acevedocrisologopablo48-lgtm/sesuveca-tolva-p04/dist/documentos/PLANTA_SELECCION_CARBON_IMPLANTACION_R01.pdf

# Selección lateral y recepción de rechazo

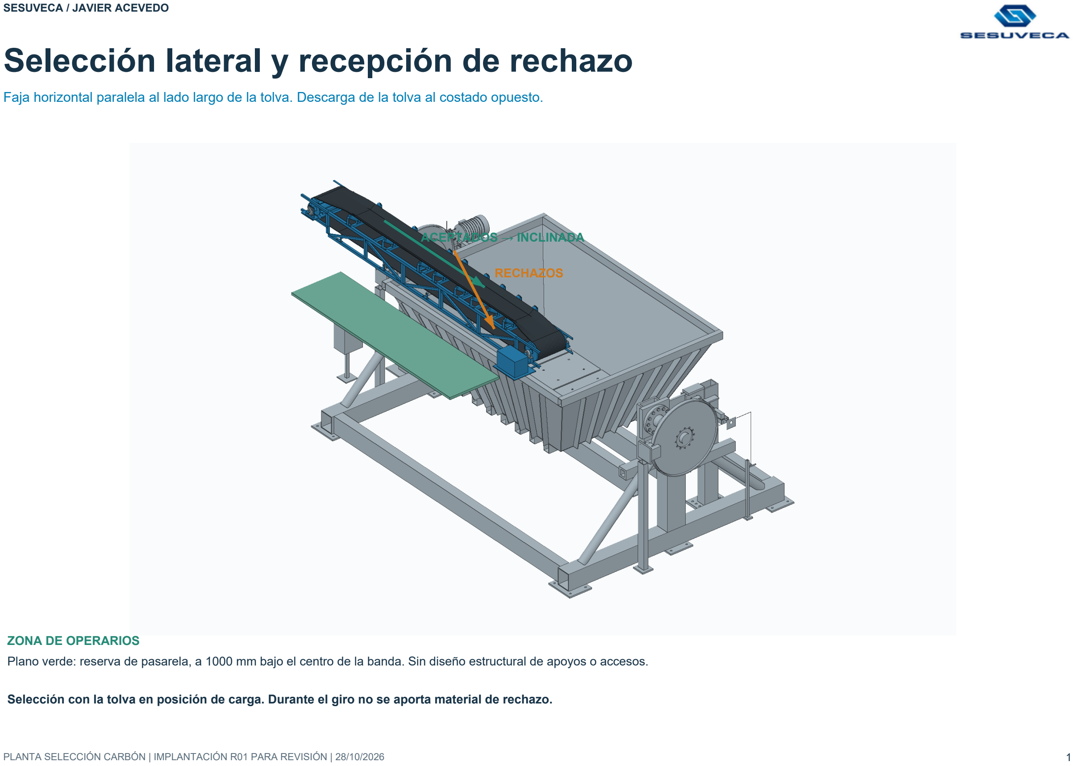
[picture p3: page 1]

SESUVECA / JAVIER ACEVEDO

Faja horizontal paralela al lado largo de la tolva. Descarga de la tolva al costado opuesto.

PLANTA SELECCIÓN CARBÓN | IMPLANTACIÓN R01 PARA REVISIÓN | 28/10/2026 | 1

ACEPTADOS → INCLINADA

RECHAZOS

ZONA DE OPERARIOS

Plano verde: reserva de pasarela, a 1000 mm bajo el centro de la banda. Sin diseño estructural de apoyos o accesos.

Selección con la tolva en posición de carga. Durante el giro no se aporta material de rechazo.

# Conjunto de planta y recorrido del material

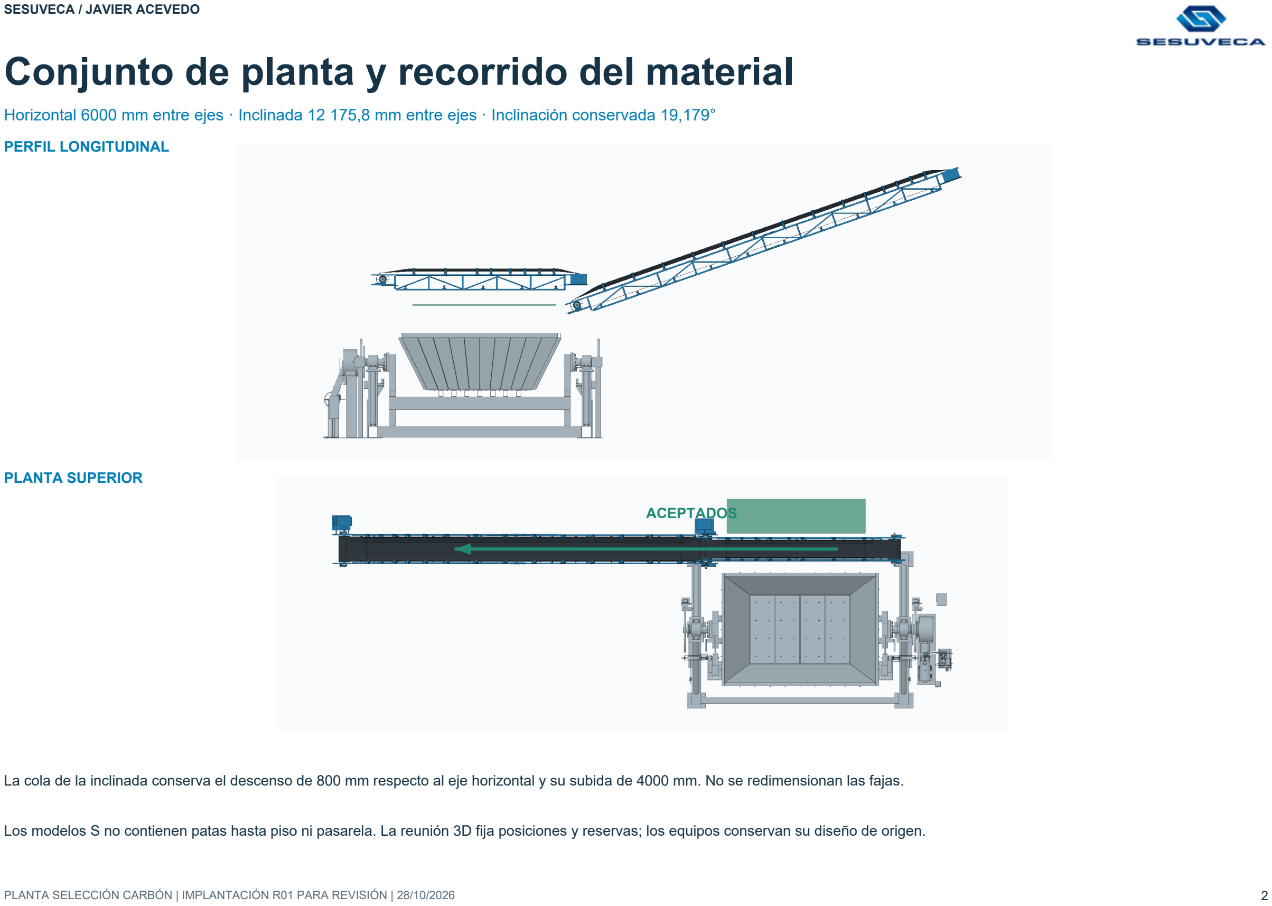
[picture p4: page 2]

Horizontal 6000 mm entre ejes · Inclinada 12 175,8 mm entre ejes · Inclinación conservada 19,179°

PLANTA SELECCIÓN CARBÓN | IMPLANTACIÓN R01 PARA REVISIÓN | 28/10/2026 | 2

PERFIL LONGITUDINAL

PLANTA SUPERIOR

ACEPTADOS

La cola de la inclinada conserva el descenso de 800 mm respecto al eje horizontal y su subida de 4000 mm. No se redimensionan las fajas.

Los modelos S no contienen patas hasta piso ni pasarela. La reunión 3D fija posiciones y reservas; los equipos conservan su diseño de origen.

# Espacio para el giro de la tolva

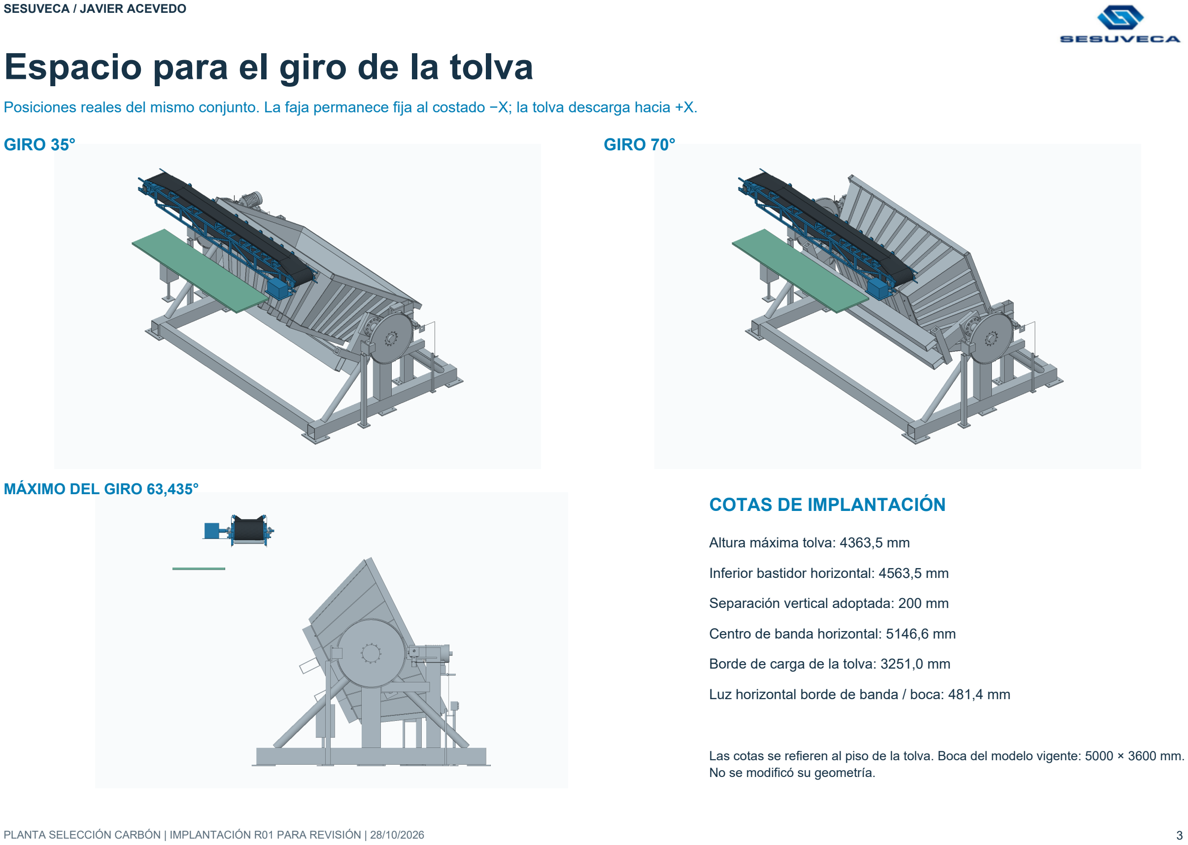
[picture p5: page 3]

Posiciones reales del mismo conjunto. La faja permanece fija al costado −X; la tolva descarga hacia +X.

PLANTA SELECCIÓN CARBÓN | IMPLANTACIÓN R01 PARA REVISIÓN | 28/10/2026 | 3
GIRO 35° | GIRO 70°

MÁXIMO DEL GIRO 63,435°

## COTAS DE IMPLANTACIÓN

Altura máxima tolva: 4363,5 mm

Inferior bastidor horizontal: 4563,5 mm

Separación vertical adoptada: 200 mm

Centro de banda horizontal: 5146,6 mm

Borde de carga de la tolva: 3251,0 mm

Luz horizontal borde de banda / boca: 481,4 mm

Las cotas se refieren al piso de la tolva. Boca del modelo vigente: 5000 × 3600 mm. No se modificó su geometría.
