acevedocrisologopablo48-lgtm/sesuveca-tolva-p04/dist/documentos/TT10_PLANOS_CONJUNTOS.pdf

# Conjunto general y montaje

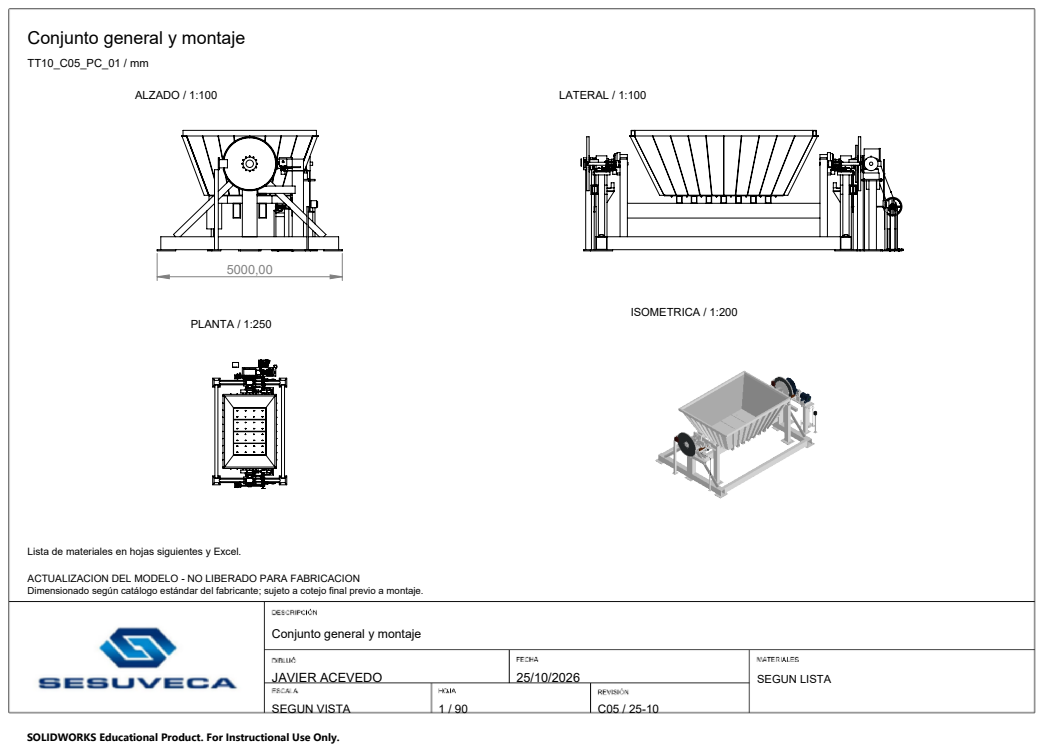
[picture p6: page 1]
JAVIER ACEVEDO; SEGUN VISTA; SEGUN LISTA; ALZADO / 1:100; LATERAL / 1:100; PLANTA / 1:250; ISOMETRICA / 1:200

Lista de materiales en hojas siguientes y Excel.

ACTUALIZACION DEL MODELO - NO LIBERADO PARA FABRICACION
Dimensionado según catálogo estándar del fabricante; sujeto a cotejo final previo a montaje.

Conjunto general y montaje

SOLIDWORKS Educational Product. For Instructional Use Only.

# Conjunto general y montaje - Lista de conjuntos

TT10_C05_PC_01_L02 / mm

### Conjunto general y montaje - Lista de conjuntos

JAVIER ACEVEDO | 25/10/2026
S/E | 2 / 90 | C05 / 25-10

SEGUN LISTA

Referencias a conjuntos. Cantidad: 1 por referencia.

ACTUALIZACION DEL MODELO - NO LIBERADO PARA FABRICACION Dimensionado según catálogo estándar del fabricante; sujeto a cotejo final previo a montaje.

POS | CANT | CODIGO | DESCRIPCION | MATERIAL
02 | 1 | TT10_C05_PC_02 | Bastidor fijo ensamblado | SEGÚN CONJUNTO
03 | 1 | TT10_C05_PC_03 | Topes de giro, orejas y guías del bastidor | SEGÚN CONJUNTO
04 | 1 | TT10_C05_PC_04 | Tolva y bastidor móvil ensamblados | SEGÚN CONJUNTO
05 | 1 | TT10_C05_PC_05 | Bastidor móvil de la tolva | SEGÚN CONJUNTO
06 | 1 | TT10_C05_PC_06 | Tolva: paneles laterales y refuerzos | SEGÚN CONJUNTO
07 | 1 | TT10_C05_PC_07 | Tolva: testeros, refuerzos y fondo | SEGÚN CONJUNTO
08 | 1 | TT10_C05_PC_08 | Revestimientos desmontables y camas de apoyo | SEGÚN CONJUNTO
09 | 1 | TT10_C05_PC_09 | Muñones, bridas, cubos y apoyos de giro | SEGÚN CONJUNTO
10 | 1 | TT10_C05_PC_10 | Bancada y pedestales del accionamiento | SEGÚN CONJUNTO
11 | 1 | TT10_C05_PC_11 | Soportes y montaje de frenos de salida | SEGÚN CONJUNTO
12 | 1 | TT10_C05_PC_12 | Bastidores de extracción de pasadores | SEGÚN CONJUNTO
13 | 1 | TT10_C05_PC_13 | Pasadores de bloqueo y casquillos | SEGÚN CONJUNTO
14 | 1 | TT10_C05_PC_14 | Pestillos positivos y recuperación | SEGÚN CONJUNTO
15 | 1 | TT10_C05_PC_15 | Soportes y regulación de detectores | SEGÚN CONJUNTO
16 | 1 | TT10_C05_PC_16 | Tensor de cadena y puesto manual | SEGÚN CONJUNTO
17 | 1 | TT10_C05_PC_17 | Volante, eje y freno del timón | SEGÚN CONJUNTO
18 | 1 | TT10_C05_PC_18 | Transmisión por cadena y acoples | SEGÚN CONJUNTO
19 | 1 | TT10_C05_PC_19 | Resguardo desmontable de cadena | SEGÚN CONJUNTO
20 | 1 | TT10_C05_PC_20 | Caja y soportes del selector | SEGÚN CONJUNTO

# Conjunto general y montaje - Lista de conjuntos

TT10_C05_PC_01_L03 / mm

### Conjunto general y montaje - Lista de conjuntos

JAVIER ACEVEDO | 25/10/2026
S/E | 3 / 90 | C05 / 25-10

SEGUN LISTA

Referencias a conjuntos. Cantidad: 1 por referencia.

ACTUALIZACION DEL MODELO - NO LIBERADO PARA FABRICACION Dimensionado según catálogo estándar del fabricante; sujeto a cotejo final previo a montaje.

POS | CANT | CODIGO | DESCRIPCION | MATERIAL
21 | 1 | TT10_C05_PC_21 | Selector E-N-M y enclavamiento cautivo | SEGÚN CONJUNTO
22 | 1 | TT10_C05_PC_22 | Transmisión manual BDNB ensamblada | SEGÚN CONJUNTO
23 | 1 | TT10_C05_PC_23 | BDNB: engranajes y pasadores propios | SEGÚN CONJUNTO
24 | 1 | TT10_C05_PC_24 | Puestos de recuperación de actuadores | SEGÚN CONJUNTO
25 | 1 | TT10_C05_PC_25 | Soportes de armario y mandos | SEGÚN CONJUNTO
26 | 1 | TT10_C05_PC_26 | Mando exterior y varilla del selector | SEGÚN CONJUNTO

# Bastidor fijo ensamblado

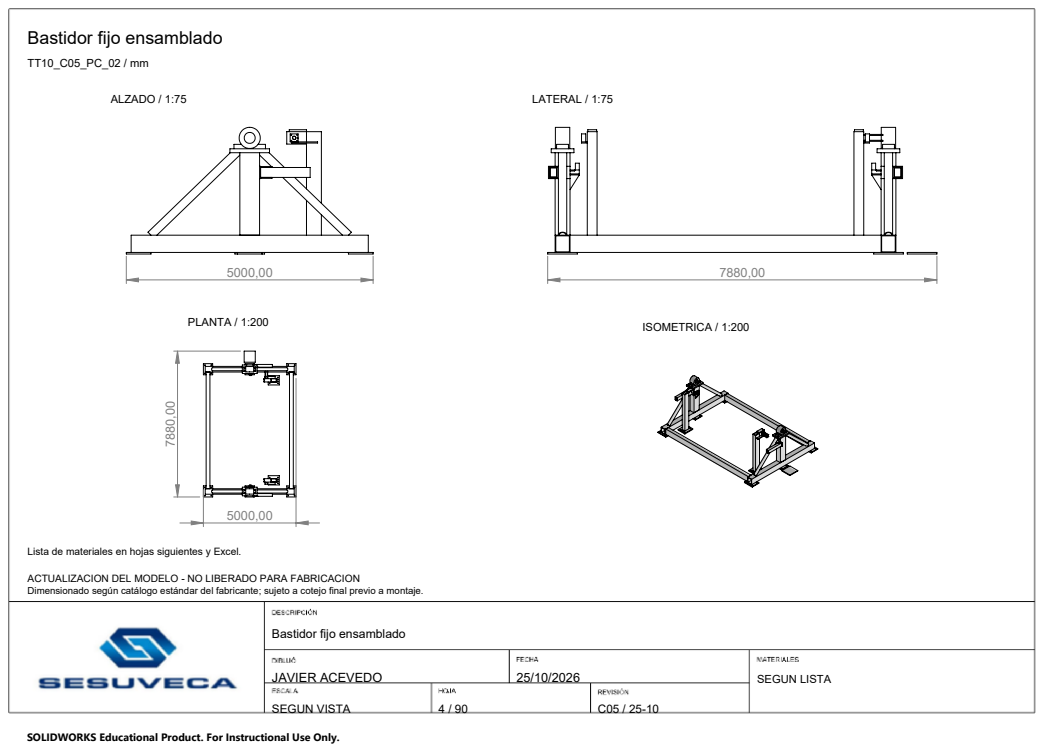
[picture p7: page 4]
JAVIER ACEVEDO; SEGUN VISTA; SEGUN LISTA; ALZADO / 1:75; LATERAL / 1:75; PLANTA / 1:200; ISOMETRICA / 1:200

Lista de materiales en hojas siguientes y Excel.

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

Bastidor fijo ensamblado

# Bastidor fijo ensamblado - Lista de materiales

TT10_C05_PC_02_L02 / mm

### Bastidor fijo ensamblado - Lista de materiales

JAVIER ACEVEDO | 25/10/2026
S/E | 5 / 90 | C05 / 25-10

SEGUN LISTA

Cantidades de esta lista: instancias presentes en este conjunto.

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

POS | CANT | CODIGO | DESCRIPCION | MATERIAL
145 | 1 | TT10_CART_N_INF | Cartela horizontal20 entre puente y placa de nodo | ASTM A36
146 | 1 | TT10_CART_N_SUP | Cartela horizontal20 entre puente y placa de nodo | ASTM A36
147 | 1 | TT10_CART_P_INF | Cartela horizontal20 entre puente y placa de nodo | ASTM A36
148 | 1 | TT10_CART_P_SUP | Cartela horizontal20 entre puente y placa de nodo | ASTM A36
218 | 1 | TT10_F416 | Placa base 600 x 500 x 50; 8 agujeros Ø40, centros X ±220, Y ±150 y ±50 | Strenx700E t50; Rp0.2min700MPa
219 | 1 | TT10_F426 | Tope inclinado: cara inferior mecanizada para asiento horizontal | ASTM A36
220 | 1 | TT10_F431 | Pieza TT10_F431 | ASTM A36
221 | 1 | TT10_F441 | Placa80 con cuatro roscas M30 ciegas60, paso540x140; pernos desde arriba | ASTM A36
222 | 1 | TT10_F446 | Placa80 con cuatro roscas M30 ciegas60, paso540x140; pernos desde arriba | ASTM A36
224 | 1 | TT10_F456 | SKF SNL3048: dimensiones de interfaz según catálogo; fundición simplificada | Conjunto comprado; acero/ fundición según OEM
225 | 1 | TT10_F471 | Perfil tubular 350 x 200 x 12; L 6300 | S275J0H / EN 10219-1
226 | 1 | TT10_F476 | Perfil tubular 350 x 200 x 12; L 6300 | S275J0H / EN 10219-1
227 | 1 | TT10_F481 | Pieza TT10_F481 | ASTM A36
228 | 1 | TT10_F486 | Oreja fija 400 x 250 x 40; agujero Ø65 H8; Strenx 700E | Strenx700E t40; Rp0.2min700MPa
230 | 1 | TT10_F501 | Oreja fija 400 x 250 x 40; agujero Ø65 H8; Strenx 700E | Strenx700E t40; Rp0.2min700MPa
231 | 1 | TT10_F506 | Poste independiente cajón 300 x 200 x 2395, t20; 2 diafragmas 260 x 160 x 20 | Strenx700E t20; Rp0.2min700MPa
232 | 1 | TT10_F511 | Pieza TT10_F511 | ASTM A36
233 | 1 | TT10_F516 | Pieza TT10_F516 | ASTM A36
235 | 1 | TT10_F526 | Perfil tubular 350 x 300 x 12; L 4800 | S275J0H / EN 10219-1

# Bastidor fijo ensamblado - Lista de materiales

TT10_C05_PC_02_L03 / mm

### Bastidor fijo ensamblado - Lista de materiales

JAVIER ACEVEDO | 25/10/2026
S/E | 6 / 90 | C05 / 25-10

SEGUN LISTA

Cantidades de esta lista: instancias presentes en este conjunto.

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

POS | CANT | CODIGO | DESCRIPCION | MATERIAL
236 | 1 | TT10_F531 | Perfil tubular 350 x 300 x 12; L 4800 | S275J0H / EN 10219-1
237 | 1 | TT10_F536 | Soporte tope terminado en cara interior de columna | ASTM A36
238 | 1 | TT10_F541 | Diagonal CHS168.3x10 con cortes de asiento; sin penetrar columnas ni placas | S275J0H / EN 10219-1
239 | 1 | TT10_F546 | Puente RHS200x150x10 L1005; fuera del plano de las diagonales | S275J0H / EN 10219-1
240 | 1 | TT10_F551 | SKF SNL3048: dimensiones de interfaz según catálogo; fundición simplificada | Conjunto comprado; acero/ fundición según OEM
241 | 1 | TT10_F556 | Soporte tope terminado en cara interior de columna | ASTM A36
242 | 1 | TT10_F561 | Pieza TT10_F561 | ASTM A36
243 | 1 | TT10_F566 | Pieza TT10_F566 | ASTM A36
244 | 1 | TT10_F571 | Pieza TT10_F571 | ASTM A36
245 | 1 | TT10_F576 | Oreja fija 400 x 250 x 40; agujero Ø65 H8; Strenx 700E | Strenx700E t40; Rp0.2min700MPa
246 | 1 | TT10_F581 | Diagonal CHS168.3x10 con cortes de asiento; sin penetrar columnas ni placas | S275J0H / EN 10219-1
247 | 1 | TT10_F586 | Oreja fija 400 x 250 x 40; agujero Ø65 H8; Strenx 700E | Strenx700E t40; Rp0.2min700MPa
248 | 1 | TT10_F591 | Placa base 600 x 500 x 50; 8 agujeros Ø40, centros X ±220, Y ±150 y ±50 | Strenx700E t50; Rp0.2min700MPa
249 | 1 | TT10_F596 | Tope inclinado: cara inferior mecanizada para asiento horizontal | ASTM A36
250 | 1 | TT10_F601 | Diagonal CHS168.3x10 con cortes de asiento; sin penetrar columnas ni placas | S275J0H / EN 10219-1
251 | 1 | TT10_F606 | Diagonal CHS168.3x10 con cortes de asiento; sin penetrar columnas ni placas | S275J0H / EN 10219-1
252 | 1 | TT10_F611 | Poste independiente cajón 300 x 200 x 2395, t20; 2 diafragmas 260 x 160 x 20 | Strenx700E t20; Rp0.2min700MPa
254 | 1 | TT10_F621 | Puente RHS200x150x10 L1005; fuera del plano de las diagonales | S275J0H / EN 10219-1
255 | 1 | TT10_F626 | Pieza TT10_F626 | ASTM A36

# Bastidor fijo ensamblado - Lista de materiales

TT10_C05_PC_02_L04 / mm

### Bastidor fijo ensamblado - Lista de materiales

JAVIER ACEVEDO | 25/10/2026
S/E | 7 / 90 | C05 / 25-10

SEGUN LISTA

Cantidades de esta lista: instancias presentes en este conjunto.

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

POS | CANT | CODIGO | DESCRIPCION | MATERIAL
256 | 1 | TT10_F631 | Pieza TT10_F631 | ASTM A36
257 | 1 | TT10_F636 | Columna principal recortada para placa80 y altura de centro SKF220 | S355J2; certificado 3.1 requerido
258 | 1 | TT10_F641 | Columna principal recortada para placa80 y altura de centro SKF220 | S355J2; certificado 3.1 requerido
262 | 1 | TT10_GUIA_N | Guía con alojamiento Ø69 H7; casquillo69/65.5; fuera del camino resistente | ASTM A36
263 | 1 | TT10_GUIA_P | Guía con alojamiento Ø69 H7; casquillo69/65.5; fuera del camino resistente | ASTM A36
388 | 1 | TT10_NODO_N | Placa de nodo20: unión entre puente desplazado y columna principal | ASTM A36
389 | 1 | TT10_NODO_P | Placa de nodo20: unión entre puente desplazado y columna principal | ASTM A36
430 | 1 | TT10_PUENTE_N | Puente guía A36 525 x 125 x 25; recorte 225 x 10 junto al poste | ASTM A36 t25
431 | 1 | TT10_PUENTE_P | Puente guía A36 525 x 125 x 25; recorte 225 x 10 junto al poste | ASTM A36 t25
458 | 1 | TT10_TIR_P1 | Tirante M20 propuesto, L380; rosca simplificada | ASTM A36
459 | 1 | TT10_TIR_P2 | Tirante M20 propuesto, L380; rosca simplificada | ASTM A36
460 | 1 | TT10_TIR_P3 | Tirante M20 propuesto, L380; rosca simplificada | ASTM A36
461 | 1 | TT10_TIR_P4 | Tirante M20 propuesto, L380; rosca simplificada | ASTM A36
487 | 1 | TT10_TOPE70_N_INFD | Cartela horizontal20: transmite componente transversal del tope70 | ASTM A36
488 | 1 | TT10_TOPE70_N_INFI | Cartela horizontal20: transmite componente transversal del tope70 | ASTM A36
489 | 1 | TT10_TOPE70_N_SUPD | Cartela horizontal20: transmite componente transversal del tope70 | ASTM A36
490 | 1 | TT10_TOPE70_N_SUPI | Cartela horizontal20: transmite componente transversal del tope70 | ASTM A36
491 | 1 | TT10_TOPE70_N_V1 | Cartela vertical20 de tope70; apoyo al bloque y cara de columna | ASTM A36
492 | 1 | TT10_TOPE70_N_V2 | Cartela vertical20 de tope70; apoyo al bloque y cara de columna | ASTM A36

# Bastidor fijo ensamblado - Lista de materiales

TT10_C05_PC_02_L05 / mm

### Bastidor fijo ensamblado - Lista de materiales

JAVIER ACEVEDO | 25/10/2026
S/E | 8 / 90 | C05 / 25-10

SEGUN LISTA

Cantidades de esta lista: instancias presentes en este conjunto.

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

POS | CANT | CODIGO | DESCRIPCION | MATERIAL
493 | 1 | TT10_TOPE70_P_INFD | Cartela horizontal20: transmite componente transversal del tope70 | ASTM A36
494 | 1 | TT10_TOPE70_P_INFI | Cartela horizontal20: transmite componente transversal del tope70 | ASTM A36
495 | 1 | TT10_TOPE70_P_SUPD | Cartela horizontal20: transmite componente transversal del tope70 | ASTM A36
496 | 1 | TT10_TOPE70_P_SUPI | Cartela horizontal20: transmite componente transversal del tope70 | ASTM A36
497 | 1 | TT10_TOPE70_P_V1 | Cartela vertical20 de tope70; apoyo al bloque y cara de columna | ASTM A36
498 | 1 | TT10_TOPE70_P_V2 | Cartela vertical20 de tope70; apoyo al bloque y cara de columna | ASTM A36

# Topes de giro, orejas y guías del bastidor

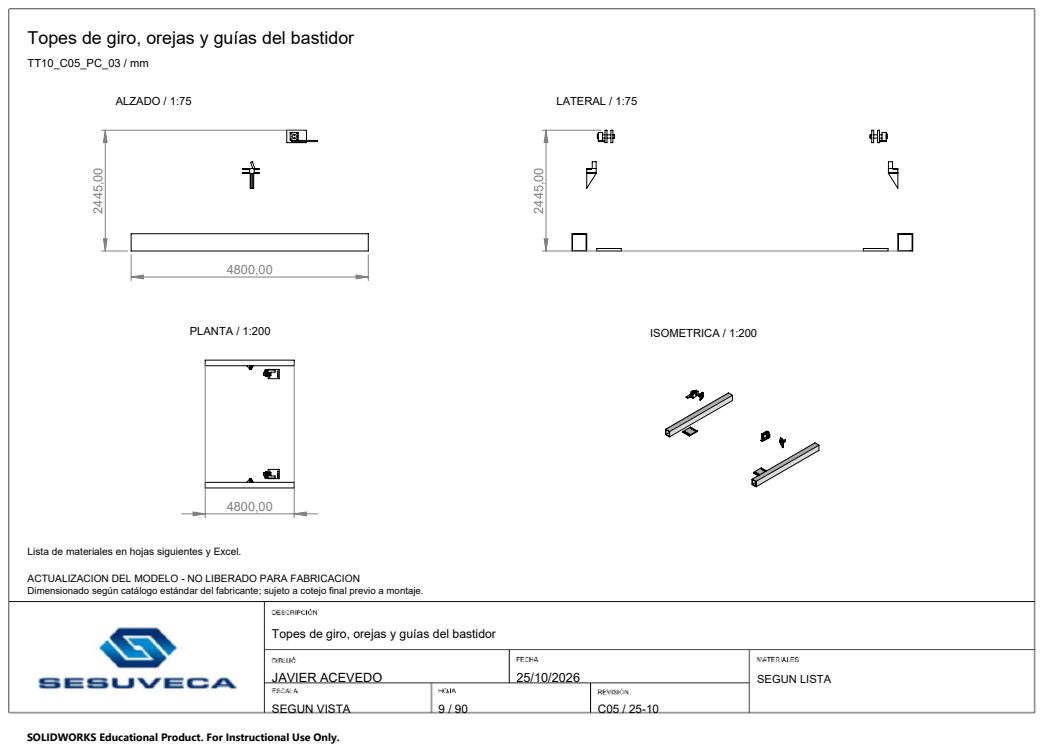
[picture p8: page 9]
JAVIER ACEVEDO; SEGUN VISTA; SEGUN LISTA; ALZADO / 1:75; LATERAL / 1:75; PLANTA / 1:200; ISOMETRICA / 1:200

Lista de materiales en hojas siguientes y Excel.

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

Topes de giro, orejas y guías del bastidor

# Topes de giro, orejas y guías del bastidor - Lista de materiales

TT10_C05_PC_03_L02 / mm

### Topes de giro, orejas y guías del bastidor - Lista de materiales

JAVIER ACEVEDO | 25/10/2026
S/E | 10 / 90 | C05 / 25-10

SEGUN LISTA

Cantidades de esta lista: instancias presentes en este conjunto.

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

POS | CANT | CODIGO | DESCRIPCION | MATERIAL
4 | 1 | TT10_BUJE_PIN_N | Casquillo CuSn12 Ø69 s6 / Ø65.5 H9 final, L85, C0.5 interiores | CuSn12 / EN 1982
5 | 1 | TT10_BUJE_PIN_P | Casquillo CuSn12 Ø69 s6 / Ø65.5 H9 final, L85, C0.5 interiores | CuSn12 / EN 1982
218 | 1 | TT10_F416 | Placa base 600 x 500 x 50; 8 agujeros Ø40, centros X ±220, Y ±150 y ±50 | Strenx700E t50; Rp0.2min700MPa
219 | 1 | TT10_F426 | Tope inclinado: cara inferior mecanizada para asiento horizontal | ASTM A36
228 | 1 | TT10_F486 | Oreja fija 400 x 250 x 40; agujero Ø65 H8; Strenx 700E | Strenx700E t40; Rp0.2min700MPa
230 | 1 | TT10_F501 | Oreja fija 400 x 250 x 40; agujero Ø65 H8; Strenx 700E | Strenx700E t40; Rp0.2min700MPa
235 | 1 | TT10_F526 | Perfil tubular 350 x 300 x 12; L 4800 | S275J0H / EN 10219-1
236 | 1 | TT10_F531 | Perfil tubular 350 x 300 x 12; L 4800 | S275J0H / EN 10219-1
237 | 1 | TT10_F536 | Soporte tope terminado en cara interior de columna | ASTM A36
241 | 1 | TT10_F556 | Soporte tope terminado en cara interior de columna | ASTM A36
245 | 1 | TT10_F576 | Oreja fija 400 x 250 x 40; agujero Ø65 H8; Strenx 700E | Strenx700E t40; Rp0.2min700MPa
247 | 1 | TT10_F586 | Oreja fija 400 x 250 x 40; agujero Ø65 H8; Strenx 700E | Strenx700E t40; Rp0.2min700MPa
248 | 1 | TT10_F591 | Placa base 600 x 500 x 50; 8 agujeros Ø40, centros X ±220, Y ±150 y ±50 | Strenx700E t50; Rp0.2min700MPa
249 | 1 | TT10_F596 | Tope inclinado: cara inferior mecanizada para asiento horizontal | ASTM A36
262 | 1 | TT10_GUIA_N | Guía con alojamiento Ø69 H7; casquillo69/65.5; fuera del camino resistente | ASTM A36
263 | 1 | TT10_GUIA_P | Guía con alojamiento Ø69 H7; casquillo69/65.5; fuera del camino resistente | ASTM A36
412 | 2 | TT10_PE_PIN | Pasador Ø65 f7 x 330; cabeza Ø90 x 15; R3; 34CrNiMo6+QT Rp0,2 mín.800 MPa | 34CrNiMo6+QT; Rp0,2 mín.800 MPa, sección<=100mm
430 | 1 | TT10_PUENTE_N | Puente guía A36 525 x 125 x 25; recorte 225 x 10 junto al poste | ASTM A36 t25
431 | 1 | TT10_PUENTE_P | Puente guía A36 525 x 125 x 25; recorte 225 x 10 junto al poste | ASTM A36 t25

# Topes de giro, orejas y guías del bastidor - Lista de materiales

TT10_C05_PC_03_L03 / mm

### Topes de giro, orejas y guías del bastidor - Lista de materiales

JAVIER ACEVEDO | 25/10/2026
S/E | 11 / 90 | C05 / 25-10

SEGUN LISTA

Cantidades de esta lista: instancias presentes en este conjunto.

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

POS | CANT | CODIGO | DESCRIPCION | MATERIAL
487 | 1 | TT10_TOPE70_N_INFD | Cartela horizontal20: transmite componente transversal del tope70 | ASTM A36
488 | 1 | TT10_TOPE70_N_INFI | Cartela horizontal20: transmite componente transversal del tope70 | ASTM A36
489 | 1 | TT10_TOPE70_N_SUPD | Cartela horizontal20: transmite componente transversal del tope70 | ASTM A36
490 | 1 | TT10_TOPE70_N_SUPI | Cartela horizontal20: transmite componente transversal del tope70 | ASTM A36
491 | 1 | TT10_TOPE70_N_V1 | Cartela vertical20 de tope70; apoyo al bloque y cara de columna | ASTM A36
492 | 1 | TT10_TOPE70_N_V2 | Cartela vertical20 de tope70; apoyo al bloque y cara de columna | ASTM A36
493 | 1 | TT10_TOPE70_P_INFD | Cartela horizontal20: transmite componente transversal del tope70 | ASTM A36
494 | 1 | TT10_TOPE70_P_INFI | Cartela horizontal20: transmite componente transversal del tope70 | ASTM A36
495 | 1 | TT10_TOPE70_P_SUPD | Cartela horizontal20: transmite componente transversal del tope70 | ASTM A36
496 | 1 | TT10_TOPE70_P_SUPI | Cartela horizontal20: transmite componente transversal del tope70 | ASTM A36
497 | 1 | TT10_TOPE70_P_V1 | Cartela vertical20 de tope70; apoyo al bloque y cara de columna | ASTM A36
498 | 1 | TT10_TOPE70_P_V2 | Cartela vertical20 de tope70; apoyo al bloque y cara de columna | ASTM A36

# Tolva y bastidor móvil ensamblados

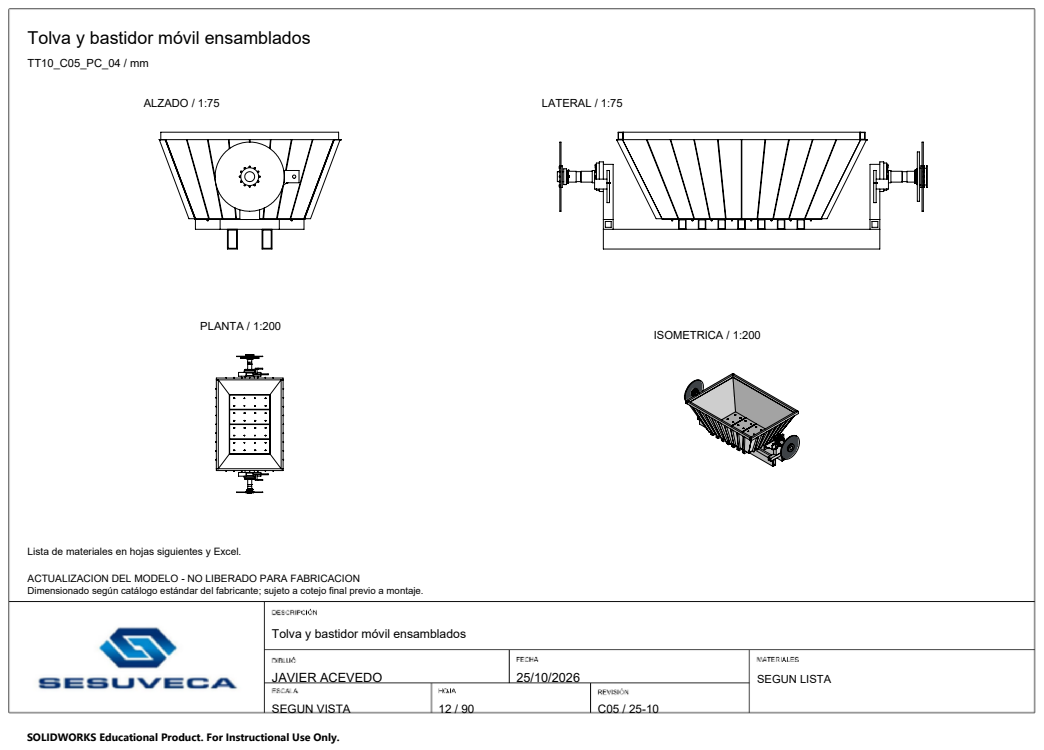
[picture p9: page 12]
JAVIER ACEVEDO; SEGUN VISTA; SEGUN LISTA; ALZADO / 1:75; LATERAL / 1:75; PLANTA / 1:200; ISOMETRICA / 1:200

Lista de materiales en hojas siguientes y Excel.

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

Tolva y bastidor móvil ensamblados

# Tolva y bastidor móvil ensamblados - Lista de conjuntos

TT10_C05_PC_04_L02 / mm

### Tolva y bastidor móvil ensamblados - Lista de conjuntos

JAVIER ACEVEDO | 25/10/2026
S/E | 13 / 90 | C05 / 25-10

SEGUN LISTA

Referencias a conjuntos. Cantidad: 1 por referencia.

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

POS | CANT | CODIGO | DESCRIPCION | MATERIAL
05 | 1 | TT10_C05_PC_05 | Bastidor móvil de la tolva | SEGÚN CONJUNTO
06 | 1 | TT10_C05_PC_06 | Tolva: paneles laterales y refuerzos | SEGÚN CONJUNTO
07 | 1 | TT10_C05_PC_07 | Tolva: testeros, refuerzos y fondo | SEGÚN CONJUNTO
08 | 1 | TT10_C05_PC_08 | Revestimientos desmontables y camas de apoyo | SEGÚN CONJUNTO
09 | 1 | TT10_C05_PC_09 | Muñones, bridas, cubos y apoyos de giro | SEGÚN CONJUNTO

# Bastidor móvil de la tolva

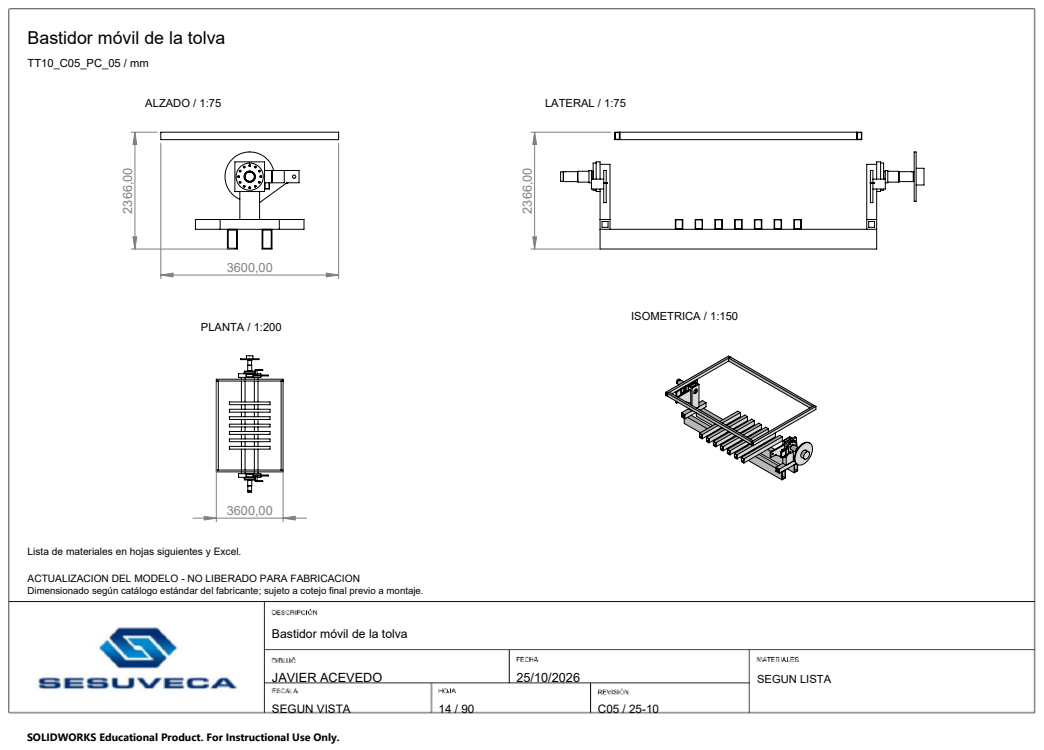
[picture p10: page 14]
JAVIER ACEVEDO; SEGUN VISTA; SEGUN LISTA; ALZADO / 1:75; LATERAL / 1:75; PLANTA / 1:200; ISOMETRICA / 1:150

Lista de materiales en hojas siguientes y Excel.

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

Bastidor móvil de la tolva

# Bastidor móvil de la tolva - Lista de materiales

TT10_C05_PC_05_L02 / mm

### Bastidor móvil de la tolva - Lista de materiales

JAVIER ACEVEDO | 25/10/2026
S/E | 15 / 90 | C05 / 25-10

SEGUN LISTA

Cantidades de esta lista: instancias presentes en este conjunto.

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

POS | CANT | CODIGO | DESCRIPCION | MATERIAL
305 | 1 | TT10_M006 | Perfil tubular 200 x 150 x 10; L 2200 | S275J0H / EN 10219-1
306 | 1 | TT10_M011 | Perfil tubular 200 x 150 x 10; L 2200 | S275J0H / EN 10219-1
307 | 1 | TT10_M016 | Perfil tubular 150 x 100 x 8; L 4800 | S275J0H / EN 10219-1
308 | 1 | TT10_M021 | Perfil tubular 200 x 150 x 10; L 2200 | S275J0H / EN 10219-1
309 | 1 | TT10_M026 | Perfil tubular 150 x 100 x 8; L 3600 | S275J0H / EN 10219-1
312 | 1 | TT10_M041 | Perfil tubular 200 x 150 x 10; L 2200 | S275J0H / EN 10219-1
313 | 1 | TT10_M046 | Perfil tubular 400 x 200 x 16; L 5600 | S275J0H / EN 10219-1
319 | 1 | TT10_M076 | Muñón forjado integral con brida550, hombro220, asiento200, R3 y retención exterior | AISI 4140 bonificado
321 | 1 | TT10_M086 | Muñón forjado integral con brida550, hombro220, asiento200, R3 y retención exterior | AISI 4140 bonificado
324 | 1 | TT10_M101 | Perfil tubular 200 x 100 x 10; L 250 | S275J0H / EN 10219-1
325 | 1 | TT10_M106 | Contraplaca80 con doce M30 ciegas78 PCD450, apriete desde exterior | ASTM A36
328 | 1 | TT10_M121 | Pieza TT10_M121 | ASTM A36
329 | 1 | TT10_M131 | Cabezal cajón 200 x 200 x 1200, t40; 2 diafragmas 120 x 120 x 40 | Strenx700E t40; Rp0.2min700MPa
333 | 1 | TT10_M151 | Pieza TT10_M151 | ASTM A36
335 | 1 | TT10_M161 | Yugo cajón 400 x 200 x 1116, t30; 2 diafragmas 340 x 140 x 30; agujero Ø202 | Strenx700E t30; Rp0.2min700MPa
336 | 1 | TT10_M166 | Perfil tubular 150 x 100 x 8; L 4800 | S275J0H / EN 10219-1
340 | 1 | TT10_M186 | Perfil tubular 200 x 150 x 10; L 2200 | S275J0H / EN 10219-1
341 | 1 | TT10_M191 | Pieza TT10_M191 | ASTM A36
343 | 1 | TT10_M201 | Cabezal cajón 200 x 200 x 1200, t40; 2 diafragmas 120 x 120 x 40 | Strenx700E t40; Rp0.2min700MPa

# Bastidor móvil de la tolva - Lista de materiales

TT10_C05_PC_05_L03 / mm

### Bastidor móvil de la tolva - Lista de materiales

JAVIER ACEVEDO | 25/10/2026
S/E | 16 / 90 | C05 / 25-10

SEGUN LISTA

Cantidades de esta lista: instancias presentes en este conjunto.

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

POS | CANT | CODIGO | DESCRIPCION | MATERIAL
344 | 1 | TT10_M206 | Pieza TT10_M206 | ASTM A36
348 | 1 | TT10_M226 | Perfil tubular 200 x 150 x 10; L 2200 | S275J0H / EN 10219-1
350 | 1 | TT10_M236 | Perfil tubular 150 x 100 x 8; L 3600 | S275J0H / EN 10219-1
355 | 1 | TT10_M261 | Pieza TT10_M261 | ASTM A36
358 | 1 | TT10_M276 | Brazo monolítico Strenx 700E t50; perfil 800 x 650; R50; agujero Ø65,5 | Strenx700E t50; Rp0.2min700MPa
365 | 1 | TT10_M311 | Yugo cajón 400 x 200 x 1116, t30; 2 diafragmas 340 x 140 x 30; agujero Ø202 | Strenx700E t30; Rp0.2min700MPa
369 | 1 | TT10_M336 | Perfil tubular 200 x 100 x 10; L 250 | S275J0H / EN 10219-1
372 | 1 | TT10_M351 | Brazo monolítico Strenx 700E t50; perfil 800 x 650; R50; agujero Ø65,5 | Strenx700E t50; Rp0.2min700MPa
373 | 1 | TT10_M356 | Perfil tubular 400 x 200 x 16; L 5600 | S275J0H / EN 10219-1
376 | 1 | TT10_M371 | Pieza TT10_M371 | ASTM A36
377 | 1 | TT10_M376 | Contraplaca80 con doce M30 ciegas78 PCD450, apriete desde exterior | ASTM A36
378 | 1 | TT10_M381 | Perfil tubular 200 x 150 x 10; L 2200 | S275J0H / EN 10219-1

# Tolva: paneles laterales y refuerzos

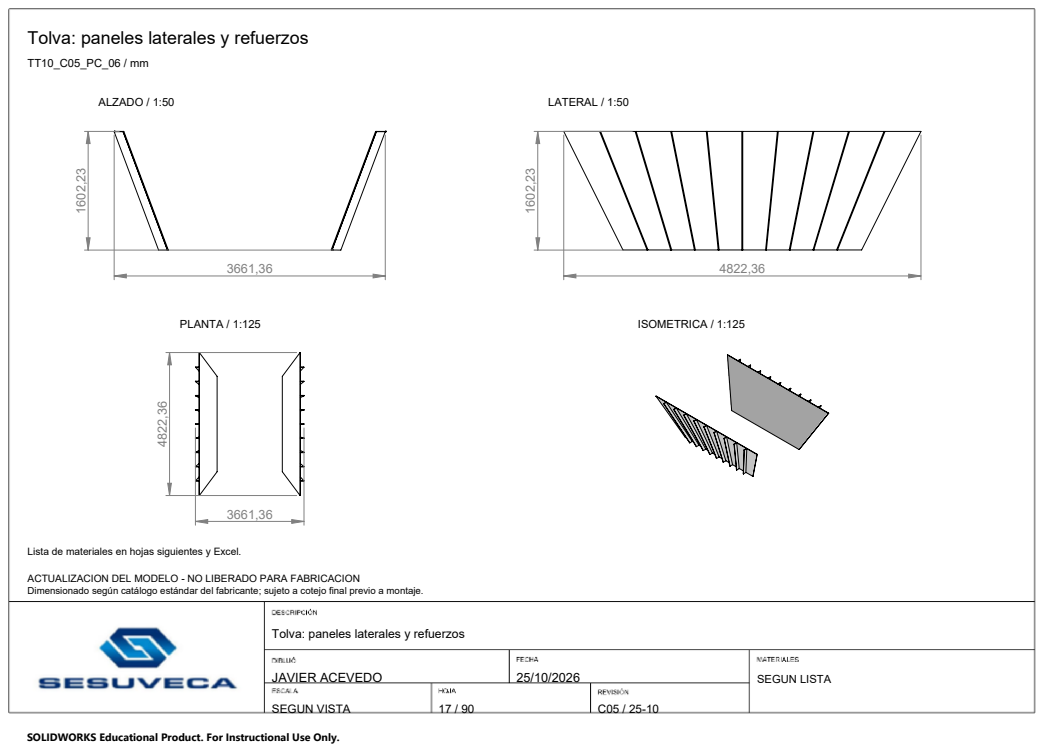
[picture p11: page 17]
JAVIER ACEVEDO; SEGUN VISTA; SEGUN LISTA; ALZADO / 1:50; LATERAL / 1:50; PLANTA / 1:125; ISOMETRICA / 1:125

Lista de materiales en hojas siguientes y Excel.

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

Tolva: paneles laterales y refuerzos

# Tolva: paneles laterales y refuerzos - Lista de materiales

TT10_C05_PC_06_L02 / mm

### Tolva: paneles laterales y refuerzos - Lista de materiales

JAVIER ACEVEDO | 25/10/2026
S/E | 18 / 90 | C05 / 25-10

SEGUN LISTA

Cantidades de esta lista: instancias presentes en este conjunto.

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

POS | CANT | CODIGO | DESCRIPCION | MATERIAL
311 | 1 | TT10_M036 | Pieza TT10_M036 | ASTM A36
316 | 1 | TT10_M061 | Pieza TT10_M061 | ASTM A36
317 | 1 | TT10_M066 | Pieza TT10_M066 | ASTM A36
322 | 1 | TT10_M091 | Pieza TT10_M091 | ASTM A36
326 | 1 | TT10_M111 | Pieza TT10_M111 | ASTM A36
327 | 1 | TT10_M116 | Pieza TT10_M116 | ASTM A36
331 | 1 | TT10_M141 | Pieza TT10_M141 | ASTM A36
332 | 1 | TT10_M146 | Pieza TT10_M146 | ASTM A36
342 | 1 | TT10_M196 | Pieza TT10_M196 | ASTM A36
349 | 1 | TT10_M231 | Pieza TT10_M231 | ASTM A36
359 | 1 | TT10_M281 | Pieza TT10_M281 | ASTM A36
360 | 1 | TT10_M286 | Pieza TT10_M286 | ASTM A36
362 | 1 | TT10_M296 | Pieza TT10_M296 | ASTM A36
363 | 1 | TT10_M301 | Pieza TT10_M301 | ASTM A36
366 | 1 | TT10_M316 | Pieza TT10_M316 | ASTM A36
367 | 1 | TT10_M326 | Pieza TT10_M326 | ASTM A36
368 | 1 | TT10_M331 | Pieza TT10_M331 | ASTM A36
370 | 1 | TT10_M341 | Pieza TT10_M341 | ASTM A36
371 | 1 | TT10_M346 | Pieza TT10_M346 | ASTM A36

# Tolva: paneles laterales y refuerzos - Lista de materiales

TT10_C05_PC_06_L03 / mm

### Tolva: paneles laterales y refuerzos - Lista de materiales

JAVIER ACEVEDO | 25/10/2026
S/E | 19 / 90 | C05 / 25-10

SEGUN LISTA

Cantidades de esta lista: instancias presentes en este conjunto.

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

POS | CANT | CODIGO | DESCRIPCION | MATERIAL
381 | 1 | TT10_M396 | Pieza TT10_M396 | ASTM A36

# Tolva: testeros, refuerzos y fondo

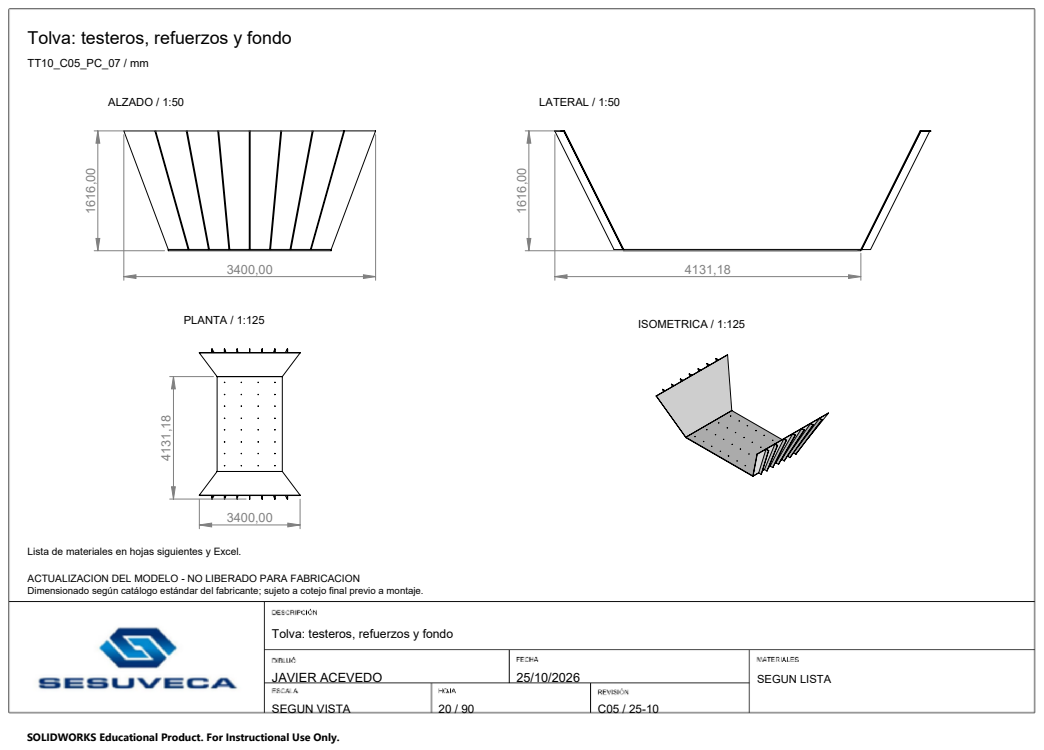
[picture p12: page 20]
JAVIER ACEVEDO; SEGUN VISTA; SEGUN LISTA; ALZADO / 1:50; LATERAL / 1:50; PLANTA / 1:125; ISOMETRICA / 1:125

Lista de materiales en hojas siguientes y Excel.

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

Tolva: testeros, refuerzos y fondo

# Tolva: testeros, refuerzos y fondo - Lista de materiales

TT10_C05_PC_07_L02 / mm

### Tolva: testeros, refuerzos y fondo - Lista de materiales

JAVIER ACEVEDO | 25/10/2026
S/E | 21 / 90 | C05 / 25-10

SEGUN LISTA

Cantidades de esta lista: instancias presentes en este conjunto.

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

POS | CANT | CODIGO | DESCRIPCION | MATERIAL
310 | 1 | TT10_M031 | Pieza TT10_M031 | ASTM A36
314 | 1 | TT10_M051 | Pieza TT10_M051 | ASTM A36
318 | 1 | TT10_M071 | Pieza TT10_M071 | ASTM A36
320 | 1 | TT10_M081 | Pieza TT10_M081 | ASTM A36
323 | 1 | TT10_M096 | Pieza TT10_M096 | ASTM A36
330 | 1 | TT10_M136 | Pieza TT10_M136 | ASTM A36
337 | 1 | TT10_M171 | Pieza TT10_M171 | ASTM A36
338 | 1 | TT10_M176 | Fondo16 con taladros de revestimientos desmontables | ASTM A36
339 | 1 | TT10_M181 | Pieza TT10_M181 | ASTM A36
346 | 1 | TT10_M216 | Pieza TT10_M216 | ASTM A36
352 | 1 | TT10_M246 | Pieza TT10_M246 | ASTM A36
353 | 1 | TT10_M251 | Pieza TT10_M251 | ASTM A36
361 | 1 | TT10_M291 | Pieza TT10_M291 | ASTM A36
374 | 1 | TT10_M361 | Pieza TT10_M361 | ASTM A36
382 | 1 | TT10_M401 | Pieza TT10_M401 | ASTM A36
383 | 1 | TT10_M406 | Pieza TT10_M406 | ASTM A36
384 | 1 | TT10_M411 | Pieza TT10_M411 | ASTM A36

# Revestimientos desmontables y camas de apoyo

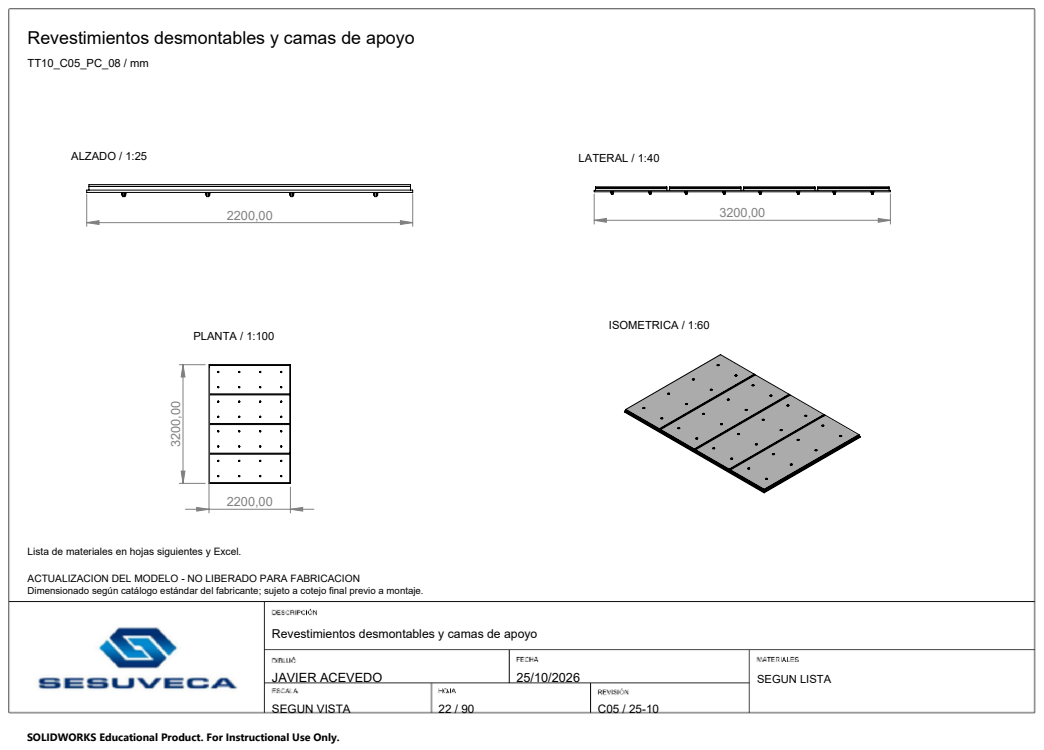
[picture p13: page 22]
JAVIER ACEVEDO; SEGUN VISTA; SEGUN LISTA; ALZADO / 1:25; LATERAL / 1:40; PLANTA / 1:100; ISOMETRICA / 1:60

Lista de materiales en hojas siguientes y Excel.

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

Revestimientos desmontables y camas de apoyo

# Revestimientos desmontables y camas de apoyo - Lista de materiales

TT10_C05_PC_08_L02 / mm

### Revestimientos desmontables y camas de apoyo - Lista de materiales

JAVIER ACEVEDO | 25/10/2026
S/E | 23 / 90 | C05 / 25-10

SEGUN LISTA

Cantidades de esta lista: instancias presentes en este conjunto.

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

POS | CANT | CODIGO | DESCRIPCION | MATERIAL
266 | 32 | TT10_LIN_0_0_B | Tornillo avellanado M16x80, cabeza90 D31, hexágono10; geometría nominal | Clase 10.9 / ISO 898-1
267 | 32 | TT10_LIN_0_0_C | Casquillo30/18 L25 limita compresión de elastómero | Acero C45
268 | 32 | TT10_LIN_0_0_N | Tuerca autoblocante metálica M16; rosca simplificada | Tuerca clase 8 / ISO 898-2
269 | 32 | TT10_LIN_0_0_W | Arandela M16 200HV D30/d17/t3 | Arandela endurecida 200 HV / ISO 7089
315 | 1 | TT10_M056 | Cama elastomérica25 perforada para casquillos limitadores | Elastómero; curva dinámica de compresión por definir
338 | 1 | TT10_M176 | Fondo16 con taladros de revestimientos desmontables | ASTM A36
345 | 1 | TT10_M211 | Cama elastomérica25 perforada para casquillos limitadores | Elastómero; curva dinámica de compresión por definir
347 | 1 | TT10_M221 | Cama elastomérica25 perforada para casquillos limitadores | Elastómero; curva dinámica de compresión por definir
351 | 1 | TT10_M241 | Cama elastomérica25 perforada para casquillos limitadores | Elastómero; curva dinámica de compresión por definir
354 | 1 | TT10_M256 | Revestimiento AR400 t12 con ocho M16 avellanados desmontables | Hardox 400
356 | 1 | TT10_M266 | Revestimiento AR400 t12 con ocho M16 avellanados desmontables | Hardox 400
379 | 1 | TT10_M386 | Revestimiento AR400 t12 con ocho M16 avellanados desmontables | Hardox 400
380 | 1 | TT10_M391 | Revestimiento AR400 t12 con ocho M16 avellanados desmontables | Hardox 400

# Muñones, bridas, cubos y apoyos de giro

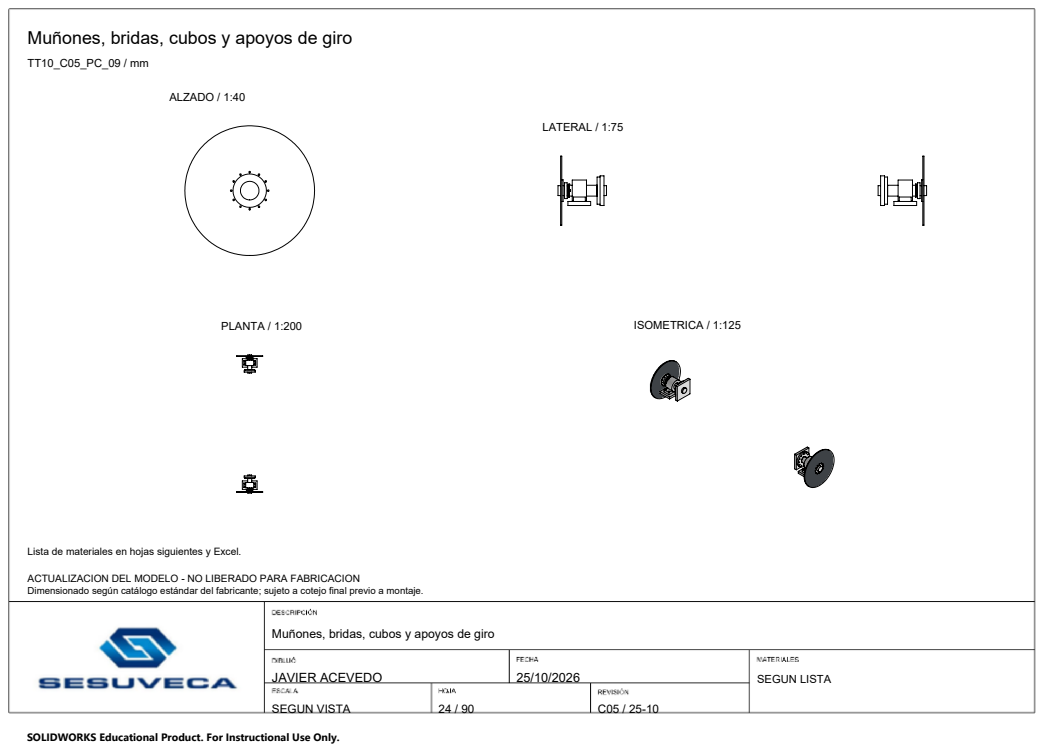
[picture p14: page 24]
JAVIER ACEVEDO; SEGUN VISTA; SEGUN LISTA; ALZADO / 1:40; LATERAL / 1:75; PLANTA / 1:200; ISOMETRICA / 1:125

Lista de materiales en hojas siguientes y Excel.

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

Muñones, bridas, cubos y apoyos de giro

# Muñones, bridas, cubos y apoyos de giro - Lista de materiales

TT10_C05_PC_09_L02 / mm

### Muñones, bridas, cubos y apoyos de giro - Lista de materiales

JAVIER ACEVEDO | 25/10/2026
S/E | 25 / 90 | C05 / 25-10

SEGUN LISTA

Cantidades de esta lista: instancias presentes en este conjunto.

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

POS | CANT | CODIGO | DESCRIPCION | MATERIAL
1 | 1 | TT10_22240_N | SKF22240CC/W33 200x360x98; envolvente sin rodillos | Conjunto comprado; acero/ fundición según OEM
2 | 1 | TT10_22240_P | SKF22240CC/W33 200x360x98; envolvente sin rodillos | Conjunto comprado; acero/ fundición según OEM
149 | 1 | TT10_COLLAR_N | Casquillo D220/d200.2 L161: transmisión de apriete y pista de sello | C45E / EN 10083-2
150 | 1 | TT10_COLLAR_P | Casquillo D220/d200.2 L161: transmisión de apriete y pista de sello | C45E / EN 10083-2
180 | 1 | TT10_D_CUBO_N | Cubo de conexión por apriete y brida de disco N | AISI 4140 bonificado
181 | 1 | TT10_D_CUBO_P | Cubo de conexión por apriete y brida de disco P | AISI 4140 bonificado
182 | 1 | TT10_D_DISCO_N | Disco de freno de salida N; diámetro nominal de dibujo | Equipo comprado
183 | 1 | TT10_D_DISCO_P | Disco de freno de salida P; diámetro nominal de dibujo | Equipo comprado
221 | 1 | TT10_F441 | Placa80 con cuatro roscas M30 ciegas60, paso540x140; pernos desde arriba | ASTM A36
222 | 1 | TT10_F446 | Placa80 con cuatro roscas M30 ciegas60, paso540x140; pernos desde arriba | ASTM A36
224 | 1 | TT10_F456 | SKF SNL3048: dimensiones de interfaz según catálogo; fundición simplificada | Conjunto comprado; acero/ fundición según OEM
240 | 1 | TT10_F551 | SKF SNL3048: dimensiones de interfaz según catálogo; fundición simplificada | Conjunto comprado; acero/ fundición según OEM
264 | 1 | TT10_KM40_N | SKF KM40, M200x3, D250 B29; cuatro ranuras18x8 | Conjunto comprado; acero/ fundición según OEM
265 | 1 | TT10_KM40_P | SKF KM40, M200x3, D250 B29; cuatro ranuras18x8 | Conjunto comprado; acero/ fundición según OEM
319 | 1 | TT10_M076 | Muñón forjado integral con brida550, hombro220, asiento200, R3 y retención exterior | AISI 4140 bonificado
321 | 1 | TT10_M086 | Muñón forjado integral con brida550, hombro220, asiento200, R3 y retención exterior | AISI 4140 bonificado
325 | 1 | TT10_M106 | Contraplaca80 con doce M30 ciegas78 PCD450, apriete desde exterior | ASTM A36
377 | 1 | TT10_M376 | Contraplaca80 con doce M30 ciegas78 PCD450, apriete desde exterior | ASTM A36
385 | 1 | TT10_MB40_N | MB40 comprada: una pestana plegada nominal en KM40; restantes18 planas | Acero arandela comercial Timken MB40; variante a confirmar

# Muñones, bridas, cubos y apoyos de giro - Lista de materiales

TT10_C05_PC_09_L03 / mm

### Muñones, bridas, cubos y apoyos de giro - Lista de materiales

JAVIER ACEVEDO | 25/10/2026
S/E | 26 / 90 | C05 / 25-10

SEGUN LISTA

Cantidades de esta lista: instancias presentes en este conjunto.

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

POS | CANT | CODIGO | DESCRIPCION | MATERIAL
386 | 1 | TT10_MB40_P | MB40 comprada: una pestana plegada nominal en KM40; restantes18 planas | Acero arandela comercial Timken MB40; variante a confirmar

# Bancada y pedestales del accionamiento

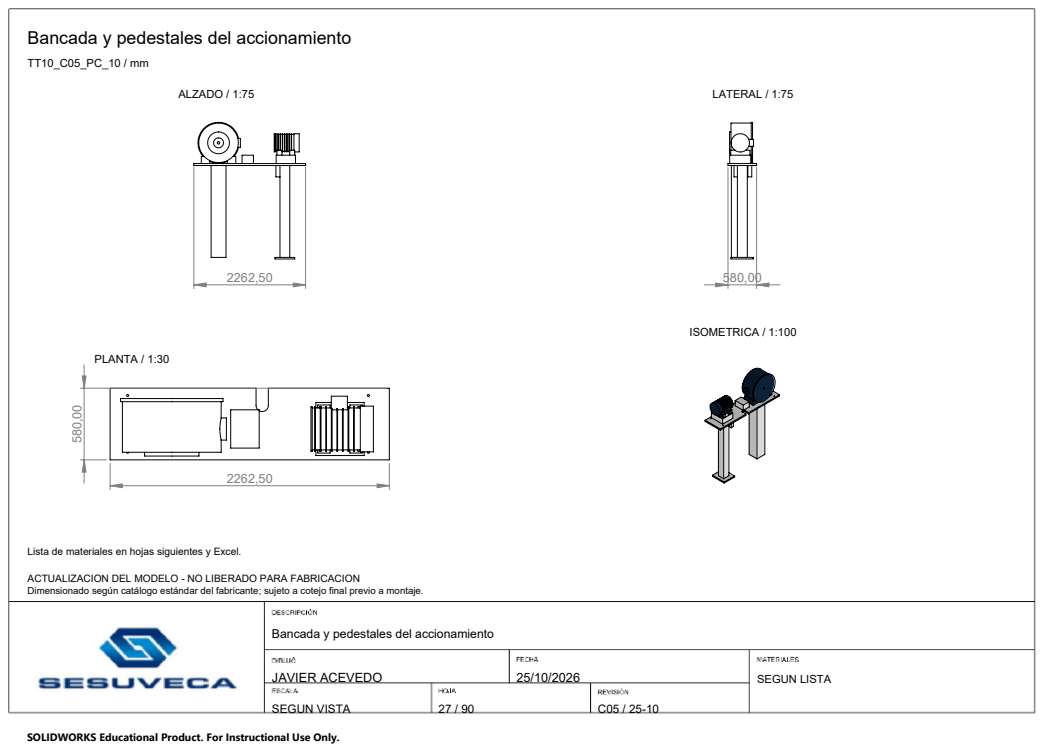
[picture p15: page 27]
JAVIER ACEVEDO; SEGUN VISTA; SEGUN LISTA; ALZADO / 1:75; LATERAL / 1:75; PLANTA / 1:30; ISOMETRICA / 1:100

Lista de materiales en hojas siguientes y Excel.

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

Bancada y pedestales del accionamiento

# Bancada y pedestales del accionamiento - Lista de materiales

TT10_C05_PC_10_L02 / mm

### Bancada y pedestales del accionamiento - Lista de materiales

JAVIER ACEVEDO | 25/10/2026
S/E | 28 / 90 | C05 / 25-10

SEGUN LISTA

Cantidades de esta lista: instancias presentes en este conjunto.

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

POS | CANT | CODIGO | DESCRIPCION | MATERIAL
161 | 1 | TT10_D_BASE_MOTOR | Placa base del segundo apoyo de bancada | ASTM A36
177 | 1 | TT10_D_CARTELA_MOTOR_0 | Apoyo lateral desmontable de bancada | ASTM A36
178 | 1 | TT10_D_CARTELA_MOTOR_1 | Apoyo lateral desmontable de bancada | ASTM A36
179 | 1 | TT10_D_COLUMNA_MOTOR | Columna adicional RHS200x200; asiento sobre placa base | S275J0H / EN 10219-1
189 | 1 | TT10_D_MOTOR | Motor eléctrico con encoder; geometría nominal, potencia no seleccionada | Equipo comprado; materiales y masa según ficha OEM
197 | 1 | TT10_D_PEDESTAL_AUX | Pedestal bajo reducción auxiliar | ASTM A36
198 | 1 | TT10_D_PEDESTAL_MOTOR | Soporte común de pies del motor | ASTM A36
201 | 1 | TT10_D_PLATAFORMA | Plataforma t40 con paso abierto de cadena ancho100, extremo R50; geometría nativa vigente | ASTM A36
209 | 1 | TT10_D_REDUCTOR | Reductor principal angular: carcasa y conexiones nominales | Equipo comprado; materiales y masa según ficha OEM
234 | 1 | TT10_F521 | Columna accionamiento apoyada sobre placa base | ASTM A36

# Soportes y montaje de frenos de salida

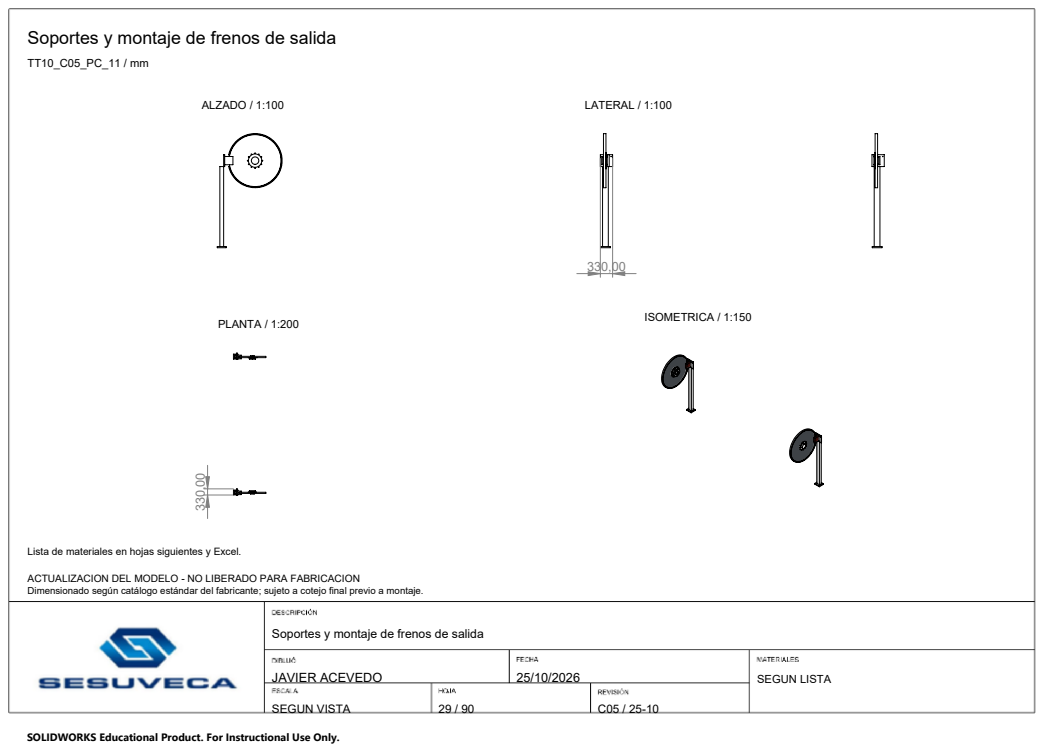
[picture p16: page 29]
JAVIER ACEVEDO; SEGUN VISTA; SEGUN LISTA; ALZADO / 1:100; LATERAL / 1:100; PLANTA / 1:200; ISOMETRICA / 1:150

Lista de materiales en hojas siguientes y Excel.

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

Soportes y montaje de frenos de salida

# Soportes y montaje de frenos de salida - Lista de materiales

TT10_C05_PC_11_L02 / mm

### Soportes y montaje de frenos de salida - Lista de materiales

JAVIER ACEVEDO | 25/10/2026
S/E | 30 / 90 | C05 / 25-10

SEGUN LISTA

Cantidades de esta lista: instancias presentes en este conjunto.

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

POS | CANT | CODIGO | DESCRIPCION | MATERIAL
153 | 1 | TT10_D_ARO_RESGUARDO_N | Resguardo tubular desmontable ARO_RESGUARDO_N | S275J0H / EN 10219-1
154 | 1 | TT10_D_ARO_RESGUARDO_P | Resguardo tubular desmontable ARO_RESGUARDO_P | S275J0H / EN 10219-1
159 | 1 | TT10_D_BASE_FRENO_N | Base de pedestal de freno N | ASTM A36
160 | 1 | TT10_D_BASE_FRENO_P | Base de pedestal de freno P | ASTM A36
180 | 1 | TT10_D_CUBO_N | Cubo de conexión por apriete y brida de disco N | AISI 4140 bonificado
181 | 1 | TT10_D_CUBO_P | Cubo de conexión por apriete y brida de disco P | AISI 4140 bonificado
182 | 1 | TT10_D_DISCO_N | Disco de freno de salida N; diámetro nominal de dibujo | Equipo comprado
183 | 1 | TT10_D_DISCO_P | Disco de freno de salida P; diámetro nominal de dibujo | Equipo comprado
199 | 1 | TT10_D_PINZA_N | Pinza de freno por resorte, liberación eléctrica N; envolvente nominal | Equipo comprado
200 | 1 | TT10_D_PINZA_P | Pinza de freno por resorte, liberación eléctrica P; envolvente nominal | Equipo comprado
204 | 1 | TT10_D_POSTE_FRENO_N | Pedestal del freno N | ASTM A36
205 | 1 | TT10_D_POSTE_FRENO_P | Pedestal del freno P | ASTM A36
216 | 1 | TT10_D_SOPORTE_FRENO_N | Placa de montaje de pinza N | ASTM A36
217 | 1 | TT10_D_SOPORTE_FRENO_P | Placa de montaje de pinza P | ASTM A36

# Bastidores de extracción de pasadores

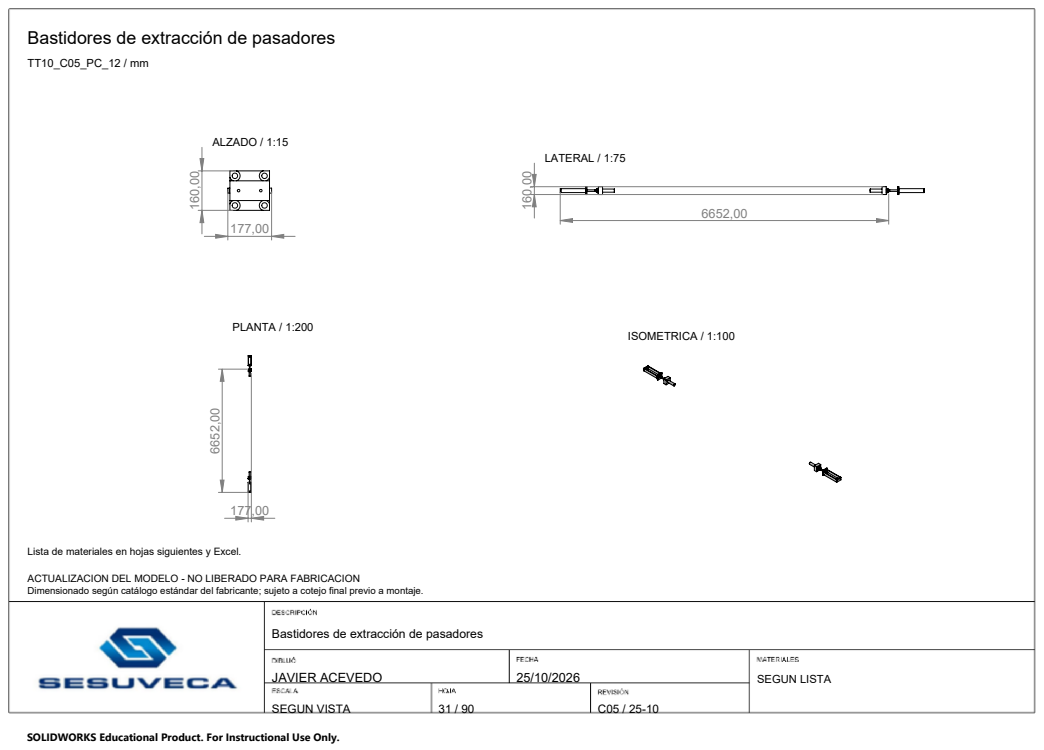
[picture p17: page 31]
JAVIER ACEVEDO; SEGUN VISTA; SEGUN LISTA; ALZADO / 1:15; LATERAL / 1:75; PLANTA / 1:200; ISOMETRICA / 1:100

Lista de materiales en hojas siguientes y Excel.

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

Bastidores de extracción de pasadores

# Bastidores de extracción de pasadores - Lista de materiales

TT10_C05_PC_12_L02 / mm

### Bastidores de extracción de pasadores - Lista de materiales

JAVIER ACEVEDO | 25/10/2026
S/E | 32 / 90 | C05 / 25-10

SEGUN LISTA

Cantidades de esta lista: instancias presentes en este conjunto.

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

POS | CANT | CODIGO | DESCRIPCION | MATERIAL
165 | 2 | TT10_D_BLANCO_PIN | Bandera de detección del pasador retirado | ASTM A36
262 | 1 | TT10_GUIA_N | Guía con alojamiento Ø69 H7; casquillo69/65.5; fuera del camino resistente | ASTM A36
263 | 1 | TT10_GUIA_P | Guía con alojamiento Ø69 H7; casquillo69/65.5; fuera del camino resistente | ASTM A36
391 | 2 | TT10_PE_ACT_VASTAGO | Extremo y vástago comercial nominal D30.2; taladro12.2; parte móvil de candidato Thomson | Subcomponente de actuador comercial
396 | 2 | TT10_PE_BEF | ISO7380-1 M6x10 8.8; cabeza baja D10.5 H3.3 envolvente; hexágono4; fijador de rosca requerido | Clase 8.8 / ISO 898-1
398 | 2 | TT10_PE_BF0 | Tornillo M10x25 clase8.8, rosca nominal; fijador de rosca según montaje | Clase 8.8 / ISO 898-1
399 | 2 | TT10_PE_BF1 | Tornillo M10x25 clase8.8, rosca nominal; fijador de rosca según montaje | Clase 8.8 / ISO 898-1
402 | 2 | TT10_PE_EJE_F | Bulón articulación D12 h8, cabeza20x4, M6-6H axial profundidad12; arandela y tornillo de retención | Arandela endurecida 300 HV / ISO 7089
404 | 2 | TT10_PE_HORQ_F | Horquilla frontal integral S355: base60x10, separación31.2, dos orejas10, D12.2H8; 2M10 de fijación | ASTM A36
405 | 2 | TT10_PE_HORQ_R | Horquilla trasera mecanizada: base130x60x10; separación26.4; eje12; 2M10 | ASTM A36
406 | 2 | TT10_PE_LARG_L | Larguero S355 plano12x80; corte a longitud503.0 | ASTM A36
407 | 2 | TT10_PE_LARG_R | Larguero S355 plano12x80; corte a longitud503.0 | ASTM A36
412 | 2 | TT10_PE_PIN | Pasador Ø65 f7 x 330; cabeza Ø90 x 15; R3; 34CrNiMo6+QT Rp0,2 mín.800 MPa | 34CrNiMo6+QT; Rp0,2 mín.800 MPa, sección<=100mm
413 | 2 | TT10_PE_PLACA_F | Placa de bastidor160x160x12; D70;4D9 y4aliviosD42 abiertos en esquinas para tuercas existentes | ASTM A36
414 | 2 | TT10_PE_PLACA_R | Travesaño160x80x12; 2M10-6H pasantes en X±45; frentes soldados a largueros | ASTM A36
415 | 2 | TT10_PE_RETEN | Placa cautiva160x160x15: amplía paso aD68,4D22 original; añade4D9 en X±45 Z±30 | ASTM A36
420 | 2 | TT10_PE_WEF | Arandela D12/d6.4/t1.6 | Arandela endurecida 300 HV / ISO 7089

# Bastidores de extracción de pasadores - Lista de materiales

TT10_C05_PC_12_L03 / mm

### Bastidores de extracción de pasadores - Lista de materiales

JAVIER ACEVEDO | 25/10/2026
S/E | 33 / 90 | C05 / 25-10

SEGUN LISTA

Cantidades de esta lista: instancias presentes en este conjunto.

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

POS | CANT | CODIGO | DESCRIPCION | MATERIAL
422 | 2 | TT10_PE_WF0 | Arandela D20/d10.5/t2 | Arandela endurecida 300 HV / ISO 7089
423 | 2 | TT10_PE_WF1 | Arandela D20/d10.5/t2 | Arandela endurecida 300 HV / ISO 7089

# Pasadores de bloqueo y casquillos

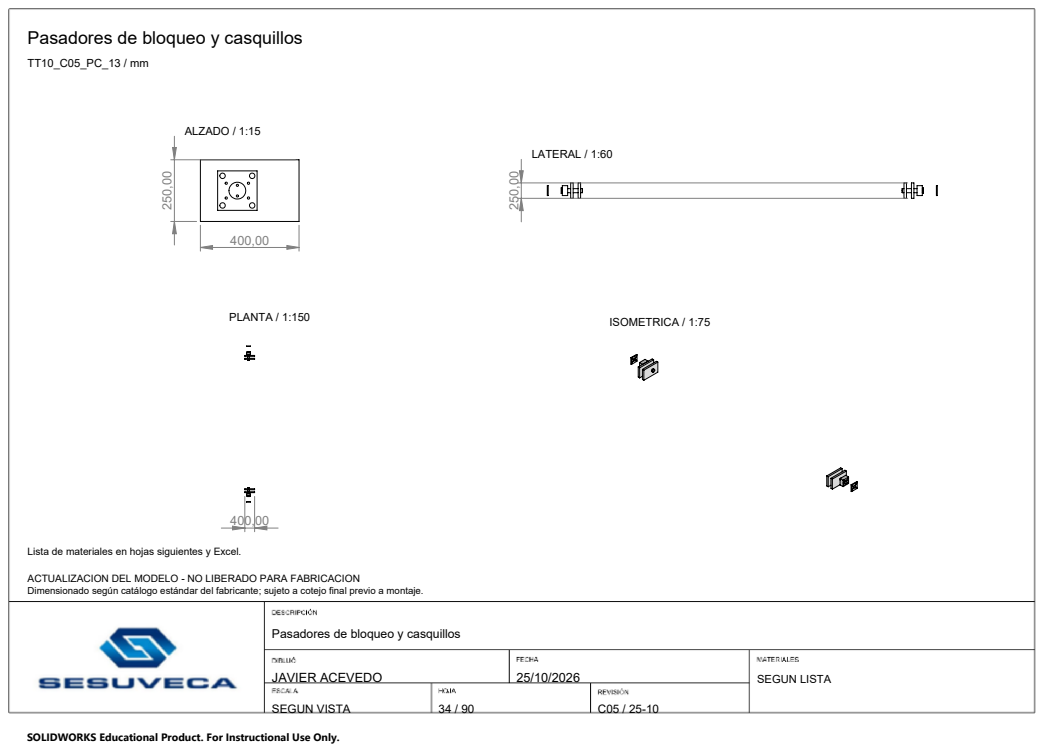
[picture p18: page 34]
JAVIER ACEVEDO; SEGUN VISTA; SEGUN LISTA; ALZADO / 1:15; LATERAL / 1:60; PLANTA / 1:150; ISOMETRICA / 1:75

Lista de materiales en hojas siguientes y Excel.

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

Pasadores de bloqueo y casquillos

# Pasadores de bloqueo y casquillos - Lista de materiales

TT10_C05_PC_13_L02 / mm

### Pasadores de bloqueo y casquillos - Lista de materiales

JAVIER ACEVEDO | 25/10/2026
S/E | 35 / 90 | C05 / 25-10

SEGUN LISTA

Cantidades de esta lista: instancias presentes en este conjunto.

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

POS | CANT | CODIGO | DESCRIPCION | MATERIAL
4 | 1 | TT10_BUJE_PIN_N | Casquillo CuSn12 Ø69 s6 / Ø65.5 H9 final, L85, C0.5 interiores | CuSn12 / EN 1982
5 | 1 | TT10_BUJE_PIN_P | Casquillo CuSn12 Ø69 s6 / Ø65.5 H9 final, L85, C0.5 interiores | CuSn12 / EN 1982
228 | 1 | TT10_F486 | Oreja fija 400 x 250 x 40; agujero Ø65 H8; Strenx 700E | Strenx700E t40; Rp0.2min700MPa
230 | 1 | TT10_F501 | Oreja fija 400 x 250 x 40; agujero Ø65 H8; Strenx 700E | Strenx700E t40; Rp0.2min700MPa
245 | 1 | TT10_F576 | Oreja fija 400 x 250 x 40; agujero Ø65 H8; Strenx 700E | Strenx700E t40; Rp0.2min700MPa
247 | 1 | TT10_F586 | Oreja fija 400 x 250 x 40; agujero Ø65 H8; Strenx 700E | Strenx700E t40; Rp0.2min700MPa
262 | 1 | TT10_GUIA_N | Guía con alojamiento Ø69 H7; casquillo69/65.5; fuera del camino resistente | ASTM A36
263 | 1 | TT10_GUIA_P | Guía con alojamiento Ø69 H7; casquillo69/65.5; fuera del camino resistente | ASTM A36
412 | 2 | TT10_PE_PIN | Pasador Ø65 f7 x 330; cabeza Ø90 x 15; R3; 34CrNiMo6+QT Rp0,2 mín.800 MPa | 34CrNiMo6+QT; Rp0,2 mín.800 MPa, sección<=100mm
415 | 2 | TT10_PE_RETEN | Placa cautiva160x160x15: amplía paso aD68,4D22 original; añade4D9 en X±45 Z±30 | ASTM A36

# Pestillos positivos y recuperación

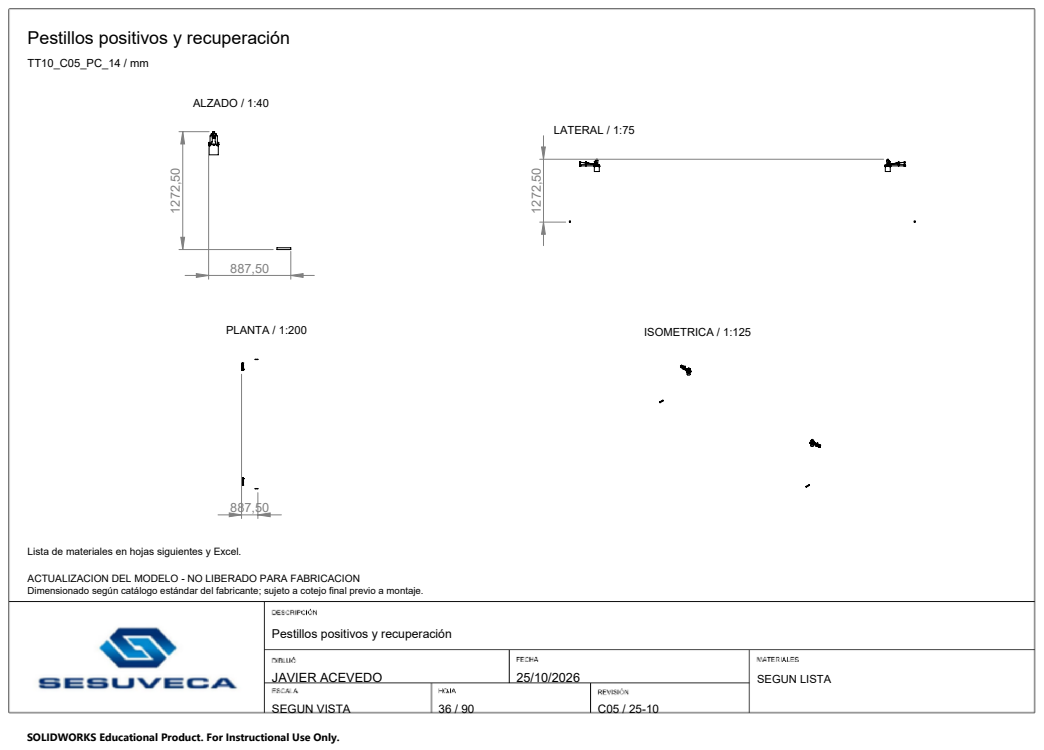
[picture p19: page 36]
JAVIER ACEVEDO; SEGUN VISTA; SEGUN LISTA; ALZADO / 1:40; LATERAL / 1:75; PLANTA / 1:200; ISOMETRICA / 1:125

Lista de materiales en hojas siguientes y Excel.

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

Pestillos positivos y recuperación

# Pestillos positivos y recuperación - Lista de materiales

TT10_C05_PC_14_L02 / mm

### Pestillos positivos y recuperación - Lista de materiales

JAVIER ACEVEDO | 25/10/2026
S/E | 37 / 90 | C05 / 25-10

SEGUN LISTA

Cantidades de esta lista: instancias presentes en este conjunto.

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

POS | CANT | CODIGO | DESCRIPCION | MATERIAL
190 | 1 | TT10_D_PALANCA_PESTILLO_N | Palanca accesible de recuperación del pestillo por cable | AISI 4140 bonificado
191 | 1 | TT10_D_PALANCA_PESTILLO_P | Palanca accesible de recuperación del pestillo por cable | AISI 4140 bonificado
270 | 2 | TT10_LK_BC0 | TornilloM6x258.8; cabeza nominal, fijador de rosca y apriete por montaje | Clase 8.8 / ISO 898-1
271 | 2 | TT10_LK_BC1 | TornilloM6x258.8; cabeza nominal, fijador de rosca y apriete por montaje | Clase 8.8 / ISO 898-1
272 | 2 | TT10_LK_BC2 | TornilloM6x258.8; cabeza nominal, fijador de rosca y apriete por montaje | Clase 8.8 / ISO 898-1
273 | 2 | TT10_LK_BC3 | TornilloM6x258.8; cabeza nominal, fijador de rosca y apriete por montaje | Clase 8.8 / ISO 898-1
274 | 2 | TT10_LK_BL0 | TornilloM6x908.8; cabeza nominal, fijador de rosca y apriete por montaje | Clase 8.8 / ISO 898-1
275 | 2 | TT10_LK_BS0 | TornilloM10x258.8; cabeza nominal, fijador de rosca y apriete por montaje | Clase 8.8 / ISO 898-1
276 | 2 | TT10_LK_BS1 | TornilloM10x258.8; cabeza nominal, fijador de rosca y apriete por montaje | Clase 8.8 / ISO 898-1
277 | 2 | TT10_LK_BS2 | TornilloM10x258.8; cabeza nominal, fijador de rosca y apriete por montaje | Clase 8.8 / ISO 898-1
278 | 2 | TT10_LK_BS3 | TornilloM10x258.8; cabeza nominal, fijador de rosca y apriete por montaje | Clase 8.8 / ISO 898-1
279 | 2 | TT10_LK_BSE0 | TornilloISO4762 M6x20 8.8;5.4mm de rosca en guia, fijador y apriete4Nm | Clase 8.8 / ISO 898-1
280 | 2 | TT10_LK_BSE1 | TornilloISO4762 M6x20 8.8;5.4mm de rosca en guia, fijador y apriete4Nm | Clase 8.8 / ISO 898-1
281 | 2 | TT10_LK_GTCA100 | Magnet-Schultz GTCA100X43A02,24V,S1: envolvente e interfaces publicadas; no CAD oficial | Equipo comercial condicional; polvo desconocido
282 | 2 | TT10_LK_GUIA | Pestillo: guia abierta20.4x20.4, brazo25x42, pie80x12; asiento solenoide110/88 | ASTM A36
283 | 2 | TT10_LK_LAMINA | Resorte de lamina20x1.8, longitud activa330, precarga equivalente50mm; forma instalada; horquillaU R6.5, sin esquina interna recta | 51CrV4 templado/revenido; Rp0.2≥1000MPa,Rm≥1250MPa; superficie y fatiga por verificar
284 | 2 | TT10_LK_MORDAZA_LAMINA | Mordaza30x20x9.1 para resorte; no soldar ni taladrar zona activa de la lamina | ASTM A36
285 | 2 | TT10_LK_NL0 | TuercaM6clase8, retencion positiva segun montaje | Tuerca clase 8 / ISO 898-2

# Pestillos positivos y recuperación - Lista de materiales

TT10_C05_PC_14_L03 / mm

### Pestillos positivos y recuperación - Lista de materiales

JAVIER ACEVEDO | 25/10/2026
S/E | 38 / 90 | C05 / 25-10

SEGUN LISTA

Cantidades de esta lista: instancias presentes en este conjunto.

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

POS | CANT | CODIGO | DESCRIPCION | MATERIAL
286 | 2 | TT10_LK_NT | TuercaM6clase8, retencion positiva segun montaje | Tuerca clase 8 / ISO 898-2
287 | 2 | TT10_LK_PESTILLO | Pestillo42CrMo4+QT, punta20x20, enganche radial nominal9mm, retirada25mm; M12 liberacion | AISI 4140 bonificado
288 | 2 | TT10_LK_SENSOR | ifmIE5338: sensor ordinarioPNP de enganche; M8x1, cara Y22, entrehierro nominal1mm | Sensor comercial; materiales según referencia OEM
289 | 2 | TT10_LK_SOP_SENSOR | Soporte desmontable: sensor a cara real del pestillo; dosM6x20, sin soldar a la guia | ASTM A36
290 | 2 | TT10_LK_TAPA | Tapa de guia desmontable; tornillo de recorrido y fijaciones de tapa pendientes de comprobacion | Clase 8.8 / ISO 898-1
291 | 2 | TT10_LK_TIRANTE | TiranteM12 nominal entre pestillo y solenoide; longitud ajustable, conexion OEM por verificar | ASTM A36
292 | 2 | TT10_LK_TOPE | Tornillo de hombroD8, paso de recorrido; conexion roscada nominal pendiente de detalle | Clase 10.9 / ISO 898-1
293 | 2 | TT10_LK_WC0 | ArandelaD12/d6.4/t1.6 | Arandela endurecida 300 HV / ISO 7089
294 | 2 | TT10_LK_WC1 | ArandelaD12/d6.4/t1.6 | Arandela endurecida 300 HV / ISO 7089
295 | 2 | TT10_LK_WC2 | ArandelaD12/d6.4/t1.6 | Arandela endurecida 300 HV / ISO 7089
296 | 2 | TT10_LK_WC3 | ArandelaD12/d6.4/t1.6 | Arandela endurecida 300 HV / ISO 7089
297 | 2 | TT10_LK_WL0 | ArandelaD12/d6.4/t1.6 | Arandela endurecida 300 HV / ISO 7089
298 | 2 | TT10_LK_WS0 | ArandelaD20/d10.5/t2 | Arandela endurecida 300 HV / ISO 7089
299 | 2 | TT10_LK_WS1 | ArandelaD20/d10.5/t2 | Arandela endurecida 300 HV / ISO 7089
300 | 2 | TT10_LK_WS2 | ArandelaD20/d10.5/t2 | Arandela endurecida 300 HV / ISO 7089
301 | 2 | TT10_LK_WS3 | ArandelaD20/d10.5/t2 | Arandela endurecida 300 HV / ISO 7089
302 | 2 | TT10_LK_WSE0 | ArandelaISO7089 M6 200HV | Arandela endurecida 200 HV / ISO 7089
303 | 2 | TT10_LK_WSE1 | ArandelaISO7089 M6 200HV | Arandela endurecida 200 HV / ISO 7089

# Pestillos positivos y recuperación - Lista de materiales

TT10_C05_PC_14_L04 / mm

### Pestillos positivos y recuperación - Lista de materiales

JAVIER ACEVEDO | 25/10/2026
S/E | 39 / 90 | C05 / 25-10

SEGUN LISTA

Cantidades de esta lista: instancias presentes en este conjunto.

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

POS | CANT | CODIGO | DESCRIPCION | MATERIAL
304 | 2 | TT10_LK_WT | ArandelaD12/d6.4/t1.6 | Arandela endurecida 300 HV / ISO 7089

# Soportes y regulación de detectores

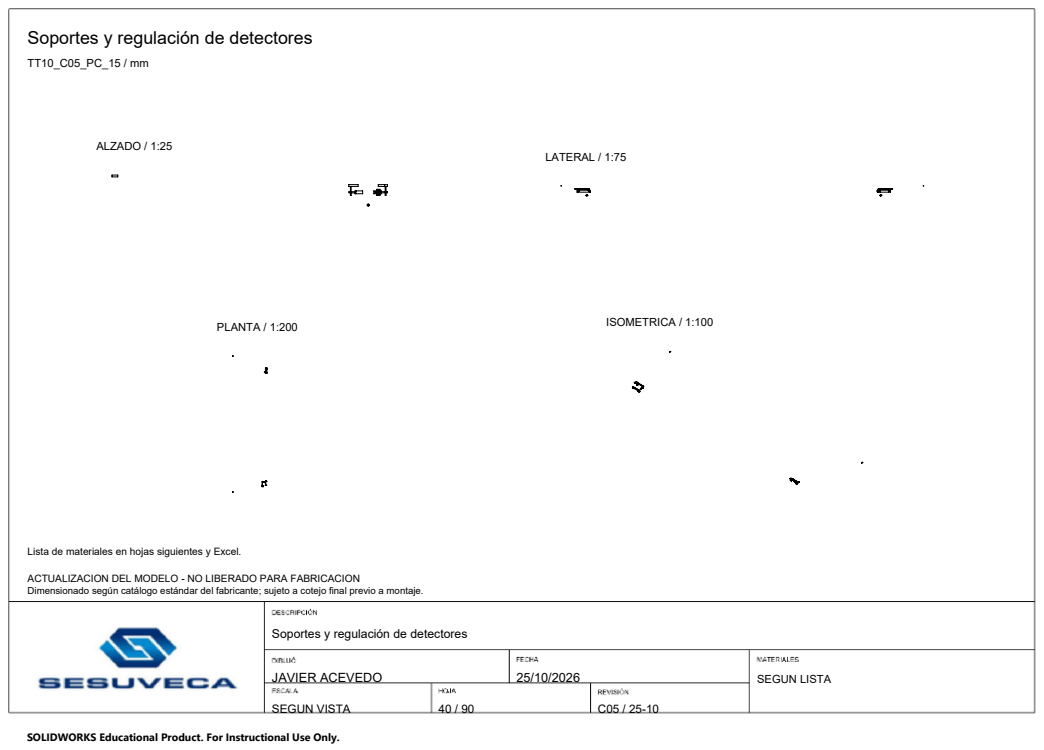
[picture p20: page 40]
JAVIER ACEVEDO; SEGUN VISTA; SEGUN LISTA; ALZADO / 1:25; LATERAL / 1:75; PLANTA / 1:200; ISOMETRICA / 1:100

Lista de materiales en hojas siguientes y Excel.

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

Soportes y regulación de detectores

# Soportes y regulación de detectores - Lista de materiales

TT10_C05_PC_15_L02 / mm

### Soportes y regulación de detectores - Lista de materiales

JAVIER ACEVEDO | 25/10/2026
S/E | 41 / 90 | C05 / 25-10

SEGUN LISTA

Cantidades de esta lista: instancias presentes en este conjunto.

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

POS | CANT | CODIGO | DESCRIPCION | MATERIAL
165 | 2 | TT10_D_BLANCO_PIN | Bandera de detección del pasador retirado | ASTM A36
214 | 1 | TT10_D_SENSOR_FRENO_N | Eje de conexión geométrica SENSOR_FRENO_N | Sensor comercial; materiales según referencia OEM
215 | 1 | TT10_D_SENSOR_FRENO_P | Eje de conexión geométrica SENSOR_FRENO_P | Sensor comercial; materiales según referencia OEM
288 | 2 | TT10_LK_SENSOR | ifmIE5338: sensor ordinarioPNP de enganche; M8x1, cara Y22, entrehierro nominal1mm | Sensor comercial; materiales según referencia OEM
432 | 1 | TT10_R6M_BRAZO_SENSOR_N_INSERTADO | Brazo fijo de detector; unión soldada a pie sobre larguero | ASTM A36
433 | 1 | TT10_R6M_BRAZO_SENSOR_N_RETIRADO | Brazo fijo de detector; unión soldada a pie sobre larguero | ASTM A36
434 | 1 | TT10_R6M_BRAZO_SENSOR_P_INSERTADO | Brazo fijo de detector; unión soldada a pie sobre larguero | ASTM A36
435 | 1 | TT10_R6M_BRAZO_SENSOR_P_RETIRADO | Brazo fijo de detector; unión soldada a pie sobre larguero | ASTM A36
438 | 1 | TT10_R6M_IE5338_N_INSERTADO | ifmIE5338,M8x1L40,SN3mm;N INSERTADO | Conjunto comercial ifm
439 | 1 | TT10_R6M_IE5338_N_RETIRADO | ifmIE5338,M8x1L40,SN3mm;N RETIRADO | Conjunto comercial ifm
440 | 1 | TT10_R6M_IE5338_P_INSERTADO | ifmIE5338,M8x1L40,SN3mm;P INSERTADO | Conjunto comercial ifm
441 | 1 | TT10_R6M_IE5338_P_RETIRADO | ifmIE5338,M8x1L40,SN3mm;P RETIRADO | Conjunto comercial ifm
444 | 1 | TT10_R6M_PIE_SENSORES_N | Pie12 sobre cara superior del larguero; soldadura a3,20mm por ambas caras | ASTM A36
445 | 1 | TT10_R6M_PIE_SENSORES_P | Pie12 sobre cara superior del larguero; soldadura a3,20mm por ambas caras | ASTM A36
447 | 1 | TT10_R6M_SOP_SENSOR_N_INSERTADO | Escuadra6;taladroØ8.5 para sensorM8;frente de detección a1mm del blanco | ASTM A36
448 | 1 | TT10_R6M_SOP_SENSOR_N_RETIRADO | Escuadra6;taladroØ8.5 para sensorM8;frente de detección a1mm del blanco | ASTM A36
449 | 1 | TT10_R6M_SOP_SENSOR_P_INSERTADO | Escuadra6;taladroØ8.5 para sensorM8;frente de detección a1mm del blanco | ASTM A36
450 | 1 | TT10_R6M_SOP_SENSOR_P_RETIRADO | Escuadra6;taladroØ8.5 para sensorM8;frente de detección a1mm del blanco | ASTM A36
451 | 4 | TT10_SEN_B6_P0 | Tornillo ISO4762 M6x16 8.8, cabeza D10 H6, hexágono5; rosca nominal | Clase 8.8 / ISO 898-1

# Soportes y regulación de detectores - Lista de materiales

TT10_C05_PC_15_L03 / mm

### Soportes y regulación de detectores - Lista de materiales

JAVIER ACEVEDO | 25/10/2026
S/E | 42 / 90 | C05 / 25-10

SEGUN LISTA

Cantidades de esta lista: instancias presentes en este conjunto.

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

POS | CANT | CODIGO | DESCRIPCION | MATERIAL
452 | 4 | TT10_SEN_P_IN | IFM IE5338 M8x1 L40, Sn3, NO PNP/NPN, 10-30VDC; incluye dos contratuercas | Conjunto comercial IFM; latón y polímeros
453 | 2 | TT10_SEN_SOP_P | Soporte soldado desmontable: carril6x40x229 y pie4x40x16.5; dos M6x16; dos D8.5 | ASTM A36

# Tensor de cadena y puesto manual

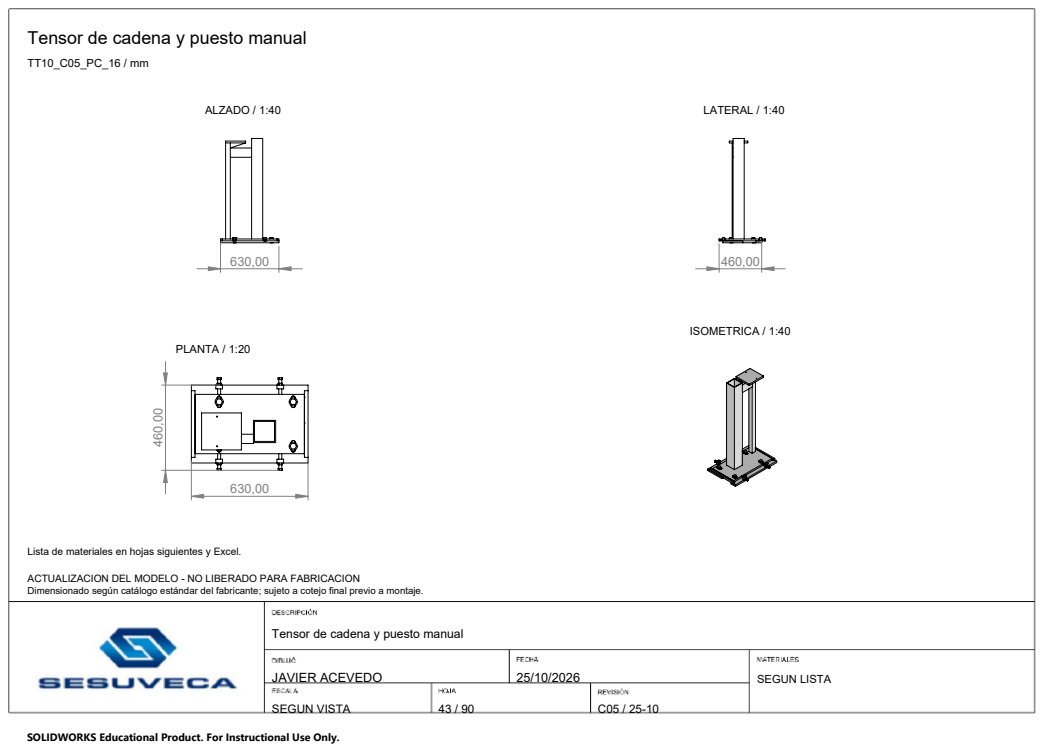
[picture p21: page 43]
JAVIER ACEVEDO; SEGUN VISTA; SEGUN LISTA; ALZADO / 1:40; LATERAL / 1:40; PLANTA / 1:20; ISOMETRICA / 1:40

Lista de materiales en hojas siguientes y Excel.

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

Tensor de cadena y puesto manual

# Tensor de cadena y puesto manual - Lista de materiales

TT10_C05_PC_16_L02 / mm

### Tensor de cadena y puesto manual - Lista de materiales

JAVIER ACEVEDO | 25/10/2026
S/E | 44 / 90 | C05 / 25-10

SEGUN LISTA

Cantidades de esta lista: instancias presentes en este conjunto.

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

POS | CANT | CODIGO | DESCRIPCION | MATERIAL
40 | 1 | TT10_C04_BANCADA | Bancada215x200x20, sobre poste corto; soldaduraa3 | ASTM A36
41 | 1 | TT10_C04_CARTELA_0 | Cartela12,165x55, a3 continuo a placa y poste | ASTM A36
42 | 1 | TT10_C04_CARTELA_1 | Cartela12,165x55, a3 continuo a placa y poste | ASTM A36
79 | 1 | TT10_C04_TRAVESANO | RHS100x50x5,L230; une los dos postes del puesto manual, a3 | S275J0H / EN 10219-1
80 | 1 | TT10_C05_ARANDELA_TENSOR_0 | Arandela puente44x21x4, endurecida, cubre ranura22 | Arandela endurecida 300 HV / ISO 7089
81 | 1 | TT10_C05_ARANDELA_TENSOR_1 | Arandela puente44x21x4, endurecida, cubre ranura22 | Arandela endurecida 300 HV / ISO 7089
82 | 1 | TT10_C05_ARANDELA_TENSOR_2 | Arandela puente44x21x4, endurecida, cubre ranura22 | Arandela endurecida 300 HV / ISO 7089
83 | 1 | TT10_C05_ARANDELA_TENSOR_3 | Arandela puente44x21x4, endurecida, cubre ranura22 | Arandela endurecida 300 HV / ISO 7089
84 | 1 | TT10_C05_B20_TENSOR_0 | Tornillo M20x45,ISO4017 8.8; geometria nominal | Clase 8.8 / ISO 898-1
85 | 1 | TT10_C05_B20_TENSOR_1 | Tornillo M20x45,ISO4017 8.8; geometria nominal | Clase 8.8 / ISO 898-1
86 | 1 | TT10_C05_B20_TENSOR_2 | Tornillo M20x45,ISO4017 8.8; geometria nominal | Clase 8.8 / ISO 898-1
87 | 1 | TT10_C05_B20_TENSOR_3 | Tornillo M20x45,ISO4017 8.8; geometria nominal | Clase 8.8 / ISO 898-1
92 | 1 | TT10_C05_BASE_FIJA_TENSOR | Base fija630x420x20; cuatro M20 roscados20;apriete100Nm;no son anclajes a losa | ASTM A36
127 | 1 | TT10_C05_CORREDERA_TENSOR | Corredera comun590x320x20;4ranuras22x62; carrera Y+/-20mm; ambos postes solidarios | ASTM A36
128 | 1 | TT10_C05_GUIA_TENSOR_0 | Guia lateral mecanizada;holgura transversal total0.3..0.5mm; soldar a base fija y mecanizar despues | ASTM A36
129 | 1 | TT10_C05_GUIA_TENSOR_1 | Guia lateral mecanizada;holgura transversal total0.3..0.5mm; soldar a base fija y mecanizar despues | ASTM A36
130 | 1 | TT10_C05_JACK_M16_0_0 | M16x80,8.8 de regulacion; rosca total; punta plana; bloquear con contratuerca | 8.8
131 | 1 | TT10_C05_JACK_M16_0_1 | M16x80,8.8 de regulacion; rosca total; punta plana; bloquear con contratuerca | 8.8

# Tensor de cadena y puesto manual - Lista de materiales

TT10_C05_PC_16_L03 / mm

### Tensor de cadena y puesto manual - Lista de materiales

JAVIER ACEVEDO | 25/10/2026
S/E | 45 / 90 | C05 / 25-10

SEGUN LISTA

Cantidades de esta lista: instancias presentes en este conjunto.

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

POS | CANT | CODIGO | DESCRIPCION | MATERIAL
132 | 1 | TT10_C05_JACK_M16_1_0 | M16x80,8.8 de regulacion; rosca total; punta plana; bloquear con contratuerca | 8.8
133 | 1 | TT10_C05_JACK_M16_1_1 | M16x80,8.8 de regulacion; rosca total; punta plana; bloquear con contratuerca | 8.8
134 | 1 | TT10_C05_JAM_M16_0_0 | ContratuercaM16 clase8; mantener ajuste con cuatro M20 apretados | Tuerca clase 8 / ISO 898-2
135 | 1 | TT10_C05_JAM_M16_0_1 | ContratuercaM16 clase8; mantener ajuste con cuatro M20 apretados | Tuerca clase 8 / ISO 898-2
136 | 1 | TT10_C05_JAM_M16_1_0 | ContratuercaM16 clase8; mantener ajuste con cuatro M20 apretados | Tuerca clase 8 / ISO 898-2
137 | 1 | TT10_C05_JAM_M16_1_1 | ContratuercaM16 clase8; mantener ajuste con cuatro M20 apretados | Tuerca clase 8 / ISO 898-2
138 | 1 | TT10_C05_OREJA_TENSOR_0_0 | Oreja36x20x36;M16x2; soldaduraa6 a base fija | ASTM A36
139 | 1 | TT10_C05_OREJA_TENSOR_0_1 | Oreja36x20x36;M16x2; soldaduraa6 a base fija | ASTM A36
140 | 1 | TT10_C05_OREJA_TENSOR_1_0 | Oreja36x20x36;M16x2; soldaduraa6 a base fija | ASTM A36
141 | 1 | TT10_C05_OREJA_TENSOR_1_1 | Oreja36x20x36;M16x2; soldaduraa6 a base fija | ASTM A36
142 | 1 | TT10_C05_POSTE_CORTO_TENSOR | RHS50x50x5;L1037.5;recortado20para conservar altura del eje | S275J0H / EN 10219-1
143 | 1 | TT10_C05_POSTE_VOLANTE_TENSOR | Poste del volante recortado20mm; conservar mecanizado superior y centros | ASTM A36

# Volante, eje y freno del timón

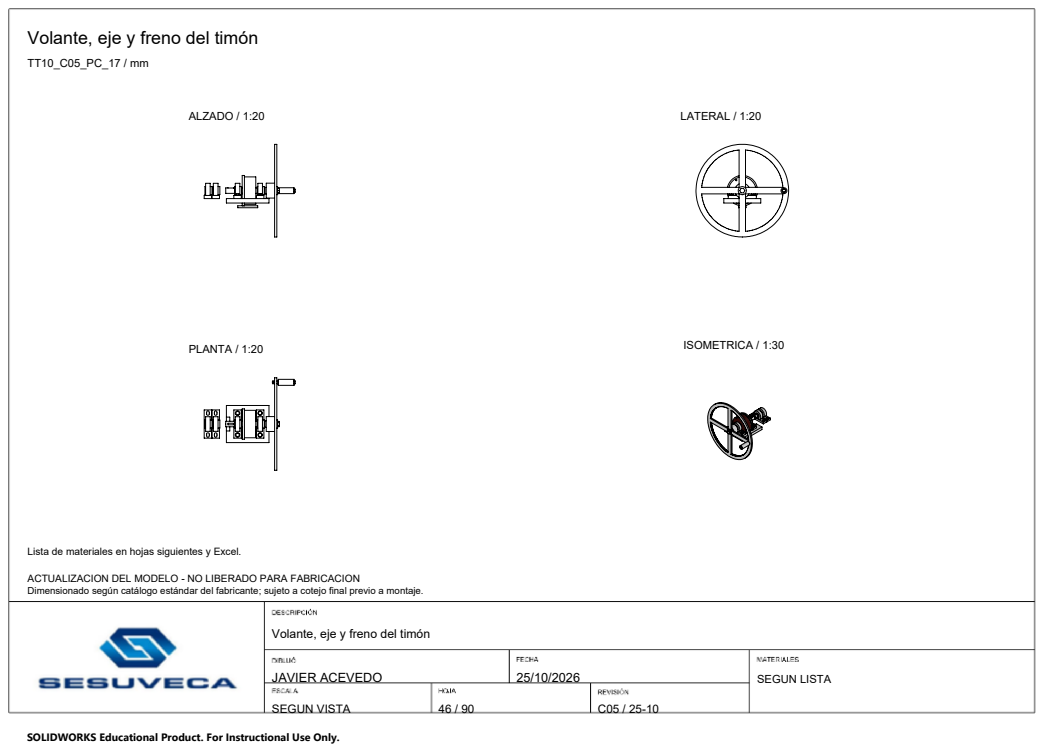
[picture p22: page 46]
JAVIER ACEVEDO; SEGUN VISTA; SEGUN LISTA; ALZADO / 1:20; LATERAL / 1:20; PLANTA / 1:20; ISOMETRICA / 1:30

Lista de materiales en hojas siguientes y Excel.

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

Volante, eje y freno del timón

# Volante, eje y freno del timón - Lista de materiales

TT10_C05_PC_17_L02 / mm

### Volante, eje y freno del timón - Lista de materiales

JAVIER ACEVEDO | 25/10/2026
S/E | 47 / 90 | C05 / 25-10

SEGUN LISTA

Cantidades de esta lista: instancias presentes en este conjunto.

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

POS | CANT | CODIGO | DESCRIPCION | MATERIAL
50 | 1 | TT10_C04_EJE_TIMON | Eje heredado con extremoX1026 y chavetero adicional8x7x30; Mayr conservado | AISI 4140 bonificado
66 | 1 | TT10_C04_PLACA_TIMON | Placa de estacion existente con ventanaR57x25 para bridas110; apoyos yMayr conservados | ASTM A36
436 | 1 | TT10_R6M_CHAVETA_FRENO_TIMON | ChavetaDIN6885/1 8x7x25 C45E | AISI 4140 bonificado
437 | 1 | TT10_R6M_CUBO_FRENO_TIMON | Cubo comercial simplificado: Ø30H7,8JS9;L25; verificar suministro con referencia mayr | AISI 4140 bonificado
442 | 1 | TT10_R6M_MAYR_32 | mayr32/891.101.0/24/30/6885/1 JS9;64Nm; rotor metálico; liberación manual | Conjunto comercial mayr
443 | 1 | TT10_R6M_PEDESTAL_FRENO | Travesaño108x40x10 entre caras interiores del poste existente; soldadura a3,40mm por extremo | ASTM A36
446 | 1 | TT10_R6M_PLACA_FRENO_TIMON | Placa12, caraX1127; centrado y3M6PCD132; sujeción a pedestal por cartelas | ASTM A36
462 | 1 | TT10_TM_ARANDELA16 | Arandela de retención D44/d17/t4 | Arandela endurecida 300 HV / ISO 7089
463 | 1 | TT10_TM_B12_0 | Tornillo M12x40 8.8, s18, rosca nominal; enganche20.5mm en placa | Clase 8.8 / ISO 898-1
464 | 1 | TT10_TM_B12_1 | Tornillo M12x40 8.8, s18, rosca nominal; enganche20.5mm en placa | Clase 8.8 / ISO 898-1
465 | 1 | TT10_TM_B12_2 | Tornillo M12x40 8.8, s18, rosca nominal; enganche20.5mm en placa | Clase 8.8 / ISO 898-1
466 | 1 | TT10_TM_B12_3 | Tornillo M12x40 8.8, s18, rosca nominal; enganche20.5mm en placa | Clase 8.8 / ISO 898-1
467 | 1 | TT10_TM_CHAVETA | Chaveta paralela8x7x40, extremos R4, formaA; acero C45E | AISI 4140 bonificado
468 | 1 | TT10_TM_CUBO | Cubo D80/D30 H7 L45; chavetero8 JS9, profundidad3.3 sobre radio nominal | AISI 4140 bonificado
469 | 1 | TT10_TM_EJE_PUNO | Perno escalonado: M8, hombro14, pistaD10 h9 L87.3 y cabeza16; pistaRa≤0.8 | Clase 10.9 / ISO 898-1
470 | 1 | TT10_TM_PUNO | Empuñadura giratoria POM D32/d10.4 L85 | POM-C; ficha de proveedor requerida
471 | 1 | TT10_TM_PUNO_N8 | Tuerca autoblocante metálica M8 h8 s13; geometría nominal | Tuerca clase 8 / ISO 898-2
472 | 1 | TT10_TM_PUNO_W0 | Arandela lisa D20/d10.5/t1 para empuñadura | Arandela endurecida 300 HV / ISO 7089
473 | 1 | TT10_TM_PUNO_W1 | Arandela lisa D20/d10.5/t1 para empuñadura | Arandela endurecida 300 HV / ISO 7089

# Volante, eje y freno del timón - Lista de materiales

TT10_C05_PC_17_L03 / mm

### Volante, eje y freno del timón - Lista de materiales

JAVIER ACEVEDO | 25/10/2026
S/E | 48 / 90 | C05 / 25-10

SEGUN LISTA

Cantidades de esta lista: instancias presentes en este conjunto.

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

POS | CANT | CODIGO | DESCRIPCION | MATERIAL
474 | 1 | TT10_TM_PUNO_W8 | Arandela M8 D16/d8.4/t1.6 | Arandela endurecida 300 HV / ISO 7089
475 | 3 | TT10_TM_SY30_0 | SKF SY30TF, d30, H42.9, base152x40, pasos117.5; interfaces nominales | Conjunto comprado; acero/ fundición según OEM
476 | 1 | TT10_TM_SY30_1 | SKF SY30TF, d30, H42.9, base152x40, pasos117.5; interfaces nominales | Conjunto comprado; acero/ fundición según OEM
477 | 1 | TT10_TM_TORNILLO16 | Tornillo M16x35 clase8.8, s24; retiene axialmente rueda y cubo | Clase 8.8 / ISO 898-1
478 | 1 | TT10_TM_VOLANTE | Volante D500 t12, cuatro radios; D8.5 para empuñadura; soldado al cubo | ASTM A36
479 | 1 | TT10_TM_W12_0 | Arandela M12 D24/d13/t2.5 | Arandela endurecida 300 HV / ISO 7089
480 | 1 | TT10_TM_W12_1 | Arandela M12 D24/d13/t2.5 | Arandela endurecida 300 HV / ISO 7089
481 | 1 | TT10_TM_W12_2 | Arandela M12 D24/d13/t2.5 | Arandela endurecida 300 HV / ISO 7089
482 | 1 | TT10_TM_W12_3 | Arandela M12 D24/d13/t2.5 | Arandela endurecida 300 HV / ISO 7089

# Transmisión por cadena y acoples

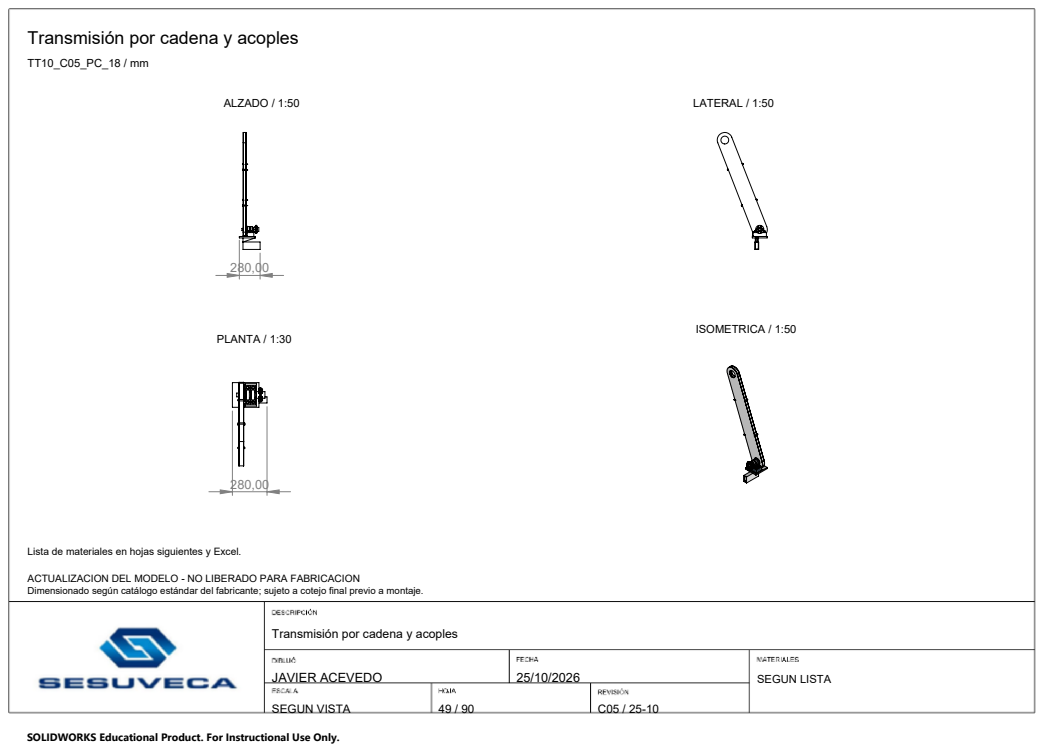
[picture p23: page 49]
JAVIER ACEVEDO; SEGUN VISTA; SEGUN LISTA; ALZADO / 1:50; LATERAL / 1:50; PLANTA / 1:30; ISOMETRICA / 1:50

Lista de materiales en hojas siguientes y Excel.

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

Transmisión por cadena y acoples

# Transmisión por cadena y acoples - Lista de materiales

TT10_C05_PC_18_L02 / mm

### Transmisión por cadena y acoples - Lista de materiales

JAVIER ACEVEDO | 25/10/2026
S/E | 50 / 90 | C05 / 25-10

SEGUN LISTA

Cantidades de esta lista: instancias presentes en este conjunto.

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

POS | CANT | CODIGO | DESCRIPCION | MATERIAL
8 | 122 | TT10_C03_CADENA_ESLABON | Renold16B1: referencia visual de eslabon; no fabricar. Rodillos compartidos representados dos veces | Equipo comprado Renold
28 | 1 | TT10_C04_ACOPLE_0 | Brida110x8,PCD82/6M8; bore30H7; asiento25, desmontaje axial | C45E / EN 10083-2
29 | 1 | TT10_C04_ACOPLE_1 | Brida110x8,PCD82/6M8; bore30H7; asiento30, desmontaje axial | C45E / EN 10083-2
30 | 4 | TT10_C04_ACOPLE_B8_0 | M8x25,8.8; cabeza exterior; apriete por plano | Clase 10.9 / ISO 898-1
31 | 2 | TT10_C04_ACOPLE_B8_4 | M8x25,8.8; cabeza exterior; apriete por plano | Clase 10.9 / ISO 898-1
32 | 4 | TT10_C04_ACOPLE_N8_0 | TuercaM8 clase8, autoblocante nominal | Tuerca clase 10 / ISO 898-2
33 | 2 | TT10_C04_ACOPLE_N8_2 | TuercaM8 clase8, autoblocante nominal | Tuerca clase 10 / ISO 898-2
34 | 1 | TT10_C04_ASIENTO_CHUMACERAS | Bloque90x180x52.1; cara superior mecanizada y4M12 ciegas28 | Conjunto comprado; acero/ fundición según OEM
40 | 1 | TT10_C04_BANCADA | Bancada215x200x20, sobre poste corto; soldaduraa3 | ASTM A36
41 | 1 | TT10_C04_CARTELA_0 | Cartela12,165x55, a3 continuo a placa y poste | ASTM A36
42 | 1 | TT10_C04_CARTELA_1 | Cartela12,165x55, a3 continuo a placa y poste | ASTM A36
43 | 1 | TT10_C04_CHAVETA_ACOPLE_0 | Chaveta8x7x25 | AISI 4140 bonificado
44 | 1 | TT10_C04_CHAVETA_ACOPLE_1 | Chaveta8x7x30 | AISI 4140 bonificado
45 | 1 | TT10_C04_CHAVETA_CORONA | Chaveta8x7x40 de corona | AISI 4140 bonificado
47 | 1 | TT10_C04_CORONA_20D | Corona10888120; bore30H7 y chavetero8JS9 abierto al bore en todo su ancho; dentado comprado simplificado | C45E
49 | 1 | TT10_C04_EJE_MANUAL | EjeD30h7,L184; chaveteros8x7, t1=4, extremos planos | AISI 4140 bonificado
53 | 1 | TT10_C04_GUARDA_ANCLA6_4470 | M6x16,8.8 a bancada; no anclaje a losa | Tornilleria8.8
54 | 1 | TT10_C04_GUARDA_ANCLA6_4630 | M6x16,8.8 a bancada; no anclaje a losa | Tornilleria8.8

# Transmisión por cadena y acoples - Lista de materiales

TT10_C05_PC_18_L03 / mm

### Transmisión por cadena y acoples - Lista de materiales

JAVIER ACEVEDO | 25/10/2026
S/E | 51 / 90 | C05 / 25-10

SEGUN LISTA

Cantidades de esta lista: instancias presentes en este conjunto.

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

POS | CANT | CODIGO | DESCRIPCION | MATERIAL
55 | 4 | TT10_C04_GUARDA_B6_0 | M6x50,8.8 para tapa frontal | Clase 8.8 / ISO 898-1
56 | 1 | TT10_C04_GUARDA_BANDA | Banda2, ancho36; tapa inferior; soldar a posterior, frontal desmontable | ASTM A36
57 | 1 | TT10_C04_GUARDA_BASEW6_4470 | Arandela6,12x6.6x2 | Arandela endurecida 300 HV / ISO 7089
58 | 1 | TT10_C04_GUARDA_BASEW6_4630 | Arandela6,12x6.6x2 | Arandela endurecida 300 HV / ISO 7089
59 | 1 | TT10_C04_GUARDA_FRONTAL | Chapa2; contorno de cadena; inferiorZ1107; paso superior/FRONTAL | ASTM A36
60 | 3 | TT10_C04_GUARDA_N6_0 | TuercaM6 autoblocante metalica; contorno nominal | Tornilleria8
61 | 1 | TT10_C04_GUARDA_N6_2 | TuercaM6 autoblocante metalica; contorno nominal | Tornilleria8
62 | 1 | TT10_C04_GUARDA_POSTERIOR | Chapa2; contorno de cadena; inferiorZ1107; paso superior/POSTERIOR | ASTM A36
63 | 3 | TT10_C04_GUARDA_W6_0 | ArandelaM6,12x6.6x1.6 | Arandela endurecida 300 HV / ISO 7089
64 | 1 | TT10_C04_GUARDA_W6_2 | ArandelaM6,12x6.6x1.6 | Arandela endurecida 300 HV / ISO 7089
73 | 2 | TT10_C04_SY30_B12_930_4491.25 | M12x45,8.8;25.5mm nominales de rosca util | Clase 8.8 / ISO 898-1
74 | 2 | TT10_C04_SY30_B12_972_4491.25 | M12x45,8.8;25.5mm nominales de rosca util | Clase 8.8 / ISO 898-1
75 | 2 | TT10_C04_SY30_W12_930_4491.25 | ArandelaM12,24x13x2.5 | Arandela endurecida 300 HV / ISO 7089
76 | 2 | TT10_C04_SY30_W12_930_4608.75 | ArandelaM12,24x13x2.5 | Arandela endurecida 300 HV / ISO 7089
79 | 1 | TT10_C04_TRAVESANO | RHS100x50x5,L230; une los dos postes del puesto manual, a3 | S275J0H / EN 10219-1
475 | 2 | TT10_TM_SY30_0 | SKF SY30TF, d30, H42.9, base152x40, pasos117.5; interfaces nominales | Conjunto comprado; acero/ fundición según OEM

# Resguardo desmontable de cadena

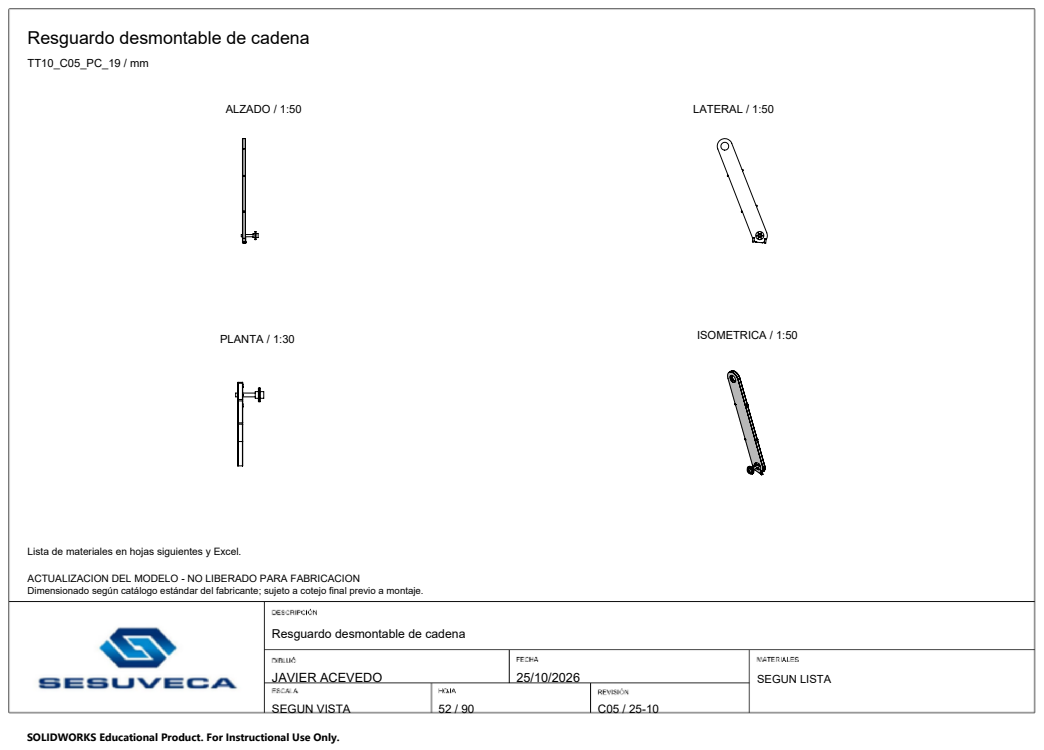
[picture p24: page 52]
JAVIER ACEVEDO; SEGUN VISTA; SEGUN LISTA; ALZADO / 1:50; LATERAL / 1:50; PLANTA / 1:30; ISOMETRICA / 1:50

Lista de materiales en hojas siguientes y Excel.

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

Resguardo desmontable de cadena

# Resguardo desmontable de cadena - Lista de materiales

TT10_C05_PC_19_L02 / mm

### Resguardo desmontable de cadena - Lista de materiales

JAVIER ACEVEDO | 25/10/2026
S/E | 53 / 90 | C05 / 25-10

SEGUN LISTA

Cantidades de esta lista: instancias presentes en este conjunto.

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

POS | CANT | CODIGO | DESCRIPCION | MATERIAL
8 | 122 | TT10_C03_CADENA_ESLABON | Renold16B1: referencia visual de eslabon; no fabricar. Rodillos compartidos representados dos veces | Equipo comprado Renold
28 | 1 | TT10_C04_ACOPLE_0 | Brida110x8,PCD82/6M8; bore30H7; asiento25, desmontaje axial | C45E / EN 10083-2
29 | 1 | TT10_C04_ACOPLE_1 | Brida110x8,PCD82/6M8; bore30H7; asiento30, desmontaje axial | C45E / EN 10083-2
49 | 1 | TT10_C04_EJE_MANUAL | EjeD30h7,L184; chaveteros8x7, t1=4, extremos planos | AISI 4140 bonificado
56 | 1 | TT10_C04_GUARDA_BANDA | Banda2, ancho36; tapa inferior; soldar a posterior, frontal desmontable | ASTM A36
59 | 1 | TT10_C04_GUARDA_FRONTAL | Chapa2; contorno de cadena; inferiorZ1107; paso superior/FRONTAL | ASTM A36
62 | 1 | TT10_C04_GUARDA_POSTERIOR | Chapa2; contorno de cadena; inferiorZ1107; paso superior/POSTERIOR | ASTM A36

# Caja y soportes del selector

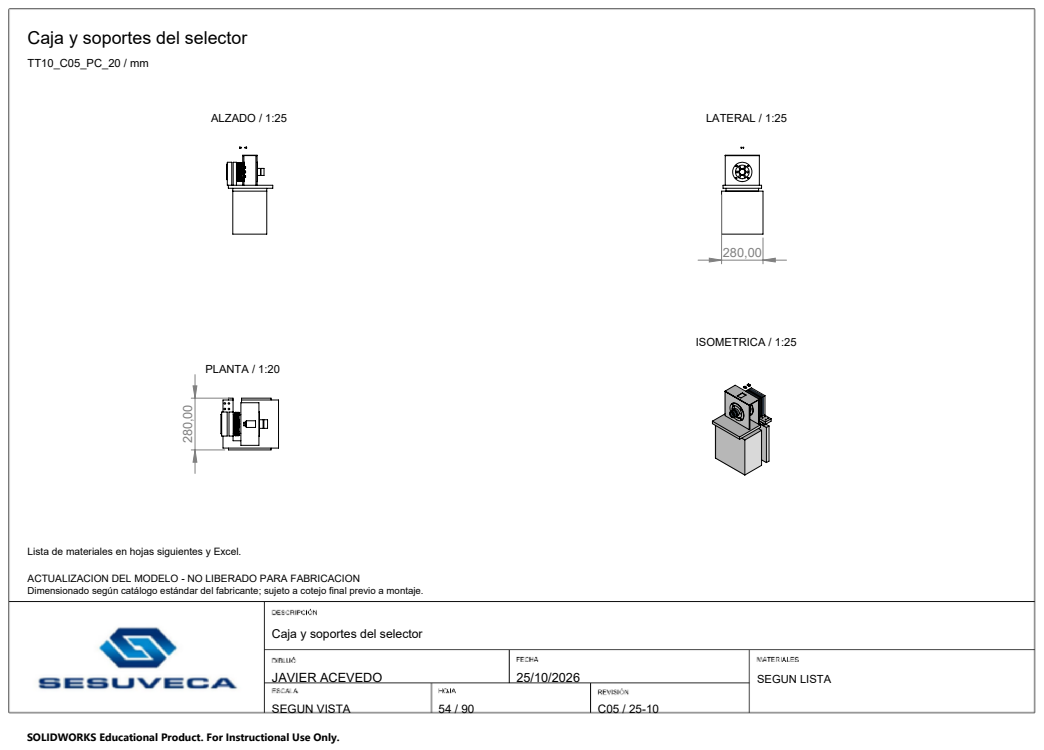
[picture p25: page 54]
JAVIER ACEVEDO; SEGUN VISTA; SEGUN LISTA; ALZADO / 1:25; LATERAL / 1:25; PLANTA / 1:20; ISOMETRICA / 1:25

Lista de materiales en hojas siguientes y Excel.

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

Caja y soportes del selector

# Caja y soportes del selector - Lista de materiales

TT10_C05_PC_20_L02 / mm

### Caja y soportes del selector - Lista de materiales

JAVIER ACEVEDO | 25/10/2026
S/E | 55 / 90 | C05 / 25-10

SEGUN LISTA

Cantidades de esta lista: instancias presentes en este conjunto.

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

POS | CANT | CODIGO | DESCRIPCION | MATERIAL
9 | 1 | TT10_C03_HK4020_E1 | SKF HK4020; 40x47x20; rodillos y jaula omitidos | Conjunto comprado; acero/ fundición según OEM
10 | 1 | TT10_C03_HK4020_E2 | SKF HK4020; 40x47x20; rodillos y jaula omitidos | Conjunto comprado; acero/ fundición según OEM
11 | 1 | TT10_C03_HK4020_M1 | SKF HK4020; 40x47x20; rodillos y jaula omitidos | Conjunto comprado; acero/ fundición según OEM
12 | 1 | TT10_C03_HK4020_M2 | SKF HK4020; 40x47x20; rodillos y jaula omitidos | Conjunto comprado; acero/ fundición según OEM
15 | 1 | TT10_C03_SELECTOR_6008_1 | SKF6008 40x68x15; contorno de interfaz | Conjunto comprado; acero/ fundición según OEM
16 | 1 | TT10_C03_SELECTOR_6008_2 | SKF6008 40x68x15; contorno de interfaz | Conjunto comprado; acero/ fundición según OEM
19 | 1 | TT10_C03_SELECTOR_CUBIERTA | Cubierta desmontable3; ranura50x36 para recorrido completo; cierreM6 por detallar | ASTM A36
23 | 1 | TT10_C03_SELECTOR_PARED_E | Pared mecanizada8; roscasM6; tapa de retencion y asiento axial por cadena de cotas | ASTM A36
24 | 1 | TT10_C03_SELECTOR_PARED_M | Pared mecanizada8; roscasM6; tapa de retencion y asiento axial por cadena de cotas | ASTM A36
26 | 1 | TT10_C03_TAPA_RETENCION_E | Tapa estacionaria: labio axial para cuboD100, pasoD92 libre al manguitoD90; junta axial0.2 por ajustar | ASTM A36
27 | 1 | TT10_C03_TAPA_RETENCION_M | Tapa estacionaria: labio axial para cuboD100, pasoD92 libre al manguitoD90; junta axial0.2 por ajustar | ASTM A36
35 | 2 | TT10_C04_B6008_M6_1_0 | M6x20 ISO7380-1,10.9; contorno nominal | Clase 10.9 / ISO 898-1
36 | 1 | TT10_C04_B6008_M6_1_2 | M6x20 ISO7380-1,10.9; contorno nominal | Clase 10.9 / ISO 898-1
37 | 1 | TT10_C04_B6008_M6_1_3 | M6x20 ISO7380-1,10.9; contorno nominal | Clase 10.9 / ISO 898-1
38 | 2 | TT10_C04_B6008_M6_2_0 | M6x20 ISO7380-1,10.9; contorno nominal | Clase 10.9 / ISO 898-1
39 | 2 | TT10_C04_B6008_M6_2_1 | M6x20 ISO7380-1,10.9; contorno nominal | Clase 10.9 / ISO 898-1
48 | 1 | TT10_C04_DIN471_40 | ComprarDIN471-40,1.75; contorno instalado simplificado, no fabricar | Acero resorte DIN471
52 | 1 | TT10_C04_ESPACIADOR6008 | Separador7 entre tapa izquierda y anillo exterior6008 | Conjunto comprado; acero/ fundición según OEM

# Caja y soportes del selector - Lista de materiales

TT10_C05_PC_20_L03 / mm

### Caja y soportes del selector - Lista de materiales

JAVIER ACEVEDO | 25/10/2026
S/E | 56 / 90 | C05 / 25-10

SEGUN LISTA

Cantidades de esta lista: instancias presentes en este conjunto.

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

POS | CANT | CODIGO | DESCRIPCION | MATERIAL
65 | 1 | TT10_C04_PEDESTAL_SELECTOR | Pedestal con ventana46 para paso real de cadena/resguardo; soporte local por verificar | ASTM A36
67 | 1 | TT10_C04_SELECTOR_APOYO_1 | Asiento6008 abierto; montaje axial y4M6PCD84; no cavidad inaccesible | Conjunto comprado; acero/ fundición según OEM
68 | 1 | TT10_C04_SELECTOR_APOYO_2 | Asiento6008 abierto; montaje axial y4M6PCD84; no cavidad inaccesible | Conjunto comprado; acero/ fundición según OEM
69 | 1 | TT10_C04_SELECTOR_BASE | Soporte con ventana46mm para cadena y guarda; caras restantes transmiten apoyo | ASTM A36
72 | 1 | TT10_C04_SELECTOR_ESPACIADOR | Soporte con ventana46mm para cadena y guarda; caras restantes transmiten apoyo | ASTM A36
77 | 1 | TT10_C04_TAPA6008_1 | Tapa104x4, cabezas en cajera; desmontaje exterior | ASTM A36
78 | 1 | TT10_C04_TAPA6008_2 | Tapa104x4, cabezas en cajera; desmontaje exterior | ASTM A36
88 | 1 | TT10_C05_B4_RETEN_0_0 | M4x9,8.8; tornillo del puente cautivo; fijador desmontable | Clase 10.9 / ISO 898-1
89 | 1 | TT10_C05_B4_RETEN_0_1 | M4x9,8.8; tornillo del puente cautivo; fijador desmontable | Clase 10.9 / ISO 898-1
90 | 1 | TT10_C05_B4_RETEN_1_0 | M4x9,8.8; tornillo del puente cautivo; fijador desmontable | Clase 10.9 / ISO 898-1
91 | 1 | TT10_C05_B4_RETEN_1_1 | M4x9,8.8; tornillo del puente cautivo; fijador desmontable | Clase 10.9 / ISO 898-1
106 | 1 | TT10_C05_BDNB_CUBO_SELECTOR | Cubo manual con corona integral z48,m2.5,20 grados; asiento47 y garras conservadas | AISI 4140 bonificado

# Selector E-N-M y enclavamiento cautivo

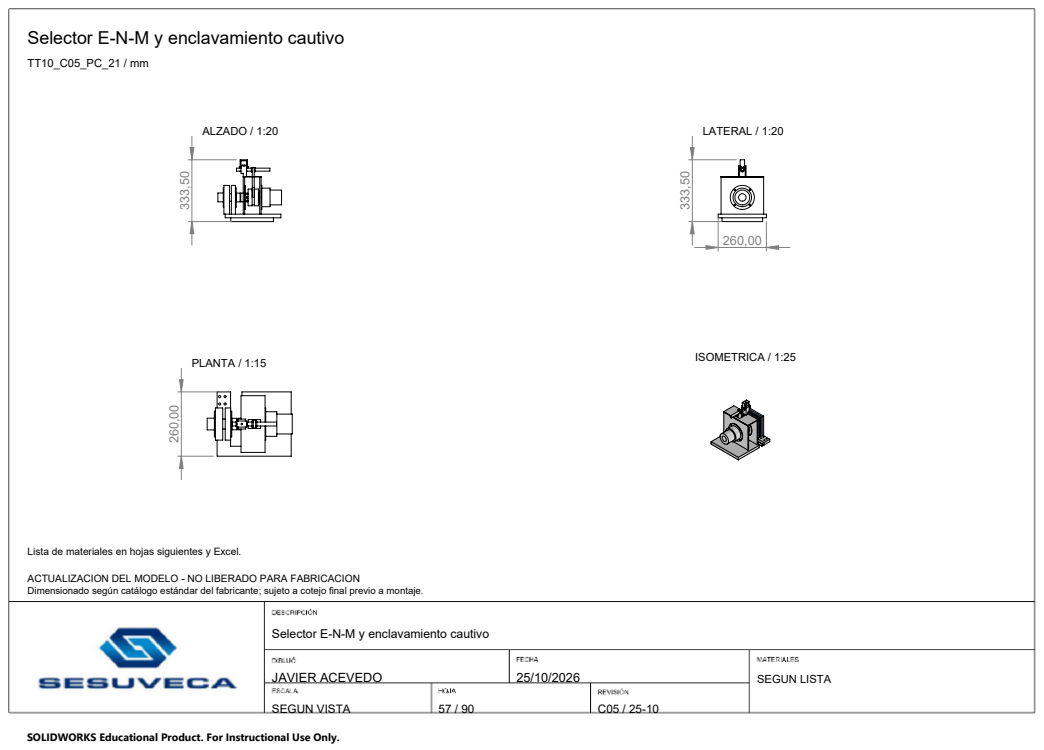
[picture p26: page 57]
JAVIER ACEVEDO; SEGUN VISTA; SEGUN LISTA; ALZADO / 1:20; LATERAL / 1:20; PLANTA / 1:15; ISOMETRICA / 1:25

Lista de materiales en hojas siguientes y Excel.

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

Selector E-N-M y enclavamiento cautivo

# Selector E-N-M y enclavamiento cautivo - Lista de materiales

TT10_C05_PC_21_L02 / mm

### Selector E-N-M y enclavamiento cautivo - Lista de materiales

JAVIER ACEVEDO | 25/10/2026
S/E | 58 / 90 | C05 / 25-10

SEGUN LISTA

Cantidades de esta lista: instancias presentes en este conjunto.

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

POS | CANT | CODIGO | DESCRIPCION | MATERIAL
9 | 1 | TT10_C03_HK4020_E1 | SKF HK4020; 40x47x20; rodillos y jaula omitidos | Conjunto comprado; acero/ fundición según OEM
10 | 1 | TT10_C03_HK4020_E2 | SKF HK4020; 40x47x20; rodillos y jaula omitidos | Conjunto comprado; acero/ fundición según OEM
11 | 1 | TT10_C03_HK4020_M1 | SKF HK4020; 40x47x20; rodillos y jaula omitidos | Conjunto comprado; acero/ fundición según OEM
12 | 1 | TT10_C03_HK4020_M2 | SKF HK4020; 40x47x20; rodillos y jaula omitidos | Conjunto comprado; acero/ fundición según OEM
15 | 1 | TT10_C03_SELECTOR_6008_1 | SKF6008 40x68x15; contorno de interfaz | Conjunto comprado; acero/ fundición según OEM
16 | 1 | TT10_C03_SELECTOR_6008_2 | SKF6008 40x68x15; contorno de interfaz | Conjunto comprado; acero/ fundición según OEM
17 | 1 | TT10_C03_SELECTOR_COLLAR_1 | Collar de varilla para sujetar horquilla; fijacion radial y retencion por completar | C45E / EN 10083-2
18 | 1 | TT10_C03_SELECTOR_COLLAR_2 | Collar de varilla para sujetar horquilla; fijacion radial y retencion por completar | C45E / EN 10083-2
19 | 1 | TT10_C03_SELECTOR_CUBIERTA | Cubierta desmontable3; ranura50x36 para recorrido completo; cierreM6 por detallar | ASTM A36
20 | 1 | TT10_C03_SELECTOR_ENCLAVAMIENTO | Pasador positivoD6; levantar16mm antes de seleccionar y reinsertar; retencion cautiva y mando remoto pendientes | C45E / EN 10083-2
21 | 1 | TT10_C03_SELECTOR_HORQUILLA | Horquilla10 en ranura12; 1 mm nominal por flanco; garras de seleccion con la maquina parada | ASTM A36
22 | 1 | TT10_C03_SELECTOR_MANGUITO | Manguito estriado: neutro X923..979; E+18/M-18; 6 alojamientos D12.2 PCD72 por cara | AISI 4140 bonificado
23 | 1 | TT10_C03_SELECTOR_PARED_E | Pared mecanizada8; roscasM6; tapa de retencion y asiento axial por cadena de cotas | ASTM A36
24 | 1 | TT10_C03_SELECTOR_PARED_M | Pared mecanizada8; roscasM6; tapa de retencion y asiento axial por cadena de cotas | ASTM A36
25 | 1 | TT10_C03_SELECTOR_VARILLA | Varilla selector D16; tres taladrosD6.5 con paso18; E-N-M por pasador positivo | C45E / EN 10083-2
26 | 1 | TT10_C03_TAPA_RETENCION_E | Tapa estacionaria: labio axial para cuboD100, pasoD92 libre al manguitoD90; junta axial0.2 por ajustar | ASTM A36
27 | 1 | TT10_C03_TAPA_RETENCION_M | Tapa estacionaria: labio axial para cuboD100, pasoD92 libre al manguitoD90; junta axial0.2 por ajustar | ASTM A36

# Selector E-N-M y enclavamiento cautivo - Lista de materiales

TT10_C05_PC_21_L03 / mm

### Selector E-N-M y enclavamiento cautivo - Lista de materiales

JAVIER ACEVEDO | 25/10/2026
S/E | 59 / 90 | C05 / 25-10

SEGUN LISTA

Cantidades de esta lista: instancias presentes en este conjunto.

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

POS | CANT | CODIGO | DESCRIPCION | MATERIAL
35 | 2 | TT10_C04_B6008_M6_1_0 | M6x20 ISO7380-1,10.9; contorno nominal | Clase 10.9 / ISO 898-1
36 | 1 | TT10_C04_B6008_M6_1_2 | M6x20 ISO7380-1,10.9; contorno nominal | Clase 10.9 / ISO 898-1
37 | 1 | TT10_C04_B6008_M6_1_3 | M6x20 ISO7380-1,10.9; contorno nominal | Clase 10.9 / ISO 898-1
38 | 2 | TT10_C04_B6008_M6_2_0 | M6x20 ISO7380-1,10.9; contorno nominal | Clase 10.9 / ISO 898-1
39 | 2 | TT10_C04_B6008_M6_2_1 | M6x20 ISO7380-1,10.9; contorno nominal | Clase 10.9 / ISO 898-1
48 | 1 | TT10_C04_DIN471_40 | ComprarDIN471-40,1.75; contorno instalado simplificado, no fabricar | Acero resorte DIN471
52 | 1 | TT10_C04_ESPACIADOR6008 | Separador7 entre tapa izquierda y anillo exterior6008 | Conjunto comprado; acero/ fundición según OEM
67 | 1 | TT10_C04_SELECTOR_APOYO_1 | Asiento6008 abierto; montaje axial y4M6PCD84; no cavidad inaccesible | Conjunto comprado; acero/ fundición según OEM
68 | 1 | TT10_C04_SELECTOR_APOYO_2 | Asiento6008 abierto; montaje axial y4M6PCD84; no cavidad inaccesible | Conjunto comprado; acero/ fundición según OEM
69 | 1 | TT10_C04_SELECTOR_BASE | Soporte con ventana46mm para cadena y guarda; caras restantes transmiten apoyo | ASTM A36
70 | 1 | TT10_C04_SELECTOR_CUBO_E | CuboE con extension; pasoD41 hastaX1062, socketD40H7 y chavetero12x35 | AISI 4140 bonificado
71 | 1 | TT10_C04_SELECTOR_EJE | Eje D40h6; extremoX1060; ranuraDIN471D37.5x1.85 enX855.1 | 42CrMo4+QT; pistas58-64HRC
72 | 1 | TT10_C04_SELECTOR_ESPACIADOR | Soporte con ventana46mm para cadena y guarda; caras restantes transmiten apoyo | ASTM A36
77 | 1 | TT10_C04_TAPA6008_1 | Tapa104x4, cabezas en cajera; desmontaje exterior | ASTM A36
78 | 1 | TT10_C04_TAPA6008_2 | Tapa104x4, cabezas en cajera; desmontaje exterior | ASTM A36
88 | 1 | TT10_C05_B4_RETEN_0_0 | M4x9,8.8; tornillo del puente cautivo; fijador desmontable | Clase 10.9 / ISO 898-1
89 | 1 | TT10_C05_B4_RETEN_0_1 | M4x9,8.8; tornillo del puente cautivo; fijador desmontable | Clase 10.9 / ISO 898-1
90 | 1 | TT10_C05_B4_RETEN_1_0 | M4x9,8.8; tornillo del puente cautivo; fijador desmontable | Clase 10.9 / ISO 898-1
91 | 1 | TT10_C05_B4_RETEN_1_1 | M4x9,8.8; tornillo del puente cautivo; fijador desmontable | Clase 10.9 / ISO 898-1

# Selector E-N-M y enclavamiento cautivo - Lista de materiales

TT10_C05_PC_21_L04 / mm

### Selector E-N-M y enclavamiento cautivo - Lista de materiales

JAVIER ACEVEDO | 25/10/2026
S/E | 60 / 90 | C05 / 25-10

SEGUN LISTA

Cantidades de esta lista: instancias presentes en este conjunto.

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

POS | CANT | CODIGO | DESCRIPCION | MATERIAL
126 | 1 | TT10_C05_BLOQUE_SELECTOR | BloqueC03 conservado con4M4laterales para retencion cautiva | ASTM A36
144 | 1 | TT10_C05_RETEN_CAUTIVO_SELECTOR | Puente cautivo para pasadorD6;23mm hasta cabeza, permite levantar16mm;4M4 laterales al bloque | ASTM A36

# Transmisión manual BDNB ensamblada

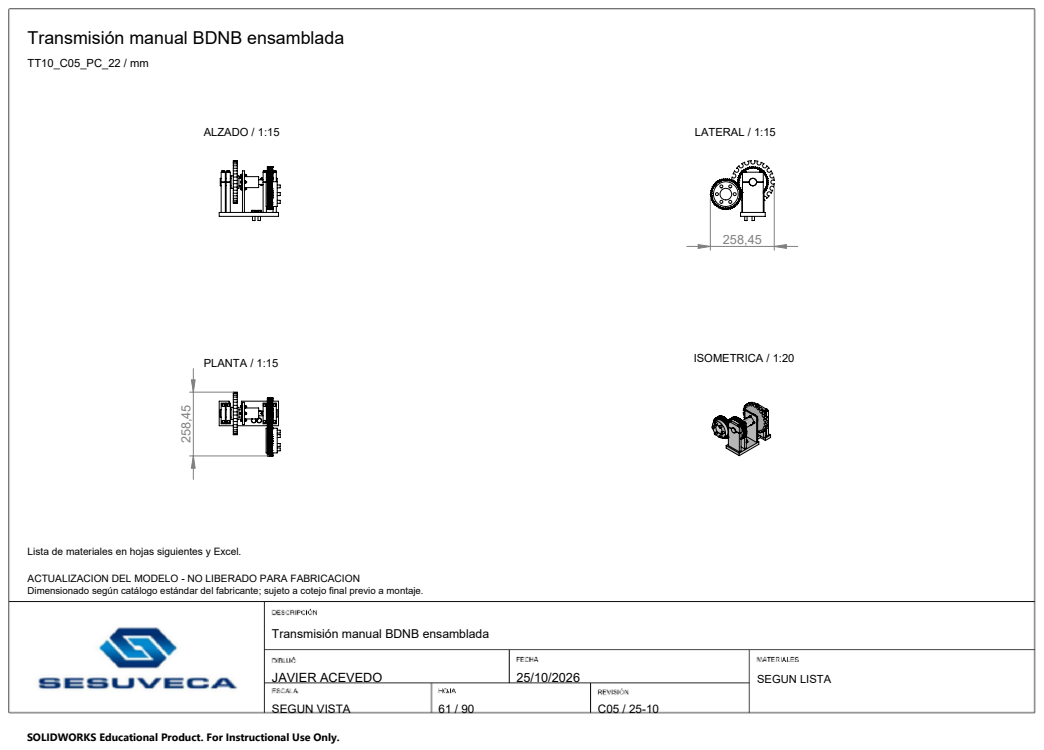
[picture p27: page 61]
JAVIER ACEVEDO; SEGUN VISTA; SEGUN LISTA; ALZADO / 1:15; LATERAL / 1:15; PLANTA / 1:15; ISOMETRICA / 1:20

Lista de materiales en hojas siguientes y Excel.

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

Transmisión manual BDNB ensamblada

# Transmisión manual BDNB ensamblada - Lista de materiales

TT10_C05_PC_22_L02 / mm

### Transmisión manual BDNB ensamblada - Lista de materiales

JAVIER ACEVEDO | 25/10/2026
S/E | 62 / 90 | C05 / 25-10

SEGUN LISTA

Cantidades de esta lista: instancias presentes en este conjunto.

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

POS | CANT | CODIGO | DESCRIPCION | MATERIAL
93 | 1 | TT10_C05_BDNB_28_23 | Warner BDNB 28.23Nm, brida lado entrada, exterior reconstruido según MCC-P-1310 03/25 p69; cotas nominales medias | Equipo comprado
94 | 1 | TT10_C05_BDNB_APOYO_0_INFERIOR | Apoyo partido6006, asientoH7, tapa2M6x60, roscasM6 cuerpo; soldaduraa4 base | ASTM A36
95 | 1 | TT10_C05_BDNB_APOYO_0_TAPA | Apoyo partido6006, asientoH7, tapa2M6x60, roscasM6 cuerpo; soldaduraa4 base | ASTM A36
96 | 1 | TT10_C05_BDNB_APOYO_1_INFERIOR | Apoyo partido6006, asientoH7, tapa2M6x60, roscasM6 cuerpo; soldaduraa4 base | ASTM A36
97 | 1 | TT10_C05_BDNB_APOYO_1_TAPA | Apoyo partido6006, asientoH7, tapa2M6x60, roscasM6 cuerpo; soldaduraa4 base | ASTM A36
98 | 1 | TT10_C05_BDNB_APOYO_2_INFERIOR | Apoyo partido6906, asientoH7, tapa2M6x60, roscasM6 cuerpo; soldaduraa4 base | ASTM A36
99 | 1 | TT10_C05_BDNB_APOYO_2_TAPA | Apoyo partido6906, asientoH7, tapa2M6x60, roscasM6 cuerpo; soldaduraa4 base | ASTM A36
100 | 1 | TT10_C05_BDNB_APOYO_3_INFERIOR | Apoyo partido6906, asientoH7, tapa2M6x60, roscasM6 cuerpo; soldaduraa4 base | ASTM A36
101 | 1 | TT10_C05_BDNB_APOYO_3_TAPA | Apoyo partido6906, asientoH7, tapa2M6x60, roscasM6 cuerpo; soldaduraa4 base | ASTM A36
102 | 1 | TT10_C05_BDNB_BASE | Base16 con ventana cadena,4pasos11;4M10x35 en placa existente roscadaM10 | ASTM A36
103 | 1 | TT10_C05_BDNB_CHAVETA_ENTRADA | ChavetaDIN6885A8x7, longitud según código | C45E
104 | 1 | TT10_C05_BDNB_CHAVETA_SALIDA | ChavetaDIN6885A8x7, longitud según código | C45E
105 | 1 | TT10_C05_BDNB_CORONA_20D | Mädler10888120: interfaz modificada30H7/8JS9; dentado visual simplificado | Equipo comprado
106 | 1 | TT10_C05_BDNB_CUBO_SELECTOR | Cubo manual con corona integral z48,m2.5,20 grados; asiento47 y garras conservadas | AISI 4140 bonificado
107 | 1 | TT10_C05_BDNB_EJE_ENTRADA | Eje30h6; socket12.73; chaveta8x7; taladro transversal4.825 | AISI 4140 bonificado
108 | 1 | TT10_C05_BDNB_EJE_SALIDA | Eje30h6, espiga12.70; dos6906; chaveta8x7; unión positiva3/16 | AISI 4140 bonificado
109 | 1 | TT10_C05_BDNB_ENGRANAJE | Engranaje48d,m2.5,20grados,b20;30H7,8JS9 | AISI 4140 bonificado
110 | 4 | TT10_C05_BDNB_M10 | TornilloISO4017 M10x35-8.8; rosca nominal | Clase 8.8 / ISO 898-1
111 | 4 | TT10_C05_BDNB_M5 | ISO4017 M5x20-8.8, rosca nominal | Clase 8.8 / ISO 898-1

# Transmisión manual BDNB ensamblada - Lista de materiales

TT10_C05_PC_22_L03 / mm

### Transmisión manual BDNB ensamblada - Lista de materiales

JAVIER ACEVEDO | 25/10/2026
S/E | 63 / 90 | C05 / 25-10

SEGUN LISTA

Cantidades de esta lista: instancias presentes en este conjunto.

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

POS | CANT | CODIGO | DESCRIPCION | MATERIAL
112 | 8 | TT10_C05_BDNB_M6 | TornilloISO4017 M6x60-8.8; rosca nominal | Clase 8.8 / ISO 898-1
113 | 1 | TT10_C05_BDNB_N3_ENTRADA | TuercaISO7042 M3 autoblocante metálica, rosca nominal | Tuerca clase 8 / ISO 898-2
114 | 1 | TT10_C05_BDNB_N3_SALIDA | TuercaISO7042 M3 autoblocante metálica, rosca nominal | Tuerca clase 8 / ISO 898-2
115 | 4 | TT10_C05_BDNB_N5 | TuercaISO4032 M5-8; rosca nominal | Tuerca clase 8 / ISO 898-2
116 | 1 | TT10_C05_BDNB_PASADOR_ENTRADA | Pasador transversal3/16, cabeza7, puntaM3x5; C45E bonificado, Rp0.2 minimo650MPa | C45E / EN 10083-2
117 | 1 | TT10_C05_BDNB_PASADOR_SALIDA | Pasador transversal3/16, cabeza7, puntaM3x5; C45E bonificado, Rp0.2 minimo650MPa | C45E / EN 10083-2
118 | 1 | TT10_C05_BDNB_PLACA_REACCION | Reacción BDNB8mm,4Ø5.5PCD53.85; soldaduraa4 ambos lados a base | ASTM A36
119 | 1 | TT10_C05_BDNB_RODAMIENTO_0 | RodamientoSKF6006; envolvente de montaje; selección de vida separada | Equipo comprado
120 | 1 | TT10_C05_BDNB_RODAMIENTO_1 | RodamientoSKF6006; envolvente de montaje; selección de vida separada | Equipo comprado
121 | 1 | TT10_C05_BDNB_RODAMIENTO_2 | RodamientoSKF6906; envolvente de montaje; selección de vida separada | Equipo comprado
122 | 1 | TT10_C05_BDNB_RODAMIENTO_3 | RodamientoSKF6906; envolvente de montaje; selección de vida separada | Equipo comprado
123 | 4 | TT10_C05_BDNB_W10 | ArandelaISO7089 M10 | Arandela endurecida 300 HV / ISO 7089
124 | 4 | TT10_C05_BDNB_W5 | ArandelaDIN433 M5,9x5.3x1 | Arandela endurecida 300 HV / ISO 7089
125 | 8 | TT10_C05_BDNB_W6 | ArandelaISO7089 M6 | Arandela endurecida 300 HV / ISO 7089

# BDNB: engranajes y pasadores propios

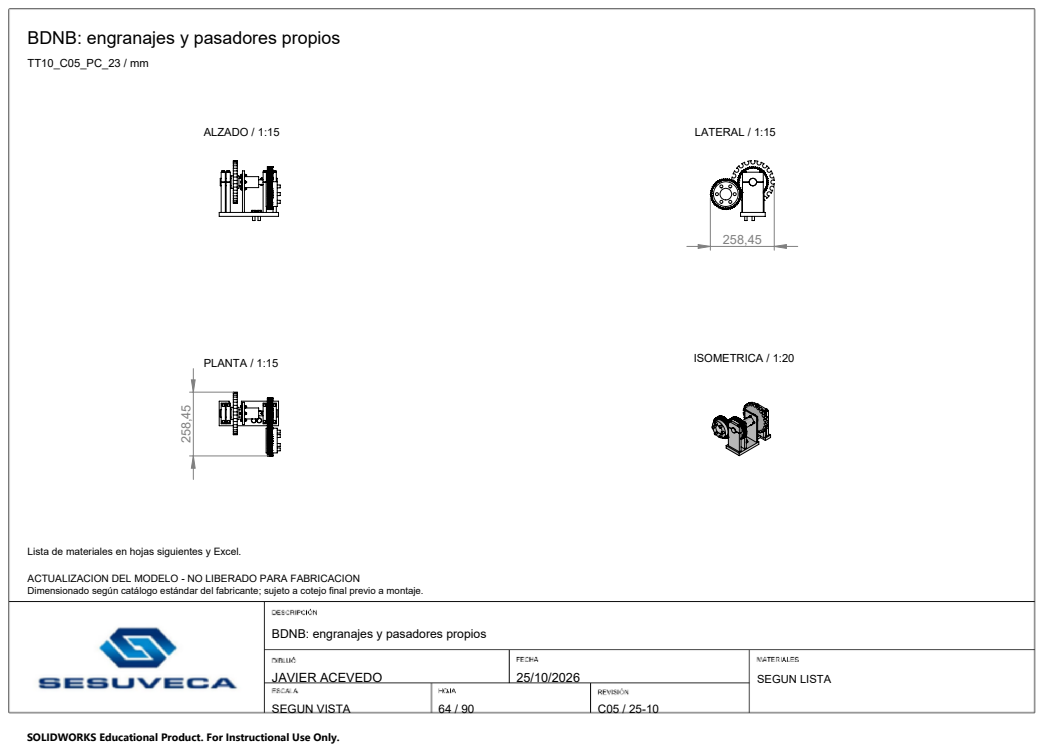
[picture p28: page 64]
JAVIER ACEVEDO; SEGUN VISTA; SEGUN LISTA; ALZADO / 1:15; LATERAL / 1:15; PLANTA / 1:15; ISOMETRICA / 1:20

Lista de materiales en hojas siguientes y Excel.

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

BDNB: engranajes y pasadores propios

# BDNB: engranajes y pasadores propios - Lista de materiales

TT10_C05_PC_23_L02 / mm

### BDNB: engranajes y pasadores propios - Lista de materiales

JAVIER ACEVEDO | 25/10/2026
S/E | 65 / 90 | C05 / 25-10

SEGUN LISTA

Cantidades de esta lista: instancias presentes en este conjunto.

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

POS | CANT | CODIGO | DESCRIPCION | MATERIAL
93 | 1 | TT10_C05_BDNB_28_23 | Warner BDNB 28.23Nm, brida lado entrada, exterior reconstruido según MCC-P-1310 03/25 p69; cotas nominales medias | Equipo comprado
94 | 1 | TT10_C05_BDNB_APOYO_0_INFERIOR | Apoyo partido6006, asientoH7, tapa2M6x60, roscasM6 cuerpo; soldaduraa4 base | ASTM A36
95 | 1 | TT10_C05_BDNB_APOYO_0_TAPA | Apoyo partido6006, asientoH7, tapa2M6x60, roscasM6 cuerpo; soldaduraa4 base | ASTM A36
96 | 1 | TT10_C05_BDNB_APOYO_1_INFERIOR | Apoyo partido6006, asientoH7, tapa2M6x60, roscasM6 cuerpo; soldaduraa4 base | ASTM A36
97 | 1 | TT10_C05_BDNB_APOYO_1_TAPA | Apoyo partido6006, asientoH7, tapa2M6x60, roscasM6 cuerpo; soldaduraa4 base | ASTM A36
98 | 1 | TT10_C05_BDNB_APOYO_2_INFERIOR | Apoyo partido6906, asientoH7, tapa2M6x60, roscasM6 cuerpo; soldaduraa4 base | ASTM A36
99 | 1 | TT10_C05_BDNB_APOYO_2_TAPA | Apoyo partido6906, asientoH7, tapa2M6x60, roscasM6 cuerpo; soldaduraa4 base | ASTM A36
100 | 1 | TT10_C05_BDNB_APOYO_3_INFERIOR | Apoyo partido6906, asientoH7, tapa2M6x60, roscasM6 cuerpo; soldaduraa4 base | ASTM A36
101 | 1 | TT10_C05_BDNB_APOYO_3_TAPA | Apoyo partido6906, asientoH7, tapa2M6x60, roscasM6 cuerpo; soldaduraa4 base | ASTM A36
102 | 1 | TT10_C05_BDNB_BASE | Base16 con ventana cadena,4pasos11;4M10x35 en placa existente roscadaM10 | ASTM A36
103 | 1 | TT10_C05_BDNB_CHAVETA_ENTRADA | ChavetaDIN6885A8x7, longitud según código | C45E
104 | 1 | TT10_C05_BDNB_CHAVETA_SALIDA | ChavetaDIN6885A8x7, longitud según código | C45E
105 | 1 | TT10_C05_BDNB_CORONA_20D | Mädler10888120: interfaz modificada30H7/8JS9; dentado visual simplificado | Equipo comprado
106 | 1 | TT10_C05_BDNB_CUBO_SELECTOR | Cubo manual con corona integral z48,m2.5,20 grados; asiento47 y garras conservadas | AISI 4140 bonificado
107 | 1 | TT10_C05_BDNB_EJE_ENTRADA | Eje30h6; socket12.73; chaveta8x7; taladro transversal4.825 | AISI 4140 bonificado
108 | 1 | TT10_C05_BDNB_EJE_SALIDA | Eje30h6, espiga12.70; dos6906; chaveta8x7; unión positiva3/16 | AISI 4140 bonificado
109 | 1 | TT10_C05_BDNB_ENGRANAJE | Engranaje48d,m2.5,20grados,b20;30H7,8JS9 | AISI 4140 bonificado
110 | 4 | TT10_C05_BDNB_M10 | TornilloISO4017 M10x35-8.8; rosca nominal | Clase 8.8 / ISO 898-1
111 | 4 | TT10_C05_BDNB_M5 | ISO4017 M5x20-8.8, rosca nominal | Clase 8.8 / ISO 898-1

# BDNB: engranajes y pasadores propios - Lista de materiales

TT10_C05_PC_23_L03 / mm

### BDNB: engranajes y pasadores propios - Lista de materiales

JAVIER ACEVEDO | 25/10/2026
S/E | 66 / 90 | C05 / 25-10

SEGUN LISTA

Cantidades de esta lista: instancias presentes en este conjunto.

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

POS | CANT | CODIGO | DESCRIPCION | MATERIAL
112 | 8 | TT10_C05_BDNB_M6 | TornilloISO4017 M6x60-8.8; rosca nominal | Clase 8.8 / ISO 898-1
113 | 1 | TT10_C05_BDNB_N3_ENTRADA | TuercaISO7042 M3 autoblocante metálica, rosca nominal | Tuerca clase 8 / ISO 898-2
114 | 1 | TT10_C05_BDNB_N3_SALIDA | TuercaISO7042 M3 autoblocante metálica, rosca nominal | Tuerca clase 8 / ISO 898-2
115 | 4 | TT10_C05_BDNB_N5 | TuercaISO4032 M5-8; rosca nominal | Tuerca clase 8 / ISO 898-2
116 | 1 | TT10_C05_BDNB_PASADOR_ENTRADA | Pasador transversal3/16, cabeza7, puntaM3x5; C45E bonificado, Rp0.2 minimo650MPa | C45E / EN 10083-2
117 | 1 | TT10_C05_BDNB_PASADOR_SALIDA | Pasador transversal3/16, cabeza7, puntaM3x5; C45E bonificado, Rp0.2 minimo650MPa | C45E / EN 10083-2
118 | 1 | TT10_C05_BDNB_PLACA_REACCION | Reacción BDNB8mm,4Ø5.5PCD53.85; soldaduraa4 ambos lados a base | ASTM A36
119 | 1 | TT10_C05_BDNB_RODAMIENTO_0 | RodamientoSKF6006; envolvente de montaje; selección de vida separada | Equipo comprado
120 | 1 | TT10_C05_BDNB_RODAMIENTO_1 | RodamientoSKF6006; envolvente de montaje; selección de vida separada | Equipo comprado
121 | 1 | TT10_C05_BDNB_RODAMIENTO_2 | RodamientoSKF6906; envolvente de montaje; selección de vida separada | Equipo comprado
122 | 1 | TT10_C05_BDNB_RODAMIENTO_3 | RodamientoSKF6906; envolvente de montaje; selección de vida separada | Equipo comprado
123 | 4 | TT10_C05_BDNB_W10 | ArandelaISO7089 M10 | Arandela endurecida 300 HV / ISO 7089
124 | 4 | TT10_C05_BDNB_W5 | ArandelaDIN433 M5,9x5.3x1 | Arandela endurecida 300 HV / ISO 7089
125 | 8 | TT10_C05_BDNB_W6 | ArandelaISO7089 M6 | Arandela endurecida 300 HV / ISO 7089

# Puestos de recuperación de actuadores

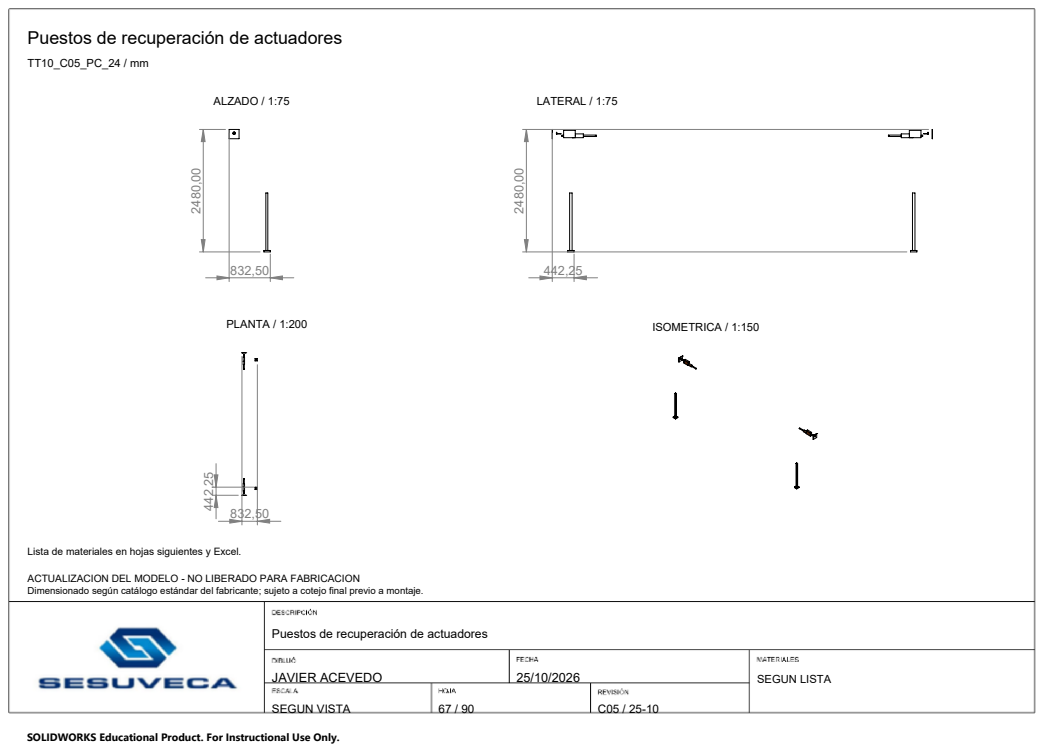
[picture p29: page 67]
JAVIER ACEVEDO; SEGUN VISTA; SEGUN LISTA; ALZADO / 1:75; LATERAL / 1:75; PLANTA / 1:200; ISOMETRICA / 1:150

Lista de materiales en hojas siguientes y Excel.

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

Puestos de recuperación de actuadores

# Puestos de recuperación de actuadores - Lista de materiales

TT10_C05_PC_24_L02 / mm

### Puestos de recuperación de actuadores - Lista de materiales

JAVIER ACEVEDO | 25/10/2026
S/E | 68 / 90 | C05 / 25-10

SEGUN LISTA

Cantidades de esta lista: instancias presentes en este conjunto.

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

POS | CANT | CODIGO | DESCRIPCION | MATERIAL
6 | 1 | TT10_C03_ACCESO_PUERTO_N | Guia de herramienta desde exterior N; puerto nominal rear+15.5/Z+53.7; NO conexion remota al actuador | ASTM A36
7 | 1 | TT10_C03_ACCESO_PUERTO_P | Guia de herramienta desde exterior P; puerto nominal rear+15.5/Z+53.7; NO conexion remota al actuador | ASTM A36
13 | 1 | TT10_C03_REGISTRO_PUERTO_N | Registro exterior desmontable3 con accesoD50; fijaciones/proteccion de puesto por completar | ASTM A36
14 | 1 | TT10_C03_REGISTRO_PUERTO_P | Registro exterior desmontable3 con accesoD50; fijaciones/proteccion de puesto por completar | ASTM A36
163 | 1 | TT10_D_BASE_RECUP_N | Base de mando de recuperación | ASTM A36
164 | 1 | TT10_D_BASE_RECUP_P | Base de mando de recuperación | ASTM A36
207 | 1 | TT10_D_POSTE_RECUP_N | Soporte de manivela y desbloqueo manual N | ASTM A36
208 | 1 | TT10_D_POSTE_RECUP_P | Soporte de manivela y desbloqueo manual P | ASTM A36
390 | 2 | TT10_PE_ACT_CUERPO | Thomson HD24B026-0250LPS2MMSD: interfaces nominales y envolvente conservadora, NO CAD oficial | Conjunto comercial; selección condicionada
391 | 2 | TT10_PE_ACT_VASTAGO | Extremo y vástago comercial nominal D30.2; taladro12.2; parte móvil de candidato Thomson | Subcomponente de actuador comercial

# Soportes de armario y mandos

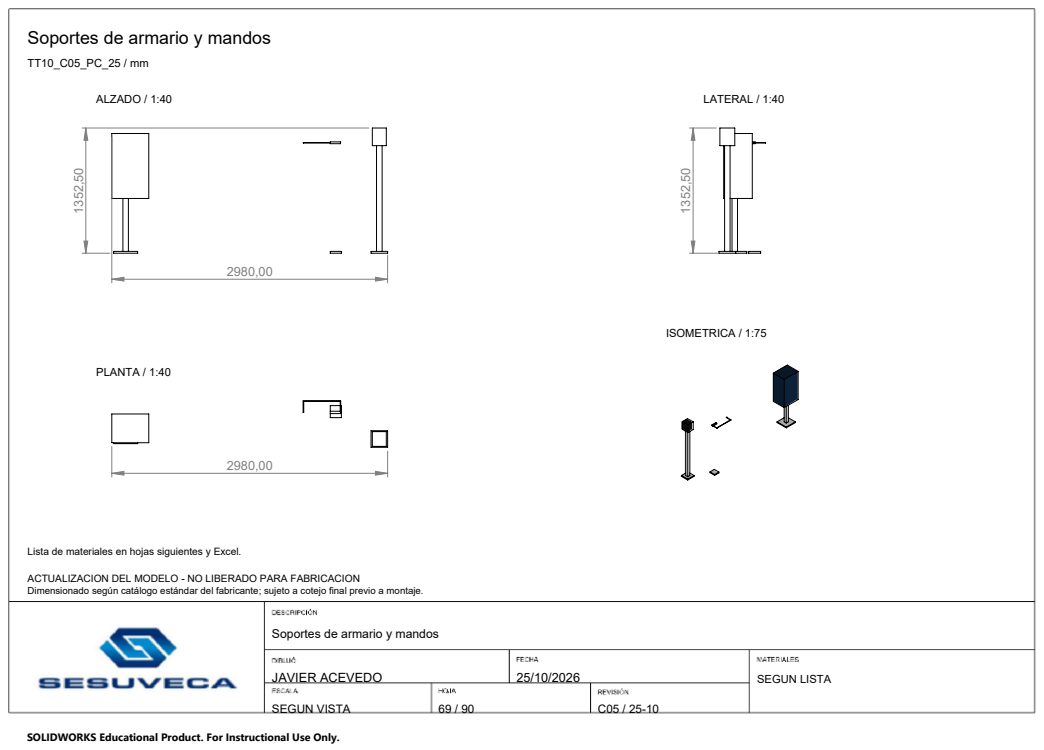
[picture p30: page 69]
JAVIER ACEVEDO; SEGUN VISTA; SEGUN LISTA; ALZADO / 1:40; LATERAL / 1:40; PLANTA / 1:40; ISOMETRICA / 1:75

Lista de materiales en hojas siguientes y Excel.

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

Soportes de armario y mandos

# Soportes de armario y mandos - Lista de materiales

TT10_C05_PC_25_L02 / mm

### Soportes de armario y mandos - Lista de materiales

JAVIER ACEVEDO | 25/10/2026
S/E | 70 / 90 | C05 / 25-10

SEGUN LISTA

Cantidades de esta lista: instancias presentes en este conjunto.

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

POS | CANT | CODIGO | DESCRIPCION | MATERIAL
152 | 1 | TT10_D_ARMARIO | Armario de variador y control; representación de presentación | Armario comercial; chapa y acabado según referencia de compra
157 | 1 | TT10_D_BASE_ARMARIO | Base del armario | ASTM A36
158 | 1 | TT10_D_BASE_BOTONERA | Base de botonera | ASTM A36
162 | 1 | TT10_D_BASE_PRESENTE | Base del mando de hombre presente | ASTM A36
166 | 1 | TT10_D_BOTONERA | Botonera: subir, bajar, retorno y paro de emergencia | Dispositivo de mando comercial; materiales según referencia OEM
176 | 1 | TT10_D_CABLE_PRESENTE | Eje de conexión geométrica CABLE_PRESENTE | Cable/conducción comercial; composición según ficha
188 | 1 | TT10_D_MANDO_PRESENTE | Palanca de hombre presente para liberación manual nominal | ASTM A36
202 | 1 | TT10_D_POSTE_ARMARIO | Soporte de armario | ASTM A36
203 | 1 | TT10_D_POSTE_BOTONERA | Poste de botonera fuera del plano de giro | ASTM A36

# Mando exterior y varilla del selector

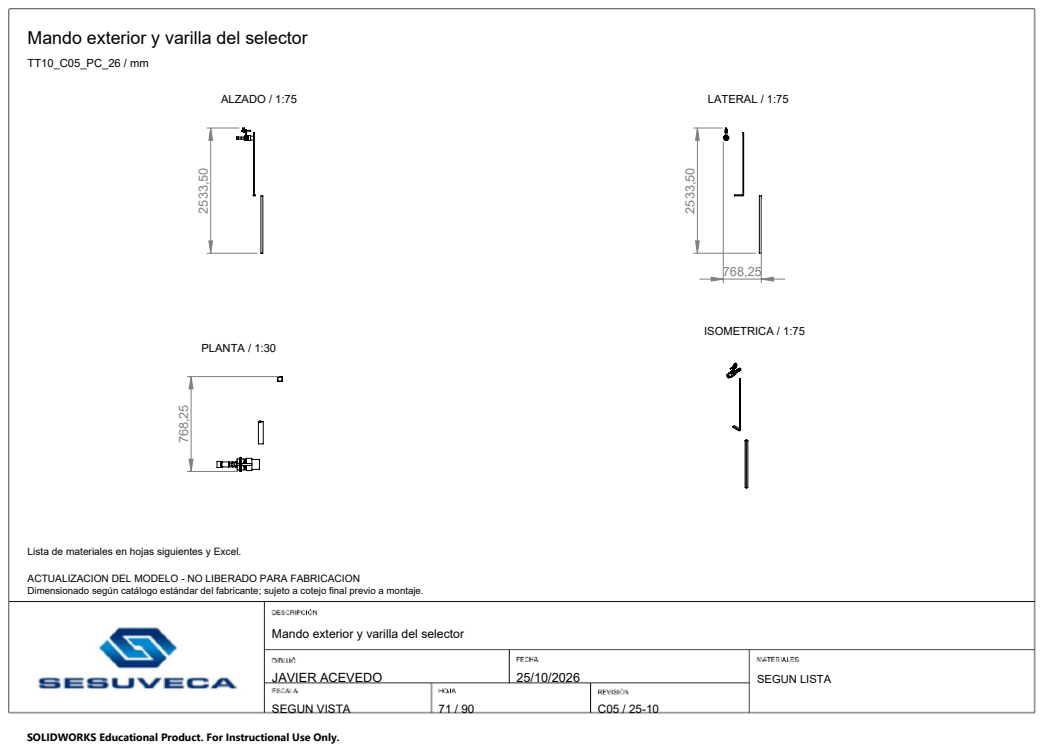
[picture p31: page 71]
JAVIER ACEVEDO; SEGUN VISTA; SEGUN LISTA; ALZADO / 1:75; LATERAL / 1:75; PLANTA / 1:30; ISOMETRICA / 1:75

Lista de materiales en hojas siguientes y Excel.

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

Mando exterior y varilla del selector

# Mando exterior y varilla del selector - Lista de materiales

TT10_C05_PC_26_L02 / mm

### Mando exterior y varilla del selector - Lista de materiales

JAVIER ACEVEDO | 25/10/2026
S/E | 72 / 90 | C05 / 25-10

SEGUN LISTA

Cantidades de esta lista: instancias presentes en este conjunto.

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

POS | CANT | CODIGO | DESCRIPCION | MATERIAL
17 | 1 | TT10_C03_SELECTOR_COLLAR_1 | Collar de varilla para sujetar horquilla; fijacion radial y retencion por completar | C45E / EN 10083-2
18 | 1 | TT10_C03_SELECTOR_COLLAR_2 | Collar de varilla para sujetar horquilla; fijacion radial y retencion por completar | C45E / EN 10083-2
20 | 1 | TT10_C03_SELECTOR_ENCLAVAMIENTO | Pasador positivoD6; levantar16mm antes de seleccionar y reinsertar; retencion cautiva y mando remoto pendientes | C45E / EN 10083-2
21 | 1 | TT10_C03_SELECTOR_HORQUILLA | Horquilla10 en ranura12; 1 mm nominal por flanco; garras de seleccion con la maquina parada | ASTM A36
22 | 1 | TT10_C03_SELECTOR_MANGUITO | Manguito estriado: neutro X923..979; E+18/M-18; 6 alojamientos D12.2 PCD72 por cara | AISI 4140 bonificado
25 | 1 | TT10_C03_SELECTOR_VARILLA | Varilla selector D16; tres taladrosD6.5 con paso18; E-N-M por pasador positivo | C45E / EN 10083-2
70 | 1 | TT10_C04_SELECTOR_CUBO_E | CuboE con extension; pasoD41 hastaX1062, socketD40H7 y chavetero12x35 | AISI 4140 bonificado
71 | 1 | TT10_C04_SELECTOR_EJE | Eje D40h6; extremoX1060; ranuraDIN471D37.5x1.85 enX855.1 | 42CrMo4+QT; pistas58-64HRC
126 | 1 | TT10_C05_BLOQUE_SELECTOR | BloqueC03 conservado con4M4laterales para retencion cautiva | ASTM A36
144 | 1 | TT10_C05_RETEN_CAUTIVO_SELECTOR | Puente cautivo para pasadorD6;23mm hasta cabeza, permite levantar16mm;4M4 laterales al bloque | ASTM A36
192 | 1 | TT10_D_PALANCA_SELECTOR | Selector E-0-M a altura accesible; transmisión por varilla | ASTM A36
206 | 1 | TT10_D_POSTE_MANDO | Soporte del mando manual fuera del plano del volante | ASTM A36
212 | 1 | TT10_D_ROD_SELECTOR | Eje de conexión geométrica ROD_SELECTOR | ASTM A36

800,00

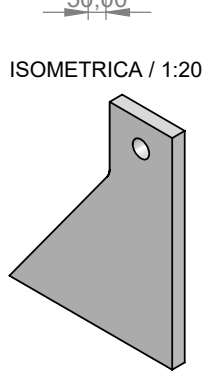
[picture p32: figure]
ISOMETRICA / 1:20

650,00

800,00

50,00

250,00

50,00

# TT10_M276 - Detalle

TT10_C05_DET_TT10_M276 / mm

### TT10_M276 - Detalle

JAVIER ACEVEDO | 25/10/2026
SEGUN VISTA | 73 / 90 | C05 / 25-10

Strenx700E t50; Rp0.2min700MPa

ALZADO / 1:20 | LATERAL / 1:20

PLANTA / 1:8

Brazo monolítico Strenx 700E t50; perfil 800 x 650; R50; agujero Ø65,5 | Raíz al yugo: CJP, garganta efectiva20mm en perímetro50x650. Metal de aporte Fu mínimo760MPa. Perfil de corte en DXF;
no sustituir por perfil comercial.
ACTUALIZACION DEL MODELO - NO LIBERADO PARA FABRICACION
Dimensionado según catálogo estándar del fabricante; sujeto a cotejo final previo a montaje.

800,00

650,00

800,00

50,00

250,00

50,00

# TT10_M351 - Detalle

TT10_C05_DET_TT10_M351 / mm

### TT10_M351 - Detalle

JAVIER ACEVEDO | 25/10/2026
SEGUN VISTA | 74 / 90 | C05 / 25-10

Strenx700E t50; Rp0.2min700MPa

ALZADO / 1:20 | LATERAL / 1:20

PLANTA / 1:8

Brazo monolítico Strenx 700E t50; perfil 800 x 650; R50; agujero Ø65,5 | Raíz al yugo: CJP, garganta efectiva20mm en perímetro50x650. Metal de aporte Fu mínimo760MPa. Perfil de corte en DXF;
no sustituir por perfil comercial.
ACTUALIZACION DEL MODELO - NO LIBERADO PARA FABRICACION
Dimensionado según catálogo estándar del fabricante; sujeto a cotejo final previo a montaje.

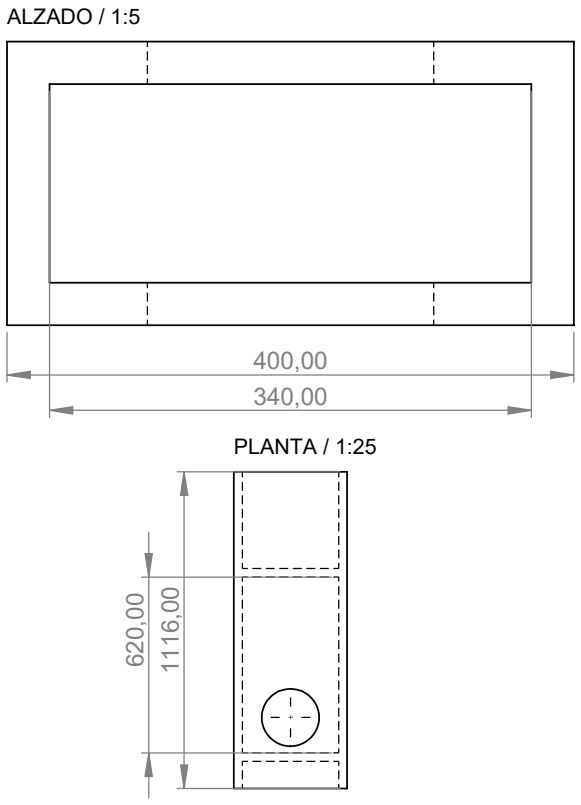
[picture p33: figure]
ALZADO / 1:5; PLANTA / 1:25

1116,00
620,00

# TT10_M161 - Detalle

TT10_C05_DET_TT10_M161 / mm

### TT10_M161 - Detalle

JAVIER ACEVEDO | 25/10/2026

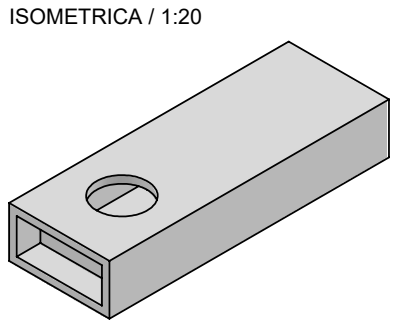
[picture p34: figure]
ISOMETRICA / 1:20

SEGUN VISTA | 75 / 90 | C05 / 25-10

Strenx700E t30; Rp0.2min700MPa

LATERAL / 1:10

Yugo cajón 400 x 200 x 1116, t30; 2 diafragmas 340 x 140 x 30; agujero Ø202 | Cajón soldado t30, extremos abiertos. Dos diafragmas340x140x30 aZlocal341y991mm. Unión al cabezal CJP,
garganta30. Despiece CH01..03 en DXF y Excel.
ACTUALIZACION DEL MODELO - NO LIBERADO PARA FABRICACION
Dimensionado según catálogo estándar del fabricante; sujeto a cotejo final previo a montaje.

1116,00
620,00

# TT10_M311 - Detalle

TT10_C05_DET_TT10_M311 / mm

### TT10_M311 - Detalle

JAVIER ACEVEDO | 25/10/2026
SEGUN VISTA | 76 / 90 | C05 / 25-10

Strenx700E t30; Rp0.2min700MPa

LATERAL / 1:10

Yugo cajón 400 x 200 x 1116, t30; 2 diafragmas 340 x 140 x 30; agujero Ø202 | Cajón soldado t30, extremos abiertos. Dos diafragmas340x140x30 aZlocal341y991mm. Unión al cabezal CJP,
garganta30. Despiece CH01..03 en DXF y Excel.
ACTUALIZACION DEL MODELO - NO LIBERADO PARA FABRICACION
Dimensionado según catálogo estándar del fabricante; sujeto a cotejo final previo a montaje.

120,00

200,00

1200,00
400,00

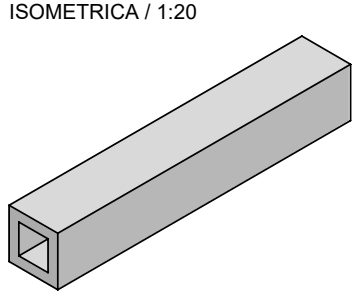
[picture p35: figure]

1200,00
400,00

# TT10_M201 - Detalle

TT10_C05_DET_TT10_M201 / mm

### TT10_M201 - Detalle

JAVIER ACEVEDO | 25/10/2026
SEGUN VISTA | 77 / 90 | C05 / 25-10

Strenx700E t40; Rp0.2min700MPa

ALZADO / 1:5

LATERAL / 1:10

PLANTA / 1:30 | ISOMETRICA / 1:20
Cabezal cajón 200 x 200 x 1200, t40; 2 diafragmas 120 x 120 x 40 | Cajón soldado200x200x1200,t40, extremos abiertos. Dos diafragmas120x120x40 enXlocal400y760mm. Despiece CH01..03 en DXF y
Excel.
ACTUALIZACION DEL MODELO - NO LIBERADO PARA FABRICACION
Dimensionado según catálogo estándar del fabricante; sujeto a cotejo final previo a montaje.

120,00

200,00

1200,00
400,00

1200,00
400,00

# TT10_M131 - Detalle

TT10_C05_DET_TT10_M131 / mm

### TT10_M131 - Detalle

JAVIER ACEVEDO | 25/10/2026
SEGUN VISTA | 78 / 90 | C05 / 25-10

Strenx700E t40; Rp0.2min700MPa

ALZADO / 1:5

LATERAL / 1:10

PLANTA / 1:30 | ISOMETRICA / 1:20
Cabezal cajón 200 x 200 x 1200, t40; 2 diafragmas 120 x 120 x 40 | Cajón soldado200x200x1200,t40, extremos abiertos. Dos diafragmas120x120x40 enXlocal400y760mm. Despiece CH01..03 en DXF y
Excel.
ACTUALIZACION DEL MODELO - NO LIBERADO PARA FABRICACION
Dimensionado según catálogo estándar del fabricante; sujeto a cotejo final previo a montaje.

300,00
260,00

2395,00
1825,00

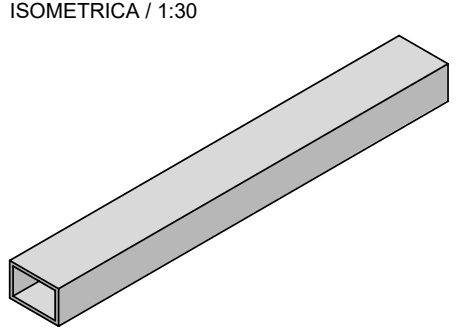
[picture p36: figure]

1825,00

2395,00

# TT10_F506 - Detalle

TT10_C05_DET_TT10_F506 / mm

### TT10_F506 - Detalle

JAVIER ACEVEDO | 25/10/2026
SEGUN VISTA | 79 / 90 | C05 / 25-10

Strenx700E t20; Rp0.2min700MPa

ALZADO / 1:5

LATERAL / 1:20

PLANTA / 1:60 | ISOMETRICA / 1:30
Poste independiente cajón 300 x 200 x 2395, t20; 2 diafragmas 260 x 160 x 20 | Poste300x200x2395,t20, extremos abiertos. Dos diafragmas260x160x20 enZlocal300y2145mm. Unión base CJP
garganta20. Despiece CH01..03 en DXF y Excel.
ACTUALIZACION DEL MODELO - NO LIBERADO PARA FABRICACION
Dimensionado según catálogo estándar del fabricante; sujeto a cotejo final previo a montaje.

300,00
260,00

2395,00
1825,00

1825,00

2395,00

# TT10_F611 - Detalle

TT10_C05_DET_TT10_F611 / mm

### TT10_F611 - Detalle

JAVIER ACEVEDO | 25/10/2026
SEGUN VISTA | 80 / 90 | C05 / 25-10

Strenx700E t20; Rp0.2min700MPa

ALZADO / 1:5

LATERAL / 1:20

PLANTA / 1:60 | ISOMETRICA / 1:30
Poste independiente cajón 300 x 200 x 2395, t20; 2 diafragmas 260 x 160 x 20 | Poste300x200x2395,t20, extremos abiertos. Dos diafragmas260x160x20 enZlocal300y2145mm. Unión base CJP
garganta20. Despiece CH01..03 en DXF y Excel.
ACTUALIZACION DEL MODELO - NO LIBERADO PARA FABRICACION
Dimensionado según catálogo estándar del fabricante; sujeto a cotejo final previo a montaje.

# TT10_F416 - Detalle

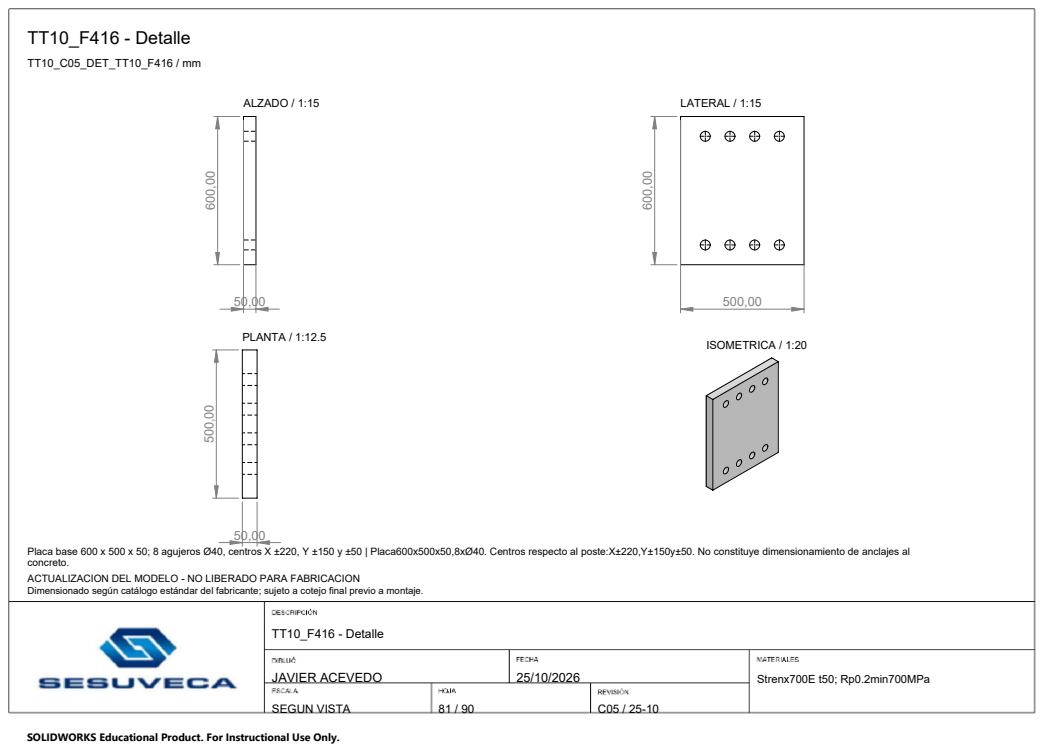
[picture p37: page 81]
TT10_C05_DET_TT10_F416 / mm; TT10_F416 - Detalle; JAVIER ACEVEDO; SEGUN VISTA; Strenx700E t50; Rp0.2min700MPa; ALZADO / 1:15; LATERAL / 1:15; PLANTA / 1:12.5; ISOMETRICA / 1:20

Placa base 600 x 500 x 50; 8 agujeros Ø40, centros X ±220, Y ±150 y ±50 | Placa600x500x50,8xØ40. Centros respecto al poste:X±220,Y±150y±50. No constituye dimensionamiento de anclajes al
concreto.
ACTUALIZACION DEL MODELO - NO LIBERADO PARA FABRICACION
Dimensionado según catálogo estándar del fabricante; sujeto a cotejo final previo a montaje.

# TT10_F591 - Detalle

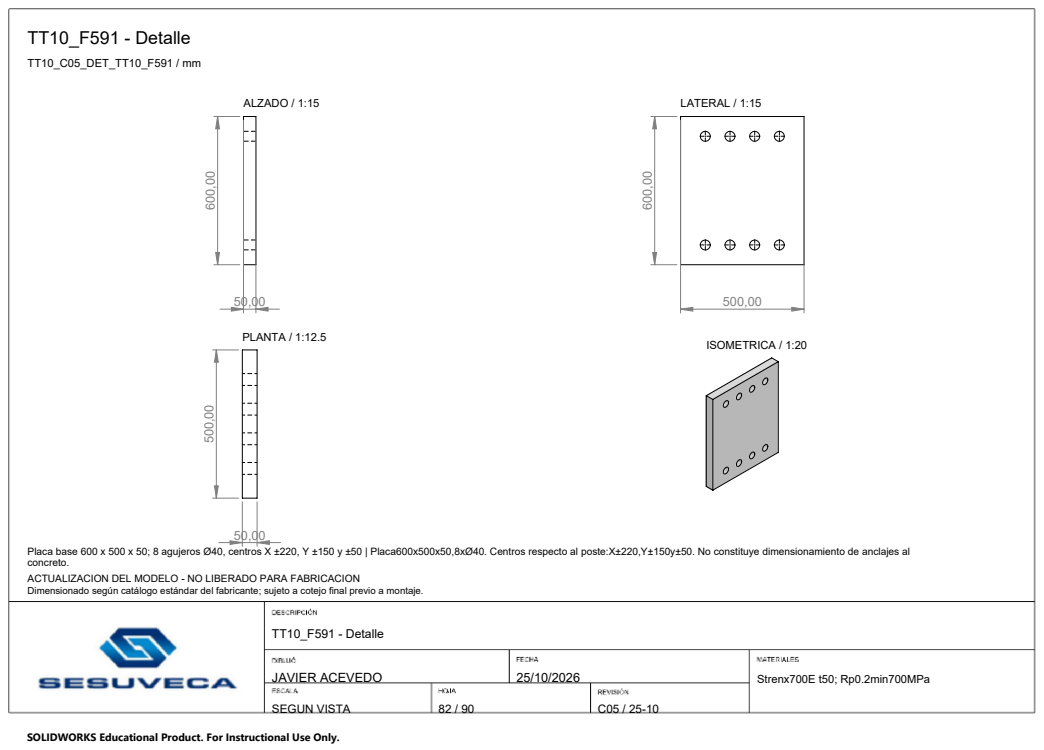
[picture p38: page 82]
TT10_C05_DET_TT10_F591 / mm; TT10_F591 - Detalle; JAVIER ACEVEDO; SEGUN VISTA; Strenx700E t50; Rp0.2min700MPa; ALZADO / 1:15; LATERAL / 1:15; PLANTA / 1:12.5; ISOMETRICA / 1:20

Placa base 600 x 500 x 50; 8 agujeros Ø40, centros X ±220, Y ±150 y ±50 | Placa600x500x50,8xØ40. Centros respecto al poste:X±220,Y±150y±50. No constituye dimensionamiento de anclajes al
concreto.
ACTUALIZACION DEL MODELO - NO LIBERADO PARA FABRICACION
Dimensionado según catálogo estándar del fabricante; sujeto a cotejo final previo a montaje.

400,00

250,00

400,00

40,00

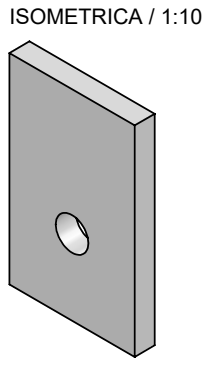
[picture p39: figure]
ISOMETRICA / 1:10

250,00

40,00

# TT10_F576 - Detalle

TT10_C05_DET_TT10_F576 / mm

### TT10_F576 - Detalle

JAVIER ACEVEDO | 25/10/2026
SEGUN VISTA | 83 / 90 | C05 / 25-10

Strenx700E t40; Rp0.2min700MPa

ALZADO / 1:10 | LATERAL / 1:10

PLANTA / 1:2.5

Oreja fija 400 x 250 x 40; agujero Ø65 H8; Strenx 700E | Placa400x250x40;Ø65H8 con posiciÃ³n de taladro segÃºn perfil DXF1:1. Mandrinar coaxial después de soldar. Fuente: geometría nativa C06.

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

400,00

250,00

400,00

40,00

250,00

40,00

# TT10_F586 - Detalle

TT10_C05_DET_TT10_F586 / mm

### TT10_F586 - Detalle

JAVIER ACEVEDO | 25/10/2026
SEGUN VISTA | 84 / 90 | C05 / 25-10

Strenx700E t40; Rp0.2min700MPa

ALZADO / 1:10 | LATERAL / 1:10

PLANTA / 1:2.5

Oreja fija 400 x 250 x 40; agujero Ø65 H8; Strenx 700E | Placa400x250x40;Ø65H8 con posiciÃ³n de taladro segÃºn perfil DXF1:1. Mandrinar coaxial después de soldar. Fuente: geometría nativa C06.

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

400,00

250,00

400,00

40,00

250,00

40,00

# TT10_F486 - Detalle

TT10_C05_DET_TT10_F486 / mm

### TT10_F486 - Detalle

JAVIER ACEVEDO | 25/10/2026
SEGUN VISTA | 85 / 90 | C05 / 25-10

Strenx700E t40; Rp0.2min700MPa

ALZADO / 1:10 | LATERAL / 1:10

PLANTA / 1:2.5

Oreja fija 400 x 250 x 40; agujero Ø65 H8; Strenx 700E | Placa400x250x40;Ø65H8 con posiciÃ³n de taladro segÃºn perfil DXF1:1. Mandrinar coaxial después de soldar. Fuente: geometría nativa C06.

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

400,00

250,00

400,00

40,00

250,00

40,00

# TT10_F501 - Detalle

TT10_C05_DET_TT10_F501 / mm

### TT10_F501 - Detalle

JAVIER ACEVEDO | 25/10/2026
SEGUN VISTA | 86 / 90 | C05 / 25-10

Strenx700E t40; Rp0.2min700MPa

ALZADO / 1:10 | LATERAL / 1:10

PLANTA / 1:2.5

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

525,00
300,00

115,00

25,00

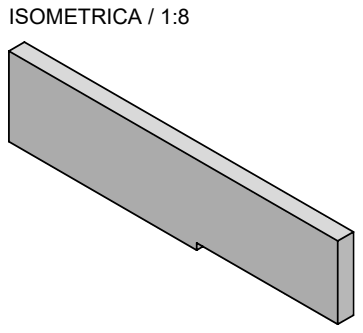
[picture p40: figure]
ISOMETRICA / 1:8

525,00

25,00

# TT10_PUENTE_P - Detalle

TT10_C05_DET_TT10_PUENTE_P / mm

### TT10_PUENTE_P - Detalle

JAVIER ACEVEDO | 25/10/2026
SEGUN VISTA | 87 / 90 | C05 / 25-10

ASTM A36 t25

ALZADO / 1:5

LATERAL / 1:4

PLANTA / 1:5

Puente guía A36 525 x 125 x 25; recorte 225 x 10 junto al poste | Material: ASTM A36 t25

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

525,00
300,00

115,00

25,00

525,00

25,00

# TT10_PUENTE_N - Detalle

TT10_C05_DET_TT10_PUENTE_N / mm

### TT10_PUENTE_N - Detalle

JAVIER ACEVEDO | 25/10/2026
SEGUN VISTA | 88 / 90 | C05 / 25-10

ASTM A36 t25

ALZADO / 1:5

LATERAL / 1:4

PLANTA / 1:5

Puente guía A36 525 x 125 x 25; recorte 225 x 10 junto al poste | Material: ASTM A36 t25

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

# TT10_PE_PIN - Detalle

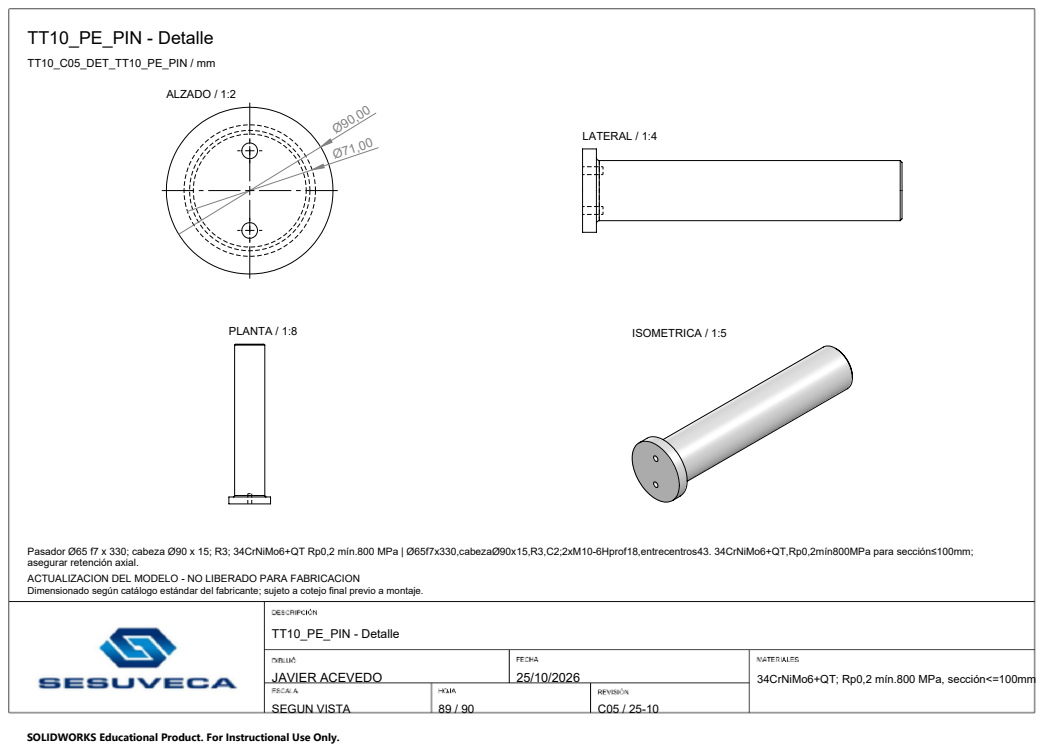
[picture p41: page 89]
TT10_C05_DET_TT10_PE_PIN / mm; TT10_PE_PIN - Detalle; JAVIER ACEVEDO; SEGUN VISTA; ALZADO / 1:2; LATERAL / 1:4; PLANTA / 1:8; ISOMETRICA / 1:5

Pasador Ø65 f7 x 330; cabeza Ø90 x 15; R3; 34CrNiMo6+QT Rp0,2 mín.800 MPa | Ø65f7x330,cabezaØ90x15,R3,C2;2xM10-6Hprof18,entrecentros43. 34CrNiMo6+QT,Rp0,2mín800MPa para sección≤100mm;
asegurar retención axial.
ACTUALIZACION DEL MODELO - NO LIBERADO PARA FABRICACION
Dimensionado según catálogo estándar del fabricante; sujeto a cotejo final previo a montaje.

34CrNiMo6+QT; Rp0,2 mín.800 MPa, sección<=100mm

# TT10_D_PLATAFORMA - Detalle

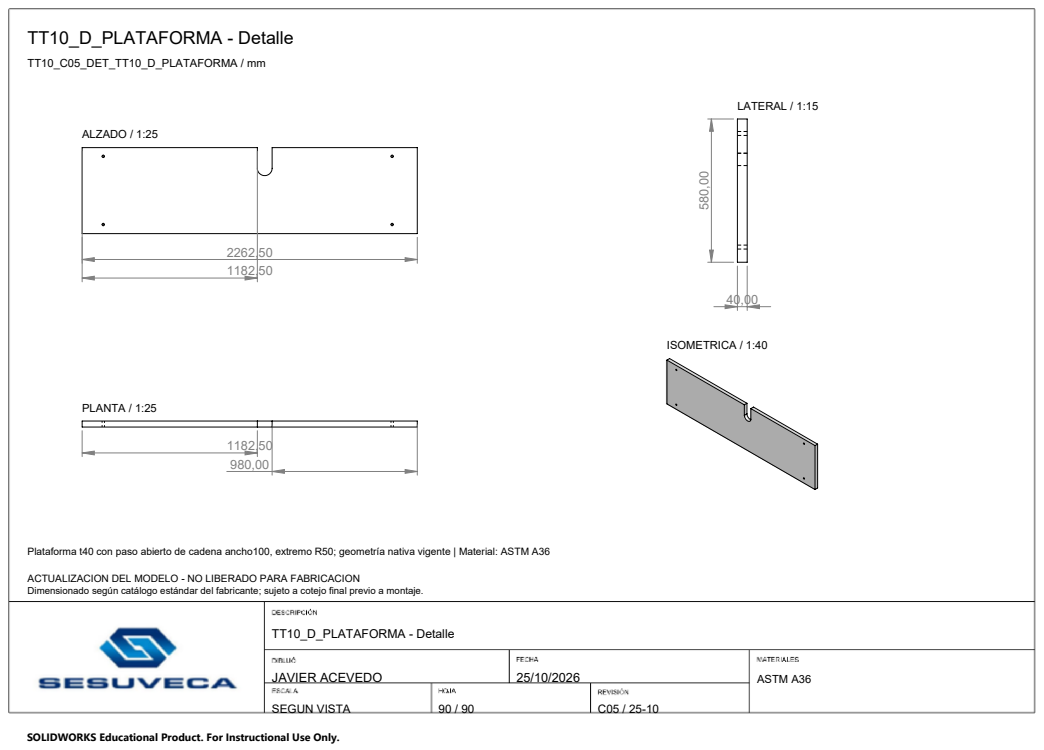
[picture p42: page 90]
TT10_C05_DET_TT10_D_PLATAFORMA / mm; TT10_D_PLATAFORMA - Detalle; JAVIER ACEVEDO; SEGUN VISTA; ASTM A36; ALZADO / 1:25; LATERAL / 1:15; PLANTA / 1:25; ISOMETRICA / 1:40

Plataforma t40 con paso abierto de cadena ancho100, extremo R50; geometría nativa vigente | Material: ASTM A36

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

# TT10_M076 - ANEXO DE MECANIZADOS - C05

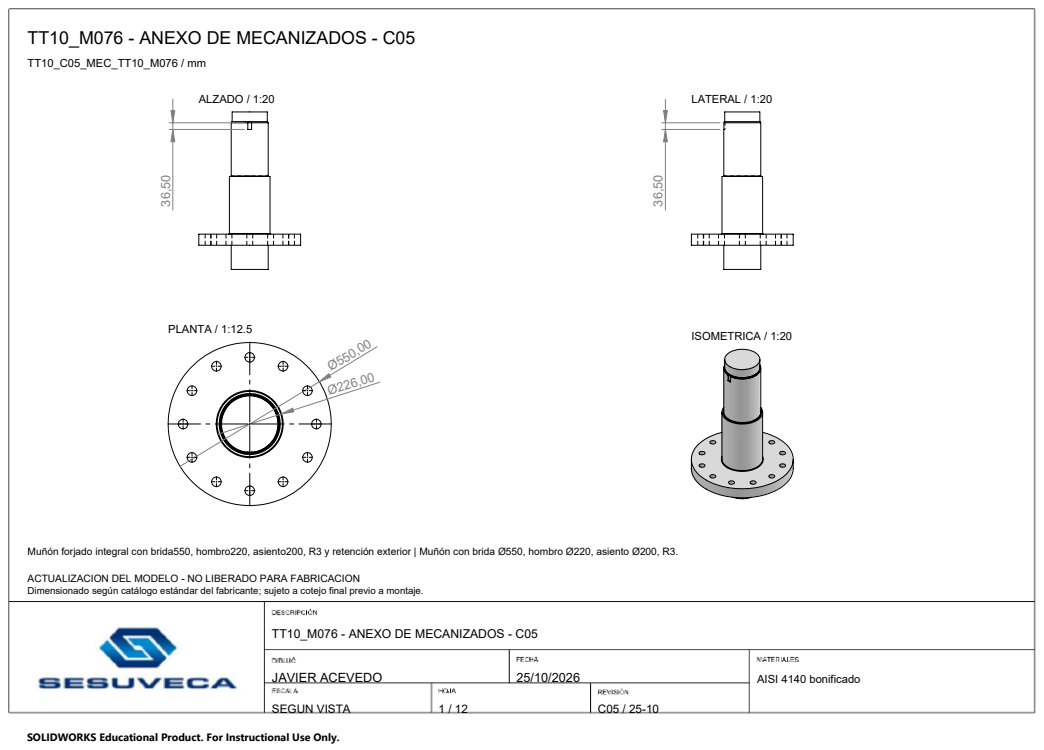
[picture p43: page 91]
TT10_C05_MEC_TT10_M076 / mm; JAVIER ACEVEDO; SEGUN VISTA; AISI 4140 bonificado; ALZADO / 1:20; LATERAL / 1:20; PLANTA / 1:12.5; ISOMETRICA / 1:20

Muñón forjado integral con brida550, hombro220, asiento200, R3 y retención exterior | Muñón con brida Ø550, hombro Ø220, asiento Ø200, R3.

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

TT10_M076 - ANEXO DE MECANIZADOS - C05

# TT10_M106 - ANEXO DE MECANIZADOS - C05

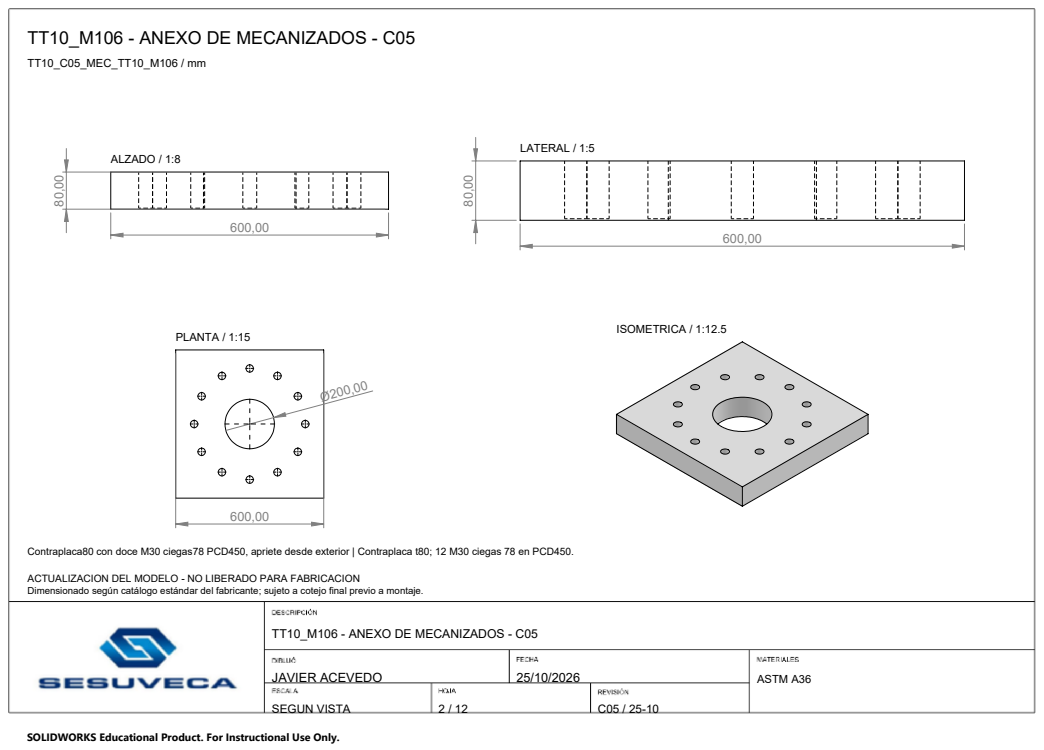
[picture p44: page 92]
TT10_C05_MEC_TT10_M106 / mm; JAVIER ACEVEDO; SEGUN VISTA; ASTM A36; ALZADO / 1:8; LATERAL / 1:5; PLANTA / 1:15; ISOMETRICA / 1:12.5

Contraplaca80 con doce M30 ciegas78 PCD450, apriete desde exterior | Contraplaca t80; 12 M30 ciegas 78 en PCD450.

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

TT10_M106 - ANEXO DE MECANIZADOS - C05

# TT10_COLLAR_N - ANEXO DE MECANIZADOS - C05

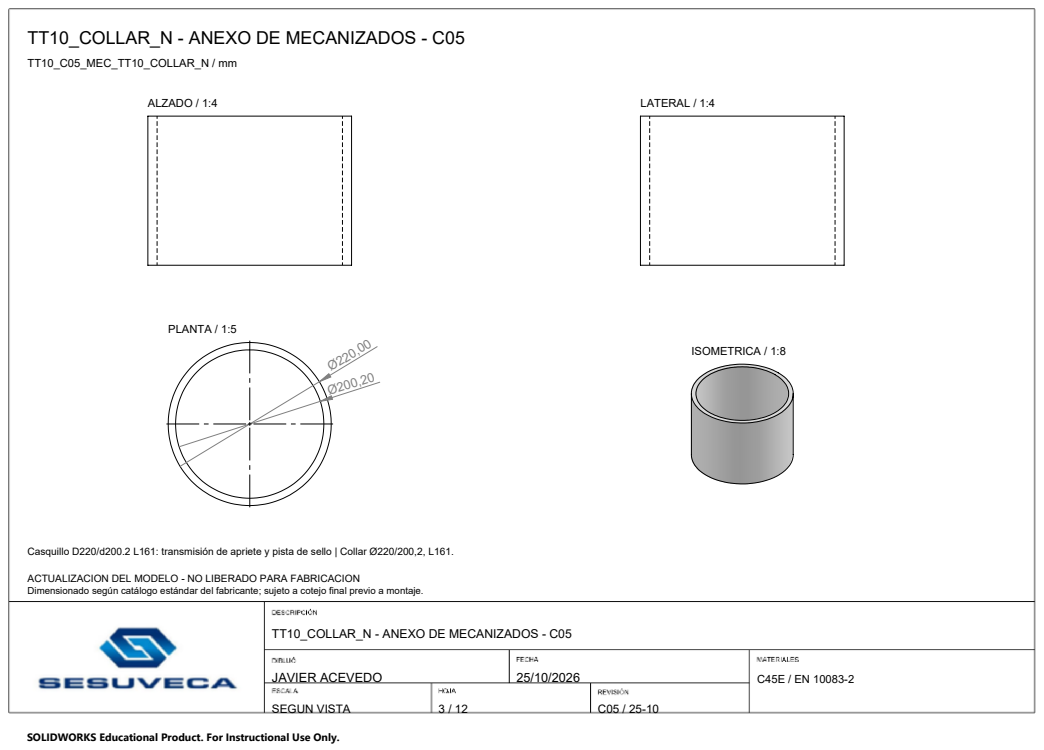
[picture p45: page 93]
TT10_C05_MEC_TT10_COLLAR_N / mm; JAVIER ACEVEDO; SEGUN VISTA; ALZADO / 1:4; LATERAL / 1:4; PLANTA / 1:5; ISOMETRICA / 1:8

Casquillo D220/d200.2 L161: transmisión de apriete y pista de sello | Collar Ø220/200,2, L161.

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

TT10_COLLAR_N - ANEXO DE MECANIZADOS - C05

# TT10_BUJE_PIN_N - ANEXO DE MECANIZADOS - C05

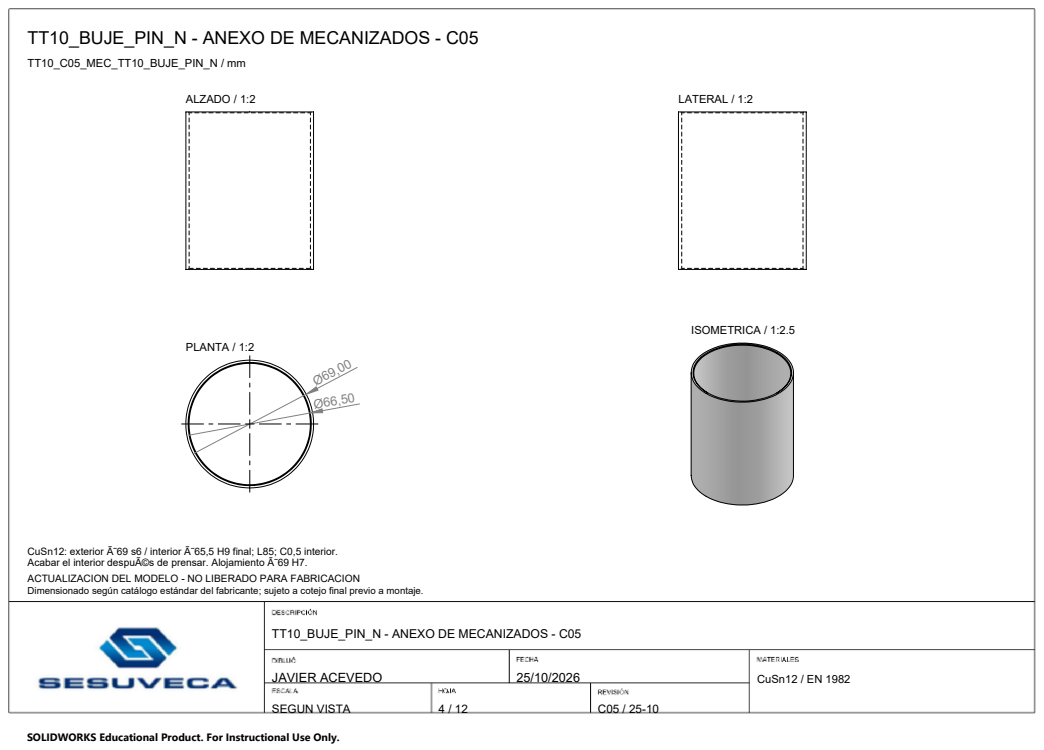
[picture p46: page 94]
TT10_C05_MEC_TT10_BUJE_PIN_N / mm; JAVIER ACEVEDO; SEGUN VISTA; CuSn12 / EN 1982; ALZADO / 1:2; LATERAL / 1:2; PLANTA / 1:2; ISOMETRICA / 1:2.5

CuSn12: exterior Ã˜69 s6 / interior Ã˜65,5 H9 final; L85; C0,5 interior.
Acabar el interior despuÃ©s de prensar. Alojamiento Ã˜69 H7.
ACTUALIZACION DEL MODELO - NO LIBERADO PARA FABRICACION
Dimensionado según catálogo estándar del fabricante; sujeto a cotejo final previo a montaje.

TT10_BUJE_PIN_N - ANEXO DE MECANIZADOS - C05

# TT10_C04_EJE_TIMON - ANEXO DE MECANIZADOS - C05

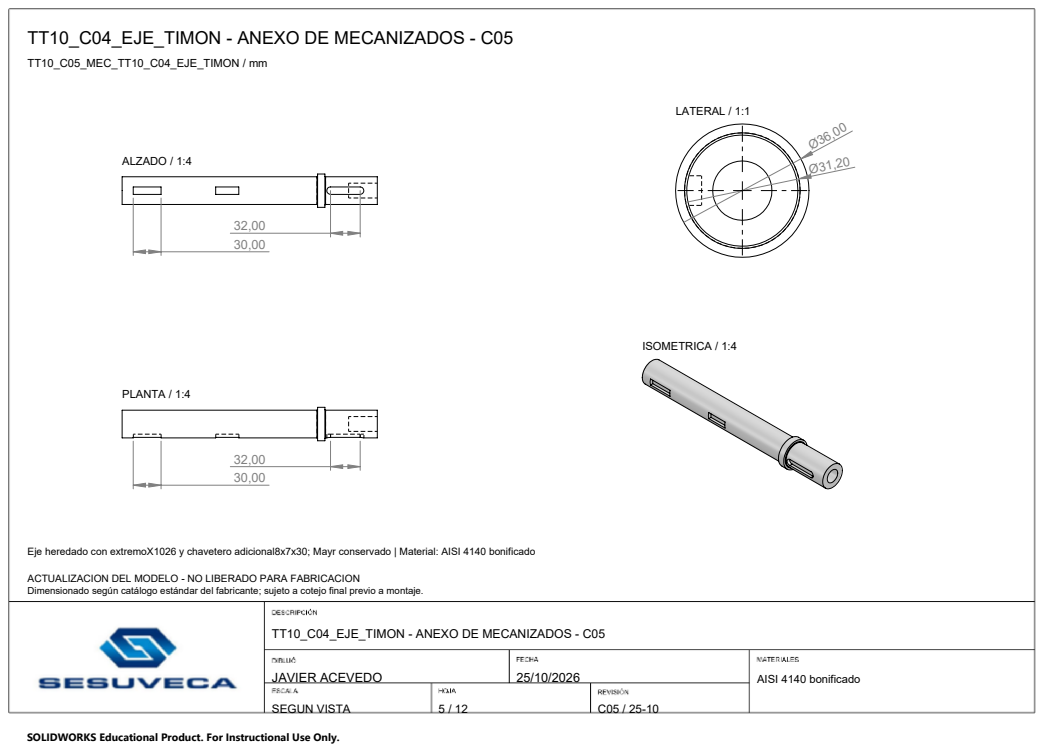
[picture p47: page 95]
TT10_C05_MEC_TT10_C04_EJE_TIMON / mm; JAVIER ACEVEDO; SEGUN VISTA; AISI 4140 bonificado; ALZADO / 1:4; LATERAL / 1:1; PLANTA / 1:4; ISOMETRICA / 1:4

Eje heredado con extremoX1026 y chavetero adicional8x7x30; Mayr conservado | Material: AISI 4140 bonificado

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

TT10_C04_EJE_TIMON - ANEXO DE MECANIZADOS - C05

# TT10_C04_ACOPLE_0 - ANEXO DE MECANIZADOS - C05

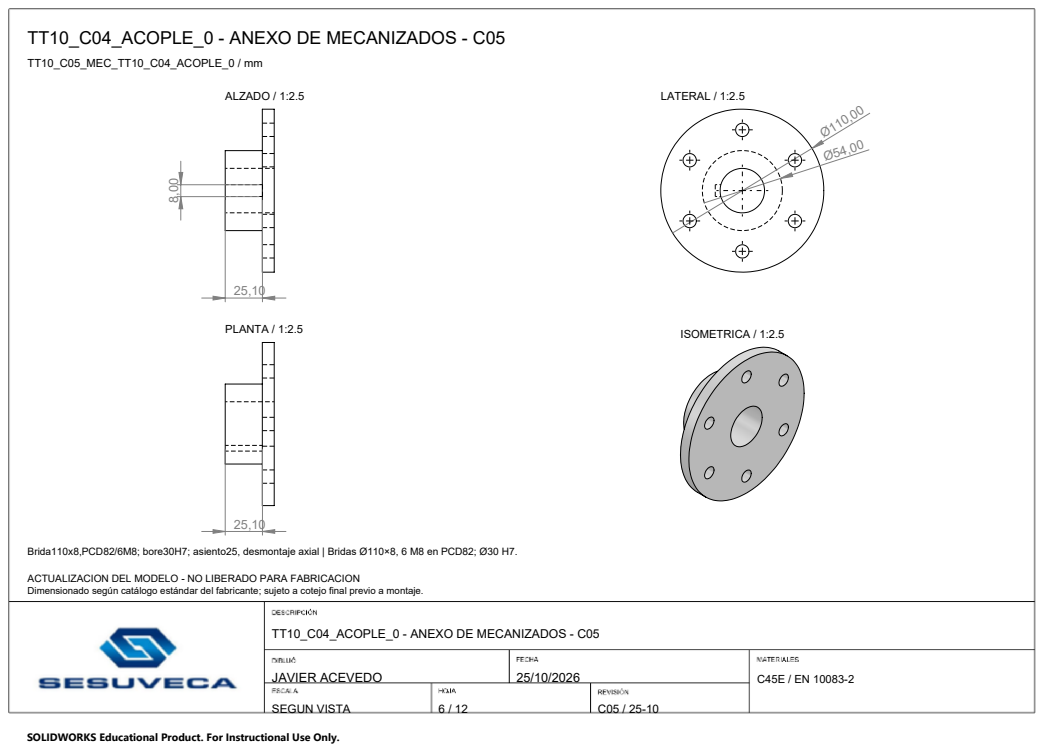
[picture p48: page 96]
TT10_C05_MEC_TT10_C04_ACOPLE_0 / mm; JAVIER ACEVEDO; SEGUN VISTA; ALZADO / 1:2.5; LATERAL / 1:2.5; PLANTA / 1:2.5; ISOMETRICA / 1:2.5

Brida110x8,PCD82/6M8; bore30H7; asiento25, desmontaje axial | Bridas Ø110×8, 6 M8 en PCD82; Ø30 H7.

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

TT10_C04_ACOPLE_0 - ANEXO DE MECANIZADOS - C05

# TT10_C04_ACOPLE_1 - ANEXO DE MECANIZADOS - C05

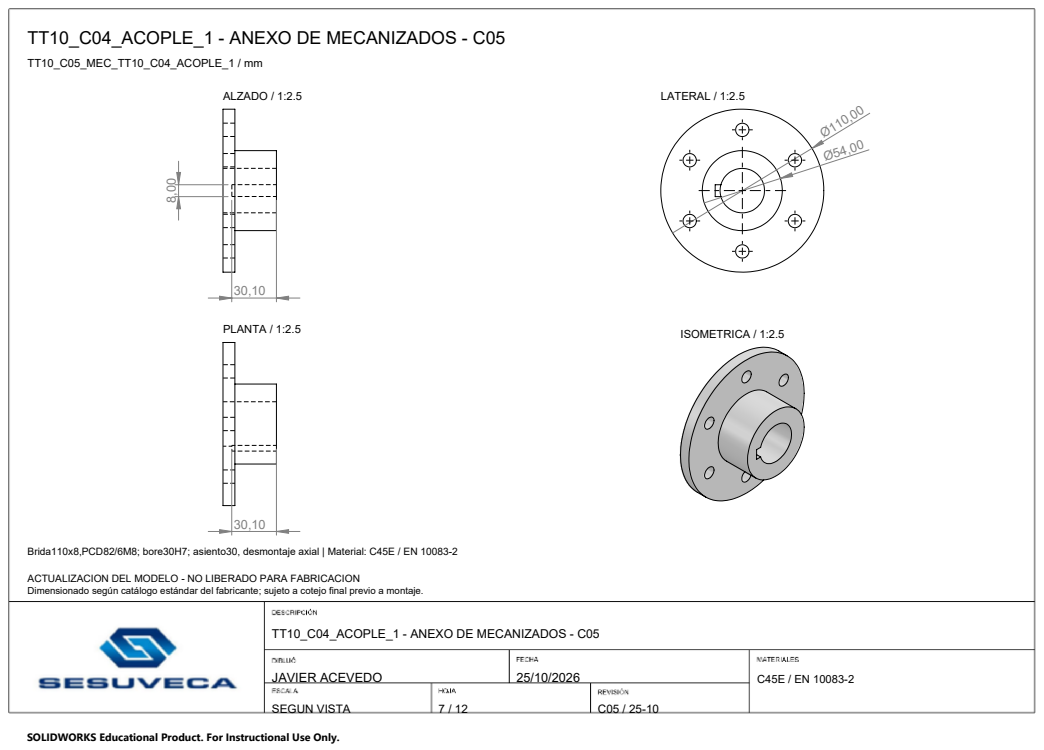
[picture p49: page 97]
TT10_C05_MEC_TT10_C04_ACOPLE_1 / mm; JAVIER ACEVEDO; SEGUN VISTA; ALZADO / 1:2.5; LATERAL / 1:2.5; PLANTA / 1:2.5; ISOMETRICA / 1:2.5

Brida110x8,PCD82/6M8; bore30H7; asiento30, desmontaje axial | Material: C45E / EN 10083-2

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

TT10_C04_ACOPLE_1 - ANEXO DE MECANIZADOS - C05

# TT10_C04_SELECTOR_EJE - ANEXO DE MECANIZADOS - C05

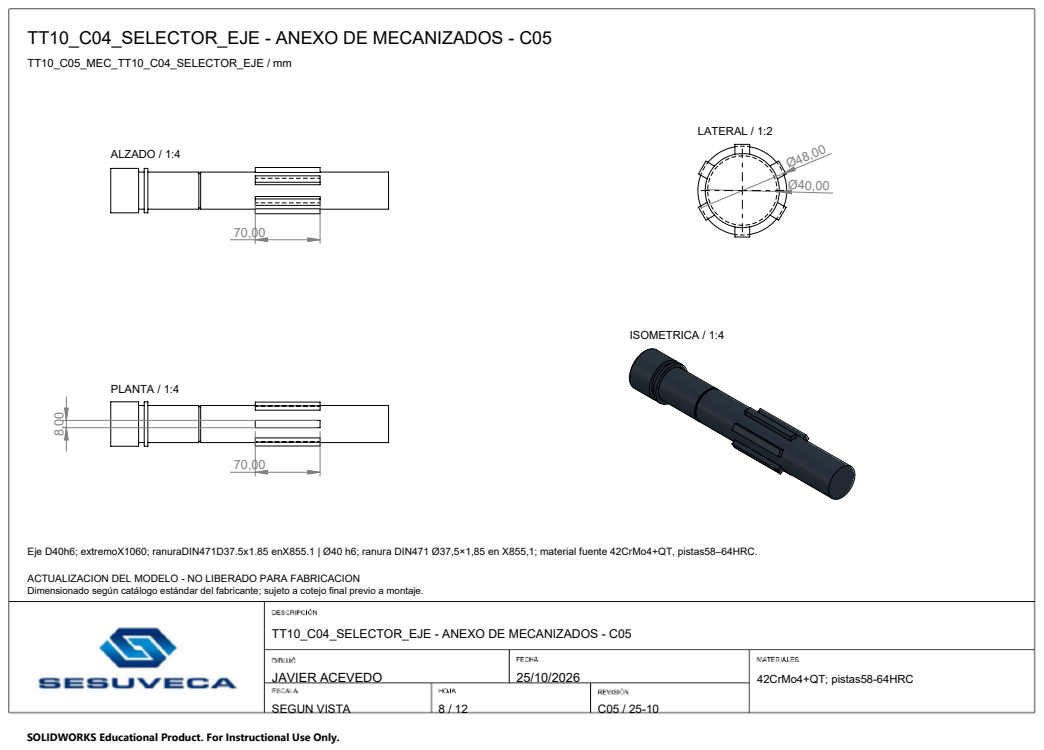
[picture p50: page 98]
TT10_C05_MEC_TT10_C04_SELECTOR_EJE / mm; JAVIER ACEVEDO; SEGUN VISTA; 42CrMo4+QT; pistas58-64HRC; ALZADO / 1:4; LATERAL / 1:2; PLANTA / 1:4; ISOMETRICA / 1:4

Eje D40h6; extremoX1060; ranuraDIN471D37.5x1.85 enX855.1 | Ø40 h6; ranura DIN471 Ø37,5×1,85 en X855,1; material fuente 42CrMo4+QT, pistas58–64HRC.

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

TT10_C04_SELECTOR_EJE - ANEXO DE MECANIZADOS - C05

# TT10_C05_BDNB_EJE_ENTRADA - ANEXO DE MECANIZADOS - C05

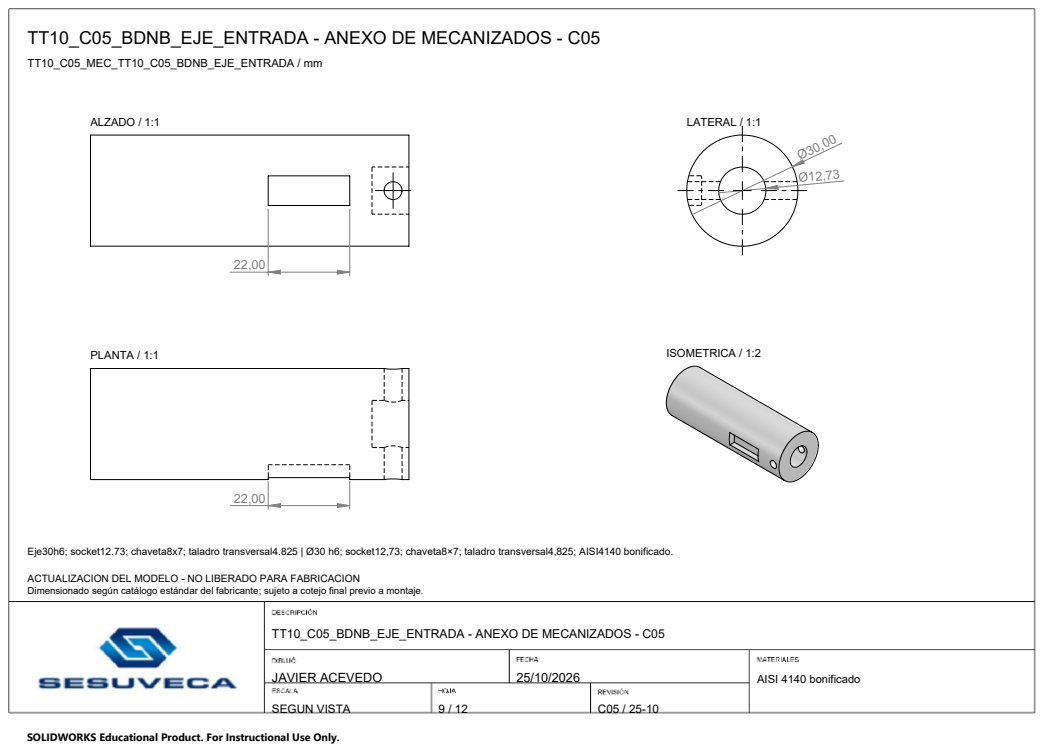
[picture p51: page 99]
TT10_C05_MEC_TT10_C05_BDNB_EJE_ENTRADA / mm; JAVIER ACEVEDO; SEGUN VISTA; AISI 4140 bonificado; ALZADO / 1:1; LATERAL / 1:1; PLANTA / 1:1; ISOMETRICA / 1:2

Eje30h6; socket12.73; chaveta8x7; taladro transversal4.825 | Ø30 h6; socket12,73; chaveta8×7; taladro transversal4,825; AISI4140 bonificado.

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

TT10_C05_BDNB_EJE_ENTRADA - ANEXO DE MECANIZADOS - C05

# TT10_C05_BDNB_EJE_SALIDA - ANEXO DE MECANIZADOS - C05

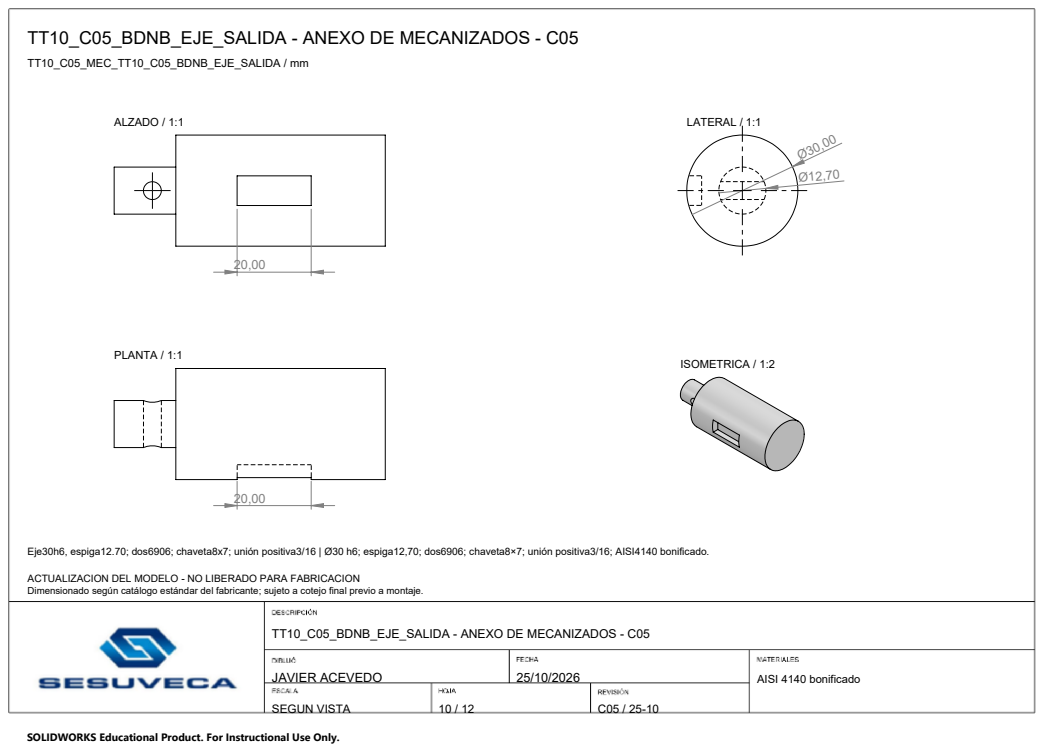
[picture p52: page 100]
TT10_C05_MEC_TT10_C05_BDNB_EJE_SALIDA / mm; JAVIER ACEVEDO; SEGUN VISTA; AISI 4140 bonificado; ALZADO / 1:1; LATERAL / 1:1; PLANTA / 1:1; ISOMETRICA / 1:2

Eje30h6, espiga12.70; dos6906; chaveta8x7; unión positiva3/16 | Ø30 h6; espiga12,70; dos6906; chaveta8×7; unión positiva3/16; AISI4140 bonificado.

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

TT10_C05_BDNB_EJE_SALIDA - ANEXO DE MECANIZADOS - C05

# TT10_C05_BDNB_ENGRANAJE - ANEXO DE MECANIZADOS - C05

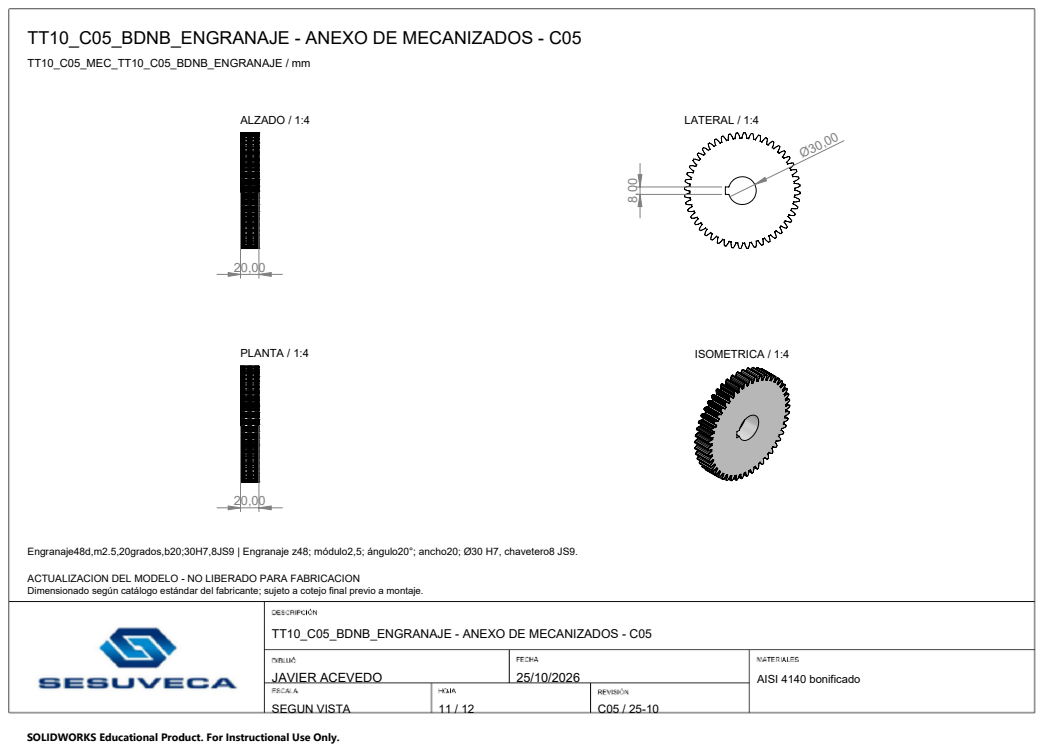
[picture p53: page 101]
TT10_C05_MEC_TT10_C05_BDNB_ENGRANAJE / mm; JAVIER ACEVEDO; SEGUN VISTA; AISI 4140 bonificado; ALZADO / 1:4; LATERAL / 1:4; PLANTA / 1:4; ISOMETRICA / 1:4; Engranaje48d,m2.5,20grados,b20;30H7,8JS9 | Engranaje z48; módulo2,5; ángulo20°; ancho20; Ø30 H7, chavetero8 JS9.

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

TT10_C05_BDNB_ENGRANAJE - ANEXO DE MECANIZADOS - C05

# TT10_C05_BDNB_CUBO_SELECTOR - ANEXO DE MECANIZADOS - C05

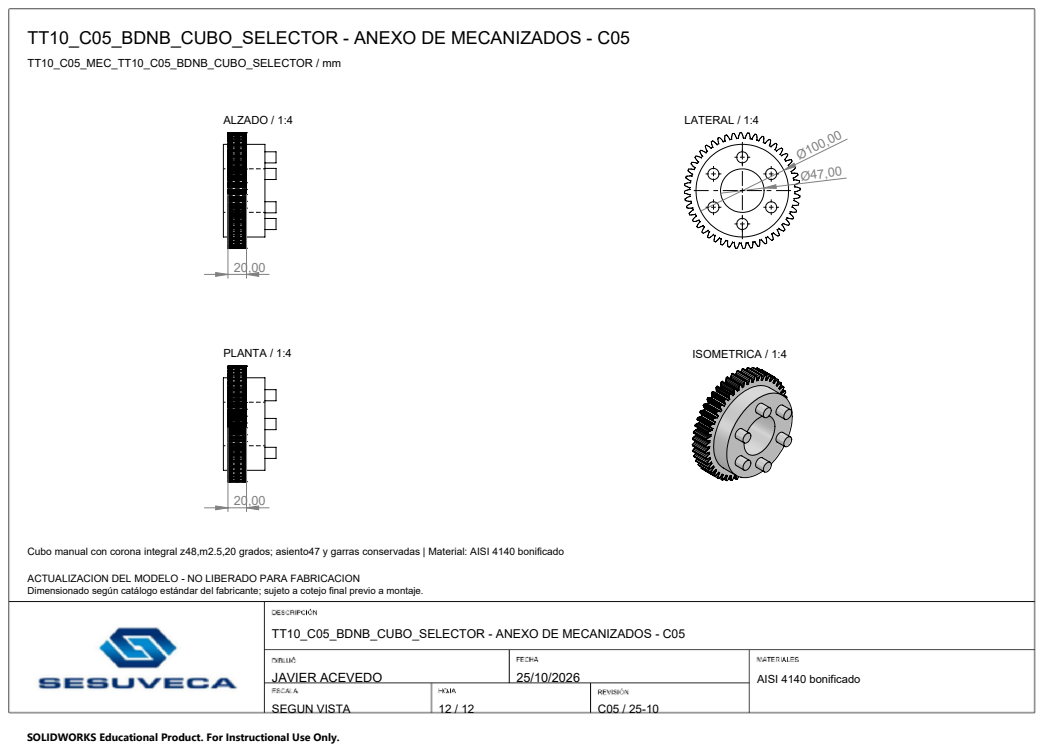
[picture p54: page 102]
TT10_C05_MEC_TT10_C05_BDNB_CUBO_SELECTOR / mm; JAVIER ACEVEDO; SEGUN VISTA; AISI 4140 bonificado; ALZADO / 1:4; LATERAL / 1:4; PLANTA / 1:4; ISOMETRICA / 1:4

Cubo manual con corona integral z48,m2.5,20 grados; asiento47 y garras conservadas | Material: AISI 4140 bonificado

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

TT10_C05_BDNB_CUBO_SELECTOR - ANEXO DE MECANIZADOS - C05
