acevedocrisologopablo48-lgtm/sesuveca-tolva-p04/dist/assets/plant-r01-preview.png

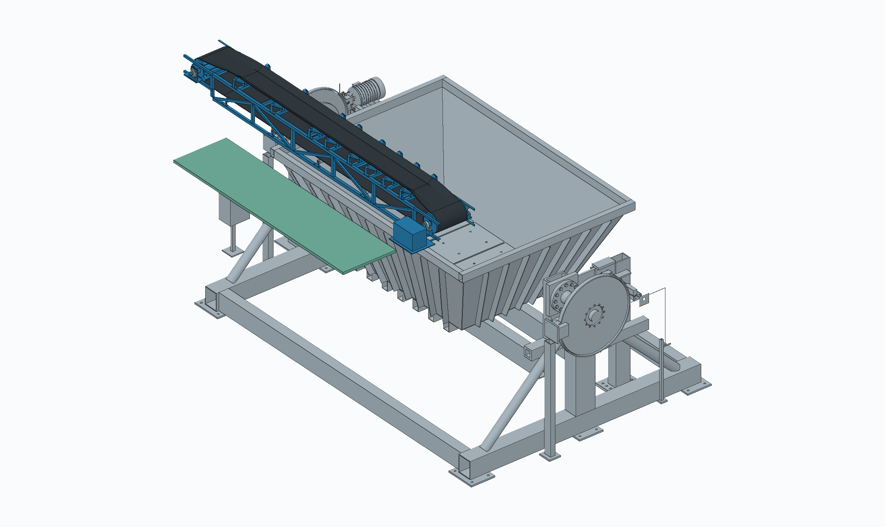
dist/assets/plant-r01-preview.png
