acevedocrisologopablo48-lgtm/sesuveca-tolva-p04/dist/documentos/TT10_LISTA_MATERIALES.xlsx

Sheet: BOM
Tolva trompo 10 t - Lista de materiales
16/10/2026. 500 códigos / 1004 instancias. 26 planos por conjuntos; 276 fabricados y 224 comprados.
Códigos | 500 | Instancias | 1004 |  |  |  |  | Masa conocida kg | 16849.06 | Masas sin acreditar | 80
Pos. | Código | Descripción | Cant. | Material / especificación | Tipo | Volumen m³ | Densidad kg/m³ | Masa unitaria kg | Masa conocida kg | Referencia / método | Estado de plano | Archivo CAD
1 | TT10_22240_N | SKF22240CC/W33 200x360x98; envolvente sin rodillos | 1 | Conjunto comprado; acero/ fundición según OEM | Comercial | 0.006892 |  | 43.500 | 43.500 | 22240 CC/W33 | BOM y montaje TT10-01; sin plano individual | C05E_TT10_22240_N.SLDPRT
2 | TT10_22240_P | SKF22240CC/W33 200x360x98; envolvente sin rodillos | 1 | Conjunto comprado; acero/ fundición según OEM | Comercial | 0.006892 |  | 43.500 | 43.500 | 22240 CC/W33 | BOM y montaje TT10-01; sin plano individual | C05E_TT10_22240_P.SLDPRT
3 | TT10_BAP_P0 | Perno ISO4014 M30x140 clase8.8; rosca nominal | 32 | Clase 8.8 / ISO 898-1 | Comercial | 0.000133 | 7850 | 1.046 | 33.467 | CAD_volume_x_specified_density | BOM y montaje TT10-01; sin plano individual | C05E_TT10_BAP_P0.SLDPRT
4 | TT10_BUJE_PIN_N | Casquillo CuSn12 Ø69 s6 / Ø65.5 H9 final, L85, C0.5 interiores | 1 | CuSn12 / EN 1982 | Fabricación | 0.000031 | 8800 | 0.276 | 0.276 | CAD_volume_x_specified_density | Plano de conjunto / detalle funcional: TT10-13 | C05E_TT10_BUJE_PIN_N.SLDPRT
5 | TT10_BUJE_PIN_P | Casquillo CuSn12 Ø69 s6 / Ø65.5 H9 final, L85, C0.5 interiores | 1 | CuSn12 / EN 1982 | Fabricación | 0.000031 | 8800 | 0.276 | 0.276 | CAD_volume_x_specified_density | Plano de conjunto / detalle funcional: TT10-13 | C05E_TT10_BUJE_PIN_P.SLDPRT
6 | TT10_C03_ACCESO_PUERTO_N | Guia de herramienta desde exterior N; puerto nominal rear+15.5/Z+53.7; NO conexion remota al actuador | 1 | ASTM A36 | Fabricación | 0.000020 | 7850 | 0.154 | 0.154 | CAD_volume_x_specified_density | Plano de conjunto / detalle funcional: TT10-24 | C05E_TT10_C03_ACCESO_PUERTO_N.SLDPRT
7 | TT10_C03_ACCESO_PUERTO_P | Guia de herramienta desde exterior P; puerto nominal rear+15.5/Z+53.7; NO conexion remota al actuador | 1 | ASTM A36 | Fabricación | 0.000020 | 7850 | 0.154 | 0.154 | CAD_volume_x_specified_density | Plano de conjunto / detalle funcional: TT10-24 | C05E_TT10_C03_ACCESO_PUERTO_P.SLDPRT
8 | TT10_C03_CADENA_ESLABON | Renold16B1: referencia visual de eslabon; no fabricar. Rodillos compartidos representados dos veces | 122 | Equipo comprado Renold | Comercial | 0.000010 |  | 0.071 | 8.677 | 16B-1 / 122 pasos | BOM y montaje TT10-01; sin plano individual | C05E_TT10_C03_CADENA_ESLABON.SLDPRT
9 | TT10_C03_HK4020_E1 | SKF HK4020; 40x47x20; rodillos y jaula omitidos | 1 | Conjunto comprado; acero/ fundición según OEM | Comercial | 0.000010 |  | n/d | n/d | HK 4020 | BOM y montaje TT10-01; sin plano individual | C05E_TT10_C03_HK4020_E1.SLDPRT
10 | TT10_C03_HK4020_E2 | SKF HK4020; 40x47x20; rodillos y jaula omitidos | 1 | Conjunto comprado; acero/ fundición según OEM | Comercial | 0.000010 |  | n/d | n/d | HK 4020 | BOM y montaje TT10-01; sin plano individual | C05E_TT10_C03_HK4020_E2.SLDPRT
11 | TT10_C03_HK4020_M1 | SKF HK4020; 40x47x20; rodillos y jaula omitidos | 1 | Conjunto comprado; acero/ fundición según OEM | Comercial | 0.000010 |  | n/d | n/d | HK 4020 | BOM y montaje TT10-01; sin plano individual | C05E_TT10_C03_HK4020_M1.SLDPRT
12 | TT10_C03_HK4020_M2 | SKF HK4020; 40x47x20; rodillos y jaula omitidos | 1 | Conjunto comprado; acero/ fundición según OEM | Comercial | 0.000010 |  | n/d | n/d | HK 4020 | BOM y montaje TT10-01; sin plano individual | C05E_TT10_C03_HK4020_M2.SLDPRT
13 | TT10_C03_REGISTRO_PUERTO_N | Registro exterior desmontable3 con accesoD50; fijaciones/proteccion de puesto por completar | 1 | ASTM A36 | Fabricación | 0.000108 | 7850 | 0.849 | 0.849 | CAD_volume_x_specified_density | Plano de conjunto / detalle funcional: TT10-24 | C05E_TT10_C03_REGISTRO_PUERTO_N.SLDPRT
14 | TT10_C03_REGISTRO_PUERTO_P | Registro exterior desmontable3 con accesoD50; fijaciones/proteccion de puesto por completar | 1 | ASTM A36 | Fabricación | 0.000108 | 7850 | 0.849 | 0.849 | CAD_volume_x_specified_density | Plano de conjunto / detalle funcional: TT10-24 | C05E_TT10_C03_REGISTRO_PUERTO_P.SLDPRT
15 | TT10_C03_SELECTOR_6008_1 | SKF6008 40x68x15; contorno de interfaz | 1 | Conjunto comprado; acero/ fundición según OEM | Comercial | 0.000036 |  | n/d | n/d | 6008 | BOM y montaje TT10-01; sin plano individual | C05E_TT10_C03_SELECTOR_6008_1.SLDPRT
16 | TT10_C03_SELECTOR_6008_2 | SKF6008 40x68x15; contorno de interfaz | 1 | Conjunto comprado; acero/ fundición según OEM | Comercial | 0.000036 |  | n/d | n/d | 6008 | BOM y montaje TT10-01; sin plano individual | C05E_TT10_C03_SELECTOR_6008_2.SLDPRT
17 | TT10_C03_SELECTOR_COLLAR_1 | Collar de varilla para sujetar horquilla; fijacion radial y retencion por completar | 1 | C45E / EN 10083-2 | Fabricación | 0.000001 | 7850 | 0.010 | 0.010 | CAD_volume_x_specified_density | Plano de conjunto / detalle funcional: TT10-21 | C05E_TT10_C03_SELECTOR_COLLAR_1.SLDPRT
18 | TT10_C03_SELECTOR_COLLAR_2 | Collar de varilla para sujetar horquilla; fijacion radial y retencion por completar | 1 | C45E / EN 10083-2 | Fabricación | 0.000001 | 7850 | 0.010 | 0.010 | CAD_volume_x_specified_density | Plano de conjunto / detalle funcional: TT10-21 | C05E_TT10_C03_SELECTOR_COLLAR_2.SLDPRT
19 | TT10_C03_SELECTOR_CUBIERTA | Cubierta desmontable3; ranura50x36 para recorrido completo; cierreM6 por detallar | 1 | ASTM A36 | Fabricación | 0.000062 | 7850 | 0.483 | 0.483 | CAD_volume_x_specified_density | Plano de conjunto / detalle funcional: TT10-20 | C05E_TT10_C03_SELECTOR_CUBIERTA.SLDPRT
20 | TT10_C03_SELECTOR_ENCLAVAMIENTO | Pasador positivoD6; levantar16mm antes de seleccionar y reinsertar; retencion cautiva y mando remoto pendientes | 1 | C45E / EN 10083-2 | Fabricación | 0.000001 | 7850 | 0.009 | 0.009 | CAD_volume_x_specified_density | Plano de conjunto / detalle funcional: TT10-21 | C05E_TT10_C03_SELECTOR_ENCLAVAMIENTO.SLDPRT
21 | TT10_C03_SELECTOR_HORQUILLA | Horquilla10 en ranura12; 1 mm nominal por flanco; garras de seleccion con la maquina parada | 1 | ASTM A36 | Fabricación | 0.000056 | 7850 | 0.443 | 0.443 | CAD_volume_x_specified_density | Plano de conjunto / detalle funcional: TT10-21 | C05E_TT10_C03_SELECTOR_HORQUILLA.SLDPRT
22 | TT10_C03_SELECTOR_MANGUITO | Manguito estriado: neutro X923..979; E+18/M-18; 6 alojamientos D12.2 PCD72 por cara | 1 | AISI 4140 bonificado | Fabricación | 0.000238 | 7850 | 1.865 | 1.865 | CAD_volume_x_specified_density | Plano de conjunto / detalle funcional: TT10-21 | C05E_TT10_C03_SELECTOR_MANGUITO.SLDPRT
23 | TT10_C03_SELECTOR_PARED_E | Pared mecanizada8; roscasM6; tapa de retencion y asiento axial por cadena de cotas | 1 | ASTM A36 | Fabricación | 0.000304 | 7850 | 2.386 | 2.386 | CAD_volume_x_specified_density | Plano de conjunto / detalle funcional: TT10-20 | C05E_TT10_C03_SELECTOR_PARED_E.SLDPRT
24 | TT10_C03_SELECTOR_PARED_M | Pared mecanizada8; roscasM6; tapa de retencion y asiento axial por cadena de cotas | 1 | ASTM A36 | Fabricación | 0.000304 | 7850 | 2.386 | 2.386 | CAD_volume_x_specified_density | Plano de conjunto / detalle funcional: TT10-20 | C05E_TT10_C03_SELECTOR_PARED_M.SLDPRT
25 | TT10_C03_SELECTOR_VARILLA | Varilla selector D16; tres taladrosD6.5 con paso18; E-N-M por pasador positivo | 1 | C45E / EN 10083-2 | Fabricación | 0.000035 | 7850 | 0.272 | 0.272 | CAD_volume_x_specified_density | Plano de conjunto / detalle funcional: TT10-21 | C05E_TT10_C03_SELECTOR_VARILLA.SLDPRT
26 | TT10_C03_TAPA_RETENCION_E | Tapa estacionaria: labio axial para cuboD100, pasoD92 libre al manguitoD90; junta axial0.2 por ajustar | 1 | ASTM A36 | Fabricación | 0.000019 | 7850 | 0.153 | 0.153 | CAD_volume_x_specified_density | Plano de conjunto / detalle funcional: TT10-20 | C05E_TT10_C03_TAPA_RETENCION_E.SLDPRT
27 | TT10_C03_TAPA_RETENCION_M | Tapa estacionaria: labio axial para cuboD100, pasoD92 libre al manguitoD90; junta axial0.2 por ajustar | 1 | ASTM A36 | Fabricación | 0.000019 | 7850 | 0.153 | 0.153 | CAD_volume_x_specified_density | Plano de conjunto / detalle funcional: TT10-20 | C05E_TT10_C03_TAPA_RETENCION_M.SLDPRT
28 | TT10_C04_ACOPLE_0 | Brida110x8,PCD82/6M8; bore30H7; asiento25, desmontaje axial | 1 | C45E / EN 10083-2 | Fabricación | 0.000106 | 7850 | 0.834 | 0.834 | CAD_volume_x_specified_density | Plano de conjunto / detalle funcional: TT10-18 | C05E_TT10_C04_ACOPLE_0.SLDPRT
29 | TT10_C04_ACOPLE_1 | Brida110x8,PCD82/6M8; bore30H7; asiento30, desmontaje axial | 1 | C45E / EN 10083-2 | Fabricación | 0.000111 | 7850 | 0.870 | 0.870 | CAD_volume_x_specified_density | Plano de conjunto / detalle funcional: TT10-18 | C05E_TT10_C04_ACOPLE_1.SLDPRT
30 | TT10_C04_ACOPLE_B8_0 | M8x25,8.8; cabeza exterior; apriete por plano | 4 | Clase 10.9 / ISO 898-1 | Comercial | 0.000002 | 7850 | 0.016 | 0.064 | CAD_volume_x_specified_density | BOM y montaje TT10-01; sin plano individual | C05E_TT10_C04_ACOPLE_B8_0.SLDPRT
31 | TT10_C04_ACOPLE_B8_4 | M8x25,8.8; cabeza exterior; apriete por plano | 2 | Clase 10.9 / ISO 898-1 | Comercial | 0.000002 | 7850 | 0.016 | 0.032 | CAD_volume_x_specified_density | BOM y montaje TT10-01; sin plano individual | C05E_TT10_C04_ACOPLE_B8_4.SLDPRT
32 | TT10_C04_ACOPLE_N8_0 | TuercaM8 clase8, autoblocante nominal | 4 | Tuerca clase 10 / ISO 898-2 | Comercial | 0.000001 | 7850 | 0.005 | 0.020 | CAD_volume_x_specified_density | BOM y montaje TT10-01; sin plano individual | C05E_TT10_C04_ACOPLE_N8_0.SLDPRT
33 | TT10_C04_ACOPLE_N8_2 | TuercaM8 clase8, autoblocante nominal | 2 | Tuerca clase 10 / ISO 898-2 | Comercial | 0.000001 | 7850 | 0.005 | 0.010 | CAD_volume_x_specified_density | BOM y montaje TT10-01; sin plano individual | C05E_TT10_C04_ACOPLE_N8_2.SLDPRT
34 | TT10_C04_ASIENTO_CHUMACERAS | Bloque90x180x52.1; cara superior mecanizada y4M12 ciegas28 | 1 | Conjunto comprado; acero/ fundición según OEM | Comercial | 0.000831 |  | n/d | n/d | OEM_mass_required | BOM y montaje TT10-01; sin plano individual | C05E_TT10_C04_ASIENTO_CHUMACERAS.SLDPRT
35 | TT10_C04_B6008_M6_1_0 | M6x20 ISO7380-1,10.9; contorno nominal | 2 | Clase 10.9 / ISO 898-1 | Comercial | 0.000001 | 7850 | 0.007 | 0.013 | CAD_volume_x_specified_density | BOM y montaje TT10-01; sin plano individual | C05E_TT10_C04_B6008_M6_1_0.SLDPRT
36 | TT10_C04_B6008_M6_1_2 | M6x20 ISO7380-1,10.9; contorno nominal | 1 | Clase 10.9 / ISO 898-1 | Comercial | 0.000001 | 7850 | 0.007 | 0.007 | CAD_volume_x_specified_density | BOM y montaje TT10-01; sin plano individual | C05E_TT10_C04_B6008_M6_1_2.SLDPRT
37 | TT10_C04_B6008_M6_1_3 | M6x20 ISO7380-1,10.9; contorno nominal | 1 | Clase 10.9 / ISO 898-1 | Comercial | 0.000001 | 7850 | 0.007 | 0.007 | CAD_volume_x_specified_density | BOM y montaje TT10-01; sin plano individual | C05E_TT10_C04_B6008_M6_1_3.SLDPRT
38 | TT10_C04_B6008_M6_2_0 | M6x20 ISO7380-1,10.9; contorno nominal | 2 | Clase 10.9 / ISO 898-1 | Comercial | 0.000001 | 7850 | 0.007 | 0.013 | CAD_volume_x_specified_density | BOM y montaje TT10-01; sin plano individual | C05E_TT10_C04_B6008_M6_2_0.SLDPRT
39 | TT10_C04_B6008_M6_2_1 | M6x20 ISO7380-1,10.9; contorno nominal | 2 | Clase 10.9 / ISO 898-1 | Comercial | 0.000001 | 7850 | 0.007 | 0.013 | CAD_volume_x_specified_density | BOM y montaje TT10-01; sin plano individual | C05E_TT10_C04_B6008_M6_2_1.SLDPRT
40 | TT10_C04_BANCADA | Bancada215x200x20, sobre poste corto; soldaduraa3 | 1 | ASTM A36 | Fabricación | 0.000859 | 7850 | 6.746 | 6.746 | CAD_volume_x_specified_density | Plano de conjunto / detalle funcional: TT10-16 | C05E_TT10_C04_BANCADA.SLDPRT
41 | TT10_C04_CARTELA_0 | Cartela12,165x55, a3 continuo a placa y poste | 1 | ASTM A36 | Fabricación | 0.000054 | 7850 | 0.427 | 0.427 | CAD_volume_x_specified_density | Plano de conjunto / detalle funcional: TT10-16 | C05E_TT10_C04_CARTELA_0.SLDPRT
42 | TT10_C04_CARTELA_1 | Cartela12,165x55, a3 continuo a placa y poste | 1 | ASTM A36 | Fabricación | 0.000054 | 7850 | 0.427 | 0.427 | CAD_volume_x_specified_density | Plano de conjunto / detalle funcional: TT10-16 | C05E_TT10_C04_CARTELA_1.SLDPRT
43 | TT10_C04_CHAVETA_ACOPLE_0 | Chaveta8x7x25 | 1 | AISI 4140 bonificado | Comercial | 0.000001 | 7850 | 0.011 | 0.011 | CAD_volume_x_specified_density | BOM y montaje TT10-01; sin plano individual | C05E_TT10_C04_CHAVETA_ACOPLE_0.SLDPRT
44 | TT10_C04_CHAVETA_ACOPLE_1 | Chaveta8x7x30 | 1 | AISI 4140 bonificado | Comercial | 0.000002 | 7850 | 0.013 | 0.013 | CAD_volume_x_specified_density | BOM y montaje TT10-01; sin plano individual | C05E_TT10_C04_CHAVETA_ACOPLE_1.SLDPRT
45 | TT10_C04_CHAVETA_CORONA | Chaveta8x7x40 de corona | 1 | AISI 4140 bonificado | Comercial | 0.000002 | 7850 | 0.018 | 0.018 | CAD_volume_x_specified_density | BOM y montaje TT10-01; sin plano individual | C05E_TT10_C04_CHAVETA_CORONA.SLDPRT
46 | TT10_C04_CHAVETA_MOTOR | Chaveta12x8x35, extremos planos; interfaz propia, no ejeOEM aprobado | 1 | Equipo comprado; materiales y masa según ficha OEM | Comercial | 0.000003 |  | n/d | n/d | OEM_mass_required | BOM y montaje TT10-01; sin plano individual | C05E_TT10_C04_CHAVETA_MOTOR.SLDPRT
47 | TT10_C04_CORONA_20D | Corona10888120; bore30H7 y chavetero8JS9 abierto al bore en todo su ancho; dentado comprado simplificado | 1 | C45E | Comercial | 0.000508 |  | n/d | n/d | OEM_mass_required | BOM y montaje TT10-01; sin plano individual | C05E_TT10_C04_CORONA_20D.SLDPRT
48 | TT10_C04_DIN471_40 | ComprarDIN471-40,1.75; contorno instalado simplificado, no fabricar | 1 | Acero resorte DIN471 | Comercial | 0.000001 | 7850 | 0.009 | 0.009 | CAD_volume_x_specified_density | BOM y montaje TT10-01; sin plano individual | C05E_TT10_C04_DIN471_40.SLDPRT
49 | TT10_C04_EJE_MANUAL | EjeD30h7,L184; chaveteros8x7, t1=4, extremos planos | 1 | AISI 4140 bonificado | Fabricación | 0.000128 | 7850 | 1.005 | 1.005 | CAD_volume_x_specified_density | Plano de conjunto / detalle funcional: TT10-18 | C05E_TT10_C04_EJE_MANUAL.SLDPRT
50 | TT10_C04_EJE_TIMON | Eje heredado con extremoX1026 y chavetero adicional8x7x30; Mayr conservado | 1 | AISI 4140 bonificado | Fabricación | 0.000188 | 7850 | 1.477 | 1.477 | CAD_volume_x_specified_density | Plano de conjunto / detalle funcional: TT10-17 | C05E_TT10_C04_EJE_TIMON.SLDPRT
51 | TT10_C04_ENTRADA_MOTOR | Interfaz nominal de entradaD40, separacion2mm del ejecomun; motor comercial aun nominal | 1 | Equipo comprado; materiales y masa según ficha OEM | Comercial | 0.000109 |  | n/d | n/d | OEM_mass_required | BOM y montaje TT10-01; sin plano individual | C05E_TT10_C04_ENTRADA_MOTOR.SLDPRT
52 | TT10_C04_ESPACIADOR6008 | Separador7 entre tapa izquierda y anillo exterior6008 | 1 | Conjunto comprado; acero/ fundición según OEM | Comercial | 0.000012 |  | n/d | n/d | OEM_mass_required | BOM y montaje TT10-01; sin plano individual | C05E_TT10_C04_ESPACIADOR6008.SLDPRT
53 | TT10_C04_GUARDA_ANCLA6_4470 | M6x16,8.8 a bancada; no anclaje a losa | 1 | Tornilleria8.8 | Comercial | 0.000001 |  | n/d | n/d | OEM_mass_required | BOM y montaje TT10-01; sin plano individual | C05E_TT10_C04_GUARDA_ANCLA6_4470.SLDPRT
54 | TT10_C04_GUARDA_ANCLA6_4630 | M6x16,8.8 a bancada; no anclaje a losa | 1 | Tornilleria8.8 | Comercial | 0.000001 |  | n/d | n/d | OEM_mass_required | BOM y montaje TT10-01; sin plano individual | C05E_TT10_C04_GUARDA_ANCLA6_4630.SLDPRT
55 | TT10_C04_GUARDA_B6_0 | M6x50,8.8 para tapa frontal | 4 | Clase 8.8 / ISO 898-1 | Comercial | 0.000002 | 7850 | 0.014 | 0.055 | CAD_volume_x_specified_density | BOM y montaje TT10-01; sin plano individual | C05E_TT10_C04_GUARDA_B6_0.SLDPRT
56 | TT10_C04_GUARDA_BANDA | Banda2, ancho36; tapa inferior; soldar a posterior, frontal desmontable | 1 | ASTM A36 | Fabricación | 0.000242 | 7850 | 1.897 | 1.897 | CAD_volume_x_specified_density | Plano de conjunto / detalle funcional: TT10-19 | C05E_TT10_C04_GUARDA_BANDA.SLDPRT
57 | TT10_C04_GUARDA_BASEW6_4470 | Arandela6,12x6.6x2 | 1 | Arandela endurecida 300 HV / ISO 7089 | Comercial | 1.577707831e-07 |  | n/d | n/d | OEM_mass_required | BOM y montaje TT10-01; sin plano individual | C05E_TT10_C04_GUARDA_BASEW6_4470.SLDPRT
58 | TT10_C04_GUARDA_BASEW6_4630 | Arandela6,12x6.6x2 | 1 | Arandela endurecida 300 HV / ISO 7089 | Comercial | 1.577707831e-07 |  | n/d | n/d | OEM_mass_required | BOM y montaje TT10-01; sin plano individual | C05E_TT10_C04_GUARDA_BASEW6_4630.SLDPRT
59 | TT10_C04_GUARDA_FRONTAL | Chapa2; contorno de cadena; inferiorZ1107; paso superior/FRONTAL | 1 | ASTM A36 | Fabricación | 0.000573 | 7850 | 4.501 | 4.501 | CAD_volume_x_specified_density | Plano de conjunto / detalle funcional: TT10-19 | C05E_TT10_C04_GUARDA_FRONTAL.SLDPRT
60 | TT10_C04_GUARDA_N6_0 | TuercaM6 autoblocante metalica; contorno nominal | 3 | Tornilleria8 | Comercial | 3.49969239e-07 |  | n/d | n/d | OEM_mass_required | BOM y montaje TT10-01; sin plano individual | C05E_TT10_C04_GUARDA_N6_0.SLDPRT
61 | TT10_C04_GUARDA_N6_2 | TuercaM6 autoblocante metalica; contorno nominal | 1 | Tornilleria8 | Comercial | 3.49969239e-07 |  | n/d | n/d | OEM_mass_required | BOM y montaje TT10-01; sin plano individual | C05E_TT10_C04_GUARDA_N6_2.SLDPRT
62 | TT10_C04_GUARDA_POSTERIOR | Chapa2; contorno de cadena; inferiorZ1107; paso superior/POSTERIOR | 1 | ASTM A36 | Fabricación | 0.000569 | 7850 | 4.465 | 4.465 | CAD_volume_x_specified_density | Plano de conjunto / detalle funcional: TT10-19 | C05E_TT10_C04_GUARDA_POSTERIOR.SLDPRT
63 | TT10_C04_GUARDA_W6_0 | ArandelaM6,12x6.6x1.6 | 3 | Arandela endurecida 300 HV / ISO 7089 | Comercial | 1.262166265e-07 |  | n/d | n/d | OEM_mass_required | BOM y montaje TT10-01; sin plano individual | C05E_TT10_C04_GUARDA_W6_0.SLDPRT
64 | TT10_C04_GUARDA_W6_2 | ArandelaM6,12x6.6x1.6 | 1 | Arandela endurecida 300 HV / ISO 7089 | Comercial | 1.262166265e-07 |  | n/d | n/d | OEM_mass_required | BOM y montaje TT10-01; sin plano individual | C05E_TT10_C04_GUARDA_W6_2.SLDPRT
65 | TT10_C04_PEDESTAL_SELECTOR | Pedestal con ventana46 para paso real de cadena/resguardo; soporte local por verificar | 1 | ASTM A36 | Fabricación | 0.015470 | 7850 | 121.438 | 121.438 | CAD_volume_x_specified_density | Plano de conjunto / detalle funcional: TT10-20 | C05E_TT10_C04_PEDESTAL_SELECTOR.SLDPRT
66 | TT10_C04_PLACA_TIMON | Placa de estacion existente con ventanaR57x25 para bridas110; apoyos yMayr conservados | 1 | ASTM A36 | Fabricación | 0.000859 | 7850 | 6.747 | 6.747 | CAD_volume_x_specified_density | Plano de conjunto / detalle funcional: TT10-17 | C05E_TT10_C04_PLACA_TIMON.SLDPRT
67 | TT10_C04_SELECTOR_APOYO_1 | Asiento6008 abierto; montaje axial y4M6PCD84; no cavidad inaccesible | 1 | Conjunto comprado; acero/ fundición según OEM | Comercial | 0.000512 |  | n/d | n/d | OEM_mass_required | BOM y montaje TT10-01; sin plano individual | C05E_TT10_C04_SELECTOR_APOYO_1.SLDPRT
68 | TT10_C04_SELECTOR_APOYO_2 | Asiento6008 abierto; montaje axial y4M6PCD84; no cavidad inaccesible | 1 | Conjunto comprado; acero/ fundición según OEM | Comercial | 0.000378 |  | n/d | n/d | OEM_mass_required | BOM y montaje TT10-01; sin plano individual | C05E_TT10_C04_SELECTOR_APOYO_2.SLDPRT
69 | TT10_C04_SELECTOR_BASE | Soporte con ventana46mm para cadena y guarda; caras restantes transmiten apoyo | 1 | ASTM A36 | Fabricación | 0.001354 | 7850 | 10.625 | 10.625 | CAD_volume_x_specified_density | Plano de conjunto / detalle funcional: TT10-20 | C05E_TT10_C04_SELECTOR_BASE.SLDPRT
70 | TT10_C04_SELECTOR_CUBO_E | CuboE con extension; pasoD41 hastaX1062, socketD40H7 y chavetero12x35 | 1 | AISI 4140 bonificado | Fabricación | 0.000514 | 7850 | 4.038 | 4.038 | CAD_volume_x_specified_density | Plano de conjunto / detalle funcional: TT10-21 | C05E_TT10_C04_SELECTOR_CUBO_E.SLDPRT
71 | TT10_C04_SELECTOR_EJE | Eje D40h6; extremoX1060; ranuraDIN471D37.5x1.85 enX855.1 | 1 | 42CrMo4+QT; pistas58-64HRC | Fabricación | 0.000413 | 7850 | 3.240 | 3.240 | Volumen CAD y densidad de fuente de diseño (7850 kg/m³) | Plano de conjunto / detalle funcional: TT10-21 | C05E_TT10_C04_SELECTOR_EJE.SLDPRT
72 | TT10_C04_SELECTOR_ESPACIADOR | Soporte con ventana46mm para cadena y guarda; caras restantes transmiten apoyo | 1 | ASTM A36 | Fabricación | 0.000828 | 7850 | 6.500 | 6.500 | CAD_volume_x_specified_density | Plano de conjunto / detalle funcional: TT10-20 | C05E_TT10_C04_SELECTOR_ESPACIADOR.SLDPRT
73 | TT10_C04_SY30_B12_930_4491.25 | M12x45,8.8;25.5mm nominales de rosca util | 2 | Clase 8.8 / ISO 898-1 | Comercial | 0.000007 | 7850 | 0.056 | 0.113 | CAD_volume_x_specified_density | BOM y montaje TT10-01; sin plano individual | C05E_TT10_C04_SY30_B12_930_4491.25.SLDPRT
74 | TT10_C04_SY30_B12_972_4491.25 | M12x45,8.8;25.5mm nominales de rosca util | 2 | Clase 8.8 / ISO 898-1 | Comercial | 0.000007 | 7850 | 0.056 | 0.113 | CAD_volume_x_specified_density | BOM y montaje TT10-01; sin plano individual | C05E_TT10_C04_SY30_B12_972_4491.25.SLDPRT
75 | TT10_C04_SY30_W12_930_4491.25 | ArandelaM12,24x13x2.5 | 2 | Arandela endurecida 300 HV / ISO 7089 | Comercial | 0.000001 |  | n/d | n/d | OEM_mass_required | BOM y montaje TT10-01; sin plano individual | C05E_TT10_C04_SY30_W12_930_4491.25.SLDPRT
76 | TT10_C04_SY30_W12_930_4608.75 | ArandelaM12,24x13x2.5 | 2 | Arandela endurecida 300 HV / ISO 7089 | Comercial | 0.000001 |  | n/d | n/d | OEM_mass_required | BOM y montaje TT10-01; sin plano individual | C05E_TT10_C04_SY30_W12_930_4608.75.SLDPRT
77 | TT10_C04_TAPA6008_1 | Tapa104x4, cabezas en cajera; desmontaje exterior | 1 | ASTM A36 | Fabricación | 0.000025 | 7850 | 0.194 | 0.194 | CAD_volume_x_specified_density | Plano de conjunto / detalle funcional: TT10-20 | C05E_TT10_C04_TAPA6008_1.SLDPRT
78 | TT10_C04_TAPA6008_2 | Tapa104x4, cabezas en cajera; desmontaje exterior | 1 | ASTM A36 | Fabricación | 0.000023 | 7850 | 0.179 | 0.179 | CAD_volume_x_specified_density | Plano de conjunto / detalle funcional: TT10-20 | C05E_TT10_C04_TAPA6008_2.SLDPRT
79 | TT10_C04_TRAVESANO | RHS100x50x5,L230; une los dos postes del puesto manual, a3 | 1 | S275J0H / EN 10219-1 | Fabricación | 0.000322 | 7850 | 2.528 | 2.528 | CAD_volume_x_specified_density | Plano de conjunto / detalle funcional: TT10-16 | C05E_TT10_C04_TRAVESANO.SLDPRT
80 | TT10_C05_ARANDELA_TENSOR_0 | Arandela puente44x21x4, endurecida, cubre ranura22 | 1 | Arandela endurecida 300 HV / ISO 7089 | Comercial | 0.000005 | 7850 | 0.037 | 0.037 | CAD_volume_x_specified_density | BOM y montaje TT10-01; sin plano individual | C05E_TT10_C05_ARANDELA_TENSOR_0.SLDPRT
81 | TT10_C05_ARANDELA_TENSOR_1 | Arandela puente44x21x4, endurecida, cubre ranura22 | 1 | Arandela endurecida 300 HV / ISO 7089 | Comercial | 0.000005 | 7850 | 0.037 | 0.037 | CAD_volume_x_specified_density | BOM y montaje TT10-01; sin plano individual | C05E_TT10_C05_ARANDELA_TENSOR_1.SLDPRT
82 | TT10_C05_ARANDELA_TENSOR_2 | Arandela puente44x21x4, endurecida, cubre ranura22 | 1 | Arandela endurecida 300 HV / ISO 7089 | Comercial | 0.000005 | 7850 | 0.037 | 0.037 | CAD_volume_x_specified_density | BOM y montaje TT10-01; sin plano individual | C05E_TT10_C05_ARANDELA_TENSOR_2.SLDPRT
83 | TT10_C05_ARANDELA_TENSOR_3 | Arandela puente44x21x4, endurecida, cubre ranura22 | 1 | Arandela endurecida 300 HV / ISO 7089 | Comercial | 0.000005 | 7850 | 0.037 | 0.037 | CAD_volume_x_specified_density | BOM y montaje TT10-01; sin plano individual | C05E_TT10_C05_ARANDELA_TENSOR_3.SLDPRT
84 | TT10_C05_B20_TENSOR_0 | Tornillo M20x45,ISO4017 8.8; geometria nominal | 1 | Clase 8.8 / ISO 898-1 | Comercial | 0.000024 | 7850 | 0.187 | 0.187 | CAD_volume_x_specified_density | BOM y montaje TT10-01; sin plano individual | C05E_TT10_C05_B20_TENSOR_0.SLDPRT
85 | TT10_C05_B20_TENSOR_1 | Tornillo M20x45,ISO4017 8.8; geometria nominal | 1 | Clase 8.8 / ISO 898-1 | Comercial | 0.000024 | 7850 | 0.187 | 0.187 | CAD_volume_x_specified_density | BOM y montaje TT10-01; sin plano individual | C05E_TT10_C05_B20_TENSOR_1.SLDPRT
86 | TT10_C05_B20_TENSOR_2 | Tornillo M20x45,ISO4017 8.8; geometria nominal | 1 | Clase 8.8 / ISO 898-1 | Comercial | 0.000024 | 7850 | 0.187 | 0.187 | CAD_volume_x_specified_density | BOM y montaje TT10-01; sin plano individual | C05E_TT10_C05_B20_TENSOR_2.SLDPRT
87 | TT10_C05_B20_TENSOR_3 | Tornillo M20x45,ISO4017 8.8; geometria nominal | 1 | Clase 8.8 / ISO 898-1 | Comercial | 0.000024 | 7850 | 0.187 | 0.187 | CAD_volume_x_specified_density | BOM y montaje TT10-01; sin plano individual | C05E_TT10_C05_B20_TENSOR_3.SLDPRT
88 | TT10_C05_B4_RETEN_0_0 | M4x9,8.8; tornillo del puente cautivo; fijador desmontable | 1 | Clase 10.9 / ISO 898-1 | Comercial | 2.670353756e-07 | 7850 | 0.002 | 0.002 | CAD_volume_x_specified_density | BOM y montaje TT10-01; sin plano individual | C05E_TT10_C05_B4_RETEN_0_0.SLDPRT
89 | TT10_C05_B4_RETEN_0_1 | M4x9,8.8; tornillo del puente cautivo; fijador desmontable | 1 | Clase 10.9 / ISO 898-1 | Comercial | 2.670353756e-07 | 7850 | 0.002 | 0.002 | CAD_volume_x_specified_density | BOM y montaje TT10-01; sin plano individual | C05E_TT10_C05_B4_RETEN_0_1.SLDPRT
90 | TT10_C05_B4_RETEN_1_0 | M4x9,8.8; tornillo del puente cautivo; fijador desmontable | 1 | Clase 10.9 / ISO 898-1 | Comercial | 2.670353756e-07 | 7850 | 0.002 | 0.002 | CAD_volume_x_specified_density | BOM y montaje TT10-01; sin plano individual | C05E_TT10_C05_B4_RETEN_1_0.SLDPRT
91 | TT10_C05_B4_RETEN_1_1 | M4x9,8.8; tornillo del puente cautivo; fijador desmontable | 1 | Clase 10.9 / ISO 898-1 | Comercial | 2.670353756e-07 | 7850 | 0.002 | 0.002 | CAD_volume_x_specified_density | BOM y montaje TT10-01; sin plano individual | C05E_TT10_C05_B4_RETEN_1_1.SLDPRT
92 | TT10_C05_BASE_FIJA_TENSOR | Base fija630x420x20; cuatro M20 roscados20;apriete100Nm;no son anclajes a losa | 1 | ASTM A36 | Fabricación | 0.005169 | 7850 | 40.576 | 40.576 | CAD_volume_x_specified_density | Plano de conjunto / detalle funcional: TT10-16 | C05E_TT10_C05_BASE_FIJA_TENSOR.SLDPRT
93 | TT10_C05_BDNB_28_23 | Warner BDNB 28.23Nm, brida lado entrada, exterior reconstruido según MCC-P-1310 03/25 p69; cotas nominales medias | 1 | Equipo comprado | Comercial | 0.000115 |  | 0.907 | 0.907 | BDNB 28.23 Nm / MCC-P-1310, p.69 | BOM y montaje TT10-01; sin plano individual | TT10_C05_BDNB_28_23.SLDPRT
94 | TT10_C05_BDNB_APOYO_0_INFERIOR | Apoyo partido6006, asientoH7, tapa2M6x60, roscasM6 cuerpo; soldaduraa4 base | 1 | ASTM A36 | Fabricación | 0.000158 | 7850 | 1.238 | 1.238 | Volumen CAD y densidad | Plano de conjunto / detalle funcional: TT10-22 | TT10_C05_BDNB_APOYO_0_INFERIOR_B02.SLDPRT
95 | TT10_C05_BDNB_APOYO_0_TAPA | Apoyo partido6006, asientoH7, tapa2M6x60, roscasM6 cuerpo; soldaduraa4 base | 1 | ASTM A36 | Fabricación | 0.000037 | 7850 | 0.294 | 0.294 | Volumen CAD y densidad | Plano de conjunto / detalle funcional: TT10-22 | TT10_C05_BDNB_APOYO_0_TAPA_B02.SLDPRT
96 | TT10_C05_BDNB_APOYO_1_INFERIOR | Apoyo partido6006, asientoH7, tapa2M6x60, roscasM6 cuerpo; soldaduraa4 base | 1 | ASTM A36 | Fabricación | 0.000158 | 7850 | 1.238 | 1.238 | Volumen CAD y densidad | Plano de conjunto / detalle funcional: TT10-22 | TT10_C05_BDNB_APOYO_1_INFERIOR_B02.SLDPRT
97 | TT10_C05_BDNB_APOYO_1_TAPA | Apoyo partido6006, asientoH7, tapa2M6x60, roscasM6 cuerpo; soldaduraa4 base | 1 | ASTM A36 | Fabricación | 0.000037 | 7850 | 0.294 | 0.294 | Volumen CAD y densidad | Plano de conjunto / detalle funcional: TT10-22 | TT10_C05_BDNB_APOYO_1_TAPA_B02.SLDPRT
98 | TT10_C05_BDNB_APOYO_2_INFERIOR | Apoyo partido6906, asientoH7, tapa2M6x60, roscasM6 cuerpo; soldaduraa4 base | 1 | ASTM A36 | Fabricación | 0.000124 | 7850 | 0.974 | 0.974 | Volumen CAD y densidad | Plano de conjunto / detalle funcional: TT10-22 | TT10_C05_BDNB_APOYO_2_INFERIOR.SLDPRT
99 | TT10_C05_BDNB_APOYO_2_TAPA | Apoyo partido6906, asientoH7, tapa2M6x60, roscasM6 cuerpo; soldaduraa4 base | 1 | ASTM A36 | Fabricación | 0.000032 | 7850 | 0.249 | 0.249 | Volumen CAD y densidad | Plano de conjunto / detalle funcional: TT10-22 | TT10_C05_BDNB_APOYO_2_TAPA.SLDPRT
100 | TT10_C05_BDNB_APOYO_3_INFERIOR | Apoyo partido6906, asientoH7, tapa2M6x60, roscasM6 cuerpo; soldaduraa4 base | 1 | ASTM A36 | Fabricación | 0.000124 | 7850 | 0.974 | 0.974 | Volumen CAD y densidad | Plano de conjunto / detalle funcional: TT10-22 | TT10_C05_BDNB_APOYO_3_INFERIOR.SLDPRT
101 | TT10_C05_BDNB_APOYO_3_TAPA | Apoyo partido6906, asientoH7, tapa2M6x60, roscasM6 cuerpo; soldaduraa4 base | 1 | ASTM A36 | Fabricación | 0.000032 | 7850 | 0.249 | 0.249 | Volumen CAD y densidad | Plano de conjunto / detalle funcional: TT10-22 | TT10_C05_BDNB_APOYO_3_TAPA.SLDPRT
102 | TT10_C05_BDNB_BASE | Base16 con ventana cadena,4pasos11;4M10x35 en placa existente roscadaM10 | 1 | ASTM A36 | Fabricación | 0.000348 | 7850 | 2.728 | 2.728 | Volumen CAD y densidad | Plano de conjunto / detalle funcional: TT10-22 | TT10_C05_BDNB_BASE.SLDPRT
103 | TT10_C05_BDNB_CHAVETA_ENTRADA | ChavetaDIN6885A8x7, longitud según código | 1 | C45E | Comercial | 0.000001 | 7850 | 0.010 | 0.010 | Volumen CAD y densidad | BOM y montaje TT10-01; sin plano individual | TT10_C05_BDNB_CHAVETA_ENTRADA.SLDPRT
104 | TT10_C05_BDNB_CHAVETA_SALIDA | ChavetaDIN6885A8x7, longitud según código | 1 | C45E | Comercial | 0.000001 | 7850 | 0.009 | 0.009 | Volumen CAD y densidad | BOM y montaje TT10-01; sin plano individual | TT10_C05_BDNB_CHAVETA_SALIDA.SLDPRT
105 | TT10_C05_BDNB_CORONA_20D | Mädler10888120: interfaz modificada30H7/8JS9; dentado visual simplificado | 1 | Equipo comprado | Comercial | 0.000320 |  | n/d | n/d | Masa comercial sin acreditar | BOM y montaje TT10-01; sin plano individual | TT10_C05_BDNB_CORONA_20D.SLDPRT
106 | TT10_C05_BDNB_CUBO_SELECTOR | Cubo manual con corona integral z48,m2.5,20 grados; asiento47 y garras conservadas | 1 | AISI 4140 bonificado | Fabricación | 0.000351 | 7850 | 2.752 | 2.752 | Volumen CAD y densidad | Plano de conjunto / detalle funcional: TT10-23 | TT10_C05_BDNB_CUBO_SELECTOR.SLDPRT
107 | TT10_C05_BDNB_EJE_ENTRADA | Eje30h6; socket12.73; chaveta8x7; taladro transversal4.825 | 1 | AISI 4140 bonificado | Fabricación | 0.000059 | 7850 | 0.459 | 0.459 | Volumen CAD y densidad de fuente de diseño (7850 kg/m³) | Plano de conjunto / detalle funcional: TT10-23 | TT10_C05_BDNB_EJE_ENTRADA_B02.SLDPRT
108 | TT10_C05_BDNB_EJE_SALIDA | Eje30h6, espiga12.70; dos6906; chaveta8x7; unión positiva3/16 | 1 | AISI 4140 bonificado | Fabricación | 0.000041 | 7850 | 0.324 | 0.324 | Volumen CAD y densidad de fuente de diseño (7850 kg/m³) | Plano de conjunto / detalle funcional: TT10-23 | TT10_C05_BDNB_EJE_SALIDA.SLDPRT
109 | TT10_C05_BDNB_ENGRANAJE | Engranaje48d,m2.5,20grados,b20;30H7,8JS9 | 1 | AISI 4140 bonificado | Fabricación | 0.000209 | 7850 | 1.645 | 1.645 | Volumen CAD y densidad | Plano de conjunto / detalle funcional: TT10-23 | TT10_C05_BDNB_ENGRANAJE.SLDPRT
110 | TT10_C05_BDNB_M10 | TornilloISO4017 M10x35-8.8; rosca nominal | 4 | Clase 8.8 / ISO 898-1 | Comercial | 0.000004 | 7850 | 0.033 | 0.131 | Volumen CAD y densidad | BOM y montaje TT10-01; sin plano individual | TT10_C05_BDNB_M10.SLDPRT
111 | TT10_C05_BDNB_M5 | ISO4017 M5x20-8.8, rosca nominal | 4 | Clase 8.8 / ISO 898-1 | Comercial | 0.000001 | 7850 | 0.005 | 0.018 | Volumen CAD y densidad | BOM y montaje TT10-01; sin plano individual | TT10_C05_BDNB_M5.SLDPRT
112 | TT10_C05_BDNB_M6 | TornilloISO4017 M6x60-8.8; rosca nominal | 8 | Clase 8.8 / ISO 898-1 | Comercial | 0.000002 | 7850 | 0.016 | 0.128 | Volumen CAD y densidad | BOM y montaje TT10-01; sin plano individual | TT10_C05_BDNB_M6.SLDPRT
113 | TT10_C05_BDNB_N3_ENTRADA | TuercaISO7042 M3 autoblocante metálica, rosca nominal | 1 | Tuerca clase 8 / ISO 898-2 | Comercial | 8.515411977e-08 | 7850 | 0.001 | 0.001 | Volumen CAD y densidad | BOM y montaje TT10-01; sin plano individual | TT10_C05_BDNB_N3_ENTRADA.SLDPRT
114 | TT10_C05_BDNB_N3_SALIDA | TuercaISO7042 M3 autoblocante metálica, rosca nominal | 1 | Tuerca clase 8 / ISO 898-2 | Comercial | 8.515411977e-08 | 7850 | 0.001 | 0.001 | Volumen CAD y densidad | BOM y montaje TT10-01; sin plano individual | TT10_C05_BDNB_N3_SALIDA.SLDPRT
115 | TT10_C05_BDNB_N5 | TuercaISO4032 M5-8; rosca nominal | 4 | Tuerca clase 8 / ISO 898-2 | Comercial | 1.66284809e-07 | 7850 | 0.001 | 0.005 | Volumen CAD y densidad | BOM y montaje TT10-01; sin plano individual | TT10_C05_BDNB_N5.SLDPRT
116 | TT10_C05_BDNB_PASADOR_ENTRADA | Pasador transversal3/16, cabeza7, puntaM3x5; C45E bonificado, Rp0.2 minimo650MPa | 1 | C45E / EN 10083-2 | Fabricación | 0.000001 | 7850 | 0.006 | 0.006 | Volumen CAD y densidad | Plano de conjunto / detalle funcional: TT10-23 | TT10_C05_BDNB_PASADOR_ENTRADA.SLDPRT
117 | TT10_C05_BDNB_PASADOR_SALIDA | Pasador transversal3/16, cabeza7, puntaM3x5; C45E bonificado, Rp0.2 minimo650MPa | 1 | C45E / EN 10083-2 | Fabricación | 0.000001 | 7850 | 0.004 | 0.004 | Volumen CAD y densidad | Plano de conjunto / detalle funcional: TT10-23 | TT10_C05_BDNB_PASADOR_SALIDA.SLDPRT
118 | TT10_C05_BDNB_PLACA_REACCION | Reacción BDNB8mm,4Ø5.5PCD53.85; soldaduraa4 ambos lados a base | 1 | ASTM A36 | Fabricación | 0.000107 | 7850 | 0.843 | 0.843 | Volumen CAD y densidad | Plano de conjunto / detalle funcional: TT10-22 | TT10_C05_BDNB_PLACA_REACCION.SLDPRT
119 | TT10_C05_BDNB_RODAMIENTO_0 | RodamientoSKF6006; envolvente de montaje; selección de vida separada | 1 | Equipo comprado | Comercial | 0.000022 |  | n/d | n/d | Masa comercial sin acreditar | BOM y montaje TT10-01; sin plano individual | TT10_C05_BDNB_RODAMIENTO_0_B02.SLDPRT
120 | TT10_C05_BDNB_RODAMIENTO_1 | RodamientoSKF6006; envolvente de montaje; selección de vida separada | 1 | Equipo comprado | Comercial | 0.000022 |  | n/d | n/d | Masa comercial sin acreditar | BOM y montaje TT10-01; sin plano individual | TT10_C05_BDNB_RODAMIENTO_1_B02.SLDPRT
121 | TT10_C05_BDNB_RODAMIENTO_2 | RodamientoSKF6906; envolvente de montaje; selección de vida separada | 1 | Equipo comprado | Comercial | 0.000009 |  | n/d | n/d | Masa comercial sin acreditar | BOM y montaje TT10-01; sin plano individual | TT10_C05_BDNB_RODAMIENTO_2.SLDPRT
122 | TT10_C05_BDNB_RODAMIENTO_3 | RodamientoSKF6906; envolvente de montaje; selección de vida separada | 1 | Equipo comprado | Comercial | 0.000009 |  | n/d | n/d | Masa comercial sin acreditar | BOM y montaje TT10-01; sin plano individual | TT10_C05_BDNB_RODAMIENTO_3.SLDPRT
123 | TT10_C05_BDNB_W10 | ArandelaISO7089 M10 | 4 | Arandela endurecida 300 HV / ISO 7089 | Comercial | 4.551382357e-07 | 7850 | 0.004 | 0.014 | Volumen CAD y densidad | BOM y montaje TT10-01; sin plano individual | TT10_C05_BDNB_W10.SLDPRT
124 | TT10_C05_BDNB_W5 | ArandelaDIN433 M5,9x5.3x1 | 4 | Arandela endurecida 300 HV / ISO 7089 | Comercial | 4.155541683e-08 | 7850 | 0.0003262100221 | 0.001 | Volumen CAD y densidad | BOM y montaje TT10-01; sin plano individual | TT10_C05_BDNB_W5.SLDPRT
125 | TT10_C05_BDNB_W6 | ArandelaISO7089 M6 | 8 | Arandela endurecida 300 HV / ISO 7089 | Comercial | 1.294838828e-07 | 7850 | 0.001 | 0.008 | Volumen CAD y densidad | BOM y montaje TT10-01; sin plano individual | TT10_C05_BDNB_W6.SLDPRT
126 | TT10_C05_BLOQUE_SELECTOR | BloqueC03 conservado con4M4laterales para retencion cautiva | 1 | ASTM A36 | Fabricación | 0.000053 | 7850 | 0.417 | 0.417 | CAD_volume_x_specified_density | Plano de conjunto / detalle funcional: TT10-21 | C05E_TT10_C05_BLOQUE_SELECTOR.SLDPRT
127 | TT10_C05_CORREDERA_TENSOR | Corredera comun590x320x20;4ranuras22x62; carrera Y+/-20mm; ambos postes solidarios | 1 | ASTM A36 | Fabricación | 0.003675 | 7850 | 28.852 | 28.852 | CAD_volume_x_specified_density | Plano de conjunto / detalle funcional: TT10-16 | C05E_TT10_C05_CORREDERA_TENSOR.SLDPRT
128 | TT10_C05_GUIA_TENSOR_0 | Guia lateral mecanizada;holgura transversal total0.3..0.5mm; soldar a base fija y mecanizar despues | 1 | ASTM A36 | Fabricación | 0.000142 | 7850 | 1.116 | 1.116 | CAD_volume_x_specified_density | Plano de conjunto / detalle funcional: TT10-16 | C05E_TT10_C05_GUIA_TENSOR_0.SLDPRT
129 | TT10_C05_GUIA_TENSOR_1 | Guia lateral mecanizada;holgura transversal total0.3..0.5mm; soldar a base fija y mecanizar despues | 1 | ASTM A36 | Fabricación | 0.000142 | 7850 | 1.116 | 1.116 | CAD_volume_x_specified_density | Plano de conjunto / detalle funcional: TT10-16 | C05E_TT10_C05_GUIA_TENSOR_1.SLDPRT
130 | TT10_C05_JACK_M16_0_0 | M16x80,8.8 de regulacion; rosca total; punta plana; bloquear con contratuerca | 1 | 8.8 | Comercial | 0.000020 |  | n/d | n/d | OEM_mass_required | BOM y montaje TT10-01; sin plano individual | C05E_TT10_C05_JACK_M16_0_0.SLDPRT
131 | TT10_C05_JACK_M16_0_1 | M16x80,8.8 de regulacion; rosca total; punta plana; bloquear con contratuerca | 1 | 8.8 | Comercial | 0.000020 |  | n/d | n/d | OEM_mass_required | BOM y montaje TT10-01; sin plano individual | C05E_TT10_C05_JACK_M16_0_1.SLDPRT
132 | TT10_C05_JACK_M16_1_0 | M16x80,8.8 de regulacion; rosca total; punta plana; bloquear con contratuerca | 1 | 8.8 | Comercial | 0.000020 |  | n/d | n/d | OEM_mass_required | BOM y montaje TT10-01; sin plano individual | C05E_TT10_C05_JACK_M16_1_0.SLDPRT
133 | TT10_C05_JACK_M16_1_1 | M16x80,8.8 de regulacion; rosca total; punta plana; bloquear con contratuerca | 1 | 8.8 | Comercial | 0.000020 |  | n/d | n/d | OEM_mass_required | BOM y montaje TT10-01; sin plano individual | C05E_TT10_C05_JACK_M16_1_1.SLDPRT
134 | TT10_C05_JAM_M16_0_0 | ContratuercaM16 clase8; mantener ajuste con cuatro M20 apretados | 1 | Tuerca clase 8 / ISO 898-2 | Comercial | 0.000002 | 7850 | 0.014 | 0.014 | CAD_volume_x_specified_density | BOM y montaje TT10-01; sin plano individual | C05E_TT10_C05_JAM_M16_0_0.SLDPRT
135 | TT10_C05_JAM_M16_0_1 | ContratuercaM16 clase8; mantener ajuste con cuatro M20 apretados | 1 | Tuerca clase 8 / ISO 898-2 | Comercial | 0.000002 | 7850 | 0.014 | 0.014 | CAD_volume_x_specified_density | BOM y montaje TT10-01; sin plano individual | C05E_TT10_C05_JAM_M16_0_1.SLDPRT
136 | TT10_C05_JAM_M16_1_0 | ContratuercaM16 clase8; mantener ajuste con cuatro M20 apretados | 1 | Tuerca clase 8 / ISO 898-2 | Comercial | 0.000002 | 7850 | 0.014 | 0.014 | CAD_volume_x_specified_density | BOM y montaje TT10-01; sin plano individual | C05E_TT10_C05_JAM_M16_1_0.SLDPRT
137 | TT10_C05_JAM_M16_1_1 | ContratuercaM16 clase8; mantener ajuste con cuatro M20 apretados | 1 | Tuerca clase 8 / ISO 898-2 | Comercial | 0.000002 | 7850 | 0.014 | 0.014 | CAD_volume_x_specified_density | BOM y montaje TT10-01; sin plano individual | C05E_TT10_C05_JAM_M16_1_1.SLDPRT
138 | TT10_C05_OREJA_TENSOR_0_0 | Oreja36x20x36;M16x2; soldaduraa6 a base fija | 1 | ASTM A36 | Fabricación | 0.000022 | 7850 | 0.172 | 0.172 | CAD_volume_x_specified_density | Plano de conjunto / detalle funcional: TT10-16 | C05E_TT10_C05_OREJA_TENSOR_0_0.SLDPRT
139 | TT10_C05_OREJA_TENSOR_0_1 | Oreja36x20x36;M16x2; soldaduraa6 a base fija | 1 | ASTM A36 | Fabricación | 0.000022 | 7850 | 0.172 | 0.172 | CAD_volume_x_specified_density | Plano de conjunto / detalle funcional: TT10-16 | C05E_TT10_C05_OREJA_TENSOR_0_1.SLDPRT
140 | TT10_C05_OREJA_TENSOR_1_0 | Oreja36x20x36;M16x2; soldaduraa6 a base fija | 1 | ASTM A36 | Fabricación | 0.000022 | 7850 | 0.172 | 0.172 | CAD_volume_x_specified_density | Plano de conjunto / detalle funcional: TT10-16 | C05E_TT10_C05_OREJA_TENSOR_1_0.SLDPRT
141 | TT10_C05_OREJA_TENSOR_1_1 | Oreja36x20x36;M16x2; soldaduraa6 a base fija | 1 | ASTM A36 | Fabricación | 0.000022 | 7850 | 0.172 | 0.172 | CAD_volume_x_specified_density | Plano de conjunto / detalle funcional: TT10-16 | C05E_TT10_C05_OREJA_TENSOR_1_1.SLDPRT
142 | TT10_C05_POSTE_CORTO_TENSOR | RHS50x50x5;L1037.5;recortado20para conservar altura del eje | 1 | S275J0H / EN 10219-1 | Fabricación | 0.000934 | 7850 | 7.330 | 7.330 | CAD_volume_x_specified_density | Plano de conjunto / detalle funcional: TT10-16 | C05E_TT10_C05_POSTE_CORTO_TENSOR.SLDPRT
143 | TT10_C05_POSTE_VOLANTE_TENSOR | Poste del volante recortado20mm; conservar mecanizado superior y centros | 1 | ASTM A36 | Fabricación | 0.002970 | 7850 | 23.316 | 23.316 | CAD_volume_x_specified_density | Plano de conjunto / detalle funcional: TT10-16 | C05E_TT10_C05_POSTE_VOLANTE_TENSOR.SLDPRT
144 | TT10_C05_RETEN_CAUTIVO_SELECTOR | Puente cautivo para pasadorD6;23mm hasta cabeza, permite levantar16mm;4M4 laterales al bloque | 1 | ASTM A36 | Fabricación | 0.000014 | 7850 | 0.112 | 0.112 | CAD_volume_x_specified_density | Plano de conjunto / detalle funcional: TT10-21 | C05E_TT10_C05_RETEN_CAUTIVO_SELECTOR.SLDPRT
145 | TT10_CART_N_INF | Cartela horizontal20 entre puente y placa de nodo | 1 | ASTM A36 | Fabricación | 0.000345 | 7850 | 2.708 | 2.708 | CAD_volume_x_specified_density | Plano de conjunto / detalle funcional: TT10-02 | C05E_TT10_CART_N_INF.SLDPRT
146 | TT10_CART_N_SUP | Cartela horizontal20 entre puente y placa de nodo | 1 | ASTM A36 | Fabricación | 0.000345 | 7850 | 2.708 | 2.708 | CAD_volume_x_specified_density | Plano de conjunto / detalle funcional: TT10-02 | C05E_TT10_CART_N_SUP.SLDPRT
147 | TT10_CART_P_INF | Cartela horizontal20 entre puente y placa de nodo | 1 | ASTM A36 | Fabricación | 0.000345 | 7850 | 2.708 | 2.708 | CAD_volume_x_specified_density | Plano de conjunto / detalle funcional: TT10-02 | C05E_TT10_CART_P_INF.SLDPRT
148 | TT10_CART_P_SUP | Cartela horizontal20 entre puente y placa de nodo | 1 | ASTM A36 | Fabricación | 0.000345 | 7850 | 2.708 | 2.708 | CAD_volume_x_specified_density | Plano de conjunto / detalle funcional: TT10-02 | C05E_TT10_CART_P_SUP.SLDPRT
149 | TT10_COLLAR_N | Casquillo D220/d200.2 L161: transmisión de apriete y pista de sello | 1 | C45E / EN 10083-2 | Fabricación | 0.001052 | 7850 | 8.259 | 8.259 | CAD_volume_x_specified_density | Plano de conjunto / detalle funcional: TT10-09 | C05E_TT10_COLLAR_N.SLDPRT
150 | TT10_COLLAR_P | Casquillo D220/d200.2 L161: transmisión de apriete y pista de sello | 1 | C45E / EN 10083-2 | Fabricación | 0.001052 | 7850 | 8.259 | 8.259 | CAD_volume_x_specified_density | Plano de conjunto / detalle funcional: TT10-09 | C05E_TT10_COLLAR_P.SLDPRT
151 | TT10_D_ACOPLE_SALIDA | Acoplamiento de salida entre cubo y reductor; dibujo nominal | 1 | Equipo comprado | Equipo nominal | 0.005781 |  | n/d | n/d | OEM_mass_required | BOM y montaje TT10-01; sin plano individual | C05E_TT10_D_ACOPLE_SALIDA.SLDPRT
152 | TT10_D_ARMARIO | Armario de variador y control; representación de presentación | 1 | Armario comercial; chapa y acabado según referencia de compra | Comercial | 0.086800 |  | n/d | n/d | OEM_mass_required | BOM y montaje TT10-01; sin plano individual | C05E_TT10_D_ARMARIO.SLDPRT
153 | TT10_D_ARO_RESGUARDO_N | Resguardo tubular desmontable ARO_RESGUARDO_N | 1 | S275J0H / EN 10219-1 | Fabricación | 0.004935 | 7850 | 38.738 | 38.738 | CAD_volume_x_specified_density | Plano de conjunto / detalle funcional: TT10-11 | C05E_TT10_D_ARO_RESGUARDO_N.SLDPRT
154 | TT10_D_ARO_RESGUARDO_P | Resguardo tubular desmontable ARO_RESGUARDO_P | 1 | S275J0H / EN 10219-1 | Fabricación | 0.004935 | 7850 | 38.738 | 38.738 | CAD_volume_x_specified_density | Plano de conjunto / detalle funcional: TT10-11 | C05E_TT10_D_ARO_RESGUARDO_P.SLDPRT
155 | TT10_D_AUX_4_1 | Reducción auxiliar 4:1; representación de arquitectura | 1 | Equipo sustituido por PSN 142 i5; no comprar variante 4:1 | Comercial | 0.028675 |  | n/d | n/d | OEM_mass_required | BOM y montaje TT10-01; sin plano individual | C05E_TT10_D_AUX_4_1.SLDPRT
156 | TT10_D_B16_0 | Perno nominal M16x50 | 32 | Clase 10.9 / ISO 898-1 | Comercial | 0.000015 | 7850 | 0.118 | 3.778 | CAD_volume_x_specified_density | BOM y montaje TT10-01; sin plano individual | C05E_TT10_D_B16_0.SLDPRT
157 | TT10_D_BASE_ARMARIO | Base del armario | 1 | ASTM A36 | Fabricación | 0.001352 | 7850 | 10.613 | 10.613 | CAD_volume_x_specified_density | Plano de conjunto / detalle funcional: TT10-25 | C05E_TT10_D_BASE_ARMARIO.SLDPRT
158 | TT10_D_BASE_BOTONERA | Base de botonera | 1 | ASTM A36 | Fabricación | 0.000648 | 7850 | 5.087 | 5.087 | CAD_volume_x_specified_density | Plano de conjunto / detalle funcional: TT10-25 | C05E_TT10_D_BASE_BOTONERA.SLDPRT
159 | TT10_D_BASE_FRENO_N | Base de pedestal de freno N | 1 | ASTM A36 | Fabricación | 0.001908 | 7850 | 14.978 | 14.978 | CAD_volume_x_specified_density | Plano de conjunto / detalle funcional: TT10-11 | C05E_TT10_D_BASE_FRENO_N.SLDPRT
160 | TT10_D_BASE_FRENO_P | Base de pedestal de freno P | 1 | ASTM A36 | Fabricación | 0.001908 | 7850 | 14.978 | 14.978 | CAD_volume_x_specified_density | Plano de conjunto / detalle funcional: TT10-11 | C05E_TT10_D_BASE_FRENO_P.SLDPRT
161 | TT10_D_BASE_MOTOR | Placa base del segundo apoyo de bancada | 1 | ASTM A36 | Fabricación | 0.005400 | 7850 | 42.390 | 42.390 | CAD_volume_x_specified_density | Plano de conjunto / detalle funcional: TT10-10 | C05E_TT10_D_BASE_MOTOR.SLDPRT
162 | TT10_D_BASE_PRESENTE | Base del mando de hombre presente | 1 | ASTM A36 | Fabricación | 0.000312 | 7850 | 2.449 | 2.449 | CAD_volume_x_specified_density | Plano de conjunto / detalle funcional: TT10-25 | C05E_TT10_D_BASE_PRESENTE.SLDPRT
163 | TT10_D_BASE_RECUP_N | Base de mando de recuperación | 1 | ASTM A36 | Fabricación | 0.000507 | 7850 | 3.980 | 3.980 | CAD_volume_x_specified_density | Plano de conjunto / detalle funcional: TT10-24 | C05E_TT10_D_BASE_RECUP_N.SLDPRT
164 | TT10_D_BASE_RECUP_P | Base de mando de recuperación | 1 | ASTM A36 | Fabricación | 0.000507 | 7850 | 3.980 | 3.980 | CAD_volume_x_specified_density | Plano de conjunto / detalle funcional: TT10-24 | C05E_TT10_D_BASE_RECUP_P.SLDPRT
165 | TT10_D_BLANCO_PIN | Bandera de detección del pasador retirado | 2 | ASTM A36 | Fabricación | 0.000010 | 7850 | 0.078 | 0.155 | CAD_volume_x_specified_density | Plano de conjunto / detalle funcional: TT10-15 | C05E_TT10_D_BLANCO_PIN.SLDPRT
166 | TT10_D_BOTONERA | Botonera: subir, bajar, retorno y paro de emergencia | 1 | Dispositivo de mando comercial; materiales según referencia OEM | Comercial | 0.004560 |  | n/d | n/d | OEM_mass_required | BOM y montaje TT10-01; sin plano individual | C05E_TT10_D_BOTONERA.SLDPRT
167 | TT10_D_BOTON_0 | Pulsador 0 | 1 | Dispositivo de mando comercial; materiales según referencia OEM | Comercial | 0.000038 |  | n/d | n/d | OEM_mass_required | BOM y montaje TT10-01; sin plano individual | C05E_TT10_D_BOTON_0.SLDPRT
168 | TT10_D_BOTON_1 | Pulsador 1 | 1 | Dispositivo de mando comercial; materiales según referencia OEM | Comercial | 0.000038 |  | n/d | n/d | OEM_mass_required | BOM y montaje TT10-01; sin plano individual | C05E_TT10_D_BOTON_1.SLDPRT
169 | TT10_D_BOTON_2 | Pulsador 2 | 1 | Dispositivo de mando comercial; materiales según referencia OEM | Comercial | 0.000038 |  | n/d | n/d | OEM_mass_required | BOM y montaje TT10-01; sin plano individual | C05E_TT10_D_BOTON_2.SLDPRT
170 | TT10_D_CABLE_PESTILLO_FIN_N | Eje de conexión geométrica CABLE_PESTILLO_FIN_N | 1 | Cable/conducción comercial; composición según ficha | Comercial | 0.000027 |  | n/d | n/d | OEM_mass_required | BOM y montaje TT10-01; sin plano individual | C05E_TT10_D_CABLE_PESTILLO_FIN_N.SLDPRT
171 | TT10_D_CABLE_PESTILLO_FIN_P | Eje de conexión geométrica CABLE_PESTILLO_FIN_P | 1 | Cable/conducción comercial; composición según ficha | Comercial | 0.000027 |  | n/d | n/d | OEM_mass_required | BOM y montaje TT10-01; sin plano individual | C05E_TT10_D_CABLE_PESTILLO_FIN_P.SLDPRT
172 | TT10_D_CABLE_PESTILLO_N | Eje de conexión geométrica CABLE_PESTILLO_N | 1 | Cable/conducción comercial; composición según ficha | Comercial | 0.000055 |  | n/d | n/d | OEM_mass_required | BOM y montaje TT10-01; sin plano individual | C05E_TT10_D_CABLE_PESTILLO_N.SLDPRT
173 | TT10_D_CABLE_PESTILLO_P | Eje de conexión geométrica CABLE_PESTILLO_P | 1 | Cable/conducción comercial; composición según ficha | Comercial | 0.000055 |  | n/d | n/d | OEM_mass_required | BOM y montaje TT10-01; sin plano individual | C05E_TT10_D_CABLE_PESTILLO_P.SLDPRT
174 | TT10_D_CABLE_PESTILLO_SUP_N | Eje de conexión geométrica CABLE_PESTILLO_SUP_N | 1 | Cable/conducción comercial; composición según ficha | Comercial | 0.000036 |  | n/d | n/d | OEM_mass_required | BOM y montaje TT10-01; sin plano individual | C05E_TT10_D_CABLE_PESTILLO_SUP_N.SLDPRT
175 | TT10_D_CABLE_PESTILLO_SUP_P | Eje de conexión geométrica CABLE_PESTILLO_SUP_P | 1 | Cable/conducción comercial; composición según ficha | Comercial | 0.000036 |  | n/d | n/d | OEM_mass_required | BOM y montaje TT10-01; sin plano individual | C05E_TT10_D_CABLE_PESTILLO_SUP_P.SLDPRT
176 | TT10_D_CABLE_PRESENTE | Eje de conexión geométrica CABLE_PRESENTE | 1 | Cable/conducción comercial; composición según ficha | Comercial | 0.000018 |  | n/d | n/d | OEM_mass_required | BOM y montaje TT10-01; sin plano individual | C05E_TT10_D_CABLE_PRESENTE.SLDPRT
177 | TT10_D_CARTELA_MOTOR_0 | Apoyo lateral desmontable de bancada | 1 | ASTM A36 | Fabricación | 0.000530 | 7850 | 4.160 | 4.160 | CAD_volume_x_specified_density | Plano de conjunto / detalle funcional: TT10-10 | C05E_TT10_D_CARTELA_MOTOR_0.SLDPRT
178 | TT10_D_CARTELA_MOTOR_1 | Apoyo lateral desmontable de bancada | 1 | ASTM A36 | Fabricación | 0.000530 | 7850 | 4.160 | 4.160 | CAD_volume_x_specified_density | Plano de conjunto / detalle funcional: TT10-10 | C05E_TT10_D_CARTELA_MOTOR_1.SLDPRT
179 | TT10_D_COLUMNA_MOTOR | Columna adicional RHS200x200; asiento sobre placa base | 1 | S275J0H / EN 10219-1 | Fabricación | 0.014136 | 7850 | 110.968 | 110.968 | CAD_volume_x_specified_density | Plano de conjunto / detalle funcional: TT10-10 | C05E_TT10_D_COLUMNA_MOTOR.SLDPRT
180 | TT10_D_CUBO_N | Cubo de conexión por apriete y brida de disco N | 1 | AISI 4140 bonificado | Fabricación | 0.009805 | 7850 | 76.969 | 76.969 | CAD_volume_x_specified_density | Plano de conjunto / detalle funcional: TT10-09 | C05E_TT10_D_CUBO_N.SLDPRT
181 | TT10_D_CUBO_P | Cubo de conexión por apriete y brida de disco P | 1 | AISI 4140 bonificado | Fabricación | 0.009805 | 7850 | 76.969 | 76.969 | CAD_volume_x_specified_density | Plano de conjunto / detalle funcional: TT10-09 | C05E_TT10_D_CUBO_P.SLDPRT
182 | TT10_D_DISCO_N | Disco de freno de salida N; diámetro nominal de dibujo | 1 | Equipo comprado | Equipo nominal | 0.035872 |  | n/d | n/d | OEM_mass_required | BOM y montaje TT10-01; sin plano individual | C05E_TT10_D_DISCO_N.SLDPRT
183 | TT10_D_DISCO_P | Disco de freno de salida P; diámetro nominal de dibujo | 1 | Equipo comprado | Equipo nominal | 0.035872 |  | n/d | n/d | OEM_mass_required | BOM y montaje TT10-01; sin plano individual | C05E_TT10_D_DISCO_P.SLDPRT
184 | TT10_D_ENCODER | Encoder de velocidad en eje motor | 1 | Equipo comprado | Equipo nominal | 0.000414 |  | n/d | n/d | OEM_mass_required | BOM y montaje TT10-01; sin plano individual | C05E_TT10_D_ENCODER.SLDPRT
185 | TT10_D_ENTRADA_REDUCTOR | Eje de conexión geométrica ENTRADA_REDUCTOR | 1 | Equipo comprado; materiales y masa según ficha OEM | Equipo nominal | 0.000128 |  | n/d | n/d | OEM_mass_required | BOM y montaje TT10-01; sin plano individual | C05E_TT10_D_ENTRADA_REDUCTOR.SLDPRT
186 | TT10_D_LIBERACION_FRENO_N | Eje de conexión geométrica LIBERACION_FRENO_N | 1 | Mecanismo OEM Svendborg; incluido en pinza | Comercial | 0.000013 |  | n/d | n/d | OEM_mass_required | BOM y montaje TT10-01; sin plano individual | C05E_TT10_D_LIBERACION_FRENO_N.SLDPRT
187 | TT10_D_LIBERACION_FRENO_P | Eje de conexión geométrica LIBERACION_FRENO_P | 1 | Mecanismo OEM Svendborg; incluido en pinza | Comercial | 0.000013 |  | n/d | n/d | OEM_mass_required | BOM y montaje TT10-01; sin plano individual | C05E_TT10_D_LIBERACION_FRENO_P.SLDPRT
188 | TT10_D_MANDO_PRESENTE | Palanca de hombre presente para liberación manual nominal | 1 | ASTM A36 | Fabricación | 0.000055 | 7850 | 0.432 | 0.432 | CAD_volume_x_specified_density | Plano de conjunto / detalle funcional: TT10-25 | C05E_TT10_D_MANDO_PRESENTE.SLDPRT
189 | TT10_D_MOTOR | Motor eléctrico con encoder; geometría nominal, potencia no seleccionada | 1 | Equipo comprado; materiales y masa según ficha OEM | Equipo nominal | 0.057162 |  | n/d | n/d | OEM_mass_required | BOM y montaje TT10-01; sin plano individual | C05E_TT10_D_MOTOR.SLDPRT
190 | TT10_D_PALANCA_PESTILLO_N | Palanca accesible de recuperación del pestillo por cable | 1 | AISI 4140 bonificado | Fabricación | 0.000060 | 7850 | 0.471 | 0.471 | CAD_volume_x_specified_density | Plano de conjunto / detalle funcional: TT10-14 | C05E_TT10_D_PALANCA_PESTILLO_N.SLDPRT
191 | TT10_D_PALANCA_PESTILLO_P | Palanca accesible de recuperación del pestillo por cable | 1 | AISI 4140 bonificado | Fabricación | 0.000060 | 7850 | 0.471 | 0.471 | CAD_volume_x_specified_density | Plano de conjunto / detalle funcional: TT10-14 | C05E_TT10_D_PALANCA_PESTILLO_P.SLDPRT
192 | TT10_D_PALANCA_SELECTOR | Selector E-0-M a altura accesible; transmisión por varilla | 1 | ASTM A36 | Fabricación | 0.000144 | 7850 | 1.130 | 1.130 | CAD_volume_x_specified_density | Plano de conjunto / detalle funcional: TT10-26 | C05E_TT10_D_PALANCA_SELECTOR.SLDPRT
193 | TT10_D_PASTILLA_N0 | Pastilla de freno; contacto nominal intencional | 1 | Material de fricción OEM Svendborg; según suministro | Comercial | 0.000029 |  | n/d | n/d | OEM_mass_required | BOM y montaje TT10-01; sin plano individual | C05E_TT10_D_PASTILLA_N0.SLDPRT
194 | TT10_D_PASTILLA_N1 | Pastilla de freno; contacto nominal intencional | 1 | Material de fricción OEM Svendborg; según suministro | Comercial | 0.000029 |  | n/d | n/d | OEM_mass_required | BOM y montaje TT10-01; sin plano individual | C05E_TT10_D_PASTILLA_N1.SLDPRT
195 | TT10_D_PASTILLA_P0 | Pastilla de freno; contacto nominal intencional | 1 | Material de fricción OEM Svendborg; según suministro | Comercial | 0.000029 |  | n/d | n/d | OEM_mass_required | BOM y montaje TT10-01; sin plano individual | C05E_TT10_D_PASTILLA_P0.SLDPRT
196 | TT10_D_PASTILLA_P1 | Pastilla de freno; contacto nominal intencional | 1 | Material de fricción OEM Svendborg; según suministro | Comercial | 0.000029 |  | n/d | n/d | OEM_mass_required | BOM y montaje TT10-01; sin plano individual | C05E_TT10_D_PASTILLA_P1.SLDPRT
197 | TT10_D_PEDESTAL_AUX | Pedestal bajo reducción auxiliar | 1 | ASTM A36 | Fabricación | 0.012121 | 7850 | 95.150 | 95.150 | CAD_volume_x_specified_density | Plano de conjunto / detalle funcional: TT10-10 | C05E_TT10_D_PEDESTAL_AUX.SLDPRT
198 | TT10_D_PEDESTAL_MOTOR | Soporte común de pies del motor | 1 | ASTM A36 | Fabricación | 0.028509 | 7850 | 223.796 | 223.796 | CAD_volume_x_specified_density | Plano de conjunto / detalle funcional: TT10-10 | C05E_TT10_D_PEDESTAL_MOTOR.SLDPRT
199 | TT10_D_PINZA_N | Pinza de freno por resorte, liberación eléctrica N; envolvente nominal | 1 | Equipo comprado | Equipo nominal | 0.008551 |  | n/d | n/d | OEM_mass_required | BOM y montaje TT10-01; sin plano individual | C05E_TT10_D_PINZA_N.SLDPRT
200 | TT10_D_PINZA_P | Pinza de freno por resorte, liberación eléctrica P; envolvente nominal | 1 | Equipo comprado | Equipo nominal | 0.008551 |  | n/d | n/d | OEM_mass_required | BOM y montaje TT10-01; sin plano individual | C05E_TT10_D_PINZA_P.SLDPRT
201 | TT10_D_PLATAFORMA | Plataforma ampliada del accionamiento; reemplaza F466 | 1 | ASTM A36 | Fabricación | 0.052458 | 7850 | 411.794 | 411.794 | CAD_volume_x_specified_density | Plano de conjunto / detalle funcional: TT10-10 | C05E_TT10_D_PLATAFORMA.SLDPRT
202 | TT10_D_POSTE_ARMARIO | Soporte de armario | 1 | ASTM A36 | Fabricación | 0.000630 | 7850 | 4.944 | 4.944 | CAD_volume_x_specified_density | Plano de conjunto / detalle funcional: TT10-25 | C05E_TT10_D_POSTE_ARMARIO.SLDPRT
203 | TT10_D_POSTE_BOTONERA | Poste de botonera fuera del plano de giro | 1 | ASTM A36 | Fabricación | 0.001024 | 7850 | 8.036 | 8.036 | CAD_volume_x_specified_density | Plano de conjunto / detalle funcional: TT10-25 | C05E_TT10_D_POSTE_BOTONERA.SLDPRT
204 | TT10_D_POSTE_FRENO_N | Pedestal del freno N | 1 | ASTM A36 | Fabricación | 0.008260 | 7850 | 64.840 | 64.840 | CAD_volume_x_specified_density | Plano de conjunto / detalle funcional: TT10-11 | C05E_TT10_D_POSTE_FRENO_N.SLDPRT
205 | TT10_D_POSTE_FRENO_P | Pedestal del freno P | 1 | ASTM A36 | Fabricación | 0.008260 | 7850 | 64.840 | 64.840 | CAD_volume_x_specified_density | Plano de conjunto / detalle funcional: TT10-11 | C05E_TT10_D_POSTE_FRENO_P.SLDPRT
206 | TT10_D_POSTE_MANDO | Soporte del mando manual fuera del plano del volante | 1 | ASTM A36 | Fabricación | 0.000670 | 7850 | 5.256 | 5.256 | CAD_volume_x_specified_density | Plano de conjunto / detalle funcional: TT10-26 | C05E_TT10_D_POSTE_MANDO.SLDPRT
207 | TT10_D_POSTE_RECUP_N | Soporte de manivela y desbloqueo manual N | 1 | ASTM A36 | Fabricación | 0.000763 | 7850 | 5.986 | 5.986 | CAD_volume_x_specified_density | Plano de conjunto / detalle funcional: TT10-24 | C05E_TT10_D_POSTE_RECUP_N.SLDPRT
208 | TT10_D_POSTE_RECUP_P | Soporte de manivela y desbloqueo manual P | 1 | ASTM A36 | Fabricación | 0.000763 | 7850 | 5.986 | 5.986 | CAD_volume_x_specified_density | Plano de conjunto / detalle funcional: TT10-24 | C05E_TT10_D_POSTE_RECUP_P.SLDPRT
209 | TT10_D_REDUCTOR | Reductor principal angular: carcasa y conexiones nominales | 1 | Equipo comprado; materiales y masa según ficha OEM | Equipo nominal | 0.224109 |  | n/d | n/d | OEM_mass_required | BOM y montaje TT10-01; sin plano individual | C05E_TT10_D_REDUCTOR.SLDPRT
210 | TT10_D_RESORTE_FRENO_N | Paquete de resortes de aplicación del freno N | 1 | Acero de resorte OEM Svendborg; según suministro | Comercial | 0.001460 |  | n/d | n/d | OEM_mass_required | BOM y montaje TT10-01; sin plano individual | C05E_TT10_D_RESORTE_FRENO_N.SLDPRT
211 | TT10_D_RESORTE_FRENO_P | Paquete de resortes de aplicación del freno P | 1 | Acero de resorte OEM Svendborg; según suministro | Comercial | 0.001460 |  | n/d | n/d | OEM_mass_required | BOM y montaje TT10-01; sin plano individual | C05E_TT10_D_RESORTE_FRENO_P.SLDPRT
212 | TT10_D_ROD_SELECTOR | Eje de conexión geométrica ROD_SELECTOR | 1 | ASTM A36 | Fabricación | 0.000255 | 7850 | 2.004 | 2.004 | CAD_volume_x_specified_density | Plano de conjunto / detalle funcional: TT10-26 | C05E_TT10_D_ROD_SELECTOR.SLDPRT
213 | TT10_D_SALIDA_REDUCTOR | Eje de conexión geométrica SALIDA_REDUCTOR | 1 | Equipo comprado; materiales y masa según ficha OEM | Equipo nominal | 0.003142 |  | n/d | n/d | OEM_mass_required | BOM y montaje TT10-01; sin plano individual | C05E_TT10_D_SALIDA_REDUCTOR.SLDPRT
214 | TT10_D_SENSOR_FRENO_N | Eje de conexión geométrica SENSOR_FRENO_N | 1 | Sensor comercial; materiales según referencia OEM | Comercial | 0.000005 |  | n/d | n/d | OEM_mass_required | BOM y montaje TT10-01; sin plano individual | C05E_TT10_D_SENSOR_FRENO_N.SLDPRT
215 | TT10_D_SENSOR_FRENO_P | Eje de conexión geométrica SENSOR_FRENO_P | 1 | Sensor comercial; materiales según referencia OEM | Comercial | 0.000005 |  | n/d | n/d | OEM_mass_required | BOM y montaje TT10-01; sin plano individual | C05E_TT10_D_SENSOR_FRENO_P.SLDPRT
216 | TT10_D_SOPORTE_FRENO_N | Placa de montaje de pinza N | 1 | ASTM A36 | Fabricación | 0.003164 | 7850 | 24.838 | 24.838 | CAD_volume_x_specified_density | Plano de conjunto / detalle funcional: TT10-11 | C05E_TT10_D_SOPORTE_FRENO_N.SLDPRT
217 | TT10_D_SOPORTE_FRENO_P | Placa de montaje de pinza P | 1 | ASTM A36 | Fabricación | 0.003164 | 7850 | 24.838 | 24.838 | CAD_volume_x_specified_density | Plano de conjunto / detalle funcional: TT10-11 | C05E_TT10_D_SOPORTE_FRENO_P.SLDPRT
218 | TT10_F416 | Perfil tubular 350 x 250 x 12; L 600 | 1 | S275J0H / EN 10219-1 | Fabricación | 0.008294 | 7850 | 65.111 | 65.111 | CAD_volume_x_specified_density | Plano de conjunto / detalle funcional: TT10-03 | C05E_TT10_F416.SLDPRT
219 | TT10_F426 | Tope inclinado: cara inferior mecanizada para asiento horizontal | 1 | ASTM A36 | Fabricación | 0.000445 | 7850 | 3.490 | 3.490 | CAD_volume_x_specified_density | Plano de conjunto / detalle funcional: TT10-03 | C05E_TT10_F426.SLDPRT
220 | TT10_F431 | Pieza TT10_F431 | 1 | ASTM A36 | Fabricación | 0.010800 | 7850 | 84.780 | 84.780 | CAD_volume_x_specified_density | Plano de conjunto / detalle funcional: TT10-02 | C05E_TT10_F431.SLDPRT
221 | TT10_F441 | Placa80 con cuatro roscas M30 ciegas60, paso540x140; pernos desde arriba | 1 | ASTM A36 | Fabricación | 0.029270 | 7850 | 229.772 | 229.772 | CAD_volume_x_specified_density | Plano de conjunto / detalle funcional: TT10-02 | C05E_TT10_F441.SLDPRT
222 | TT10_F446 | Placa80 con cuatro roscas M30 ciegas60, paso540x140; pernos desde arriba | 1 | ASTM A36 | Fabricación | 0.029270 | 7850 | 229.772 | 229.772 | CAD_volume_x_specified_density | Plano de conjunto / detalle funcional: TT10-02 | C05E_TT10_F446.SLDPRT
223 | TT10_F451 | Tirante RHS200x150x10; extremos a cara de columna y puente | 1 | S275J0H / EN 10219-1 | Fabricación | 0.005181 | 7850 | 40.671 | 40.671 | CAD_volume_x_specified_density | Plano de conjunto / detalle funcional: TT10-02 | C05E_TT10_F451.SLDPRT
224 | TT10_F456 | SKF SNL3048: dimensiones de interfaz según catálogo; fundición simplificada | 1 | Conjunto comprado; acero/ fundición según OEM | Comercial | 0.030359 |  | 139.000 | 139.000 | SNL 3048 | BOM y montaje TT10-01; sin plano individual | C05E_TT10_F456.SLDPRT
225 | TT10_F471 | Perfil tubular 350 x 200 x 12; L 6300 | 1 | S275J0H / EN 10219-1 | Fabricación | 0.079531 | 7850 | 624.320 | 624.320 | CAD_volume_x_specified_density | Plano de conjunto / detalle funcional: TT10-02 | C05E_TT10_F471.SLDPRT
226 | TT10_F476 | Perfil tubular 350 x 200 x 12; L 6300 | 1 | S275J0H / EN 10219-1 | Fabricación | 0.079531 | 7850 | 624.320 | 624.320 | CAD_volume_x_specified_density | Plano de conjunto / detalle funcional: TT10-02 | C05E_TT10_F476.SLDPRT
227 | TT10_F481 | Pieza TT10_F481 | 1 | ASTM A36 | Fabricación | 0.002520 | 7850 | 19.782 | 19.782 | CAD_volume_x_specified_density | Plano de conjunto / detalle funcional: TT10-02 | C05E_TT10_F481.SLDPRT
228 | TT10_F486 | Oreja fija espesor40, Ø65 H8, mandrinar coaxialmente después de soldar | 1 | ASTM A36 | Fabricación | 0.003867 | 7850 | 30.358 | 30.358 | CAD_volume_x_specified_density | Plano de conjunto / detalle funcional: TT10-03 | C05E_TT10_F486.SLDPRT
229 | TT10_F496 | Pieza TT10_F496 | 1 | ASTM A36 | Fabricación | 0.010125 | 7850 | 79.481 | 79.481 | CAD_volume_x_specified_density | Plano de conjunto / detalle funcional: TT10-02 | C05E_TT10_F496.SLDPRT
230 | TT10_F501 | Oreja fija espesor40, Ø65 H8, mandrinar coaxialmente después de soldar | 1 | ASTM A36 | Fabricación | 0.003867 | 7850 | 30.358 | 30.358 | CAD_volume_x_specified_density | Plano de conjunto / detalle funcional: TT10-03 | C05E_TT10_F501.SLDPRT
231 | TT10_F506 | Perfil tubular 150 x 150 x 10; L 1845 | 1 | S275J0H / EN 10219-1 | Fabricación | 0.010332 | 7850 | 81.106 | 81.106 | CAD_volume_x_specified_density | Plano de conjunto / detalle funcional: TT10-02 | C05E_TT10_F506.SLDPRT
232 | TT10_F511 | Pieza TT10_F511 | 1 | ASTM A36 | Fabricación | 0.008878 | 7850 | 69.691 | 69.691 | CAD_volume_x_specified_density | Plano de conjunto / detalle funcional: TT10-02 | C05E_TT10_F511.SLDPRT
233 | TT10_F516 | Pieza TT10_F516 | 1 | ASTM A36 | Fabricación | 0.008878 | 7850 | 69.691 | 69.691 | CAD_volume_x_specified_density | Plano de conjunto / detalle funcional: TT10-02 | C05E_TT10_F516.SLDPRT
234 | TT10_F521 | Columna accionamiento apoyada sobre placa base | 1 | ASTM A36 | Fabricación | 0.025713 | 7850 | 201.844 | 201.844 | CAD_volume_x_specified_density | Plano de conjunto / detalle funcional: TT10-10 | C05E_TT10_F521.SLDPRT
235 | TT10_F526 | Perfil tubular 350 x 300 x 12; L 4800 | 1 | S275J0H / EN 10219-1 | Fabricación | 0.072115 | 7850 | 566.104 | 566.104 | CAD_volume_x_specified_density | Plano de conjunto / detalle funcional: TT10-02 | C05E_TT10_F526.SLDPRT
236 | TT10_F531 | Perfil tubular 350 x 300 x 12; L 4800 | 1 | S275J0H / EN 10219-1 | Fabricación | 0.072115 | 7850 | 566.104 | 566.104 | CAD_volume_x_specified_density | Plano de conjunto / detalle funcional: TT10-02 | C05E_TT10_F531.SLDPRT
237 | TT10_F536 | Soporte tope terminado en cara interior de columna | 1 | ASTM A36 | Fabricación | 0.001710 | 7850 | 13.424 | 13.424 | CAD_volume_x_specified_density | Plano de conjunto / detalle funcional: TT10-03 | C05E_TT10_F536.SLDPRT
238 | TT10_F541 | Diagonal CHS168.3x10 con cortes de asiento; sin penetrar columnas ni placas | 1 | S275J0H / EN 10219-1 | Fabricación | 0.011768 | 7850 | 92.378 | 92.378 | CAD_volume_x_specified_density | Plano de conjunto / detalle funcional: TT10-02 | C05E_TT10_F541.SLDPRT
239 | TT10_F546 | Puente RHS200x150x10 L1005; fuera del plano de las diagonales | 1 | S275J0H / EN 10219-1 | Fabricación | 0.006633 | 7850 | 52.069 | 52.069 | CAD_volume_x_specified_density | Plano de conjunto / detalle funcional: TT10-02 | C05E_TT10_F546.SLDPRT
240 | TT10_F551 | SKF SNL3048: dimensiones de interfaz según catálogo; fundición simplificada | 1 | Conjunto comprado; acero/ fundición según OEM | Comercial | 0.030359 |  | 139.000 | 139.000 | SNL 3048 | BOM y montaje TT10-01; sin plano individual | C05E_TT10_F551.SLDPRT
241 | TT10_F556 | Soporte tope terminado en cara interior de columna | 1 | ASTM A36 | Fabricación | 0.001710 | 7850 | 13.424 | 13.424 | CAD_volume_x_specified_density | Plano de conjunto / detalle funcional: TT10-03 | C05E_TT10_F556.SLDPRT
242 | TT10_F561 | Pieza TT10_F561 | 1 | ASTM A36 | Fabricación | 0.002520 | 7850 | 19.782 | 19.782 | CAD_volume_x_specified_density | Plano de conjunto / detalle funcional: TT10-02 | C05E_TT10_F561.SLDPRT
243 | TT10_F566 | Pieza TT10_F566 | 1 | ASTM A36 | Fabricación | 0.008878 | 7850 | 69.691 | 69.691 | CAD_volume_x_specified_density | Plano de conjunto / detalle funcional: TT10-02 | C05E_TT10_F566.SLDPRT
244 | TT10_F571 | Pieza TT10_F571 | 1 | ASTM A36 | Fabricación | 0.008878 | 7850 | 69.691 | 69.691 | CAD_volume_x_specified_density | Plano de conjunto / detalle funcional: TT10-02 | C05E_TT10_F571.SLDPRT
245 | TT10_F576 | Oreja fija espesor40, Ø65 H8, mandrinar coaxialmente después de soldar | 1 | ASTM A36 | Fabricación | 0.003867 | 7850 | 30.358 | 30.358 | CAD_volume_x_specified_density | Plano de conjunto / detalle funcional: TT10-03 | C05E_TT10_F576.SLDPRT
246 | TT10_F581 | Diagonal CHS168.3x10 con cortes de asiento; sin penetrar columnas ni placas | 1 | S275J0H / EN 10219-1 | Fabricación | 0.011768 | 7850 | 92.378 | 92.378 | CAD_volume_x_specified_density | Plano de conjunto / detalle funcional: TT10-02 | C05E_TT10_F581.SLDPRT
247 | TT10_F586 | Oreja fija espesor40, Ø65 H8, mandrinar coaxialmente después de soldar | 1 | ASTM A36 | Fabricación | 0.003867 | 7850 | 30.358 | 30.358 | CAD_volume_x_specified_density | Plano de conjunto / detalle funcional: TT10-03 | C05E_TT10_F586.SLDPRT
248 | TT10_F591 | Perfil tubular 350 x 250 x 12; L 600 | 1 | S275J0H / EN 10219-1 | Fabricación | 0.008294 | 7850 | 65.111 | 65.111 | CAD_volume_x_specified_density | Plano de conjunto / detalle funcional: TT10-03 | C05E_TT10_F591.SLDPRT
249 | TT10_F596 | Tope inclinado: cara inferior mecanizada para asiento horizontal | 1 | ASTM A36 | Fabricación | 0.000445 | 7850 | 3.490 | 3.490 | CAD_volume_x_specified_density | Plano de conjunto / detalle funcional: TT10-03 | C05E_TT10_F596.SLDPRT
250 | TT10_F601 | Diagonal CHS168.3x10 con cortes de asiento; sin penetrar columnas ni placas | 1 | S275J0H / EN 10219-1 | Fabricación | 0.011768 | 7850 | 92.378 | 92.378 | CAD_volume_x_specified_density | Plano de conjunto / detalle funcional: TT10-02 | C05E_TT10_F601.SLDPRT
251 | TT10_F606 | Diagonal CHS168.3x10 con cortes de asiento; sin penetrar columnas ni placas | 1 | S275J0H / EN 10219-1 | Fabricación | 0.011768 | 7850 | 92.378 | 92.378 | CAD_volume_x_specified_density | Plano de conjunto / detalle funcional: TT10-02 | C05E_TT10_F606.SLDPRT
252 | TT10_F611 | Perfil tubular 150 x 150 x 10; L 1845 | 1 | S275J0H / EN 10219-1 | Fabricación | 0.010332 | 7850 | 81.106 | 81.106 | CAD_volume_x_specified_density | Plano de conjunto / detalle funcional: TT10-02 | C05E_TT10_F611.SLDPRT
253 | TT10_F616 | Tirante RHS200x150x10; extremos a cara de columna y puente | 1 | S275J0H / EN 10219-1 | Fabricación | 0.005181 | 7850 | 40.671 | 40.671 | CAD_volume_x_specified_density | Plano de conjunto / detalle funcional: TT10-02 | C05E_TT10_F616.SLDPRT
254 | TT10_F621 | Puente RHS200x150x10 L1005; fuera del plano de las diagonales | 1 | S275J0H / EN 10219-1 | Fabricación | 0.006633 | 7850 | 52.069 | 52.069 | CAD_volume_x_specified_density | Plano de conjunto / detalle funcional: TT10-02 | C05E_TT10_F621.SLDPRT
255 | TT10_F626 | Pieza TT10_F626 | 1 | ASTM A36 | Fabricación | 0.008878 | 7850 | 69.691 | 69.691 | CAD_volume_x_specified_density | Plano de conjunto / detalle funcional: TT10-02 | C05E_TT10_F626.SLDPRT
256 | TT10_F631 | Pieza TT10_F631 | 1 | ASTM A36 | Fabricación | 0.008878 | 7850 | 69.691 | 69.691 | CAD_volume_x_specified_density | Plano de conjunto / detalle funcional: TT10-02 | C05E_TT10_F631.SLDPRT
257 | TT10_F636 | Columna principal recortada para placa80 y altura de centro SKF220 | 1 | S355J2; certificado 3.1 requerido | Fabricación | 0.035698 | 7850 | 280.229 | 280.229 | Volumen CAD y densidad de fuente de diseño (7850 kg/m³) | Plano de conjunto / detalle funcional: TT10-02 | C05E_TT10_F636.SLDPRT
258 | TT10_F641 | Columna principal recortada para placa80 y altura de centro SKF220 | 1 | S355J2; certificado 3.1 requerido | Fabricación | 0.035698 | 7850 | 280.229 | 280.229 | Volumen CAD y densidad de fuente de diseño (7850 kg/m³) | Plano de conjunto / detalle funcional: TT10-02 | C05E_TT10_F641.SLDPRT
259 | TT10_F646 | Pieza TT10_F646 | 1 | ASTM A36 | Fabricación | 0.010125 | 7850 | 79.481 | 79.481 | CAD_volume_x_specified_density | Plano de conjunto / detalle funcional: TT10-02 | C05E_TT10_F646.SLDPRT
260 | TT10_FRB_1 | SKF FRB21/360; lado P localizador | 1 | Conjunto comprado; acero/ fundición según OEM | Comercial | 0.000653 |  | n/d | n/d | FRB 21/360 | BOM y montaje TT10-01; sin plano individual | C05E_TT10_FRB_1.SLDPRT
261 | TT10_FRB_2 | SKF FRB21/360; lado P localizador | 1 | Conjunto comprado; acero/ fundición según OEM | Comercial | 0.000653 |  | n/d | n/d | FRB 21/360 | BOM y montaje TT10-01; sin plano individual | C05E_TT10_FRB_2.SLDPRT
262 | TT10_GUIA_N | Guía con alojamiento Ø69 H7; casquillo69/65.5; fuera del camino resistente | 1 | ASTM A36 | Fabricación | 0.001728 | 7850 | 13.567 | 13.567 | CAD_volume_x_specified_density | Plano de conjunto / detalle funcional: TT10-03 | C05E_TT10_GUIA_N.SLDPRT
263 | TT10_GUIA_P | Guía con alojamiento Ø69 H7; casquillo69/65.5; fuera del camino resistente | 1 | ASTM A36 | Fabricación | 0.001728 | 7850 | 13.567 | 13.567 | CAD_volume_x_specified_density | Plano de conjunto / detalle funcional: TT10-03 | C05E_TT10_GUIA_P.SLDPRT
264 | TT10_KM40_N | SKF KM40, M200x3, D250 B29; cuatro ranuras18x8 | 1 | Conjunto comprado; acero/ fundición según OEM | Comercial | 0.000496 |  | 3.350 | 3.350 | KM 40 | BOM y montaje TT10-01; sin plano individual | C05E_TT10_KM40_N.SLDPRT
265 | TT10_KM40_P | SKF KM40, M200x3, D250 B29; cuatro ranuras18x8 | 1 | Conjunto comprado; acero/ fundición según OEM | Comercial | 0.000496 |  | 3.350 | 3.350 | KM 40 | BOM y montaje TT10-01; sin plano individual | C05E_TT10_KM40_P.SLDPRT
266 | TT10_LIN_0_0_B | Tornillo avellanado M16x80, cabeza90 D31, hexágono10; geometría nominal | 32 | Clase 10.9 / ISO 898-1 | Comercial | 0.000017 | 7850 | 0.137 | 4.391 | CAD_volume_x_specified_density | BOM y montaje TT10-01; sin plano individual | C05E_TT10_LIN_0_0_B.SLDPRT
267 | TT10_LIN_0_0_C | Casquillo30/18 L25 limita compresión de elastómero | 32 | Acero C45 | Fabricación | 0.000011 | 7850 | 0.089 | 2.841 | CAD_volume_x_specified_density | Plano de conjunto / detalle funcional: TT10-08 | C05E_TT10_LIN_0_0_C.SLDPRT
268 | TT10_LIN_0_0_N | Tuerca autoblocante metálica M16; rosca simplificada | 32 | Tuerca clase 8 / ISO 898-2 | Comercial | 0.000004 | 7850 | 0.033 | 1.047 | CAD_volume_x_specified_density | BOM y montaje TT10-01; sin plano individual | C05E_TT10_LIN_0_0_N.SLDPRT
269 | TT10_LIN_0_0_W | Arandela M16 200HV D30/d17/t3 | 32 | Arandela endurecida 200 HV / ISO 7089 | Comercial | 0.000001 | 7850 | 0.011 | 0.362 | CAD_volume_x_specified_density | BOM y montaje TT10-01; sin plano individual | C05E_TT10_LIN_0_0_W.SLDPRT
270 | TT10_LK_BC0 | TornilloM6x258.8; cabeza nominal, fijador de rosca y apriete por montaje | 2 | Clase 8.8 / ISO 898-1 | Comercial | 0.000001 | 7850 | 0.009 | 0.018 | CAD_volume_x_specified_density | BOM y montaje TT10-01; sin plano individual | C05E_TT10_LK_BC0.SLDPRT
271 | TT10_LK_BC1 | TornilloM6x258.8; cabeza nominal, fijador de rosca y apriete por montaje | 2 | Clase 8.8 / ISO 898-1 | Comercial | 0.000001 | 7850 | 0.009 | 0.018 | CAD_volume_x_specified_density | BOM y montaje TT10-01; sin plano individual | C05E_TT10_LK_BC1.SLDPRT
272 | TT10_LK_BC2 | TornilloM6x258.8; cabeza nominal, fijador de rosca y apriete por montaje | 2 | Clase 8.8 / ISO 898-1 | Comercial | 0.000001 | 7850 | 0.009 | 0.018 | CAD_volume_x_specified_density | BOM y montaje TT10-01; sin plano individual | C05E_TT10_LK_BC2.SLDPRT
273 | TT10_LK_BC3 | TornilloM6x258.8; cabeza nominal, fijador de rosca y apriete por montaje | 2 | Clase 8.8 / ISO 898-1 | Comercial | 0.000001 | 7850 | 0.009 | 0.018 | CAD_volume_x_specified_density | BOM y montaje TT10-01; sin plano individual | C05E_TT10_LK_BC3.SLDPRT
274 | TT10_LK_BL0 | TornilloM6x908.8; cabeza nominal, fijador de rosca y apriete por montaje | 2 | Clase 8.8 / ISO 898-1 | Comercial | 0.000003 | 7850 | 0.024 | 0.047 | CAD_volume_x_specified_density | BOM y montaje TT10-01; sin plano individual | C05E_TT10_LK_BL0.SLDPRT
275 | TT10_LK_BS0 | TornilloM10x258.8; cabeza nominal, fijador de rosca y apriete por montaje | 2 | Clase 8.8 / ISO 898-1 | Comercial | 0.000004 | 7850 | 0.031 | 0.062 | CAD_volume_x_specified_density | BOM y montaje TT10-01; sin plano individual | C05E_TT10_LK_BS0.SLDPRT
276 | TT10_LK_BS1 | TornilloM10x258.8; cabeza nominal, fijador de rosca y apriete por montaje | 2 | Clase 8.8 / ISO 898-1 | Comercial | 0.000004 | 7850 | 0.031 | 0.062 | CAD_volume_x_specified_density | BOM y montaje TT10-01; sin plano individual | C05E_TT10_LK_BS1.SLDPRT
277 | TT10_LK_BS2 | TornilloM10x258.8; cabeza nominal, fijador de rosca y apriete por montaje | 2 | Clase 8.8 / ISO 898-1 | Comercial | 0.000004 | 7850 | 0.031 | 0.062 | CAD_volume_x_specified_density | BOM y montaje TT10-01; sin plano individual | C05E_TT10_LK_BS2.SLDPRT
278 | TT10_LK_BS3 | TornilloM10x258.8; cabeza nominal, fijador de rosca y apriete por montaje | 2 | Clase 8.8 / ISO 898-1 | Comercial | 0.000004 | 7850 | 0.031 | 0.062 | CAD_volume_x_specified_density | BOM y montaje TT10-01; sin plano individual | C05E_TT10_LK_BS3.SLDPRT
279 | TT10_LK_BSE0 | TornilloISO4762 M6x20 8.8;5.4mm de rosca en guia, fijador y apriete4Nm | 2 | Clase 8.8 / ISO 898-1 | Comercial | 0.000001 | 7850 | 0.008 | 0.016 | CAD_volume_x_specified_density | BOM y montaje TT10-01; sin plano individual | C05E_TT10_LK_BSE0.SLDPRT
280 | TT10_LK_BSE1 | TornilloISO4762 M6x20 8.8;5.4mm de rosca en guia, fijador y apriete4Nm | 2 | Clase 8.8 / ISO 898-1 | Comercial | 0.000001 | 7850 | 0.008 | 0.016 | CAD_volume_x_specified_density | BOM y montaje TT10-01; sin plano individual | C05E_TT10_LK_BSE1.SLDPRT
281 | TT10_LK_GTCA100 | Magnet-Schultz GTCA100X43A02,24V,S1: envolvente e interfaces publicadas; no CAD oficial | 2 | Equipo comercial condicional; polvo desconocido | Comercial | 0.000714 |  | n/d | n/d | OEM_mass_required | BOM y montaje TT10-01; sin plano individual | C05E_TT10_LK_GTCA100.SLDPRT
282 | TT10_LK_GUIA | Pestillo: guia abierta20.4x20.4, brazo25x42, pie80x12; asiento solenoide110/88 | 2 | ASTM A36 | Fabricación | 0.000606 | 7850 | 4.759 | 9.519 | CAD_volume_x_specified_density | Plano de conjunto / detalle funcional: TT10-14 | C05E_TT10_LK_GUIA.SLDPRT
283 | TT10_LK_LAMINA | Resorte de lamina20x1.8, longitud activa330, precarga equivalente50mm; forma instalada; horquillaU R6.5, sin esquina interna recta | 2 | 51CrV4 templado/revenido; Rp0.2≥1000MPa,Rm≥1250MPa; superficie y fatiga por verificar | Fabricación | 0.000012 | 7850 | 0.093 | 0.186 | CAD_volume_x_specified_density | Plano de conjunto / detalle funcional: TT10-14 | C05E_TT10_LK_LAMINA.SLDPRT
284 | TT10_LK_MORDAZA_LAMINA | Mordaza30x20x9.1 para resorte; no soldar ni taladrar zona activa de la lamina | 2 | ASTM A36 | Fabricación | 0.000005 | 7850 | 0.040 | 0.081 | CAD_volume_x_specified_density | Plano de conjunto / detalle funcional: TT10-14 | C05E_TT10_LK_MORDAZA_LAMINA.SLDPRT
285 | TT10_LK_NL0 | TuercaM6clase8, retencion positiva segun montaje | 2 | Tuerca clase 8 / ISO 898-2 | Comercial | 2.916410325e-07 | 7850 | 0.002 | 0.005 | CAD_volume_x_specified_density | BOM y montaje TT10-01; sin plano individual | C05E_TT10_LK_NL0.SLDPRT
286 | TT10_LK_NT | TuercaM6clase8, retencion positiva segun montaje | 2 | Tuerca clase 8 / ISO 898-2 | Comercial | 2.916410325e-07 | 7850 | 0.002 | 0.005 | CAD_volume_x_specified_density | BOM y montaje TT10-01; sin plano individual | C05E_TT10_LK_NT.SLDPRT
287 | TT10_LK_PESTILLO | Pestillo42CrMo4+QT, punta20x20, enganche radial nominal9mm, retirada25mm; M12 liberacion | 2 | AISI 4140 bonificado | Fabricación | 0.000030 | 7850 | 0.232 | 0.463 | CAD_volume_x_specified_density | Plano de conjunto / detalle funcional: TT10-14 | C05E_TT10_LK_PESTILLO.SLDPRT
288 | TT10_LK_SENSOR | ifmIE5338: sensor ordinarioPNP de enganche; M8x1, cara Y22, entrehierro nominal1mm | 2 | Sensor comercial; materiales según referencia OEM | Comercial | 0.000003 |  | n/d | n/d | OEM_mass_required | BOM y montaje TT10-01; sin plano individual | C05E_TT10_LK_SENSOR.SLDPRT
289 | TT10_LK_SOP_SENSOR | Soporte desmontable: sensor a cara real del pestillo; dosM6x20, sin soldar a la guia | 2 | ASTM A36 | Fabricación | 0.000012 | 7850 | 0.097 | 0.194 | CAD_volume_x_specified_density | Plano de conjunto / detalle funcional: TT10-14 | C05E_TT10_LK_SOP_SENSOR.SLDPRT
290 | TT10_LK_TAPA | Tapa de guia desmontable; tornillo de recorrido y fijaciones de tapa pendientes de comprobacion | 2 | Clase 8.8 / ISO 898-1 | Comercial | 0.000039 | 7850 | 0.306 | 0.612 | CAD_volume_x_specified_density | BOM y montaje TT10-01; sin plano individual | C05E_TT10_LK_TAPA.SLDPRT
291 | TT10_LK_TIRANTE | TiranteM12 nominal entre pestillo y solenoide; longitud ajustable, conexion OEM por verificar | 2 | ASTM A36 | Fabricación | 0.000009 | 7850 | 0.067 | 0.135 | CAD_volume_x_specified_density | Plano de conjunto / detalle funcional: TT10-14 | C05E_TT10_LK_TIRANTE.SLDPRT
292 | TT10_LK_TOPE | Tornillo de hombroD8, paso de recorrido; conexion roscada nominal pendiente de detalle | 2 | Clase 10.9 / ISO 898-1 | Comercial | 0.000003 | 7850 | 0.027 | 0.053 | CAD_volume_x_specified_density | BOM y montaje TT10-01; sin plano individual | C05E_TT10_LK_TOPE.SLDPRT
293 | TT10_LK_WC0 | ArandelaD12/d6.4/t1.6 | 2 | Arandela endurecida 300 HV / ISO 7089 | Comercial | 1.294838828e-07 | 7850 | 0.001 | 0.002 | CAD_volume_x_specified_density | BOM y montaje TT10-01; sin plano individual | C05E_TT10_LK_WC0.SLDPRT
294 | TT10_LK_WC1 | ArandelaD12/d6.4/t1.6 | 2 | Arandela endurecida 300 HV / ISO 7089 | Comercial | 1.294838828e-07 | 7850 | 0.001 | 0.002 | CAD_volume_x_specified_density | BOM y montaje TT10-01; sin plano individual | C05E_TT10_LK_WC1.SLDPRT
295 | TT10_LK_WC2 | ArandelaD12/d6.4/t1.6 | 2 | Arandela endurecida 300 HV / ISO 7089 | Comercial | 1.294838828e-07 | 7850 | 0.001 | 0.002 | CAD_volume_x_specified_density | BOM y montaje TT10-01; sin plano individual | C05E_TT10_LK_WC2.SLDPRT
296 | TT10_LK_WC3 | ArandelaD12/d6.4/t1.6 | 2 | Arandela endurecida 300 HV / ISO 7089 | Comercial | 1.294838828e-07 | 7850 | 0.001 | 0.002 | CAD_volume_x_specified_density | BOM y montaje TT10-01; sin plano individual | C05E_TT10_LK_WC3.SLDPRT
297 | TT10_LK_WL0 | ArandelaD12/d6.4/t1.6 | 2 | Arandela endurecida 300 HV / ISO 7089 | Comercial | 1.294838828e-07 | 7850 | 0.001 | 0.002 | CAD_volume_x_specified_density | BOM y montaje TT10-01; sin plano individual | C05E_TT10_LK_WL0.SLDPRT
298 | TT10_LK_WS0 | ArandelaD20/d10.5/t2 | 2 | Arandela endurecida 300 HV / ISO 7089 | Comercial | 4.551382357e-07 | 7850 | 0.004 | 0.007 | CAD_volume_x_specified_density | BOM y montaje TT10-01; sin plano individual | C05E_TT10_LK_WS0.SLDPRT
299 | TT10_LK_WS1 | ArandelaD20/d10.5/t2 | 2 | Arandela endurecida 300 HV / ISO 7089 | Comercial | 4.551382357e-07 | 7850 | 0.004 | 0.007 | CAD_volume_x_specified_density | BOM y montaje TT10-01; sin plano individual | C05E_TT10_LK_WS1.SLDPRT
300 | TT10_LK_WS2 | ArandelaD20/d10.5/t2 | 2 | Arandela endurecida 300 HV / ISO 7089 | Comercial | 4.551382357e-07 | 7850 | 0.004 | 0.007 | CAD_volume_x_specified_density | BOM y montaje TT10-01; sin plano individual | C05E_TT10_LK_WS2.SLDPRT
301 | TT10_LK_WS3 | ArandelaD20/d10.5/t2 | 2 | Arandela endurecida 300 HV / ISO 7089 | Comercial | 4.551382357e-07 | 7850 | 0.004 | 0.007 | CAD_volume_x_specified_density | BOM y montaje TT10-01; sin plano individual | C05E_TT10_LK_WS3.SLDPRT
302 | TT10_LK_WSE0 | ArandelaISO7089 M6 200HV | 2 | Arandela endurecida 200 HV / ISO 7089 | Comercial | 1.294838828e-07 | 7850 | 0.001 | 0.002 | CAD_volume_x_specified_density | BOM y montaje TT10-01; sin plano individual | C05E_TT10_LK_WSE0.SLDPRT
303 | TT10_LK_WSE1 | ArandelaISO7089 M6 200HV | 2 | Arandela endurecida 200 HV / ISO 7089 | Comercial | 1.294838828e-07 | 7850 | 0.001 | 0.002 | CAD_volume_x_specified_density | BOM y montaje TT10-01; sin plano individual | C05E_TT10_LK_WSE1.SLDPRT
304 | TT10_LK_WT | ArandelaD12/d6.4/t1.6 | 2 | Arandela endurecida 300 HV / ISO 7089 | Comercial | 1.294838828e-07 | 7850 | 0.001 | 0.002 | CAD_volume_x_specified_density | BOM y montaje TT10-01; sin plano individual | C05E_TT10_LK_WT.SLDPRT
305 | TT10_M006 | Perfil tubular 200 x 150 x 10; L 2200 | 1 | S275J0H / EN 10219-1 | Fabricación | 0.014520 | 7850 | 113.982 | 113.982 | CAD_volume_x_specified_density | Plano de conjunto / detalle funcional: TT10-05 | C05E_TT10_M006.SLDPRT
306 | TT10_M011 | Perfil tubular 200 x 150 x 10; L 2200 | 1 | S275J0H / EN 10219-1 | Fabricación | 0.014520 | 7850 | 113.982 | 113.982 | CAD_volume_x_specified_density | Plano de conjunto / detalle funcional: TT10-05 | C05E_TT10_M011.SLDPRT
307 | TT10_M016 | Perfil tubular 150 x 100 x 8; L 4800 | 1 | S275J0H / EN 10219-1 | Fabricación | 0.017971 | 7850 | 141.074 | 141.074 | CAD_volume_x_specified_density | Plano de conjunto / detalle funcional: TT10-05 | C05E_TT10_M016.SLDPRT
308 | TT10_M021 | Perfil tubular 200 x 150 x 10; L 2200 | 1 | S275J0H / EN 10219-1 | Fabricación | 0.014520 | 7850 | 113.982 | 113.982 | CAD_volume_x_specified_density | Plano de conjunto / detalle funcional: TT10-05 | C05E_TT10_M021.SLDPRT
309 | TT10_M026 | Perfil tubular 150 x 100 x 8; L 3600 | 1 | S275J0H / EN 10219-1 | Fabricación | 0.013478 | 7850 | 105.805 | 105.805 | CAD_volume_x_specified_density | Plano de conjunto / detalle funcional: TT10-05 | C05E_TT10_M026.SLDPRT
310 | TT10_M031 | Pieza TT10_M031 | 1 | ASTM A36 | Fabricación | 0.002332 | 7850 | 18.304 | 18.304 | CAD_volume_x_specified_density | Plano de conjunto / detalle funcional: TT10-07 | C05E_TT10_M031.SLDPRT
311 | TT10_M036 | Pieza TT10_M036 | 1 | ASTM A36 | Fabricación | 0.002304 | 7850 | 18.086 | 18.086 | CAD_volume_x_specified_density | Plano de conjunto / detalle funcional: TT10-06 | C05E_TT10_M036.SLDPRT
312 | TT10_M041 | Perfil tubular 200 x 150 x 10; L 2200 | 1 | S275J0H / EN 10219-1 | Fabricación | 0.014520 | 7850 | 113.982 | 113.982 | CAD_volume_x_specified_density | Plano de conjunto / detalle funcional: TT10-05 | C05E_TT10_M041.SLDPRT
313 | TT10_M046 | Perfil tubular 400 x 200 x 16; L 5600 | 1 | S275J0H / EN 10219-1 | Fabricación | 0.101786 | 7850 | 799.017 | 799.017 | CAD_volume_x_specified_density | Plano de conjunto / detalle funcional: TT10-05 | C05E_TT10_M046.SLDPRT
314 | TT10_M051 | Pieza TT10_M051 | 1 | ASTM A36 | Fabricación | 0.002308 | 7850 | 18.117 | 18.117 | CAD_volume_x_specified_density | Plano de conjunto / detalle funcional: TT10-07 | C05E_TT10_M051.SLDPRT
315 | TT10_M056 | Cama elastomérica25 perforada para casquillos limitadores | 1 | Elastómero; curva dinámica de compresión por definir | Fabricación | 0.041631 | 1150 | 47.876 | 47.876 | CAD_volume_x_specified_density | Plano de conjunto / detalle funcional: TT10-08 | C05E_TT10_M056.SLDPRT
316 | TT10_M061 | Pieza TT10_M061 | 1 | ASTM A36 | Fabricación | 0.002461 | 7850 | 19.317 | 19.317 | CAD_volume_x_specified_density | Plano de conjunto / detalle funcional: TT10-06 | C05E_TT10_M061.SLDPRT
317 | TT10_M066 | Pieza TT10_M066 | 1 | ASTM A36 | Fabricación | 0.002339 | 7850 | 18.363 | 18.363 | CAD_volume_x_specified_density | Plano de conjunto / detalle funcional: TT10-06 | C05E_TT10_M066.SLDPRT
318 | TT10_M071 | Pieza TT10_M071 | 1 | ASTM A36 | Fabricación | 0.002304 | 7850 | 18.086 | 18.086 | CAD_volume_x_specified_density | Plano de conjunto / detalle funcional: TT10-07 | C05E_TT10_M071.SLDPRT
319 | TT10_M076 | Muñón forjado integral con brida550, hombro220, asiento200, R3 y retención exterior | 1 | AISI 4140 bonificado | Fabricación | 0.040373 | 7850 | 316.925 | 316.925 | CAD_volume_x_specified_density | Plano de conjunto / detalle funcional: TT10-09 | C05E_TT10_M076.SLDPRT
320 | TT10_M081 | Pieza TT10_M081 | 1 | ASTM A36 | Fabricación | 0.002375 | 7850 | 18.642 | 18.642 | CAD_volume_x_specified_density | Plano de conjunto / detalle funcional: TT10-07 | C05E_TT10_M081.SLDPRT
321 | TT10_M086 | Muñón forjado integral con brida550, hombro220, asiento200, R3 y retención exterior | 1 | AISI 4140 bonificado | Fabricación | 0.040373 | 7850 | 316.925 | 316.925 | CAD_volume_x_specified_density | Plano de conjunto / detalle funcional: TT10-09 | C05E_TT10_M086.SLDPRT
322 | TT10_M091 | Pieza TT10_M091 | 1 | ASTM A36 | Fabricación | 0.002339 | 7850 | 18.363 | 18.363 | CAD_volume_x_specified_density | Plano de conjunto / detalle funcional: TT10-06 | C05E_TT10_M091.SLDPRT
323 | TT10_M096 | Pieza TT10_M096 | 1 | ASTM A36 | Fabricación | 0.002308 | 7850 | 18.117 | 18.117 | CAD_volume_x_specified_density | Plano de conjunto / detalle funcional: TT10-07 | C05E_TT10_M096.SLDPRT
324 | TT10_M101 | Perfil tubular 200 x 100 x 10; L 250 | 1 | S275J0H / EN 10219-1 | Fabricación | 0.001400 | 7850 | 10.990 | 10.990 | CAD_volume_x_specified_density | Plano de conjunto / detalle funcional: TT10-05 | C05E_TT10_M101.SLDPRT
325 | TT10_M106 | Contraplaca80 con doce M30 ciegas78 PCD450, apriete desde exterior | 1 | ASTM A36 | Fabricación | 0.025625 | 7850 | 201.157 | 201.157 | CAD_volume_x_specified_density | Plano de conjunto / detalle funcional: TT10-09 | C05E_TT10_M106.SLDPRT
326 | TT10_M111 | Pieza TT10_M111 | 1 | ASTM A36 | Fabricación | 0.002310 | 7850 | 18.136 | 18.136 | CAD_volume_x_specified_density | Plano de conjunto / detalle funcional: TT10-06 | C05E_TT10_M111.SLDPRT
327 | TT10_M116 | Pieza TT10_M116 | 1 | ASTM A36 | Fabricación | 0.002310 | 7850 | 18.136 | 18.136 | CAD_volume_x_specified_density | Plano de conjunto / detalle funcional: TT10-06 | C05E_TT10_M116.SLDPRT
328 | TT10_M121 | Pieza TT10_M121 | 1 | ASTM A36 | Fabricación | 0.003125 | 7850 | 24.531 | 24.531 | CAD_volume_x_specified_density | Plano de conjunto / detalle funcional: TT10-05 | C05E_TT10_M121.SLDPRT
329 | TT10_M131 | Perfil tubular 200 x 200 x 12; L 1200 | 1 | S275J0H / EN 10219-1 | Fabricación | 0.010829 | 7850 | 85.006 | 85.006 | CAD_volume_x_specified_density | Plano de conjunto / detalle funcional: TT10-05 | C05E_TT10_M131.SLDPRT
330 | TT10_M136 | Pieza TT10_M136 | 1 | ASTM A36 | Fabricación | 0.002375 | 7850 | 18.642 | 18.642 | CAD_volume_x_specified_density | Plano de conjunto / detalle funcional: TT10-07 | C05E_TT10_M136.SLDPRT
331 | TT10_M141 | Pieza TT10_M141 | 1 | ASTM A36 | Fabricación | 0.002390 | 7850 | 18.761 | 18.761 | CAD_volume_x_specified_density | Plano de conjunto / detalle funcional: TT10-06 | C05E_TT10_M141.SLDPRT
332 | TT10_M146 | Pieza TT10_M146 | 1 | ASTM A36 | Fabricación | 0.002339 | 7850 | 18.363 | 18.363 | CAD_volume_x_specified_density | Plano de conjunto / detalle funcional: TT10-06 | C05E_TT10_M146.SLDPRT
333 | TT10_M151 | Pieza TT10_M151 | 1 | ASTM A36 | Fabricación | 0.003125 | 7850 | 24.531 | 24.531 | CAD_volume_x_specified_density | Plano de conjunto / detalle funcional: TT10-05 | C05E_TT10_M151.SLDPRT
334 | TT10_M156 | Oreja móvil espesor50, taladro Ø65.5 H9; radio de bloqueo900 | 1 | ASTM A36 | Fabricación | 0.002957 | 7850 | 23.209 | 23.209 | CAD_volume_x_specified_density | Plano de conjunto / detalle funcional: TT10-05 | C05E_TT10_M156.SLDPRT
335 | TT10_M161 | Pieza TT10_M161 | 1 | ASTM A36 | Fabricación | 0.019259 | 7850 | 151.182 | 151.182 | CAD_volume_x_specified_density | Plano de conjunto / detalle funcional: TT10-05 | C05E_TT10_M161.SLDPRT
336 | TT10_M166 | Perfil tubular 150 x 100 x 8; L 4800 | 1 | S275J0H / EN 10219-1 | Fabricación | 0.017971 | 7850 | 141.074 | 141.074 | CAD_volume_x_specified_density | Plano de conjunto / detalle funcional: TT10-05 | C05E_TT10_M166.SLDPRT
337 | TT10_M171 | Pieza TT10_M171 | 1 | ASTM A36 | Fabricación | 0.002308 | 7850 | 18.117 | 18.117 | CAD_volume_x_specified_density | Plano de conjunto / detalle funcional: TT10-07 | C05E_TT10_M171.SLDPRT
338 | TT10_M176 | Fondo16 con taladros de revestimientos desmontables | 1 | ASTM A36 | Fabricación | 0.112510 | 7850 | 883.201 | 883.201 | CAD_volume_x_specified_density | Plano de conjunto / detalle funcional: TT10-07 | C05E_TT10_M176.SLDPRT
339 | TT10_M181 | Pieza TT10_M181 | 1 | ASTM A36 | Fabricación | 0.002375 | 7850 | 18.642 | 18.642 | CAD_volume_x_specified_density | Plano de conjunto / detalle funcional: TT10-07 | C05E_TT10_M181.SLDPRT
340 | TT10_M186 | Perfil tubular 200 x 150 x 10; L 2200 | 1 | S275J0H / EN 10219-1 | Fabricación | 0.014520 | 7850 | 113.982 | 113.982 | CAD_volume_x_specified_density | Plano de conjunto / detalle funcional: TT10-05 | C05E_TT10_M186.SLDPRT
341 | TT10_M191 | Pieza TT10_M191 | 1 | ASTM A36 | Fabricación | 0.014527 | 7850 | 114.035 | 114.035 | CAD_volume_x_specified_density | Plano de conjunto / detalle funcional: TT10-05 | C05E_TT10_M191.SLDPRT
342 | TT10_M196 | Pieza TT10_M196 | 1 | ASTM A36 | Fabricación | 0.068734 | 7850 | 539.563 | 539.563 | CAD_volume_x_specified_density | Plano de conjunto / detalle funcional: TT10-06 | C05E_TT10_M196.SLDPRT
343 | TT10_M201 | Perfil tubular 200 x 200 x 12; L 1200 | 1 | S275J0H / EN 10219-1 | Fabricación | 0.010829 | 7850 | 85.006 | 85.006 | CAD_volume_x_specified_density | Plano de conjunto / detalle funcional: TT10-05 | C05E_TT10_M201.SLDPRT
344 | TT10_M206 | Pieza TT10_M206 | 1 | ASTM A36 | Fabricación | 0.030159 | 7850 | 236.750 | 236.750 | CAD_volume_x_specified_density | Plano de conjunto / detalle funcional: TT10-05 | C05E_TT10_M206.SLDPRT
345 | TT10_M211 | Cama elastomérica25 perforada para casquillos limitadores | 1 | Elastómero; curva dinámica de compresión por definir | Fabricación | 0.041631 | 1150 | 47.876 | 47.876 | CAD_volume_x_specified_density | Plano de conjunto / detalle funcional: TT10-08 | C05E_TT10_M211.SLDPRT
346 | TT10_M216 | Pieza TT10_M216 | 1 | ASTM A36 | Fabricación | 0.002304 | 7850 | 18.086 | 18.086 | CAD_volume_x_specified_density | Plano de conjunto / detalle funcional: TT10-07 | C05E_TT10_M216.SLDPRT
347 | TT10_M221 | Cama elastomérica25 perforada para casquillos limitadores | 1 | Elastómero; curva dinámica de compresión por definir | Fabricación | 0.041631 | 1150 | 47.876 | 47.876 | CAD_volume_x_specified_density | Plano de conjunto / detalle funcional: TT10-08 | C05E_TT10_M221.SLDPRT
348 | TT10_M226 | Perfil tubular 200 x 150 x 10; L 2200 | 1 | S275J0H / EN 10219-1 | Fabricación | 0.014520 | 7850 | 113.982 | 113.982 | CAD_volume_x_specified_density | Plano de conjunto / detalle funcional: TT10-05 | C05E_TT10_M226.SLDPRT
349 | TT10_M231 | Pieza TT10_M231 | 1 | ASTM A36 | Fabricación | 0.002390 | 7850 | 18.761 | 18.761 | CAD_volume_x_specified_density | Plano de conjunto / detalle funcional: TT10-06 | C05E_TT10_M231.SLDPRT
350 | TT10_M236 | Perfil tubular 150 x 100 x 8; L 3600 | 1 | S275J0H / EN 10219-1 | Fabricación | 0.013478 | 7850 | 105.805 | 105.805 | CAD_volume_x_specified_density | Plano de conjunto / detalle funcional: TT10-05 | C05E_TT10_M236.SLDPRT
351 | TT10_M241 | Cama elastomérica25 perforada para casquillos limitadores | 1 | Elastómero; curva dinámica de compresión por definir | Fabricación | 0.041631 | 1150 | 47.876 | 47.876 | CAD_volume_x_specified_density | Plano de conjunto / detalle funcional: TT10-08 | C05E_TT10_M241.SLDPRT
352 | TT10_M246 | Pieza TT10_M246 | 1 | ASTM A36 | Fabricación | 0.002332 | 7850 | 18.304 | 18.304 | CAD_volume_x_specified_density | Plano de conjunto / detalle funcional: TT10-07 | C05E_TT10_M246.SLDPRT
353 | TT10_M251 | Pieza TT10_M251 | 1 | ASTM A36 | Fabricación | 0.002375 | 7850 | 18.642 | 18.642 | CAD_volume_x_specified_density | Plano de conjunto / detalle funcional: TT10-07 | C05E_TT10_M251.SLDPRT
354 | TT10_M256 | Revestimiento AR400 t12 con ocho M16 avellanados desmontables | 1 | Hardox 400 | Fabricación | 0.020010 | 7850 | 157.079 | 157.079 | CAD_volume_x_specified_density | Plano de conjunto / detalle funcional: TT10-08 | C05E_TT10_M256.SLDPRT
355 | TT10_M261 | Pieza TT10_M261 | 1 | ASTM A36 | Fabricación | 0.001875 | 7850 | 14.719 | 14.719 | CAD_volume_x_specified_density | Plano de conjunto / detalle funcional: TT10-05 | C05E_TT10_M261.SLDPRT
356 | TT10_M266 | Revestimiento AR400 t12 con ocho M16 avellanados desmontables | 1 | Hardox 400 | Fabricación | 0.020010 | 7850 | 157.079 | 157.079 | CAD_volume_x_specified_density | Plano de conjunto / detalle funcional: TT10-08 | C05E_TT10_M266.SLDPRT
357 | TT10_M271 | Pieza TT10_M271 | 1 | ASTM A36 | Fabricación | 0.000625 | 7850 | 4.906 | 4.906 | CAD_volume_x_specified_density | Plano de conjunto / detalle funcional: TT10-05 | C05E_TT10_M271.SLDPRT
358 | TT10_M276 | Puente extendido 300 mm para bloqueo radio900 | 1 | ASTM A36 | Fabricación | 0.006875 | 7850 | 53.969 | 53.969 | CAD_volume_x_specified_density | Plano de conjunto / detalle funcional: TT10-05 | C05E_TT10_M276.SLDPRT
359 | TT10_M281 | Pieza TT10_M281 | 1 | ASTM A36 | Fabricación | 0.002390 | 7850 | 18.761 | 18.761 | CAD_volume_x_specified_density | Plano de conjunto / detalle funcional: TT10-06 | C05E_TT10_M281.SLDPRT
360 | TT10_M286 | Pieza TT10_M286 | 1 | ASTM A36 | Fabricación | 0.002461 | 7850 | 19.317 | 19.317 | CAD_volume_x_specified_density | Plano de conjunto / detalle funcional: TT10-06 | C05E_TT10_M286.SLDPRT
361 | TT10_M291 | Pieza TT10_M291 | 1 | ASTM A36 | Fabricación | 0.002308 | 7850 | 18.117 | 18.117 | CAD_volume_x_specified_density | Plano de conjunto / detalle funcional: TT10-07 | C05E_TT10_M291.SLDPRT
362 | TT10_M296 | Pieza TT10_M296 | 1 | ASTM A36 | Fabricación | 0.002310 | 7850 | 18.136 | 18.136 | CAD_volume_x_specified_density | Plano de conjunto / detalle funcional: TT10-06 | C05E_TT10_M296.SLDPRT
363 | TT10_M301 | Pieza TT10_M301 | 1 | ASTM A36 | Fabricación | 0.002461 | 7850 | 19.317 | 19.317 | CAD_volume_x_specified_density | Plano de conjunto / detalle funcional: TT10-06 | C05E_TT10_M301.SLDPRT
364 | TT10_M306 | Oreja móvil espesor50, taladro Ø65.5 H9; radio de bloqueo900 | 1 | ASTM A36 | Fabricación | 0.002957 | 7850 | 23.209 | 23.209 | CAD_volume_x_specified_density | Plano de conjunto / detalle funcional: TT10-05 | C05E_TT10_M306.SLDPRT
365 | TT10_M311 | Pieza TT10_M311 | 1 | ASTM A36 | Fabricación | 0.019259 | 7850 | 151.182 | 151.182 | CAD_volume_x_specified_density | Plano de conjunto / detalle funcional: TT10-05 | C05E_TT10_M311.SLDPRT
366 | TT10_M316 | Pieza TT10_M316 | 1 | ASTM A36 | Fabricación | 0.002390 | 7850 | 18.761 | 18.761 | CAD_volume_x_specified_density | Plano de conjunto / detalle funcional: TT10-06 | C05E_TT10_M316.SLDPRT
367 | TT10_M326 | Pieza TT10_M326 | 1 | ASTM A36 | Fabricación | 0.068734 | 7850 | 539.563 | 539.563 | CAD_volume_x_specified_density | Plano de conjunto / detalle funcional: TT10-06 | C05E_TT10_M326.SLDPRT
368 | TT10_M331 | Pieza TT10_M331 | 1 | ASTM A36 | Fabricación | 0.002304 | 7850 | 18.086 | 18.086 | CAD_volume_x_specified_density | Plano de conjunto / detalle funcional: TT10-06 | C05E_TT10_M331.SLDPRT
369 | TT10_M336 | Perfil tubular 200 x 100 x 10; L 250 | 1 | S275J0H / EN 10219-1 | Fabricación | 0.001400 | 7850 | 10.990 | 10.990 | CAD_volume_x_specified_density | Plano de conjunto / detalle funcional: TT10-05 | C05E_TT10_M336.SLDPRT
370 | TT10_M341 | Pieza TT10_M341 | 1 | ASTM A36 | Fabricación | 0.002310 | 7850 | 18.136 | 18.136 | CAD_volume_x_specified_density | Plano de conjunto / detalle funcional: TT10-06 | C05E_TT10_M341.SLDPRT
371 | TT10_M346 | Pieza TT10_M346 | 1 | ASTM A36 | Fabricación | 0.002339 | 7850 | 18.363 | 18.363 | CAD_volume_x_specified_density | Plano de conjunto / detalle funcional: TT10-06 | C05E_TT10_M346.SLDPRT
372 | TT10_M351 | Puente extendido 300 mm para bloqueo radio900 | 1 | ASTM A36 | Fabricación | 0.006875 | 7850 | 53.969 | 53.969 | CAD_volume_x_specified_density | Plano de conjunto / detalle funcional: TT10-05 | C05E_TT10_M351.SLDPRT
373 | TT10_M356 | Perfil tubular 400 x 200 x 16; L 5600 | 1 | S275J0H / EN 10219-1 | Fabricación | 0.101786 | 7850 | 799.017 | 799.017 | CAD_volume_x_specified_density | Plano de conjunto / detalle funcional: TT10-05 | C05E_TT10_M356.SLDPRT
374 | TT10_M361 | Pieza TT10_M361 | 1 | ASTM A36 | Fabricación | 0.002332 | 7850 | 18.304 | 18.304 | CAD_volume_x_specified_density | Plano de conjunto / detalle funcional: TT10-07 | C05E_TT10_M361.SLDPRT
375 | TT10_M366 | Pieza TT10_M366 | 1 | ASTM A36 | Fabricación | 0.000625 | 7850 | 4.906 | 4.906 | CAD_volume_x_specified_density | Plano de conjunto / detalle funcional: TT10-05 | C05E_TT10_M366.SLDPRT
376 | TT10_M371 | Pieza TT10_M371 | 1 | ASTM A36 | Fabricación | 0.001875 | 7850 | 14.719 | 14.719 | CAD_volume_x_specified_density | Plano de conjunto / detalle funcional: TT10-05 | C05E_TT10_M371.SLDPRT
377 | TT10_M376 | Contraplaca80 con doce M30 ciegas78 PCD450, apriete desde exterior | 1 | ASTM A36 | Fabricación | 0.025625 | 7850 | 201.157 | 201.157 | CAD_volume_x_specified_density | Plano de conjunto / detalle funcional: TT10-09 | C05E_TT10_M376.SLDPRT
378 | TT10_M381 | Perfil tubular 200 x 150 x 10; L 2200 | 1 | S275J0H / EN 10219-1 | Fabricación | 0.014520 | 7850 | 113.982 | 113.982 | CAD_volume_x_specified_density | Plano de conjunto / detalle funcional: TT10-05 | C05E_TT10_M381.SLDPRT
379 | TT10_M386 | Revestimiento AR400 t12 con ocho M16 avellanados desmontables | 1 | Hardox 400 | Fabricación | 0.020010 | 7850 | 157.079 | 157.079 | CAD_volume_x_specified_density | Plano de conjunto / detalle funcional: TT10-08 | C05E_TT10_M386.SLDPRT
380 | TT10_M391 | Revestimiento AR400 t12 con ocho M16 avellanados desmontables | 1 | Hardox 400 | Fabricación | 0.020010 | 7850 | 157.079 | 157.079 | CAD_volume_x_specified_density | Plano de conjunto / detalle funcional: TT10-08 | C05E_TT10_M391.SLDPRT
381 | TT10_M396 | Pieza TT10_M396 | 1 | ASTM A36 | Fabricación | 0.002461 | 7850 | 19.317 | 19.317 | CAD_volume_x_specified_density | Plano de conjunto / detalle funcional: TT10-06 | C05E_TT10_M396.SLDPRT
382 | TT10_M401 | Pieza TT10_M401 | 1 | ASTM A36 | Fabricación | 0.050088 | 7850 | 393.190 | 393.190 | CAD_volume_x_specified_density | Plano de conjunto / detalle funcional: TT10-07 | C05E_TT10_M401.SLDPRT
383 | TT10_M406 | Pieza TT10_M406 | 1 | ASTM A36 | Fabricación | 0.002332 | 7850 | 18.304 | 18.304 | CAD_volume_x_specified_density | Plano de conjunto / detalle funcional: TT10-07 | C05E_TT10_M406.SLDPRT
384 | TT10_M411 | Pieza TT10_M411 | 1 | ASTM A36 | Fabricación | 0.050088 | 7850 | 393.190 | 393.190 | CAD_volume_x_specified_density | Plano de conjunto / detalle funcional: TT10-07 | C05E_TT10_M411.SLDPRT
385 | TT10_MB40_N | MB40 comprada: una pestana plegada nominal en KM40; restantes18 planas | 1 | Acero arandela comercial Timken MB40; variante a confirmar | Comercial | 0.000037 |  | 0.280 | 0.280 | MB40 | BOM y montaje TT10-01; sin plano individual | C05E_TT10_MB40_N.SLDPRT
386 | TT10_MB40_P | MB40 comprada: una pestana plegada nominal en KM40; restantes18 planas | 1 | Acero arandela comercial Timken MB40; variante a confirmar | Comercial | 0.000037 |  | 0.280 | 0.280 | MB40 | BOM y montaje TT10-01; sin plano individual | C05E_TT10_MB40_P.SLDPRT
387 | TT10_N20_P1I | Tuerca M20 clase8; rosca simplificada | 16 | Tuerca clase 8 / ISO 898-2 | Comercial | 0.000007 | 7850 | 0.058 | 0.935 | CAD_volume_x_specified_density | BOM y montaje TT10-01; sin plano individual | C05E_TT10_N20_P1I.SLDPRT
388 | TT10_NODO_N | Placa de nodo20: unión entre puente desplazado y columna principal | 1 | ASTM A36 | Fabricación | 0.002175 | 7850 | 17.074 | 17.074 | CAD_volume_x_specified_density | Plano de conjunto / detalle funcional: TT10-02 | C05E_TT10_NODO_N.SLDPRT
389 | TT10_NODO_P | Placa de nodo20: unión entre puente desplazado y columna principal | 1 | ASTM A36 | Fabricación | 0.002175 | 7850 | 17.074 | 17.074 | CAD_volume_x_specified_density | Plano de conjunto / detalle funcional: TT10-02 | C05E_TT10_NODO_P.SLDPRT
390 | TT10_PE_ACT_CUERPO | Thomson HD24B026-0250LPS2MMSD: interfaces nominales y envolvente conservadora, NO CAD oficial | 2 | Conjunto comercial; selección condicionada | Comercial | 0.003286 |  | n/d | n/d | OEM_mass_required | BOM y montaje TT10-01; sin plano individual | C05E_TT10_PE_ACT_CUERPO.SLDPRT
391 | TT10_PE_ACT_VASTAGO | Extremo y vástago comercial nominal D30.2; taladro12.2; parte móvil de candidato Thomson | 2 | Subcomponente de actuador comercial | Comercial | 0.000185 |  | n/d | n/d | OEM_mass_required | BOM y montaje TT10-01; sin plano individual | C05E_TT10_PE_ACT_VASTAGO.SLDPRT
392 | TT10_PE_BA0 | Tornillo M8x40 clase8.8, rosca nominal; fijador de rosca según montaje | 2 | Clase 8.8 / ISO 898-1 | Comercial | 0.000003 | 7850 | 0.023 | 0.046 | CAD_volume_x_specified_density | BOM y montaje TT10-01; sin plano individual | C05E_TT10_PE_BA0.SLDPRT
393 | TT10_PE_BA1 | Tornillo M8x40 clase8.8, rosca nominal; fijador de rosca según montaje | 2 | Clase 8.8 / ISO 898-1 | Comercial | 0.000003 | 7850 | 0.023 | 0.046 | CAD_volume_x_specified_density | BOM y montaje TT10-01; sin plano individual | C05E_TT10_PE_BA1.SLDPRT
394 | TT10_PE_BA2 | Tornillo M8x40 clase8.8, rosca nominal; fijador de rosca según montaje | 2 | Clase 8.8 / ISO 898-1 | Comercial | 0.000003 | 7850 | 0.023 | 0.046 | CAD_volume_x_specified_density | BOM y montaje TT10-01; sin plano individual | C05E_TT10_PE_BA2.SLDPRT
395 | TT10_PE_BA3 | Tornillo M8x40 clase8.8, rosca nominal; fijador de rosca según montaje | 2 | Clase 8.8 / ISO 898-1 | Comercial | 0.000003 | 7850 | 0.023 | 0.046 | CAD_volume_x_specified_density | BOM y montaje TT10-01; sin plano individual | C05E_TT10_PE_BA3.SLDPRT
396 | TT10_PE_BEF | ISO7380-1 M6x10 8.8; cabeza baja D10.5 H3.3 envolvente; hexágono4; fijador de rosca requerido | 2 | Clase 8.8 / ISO 898-1 | Comercial | 0.000001 | 7850 | 0.004 | 0.009 | CAD_volume_x_specified_density | BOM y montaje TT10-01; sin plano individual | C05E_TT10_PE_BEF.SLDPRT
397 | TT10_PE_BER | Tornillo M8x12 clase8.8, rosca nominal; fijador de rosca según montaje | 2 | Clase 8.8 / ISO 898-1 | Comercial | 0.000002 | 7850 | 0.012 | 0.024 | CAD_volume_x_specified_density | BOM y montaje TT10-01; sin plano individual | C05E_TT10_PE_BER.SLDPRT
398 | TT10_PE_BF0 | Tornillo M10x25 clase8.8, rosca nominal; fijador de rosca según montaje | 2 | Clase 8.8 / ISO 898-1 | Comercial | 0.000004 | 7850 | 0.029 | 0.058 | CAD_volume_x_specified_density | BOM y montaje TT10-01; sin plano individual | C05E_TT10_PE_BF0.SLDPRT
399 | TT10_PE_BF1 | Tornillo M10x25 clase8.8, rosca nominal; fijador de rosca según montaje | 2 | Clase 8.8 / ISO 898-1 | Comercial | 0.000004 | 7850 | 0.029 | 0.058 | CAD_volume_x_specified_density | BOM y montaje TT10-01; sin plano individual | C05E_TT10_PE_BF1.SLDPRT
400 | TT10_PE_BR0 | Tornillo M10x25 clase8.8, rosca nominal; fijador de rosca según montaje | 2 | Clase 8.8 / ISO 898-1 | Comercial | 0.000004 | 7850 | 0.029 | 0.058 | CAD_volume_x_specified_density | BOM y montaje TT10-01; sin plano individual | C05E_TT10_PE_BR0.SLDPRT
401 | TT10_PE_BR1 | Tornillo M10x25 clase8.8, rosca nominal; fijador de rosca según montaje | 2 | Clase 8.8 / ISO 898-1 | Comercial | 0.000004 | 7850 | 0.029 | 0.058 | CAD_volume_x_specified_density | BOM y montaje TT10-01; sin plano individual | C05E_TT10_PE_BR1.SLDPRT
402 | TT10_PE_EJE_F | Bulón articulación D12 h8, cabeza20x4, M6-6H axial profundidad12; arandela y tornillo de retención | 2 | Arandela endurecida 300 HV / ISO 7089 | Comercial | 0.000007 | 7850 | 0.053 | 0.106 | CAD_volume_x_specified_density | BOM y montaje TT10-01; sin plano individual | C05E_TT10_PE_EJE_F.SLDPRT
403 | TT10_PE_EJE_R | Bulón articulación D12 h8, cabeza20x4, M8-6H axial profundidad12; arandela y tornillo de retención | 2 | Arandela endurecida 300 HV / ISO 7089 | Comercial | 0.000006 | 7850 | 0.047 | 0.094 | CAD_volume_x_specified_density | BOM y montaje TT10-01; sin plano individual | C05E_TT10_PE_EJE_R.SLDPRT
404 | TT10_PE_HORQ_F | Horquilla frontal integral ASTM A36: base60x10, separación31.2, dos orejas10, D12.2H8; 2M10 de fijación | 2 | ASTM A36 | Fabricación | 0.000051 | 7850 | 0.402 | 0.804 | CAD_volume_x_specified_density | Plano de conjunto / detalle funcional: TT10-12 | C05E_TT10_PE_HORQ_F.SLDPRT
405 | TT10_PE_HORQ_R | Horquilla trasera mecanizada: base130x60x10; separación26.4; eje12; 2M10 | 2 | ASTM A36 | Fabricación | 0.000106 | 7850 | 0.830 | 1.660 | CAD_volume_x_specified_density | Plano de conjunto / detalle funcional: TT10-12 | C05E_TT10_PE_HORQ_R.SLDPRT
406 | TT10_PE_LARG_L | Larguero ASTM A36 plano12x80; corte a longitud503.0 | 2 | ASTM A36 | Fabricación | 0.000483 | 7850 | 3.791 | 7.581 | CAD_volume_x_specified_density | Plano de conjunto / detalle funcional: TT10-12 | C05E_TT10_PE_LARG_L.SLDPRT
407 | TT10_PE_LARG_R | Larguero ASTM A36 plano12x80; corte a longitud503.0 | 2 | ASTM A36 | Fabricación | 0.000483 | 7850 | 3.791 | 7.581 | CAD_volume_x_specified_density | Plano de conjunto / detalle funcional: TT10-12 | C05E_TT10_PE_LARG_R.SLDPRT
408 | TT10_PE_NA0 | Tuerca M8 clase8; rosca nominal, retención por fijador especificado | 2 | Tuerca clase 8 / ISO 898-2 | Comercial | 0.000001 | 7850 | 0.005 | 0.010 | CAD_volume_x_specified_density | BOM y montaje TT10-01; sin plano individual | C05E_TT10_PE_NA0.SLDPRT
409 | TT10_PE_NA1 | Tuerca M8 clase8; rosca nominal, retención por fijador especificado | 2 | Tuerca clase 8 / ISO 898-2 | Comercial | 0.000001 | 7850 | 0.005 | 0.010 | CAD_volume_x_specified_density | BOM y montaje TT10-01; sin plano individual | C05E_TT10_PE_NA1.SLDPRT
410 | TT10_PE_NA2 | Tuerca M8 clase8; rosca nominal, retención por fijador especificado | 2 | Tuerca clase 8 / ISO 898-2 | Comercial | 0.000001 | 7850 | 0.005 | 0.010 | CAD_volume_x_specified_density | BOM y montaje TT10-01; sin plano individual | C05E_TT10_PE_NA2.SLDPRT
411 | TT10_PE_NA3 | Tuerca M8 clase8; rosca nominal, retención por fijador especificado | 2 | Tuerca clase 8 / ISO 898-2 | Comercial | 0.000001 | 7850 | 0.005 | 0.010 | CAD_volume_x_specified_density | BOM y montaje TT10-01; sin plano individual | C05E_TT10_PE_NA3.SLDPRT
412 | TT10_PE_PIN | Pasador Ø65 f7 L330, cabeza90x15, R3, C2, dosM10x18 | 2 | AISI 4140 bonificado | Fabricación | 0.001188 | 7850 | 9.326 | 18.651 | CAD_volume_x_specified_density | Plano de conjunto / detalle funcional: TT10-13 | C05E_TT10_PE_PIN.SLDPRT
413 | TT10_PE_PLACA_F | Placa de bastidor160x160x12; D70;4D9 y4aliviosD42 abiertos en esquinas para tuercas existentes | 2 | ASTM A36 | Fabricación | 0.000189 | 7850 | 1.486 | 2.972 | CAD_volume_x_specified_density | Plano de conjunto / detalle funcional: TT10-12 | C05E_TT10_PE_PLACA_F.SLDPRT
414 | TT10_PE_PLACA_R | Travesaño160x80x12; 2M10-6H pasantes en X±45; frentes soldados a largueros | 2 | ASTM A36 | Fabricación | 0.000152 | 7850 | 1.191 | 2.382 | CAD_volume_x_specified_density | Plano de conjunto / detalle funcional: TT10-12 | C05E_TT10_PE_PLACA_R.SLDPRT
415 | TT10_PE_RETEN | Placa cautiva160x160x15: amplía paso aD68,4D22 original; añade4D9 en X±45 Z±30 | 2 | ASTM A36 | Fabricación | 0.000303 | 7850 | 2.378 | 4.756 | CAD_volume_x_specified_density | Plano de conjunto / detalle funcional: TT10-12 | C05E_TT10_PE_RETEN.SLDPRT
416 | TT10_PE_WA0 | Arandela D16/d8.4/t1.6 | 2 | Arandela endurecida 300 HV / ISO 7089 | Comercial | 2.330307767e-07 | 7850 | 0.002 | 0.004 | CAD_volume_x_specified_density | BOM y montaje TT10-01; sin plano individual | C05E_TT10_PE_WA0.SLDPRT
417 | TT10_PE_WA1 | Arandela D16/d8.4/t1.6 | 2 | Arandela endurecida 300 HV / ISO 7089 | Comercial | 2.330307767e-07 | 7850 | 0.002 | 0.004 | CAD_volume_x_specified_density | BOM y montaje TT10-01; sin plano individual | C05E_TT10_PE_WA1.SLDPRT
418 | TT10_PE_WA2 | Arandela D16/d8.4/t1.6 | 2 | Arandela endurecida 300 HV / ISO 7089 | Comercial | 2.330307767e-07 | 7850 | 0.002 | 0.004 | CAD_volume_x_specified_density | BOM y montaje TT10-01; sin plano individual | C05E_TT10_PE_WA2.SLDPRT
419 | TT10_PE_WA3 | Arandela D16/d8.4/t1.6 | 2 | Arandela endurecida 300 HV / ISO 7089 | Comercial | 2.330307767e-07 | 7850 | 0.002 | 0.004 | CAD_volume_x_specified_density | BOM y montaje TT10-01; sin plano individual | C05E_TT10_PE_WA3.SLDPRT
420 | TT10_PE_WEF | Arandela D12/d6.4/t1.6 | 2 | Arandela endurecida 300 HV / ISO 7089 | Comercial | 1.294838828e-07 | 7850 | 0.001 | 0.002 | CAD_volume_x_specified_density | BOM y montaje TT10-01; sin plano individual | C05E_TT10_PE_WEF.SLDPRT
421 | TT10_PE_WER | Arandela D20/d8.4/t2 | 2 | Arandela endurecida 300 HV / ISO 7089 | Comercial | 0.000001 | 7850 | 0.004 | 0.008 | CAD_volume_x_specified_density | BOM y montaje TT10-01; sin plano individual | C05E_TT10_PE_WER.SLDPRT
422 | TT10_PE_WF0 | Arandela D20/d10.5/t2 | 2 | Arandela endurecida 300 HV / ISO 7089 | Comercial | 4.551382357e-07 | 7850 | 0.004 | 0.007 | CAD_volume_x_specified_density | BOM y montaje TT10-01; sin plano individual | C05E_TT10_PE_WF0.SLDPRT
423 | TT10_PE_WF1 | Arandela D20/d10.5/t2 | 2 | Arandela endurecida 300 HV / ISO 7089 | Comercial | 4.551382357e-07 | 7850 | 0.004 | 0.007 | CAD_volume_x_specified_density | BOM y montaje TT10-01; sin plano individual | C05E_TT10_PE_WF1.SLDPRT
424 | TT10_PE_WN0 | Arandela D16/d8.4/t1.6 | 2 | Arandela endurecida 300 HV / ISO 7089 | Comercial | 2.330307767e-07 | 7850 | 0.002 | 0.004 | CAD_volume_x_specified_density | BOM y montaje TT10-01; sin plano individual | C05E_TT10_PE_WN0.SLDPRT
425 | TT10_PE_WN1 | Arandela D16/d8.4/t1.6 | 2 | Arandela endurecida 300 HV / ISO 7089 | Comercial | 2.330307767e-07 | 7850 | 0.002 | 0.004 | CAD_volume_x_specified_density | BOM y montaje TT10-01; sin plano individual | C05E_TT10_PE_WN1.SLDPRT
426 | TT10_PE_WN2 | Arandela D16/d8.4/t1.6 | 2 | Arandela endurecida 300 HV / ISO 7089 | Comercial | 2.330307767e-07 | 7850 | 0.002 | 0.004 | CAD_volume_x_specified_density | BOM y montaje TT10-01; sin plano individual | C05E_TT10_PE_WN2.SLDPRT
427 | TT10_PE_WN3 | Arandela D16/d8.4/t1.6 | 2 | Arandela endurecida 300 HV / ISO 7089 | Comercial | 2.330307767e-07 | 7850 | 0.002 | 0.004 | CAD_volume_x_specified_density | BOM y montaje TT10-01; sin plano individual | C05E_TT10_PE_WN3.SLDPRT
428 | TT10_PE_WR0 | Arandela D20/d10.5/t2 | 2 | Arandela endurecida 300 HV / ISO 7089 | Comercial | 4.551382357e-07 | 7850 | 0.004 | 0.007 | CAD_volume_x_specified_density | BOM y montaje TT10-01; sin plano individual | C05E_TT10_PE_WR0.SLDPRT
429 | TT10_PE_WR1 | Arandela D20/d10.5/t2 | 2 | Arandela endurecida 300 HV / ISO 7089 | Comercial | 4.551382357e-07 | 7850 | 0.004 | 0.007 | CAD_volume_x_specified_density | BOM y montaje TT10-01; sin plano individual | C05E_TT10_PE_WR1.SLDPRT
430 | TT10_PUENTE_N | Placa de puente de guÃa 525x125x25 | 1 | ASTM A36 | Fabricación | 0.001641 | 7850 | 12.879 | 12.879 | CAD_volume_x_specified_density | Plano de conjunto / detalle funcional: TT10-03 | C05E_TT10_PUENTE_N.SLDPRT
431 | TT10_PUENTE_P | Placa de puente de guÃa 525x125x25 | 1 | ASTM A36 | Fabricación | 0.001641 | 7850 | 12.879 | 12.879 | CAD_volume_x_specified_density | Plano de conjunto / detalle funcional: TT10-03 | C05E_TT10_PUENTE_P.SLDPRT
432 | TT10_R6M_BRAZO_SENSOR_N_INSERTADO | Brazo fijo de detector; unión soldada a pie sobre larguero | 1 | ASTM A36 | Fabricación | 0.000061 | 7850 | 0.475 | 0.475 | CAD_volume_x_specified_density | Plano de conjunto / detalle funcional: TT10-15 | C05E_TT10_R6M_BRAZO_SENSOR_N_INSERTADO.SLDPRT
433 | TT10_R6M_BRAZO_SENSOR_N_RETIRADO | Brazo fijo de detector; unión soldada a pie sobre larguero | 1 | ASTM A36 | Fabricación | 0.000010 | 7850 | 0.080 | 0.080 | CAD_volume_x_specified_density | Plano de conjunto / detalle funcional: TT10-15 | C05E_TT10_R6M_BRAZO_SENSOR_N_RETIRADO.SLDPRT
434 | TT10_R6M_BRAZO_SENSOR_P_INSERTADO | Brazo fijo de detector; unión soldada a pie sobre larguero | 1 | ASTM A36 | Fabricación | 0.000061 | 7850 | 0.475 | 0.475 | CAD_volume_x_specified_density | Plano de conjunto / detalle funcional: TT10-15 | C05E_TT10_R6M_BRAZO_SENSOR_P_INSERTADO.SLDPRT
435 | TT10_R6M_BRAZO_SENSOR_P_RETIRADO | Brazo fijo de detector; unión soldada a pie sobre larguero | 1 | ASTM A36 | Fabricación | 0.000010 | 7850 | 0.080 | 0.080 | CAD_volume_x_specified_density | Plano de conjunto / detalle funcional: TT10-15 | C05E_TT10_R6M_BRAZO_SENSOR_P_RETIRADO.SLDPRT
436 | TT10_R6M_CHAVETA_FRENO_TIMON | ChavetaDIN6885/1 8x7x25 C45E | 1 | AISI 4140 bonificado | Comercial | 0.000001 | 7850 | 0.011 | 0.011 | CAD_volume_x_specified_density | BOM y montaje TT10-01; sin plano individual | C05E_TT10_R6M_CHAVETA_FRENO_TIMON.SLDPRT
437 | TT10_R6M_CUBO_FRENO_TIMON | Cubo comercial simplificado: Ø30H7,8JS9;L25; verificar suministro con referencia mayr | 1 | AISI 4140 bonificado | Comercial | 0.000035 | 7850 | 0.273 | 0.273 | CAD_volume_x_specified_density | BOM y montaje TT10-01; sin plano individual | C05E_TT10_R6M_CUBO_FRENO_TIMON.SLDPRT
438 | TT10_R6M_IE5338_N_INSERTADO | ifmIE5338,M8x1L40,SN3mm;N INSERTADO | 1 | Conjunto comercial ifm | Comercial | 0.000002 |  | n/d | n/d | IE5338 | BOM y montaje TT10-01; sin plano individual | C05E_TT10_R6M_IE5338_N_INSERTADO.SLDPRT
439 | TT10_R6M_IE5338_N_RETIRADO | ifmIE5338,M8x1L40,SN3mm;N RETIRADO | 1 | Conjunto comercial ifm | Comercial | 0.000002 |  | n/d | n/d | IE5338 | BOM y montaje TT10-01; sin plano individual | C05E_TT10_R6M_IE5338_N_RETIRADO.SLDPRT
440 | TT10_R6M_IE5338_P_INSERTADO | ifmIE5338,M8x1L40,SN3mm;P INSERTADO | 1 | Conjunto comercial ifm | Comercial | 0.000002 |  | n/d | n/d | IE5338 | BOM y montaje TT10-01; sin plano individual | C05E_TT10_R6M_IE5338_P_INSERTADO.SLDPRT
441 | TT10_R6M_IE5338_P_RETIRADO | ifmIE5338,M8x1L40,SN3mm;P RETIRADO | 1 | Conjunto comercial ifm | Comercial | 0.000002 |  | n/d | n/d | IE5338 | BOM y montaje TT10-01; sin plano individual | C05E_TT10_R6M_IE5338_P_RETIRADO.SLDPRT
442 | TT10_R6M_MAYR_32 | mayr32/891.101.0/24/30/6885/1 JS9;64Nm; rotor metálico; liberación manual | 1 | Conjunto comercial mayr | Comercial | 0.000924 |  | 4.500 | 4.500 | 32/891.101.0/24/30/6885/1 JS9 | BOM y montaje TT10-01; sin plano individual | C05E_TT10_R6M_MAYR_32.SLDPRT
443 | TT10_R6M_PEDESTAL_FRENO | Travesaño108x40x10 entre caras interiores del poste existente; soldadura a3,40mm por extremo | 1 | ASTM A36 | Fabricación | 0.000043 | 7850 | 0.339 | 0.339 | CAD_volume_x_specified_density | Plano de conjunto / detalle funcional: TT10-17 | C05E_TT10_R6M_PEDESTAL_FRENO.SLDPRT
444 | TT10_R6M_PIE_SENSORES_N | Pie12 sobre cara superior del larguero; soldadura a3,20mm por ambas caras | 1 | ASTM A36 | Fabricación | 0.000030 | 7850 | 0.236 | 0.236 | CAD_volume_x_specified_density | Plano de conjunto / detalle funcional: TT10-15 | C05E_TT10_R6M_PIE_SENSORES_N.SLDPRT
445 | TT10_R6M_PIE_SENSORES_P | Pie12 sobre cara superior del larguero; soldadura a3,20mm por ambas caras | 1 | ASTM A36 | Fabricación | 0.000030 | 7850 | 0.236 | 0.236 | CAD_volume_x_specified_density | Plano de conjunto / detalle funcional: TT10-15 | C05E_TT10_R6M_PIE_SENSORES_P.SLDPRT
446 | TT10_R6M_PLACA_FRENO_TIMON | Placa12, caraX1127; centrado y3M6PCD132; sujeción a pedestal por cartelas | 1 | ASTM A36 | Fabricación | 0.000241 | 7850 | 1.894 | 1.894 | CAD_volume_x_specified_density | Plano de conjunto / detalle funcional: TT10-17 | C05E_TT10_R6M_PLACA_FRENO_TIMON.SLDPRT
447 | TT10_R6M_SOP_SENSOR_N_INSERTADO | Escuadra6;taladroØ8.5 para sensorM8;frente de detección a1mm del blanco | 1 | ASTM A36 | Fabricación | 0.000014 | 7850 | 0.110 | 0.110 | CAD_volume_x_specified_density | Plano de conjunto / detalle funcional: TT10-15 | C05E_TT10_R6M_SOP_SENSOR_N_INSERTADO.SLDPRT
448 | TT10_R6M_SOP_SENSOR_N_RETIRADO | Escuadra6;taladroØ8.5 para sensorM8;frente de detección a1mm del blanco | 1 | ASTM A36 | Fabricación | 0.000014 | 7850 | 0.110 | 0.110 | CAD_volume_x_specified_density | Plano de conjunto / detalle funcional: TT10-15 | C05E_TT10_R6M_SOP_SENSOR_N_RETIRADO.SLDPRT
449 | TT10_R6M_SOP_SENSOR_P_INSERTADO | Escuadra6;taladroØ8.5 para sensorM8;frente de detección a1mm del blanco | 1 | ASTM A36 | Fabricación | 0.000014 | 7850 | 0.110 | 0.110 | CAD_volume_x_specified_density | Plano de conjunto / detalle funcional: TT10-15 | C05E_TT10_R6M_SOP_SENSOR_P_INSERTADO.SLDPRT
450 | TT10_R6M_SOP_SENSOR_P_RETIRADO | Escuadra6;taladroØ8.5 para sensorM8;frente de detección a1mm del blanco | 1 | ASTM A36 | Fabricación | 0.000014 | 7850 | 0.110 | 0.110 | CAD_volume_x_specified_density | Plano de conjunto / detalle funcional: TT10-15 | C05E_TT10_R6M_SOP_SENSOR_P_RETIRADO.SLDPRT
451 | TT10_SEN_B6_P0 | Tornillo ISO4762 M6x16 8.8, cabeza D10 H6, hexágono5; rosca nominal | 4 | Clase 8.8 / ISO 898-1 | Comercial | 0.000001 | 7850 | 0.007 | 0.027 | CAD_volume_x_specified_density | BOM y montaje TT10-01; sin plano individual | C05E_TT10_SEN_B6_P0.SLDPRT
452 | TT10_SEN_P_IN | IFM IE5338 M8x1 L40, Sn3, NO PNP/NPN, 10-30VDC; incluye dos contratuercas | 4 | Conjunto comercial IFM; latón y polímeros | Comercial | 0.000003 |  | 0.017 | 0.066 | IE5338 | BOM y montaje TT10-01; sin plano individual | C05E_TT10_SEN_P_IN.SLDPRT
453 | TT10_SEN_SOP_P | Soporte soldado desmontable: carril6x40x229 y pie4x40x16.5; dos M6x16; dos D8.5 | 2 | ASTM A36 | Fabricación | 0.000057 | 7850 | 0.445 | 0.889 | CAD_volume_x_specified_density | Plano de conjunto / detalle funcional: TT10-15 | C05E_TT10_SEN_SOP_P.SLDPRT
454 | TT10_TIR_N1 | Tirante M20 propuesto, L380; rosca simplificada | 1 | ASTM A36 | Comercial | 0.000119 | 7850 | 0.937 | 0.937 | CAD_volume_x_specified_density | BOM y montaje TT10-01; sin plano individual | C05E_TT10_TIR_N1.SLDPRT
455 | TT10_TIR_N2 | Tirante M20 propuesto, L380; rosca simplificada | 1 | ASTM A36 | Comercial | 0.000119 | 7850 | 0.937 | 0.937 | CAD_volume_x_specified_density | BOM y montaje TT10-01; sin plano individual | C05E_TT10_TIR_N2.SLDPRT
456 | TT10_TIR_N3 | Tirante M20 propuesto, L380; rosca simplificada | 1 | ASTM A36 | Comercial | 0.000119 | 7850 | 0.937 | 0.937 | CAD_volume_x_specified_density | BOM y montaje TT10-01; sin plano individual | C05E_TT10_TIR_N3.SLDPRT
457 | TT10_TIR_N4 | Tirante M20 propuesto, L380; rosca simplificada | 1 | ASTM A36 | Comercial | 0.000119 | 7850 | 0.937 | 0.937 | CAD_volume_x_specified_density | BOM y montaje TT10-01; sin plano individual | C05E_TT10_TIR_N4.SLDPRT
458 | TT10_TIR_P1 | Tirante M20 propuesto, L380; rosca simplificada | 1 | ASTM A36 | Fabricación | 0.000119 | 7850 | 0.937 | 0.937 | CAD_volume_x_specified_density | Plano de conjunto / detalle funcional: TT10-02 | C05E_TT10_TIR_P1.SLDPRT
459 | TT10_TIR_P2 | Tirante M20 propuesto, L380; rosca simplificada | 1 | ASTM A36 | Fabricación | 0.000119 | 7850 | 0.937 | 0.937 | CAD_volume_x_specified_density | Plano de conjunto / detalle funcional: TT10-02 | C05E_TT10_TIR_P2.SLDPRT
460 | TT10_TIR_P3 | Tirante M20 propuesto, L380; rosca simplificada | 1 | ASTM A36 | Fabricación | 0.000119 | 7850 | 0.937 | 0.937 | CAD_volume_x_specified_density | Plano de conjunto / detalle funcional: TT10-02 | C05E_TT10_TIR_P3.SLDPRT
461 | TT10_TIR_P4 | Tirante M20 propuesto, L380; rosca simplificada | 1 | ASTM A36 | Fabricación | 0.000119 | 7850 | 0.937 | 0.937 | CAD_volume_x_specified_density | Plano de conjunto / detalle funcional: TT10-02 | C05E_TT10_TIR_P4.SLDPRT
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
