acevedocrisologopablo48-lgtm/sesuveca-tolva-p04/dist/documentos/TT10_BOM_COMPRAS.pdf

SESUVECA / JAVIER ACEVEDO /25-10-2026 /No liberada para fabricación | 1

# SESUVECA - Lista de materiales del modelo TT10

JAVIER ACEVEDO |25/10/2026 |492 códigos /996 instancias |Modelo C05, revisión interna C06.
Masa disponible: 17 378.657 kg;83 códigos con masa n/d excluidos. NO LIBERADA PARA FABRICACIÓN.
Pos. | Código | Cant. | Descripción de la geometría vigente | Material / especificación | Masa unitaria kg | Masa disponible kg
1 | TT10_22240_N | 1 | SKF22240CC/W33 200x360x98; envolvente sin rodillos | Conjunto comprado; acero/ fundición según OEM | 43.500 | 43.500
2 | TT10_22240_P | 1 | SKF22240CC/W33 200x360x98; envolvente sin rodillos | Conjunto comprado; acero/ fundición según OEM
43.500 | 43.500
3 | TT10_BAP_P0 | 32 | Perno ISO4014 M30x140 clase8.8; rosca nominal | Clase 8.8 / ISO 898-1 | 1.046 | 33.467
4 | TT10_BUJE_PIN_N | 1 | Casquillo CuSn12 Ø69 s6 / Ø65.5 H9 final, L85, C0.5 interiores | CuSn12 / EN 1982 | 0.276 | 0.276
5 | TT10_BUJE_PIN_P | 1 | Casquillo CuSn12 Ø69 s6 / Ø65.5 H9 final, L85, C0.5 interiores | CuSn12 / EN 1982 | 0.276 | 0.276
6 | TT10_C03_ACCESO_PUERTO _N | 1 | Guia de herramienta desde exterior N; puerto nominal rear+15.5/Z+53.7; NO conexion remota al actuador | ASTM A36 | 0.154 | 0.154
7 | TT10_C03_ACCESO_PUERTO
_P
1 | Guia de herramienta desde exterior P; puerto nominal rear+15.5/Z+53.7; NO
conexion remota al actuador
ASTM A36 | 0.154 | 0.154
8 | TT10_C03_CADENA_ESLABO
N

122 Renold16B1: referencia visual de eslabon; no fabricar. Rodillos compartidos representados dos veces

Equipo comprado Renold | 0.071 | 8.677
9 | TT10_C03_HK4020_E1 | 1 | SKF HK4020; 40x47x20; rodillos y jaula omitidos | Conjunto comprado; acero/ fundición según OEM
n/d | n/d
10 | TT10_C03_HK4020_E2 | 1 | SKF HK4020; 40x47x20; rodillos y jaula omitidos | Conjunto comprado; acero/ fundición según OEM
n/d | n/d
11 | TT10_C03_HK4020_M1 | 1 | SKF HK4020; 40x47x20; rodillos y jaula omitidos | Conjunto comprado; acero/ fundición según OEM
n/d | n/d
12 | TT10_C03_HK4020_M2 | 1 | SKF HK4020; 40x47x20; rodillos y jaula omitidos | Conjunto comprado; acero/ fundición según OEM
n/d | n/d
13 | TT10_C03_REGISTRO_PUERT
O_N
1 | Registro exterior desmontable3 con accesoD50; fijaciones/proteccion de
puesto por completar
ASTM A36 | 0.849 | 0.849
14 | TT10_C03_REGISTRO_PUERT
O_P
1 | Registro exterior desmontable3 con accesoD50; fijaciones/proteccion de
puesto por completar
ASTM A36 | 0.849 | 0.849
15 | TT10_C03_SELECTOR_6008_1 1 | SKF6008 40x68x15; contorno de interfaz | Conjunto comprado; acero/ fundición según OEM
n/d | n/d

SESUVECA / JAVIER ACEVEDO /25-10-2026 /No liberada para fabricación | 2
Pos. | Código | Cant. | Descripción de la geometría vigente | Material / especificación | Masa unitaria kg | Masa disponible kg
16 | TT10_C03_SELECTOR_6008_2 1 | SKF6008 40x68x15; contorno de interfaz | Conjunto comprado; acero/ fundición según
| | | | OEM | n/d | n/d
17 | TT10_C03_SELECTOR_COLLA
R_1
1 | Collar de varilla para sujetar horquilla; fijacion radial y retencion por
completar
C45E / EN 10083-2 | 0.010 | 0.010
18 | TT10_C03_SELECTOR_COLLA
R_2
1 | Collar de varilla para sujetar horquilla; fijacion radial y retencion por
completar
C45E / EN 10083-2 | 0.010 | 0.010
19 | TT10_C03_SELECTOR_CUBIE
RTA
1 | Cubierta desmontable3; ranura50x36 para recorrido completo; cierreM6 por
detallar
ASTM A36 | 0.483 | 0.483
20 | TT10_C03_SELECTOR_ENCLA
VAMIENTO
1 | Pasador positivoD6; levantar16mm antes de seleccionar y reinsertar;
retencion cautiva y mando remoto pendientes
C45E / EN 10083-2 | 0.009 | 0.009
21 | TT10_C03_SELECTOR_HORQ
UILLA
1 | Horquilla10 en ranura12; 1 mm nominal por flanco; garras de seleccion con
la maquina parada
ASTM A36 | 0.443 | 0.443
22 | TT10_C03_SELECTOR_MANG
UITO
1 | Manguito estriado: neutro X923..979; E+18/M-18; 6 alojamientos D12.2
PCD72 por cara
AISI 4140 bonificado | 1.865 | 1.865
23 | TT10_C03_SELECTOR_PARE
D_E
1 | Pared mecanizada8; roscasM6; tapa de retencion y asiento axial por cadena
de cotas
ASTM A36 | 2.386 | 2.386
24 | TT10_C03_SELECTOR_PARE
D_M
1 | Pared mecanizada8; roscasM6; tapa de retencion y asiento axial por cadena
de cotas
ASTM A36 | 2.386 | 2.386
25 | TT10_C03_SELECTOR_VARIL
LA
1 | Varilla selector D16; tres taladrosD6.5 con paso18; E-N-M por pasador
positivo
C45E / EN 10083-2 | 0.272 | 0.272
26 | TT10_C03_TAPA_RETENCION
_E
1 | Tapa estacionaria: labio axial para cuboD100, pasoD92 libre al
manguitoD90; junta axial0.2 por ajustar
ASTM A36 | 0.153 | 0.153
27 | TT10_C03_TAPA_RETENCION
_M
1 | Tapa estacionaria: labio axial para cuboD100, pasoD92 libre al
manguitoD90; junta axial0.2 por ajustar
ASTM A36 | 0.153 | 0.153
28 | TT10_C04_ACOPLE_0 | 1 | Brida110x8,PCD82/6M8; bore30H7; asiento25, desmontaje axial | C45E / EN 10083-2 | 0.834 | 0.834
29 | TT10_C04_ACOPLE_1 | 1 | Brida110x8,PCD82/6M8; bore30H7; asiento30, desmontaje axial | C45E / EN 10083-2 | 0.870 | 0.870
30 | TT10_C04_ACOPLE_B8_0 | 4 | M8x25,8.8; cabeza exterior; apriete por plano | Clase 10.9 / ISO 898-1 | 0.016 | 0.064
31 | TT10_C04_ACOPLE_B8_4 | 2 | M8x25,8.8; cabeza exterior; apriete por plano | Clase 10.9 / ISO 898-1 | 0.016 | 0.032
32 | TT10_C04_ACOPLE_N8_0 | 4 | TuercaM8 clase8, autoblocante nominal | Tuerca clase 10 / ISO 898-2 | 0.005 | 0.020
33 | TT10_C04_ACOPLE_N8_2 | 2 | TuercaM8 clase8, autoblocante nominal | Tuerca clase 10 / ISO 898-2 | 0.005 | 0.010
34 | TT10_C04_ASIENTO_CHUMAC ERAS | 1 | Bloque90x180x52.1; cara superior mecanizada y4M12 ciegas28 | Conjunto comprado; acero/ fundición según OEM | n/d | n/d
35 | TT10_C04_B6008_M6_1_0 | 2 | M6x20 ISO7380-1,10.9; contorno nominal | Clase 10.9 / ISO 898-1 | 0.007 | 0.013

SESUVECA / JAVIER ACEVEDO /25-10-2026 /No liberada para fabricación | 3

kg

36 | TT10_C04_B6008_M6_1_2 | 1 | M6x20 ISO7380-1,10.9; contorno nominal | Clase 10.9 / ISO 898-1 | 0.007 | 0.007
37 | TT10_C04_B6008_M6_1_3 | 1 | M6x20 ISO7380-1,10.9; contorno nominal | Clase 10.9 / ISO 898-1 | 0.007 | 0.007
38 | TT10_C04_B6008_M6_2_0 | 2 | M6x20 ISO7380-1,10.9; contorno nominal | Clase 10.9 / ISO 898-1 | 0.007 | 0.013
39 | TT10_C04_B6008_M6_2_1 | 2 | M6x20 ISO7380-1,10.9; contorno nominal | Clase 10.9 / ISO 898-1 | 0.007 | 0.013
40 | TT10_C04_BANCADA | 1 | Bancada215x200x20, sobre poste corto; soldaduraa3 | ASTM A36 | 6.746 | 6.746
41 | TT10_C04_CARTELA_0 | 1 | Cartela12,165x55, a3 continuo a placa y poste | ASTM A36 | 0.427 | 0.427
42 | TT10_C04_CARTELA_1 | 1 | Cartela12,165x55, a3 continuo a placa y poste | ASTM A36 | 0.427 | 0.427
43 | TT10_C04_CHAVETA_ACOPLE _0 | 1 | Chaveta8x7x25 | AISI 4140 bonificado | 0.011 | 0.011
44 | TT10_C04_CHAVETA_ACOPLE
_1
1 | Chaveta8x7x30 | AISI 4140 bonificado | 0.013 | 0.013
45 | TT10_C04_CHAVETA_CORON
A
1 | Chaveta8x7x40 de corona | AISI 4140 bonificado | 0.018 | 0.018
46 | TT10_C04_CHAVETA_MOTOR | 1 | Chaveta12x8x35, extremos planos; interfaz propia, no ejeOEM aprobado | Equipo comprado; materiales y masa según ficha OEM
n/d | n/d
47 | TT10_C04_CORONA_20D | 1 | Corona10888120; bore30H7 y chavetero8JS9 abierto al bore en todo su ancho; dentado comprado simplificado
C45E | n/d | n/d
48 | TT10_C04_DIN471_40 | 1 | ComprarDIN471-40,1.75; contorno instalado simplificado, no fabricar | Acero resorte DIN471 | 0.009 | 0.009
49 | TT10_C04_EJE_MANUAL | 1 | EjeD30h7,L184; chaveteros8x7, t1=4, extremos planos | AISI 4140 bonificado | 1.005 | 1.005
50 | TT10_C04_EJE_TIMON | 1 | Eje heredado con extremoX1026 y chavetero adicional8x7x30; Mayr conservado | AISI 4140 bonificado | 1.477 | 1.477
51 | TT10_C04_ENTRADA_MOTOR | 1 | Interfaz nominal de entradaD40, separacion2mm del ejecomun; motor comercial aun nominal
Equipo comprado; materiales y masa según ficha OEM
n/d | n/d
52 | TT10_C04_ESPACIADOR6008 | 1 | Separador7 entre tapa izquierda y anillo exterior6008 | Conjunto comprado; acero/ fundición según OEM
n/d | n/d
53 | TT10_C04_GUARDA_ANCLA6_
4470
1 | M6x16,8.8 a bancada; no anclaje a losa | Tornilleria8.8 | n/d | n/d
54 | TT10_C04_GUARDA_ANCLA6_
4630
1 | M6x16,8.8 a bancada; no anclaje a losa | Tornilleria8.8 | n/d | n/d
55 | TT10_C04_GUARDA_B6_0 | 4 | M6x50,8.8 para tapa frontal | Clase 8.8 / ISO 898-1 | 0.014 | 0.055
56 | TT10_C04_GUARDA_BANDA | 1 | Banda2, ancho36; tapa inferior; soldar a posterior, frontal desmontable | ASTM A36 | 1.897 | 1.897

SESUVECA / JAVIER ACEVEDO /25-10-2026 /No liberada para fabricación | 4

kg

57 TT10_C04_GUARDA_BASEW6
_4470
1 | Arandela6,12x6.6x2 | Arandela endurecida 300 HV / ISO 7089 | n/d | n/d
58 | TT10_C04_GUARDA_BASEW6
_4630
1 | Arandela6,12x6.6x2 | Arandela endurecida 300 HV / ISO 7089 | n/d | n/d
59 | TT10_C04_GUARDA_FRONTA
L
1 | Chapa2; contorno de cadena; inferiorZ1107; paso superior/FRONTAL | ASTM A36 | 4.501 | 4.501
60 | TT10_C04_GUARDA_N6_0 | 3 | TuercaM6 autoblocante metalica; contorno nominal | Tornilleria8 | n/d | n/d
61 | TT10_C04_GUARDA_N6_2 | 1 | TuercaM6 autoblocante metalica; contorno nominal | Tornilleria8 | n/d | n/d
62 | TT10_C04_GUARDA_POSTERI OR | 1 | Chapa2; contorno de cadena; inferiorZ1107; paso superior/POSTERIOR | ASTM A36 | 4.465 | 4.465
63 | TT10_C04_GUARDA_W6_0 | 3 | ArandelaM6,12x6.6x1.6 | Arandela endurecida 300 HV / ISO 7089 | n/d | n/d
64 | TT10_C04_GUARDA_W6_2 | 1 | ArandelaM6,12x6.6x1.6 | Arandela endurecida 300 HV / ISO 7089 | n/d | n/d
65 | TT10_C04_PEDESTAL_SELEC TOR | 1 | Pedestal con ventana46 para paso real de cadena/resguardo; soporte local por verificar | ASTM A36 | 121.438 | 121.438
66 | TT10_C04_PLACA_TIMON | 1 | Placa de estacion existente con ventanaR57x25 para bridas110; apoyos yMayr conservados
ASTM A36 | 6.747 | 6.747
67 | TT10_C04_SELECTOR_APOY
O_1
1 | Asiento6008 abierto; montaje axial y4M6PCD84; no cavidad inaccesible | Conjunto comprado; acero/ fundición según OEM
n/d | n/d
68 | TT10_C04_SELECTOR_APOY
O_2
1 | Asiento6008 abierto; montaje axial y4M6PCD84; no cavidad inaccesible | Conjunto comprado; acero/ fundición según OEM
n/d | n/d
69 | TT10_C04_SELECTOR_BASE | 1 | Soporte con ventana46mm para cadena y guarda; caras restantes transmiten apoyo
ASTM A36 | 10.625 | 10.625
70 | TT10_C04_SELECTOR_CUBO
_E
1 | CuboE con extension; pasoD41 hastaX1062, socketD40H7 y
chavetero12x35
AISI 4140 bonificado | 4.038 | 4.038
71 | TT10_C04_SELECTOR_EJE | 1 | Eje D40h6; extremoX1060; ranuraDIN471D37.5x1.85 enX855.1 | 42CrMo4+QT; pistas58-64HRC | n/d | n/d
72 | TT10_C04_SELECTOR_ESPAC IADOR | 1 | Soporte con ventana46mm para cadena y guarda; caras restantes transmiten apoyo | ASTM A36 | 6.500 | 6.500
73 | TT10_C04_SY30_B12_930_449
1.25
2 | M12x45,8.8;25.5mm nominales de rosca util | Clase 8.8 / ISO 898-1 | 0.056 | 0.113
74 | TT10_C04_SY30_B12_972_449
1.25
2 | M12x45,8.8;25.5mm nominales de rosca util | Clase 8.8 / ISO 898-1 | 0.056 | 0.113
75 | TT10_C04_SY30_W12_930_44
91.25
2 | ArandelaM12,24x13x2.5 | Arandela endurecida 300 HV / ISO 7089 | n/d | n/d

SESUVECA / JAVIER ACEVEDO /25-10-2026 /No liberada para fabricación | 5

kg

76 TT10_C04_SY30_W12_930_46
08.75
2 | ArandelaM12,24x13x2.5 | Arandela endurecida 300 HV / ISO 7089 | n/d | n/d
77 | TT10_C04_TAPA6008_1 | 1 | Tapa104x4, cabezas en cajera; desmontaje exterior | ASTM A36 | 0.194 | 0.194
78 | TT10_C04_TAPA6008_2 | 1 | Tapa104x4, cabezas en cajera; desmontaje exterior | ASTM A36 | 0.179 | 0.179
79 | TT10_C04_TRAVESANO | 1 | RHS100x50x5,L230; une los dos postes del puesto manual, a3 | S275J0H / EN 10219-1 | 2.528 | 2.528
80 | TT10_C05_ARANDELA_TENS OR_0 | 1 | Arandela puente44x21x4, endurecida, cubre ranura22 | Arandela endurecida 300 HV / ISO 7089 | 0.037 | 0.037
81 | TT10_C05_ARANDELA_TENS
OR_1
1 | Arandela puente44x21x4, endurecida, cubre ranura22 | Arandela endurecida 300 HV / ISO 7089 | 0.037 | 0.037
82 | TT10_C05_ARANDELA_TENS
OR_2
1 | Arandela puente44x21x4, endurecida, cubre ranura22 | Arandela endurecida 300 HV / ISO 7089 | 0.037 | 0.037
83 | TT10_C05_ARANDELA_TENS
OR_3
1 | Arandela puente44x21x4, endurecida, cubre ranura22 | Arandela endurecida 300 HV / ISO 7089 | 0.037 | 0.037
84 | TT10_C05_B20_TENSOR_0 | 1 | Tornillo M20x45,ISO4017 8.8; geometria nominal | Clase 8.8 / ISO 898-1 | 0.187 | 0.187
85 | TT10_C05_B20_TENSOR_1 | 1 | Tornillo M20x45,ISO4017 8.8; geometria nominal | Clase 8.8 / ISO 898-1 | 0.187 | 0.187
86 | TT10_C05_B20_TENSOR_2 | 1 | Tornillo M20x45,ISO4017 8.8; geometria nominal | Clase 8.8 / ISO 898-1 | 0.187 | 0.187
87 | TT10_C05_B20_TENSOR_3 | 1 | Tornillo M20x45,ISO4017 8.8; geometria nominal | Clase 8.8 / ISO 898-1 | 0.187 | 0.187
88 | TT10_C05_B4_RETEN_0_0 | 1 | M4x9,8.8; tornillo del puente cautivo; fijador desmontable | Clase 10.9 / ISO 898-1 | 0.002 | 0.002
89 | TT10_C05_B4_RETEN_0_1 | 1 | M4x9,8.8; tornillo del puente cautivo; fijador desmontable | Clase 10.9 / ISO 898-1 | 0.002 | 0.002
90 | TT10_C05_B4_RETEN_1_0 | 1 | M4x9,8.8; tornillo del puente cautivo; fijador desmontable | Clase 10.9 / ISO 898-1 | 0.002 | 0.002
91 | TT10_C05_B4_RETEN_1_1 | 1 | M4x9,8.8; tornillo del puente cautivo; fijador desmontable | Clase 10.9 / ISO 898-1 | 0.002 | 0.002
92 | TT10_C05_BASE_FIJA_TENSO R | 1 | Base fija630x420x20; cuatro M20 roscados20;apriete100Nm;no son anclajes a losa | ASTM A36 | 40.576 | 40.576
93 | TT10_C05_BDNB_28_23 | 1 | Warner BDNB 28.23Nm, brida lado entrada, exterior reconstruido según MCC-P-1310 03/25 p69; cotas nominales medias
Equipo comprado | 0.907 | 0.907
94 | TT10_C05_BDNB_APOYO_0_I
NFERIOR
1 | Apoyo partido6006, asientoH7, tapa2M6x60, roscasM6 cuerpo; soldaduraa4
base
ASTM A36 | 1.238 | 1.238
95 | TT10_C05_BDNB_APOYO_0_T
APA
1 | Apoyo partido6006, asientoH7, tapa2M6x60, roscasM6 cuerpo; soldaduraa4
base
ASTM A36 | 0.294 | 0.294
96 | TT10_C05_BDNB_APOYO_1_I
NFERIOR
1 | Apoyo partido6006, asientoH7, tapa2M6x60, roscasM6 cuerpo; soldaduraa4
base
ASTM A36 | 1.238 | 1.238

SESUVECA / JAVIER ACEVEDO /25-10-2026 /No liberada para fabricación | 6

kg

97 TT10_C05_BDNB_APOYO_1_T APA

1 | Apoyo partido6006, asientoH7, tapa2M6x60, roscasM6 cuerpo; soldaduraa4
base
ASTM A36 | 0.294 | 0.294
98 | TT10_C05_BDNB_APOYO_2_I
NFERIOR
1 | Apoyo partido6906, asientoH7, tapa2M6x60, roscasM6 cuerpo; soldaduraa4
base
ASTM A36 | 0.974 | 0.974
99 | TT10_C05_BDNB_APOYO_2_T
APA
1 | Apoyo partido6906, asientoH7, tapa2M6x60, roscasM6 cuerpo; soldaduraa4
base
ASTM A36 | 0.249 | 0.249
100 | TT10_C05_BDNB_APOYO_3_I
NFERIOR
1 | Apoyo partido6906, asientoH7, tapa2M6x60, roscasM6 cuerpo; soldaduraa4
base
ASTM A36 | 0.974 | 0.974
101 | TT10_C05_BDNB_APOYO_3_T
APA
1 | Apoyo partido6906, asientoH7, tapa2M6x60, roscasM6 cuerpo; soldaduraa4
base
ASTM A36 | 0.249 | 0.249
102 | TT10_C05_BDNB_BASE | 1 | Base16 con ventana cadena,4pasos11;4M10x35 en placa existente roscadaM10
ASTM A36 | 2.728 | 2.728
103 | TT10_C05_BDNB_CHAVETA_E
NTRADA
1 | ChavetaDIN6885A8x7, longitud según código | C45E | 0.010 | 0.010
104 | TT10_C05_BDNB_CHAVETA_S
ALIDA
1 | ChavetaDIN6885A8x7, longitud según código | C45E | 0.009 | 0.009
105 | TT10_C05_BDNB_CORONA_2
0D
1 | Mädler10888120: interfaz modificada30H7/8JS9; dentado visual simplificado Equipo comprado | n/d | n/d
106 | TT10_C05_BDNB_CUBO_SELE
CTOR
1 | Cubo manual con corona integral z48,m2.5,20 grados; asiento47 y garras
conservadas
AISI 4140 bonificado | 2.752 | 2.752
107 | TT10_C05_BDNB_EJE_ENTRA
DA
1 | Eje30h6; socket12.73; chaveta8x7; taladro transversal4.825 | AISI 4140 bonificado | 0.459 | 0.459
108 | TT10_C05_BDNB_EJE_SALIDA 1 | Eje30h6, espiga12.70; dos6906; chaveta8x7; unión positiva3/16 | AISI 4140 bonificado | 0.324 | 0.324
109 | TT10_C05_BDNB_ENGRANAJ E
| 1 | Engranaje48d,m2.5,20grados,b20;30H7,8JS9 | AISI 4140 bonificado | 1.645 | 1.645
110 | TT10_C05_BDNB_M10 | 4 | TornilloISO4017 M10x35-8.8; rosca nominal | Clase 8.8 / ISO 898-1 | 0.033 | 0.131
111 | TT10_C05_BDNB_M5 | 4 | ISO4017 M5x20-8.8, rosca nominal | Clase 8.8 / ISO 898-1 | 0.005 | 0.018
112 | TT10_C05_BDNB_M6 | 8 | TornilloISO4017 M6x60-8.8; rosca nominal | Clase 8.8 / ISO 898-1 | 0.016 | 0.128
113 | TT10_C05_BDNB_N3_ENTRAD A | 1 | TuercaISO7042 M3 autoblocante metálica, rosca nominal | Tuerca clase 8 / ISO 898-2 | 0.001 | 0.001
114 | TT10_C05_BDNB_N3_SALIDA | 1 | TuercaISO7042 M3 autoblocante metálica, rosca nominal | Tuerca clase 8 / ISO 898-2 | 0.001 | 0.001
115 | TT10_C05_BDNB_N5 | 4 | TuercaISO4032 M5-8; rosca nominal | Tuerca clase 8 / ISO 898-2 | 0.001 | 0.005

SESUVECA / JAVIER ACEVEDO /25-10-2026 /No liberada para fabricación | 7

kg

116 TT10_C05_BDNB_PASADOR_ ENTRADA

1 | Pasador transversal3/16, cabeza7, puntaM3x5; C45E bonificado, Rp0.2
minimo650MPa
C45E / EN 10083-2 | 0.006 | 0.006
117 | TT10_C05_BDNB_PASADOR_
SALIDA
1 | Pasador transversal3/16, cabeza7, puntaM3x5; C45E bonificado, Rp0.2
minimo650MPa
C45E / EN 10083-2 | 0.004 | 0.004
118 | TT10_C05_BDNB_PLACA_REA
CCION
1 | Reacción BDNB8mm,4Ø5.5PCD53.85; soldaduraa4 ambos lados a base | ASTM A36 | 0.843 | 0.843
119 | TT10_C05_BDNB_RODAMIENT
O_0
1 | RodamientoSKF6006; envolvente de montaje; selección de vida separada | Equipo comprado | n/d | n/d
120 | TT10_C05_BDNB_RODAMIENT
O_1
1 | RodamientoSKF6006; envolvente de montaje; selección de vida separada | Equipo comprado | n/d | n/d
121 | TT10_C05_BDNB_RODAMIENT
O_2
1 | RodamientoSKF6906; envolvente de montaje; selección de vida separada | Equipo comprado | n/d | n/d
122 | TT10_C05_BDNB_RODAMIENT
O_3
1 | RodamientoSKF6906; envolvente de montaje; selección de vida separada | Equipo comprado | n/d | n/d
123 | TT10_C05_BDNB_W10 | 4 | ArandelaISO7089 M10 | Arandela endurecida 300 HV / ISO 7089 | 0.004 | 0.014
124 | TT10_C05_BDNB_W5 | 4 | ArandelaDIN433 M5,9x5.3x1 | Arandela endurecida 300 HV / ISO 7089 | 0.000 | 0.001
125 | TT10_C05_BDNB_W6 | 8 | ArandelaISO7089 M6 | Arandela endurecida 300 HV / ISO 7089 | 0.001 | 0.008
126 | TT10_C05_BLOQUE_SELECT OR | 1 | BloqueC03 conservado con4M4laterales para retencion cautiva | ASTM A36 | 0.417 | 0.417
127 | TT10_C05_CORREDERA_TEN
SOR
1 | Corredera comun590x320x20;4ranuras22x62; carrera Y+/-20mm; ambos
postes solidarios
ASTM A36 | 28.852 | 28.852
128 | TT10_C05_GUIA_TENSOR_0 | 1 | Guia lateral mecanizada;holgura transversal total0.3..0.5mm; soldar a base fija y mecanizar despues
ASTM A36 | 1.116 | 1.116
129 | TT10_C05_GUIA_TENSOR_1 | 1 | Guia lateral mecanizada;holgura transversal total0.3..0.5mm; soldar a base fija y mecanizar despues
ASTM A36 | 1.116 | 1.116
130 | TT10_C05_JACK_M16_0_0 | 1 | M16x80,8.8 de regulacion; rosca total; punta plana; bloquear con contratuerca
8.8 | n/d | n/d
131 | TT10_C05_JACK_M16_0_1 | 1 | M16x80,8.8 de regulacion; rosca total; punta plana; bloquear con contratuerca
8.8 | n/d | n/d
132 | TT10_C05_JACK_M16_1_0 | 1 | M16x80,8.8 de regulacion; rosca total; punta plana; bloquear con contratuerca
8.8 | n/d | n/d
133 | TT10_C05_JACK_M16_1_1 | 1 | M16x80,8.8 de regulacion; rosca total; punta plana; bloquear con contratuerca
8.8 | n/d | n/d
134 | TT10_C05_JAM_M16_0_0 | 1 | ContratuercaM16 clase8; mantener ajuste con cuatro M20 apretados | Tuerca clase 8 / ISO 898-2 | 0.014 | 0.014

SESUVECA / JAVIER ACEVEDO /25-10-2026 /No liberada para fabricación | 8

kg

135 | TT10_C05_JAM_M16_0_1 | 1 | ContratuercaM16 clase8; mantener ajuste con cuatro M20 apretados | Tuerca clase 8 / ISO 898-2 | 0.014 | 0.014
136 | TT10_C05_JAM_M16_1_0 | 1 | ContratuercaM16 clase8; mantener ajuste con cuatro M20 apretados | Tuerca clase 8 / ISO 898-2 | 0.014 | 0.014
137 | TT10_C05_JAM_M16_1_1 | 1 | ContratuercaM16 clase8; mantener ajuste con cuatro M20 apretados | Tuerca clase 8 / ISO 898-2 | 0.014 | 0.014
138 | TT10_C05_OREJA_TENSOR_0 _0 | 1 | Oreja36x20x36;M16x2; soldaduraa6 a base fija | ASTM A36 | 0.172 | 0.172
139 | TT10_C05_OREJA_TENSOR_0
_1
1 | Oreja36x20x36;M16x2; soldaduraa6 a base fija | ASTM A36 | 0.172 | 0.172
140 | TT10_C05_OREJA_TENSOR_1
_0
1 | Oreja36x20x36;M16x2; soldaduraa6 a base fija | ASTM A36 | 0.172 | 0.172
141 | TT10_C05_OREJA_TENSOR_1
_1
1 | Oreja36x20x36;M16x2; soldaduraa6 a base fija | ASTM A36 | 0.172 | 0.172
142 | TT10_C05_POSTE_CORTO_T
ENSOR
1 | RHS50x50x5;L1037.5;recortado20para conservar altura del eje | S275J0H / EN 10219-1 | 7.330 | 7.330
143 | TT10_C05_POSTE_VOLANTE_
TENSOR
1 | Poste del volante recortado20mm; conservar mecanizado superior y centros | ASTM A36 | 23.316 | 23.316
144 | TT10_C05_RETEN_CAUTIVO_
SELECTOR
1 | Puente cautivo para pasadorD6;23mm hasta cabeza, permite
levantar16mm;4M4 laterales al bloque
ASTM A36 | 0.112 | 0.112
145 | TT10_CART_N_INF | 1 | Cartela horizontal20 entre puente y placa de nodo | ASTM A36 | 2.708 | 2.708
146 | TT10_CART_N_SUP | 1 | Cartela horizontal20 entre puente y placa de nodo | ASTM A36 | 2.708 | 2.708
147 | TT10_CART_P_INF | 1 | Cartela horizontal20 entre puente y placa de nodo | ASTM A36 | 2.708 | 2.708
148 | TT10_CART_P_SUP | 1 | Cartela horizontal20 entre puente y placa de nodo | ASTM A36 | 2.708 | 2.708
149 | TT10_COLLAR_N | 1 | Casquillo D220/d200.2 L161: transmisión de apriete y pista de sello | C45E / EN 10083-2 | 8.259 | 8.259
150 | TT10_COLLAR_P | 1 | Casquillo D220/d200.2 L161: transmisión de apriete y pista de sello | C45E / EN 10083-2 | 8.259 | 8.259
151 | TT10_D_ACOPLE_SALIDA | 1 | Acoplamiento de salida entre cubo y reductor; dibujo nominal | Equipo comprado | n/d | n/d
152 | TT10_D_ARMARIO | 1 | Armario de variador y control; representación de presentación | Armario comercial; chapa y acabado según referencia de compra | n/d | n/d
153 | TT10_D_ARO_RESGUARDO_N 1 | Resguardo tubular desmontable ARO_RESGUARDO_N | S275J0H / EN 10219-1 | 38.738 | 38.738
154 | TT10_D_ARO_RESGUARDO_P 1 | Resguardo tubular desmontable ARO_RESGUARDO_P | S275J0H / EN 10219-1 | 38.738 | 38.738
155 | TT10_D_AUX_4_1 | 1 | Reducción auxiliar 4:1; representación de arquitectura | Equipo sustituido por PSN 142 i5; no
| | | comprar variante 4:1 | n/d | n/d
156 | TT10_D_B16_0 | 32 | Perno nominal M16x50 | Clase 10.9 / ISO 898-1 | 0.118 | 3.778

SESUVECA / JAVIER ACEVEDO /25-10-2026 /No liberada para fabricación | 9

kg

157 | TT10_D_BASE_ARMARIO | 1 | Base del armario | ASTM A36 | 10.613 | 10.613
158 | TT10_D_BASE_BOTONERA | 1 | Base de botonera | ASTM A36 | 5.087 | 5.087
159 | TT10_D_BASE_FRENO_N | 1 | Base de pedestal de freno N | ASTM A36 | 14.978 | 14.978
160 | TT10_D_BASE_FRENO_P | 1 | Base de pedestal de freno P | ASTM A36 | 14.978 | 14.978
161 | TT10_D_BASE_MOTOR | 1 | Placa base del segundo apoyo de bancada | ASTM A36 | 42.390 | 42.390
162 | TT10_D_BASE_PRESENTE | 1 | Base del mando de hombre presente | ASTM A36 | 2.449 | 2.449
163 | TT10_D_BASE_RECUP_N | 1 | Base de mando de recuperación | ASTM A36 | 3.980 | 3.980
164 | TT10_D_BASE_RECUP_P | 1 | Base de mando de recuperación | ASTM A36 | 3.980 | 3.980
165 | TT10_D_BLANCO_PIN | 2 | Bandera de detección del pasador retirado | ASTM A36 | 0.078 | 0.155
166 | TT10_D_BOTONERA | 1 | Botonera: subir, bajar, retorno y paro de emergencia | Dispositivo de mando comercial; materiales según referencia OEM | n/d | n/d
167 | TT10_D_BOTON_0 | 1 | Pulsador 0 | Dispositivo de mando comercial; materiales según referencia OEM
n/d | n/d
168 | TT10_D_BOTON_1 | 1 | Pulsador 1 | Dispositivo de mando comercial; materiales según referencia OEM
n/d | n/d
169 | TT10_D_BOTON_2 | 1 | Pulsador 2 | Dispositivo de mando comercial; materiales según referencia OEM
n/d | n/d
170 | TT10_D_CABLE_PESTILLO_FI
N_N
1 | Eje de conexión geométrica CABLE_PESTILLO_FIN_N | Cable/conducción comercial; composición según ficha
n/d | n/d
171 | TT10_D_CABLE_PESTILLO_FI
N_P
1 | Eje de conexión geométrica CABLE_PESTILLO_FIN_P | Cable/conducción comercial; composición según ficha
n/d | n/d
172 | TT10_D_CABLE_PESTILLO_N | 1 | Eje de conexión geométrica CABLE_PESTILLO_N | Cable/conducción comercial; composición según ficha
n/d | n/d
173 | TT10_D_CABLE_PESTILLO_P | 1 | Eje de conexión geométrica CABLE_PESTILLO_P | Cable/conducción comercial; composición según ficha
n/d | n/d
174 | TT10_D_CABLE_PESTILLO_S
UP_N
1 | Eje de conexión geométrica CABLE_PESTILLO_SUP_N | Cable/conducción comercial; composición según ficha
n/d | n/d
175 | TT10_D_CABLE_PESTILLO_S
UP_P
1 | Eje de conexión geométrica CABLE_PESTILLO_SUP_P | Cable/conducción comercial; composición según ficha
n/d | n/d
176 | TT10_D_CABLE_PRESENTE | 1 | Eje de conexión geométrica CABLE_PRESENTE | Cable/conducción comercial; composición según ficha
n/d | n/d
177 | TT10_D_CARTELA_MOTOR_0 | 1 | Apoyo lateral desmontable de bancada | ASTM A36 | 4.160 | 4.160

SESUVECA / JAVIER ACEVEDO /25-10-2026 /No liberada para fabricación | 10

kg

178 | TT10_D_CARTELA_MOTOR_1 | 1 | Apoyo lateral desmontable de bancada | ASTM A36 | 4.160 | 4.160
179 | TT10_D_COLUMNA_MOTOR | 1 | Columna adicional RHS200x200; asiento sobre placa base | S275J0H / EN 10219-1 | 110.968 | 110.968
180 | TT10_D_CUBO_N | 1 | Cubo de conexión por apriete y brida de disco N | AISI 4140 bonificado | 76.969 | 76.969
181 | TT10_D_CUBO_P | 1 | Cubo de conexión por apriete y brida de disco P | AISI 4140 bonificado | 76.969 | 76.969
182 | TT10_D_DISCO_N | 1 | Disco de freno de salida N; diámetro nominal de dibujo | Equipo comprado | n/d | n/d
183 | TT10_D_DISCO_P | 1 | Disco de freno de salida P; diámetro nominal de dibujo | Equipo comprado | n/d | n/d
184 | TT10_D_ENCODER | 1 | Encoder de velocidad en eje motor | Equipo comprado | n/d | n/d
185 | TT10_D_ENTRADA_REDUCTO R | 1 | Eje de conexión geométrica ENTRADA_REDUCTOR | Equipo comprado; materiales y masa según ficha OEM | n/d | n/d
186 | TT10_D_LIBERACION_FRENO
_N
1 | Eje de conexión geométrica LIBERACION_FRENO_N | Mecanismo OEM Svendborg; incluido en pinza
n/d | n/d
187 | TT10_D_LIBERACION_FRENO
_P
1 | Eje de conexión geométrica LIBERACION_FRENO_P | Mecanismo OEM Svendborg; incluido en pinza
n/d | n/d
188 | TT10_D_MANDO_PRESENTE | 1 | Palanca de hombre presente para liberación manual nominal | ASTM A36 | 0.432 | 0.432
189 | TT10_D_MOTOR | 1 | Motor eléctrico con encoder; geometría nominal, potencia no seleccionada | Equipo comprado; materiales y masa según ficha OEM | n/d | n/d
190 | TT10_D_PALANCA_PESTILLO
_N
1 | Palanca accesible de recuperación del pestillo por cable | AISI 4140 bonificado | 0.471 | 0.471
191 | TT10_D_PALANCA_PESTILLO
_P
1 | Palanca accesible de recuperación del pestillo por cable | AISI 4140 bonificado | 0.471 | 0.471
192 | TT10_D_PALANCA_SELECTO
R
1 | Selector E-0-M a altura accesible; transmisión por varilla | ASTM A36 | 1.130 | 1.130
193 | TT10_D_PASTILLA_N0 | 1 | Pastilla de freno; contacto nominal intencional | Material de fricción OEM Svendborg; según suministro
n/d | n/d
194 | TT10_D_PASTILLA_N1 | 1 | Pastilla de freno; contacto nominal intencional | Material de fricción OEM Svendborg; según suministro
n/d | n/d
195 | TT10_D_PASTILLA_P0 | 1 | Pastilla de freno; contacto nominal intencional | Material de fricción OEM Svendborg; según suministro
n/d | n/d
196 | TT10_D_PASTILLA_P1 | 1 | Pastilla de freno; contacto nominal intencional | Material de fricción OEM Svendborg; según suministro
n/d | n/d
197 | TT10_D_PEDESTAL_AUX | 1 | Pedestal bajo reducción auxiliar | ASTM A36 | 95.150 | 95.150
198 | TT10_D_PEDESTAL_MOTOR | 1 | Soporte común de pies del motor | ASTM A36 | 223.796 | 223.796

SESUVECA / JAVIER ACEVEDO /25-10-2026 /No liberada para fabricación | 11

kg

199 | TT10_D_PINZA_N | 1 | Pinza de freno por resorte, liberación eléctrica N; envolvente nominal | Equipo comprado | n/d | n/d
200 | TT10_D_PINZA_P | 1 | Pinza de freno por resorte, liberación eléctrica P; envolvente nominal | Equipo comprado | n/d | n/d
201 | TT10_D_PLATAFORMA | 1 | Plataforma t40 con paso abierto de cadena ancho100, extremo R50; geometría nativa vigente | ASTM A36 | 406.204 | 406.204
202 | TT10_D_POSTE_ARMARIO | 1 | Soporte de armario | ASTM A36 | 4.944 | 4.944
203 | TT10_D_POSTE_BOTONERA | 1 | Poste de botonera fuera del plano de giro | ASTM A36 | 8.036 | 8.036
204 | TT10_D_POSTE_FRENO_N | 1 | Pedestal del freno N | ASTM A36 | 64.840 | 64.840
205 | TT10_D_POSTE_FRENO_P | 1 | Pedestal del freno P | ASTM A36 | 64.840 | 64.840
206 | TT10_D_POSTE_MANDO | 1 | Soporte del mando manual fuera del plano del volante | ASTM A36 | 5.256 | 5.256
207 | TT10_D_POSTE_RECUP_N | 1 | Soporte de manivela y desbloqueo manual N | ASTM A36 | 5.986 | 5.986
208 | TT10_D_POSTE_RECUP_P | 1 | Soporte de manivela y desbloqueo manual P | ASTM A36 | 5.986 | 5.986
209 | TT10_D_REDUCTOR | 1 | Reductor principal angular: carcasa y conexiones nominales | Equipo comprado; materiales y masa según ficha OEM | n/d | n/d
210 | TT10_D_RESORTE_FRENO_N | 1 | Paquete de resortes de aplicación del freno N | Acero de resorte OEM Svendborg; según suministro
n/d | n/d
211 | TT10_D_RESORTE_FRENO_P | 1 | Paquete de resortes de aplicación del freno P | Acero de resorte OEM Svendborg; según suministro
n/d | n/d
212 | TT10_D_ROD_SELECTOR | 1 | Eje de conexión geométrica ROD_SELECTOR | ASTM A36 | 2.004 | 2.004
213 | TT10_D_SALIDA_REDUCTOR | 1 | Eje de conexión geométrica SALIDA_REDUCTOR | Equipo comprado; materiales y masa según ficha OEM | n/d | n/d
214 | TT10_D_SENSOR_FRENO_N | 1 | Eje de conexión geométrica SENSOR_FRENO_N | Sensor comercial; materiales según referencia OEM
n/d | n/d
215 | TT10_D_SENSOR_FRENO_P | 1 | Eje de conexión geométrica SENSOR_FRENO_P | Sensor comercial; materiales según referencia OEM
n/d | n/d
216 | TT10_D_SOPORTE_FRENO_N | 1 | Placa de montaje de pinza N | ASTM A36 | 24.838 | 24.838
217 | TT10_D_SOPORTE_FRENO_P | 1 | Placa de montaje de pinza P | ASTM A36 | 24.838 | 24.838
218 | TT10_F416 | 1 | Placa base 600 x 500 x 50; 8 agujeros Ø40, centros X ±220, Y ±150 y ±50 | Strenx700E t50; Rp0.2min700MPa | 113.804 | 113.804
219 | TT10_F426 | 1 | Tope inclinado: cara inferior mecanizada para asiento horizontal | ASTM A36 | 3.490 | 3.490
220 | TT10_F431 | 1 | Pieza TT10_F431 | ASTM A36 | 84.780 | 84.780
221 | TT10_F441 | 1 | Placa80 con cuatro roscas M30 ciegas60, paso540x140; pernos desde arriba | ASTM A36 | 229.772 | 229.772

SESUVECA / JAVIER ACEVEDO /25-10-2026 /No liberada para fabricación | 12

kg

222 | TT10_F446 | 1 | Placa80 con cuatro roscas M30 ciegas60, paso540x140; pernos desde arriba
ASTM A36 | 229.772 | 229.772
223 | TT10_F456 | 1 | SKF SNL3048: dimensiones de interfaz según catálogo; fundición simplificada

Conjunto comprado; acero/ fundición según
OEM
139.000 | 139.000
224 | TT10_F471 | 1 | Perfil tubular 350 x 200 x 12; L 6300 | S275J0H / EN 10219-1 | 624.320 | 624.320
225 | TT10_F476 | 1 | Perfil tubular 350 x 200 x 12; L 6300 | S275J0H / EN 10219-1 | 624.320 | 624.320
226 | TT10_F481 | 1 | Pieza TT10_F481 | ASTM A36 | 19.782 | 19.782
227 | TT10_F486 | 1 | Oreja fija 400 x 250 x 40; agujero Ø65 H8; Strenx 700E | Strenx700E t40; Rp0.2min700MPa | 30.358 | 30.358
228 | TT10_F501 | 1 | Oreja fija 400 x 250 x 40; agujero Ø65 H8; Strenx 700E | Strenx700E t40; Rp0.2min700MPa | 30.358 | 30.358
229 | TT10_F506 | 1 | Poste independiente cajón 300 x 200 x 2395, t20; 2 diafragmas 260 x 160 x
| | | 20 | Strenx700E t20; Rp0.2min700MPa | 358.996 | 358.996
230 | TT10_F511 | 1 | Pieza TT10_F511 | ASTM A36 | 69.691 | 69.691
231 | TT10_F516 | 1 | Pieza TT10_F516 | ASTM A36 | 69.691 | 69.691
232 | TT10_F521 | 1 | Columna accionamiento apoyada sobre placa base | ASTM A36 | 201.844 | 201.844
233 | TT10_F526 | 1 | Perfil tubular 350 x 300 x 12; L 4800 | S275J0H / EN 10219-1 | 566.104 | 566.104
234 | TT10_F531 | 1 | Perfil tubular 350 x 300 x 12; L 4800 | S275J0H / EN 10219-1 | 566.104 | 566.104
235 | TT10_F536 | 1 | Soporte tope terminado en cara interior de columna | ASTM A36 | 13.424 | 13.424
236 | TT10_F541 | 1 | Diagonal CHS168.3x10 con cortes de asiento; sin penetrar columnas ni placas | S275J0H / EN 10219-1 | 92.378 | 92.378
237 | TT10_F546 | 1 | Puente RHS200x150x10 L1005; fuera del plano de las diagonales | S275J0H / EN 10219-1 | 52.069 | 52.069
238 | TT10_F551 | 1 | SKF SNL3048: dimensiones de interfaz según catálogo; fundición simplificada | Conjunto comprado; acero/ fundición según OEM | 139.000 | 139.000
239 | TT10_F556 | 1 | Soporte tope terminado en cara interior de columna | ASTM A36 | 13.424 | 13.424
240 | TT10_F561 | 1 | Pieza TT10_F561 | ASTM A36 | 19.782 | 19.782
241 | TT10_F566 | 1 | Pieza TT10_F566 | ASTM A36 | 69.691 | 69.691
242 | TT10_F571 | 1 | Pieza TT10_F571 | ASTM A36 | 69.691 | 69.691
243 | TT10_F576 | 1 | Oreja fija 400 x 250 x 40; agujero Ø65 H8; Strenx 700E | Strenx700E t40; Rp0.2min700MPa | 30.358 | 30.358
244 | TT10_F581 | 1 | Diagonal CHS168.3x10 con cortes de asiento; sin penetrar columnas ni placas | S275J0H / EN 10219-1 | 92.378 | 92.378
245 | TT10_F586 | 1 | Oreja fija 400 x 250 x 40; agujero Ø65 H8; Strenx 700E | Strenx700E t40; Rp0.2min700MPa | 30.358 | 30.358

SESUVECA / JAVIER ACEVEDO /25-10-2026 /No liberada para fabricación | 13

kg

246 | TT10_F591 | 1 | Placa base 600 x 500 x 50; 8 agujeros Ø40, centros X ±220, Y ±150 y ±50 | Strenx700E t50; Rp0.2min700MPa | 113.804 | 113.804
247 | TT10_F596 | 1 | Tope inclinado: cara inferior mecanizada para asiento horizontal | ASTM A36 | 3.490 | 3.490
248 | TT10_F601 | 1 | Diagonal CHS168.3x10 con cortes de asiento; sin penetrar columnas ni placas | S275J0H / EN 10219-1 | 92.378 | 92.378
249 | TT10_F606 | 1 | Diagonal CHS168.3x10 con cortes de asiento; sin penetrar columnas ni placas
S275J0H / EN 10219-1 | 92.378 | 92.378
250 | TT10_F611 | 1 | Poste independiente cajón 300 x 200 x 2395, t20; 2 diafragmas 260 x 160 x
| | | 20
Strenx700E t20; Rp0.2min700MPa | 358.996 | 358.996
251 | TT10_F621 | 1 | Puente RHS200x150x10 L1005; fuera del plano de las diagonales | S275J0H / EN 10219-1 | 52.069 | 52.069
252 | TT10_F626 | 1 | Pieza TT10_F626 | ASTM A36 | 69.691 | 69.691
253 | TT10_F631 | 1 | Pieza TT10_F631 | ASTM A36 | 69.691 | 69.691
254 | TT10_F636 | 1 | Columna principal recortada para placa80 y altura de centro SKF220 | S355J2; certificado 3.1 requerido | n/d | n/d
255 | TT10_F641 | 1 | Columna principal recortada para placa80 y altura de centro SKF220 | S355J2; certificado 3.1 requerido | n/d | n/d
256 | TT10_FRB_1 | 1 | SKF FRB21/360; lado P localizador | Conjunto comprado; acero/ fundición según OEM | n/d | n/d
257 | TT10_FRB_2 | 1 | SKF FRB21/360; lado P localizador | Conjunto comprado; acero/ fundición según OEM
n/d | n/d
258 | TT10_GUIA_N | 1 | Guía con alojamiento Ø69 H7; casquillo69/65.5; fuera del camino resistente | ASTM A36 | 13.567 | 13.567
259 | TT10_GUIA_P | 1 | Guía con alojamiento Ø69 H7; casquillo69/65.5; fuera del camino resistente | ASTM A36 | 13.567 | 13.567
260 | TT10_KM40_N | 1 | SKF KM40, M200x3, D250 B29; cuatro ranuras18x8 | Conjunto comprado; acero/ fundición según OEM | 3.350 | 3.350
261 | TT10_KM40_P | 1 | SKF KM40, M200x3, D250 B29; cuatro ranuras18x8 | Conjunto comprado; acero/ fundición según OEM
3.350 | 3.350
262 | TT10_LIN_0_0_B | 32 | Tornillo avellanado M16x80, cabeza90 D31, hexágono10; geometría nominal
Clase 10.9 / ISO 898-1 | 0.137 | 4.391
263 | TT10_LIN_0_0_C | 32 | Casquillo30/18 L25 limita compresión de elastómero | Acero C45 | 0.089 | 2.841
264 | TT10_LIN_0_0_N | 32 | Tuerca autoblocante metálica M16; rosca simplificada | Tuerca clase 8 / ISO 898-2 | 0.033 | 1.047
265 | TT10_LIN_0_0_W | 32 | Arandela M16 200HV D30/d17/t3 | Arandela endurecida 200 HV / ISO 7089 | 0.011 | 0.362
266 | TT10_LK_BC0 | 2 | TornilloM6x258.8; cabeza nominal, fijador de rosca y apriete por montaje | Clase 8.8 / ISO 898-1 | 0.009 | 0.018
267 | TT10_LK_BC1 | 2 | TornilloM6x258.8; cabeza nominal, fijador de rosca y apriete por montaje | Clase 8.8 / ISO 898-1 | 0.009 | 0.018
268 | TT10_LK_BC2 | 2 | TornilloM6x258.8; cabeza nominal, fijador de rosca y apriete por montaje | Clase 8.8 / ISO 898-1 | 0.009 | 0.018

SESUVECA / JAVIER ACEVEDO /25-10-2026 /No liberada para fabricación | 14

kg

269 | TT10_LK_BC3 | 2 | TornilloM6x258.8; cabeza nominal, fijador de rosca y apriete por montaje | Clase 8.8 / ISO 898-1 | 0.009 | 0.018
270 | TT10_LK_BL0 | 2 | TornilloM6x908.8; cabeza nominal, fijador de rosca y apriete por montaje | Clase 8.8 / ISO 898-1 | 0.024 | 0.047
271 | TT10_LK_BS0 | 2 | TornilloM10x258.8; cabeza nominal, fijador de rosca y apriete por montaje | Clase 8.8 / ISO 898-1 | 0.031 | 0.062
272 | TT10_LK_BS1 | 2 | TornilloM10x258.8; cabeza nominal, fijador de rosca y apriete por montaje | Clase 8.8 / ISO 898-1 | 0.031 | 0.062
273 | TT10_LK_BS2 | 2 | TornilloM10x258.8; cabeza nominal, fijador de rosca y apriete por montaje | Clase 8.8 / ISO 898-1 | 0.031 | 0.062
274 | TT10_LK_BS3 | 2 | TornilloM10x258.8; cabeza nominal, fijador de rosca y apriete por montaje | Clase 8.8 / ISO 898-1 | 0.031 | 0.062
275 | TT10_LK_BSE0 | 2 | TornilloISO4762 M6x20 8.8;5.4mm de rosca en guia, fijador y apriete4Nm | Clase 8.8 / ISO 898-1 | 0.008 | 0.016
276 | TT10_LK_BSE1 | 2 | TornilloISO4762 M6x20 8.8;5.4mm de rosca en guia, fijador y apriete4Nm | Clase 8.8 / ISO 898-1 | 0.008 | 0.016
277 | TT10_LK_GTCA100 | 2 | Magnet-Schultz GTCA100X43A02,24V,S1: envolvente e interfaces publicadas; no CAD oficial | Equipo comercial condicional; polvo desconocido | n/d | n/d
278 | TT10_LK_GUIA | 2 | Pestillo: guia abierta20.4x20.4, brazo25x42, pie80x12; asiento solenoide110/88
ASTM A36 | 4.759 | 9.519
279 | TT10_LK_LAMINA | 2 | Resorte de lamina20x1.8, longitud activa330, precarga equivalente50mm; forma instalada; horquillaU R6.5, sin esquina interna recta

51CrV4 templado/revenido;
Rp0.2≥1000MPa,Rm≥1250MPa; superficie y fatiga por verificar
0.093 | 0.186
280 | TT10_LK_MORDAZA_LAMINA | 2 | Mordaza30x20x9.1 para resorte; no soldar ni taladrar zona activa de la lamina
ASTM A36 | 0.040 | 0.081
281 | TT10_LK_NL0 | 2 | TuercaM6clase8, retencion positiva segun montaje | Tuerca clase 8 / ISO 898-2 | 0.002 | 0.005
282 | TT10_LK_NT | 2 | TuercaM6clase8, retencion positiva segun montaje | Tuerca clase 8 / ISO 898-2 | 0.002 | 0.005
283 | TT10_LK_PESTILLO | 2 | Pestillo42CrMo4+QT, punta20x20, enganche radial nominal9mm, retirada25mm; M12 liberacion | AISI 4140 bonificado | 0.232 | 0.463
284 | TT10_LK_SENSOR | 2 | ifmIE5338: sensor ordinarioPNP de enganche; M8x1, cara Y22, entrehierro nominal1mm
Sensor comercial; materiales según referencia OEM
n/d | n/d
285 | TT10_LK_SOP_SENSOR | 2 | Soporte desmontable: sensor a cara real del pestillo; dosM6x20, sin soldar a la guia
ASTM A36 | 0.097 | 0.194
286 | TT10_LK_TAPA | 2 | Tapa de guia desmontable; tornillo de recorrido y fijaciones de tapa pendientes de comprobacion
Clase 8.8 / ISO 898-1 | 0.306 | 0.612
287 | TT10_LK_TIRANTE | 2 | TiranteM12 nominal entre pestillo y solenoide; longitud ajustable, conexion OEM por verificar
ASTM A36 | 0.067 | 0.135
288 | TT10_LK_TOPE | 2 | Tornillo de hombroD8, paso de recorrido; conexion roscada nominal pendiente de detalle
Clase 10.9 / ISO 898-1 | 0.027 | 0.053
289 | TT10_LK_WC0 | 2 | ArandelaD12/d6.4/t1.6 | Arandela endurecida 300 HV / ISO 7089 | 0.001 | 0.002

SESUVECA / JAVIER ACEVEDO /25-10-2026 /No liberada para fabricación | 15

kg

290 | TT10_LK_WC1 | 2 | ArandelaD12/d6.4/t1.6 | Arandela endurecida 300 HV / ISO 7089 | 0.001 | 0.002
291 | TT10_LK_WC2 | 2 | ArandelaD12/d6.4/t1.6 | Arandela endurecida 300 HV / ISO 7089 | 0.001 | 0.002
292 | TT10_LK_WC3 | 2 | ArandelaD12/d6.4/t1.6 | Arandela endurecida 300 HV / ISO 7089 | 0.001 | 0.002
293 | TT10_LK_WL0 | 2 | ArandelaD12/d6.4/t1.6 | Arandela endurecida 300 HV / ISO 7089 | 0.001 | 0.002
294 | TT10_LK_WS0 | 2 | ArandelaD20/d10.5/t2 | Arandela endurecida 300 HV / ISO 7089 | 0.004 | 0.007
295 | TT10_LK_WS1 | 2 | ArandelaD20/d10.5/t2 | Arandela endurecida 300 HV / ISO 7089 | 0.004 | 0.007
296 | TT10_LK_WS2 | 2 | ArandelaD20/d10.5/t2 | Arandela endurecida 300 HV / ISO 7089 | 0.004 | 0.007
297 | TT10_LK_WS3 | 2 | ArandelaD20/d10.5/t2 | Arandela endurecida 300 HV / ISO 7089 | 0.004 | 0.007
298 | TT10_LK_WSE0 | 2 | ArandelaISO7089 M6 200HV | Arandela endurecida 200 HV / ISO 7089 | 0.001 | 0.002
299 | TT10_LK_WSE1 | 2 | ArandelaISO7089 M6 200HV | Arandela endurecida 200 HV / ISO 7089 | 0.001 | 0.002
300 | TT10_LK_WT | 2 | ArandelaD12/d6.4/t1.6 | Arandela endurecida 300 HV / ISO 7089 | 0.001 | 0.002
301 | TT10_M006 | 1 | Perfil tubular 200 x 150 x 10; L 2200 | S275J0H / EN 10219-1 | 113.982 | 113.982
302 | TT10_M011 | 1 | Perfil tubular 200 x 150 x 10; L 2200 | S275J0H / EN 10219-1 | 113.982 | 113.982
303 | TT10_M016 | 1 | Perfil tubular 150 x 100 x 8; L 4800 | S275J0H / EN 10219-1 | 141.074 | 141.074
304 | TT10_M021 | 1 | Perfil tubular 200 x 150 x 10; L 2200 | S275J0H / EN 10219-1 | 113.982 | 113.982
305 | TT10_M026 | 1 | Perfil tubular 150 x 100 x 8; L 3600 | S275J0H / EN 10219-1 | 105.805 | 105.805
306 | TT10_M031 | 1 | Pieza TT10_M031 | ASTM A36 | 18.304 | 18.304
307 | TT10_M036 | 1 | Pieza TT10_M036 | ASTM A36 | 18.086 | 18.086
308 | TT10_M041 | 1 | Perfil tubular 200 x 150 x 10; L 2200 | S275J0H / EN 10219-1 | 113.982 | 113.982
309 | TT10_M046 | 1 | Perfil tubular 400 x 200 x 16; L 5600 | S275J0H / EN 10219-1 | 799.017 | 799.017
310 | TT10_M051 | 1 | Pieza TT10_M051 | ASTM A36 | 18.117 | 18.117
311 | TT10_M056 | 1 | Cama elastomérica25 perforada para casquillos limitadores | Elastómero; curva dinámica de compresión por definir | 47.876 | 47.876
312 | TT10_M061 | 1 | Pieza TT10_M061 | ASTM A36 | 19.317 | 19.317
313 | TT10_M066 | 1 | Pieza TT10_M066 | ASTM A36 | 18.363 | 18.363
314 | TT10_M071 | 1 | Pieza TT10_M071 | ASTM A36 | 18.086 | 18.086
315 | TT10_M076 | 1 | Muñón forjado integral con brida550, hombro220, asiento200, R3 y retención exterior | AISI 4140 bonificado | 316.925 | 316.925

SESUVECA / JAVIER ACEVEDO /25-10-2026 /No liberada para fabricación | 16

kg

316 | TT10_M081 | 1 | Pieza TT10_M081 | ASTM A36 | 18.642 | 18.642
317 | TT10_M086 | 1 | Muñón forjado integral con brida550, hombro220, asiento200, R3 y retención exterior | AISI 4140 bonificado | 316.925 | 316.925
318 | TT10_M091 | 1 | Pieza TT10_M091 | ASTM A36 | 18.363 | 18.363
319 | TT10_M096 | 1 | Pieza TT10_M096 | ASTM A36 | 18.117 | 18.117
320 | TT10_M101 | 1 | Perfil tubular 200 x 100 x 10; L 250 | S275J0H / EN 10219-1 | 10.990 | 10.990
321 | TT10_M106 | 1 | Contraplaca80 con doce M30 ciegas78 PCD450, apriete desde exterior | ASTM A36 | 201.157 | 201.157
322 | TT10_M111 | 1 | Pieza TT10_M111 | ASTM A36 | 18.136 | 18.136
323 | TT10_M116 | 1 | Pieza TT10_M116 | ASTM A36 | 18.136 | 18.136
324 | TT10_M121 | 1 | Pieza TT10_M121 | ASTM A36 | 24.531 | 24.531
325 | TT10_M131 | 1 | Cabezal cajón 200 x 200 x 1200, t40; 2 diafragmas 120 x 120 x 40 | Strenx700E t40; Rp0.2min700MPa | 250.195 | 250.195
326 | TT10_M136 | 1 | Pieza TT10_M136 | ASTM A36 | 18.642 | 18.642
327 | TT10_M141 | 1 | Pieza TT10_M141 | ASTM A36 | 18.761 | 18.761
328 | TT10_M146 | 1 | Pieza TT10_M146 | ASTM A36 | 18.363 | 18.363
329 | TT10_M151 | 1 | Pieza TT10_M151 | ASTM A36 | 24.531 | 24.531
330 | TT10_M161 | 1 | Yugo cajón 400 x 200 x 1116, t30; 2 diafragmas 340 x 140 x 30; agujero Ø202 | Strenx700E t30; Rp0.2min700MPa | 291.169 | 291.169
331 | TT10_M166 | 1 | Perfil tubular 150 x 100 x 8; L 4800 | S275J0H / EN 10219-1 | 141.074 | 141.074
332 | TT10_M171 | 1 | Pieza TT10_M171 | ASTM A36 | 18.117 | 18.117
333 | TT10_M176 | 1 | Fondo16 con taladros de revestimientos desmontables | ASTM A36 | 883.201 | 883.201
334 | TT10_M181 | 1 | Pieza TT10_M181 | ASTM A36 | 18.642 | 18.642
335 | TT10_M186 | 1 | Perfil tubular 200 x 150 x 10; L 2200 | S275J0H / EN 10219-1 | 113.982 | 113.982
336 | TT10_M191 | 1 | Pieza TT10_M191 | ASTM A36 | 114.035 | 114.035
337 | TT10_M196 | 1 | Pieza TT10_M196 | ASTM A36 | 539.563 | 539.563
338 | TT10_M201 | 1 | Cabezal cajón 200 x 200 x 1200, t40; 2 diafragmas 120 x 120 x 40 | Strenx700E t40; Rp0.2min700MPa | 250.195 | 250.195
339 | TT10_M206 | 1 | Pieza TT10_M206 | ASTM A36 | 236.750 | 236.750
340 | TT10_M211 | 1 | Cama elastomérica25 perforada para casquillos limitadores | Elastómero; curva dinámica de compresión por definir | 47.876 | 47.876
341 | TT10_M216 | 1 | Pieza TT10_M216 | ASTM A36 | 18.086 | 18.086

SESUVECA / JAVIER ACEVEDO /25-10-2026 /No liberada para fabricación | 17

kg

342 | TT10_M221 | 1 | Cama elastomérica25 perforada para casquillos limitadores | Elastómero; curva dinámica de compresión por definir
47.876 | 47.876
343 | TT10_M226 | 1 | Perfil tubular 200 x 150 x 10; L 2200 | S275J0H / EN 10219-1 | 113.982 | 113.982
344 | TT10_M231 | 1 | Pieza TT10_M231 | ASTM A36 | 18.761 | 18.761
345 | TT10_M236 | 1 | Perfil tubular 150 x 100 x 8; L 3600 | S275J0H / EN 10219-1 | 105.805 | 105.805
346 | TT10_M241 | 1 | Cama elastomérica25 perforada para casquillos limitadores | Elastómero; curva dinámica de compresión por definir | 47.876 | 47.876
347 | TT10_M246 | 1 | Pieza TT10_M246 | ASTM A36 | 18.304 | 18.304
348 | TT10_M251 | 1 | Pieza TT10_M251 | ASTM A36 | 18.642 | 18.642
349 | TT10_M256 | 1 | Revestimiento AR400 t12 con ocho M16 avellanados desmontables | Hardox 400 | 157.079 | 157.079
350 | TT10_M261 | 1 | Pieza TT10_M261 | ASTM A36 | 14.719 | 14.719
351 | TT10_M266 | 1 | Revestimiento AR400 t12 con ocho M16 avellanados desmontables | Hardox 400 | 157.079 | 157.079
352 | TT10_M276 | 1 | Brazo monolítico Strenx 700E t50; perfil 800 x 650; R50; agujero Ø65,5 | Strenx700E t50; Rp0.2min700MPa | 120.363 | 120.363
353 | TT10_M281 | 1 | Pieza TT10_M281 | ASTM A36 | 18.761 | 18.761
354 | TT10_M286 | 1 | Pieza TT10_M286 | ASTM A36 | 19.317 | 19.317
355 | TT10_M291 | 1 | Pieza TT10_M291 | ASTM A36 | 18.117 | 18.117
356 | TT10_M296 | 1 | Pieza TT10_M296 | ASTM A36 | 18.136 | 18.136
357 | TT10_M301 | 1 | Pieza TT10_M301 | ASTM A36 | 19.317 | 19.317
358 | TT10_M311 | 1 | Yugo cajón 400 x 200 x 1116, t30; 2 diafragmas 340 x 140 x 30; agujero Ø202 | Strenx700E t30; Rp0.2min700MPa | 291.169 | 291.169
359 | TT10_M316 | 1 | Pieza TT10_M316 | ASTM A36 | 18.761 | 18.761
360 | TT10_M326 | 1 | Pieza TT10_M326 | ASTM A36 | 539.563 | 539.563
361 | TT10_M331 | 1 | Pieza TT10_M331 | ASTM A36 | 18.086 | 18.086
362 | TT10_M336 | 1 | Perfil tubular 200 x 100 x 10; L 250 | S275J0H / EN 10219-1 | 10.990 | 10.990
363 | TT10_M341 | 1 | Pieza TT10_M341 | ASTM A36 | 18.136 | 18.136
364 | TT10_M346 | 1 | Pieza TT10_M346 | ASTM A36 | 18.363 | 18.363
365 | TT10_M351 | 1 | Brazo monolítico Strenx 700E t50; perfil 800 x 650; R50; agujero Ø65,5 | Strenx700E t50; Rp0.2min700MPa | 120.363 | 120.363
366 | TT10_M356 | 1 | Perfil tubular 400 x 200 x 16; L 5600 | S275J0H / EN 10219-1 | 799.017 | 799.017
367 | TT10_M361 | 1 | Pieza TT10_M361 | ASTM A36 | 18.304 | 18.304

SESUVECA / JAVIER ACEVEDO /25-10-2026 /No liberada para fabricación | 18

kg

368 | TT10_M371 | 1 | Pieza TT10_M371 | ASTM A36 | 14.719 | 14.719
369 | TT10_M376 | 1 | Contraplaca80 con doce M30 ciegas78 PCD450, apriete desde exterior | ASTM A36 | 201.157 | 201.157
370 | TT10_M381 | 1 | Perfil tubular 200 x 150 x 10; L 2200 | S275J0H / EN 10219-1 | 113.982 | 113.982
371 | TT10_M386 | 1 | Revestimiento AR400 t12 con ocho M16 avellanados desmontables | Hardox 400 | 157.079 | 157.079
372 | TT10_M391 | 1 | Revestimiento AR400 t12 con ocho M16 avellanados desmontables | Hardox 400 | 157.079 | 157.079
373 | TT10_M396 | 1 | Pieza TT10_M396 | ASTM A36 | 19.317 | 19.317
374 | TT10_M401 | 1 | Pieza TT10_M401 | ASTM A36 | 393.190 | 393.190
375 | TT10_M406 | 1 | Pieza TT10_M406 | ASTM A36 | 18.304 | 18.304
376 | TT10_M411 | 1 | Pieza TT10_M411 | ASTM A36 | 393.190 | 393.190
377 | TT10_MB40_N | 1 | MB40 comprada: una pestana plegada nominal en KM40; restantes18 planas | Acero arandela comercial Timken MB40; variante a confirmar | 0.280 | 0.280
378 | TT10_MB40_P | 1 | MB40 comprada: una pestana plegada nominal en KM40; restantes18 planas

Acero arandela comercial Timken MB40; variante a confirmar

0.280 | 0.280
379 | TT10_N20_P1I | 16 | Tuerca M20 clase8; rosca simplificada | Tuerca clase 8 / ISO 898-2 | 0.058 | 0.935
380 | TT10_NODO_N | 1 | Placa de nodo20: unión entre puente desplazado y columna principal | ASTM A36 | 17.074 | 17.074
381 | TT10_NODO_P | 1 | Placa de nodo20: unión entre puente desplazado y columna principal | ASTM A36 | 17.074 | 17.074
382 | TT10_PE_ACT_CUERPO | 2 | Thomson HD24B026-0250LPS2MMSD: interfaces nominales y envolvente conservadora, NO CAD oficial | Conjunto comercial; selección condicionada | n/d | n/d
383 | TT10_PE_ACT_VASTAGO | 2 | Extremo y vástago comercial nominal D30.2; taladro12.2; parte móvil de candidato Thomson
Subcomponente de actuador comercial | n/d | n/d
384 | TT10_PE_BA0 | 2 | Tornillo M8x40 clase8.8, rosca nominal; fijador de rosca según montaje | Clase 8.8 / ISO 898-1 | 0.023 | 0.046
385 | TT10_PE_BA1 | 2 | Tornillo M8x40 clase8.8, rosca nominal; fijador de rosca según montaje | Clase 8.8 / ISO 898-1 | 0.023 | 0.046
386 | TT10_PE_BA2 | 2 | Tornillo M8x40 clase8.8, rosca nominal; fijador de rosca según montaje | Clase 8.8 / ISO 898-1 | 0.023 | 0.046
387 | TT10_PE_BA3 | 2 | Tornillo M8x40 clase8.8, rosca nominal; fijador de rosca según montaje | Clase 8.8 / ISO 898-1 | 0.023 | 0.046
388 | TT10_PE_BEF | 2 | ISO7380-1 M6x10 8.8; cabeza baja D10.5 H3.3 envolvente; hexágono4; fijador de rosca requerido | Clase 8.8 / ISO 898-1 | 0.004 | 0.009
389 | TT10_PE_BER | 2 | Tornillo M8x12 clase8.8, rosca nominal; fijador de rosca según montaje | Clase 8.8 / ISO 898-1 | 0.012 | 0.024
390 | TT10_PE_BF0 | 2 | Tornillo M10x25 clase8.8, rosca nominal; fijador de rosca según montaje | Clase 8.8 / ISO 898-1 | 0.029 | 0.058
391 | TT10_PE_BF1 | 2 | Tornillo M10x25 clase8.8, rosca nominal; fijador de rosca según montaje | Clase 8.8 / ISO 898-1 | 0.029 | 0.058

SESUVECA / JAVIER ACEVEDO /25-10-2026 /No liberada para fabricación | 19

kg

392 | TT10_PE_BR0 | 2 | Tornillo M10x25 clase8.8, rosca nominal; fijador de rosca según montaje | Clase 8.8 / ISO 898-1 | 0.029 | 0.058
393 | TT10_PE_BR1 | 2 | Tornillo M10x25 clase8.8, rosca nominal; fijador de rosca según montaje | Clase 8.8 / ISO 898-1 | 0.029 | 0.058
394 | TT10_PE_EJE_F | 2 | Bulón articulación D12 h8, cabeza20x4, M6-6H axial profundidad12; arandela y tornillo de retención | Arandela endurecida 300 HV / ISO 7089 | 0.053 | 0.106
395 | TT10_PE_EJE_R | 2 | Bulón articulación D12 h8, cabeza20x4, M8-6H axial profundidad12; arandela y tornillo de retención
Arandela endurecida 300 HV / ISO 7089 | 0.047 | 0.094
396 | TT10_PE_HORQ_F | 2 | Horquilla frontal integral S355: base60x10, separación31.2, dos orejas10, D12.2H8; 2M10 de fijación
ASTM A36 | 0.402 | 0.804
397 | TT10_PE_HORQ_R | 2 | Horquilla trasera mecanizada: base130x60x10; separación26.4; eje12; 2M10 ASTM A36 | 0.830 | 1.660
398 | TT10_PE_LARG_L | 2 | Larguero S355 plano12x80; corte a longitud503.0 | ASTM A36 | 3.791 | 7.581
399 | TT10_PE_LARG_R | 2 | Larguero S355 plano12x80; corte a longitud503.0 | ASTM A36 | 3.791 | 7.581
400 | TT10_PE_NA0 | 2 | Tuerca M8 clase8; rosca nominal, retención por fijador especificado | Tuerca clase 8 / ISO 898-2 | 0.005 | 0.010
401 | TT10_PE_NA1 | 2 | Tuerca M8 clase8; rosca nominal, retención por fijador especificado | Tuerca clase 8 / ISO 898-2 | 0.005 | 0.010
402 | TT10_PE_NA2 | 2 | Tuerca M8 clase8; rosca nominal, retención por fijador especificado | Tuerca clase 8 / ISO 898-2 | 0.005 | 0.010
403 | TT10_PE_NA3 | 2 | Tuerca M8 clase8; rosca nominal, retención por fijador especificado | Tuerca clase 8 / ISO 898-2 | 0.005 | 0.010
404 | TT10_PE_PIN | 2 | Pasador Ø65 f7 x 330; cabeza Ø90 x 15; R3; 34CrNiMo6+QT Rp0,2 mín.800 MPa | 34CrNiMo6+QT; Rp0,2 mín.800 MPa, sección<=100mm | 9.326 | 18.651
405 | TT10_PE_PLACA_F | 2 | Placa de bastidor160x160x12; D70;4D9 y4aliviosD42 abiertos en esquinas para tuercas existentes
ASTM A36 | 1.486 | 2.972
406 | TT10_PE_PLACA_R | 2 | Travesaño160x80x12; 2M10-6H pasantes en X±45; frentes soldados a largueros
ASTM A36 | 1.191 | 2.382
407 | TT10_PE_RETEN | 2 | Placa cautiva160x160x15: amplía paso aD68,4D22 original; añade4D9 en X±45 Z±30
ASTM A36 | 2.378 | 4.756
408 | TT10_PE_WA0 | 2 | Arandela D16/d8.4/t1.6 | Arandela endurecida 300 HV / ISO 7089 | 0.002 | 0.004
409 | TT10_PE_WA1 | 2 | Arandela D16/d8.4/t1.6 | Arandela endurecida 300 HV / ISO 7089 | 0.002 | 0.004
410 | TT10_PE_WA2 | 2 | Arandela D16/d8.4/t1.6 | Arandela endurecida 300 HV / ISO 7089 | 0.002 | 0.004
411 | TT10_PE_WA3 | 2 | Arandela D16/d8.4/t1.6 | Arandela endurecida 300 HV / ISO 7089 | 0.002 | 0.004
412 | TT10_PE_WEF | 2 | Arandela D12/d6.4/t1.6 | Arandela endurecida 300 HV / ISO 7089 | 0.001 | 0.002
413 | TT10_PE_WER | 2 | Arandela D20/d8.4/t2 | Arandela endurecida 300 HV / ISO 7089 | 0.004 | 0.008
414 | TT10_PE_WF0 | 2 | Arandela D20/d10.5/t2 | Arandela endurecida 300 HV / ISO 7089 | 0.004 | 0.007

SESUVECA / JAVIER ACEVEDO /25-10-2026 /No liberada para fabricación | 20

kg

415 | TT10_PE_WF1 | 2 | Arandela D20/d10.5/t2 | Arandela endurecida 300 HV / ISO 7089 | 0.004 | 0.007
416 | TT10_PE_WN0 | 2 | Arandela D16/d8.4/t1.6 | Arandela endurecida 300 HV / ISO 7089 | 0.002 | 0.004
417 | TT10_PE_WN1 | 2 | Arandela D16/d8.4/t1.6 | Arandela endurecida 300 HV / ISO 7089 | 0.002 | 0.004
418 | TT10_PE_WN2 | 2 | Arandela D16/d8.4/t1.6 | Arandela endurecida 300 HV / ISO 7089 | 0.002 | 0.004
419 | TT10_PE_WN3 | 2 | Arandela D16/d8.4/t1.6 | Arandela endurecida 300 HV / ISO 7089 | 0.002 | 0.004
420 | TT10_PE_WR0 | 2 | Arandela D20/d10.5/t2 | Arandela endurecida 300 HV / ISO 7089 | 0.004 | 0.007
421 | TT10_PE_WR1 | 2 | Arandela D20/d10.5/t2 | Arandela endurecida 300 HV / ISO 7089 | 0.004 | 0.007
422 | TT10_PUENTE_N | 1 | Puente guía A36 525 x 125 x 25; recorte 225 x 10 junto al poste | ASTM A36 t25 | 12.437 | 12.437
423 | TT10_PUENTE_P | 1 | Puente guía A36 525 x 125 x 25; recorte 225 x 10 junto al poste | ASTM A36 t25 | 12.437 | 12.437
424 | TT10_R6M_BRAZO_SENSOR_ N_INSERTADO | 1 | Brazo fijo de detector; unión soldada a pie sobre larguero | ASTM A36 | 0.475 | 0.475
425 | TT10_R6M_BRAZO_SENSOR_
N_RETIRADO
1 | Brazo fijo de detector; unión soldada a pie sobre larguero | ASTM A36 | 0.080 | 0.080
426 | TT10_R6M_BRAZO_SENSOR_
P_INSERTADO
1 | Brazo fijo de detector; unión soldada a pie sobre larguero | ASTM A36 | 0.475 | 0.475
427 | TT10_R6M_BRAZO_SENSOR_
P_RETIRADO
1 | Brazo fijo de detector; unión soldada a pie sobre larguero | ASTM A36 | 0.080 | 0.080
428 | TT10_R6M_CHAVETA_FRENO
_TIMON
1 | ChavetaDIN6885/1 8x7x25 C45E | AISI 4140 bonificado | 0.011 | 0.011
429 | TT10_R6M_CUBO_FRENO_TI
MON
1 | Cubo comercial simplificado: Ø30H7,8JS9;L25; verificar suministro con
referencia mayr
AISI 4140 bonificado | 0.273 | 0.273
430 | TT10_R6M_IE5338_N_INSERT
ADO
1 | ifmIE5338,M8x1L40,SN3mm;N INSERTADO | Conjunto comercial ifm | n/d | n/d
431 | TT10_R6M_IE5338_N_RETIRA
DO
1 | ifmIE5338,M8x1L40,SN3mm;N RETIRADO | Conjunto comercial ifm | n/d | n/d
432 | TT10_R6M_IE5338_P_INSERT
ADO
1 | ifmIE5338,M8x1L40,SN3mm;P INSERTADO | Conjunto comercial ifm | n/d | n/d
433 | TT10_R6M_IE5338_P_RETIRA
DO
1 | ifmIE5338,M8x1L40,SN3mm;P RETIRADO | Conjunto comercial ifm | n/d | n/d
434 | TT10_R6M_MAYR_32 | 1 | mayr32/891.101.0/24/30/6885/1 JS9;64Nm; rotor metálico; liberación manual
Conjunto comercial mayr | 4.500 | 4.500
435 | TT10_R6M_PEDESTAL_FREN
O
1 | Travesaño108x40x10 entre caras interiores del poste existente; soldadura
a3,40mm por extremo
ASTM A36 | 0.339 | 0.339

SESUVECA / JAVIER ACEVEDO /25-10-2026 /No liberada para fabricación | 21

kg

436 | TT10_R6M_PIE_SENSORES_N 1 | Pie12 sobre cara superior del larguero; soldadura a3,20mm por ambas caras ASTM A36 | 0.236 | 0.236
437 | TT10_R6M_PIE_SENSORES_P | 1 | Pie12 sobre cara superior del larguero; soldadura a3,20mm por ambas caras ASTM A36 | 0.236 | 0.236
438 | TT10_R6M_PLACA_FRENO_TI MON | 1 | Placa12, caraX1127; centrado y3M6PCD132; sujeción a pedestal por cartelas
| | | ASTM A36 | 1.894 | 1.894
439 | TT10_R6M_SOP_SENSOR_N_I
NSERTADO
1 | Escuadra6;taladroØ8.5 para sensorM8;frente de detección a1mm del blanco ASTM A36 | 0.110 | 0.110
440 | TT10_R6M_SOP_SENSOR_N_
RETIRADO
1 | Escuadra6;taladroØ8.5 para sensorM8;frente de detección a1mm del blanco ASTM A36 | 0.110 | 0.110
441 | TT10_R6M_SOP_SENSOR_P_I
NSERTADO
1 | Escuadra6;taladroØ8.5 para sensorM8;frente de detección a1mm del blanco ASTM A36 | 0.110 | 0.110
442 | TT10_R6M_SOP_SENSOR_P_
RETIRADO
1 | Escuadra6;taladroØ8.5 para sensorM8;frente de detección a1mm del blanco ASTM A36 | 0.110 | 0.110
443 | TT10_SEN_B6_P0 | 4 | Tornillo ISO4762 M6x16 8.8, cabeza D10 H6, hexágono5; rosca nominal | Clase 8.8 / ISO 898-1 | 0.007 | 0.027
444 | TT10_SEN_P_IN | 4 | IFM IE5338 M8x1 L40, Sn3, NO PNP/NPN, 10-30VDC; incluye dos contratuercas | Conjunto comercial IFM; latón y polímeros | 0.017 | 0.066
445 | TT10_SEN_SOP_P | 2 | Soporte soldado desmontable: carril6x40x229 y pie4x40x16.5; dos M6x16; dos D8.5
ASTM A36 | 0.445 | 0.889
446 | TT10_TIR_N1 | 1 | Tirante M20 propuesto, L380; rosca simplificada | ASTM A36 | 0.937 | 0.937
447 | TT10_TIR_N2 | 1 | Tirante M20 propuesto, L380; rosca simplificada | ASTM A36 | 0.937 | 0.937
448 | TT10_TIR_N3 | 1 | Tirante M20 propuesto, L380; rosca simplificada | ASTM A36 | 0.937 | 0.937
449 | TT10_TIR_N4 | 1 | Tirante M20 propuesto, L380; rosca simplificada | ASTM A36 | 0.937 | 0.937
450 | TT10_TIR_P1 | 1 | Tirante M20 propuesto, L380; rosca simplificada | ASTM A36 | 0.937 | 0.937
451 | TT10_TIR_P2 | 1 | Tirante M20 propuesto, L380; rosca simplificada | ASTM A36 | 0.937 | 0.937
452 | TT10_TIR_P3 | 1 | Tirante M20 propuesto, L380; rosca simplificada | ASTM A36 | 0.937 | 0.937
453 | TT10_TIR_P4 | 1 | Tirante M20 propuesto, L380; rosca simplificada | ASTM A36 | 0.937 | 0.937
454 | TT10_TM_ARANDELA16 | 1 | Arandela de retención D44/d17/t4 | Arandela endurecida 300 HV / ISO 7089 | 0.041 | 0.041
455 | TT10_TM_B12_0 | 1 | Tornillo M12x40 8.8, s18, rosca nominal; enganche20.5mm en placa | Clase 8.8 / ISO 898-1 | 0.052 | 0.052
456 | TT10_TM_B12_1 | 1 | Tornillo M12x40 8.8, s18, rosca nominal; enganche20.5mm en placa | Clase 8.8 / ISO 898-1 | 0.052 | 0.052
457 | TT10_TM_B12_2 | 1 | Tornillo M12x40 8.8, s18, rosca nominal; enganche20.5mm en placa | Clase 8.8 / ISO 898-1 | 0.052 | 0.052
458 | TT10_TM_B12_3 | 1 | Tornillo M12x40 8.8, s18, rosca nominal; enganche20.5mm en placa | Clase 8.8 / ISO 898-1 | 0.052 | 0.052

SESUVECA / JAVIER ACEVEDO /25-10-2026 /No liberada para fabricación | 22

kg

459 | TT10_TM_CHAVETA | 1 | Chaveta paralela8x7x40, extremos R4, formaA; acero C45E | AISI 4140 bonificado | 0.017 | 0.017
460 | TT10_TM_CUBO | 1 | Cubo D80/D30 H7 L45; chavetero8 JS9, profundidad3.3 sobre radio nominal AISI 4140 bonificado | 1.516 | 1.516
461 | TT10_TM_EJE_PUNO | 1 | Perno escalonado: M8, hombro14, pistaD10 h9 L87.3 y cabeza16; pistaRa≤0.8 | Clase 10.9 / ISO 898-1 | 0.079 | 0.079
462 | TT10_TM_PUNO | 1 | Empuñadura giratoria POM D32/d10.4 L85 | POM-C; ficha de proveedor requerida | 0.086 | 0.086
463 | TT10_TM_PUNO_N8 | 1 | Tuerca autoblocante metálica M8 h8 s13; geometría nominal | Tuerca clase 8 / ISO 898-2 | 0.006 | 0.006
464 | TT10_TM_PUNO_W0 | 1 | Arandela lisa D20/d10.5/t1 para empuñadura | Arandela endurecida 300 HV / ISO 7089 | 0.002 | 0.002
465 | TT10_TM_PUNO_W1 | 1 | Arandela lisa D20/d10.5/t1 para empuñadura | Arandela endurecida 300 HV / ISO 7089 | 0.002 | 0.002
466 | TT10_TM_PUNO_W8 | 1 | Arandela M8 D16/d8.4/t1.6 | Arandela endurecida 300 HV / ISO 7089 | 0.002 | 0.002
467 | TT10_TM_SY30_0 | 3 | SKF SY30TF, d30, H42.9, base152x40, pasos117.5; interfaces nominales | Conjunto comprado; acero/ fundición según OEM | 1.100 | 3.300
468 | TT10_TM_SY30_1 | 1 | SKF SY30TF, d30, H42.9, base152x40, pasos117.5; interfaces nominales | Conjunto comprado; acero/ fundición según OEM
1.100 | 1.100
469 | TT10_TM_TORNILLO16 | 1 | Tornillo M16x35 clase8.8, s24; retiene axialmente rueda y cubo | Clase 8.8 / ISO 898-1 | 0.094 | 0.094
470 | TT10_TM_VOLANTE | 1 | Volante D500 t12, cuatro radios; D8.5 para empuñadura; soldado al cubo | ASTM A36 | 6.888 | 6.888
471 | TT10_TM_W12_0 | 1 | Arandela M12 D24/d13/t2.5 | Arandela endurecida 300 HV / ISO 7089 | 0.006 | 0.006
472 | TT10_TM_W12_1 | 1 | Arandela M12 D24/d13/t2.5 | Arandela endurecida 300 HV / ISO 7089 | 0.006 | 0.006
473 | TT10_TM_W12_2 | 1 | Arandela M12 D24/d13/t2.5 | Arandela endurecida 300 HV / ISO 7089 | 0.006 | 0.006
474 | TT10_TM_W12_3 | 1 | Arandela M12 D24/d13/t2.5 | Arandela endurecida 300 HV / ISO 7089 | 0.006 | 0.006
475 | TT10_TNF_N1 | 1 | SKF TNF48; reserva dimensional axial A2=380 | Conjunto comprado; acero/ fundición según OEM | n/d | n/d
476 | TT10_TNF_N2 | 1 | SKF TNF48; reserva dimensional axial A2=380 | Conjunto comprado; acero/ fundición según OEM
n/d | n/d
477 | TT10_TNF_P1 | 1 | SKF TNF48; reserva dimensional axial A2=380 | Conjunto comprado; acero/ fundición según OEM
n/d | n/d
478 | TT10_TNF_P2 | 1 | SKF TNF48; reserva dimensional axial A2=380 | Conjunto comprado; acero/ fundición según OEM
n/d | n/d
479 | TT10_TOPE70_N_INFD | 1 | Cartela horizontal20: transmite componente transversal del tope70 | ASTM A36 | 1.492 | 1.492
480 | TT10_TOPE70_N_INFI | 1 | Cartela horizontal20: transmite componente transversal del tope70 | ASTM A36 | 2.237 | 2.237
481 | TT10_TOPE70_N_SUPD | 1 | Cartela horizontal20: transmite componente transversal del tope70 | ASTM A36 | 1.119 | 1.119

SESUVECA / JAVIER ACEVEDO /25-10-2026 /No liberada para fabricación | 23

kg

482 | TT10_TOPE70_N_SUPI | 1 | Cartela horizontal20: transmite componente transversal del tope70 | ASTM A36 | 2.237 | 2.237
483 | TT10_TOPE70_N_V1 | 1 | Cartela vertical20 de tope70; apoyo al bloque y cara de columna | ASTM A36 | 4.474 | 4.474
484 | TT10_TOPE70_N_V2 | 1 | Cartela vertical20 de tope70; apoyo al bloque y cara de columna | ASTM A36 | 4.474 | 4.474
485 | TT10_TOPE70_P_INFD | 1 | Cartela horizontal20: transmite componente transversal del tope70 | ASTM A36 | 1.492 | 1.492
486 | TT10_TOPE70_P_INFI | 1 | Cartela horizontal20: transmite componente transversal del tope70 | ASTM A36 | 2.237 | 2.237
487 | TT10_TOPE70_P_SUPD | 1 | Cartela horizontal20: transmite componente transversal del tope70 | ASTM A36 | 1.119 | 1.119
488 | TT10_TOPE70_P_SUPI | 1 | Cartela horizontal20: transmite componente transversal del tope70 | ASTM A36 | 2.237 | 2.237
489 | TT10_TOPE70_P_V1 | 1 | Cartela vertical20 de tope70; apoyo al bloque y cara de columna | ASTM A36 | 4.474 | 4.474
490 | TT10_TOPE70_P_V2 | 1 | Cartela vertical20 de tope70; apoyo al bloque y cara de columna | ASTM A36 | 4.474 | 4.474
491 | TT10_W20_P1I | 16 | Arandela D37 D21 t3 | Arandela endurecida 300 HV / ISO 7089 | n/d | n/d
492 | TT10_W30_AP_P02227.5 | 32 | Arandela ISO7089 M30 300HV, D56 d31 t4 | Arandela endurecida 300 HV / ISO 7089 | 0.054 | 1.716

SESUVECA / JAVIER ACEVEDO /25-10-2026 /No liberada para fabricación | 24

# Despiece interno de seis cajones soldados

18 definiciones /36 chapas. Masa de este despiece: 1 800.720 kg, YA INCLUIDA en los seis padres de la BOM CAD. No se suma otra vez al subtotal general.

Padre CAD | Código de corte | Cant. | Chapa | Ancho × alto × esp. mm | Material | Masa incl. kg
TT10_M161 | TT10_M161_CH01 | 2 | Placa perforada; 1 taladro Ø202 mm por chapa | 400 × 1116 × 30 | Strenx700E t30; Rp0.2min700MPa | 195.160
TT10_M161 | TT10_M161_CH02 | 2 | Placa lateral | 140 × 1116 × 30 | Strenx700E t30; Rp0.2min700MPa | 73.589
TT10_M161 | TT10_M161_CH03 | 2 | Diafragma | 340 × 140 × 30 | Strenx700E t30; Rp0.2min700MPa | 22.420
TT10_M311 | TT10_M311_CH01 | 2 | Placa perforada; 1 taladro Ø202 mm por chapa | 400 × 1116 × 30 | Strenx700E t30; Rp0.2min700MPa | 195.160
TT10_M311 | TT10_M311_CH02 | 2 | Placa lateral | 140 × 1116 × 30 | Strenx700E t30; Rp0.2min700MPa | 73.589
TT10_M311 | TT10_M311_CH03 | 2 | Diafragma | 340 × 140 × 30 | Strenx700E t30; Rp0.2min700MPa | 22.420
TT10_M201 | TT10_M201_CH01 | 2 | Placa exterior | 1200 × 200 × 40 | Strenx700E t40; Rp0.2min700MPa | 150.720
TT10_M201 | TT10_M201_CH02 | 2 | Placa lateral | 1200 × 120 × 40 | Strenx700E t40; Rp0.2min700MPa | 90.432
TT10_M201 | TT10_M201_CH03 | 2 | Diafragma | 120 × 120 × 40 | Strenx700E t40; Rp0.2min700MPa | 9.043
TT10_M131 | TT10_M131_CH01 | 2 | Placa exterior | 1200 × 200 × 40 | Strenx700E t40; Rp0.2min700MPa | 150.720
TT10_M131 | TT10_M131_CH02 | 2 | Placa lateral | 1200 × 120 × 40 | Strenx700E t40; Rp0.2min700MPa | 90.432
TT10_M131 | TT10_M131_CH03 | 2 | Diafragma | 120 × 120 × 40 | Strenx700E t40; Rp0.2min700MPa | 9.043
TT10_F506 | TT10_F506_CH01 | 2 | Placa exterior | 300 × 2395 × 20 | Strenx700E t20; Rp0.2min700MPa | 225.609
TT10_F506 | TT10_F506_CH02 | 2 | Placa lateral | 160 × 2395 × 20 | Strenx700E t20; Rp0.2min700MPa | 120.325
TT10_F506 | TT10_F506_CH03 | 2 | Diafragma | 260 × 160 × 20 | Strenx700E t20; Rp0.2min700MPa | 13.062
TT10_F611 | TT10_F611_CH01 | 2 | Placa exterior | 300 × 2395 × 20 | Strenx700E t20; Rp0.2min700MPa | 225.609
TT10_F611 | TT10_F611_CH02 | 2 | Placa lateral | 160 × 2395 × 20 | Strenx700E t20; Rp0.2min700MPa | 120.325
TT10_F611 | TT10_F611_CH03 | 2 | Diafragma | 260 × 160 × 20 | Strenx700E t20; Rp0.2min700MPa | 13.062
