acevedocrisologopablo48-lgtm/sesuveca-tolva-p04/dist/documentos/TT10_BOM_COMPRAS.xlsx

Sheet: Compras
TOLVA TROMPO - COMPRAS
Cantidades del ensamblaje activo; sin cotización ni autorización de compra.

Sheet: Fabricación
TOLVA TROMPO - MATERIALES DE FABRICACIÓN / 25-10-2026
Pos. | Código | Piezas | Forma | Material | Descripción / corte | Espesor | Ancho | Alto | Largo | Cantidad material | Unidad | Plano | Dato para pedido
4 | TT10_BUJE_PIN_N | 1 | Según plano | CuSn12 / EN 1982 | Casquillo CuSn12 Ø69 s6 / Ø65.5 H9 final, L85, C0.5 interiores |  |  |  |  | 1.000 | ud | TT10_C05_PC_13 | Dimensiones y mecanizados según plano nativo actualizado.
5 | TT10_BUJE_PIN_P | 1 | Según plano | CuSn12 / EN 1982 | Casquillo CuSn12 Ø69 s6 / Ø65.5 H9 final, L85, C0.5 interiores |  |  |  |  | 1.000 | ud | TT10_C05_PC_13 | Dimensiones y mecanizados según plano nativo actualizado.
6 | TT10_C03_ACCESO_PUERTO_N | 1 | Según plano | ASTM A36 | Guia de herramienta desde exterior N; puerto nominal rear+15.5/Z+53.7; NO conexion remota al actuador |  |  |  |  | 1.000 | ud | TT10_C05_PC_24 | Dimensiones y mecanizados según plano nativo actualizado.
7 | TT10_C03_ACCESO_PUERTO_P | 1 | Según plano | ASTM A36 | Guia de herramienta desde exterior P; puerto nominal rear+15.5/Z+53.7; NO conexion remota al actuador |  |  |  |  | 1.000 | ud | TT10_C05_PC_24 | Dimensiones y mecanizados según plano nativo actualizado.
13 | TT10_C03_REGISTRO_PUERTO_N | 1 | Según plano | ASTM A36 | Registro exterior desmontable3 con accesoD50; fijaciones/proteccion de puesto por completar |  |  |  |  | 1.000 | ud | TT10_C05_PC_24 | Dimensiones y mecanizados según plano nativo actualizado.
14 | TT10_C03_REGISTRO_PUERTO_P | 1 | Según plano | ASTM A36 | Registro exterior desmontable3 con accesoD50; fijaciones/proteccion de puesto por completar |  |  |  |  | 1.000 | ud | TT10_C05_PC_24 | Dimensiones y mecanizados según plano nativo actualizado.
17 | TT10_C03_SELECTOR_COLLAR_1 | 1 | Según plano | C45E / EN 10083-2 | Collar de varilla para sujetar horquilla; fijacion radial y retencion por completar |  |  |  |  | 1.000 | ud | TT10_C05_PC_21 | Dimensiones y mecanizados según plano nativo actualizado.
18 | TT10_C03_SELECTOR_COLLAR_2 | 1 | Según plano | C45E / EN 10083-2 | Collar de varilla para sujetar horquilla; fijacion radial y retencion por completar |  |  |  |  | 1.000 | ud | TT10_C05_PC_21 | Dimensiones y mecanizados según plano nativo actualizado.
19 | TT10_C03_SELECTOR_CUBIERTA | 1 | Según plano | ASTM A36 | Cubierta desmontable3; ranura50x36 para recorrido completo; cierreM6 por detallar |  |  |  |  | 1.000 | ud | TT10_C05_PC_20 | Dimensiones y mecanizados según plano nativo actualizado.
20 | TT10_C03_SELECTOR_ENCLAVAMIENTO | 1 | Según plano | C45E / EN 10083-2 | Pasador positivoD6; levantar16mm antes de seleccionar y reinsertar; retencion cautiva y mando remoto pendientes |  |  |  |  | 1.000 | ud | TT10_C05_PC_21 | Dimensiones y mecanizados según plano nativo actualizado.
21 | TT10_C03_SELECTOR_HORQUILLA | 1 | Según plano | ASTM A36 | Horquilla10 en ranura12; 1 mm nominal por flanco; garras de seleccion con la maquina parada |  |  |  |  | 1.000 | ud | TT10_C05_PC_21 | Dimensiones y mecanizados según plano nativo actualizado.
22 | TT10_C03_SELECTOR_MANGUITO | 1 | Según plano | AISI 4140 bonificado | Manguito estriado: neutro X923..979; E+18/M-18; 6 alojamientos D12.2 PCD72 por cara |  |  |  |  | 1.000 | ud | TT10_C05_PC_21 | Dimensiones y mecanizados según plano nativo actualizado.
23 | TT10_C03_SELECTOR_PARED_E | 1 | Según plano | ASTM A36 | Pared mecanizada8; roscasM6; tapa de retencion y asiento axial por cadena de cotas |  |  |  |  | 1.000 | ud | TT10_C05_PC_20 | Dimensiones y mecanizados según plano nativo actualizado.
24 | TT10_C03_SELECTOR_PARED_M | 1 | Según plano | ASTM A36 | Pared mecanizada8; roscasM6; tapa de retencion y asiento axial por cadena de cotas |  |  |  |  | 1.000 | ud | TT10_C05_PC_20 | Dimensiones y mecanizados según plano nativo actualizado.
25 | TT10_C03_SELECTOR_VARILLA | 1 | Según plano | C45E / EN 10083-2 | Varilla selector D16; tres taladrosD6.5 con paso18; E-N-M por pasador positivo |  |  |  |  | 1.000 | ud | TT10_C05_PC_21 | Dimensiones y mecanizados según plano nativo actualizado.
26 | TT10_C03_TAPA_RETENCION_E | 1 | Según plano | ASTM A36 | Tapa estacionaria: labio axial para cuboD100, pasoD92 libre al manguitoD90; junta axial0.2 por ajustar |  |  |  |  | 1.000 | ud | TT10_C05_PC_20 | Dimensiones y mecanizados según plano nativo actualizado.
27 | TT10_C03_TAPA_RETENCION_M | 1 | Según plano | ASTM A36 | Tapa estacionaria: labio axial para cuboD100, pasoD92 libre al manguitoD90; junta axial0.2 por ajustar |  |  |  |  | 1.000 | ud | TT10_C05_PC_20 | Dimensiones y mecanizados según plano nativo actualizado.
28 | TT10_C04_ACOPLE_0 | 1 | Según plano | C45E / EN 10083-2 | Brida110x8,PCD82/6M8; bore30H7; asiento25, desmontaje axial |  |  |  |  | 1.000 | ud | TT10_C05_PC_18 | Dimensiones y mecanizados según plano nativo actualizado.
29 | TT10_C04_ACOPLE_1 | 1 | Según plano | C45E / EN 10083-2 | Brida110x8,PCD82/6M8; bore30H7; asiento30, desmontaje axial |  |  |  |  | 1.000 | ud | TT10_C05_PC_18 | Dimensiones y mecanizados según plano nativo actualizado.
40 | TT10_C04_BANCADA | 1 | Según plano | ASTM A36 | Bancada215x200x20, sobre poste corto; soldaduraa3 |  |  |  |  | 1.000 | ud | TT10_C05_PC_16 | Dimensiones y mecanizados según plano nativo actualizado.
41 | TT10_C04_CARTELA_0 | 1 | Según plano | ASTM A36 | Cartela12,165x55, a3 continuo a placa y poste |  |  |  |  | 1.000 | ud | TT10_C05_PC_16 | Dimensiones y mecanizados según plano nativo actualizado.
42 | TT10_C04_CARTELA_1 | 1 | Según plano | ASTM A36 | Cartela12,165x55, a3 continuo a placa y poste |  |  |  |  | 1.000 | ud | TT10_C05_PC_16 | Dimensiones y mecanizados según plano nativo actualizado.
49 | TT10_C04_EJE_MANUAL | 1 | Según plano | AISI 4140 bonificado | EjeD30h7,L184; chaveteros8x7, t1=4, extremos planos |  |  |  |  | 1.000 | ud | TT10_C05_PC_18 | Dimensiones y mecanizados según plano nativo actualizado.
50 | TT10_C04_EJE_TIMON | 1 | Según plano | AISI 4140 bonificado | Eje heredado con extremoX1026 y chavetero adicional8x7x30; Mayr conservado |  |  |  |  | 1.000 | ud | TT10_C05_PC_17 | Dimensiones y mecanizados según plano nativo actualizado.
56 | TT10_C04_GUARDA_BANDA | 1 | Según plano | ASTM A36 | Banda2, ancho36; tapa inferior; soldar a posterior, frontal desmontable |  |  |  |  | 1.000 | ud | TT10_C05_PC_19 | Dimensiones y mecanizados según plano nativo actualizado.
59 | TT10_C04_GUARDA_FRONTAL | 1 | Según plano | ASTM A36 | Chapa2; contorno de cadena; inferiorZ1107; paso superior/FRONTAL |  |  |  |  | 1.000 | ud | TT10_C05_PC_19 | Dimensiones y mecanizados según plano nativo actualizado.
62 | TT10_C04_GUARDA_POSTERIOR | 1 | Según plano | ASTM A36 | Chapa2; contorno de cadena; inferiorZ1107; paso superior/POSTERIOR |  |  |  |  | 1.000 | ud | TT10_C05_PC_19 | Dimensiones y mecanizados según plano nativo actualizado.
65 | TT10_C04_PEDESTAL_SELECTOR | 1 | Según plano | ASTM A36 | Pedestal con ventana46 para paso real de cadena/resguardo; soporte local por verificar |  |  |  |  | 1.000 | ud | TT10_C05_PC_20 | Dimensiones y mecanizados según plano nativo actualizado.
66 | TT10_C04_PLACA_TIMON | 1 | Según plano | ASTM A36 | Placa de estacion existente con ventanaR57x25 para bridas110; apoyos yMayr conservados |  |  |  |  | 1.000 | ud | TT10_C05_PC_17 | Dimensiones y mecanizados según plano nativo actualizado.
69 | TT10_C04_SELECTOR_BASE | 1 | Según plano | ASTM A36 | Soporte con ventana46mm para cadena y guarda; caras restantes transmiten apoyo |  |  |  |  | 1.000 | ud | TT10_C05_PC_20 | Dimensiones y mecanizados según plano nativo actualizado.
70 | TT10_C04_SELECTOR_CUBO_E | 1 | Según plano | AISI 4140 bonificado | CuboE con extension; pasoD41 hastaX1062, socketD40H7 y chavetero12x35 |  |  |  |  | 1.000 | ud | TT10_C05_PC_21 | Dimensiones y mecanizados según plano nativo actualizado.
71 | TT10_C04_SELECTOR_EJE | 1 | Según plano | 42CrMo4+QT; pistas58-64HRC | Eje D40h6; extremoX1060; ranuraDIN471D37.5x1.85 enX855.1 |  |  |  |  | 1.000 | ud | TT10_C05_PC_21 | Dimensiones y mecanizados según plano nativo actualizado.
72 | TT10_C04_SELECTOR_ESPACIADOR | 1 | Según plano | ASTM A36 | Soporte con ventana46mm para cadena y guarda; caras restantes transmiten apoyo |  |  |  |  | 1.000 | ud | TT10_C05_PC_20 | Dimensiones y mecanizados según plano nativo actualizado.
77 | TT10_C04_TAPA6008_1 | 1 | Según plano | ASTM A36 | Tapa104x4, cabezas en cajera; desmontaje exterior |  |  |  |  | 1.000 | ud | TT10_C05_PC_20 | Dimensiones y mecanizados según plano nativo actualizado.
78 | TT10_C04_TAPA6008_2 | 1 | Según plano | ASTM A36 | Tapa104x4, cabezas en cajera; desmontaje exterior |  |  |  |  | 1.000 | ud | TT10_C05_PC_20 | Dimensiones y mecanizados según plano nativo actualizado.
79 | TT10_C04_TRAVESANO | 1 | Según plano | S275J0H / EN 10219-1 | RHS100x50x5,L230; une los dos postes del puesto manual, a3 |  |  |  |  | 1.000 | ud | TT10_C05_PC_16 | Dimensiones y mecanizados según plano nativo actualizado.
92 | TT10_C05_BASE_FIJA_TENSOR | 1 | Según plano | ASTM A36 | Base fija630x420x20; cuatro M20 roscados20;apriete100Nm;no son anclajes a losa |  |  |  |  | 1.000 | ud | TT10_C05_PC_16 | Dimensiones y mecanizados según plano nativo actualizado.
94 | TT10_C05_BDNB_APOYO_0_INFERIOR | 1 | Según plano | ASTM A36 | Apoyo partido6006, asientoH7, tapa2M6x60, roscasM6 cuerpo; soldaduraa4 base |  |  |  |  | 1.000 | ud | TT10_C05_PC_22 | Dimensiones y mecanizados según plano nativo actualizado.
95 | TT10_C05_BDNB_APOYO_0_TAPA | 1 | Según plano | ASTM A36 | Apoyo partido6006, asientoH7, tapa2M6x60, roscasM6 cuerpo; soldaduraa4 base |  |  |  |  | 1.000 | ud | TT10_C05_PC_22 | Dimensiones y mecanizados según plano nativo actualizado.
96 | TT10_C05_BDNB_APOYO_1_INFERIOR | 1 | Según plano | ASTM A36 | Apoyo partido6006, asientoH7, tapa2M6x60, roscasM6 cuerpo; soldaduraa4 base |  |  |  |  | 1.000 | ud | TT10_C05_PC_22 | Dimensiones y mecanizados según plano nativo actualizado.
97 | TT10_C05_BDNB_APOYO_1_TAPA | 1 | Según plano | ASTM A36 | Apoyo partido6006, asientoH7, tapa2M6x60, roscasM6 cuerpo; soldaduraa4 base |  |  |  |  | 1.000 | ud | TT10_C05_PC_22 | Dimensiones y mecanizados según plano nativo actualizado.
98 | TT10_C05_BDNB_APOYO_2_INFERIOR | 1 | Según plano | ASTM A36 | Apoyo partido6906, asientoH7, tapa2M6x60, roscasM6 cuerpo; soldaduraa4 base |  |  |  |  | 1.000 | ud | TT10_C05_PC_22 | Dimensiones y mecanizados según plano nativo actualizado.
99 | TT10_C05_BDNB_APOYO_2_TAPA | 1 | Según plano | ASTM A36 | Apoyo partido6906, asientoH7, tapa2M6x60, roscasM6 cuerpo; soldaduraa4 base |  |  |  |  | 1.000 | ud | TT10_C05_PC_22 | Dimensiones y mecanizados según plano nativo actualizado.
100 | TT10_C05_BDNB_APOYO_3_INFERIOR | 1 | Según plano | ASTM A36 | Apoyo partido6906, asientoH7, tapa2M6x60, roscasM6 cuerpo; soldaduraa4 base |  |  |  |  | 1.000 | ud | TT10_C05_PC_22 | Dimensiones y mecanizados según plano nativo actualizado.
101 | TT10_C05_BDNB_APOYO_3_TAPA | 1 | Según plano | ASTM A36 | Apoyo partido6906, asientoH7, tapa2M6x60, roscasM6 cuerpo; soldaduraa4 base |  |  |  |  | 1.000 | ud | TT10_C05_PC_22 | Dimensiones y mecanizados según plano nativo actualizado.
102 | TT10_C05_BDNB_BASE | 1 | Según plano | ASTM A36 | Base16 con ventana cadena,4pasos11;4M10x35 en placa existente roscadaM10 |  |  |  |  | 1.000 | ud | TT10_C05_PC_22 | Dimensiones y mecanizados según plano nativo actualizado.
106 | TT10_C05_BDNB_CUBO_SELECTOR | 1 | Según plano | AISI 4140 bonificado | Cubo manual con corona integral z48,m2.5,20 grados; asiento47 y garras conservadas |  |  |  |  | 1.000 | ud | TT10_C05_PC_23 | Dimensiones y mecanizados según plano nativo actualizado.
107 | TT10_C05_BDNB_EJE_ENTRADA | 1 | Según plano | AISI 4140 bonificado | Eje30h6; socket12.73; chaveta8x7; taladro transversal4.825 |  |  |  |  | 1.000 | ud | TT10_C05_PC_23 | Dimensiones y mecanizados según plano nativo actualizado.
108 | TT10_C05_BDNB_EJE_SALIDA | 1 | Según plano | AISI 4140 bonificado | Eje30h6, espiga12.70; dos6906; chaveta8x7; unión positiva3/16 |  |  |  |  | 1.000 | ud | TT10_C05_PC_23 | Dimensiones y mecanizados según plano nativo actualizado.
109 | TT10_C05_BDNB_ENGRANAJE | 1 | Según plano | AISI 4140 bonificado | Engranaje48d,m2.5,20grados,b20;30H7,8JS9 |  |  |  |  | 1.000 | ud | TT10_C05_PC_23 | Dimensiones y mecanizados según plano nativo actualizado.
116 | TT10_C05_BDNB_PASADOR_ENTRADA | 1 | Según plano | C45E / EN 10083-2 | Pasador transversal3/16, cabeza7, puntaM3x5; C45E bonificado, Rp0.2 minimo650MPa |  |  |  |  | 1.000 | ud | TT10_C05_PC_23 | Dimensiones y mecanizados según plano nativo actualizado.
117 | TT10_C05_BDNB_PASADOR_SALIDA | 1 | Según plano | C45E / EN 10083-2 | Pasador transversal3/16, cabeza7, puntaM3x5; C45E bonificado, Rp0.2 minimo650MPa |  |  |  |  | 1.000 | ud | TT10_C05_PC_23 | Dimensiones y mecanizados según plano nativo actualizado.
118 | TT10_C05_BDNB_PLACA_REACCION | 1 | Según plano | ASTM A36 | Reacción BDNB8mm,4Ø5.5PCD53.85; soldaduraa4 ambos lados a base |  |  |  |  | 1.000 | ud | TT10_C05_PC_22 | Dimensiones y mecanizados según plano nativo actualizado.
126 | TT10_C05_BLOQUE_SELECTOR | 1 | Según plano | ASTM A36 | BloqueC03 conservado con4M4laterales para retencion cautiva |  |  |  |  | 1.000 | ud | TT10_C05_PC_21 | Dimensiones y mecanizados según plano nativo actualizado.
127 | TT10_C05_CORREDERA_TENSOR | 1 | Según plano | ASTM A36 | Corredera comun590x320x20;4ranuras22x62; carrera Y+/-20mm; ambos postes solidarios |  |  |  |  | 1.000 | ud | TT10_C05_PC_16 | Dimensiones y mecanizados según plano nativo actualizado.
128 | TT10_C05_GUIA_TENSOR_0 | 1 | Según plano | ASTM A36 | Guia lateral mecanizada;holgura transversal total0.3..0.5mm; soldar a base fija y mecanizar despues |  |  |  |  | 1.000 | ud | TT10_C05_PC_16 | Dimensiones y mecanizados según plano nativo actualizado.
129 | TT10_C05_GUIA_TENSOR_1 | 1 | Según plano | ASTM A36 | Guia lateral mecanizada;holgura transversal total0.3..0.5mm; soldar a base fija y mecanizar despues |  |  |  |  | 1.000 | ud | TT10_C05_PC_16 | Dimensiones y mecanizados según plano nativo actualizado.
138 | TT10_C05_OREJA_TENSOR_0_0 | 1 | Según plano | ASTM A36 | Oreja36x20x36;M16x2; soldaduraa6 a base fija |  |  |  |  | 1.000 | ud | TT10_C05_PC_16 | Dimensiones y mecanizados según plano nativo actualizado.
139 | TT10_C05_OREJA_TENSOR_0_1 | 1 | Según plano | ASTM A36 | Oreja36x20x36;M16x2; soldaduraa6 a base fija |  |  |  |  | 1.000 | ud | TT10_C05_PC_16 | Dimensiones y mecanizados según plano nativo actualizado.
140 | TT10_C05_OREJA_TENSOR_1_0 | 1 | Según plano | ASTM A36 | Oreja36x20x36;M16x2; soldaduraa6 a base fija |  |  |  |  | 1.000 | ud | TT10_C05_PC_16 | Dimensiones y mecanizados según plano nativo actualizado.
141 | TT10_C05_OREJA_TENSOR_1_1 | 1 | Según plano | ASTM A36 | Oreja36x20x36;M16x2; soldaduraa6 a base fija |  |  |  |  | 1.000 | ud | TT10_C05_PC_16 | Dimensiones y mecanizados según plano nativo actualizado.
142 | TT10_C05_POSTE_CORTO_TENSOR | 1 | Según plano | S275J0H / EN 10219-1 | RHS50x50x5;L1037.5;recortado20para conservar altura del eje |  |  |  |  | 1.000 | ud | TT10_C05_PC_16 | Dimensiones y mecanizados según plano nativo actualizado.
143 | TT10_C05_POSTE_VOLANTE_TENSOR | 1 | Según plano | ASTM A36 | Poste del volante recortado20mm; conservar mecanizado superior y centros |  |  |  |  | 1.000 | ud | TT10_C05_PC_16 | Dimensiones y mecanizados según plano nativo actualizado.
144 | TT10_C05_RETEN_CAUTIVO_SELECTOR | 1 | Según plano | ASTM A36 | Puente cautivo para pasadorD6;23mm hasta cabeza, permite levantar16mm;4M4 laterales al bloque |  |  |  |  | 1.000 | ud | TT10_C05_PC_21 | Dimensiones y mecanizados según plano nativo actualizado.
145 | TT10_CART_N_INF | 1 | Según plano | ASTM A36 | Cartela horizontal20 entre puente y placa de nodo |  |  |  |  | 1.000 | ud | TT10_C05_PC_02 | Dimensiones y mecanizados según plano nativo actualizado.
146 | TT10_CART_N_SUP | 1 | Según plano | ASTM A36 | Cartela horizontal20 entre puente y placa de nodo |  |  |  |  | 1.000 | ud | TT10_C05_PC_02 | Dimensiones y mecanizados según plano nativo actualizado.
147 | TT10_CART_P_INF | 1 | Según plano | ASTM A36 | Cartela horizontal20 entre puente y placa de nodo |  |  |  |  | 1.000 | ud | TT10_C05_PC_02 | Dimensiones y mecanizados según plano nativo actualizado.
148 | TT10_CART_P_SUP | 1 | Según plano | ASTM A36 | Cartela horizontal20 entre puente y placa de nodo |  |  |  |  | 1.000 | ud | TT10_C05_PC_02 | Dimensiones y mecanizados según plano nativo actualizado.
149 | TT10_COLLAR_N | 1 | Según plano | C45E / EN 10083-2 | Casquillo D220/d200.2 L161: transmisión de apriete y pista de sello |  |  |  |  | 1.000 | ud | TT10_C05_PC_09 | Dimensiones y mecanizados según plano nativo actualizado.
150 | TT10_COLLAR_P | 1 | Según plano | C45E / EN 10083-2 | Casquillo D220/d200.2 L161: transmisión de apriete y pista de sello |  |  |  |  | 1.000 | ud | TT10_C05_PC_09 | Dimensiones y mecanizados según plano nativo actualizado.
153 | TT10_D_ARO_RESGUARDO_N | 1 | Según plano | S275J0H / EN 10219-1 | Resguardo tubular desmontable ARO_RESGUARDO_N |  |  |  |  | 1.000 | ud | TT10_C05_PC_11 | Dimensiones y mecanizados según plano nativo actualizado.
154 | TT10_D_ARO_RESGUARDO_P | 1 | Según plano | S275J0H / EN 10219-1 | Resguardo tubular desmontable ARO_RESGUARDO_P |  |  |  |  | 1.000 | ud | TT10_C05_PC_11 | Dimensiones y mecanizados según plano nativo actualizado.
157 | TT10_D_BASE_ARMARIO | 1 | Según plano | ASTM A36 | Base del armario |  |  |  |  | 1.000 | ud | TT10_C05_PC_25 | Dimensiones y mecanizados según plano nativo actualizado.
158 | TT10_D_BASE_BOTONERA | 1 | Según plano | ASTM A36 | Base de botonera |  |  |  |  | 1.000 | ud | TT10_C05_PC_25 | Dimensiones y mecanizados según plano nativo actualizado.
159 | TT10_D_BASE_FRENO_N | 1 | Según plano | ASTM A36 | Base de pedestal de freno N |  |  |  |  | 1.000 | ud | TT10_C05_PC_11 | Dimensiones y mecanizados según plano nativo actualizado.
160 | TT10_D_BASE_FRENO_P | 1 | Según plano | ASTM A36 | Base de pedestal de freno P |  |  |  |  | 1.000 | ud | TT10_C05_PC_11 | Dimensiones y mecanizados según plano nativo actualizado.
161 | TT10_D_BASE_MOTOR | 1 | Según plano | ASTM A36 | Placa base del segundo apoyo de bancada |  |  |  |  | 1.000 | ud | TT10_C05_PC_10 | Dimensiones y mecanizados según plano nativo actualizado.
162 | TT10_D_BASE_PRESENTE | 1 | Según plano | ASTM A36 | Base del mando de hombre presente |  |  |  |  | 1.000 | ud | TT10_C05_PC_25 | Dimensiones y mecanizados según plano nativo actualizado.
163 | TT10_D_BASE_RECUP_N | 1 | Según plano | ASTM A36 | Base de mando de recuperación |  |  |  |  | 1.000 | ud | TT10_C05_PC_24 | Dimensiones y mecanizados según plano nativo actualizado.
164 | TT10_D_BASE_RECUP_P | 1 | Según plano | ASTM A36 | Base de mando de recuperación |  |  |  |  | 1.000 | ud | TT10_C05_PC_24 | Dimensiones y mecanizados según plano nativo actualizado.
165 | TT10_D_BLANCO_PIN | 2 | Según plano | ASTM A36 | Bandera de detección del pasador retirado |  |  |  |  | 2.000 | ud | TT10_C05_PC_15 | Dimensiones y mecanizados según plano nativo actualizado.
177 | TT10_D_CARTELA_MOTOR_0 | 1 | Según plano | ASTM A36 | Apoyo lateral desmontable de bancada |  |  |  |  | 1.000 | ud | TT10_C05_PC_10 | Dimensiones y mecanizados según plano nativo actualizado.
178 | TT10_D_CARTELA_MOTOR_1 | 1 | Según plano | ASTM A36 | Apoyo lateral desmontable de bancada |  |  |  |  | 1.000 | ud | TT10_C05_PC_10 | Dimensiones y mecanizados según plano nativo actualizado.
179 | TT10_D_COLUMNA_MOTOR | 1 | Según plano | S275J0H / EN 10219-1 | Columna adicional RHS200x200; asiento sobre placa base |  |  |  |  | 1.000 | ud | TT10_C05_PC_10 | Dimensiones y mecanizados según plano nativo actualizado.
180 | TT10_D_CUBO_N | 1 | Según plano | AISI 4140 bonificado | Cubo de conexión por apriete y brida de disco N |  |  |  |  | 1.000 | ud | TT10_C05_PC_09 | Dimensiones y mecanizados según plano nativo actualizado.
181 | TT10_D_CUBO_P | 1 | Según plano | AISI 4140 bonificado | Cubo de conexión por apriete y brida de disco P |  |  |  |  | 1.000 | ud | TT10_C05_PC_09 | Dimensiones y mecanizados según plano nativo actualizado.
188 | TT10_D_MANDO_PRESENTE | 1 | Según plano | ASTM A36 | Palanca de hombre presente para liberación manual nominal |  |  |  |  | 1.000 | ud | TT10_C05_PC_25 | Dimensiones y mecanizados según plano nativo actualizado.
190 | TT10_D_PALANCA_PESTILLO_N | 1 | Según plano | AISI 4140 bonificado | Palanca accesible de recuperación del pestillo por cable |  |  |  |  | 1.000 | ud | TT10_C05_PC_14 | Dimensiones y mecanizados según plano nativo actualizado.
191 | TT10_D_PALANCA_PESTILLO_P | 1 | Según plano | AISI 4140 bonificado | Palanca accesible de recuperación del pestillo por cable |  |  |  |  | 1.000 | ud | TT10_C05_PC_14 | Dimensiones y mecanizados según plano nativo actualizado.
192 | TT10_D_PALANCA_SELECTOR | 1 | Según plano | ASTM A36 | Selector E-0-M a altura accesible; transmisión por varilla |  |  |  |  | 1.000 | ud | TT10_C05_PC_26 | Dimensiones y mecanizados según plano nativo actualizado.
197 | TT10_D_PEDESTAL_AUX | 1 | Según plano | ASTM A36 | Pedestal bajo reducción auxiliar |  |  |  |  | 1.000 | ud | TT10_C05_PC_10 | Dimensiones y mecanizados según plano nativo actualizado.
198 | TT10_D_PEDESTAL_MOTOR | 1 | Según plano | ASTM A36 | Soporte común de pies del motor |  |  |  |  | 1.000 | ud | TT10_C05_PC_10 | Dimensiones y mecanizados según plano nativo actualizado.
201 | TT10_D_PLATAFORMA | 1 | Según plano | ASTM A36 | Plataforma t40 con paso abierto de cadena ancho100, extremo R50; geometría nativa vigente |  |  |  |  | 1.000 | ud | TT10_C05_PC_10 | Dimensiones y mecanizados según plano nativo actualizado.
202 | TT10_D_POSTE_ARMARIO | 1 | Según plano | ASTM A36 | Soporte de armario |  |  |  |  | 1.000 | ud | TT10_C05_PC_25 | Dimensiones y mecanizados según plano nativo actualizado.
203 | TT10_D_POSTE_BOTONERA | 1 | Según plano | ASTM A36 | Poste de botonera fuera del plano de giro |  |  |  |  | 1.000 | ud | TT10_C05_PC_25 | Dimensiones y mecanizados según plano nativo actualizado.
204 | TT10_D_POSTE_FRENO_N | 1 | Según plano | ASTM A36 | Pedestal del freno N |  |  |  |  | 1.000 | ud | TT10_C05_PC_11 | Dimensiones y mecanizados según plano nativo actualizado.
205 | TT10_D_POSTE_FRENO_P | 1 | Según plano | ASTM A36 | Pedestal del freno P |  |  |  |  | 1.000 | ud | TT10_C05_PC_11 | Dimensiones y mecanizados según plano nativo actualizado.
206 | TT10_D_POSTE_MANDO | 1 | Según plano | ASTM A36 | Soporte del mando manual fuera del plano del volante |  |  |  |  | 1.000 | ud | TT10_C05_PC_26 | Dimensiones y mecanizados según plano nativo actualizado.
207 | TT10_D_POSTE_RECUP_N | 1 | Según plano | ASTM A36 | Soporte de manivela y desbloqueo manual N |  |  |  |  | 1.000 | ud | TT10_C05_PC_24 | Dimensiones y mecanizados según plano nativo actualizado.
208 | TT10_D_POSTE_RECUP_P | 1 | Según plano | ASTM A36 | Soporte de manivela y desbloqueo manual P |  |  |  |  | 1.000 | ud | TT10_C05_PC_24 | Dimensiones y mecanizados según plano nativo actualizado.
212 | TT10_D_ROD_SELECTOR | 1 | Según plano | ASTM A36 | Eje de conexión geométrica ROD_SELECTOR |  |  |  |  | 1.000 | ud | TT10_C05_PC_26 | Dimensiones y mecanizados según plano nativo actualizado.
216 | TT10_D_SOPORTE_FRENO_N | 1 | Según plano | ASTM A36 | Placa de montaje de pinza N |  |  |  |  | 1.000 | ud | TT10_C05_PC_11 | Dimensiones y mecanizados según plano nativo actualizado.
217 | TT10_D_SOPORTE_FRENO_P | 1 | Según plano | ASTM A36 | Placa de montaje de pinza P |  |  |  |  | 1.000 | ud | TT10_C05_PC_11 | Dimensiones y mecanizados según plano nativo actualizado.
218 | TT10_F416 | 1 | Según plano | Strenx700E t50; Rp0.2min700MPa | Placa base 600 x 500 x 50; 8 agujeros Ø40, centros X ±220, Y ±150 y ±50 |  |  |  |  | 1.000 | ud | TT10_C05_PC_03 | Dimensiones y mecanizados según plano nativo actualizado.
219 | TT10_F426 | 1 | Según plano | ASTM A36 | Tope inclinado: cara inferior mecanizada para asiento horizontal |  |  |  |  | 1.000 | ud | TT10_C05_PC_03 | Dimensiones y mecanizados según plano nativo actualizado.
220 | TT10_F431 | 1 | Según plano | ASTM A36 | Pieza TT10_F431 |  |  |  |  | 1.000 | ud | TT10_C05_PC_02 | Dimensiones y mecanizados según plano nativo actualizado.
221 | TT10_F441 | 1 | Según plano | ASTM A36 | Placa80 con cuatro roscas M30 ciegas60, paso540x140; pernos desde arriba |  |  |  |  | 1.000 | ud | TT10_C05_PC_02 | Dimensiones y mecanizados según plano nativo actualizado.
222 | TT10_F446 | 1 | Según plano | ASTM A36 | Placa80 con cuatro roscas M30 ciegas60, paso540x140; pernos desde arriba |  |  |  |  | 1.000 | ud | TT10_C05_PC_02 | Dimensiones y mecanizados según plano nativo actualizado.
225 | TT10_F471 | 1 | Según plano | S275J0H / EN 10219-1 | Perfil tubular 350 x 200 x 12; L 6300 |  |  |  |  | 1.000 | ud | TT10_C05_PC_02 | Dimensiones y mecanizados según plano nativo actualizado.
226 | TT10_F476 | 1 | Según plano | S275J0H / EN 10219-1 | Perfil tubular 350 x 200 x 12; L 6300 |  |  |  |  | 1.000 | ud | TT10_C05_PC_02 | Dimensiones y mecanizados según plano nativo actualizado.
227 | TT10_F481 | 1 | Según plano | ASTM A36 | Pieza TT10_F481 |  |  |  |  | 1.000 | ud | TT10_C05_PC_02 | Dimensiones y mecanizados según plano nativo actualizado.
228 | TT10_F486 | 1 | Según plano | Strenx700E t40; Rp0.2min700MPa | Oreja fija 400 x 250 x 40; agujero Ø65 H8; Strenx 700E |  |  |  |  | 1.000 | ud | TT10_C05_PC_03 | Dimensiones y mecanizados según plano nativo actualizado.
230 | TT10_F501 | 1 | Según plano | Strenx700E t40; Rp0.2min700MPa | Oreja fija 400 x 250 x 40; agujero Ø65 H8; Strenx 700E |  |  |  |  | 1.000 | ud | TT10_C05_PC_03 | Dimensiones y mecanizados según plano nativo actualizado.
231 | TT10_F506 | 1 | Según plano | Strenx700E t20; Rp0.2min700MPa | Poste independiente cajón 300 x 200 x 2395, t20; 2 diafragmas 260 x 160 x 20 |  |  |  |  | 1.000 | ud | TT10_C05_PC_02 | Despiece de chapas en pestaña Chapas cajones.
232 | TT10_F511 | 1 | Según plano | ASTM A36 | Pieza TT10_F511 |  |  |  |  | 1.000 | ud | TT10_C05_PC_02 | Dimensiones y mecanizados según plano nativo actualizado.
233 | TT10_F516 | 1 | Según plano | ASTM A36 | Pieza TT10_F516 |  |  |  |  | 1.000 | ud | TT10_C05_PC_02 | Dimensiones y mecanizados según plano nativo actualizado.
234 | TT10_F521 | 1 | Según plano | ASTM A36 | Columna accionamiento apoyada sobre placa base |  |  |  |  | 1.000 | ud | TT10_C05_PC_10 | Dimensiones y mecanizados según plano nativo actualizado.
235 | TT10_F526 | 1 | Según plano | S275J0H / EN 10219-1 | Perfil tubular 350 x 300 x 12; L 4800 |  |  |  |  | 1.000 | ud | TT10_C05_PC_02 | Dimensiones y mecanizados según plano nativo actualizado.
236 | TT10_F531 | 1 | Según plano | S275J0H / EN 10219-1 | Perfil tubular 350 x 300 x 12; L 4800 |  |  |  |  | 1.000 | ud | TT10_C05_PC_02 | Dimensiones y mecanizados según plano nativo actualizado.
237 | TT10_F536 | 1 | Según plano | ASTM A36 | Soporte tope terminado en cara interior de columna |  |  |  |  | 1.000 | ud | TT10_C05_PC_03 | Dimensiones y mecanizados según plano nativo actualizado.
238 | TT10_F541 | 1 | Según plano | S275J0H / EN 10219-1 | Diagonal CHS168.3x10 con cortes de asiento; sin penetrar columnas ni placas |  |  |  |  | 1.000 | ud | TT10_C05_PC_02 | Dimensiones y mecanizados según plano nativo actualizado.
239 | TT10_F546 | 1 | Según plano | S275J0H / EN 10219-1 | Puente RHS200x150x10 L1005; fuera del plano de las diagonales |  |  |  |  | 1.000 | ud | TT10_C05_PC_02 | Dimensiones y mecanizados según plano nativo actualizado.
241 | TT10_F556 | 1 | Según plano | ASTM A36 | Soporte tope terminado en cara interior de columna |  |  |  |  | 1.000 | ud | TT10_C05_PC_03 | Dimensiones y mecanizados según plano nativo actualizado.
242 | TT10_F561 | 1 | Según plano | ASTM A36 | Pieza TT10_F561 |  |  |  |  | 1.000 | ud | TT10_C05_PC_02 | Dimensiones y mecanizados según plano nativo actualizado.
243 | TT10_F566 | 1 | Según plano | ASTM A36 | Pieza TT10_F566 |  |  |  |  | 1.000 | ud | TT10_C05_PC_02 | Dimensiones y mecanizados según plano nativo actualizado.
244 | TT10_F571 | 1 | Según plano | ASTM A36 | Pieza TT10_F571 |  |  |  |  | 1.000 | ud | TT10_C05_PC_02 | Dimensiones y mecanizados según plano nativo actualizado.
245 | TT10_F576 | 1 | Según plano | Strenx700E t40; Rp0.2min700MPa | Oreja fija 400 x 250 x 40; agujero Ø65 H8; Strenx 700E |  |  |  |  | 1.000 | ud | TT10_C05_PC_03 | Dimensiones y mecanizados según plano nativo actualizado.
246 | TT10_F581 | 1 | Según plano | S275J0H / EN 10219-1 | Diagonal CHS168.3x10 con cortes de asiento; sin penetrar columnas ni placas |  |  |  |  | 1.000 | ud | TT10_C05_PC_02 | Dimensiones y mecanizados según plano nativo actualizado.
247 | TT10_F586 | 1 | Según plano | Strenx700E t40; Rp0.2min700MPa | Oreja fija 400 x 250 x 40; agujero Ø65 H8; Strenx 700E |  |  |  |  | 1.000 | ud | TT10_C05_PC_03 | Dimensiones y mecanizados según plano nativo actualizado.
248 | TT10_F591 | 1 | Según plano | Strenx700E t50; Rp0.2min700MPa | Placa base 600 x 500 x 50; 8 agujeros Ø40, centros X ±220, Y ±150 y ±50 |  |  |  |  | 1.000 | ud | TT10_C05_PC_03 | Dimensiones y mecanizados según plano nativo actualizado.
249 | TT10_F596 | 1 | Según plano | ASTM A36 | Tope inclinado: cara inferior mecanizada para asiento horizontal |  |  |  |  | 1.000 | ud | TT10_C05_PC_03 | Dimensiones y mecanizados según plano nativo actualizado.
250 | TT10_F601 | 1 | Según plano | S275J0H / EN 10219-1 | Diagonal CHS168.3x10 con cortes de asiento; sin penetrar columnas ni placas |  |  |  |  | 1.000 | ud | TT10_C05_PC_02 | Dimensiones y mecanizados según plano nativo actualizado.
251 | TT10_F606 | 1 | Según plano | S275J0H / EN 10219-1 | Diagonal CHS168.3x10 con cortes de asiento; sin penetrar columnas ni placas |  |  |  |  | 1.000 | ud | TT10_C05_PC_02 | Dimensiones y mecanizados según plano nativo actualizado.
252 | TT10_F611 | 1 | Según plano | Strenx700E t20; Rp0.2min700MPa | Poste independiente cajón 300 x 200 x 2395, t20; 2 diafragmas 260 x 160 x 20 |  |  |  |  | 1.000 | ud | TT10_C05_PC_02 | Despiece de chapas en pestaña Chapas cajones.
254 | TT10_F621 | 1 | Según plano | S275J0H / EN 10219-1 | Puente RHS200x150x10 L1005; fuera del plano de las diagonales |  |  |  |  | 1.000 | ud | TT10_C05_PC_02 | Dimensiones y mecanizados según plano nativo actualizado.
255 | TT10_F626 | 1 | Según plano | ASTM A36 | Pieza TT10_F626 |  |  |  |  | 1.000 | ud | TT10_C05_PC_02 | Dimensiones y mecanizados según plano nativo actualizado.
256 | TT10_F631 | 1 | Según plano | ASTM A36 | Pieza TT10_F631 |  |  |  |  | 1.000 | ud | TT10_C05_PC_02 | Dimensiones y mecanizados según plano nativo actualizado.
257 | TT10_F636 | 1 | Según plano | S355J2; certificado 3.1 requerido | Columna principal recortada para placa80 y altura de centro SKF220 |  |  |  |  | 1.000 | ud | TT10_C05_PC_02 | Dimensiones y mecanizados según plano nativo actualizado.
258 | TT10_F641 | 1 | Según plano | S355J2; certificado 3.1 requerido | Columna principal recortada para placa80 y altura de centro SKF220 |  |  |  |  | 1.000 | ud | TT10_C05_PC_02 | Dimensiones y mecanizados según plano nativo actualizado.
262 | TT10_GUIA_N | 1 | Según plano | ASTM A36 | Guía con alojamiento Ø69 H7; casquillo69/65.5; fuera del camino resistente |  |  |  |  | 1.000 | ud | TT10_C05_PC_03 | Dimensiones y mecanizados según plano nativo actualizado.
263 | TT10_GUIA_P | 1 | Según plano | ASTM A36 | Guía con alojamiento Ø69 H7; casquillo69/65.5; fuera del camino resistente |  |  |  |  | 1.000 | ud | TT10_C05_PC_03 | Dimensiones y mecanizados según plano nativo actualizado.
267 | TT10_LIN_0_0_C | 32 | Según plano | Acero C45 | Casquillo30/18 L25 limita compresión de elastómero |  |  |  |  | 32.000 | ud | TT10_C05_PC_08 | Dimensiones y mecanizados según plano nativo actualizado.
282 | TT10_LK_GUIA | 2 | Según plano | ASTM A36 | Pestillo: guia abierta20.4x20.4, brazo25x42, pie80x12; asiento solenoide110/88 |  |  |  |  | 2.000 | ud | TT10_C05_PC_14 | Dimensiones y mecanizados según plano nativo actualizado.
283 | TT10_LK_LAMINA | 2 | Según plano | 51CrV4 templado/revenido; Rp0.2≥1000MPa,Rm≥1250MPa; superficie y fatiga por verificar | Resorte de lamina20x1.8, longitud activa330, precarga equivalente50mm; forma instalada; horquillaU R6.5, sin esquina interna recta |  |  |  |  | 2.000 | ud | TT10_C05_PC_14 | Dimensiones y mecanizados según plano nativo actualizado.
284 | TT10_LK_MORDAZA_LAMINA | 2 | Según plano | ASTM A36 | Mordaza30x20x9.1 para resorte; no soldar ni taladrar zona activa de la lamina |  |  |  |  | 2.000 | ud | TT10_C05_PC_14 | Dimensiones y mecanizados según plano nativo actualizado.
287 | TT10_LK_PESTILLO | 2 | Según plano | AISI 4140 bonificado | Pestillo42CrMo4+QT, punta20x20, enganche radial nominal9mm, retirada25mm; M12 liberacion |  |  |  |  | 2.000 | ud | TT10_C05_PC_14 | Dimensiones y mecanizados según plano nativo actualizado.
289 | TT10_LK_SOP_SENSOR | 2 | Según plano | ASTM A36 | Soporte desmontable: sensor a cara real del pestillo; dosM6x20, sin soldar a la guia |  |  |  |  | 2.000 | ud | TT10_C05_PC_14 | Dimensiones y mecanizados según plano nativo actualizado.
291 | TT10_LK_TIRANTE | 2 | Según plano | ASTM A36 | TiranteM12 nominal entre pestillo y solenoide; longitud ajustable, conexion OEM por verificar |  |  |  |  | 2.000 | ud | TT10_C05_PC_14 | Dimensiones y mecanizados según plano nativo actualizado.
305 | TT10_M006 | 1 | Según plano | S275J0H / EN 10219-1 | Perfil tubular 200 x 150 x 10; L 2200 |  |  |  |  | 1.000 | ud | TT10_C05_PC_05 | Dimensiones y mecanizados según plano nativo actualizado.
306 | TT10_M011 | 1 | Según plano | S275J0H / EN 10219-1 | Perfil tubular 200 x 150 x 10; L 2200 |  |  |  |  | 1.000 | ud | TT10_C05_PC_05 | Dimensiones y mecanizados según plano nativo actualizado.
307 | TT10_M016 | 1 | Según plano | S275J0H / EN 10219-1 | Perfil tubular 150 x 100 x 8; L 4800 |  |  |  |  | 1.000 | ud | TT10_C05_PC_05 | Dimensiones y mecanizados según plano nativo actualizado.
308 | TT10_M021 | 1 | Según plano | S275J0H / EN 10219-1 | Perfil tubular 200 x 150 x 10; L 2200 |  |  |  |  | 1.000 | ud | TT10_C05_PC_05 | Dimensiones y mecanizados según plano nativo actualizado.
309 | TT10_M026 | 1 | Según plano | S275J0H / EN 10219-1 | Perfil tubular 150 x 100 x 8; L 3600 |  |  |  |  | 1.000 | ud | TT10_C05_PC_05 | Dimensiones y mecanizados según plano nativo actualizado.
310 | TT10_M031 | 1 | Según plano | ASTM A36 | Pieza TT10_M031 |  |  |  |  | 1.000 | ud | TT10_C05_PC_07 | Dimensiones y mecanizados según plano nativo actualizado.
311 | TT10_M036 | 1 | Según plano | ASTM A36 | Pieza TT10_M036 |  |  |  |  | 1.000 | ud | TT10_C05_PC_06 | Dimensiones y mecanizados según plano nativo actualizado.
312 | TT10_M041 | 1 | Según plano | S275J0H / EN 10219-1 | Perfil tubular 200 x 150 x 10; L 2200 |  |  |  |  | 1.000 | ud | TT10_C05_PC_05 | Dimensiones y mecanizados según plano nativo actualizado.
313 | TT10_M046 | 1 | Según plano | S275J0H / EN 10219-1 | Perfil tubular 400 x 200 x 16; L 5600 |  |  |  |  | 1.000 | ud | TT10_C05_PC_05 | Dimensiones y mecanizados según plano nativo actualizado.
314 | TT10_M051 | 1 | Según plano | ASTM A36 | Pieza TT10_M051 |  |  |  |  | 1.000 | ud | TT10_C05_PC_07 | Dimensiones y mecanizados según plano nativo actualizado.
315 | TT10_M056 | 1 | Según plano | Elastómero; curva dinámica de compresión por definir | Cama elastomérica25 perforada para casquillos limitadores |  |  |  |  | 1.000 | ud | TT10_C05_PC_08 | Dimensiones y mecanizados según plano nativo actualizado.
316 | TT10_M061 | 1 | Según plano | ASTM A36 | Pieza TT10_M061 |  |  |  |  | 1.000 | ud | TT10_C05_PC_06 | Dimensiones y mecanizados según plano nativo actualizado.
317 | TT10_M066 | 1 | Según plano | ASTM A36 | Pieza TT10_M066 |  |  |  |  | 1.000 | ud | TT10_C05_PC_06 | Dimensiones y mecanizados según plano nativo actualizado.
318 | TT10_M071 | 1 | Según plano | ASTM A36 | Pieza TT10_M071 |  |  |  |  | 1.000 | ud | TT10_C05_PC_07 | Dimensiones y mecanizados según plano nativo actualizado.
319 | TT10_M076 | 1 | Según plano | AISI 4140 bonificado | Muñón forjado integral con brida550, hombro220, asiento200, R3 y retención exterior |  |  |  |  | 1.000 | ud | TT10_C05_PC_09 | Dimensiones y mecanizados según plano nativo actualizado.
320 | TT10_M081 | 1 | Según plano | ASTM A36 | Pieza TT10_M081 |  |  |  |  | 1.000 | ud | TT10_C05_PC_07 | Dimensiones y mecanizados según plano nativo actualizado.
321 | TT10_M086 | 1 | Según plano | AISI 4140 bonificado | Muñón forjado integral con brida550, hombro220, asiento200, R3 y retención exterior |  |  |  |  | 1.000 | ud | TT10_C05_PC_09 | Dimensiones y mecanizados según plano nativo actualizado.
322 | TT10_M091 | 1 | Según plano | ASTM A36 | Pieza TT10_M091 |  |  |  |  | 1.000 | ud | TT10_C05_PC_06 | Dimensiones y mecanizados según plano nativo actualizado.
323 | TT10_M096 | 1 | Según plano | ASTM A36 | Pieza TT10_M096 |  |  |  |  | 1.000 | ud | TT10_C05_PC_07 | Dimensiones y mecanizados según plano nativo actualizado.
324 | TT10_M101 | 1 | Según plano | S275J0H / EN 10219-1 | Perfil tubular 200 x 100 x 10; L 250 |  |  |  |  | 1.000 | ud | TT10_C05_PC_05 | Dimensiones y mecanizados según plano nativo actualizado.
325 | TT10_M106 | 1 | Según plano | ASTM A36 | Contraplaca80 con doce M30 ciegas78 PCD450, apriete desde exterior |  |  |  |  | 1.000 | ud | TT10_C05_PC_09 | Dimensiones y mecanizados según plano nativo actualizado.
326 | TT10_M111 | 1 | Según plano | ASTM A36 | Pieza TT10_M111 |  |  |  |  | 1.000 | ud | TT10_C05_PC_06 | Dimensiones y mecanizados según plano nativo actualizado.
327 | TT10_M116 | 1 | Según plano | ASTM A36 | Pieza TT10_M116 |  |  |  |  | 1.000 | ud | TT10_C05_PC_06 | Dimensiones y mecanizados según plano nativo actualizado.
328 | TT10_M121 | 1 | Según plano | ASTM A36 | Pieza TT10_M121 |  |  |  |  | 1.000 | ud | TT10_C05_PC_05 | Dimensiones y mecanizados según plano nativo actualizado.
329 | TT10_M131 | 1 | Según plano | Strenx700E t40; Rp0.2min700MPa | Cabezal cajón 200 x 200 x 1200, t40; 2 diafragmas 120 x 120 x 40 |  |  |  |  | 1.000 | ud | TT10_C05_PC_05 | Despiece de chapas en pestaña Chapas cajones.
330 | TT10_M136 | 1 | Según plano | ASTM A36 | Pieza TT10_M136 |  |  |  |  | 1.000 | ud | TT10_C05_PC_07 | Dimensiones y mecanizados según plano nativo actualizado.
331 | TT10_M141 | 1 | Según plano | ASTM A36 | Pieza TT10_M141 |  |  |  |  | 1.000 | ud | TT10_C05_PC_06 | Dimensiones y mecanizados según plano nativo actualizado.
332 | TT10_M146 | 1 | Según plano | ASTM A36 | Pieza TT10_M146 |  |  |  |  | 1.000 | ud | TT10_C05_PC_06 | Dimensiones y mecanizados según plano nativo actualizado.
333 | TT10_M151 | 1 | Según plano | ASTM A36 | Pieza TT10_M151 |  |  |  |  | 1.000 | ud | TT10_C05_PC_05 | Dimensiones y mecanizados según plano nativo actualizado.
335 | TT10_M161 | 1 | Según plano | Strenx700E t30; Rp0.2min700MPa | Yugo cajón 400 x 200 x 1116, t30; 2 diafragmas 340 x 140 x 30; agujero Ø202 |  |  |  |  | 1.000 | ud | TT10_C05_PC_05 | Despiece de chapas en pestaña Chapas cajones.
336 | TT10_M166 | 1 | Según plano | S275J0H / EN 10219-1 | Perfil tubular 150 x 100 x 8; L 4800 |  |  |  |  | 1.000 | ud | TT10_C05_PC_05 | Dimensiones y mecanizados según plano nativo actualizado.
337 | TT10_M171 | 1 | Según plano | ASTM A36 | Pieza TT10_M171 |  |  |  |  | 1.000 | ud | TT10_C05_PC_07 | Dimensiones y mecanizados según plano nativo actualizado.
338 | TT10_M176 | 1 | Según plano | ASTM A36 | Fondo16 con taladros de revestimientos desmontables |  |  |  |  | 1.000 | ud | TT10_C05_PC_07 | Dimensiones y mecanizados según plano nativo actualizado.
339 | TT10_M181 | 1 | Según plano | ASTM A36 | Pieza TT10_M181 |  |  |  |  | 1.000 | ud | TT10_C05_PC_07 | Dimensiones y mecanizados según plano nativo actualizado.
340 | TT10_M186 | 1 | Según plano | S275J0H / EN 10219-1 | Perfil tubular 200 x 150 x 10; L 2200 |  |  |  |  | 1.000 | ud | TT10_C05_PC_05 | Dimensiones y mecanizados según plano nativo actualizado.
341 | TT10_M191 | 1 | Según plano | ASTM A36 | Pieza TT10_M191 |  |  |  |  | 1.000 | ud | TT10_C05_PC_05 | Dimensiones y mecanizados según plano nativo actualizado.
342 | TT10_M196 | 1 | Según plano | ASTM A36 | Pieza TT10_M196 |  |  |  |  | 1.000 | ud | TT10_C05_PC_06 | Dimensiones y mecanizados según plano nativo actualizado.
343 | TT10_M201 | 1 | Según plano | Strenx700E t40; Rp0.2min700MPa | Cabezal cajón 200 x 200 x 1200, t40; 2 diafragmas 120 x 120 x 40 |  |  |  |  | 1.000 | ud | TT10_C05_PC_05 | Despiece de chapas en pestaña Chapas cajones.
344 | TT10_M206 | 1 | Según plano | ASTM A36 | Pieza TT10_M206 |  |  |  |  | 1.000 | ud | TT10_C05_PC_05 | Dimensiones y mecanizados según plano nativo actualizado.
345 | TT10_M211 | 1 | Según plano | Elastómero; curva dinámica de compresión por definir | Cama elastomérica25 perforada para casquillos limitadores |  |  |  |  | 1.000 | ud | TT10_C05_PC_08 | Dimensiones y mecanizados según plano nativo actualizado.
346 | TT10_M216 | 1 | Según plano | ASTM A36 | Pieza TT10_M216 |  |  |  |  | 1.000 | ud | TT10_C05_PC_07 | Dimensiones y mecanizados según plano nativo actualizado.
347 | TT10_M221 | 1 | Según plano | Elastómero; curva dinámica de compresión por definir | Cama elastomérica25 perforada para casquillos limitadores |  |  |  |  | 1.000 | ud | TT10_C05_PC_08 | Dimensiones y mecanizados según plano nativo actualizado.
348 | TT10_M226 | 1 | Según plano | S275J0H / EN 10219-1 | Perfil tubular 200 x 150 x 10; L 2200 |  |  |  |  | 1.000 | ud | TT10_C05_PC_05 | Dimensiones y mecanizados según plano nativo actualizado.
349 | TT10_M231 | 1 | Según plano | ASTM A36 | Pieza TT10_M231 |  |  |  |  | 1.000 | ud | TT10_C05_PC_06 | Dimensiones y mecanizados según plano nativo actualizado.
350 | TT10_M236 | 1 | Según plano | S275J0H / EN 10219-1 | Perfil tubular 150 x 100 x 8; L 3600 |  |  |  |  | 1.000 | ud | TT10_C05_PC_05 | Dimensiones y mecanizados según plano nativo actualizado.
351 | TT10_M241 | 1 | Según plano | Elastómero; curva dinámica de compresión por definir | Cama elastomérica25 perforada para casquillos limitadores |  |  |  |  | 1.000 | ud | TT10_C05_PC_08 | Dimensiones y mecanizados según plano nativo actualizado.
352 | TT10_M246 | 1 | Según plano | ASTM A36 | Pieza TT10_M246 |  |  |  |  | 1.000 | ud | TT10_C05_PC_07 | Dimensiones y mecanizados según plano nativo actualizado.
353 | TT10_M251 | 1 | Según plano | ASTM A36 | Pieza TT10_M251 |  |  |  |  | 1.000 | ud | TT10_C05_PC_07 | Dimensiones y mecanizados según plano nativo actualizado.
354 | TT10_M256 | 1 | Según plano | Hardox 400 | Revestimiento AR400 t12 con ocho M16 avellanados desmontables |  |  |  |  | 1.000 | ud | TT10_C05_PC_08 | Dimensiones y mecanizados según plano nativo actualizado.
355 | TT10_M261 | 1 | Según plano | ASTM A36 | Pieza TT10_M261 |  |  |  |  | 1.000 | ud | TT10_C05_PC_05 | Dimensiones y mecanizados según plano nativo actualizado.
356 | TT10_M266 | 1 | Según plano | Hardox 400 | Revestimiento AR400 t12 con ocho M16 avellanados desmontables |  |  |  |  | 1.000 | ud | TT10_C05_PC_08 | Dimensiones y mecanizados según plano nativo actualizado.
358 | TT10_M276 | 1 | Según plano | Strenx700E t50; Rp0.2min700MPa | Brazo monolítico Strenx 700E t50; perfil 800 x 650; R50; agujero Ø65,5 |  |  |  |  | 1.000 | ud | TT10_C05_PC_05 | Dimensiones y mecanizados según plano nativo actualizado.
359 | TT10_M281 | 1 | Según plano | ASTM A36 | Pieza TT10_M281 |  |  |  |  | 1.000 | ud | TT10_C05_PC_06 | Dimensiones y mecanizados según plano nativo actualizado.
360 | TT10_M286 | 1 | Según plano | ASTM A36 | Pieza TT10_M286 |  |  |  |  | 1.000 | ud | TT10_C05_PC_06 | Dimensiones y mecanizados según plano nativo actualizado.
361 | TT10_M291 | 1 | Según plano | ASTM A36 | Pieza TT10_M291 |  |  |  |  | 1.000 | ud | TT10_C05_PC_07 | Dimensiones y mecanizados según plano nativo actualizado.
362 | TT10_M296 | 1 | Según plano | ASTM A36 | Pieza TT10_M296 |  |  |  |  | 1.000 | ud | TT10_C05_PC_06 | Dimensiones y mecanizados según plano nativo actualizado.
363 | TT10_M301 | 1 | Según plano | ASTM A36 | Pieza TT10_M301 |  |  |  |  | 1.000 | ud | TT10_C05_PC_06 | Dimensiones y mecanizados según plano nativo actualizado.
365 | TT10_M311 | 1 | Según plano | Strenx700E t30; Rp0.2min700MPa | Yugo cajón 400 x 200 x 1116, t30; 2 diafragmas 340 x 140 x 30; agujero Ø202 |  |  |  |  | 1.000 | ud | TT10_C05_PC_05 | Despiece de chapas en pestaña Chapas cajones.
366 | TT10_M316 | 1 | Según plano | ASTM A36 | Pieza TT10_M316 |  |  |  |  | 1.000 | ud | TT10_C05_PC_06 | Dimensiones y mecanizados según plano nativo actualizado.
367 | TT10_M326 | 1 | Según plano | ASTM A36 | Pieza TT10_M326 |  |  |  |  | 1.000 | ud | TT10_C05_PC_06 | Dimensiones y mecanizados según plano nativo actualizado.
368 | TT10_M331 | 1 | Según plano | ASTM A36 | Pieza TT10_M331 |  |  |  |  | 1.000 | ud | TT10_C05_PC_06 | Dimensiones y mecanizados según plano nativo actualizado.
369 | TT10_M336 | 1 | Según plano | S275J0H / EN 10219-1 | Perfil tubular 200 x 100 x 10; L 250 |  |  |  |  | 1.000 | ud | TT10_C05_PC_05 | Dimensiones y mecanizados según plano nativo actualizado.
370 | TT10_M341 | 1 | Según plano | ASTM A36 | Pieza TT10_M341 |  |  |  |  | 1.000 | ud | TT10_C05_PC_06 | Dimensiones y mecanizados según plano nativo actualizado.
371 | TT10_M346 | 1 | Según plano | ASTM A36 | Pieza TT10_M346 |  |  |  |  | 1.000 | ud | TT10_C05_PC_06 | Dimensiones y mecanizados según plano nativo actualizado.
372 | TT10_M351 | 1 | Según plano | Strenx700E t50; Rp0.2min700MPa | Brazo monolítico Strenx 700E t50; perfil 800 x 650; R50; agujero Ø65,5 |  |  |  |  | 1.000 | ud | TT10_C05_PC_05 | Dimensiones y mecanizados según plano nativo actualizado.
373 | TT10_M356 | 1 | Según plano | S275J0H / EN 10219-1 | Perfil tubular 400 x 200 x 16; L 5600 |  |  |  |  | 1.000 | ud | TT10_C05_PC_05 | Dimensiones y mecanizados según plano nativo actualizado.
374 | TT10_M361 | 1 | Según plano | ASTM A36 | Pieza TT10_M361 |  |  |  |  | 1.000 | ud | TT10_C05_PC_07 | Dimensiones y mecanizados según plano nativo actualizado.
376 | TT10_M371 | 1 | Según plano | ASTM A36 | Pieza TT10_M371 |  |  |  |  | 1.000 | ud | TT10_C05_PC_05 | Dimensiones y mecanizados según plano nativo actualizado.
377 | TT10_M376 | 1 | Según plano | ASTM A36 | Contraplaca80 con doce M30 ciegas78 PCD450, apriete desde exterior |  |  |  |  | 1.000 | ud | TT10_C05_PC_09 | Dimensiones y mecanizados según plano nativo actualizado.
378 | TT10_M381 | 1 | Según plano | S275J0H / EN 10219-1 | Perfil tubular 200 x 150 x 10; L 2200 |  |  |  |  | 1.000 | ud | TT10_C05_PC_05 | Dimensiones y mecanizados según plano nativo actualizado.
379 | TT10_M386 | 1 | Según plano | Hardox 400 | Revestimiento AR400 t12 con ocho M16 avellanados desmontables |  |  |  |  | 1.000 | ud | TT10_C05_PC_08 | Dimensiones y mecanizados según plano nativo actualizado.
380 | TT10_M391 | 1 | Según plano | Hardox 400 | Revestimiento AR400 t12 con ocho M16 avellanados desmontables |  |  |  |  | 1.000 | ud | TT10_C05_PC_08 | Dimensiones y mecanizados según plano nativo actualizado.
381 | TT10_M396 | 1 | Según plano | ASTM A36 | Pieza TT10_M396 |  |  |  |  | 1.000 | ud | TT10_C05_PC_06 | Dimensiones y mecanizados según plano nativo actualizado.
382 | TT10_M401 | 1 | Según plano | ASTM A36 | Pieza TT10_M401 |  |  |  |  | 1.000 | ud | TT10_C05_PC_07 | Dimensiones y mecanizados según plano nativo actualizado.
383 | TT10_M406 | 1 | Según plano | ASTM A36 | Pieza TT10_M406 |  |  |  |  | 1.000 | ud | TT10_C05_PC_07 | Dimensiones y mecanizados según plano nativo actualizado.
384 | TT10_M411 | 1 | Según plano | ASTM A36 | Pieza TT10_M411 |  |  |  |  | 1.000 | ud | TT10_C05_PC_07 | Dimensiones y mecanizados según plano nativo actualizado.
388 | TT10_NODO_N | 1 | Según plano | ASTM A36 | Placa de nodo20: unión entre puente desplazado y columna principal |  |  |  |  | 1.000 | ud | TT10_C05_PC_02 | Dimensiones y mecanizados según plano nativo actualizado.
389 | TT10_NODO_P | 1 | Según plano | ASTM A36 | Placa de nodo20: unión entre puente desplazado y columna principal |  |  |  |  | 1.000 | ud | TT10_C05_PC_02 | Dimensiones y mecanizados según plano nativo actualizado.
404 | TT10_PE_HORQ_F | 2 | Según plano | ASTM A36 | Horquilla frontal integral S355: base60x10, separación31.2, dos orejas10, D12.2H8; 2M10 de fijación |  |  |  |  | 2.000 | ud | TT10_C05_PC_12 | Dimensiones y mecanizados según plano nativo actualizado.
405 | TT10_PE_HORQ_R | 2 | Según plano | ASTM A36 | Horquilla trasera mecanizada: base130x60x10; separación26.4; eje12; 2M10 |  |  |  |  | 2.000 | ud | TT10_C05_PC_12 | Dimensiones y mecanizados según plano nativo actualizado.
406 | TT10_PE_LARG_L | 2 | Según plano | ASTM A36 | Larguero S355 plano12x80; corte a longitud503.0 |  |  |  |  | 2.000 | ud | TT10_C05_PC_12 | Dimensiones y mecanizados según plano nativo actualizado.
407 | TT10_PE_LARG_R | 2 | Según plano | ASTM A36 | Larguero S355 plano12x80; corte a longitud503.0 |  |  |  |  | 2.000 | ud | TT10_C05_PC_12 | Dimensiones y mecanizados según plano nativo actualizado.
412 | TT10_PE_PIN | 2 | Según plano | 34CrNiMo6+QT; Rp0,2 mín.800 MPa, sección<=100mm | Pasador Ø65 f7 x 330; cabeza Ø90 x 15; R3; 34CrNiMo6+QT Rp0,2 mín.800 MPa |  |  |  |  | 2.000 | ud | TT10_C05_PC_13 | Dimensiones y mecanizados según plano nativo actualizado.
413 | TT10_PE_PLACA_F | 2 | Según plano | ASTM A36 | Placa de bastidor160x160x12; D70;4D9 y4aliviosD42 abiertos en esquinas para tuercas existentes |  |  |  |  | 2.000 | ud | TT10_C05_PC_12 | Dimensiones y mecanizados según plano nativo actualizado.
414 | TT10_PE_PLACA_R | 2 | Según plano | ASTM A36 | Travesaño160x80x12; 2M10-6H pasantes en X±45; frentes soldados a largueros |  |  |  |  | 2.000 | ud | TT10_C05_PC_12 | Dimensiones y mecanizados según plano nativo actualizado.
415 | TT10_PE_RETEN | 2 | Según plano | ASTM A36 | Placa cautiva160x160x15: amplía paso aD68,4D22 original; añade4D9 en X±45 Z±30 |  |  |  |  | 2.000 | ud | TT10_C05_PC_12 | Dimensiones y mecanizados según plano nativo actualizado.
430 | TT10_PUENTE_N | 1 | Según plano | ASTM A36 t25 | Puente guía A36 525 x 125 x 25; recorte 225 x 10 junto al poste |  |  |  |  | 1.000 | ud | TT10_C05_PC_03 | Dimensiones y mecanizados según plano nativo actualizado.
431 | TT10_PUENTE_P | 1 | Según plano | ASTM A36 t25 | Puente guía A36 525 x 125 x 25; recorte 225 x 10 junto al poste |  |  |  |  | 1.000 | ud | TT10_C05_PC_03 | Dimensiones y mecanizados según plano nativo actualizado.
432 | TT10_R6M_BRAZO_SENSOR_N_INSERTADO | 1 | Según plano | ASTM A36 | Brazo fijo de detector; unión soldada a pie sobre larguero |  |  |  |  | 1.000 | ud | TT10_C05_PC_15 | Dimensiones y mecanizados según plano nativo actualizado.
433 | TT10_R6M_BRAZO_SENSOR_N_RETIRADO | 1 | Según plano | ASTM A36 | Brazo fijo de detector; unión soldada a pie sobre larguero |  |  |  |  | 1.000 | ud | TT10_C05_PC_15 | Dimensiones y mecanizados según plano nativo actualizado.
434 | TT10_R6M_BRAZO_SENSOR_P_INSERTADO | 1 | Según plano | ASTM A36 | Brazo fijo de detector; unión soldada a pie sobre larguero |  |  |  |  | 1.000 | ud | TT10_C05_PC_15 | Dimensiones y mecanizados según plano nativo actualizado.
435 | TT10_R6M_BRAZO_SENSOR_P_RETIRADO | 1 | Según plano | ASTM A36 | Brazo fijo de detector; unión soldada a pie sobre larguero |  |  |  |  | 1.000 | ud | TT10_C05_PC_15 | Dimensiones y mecanizados según plano nativo actualizado.
443 | TT10_R6M_PEDESTAL_FRENO | 1 | Según plano | ASTM A36 | Travesaño108x40x10 entre caras interiores del poste existente; soldadura a3,40mm por extremo |  |  |  |  | 1.000 | ud | TT10_C05_PC_17 | Dimensiones y mecanizados según plano nativo actualizado.
444 | TT10_R6M_PIE_SENSORES_N | 1 | Según plano | ASTM A36 | Pie12 sobre cara superior del larguero; soldadura a3,20mm por ambas caras |  |  |  |  | 1.000 | ud | TT10_C05_PC_15 | Dimensiones y mecanizados según plano nativo actualizado.
445 | TT10_R6M_PIE_SENSORES_P | 1 | Según plano | ASTM A36 | Pie12 sobre cara superior del larguero; soldadura a3,20mm por ambas caras |  |  |  |  | 1.000 | ud | TT10_C05_PC_15 | Dimensiones y mecanizados según plano nativo actualizado.
446 | TT10_R6M_PLACA_FRENO_TIMON | 1 | Según plano | ASTM A36 | Placa12, caraX1127; centrado y3M6PCD132; sujeción a pedestal por cartelas |  |  |  |  | 1.000 | ud | TT10_C05_PC_17 | Dimensiones y mecanizados según plano nativo actualizado.
447 | TT10_R6M_SOP_SENSOR_N_INSERTADO | 1 | Según plano | ASTM A36 | Escuadra6;taladroØ8.5 para sensorM8;frente de detección a1mm del blanco |  |  |  |  | 1.000 | ud | TT10_C05_PC_15 | Dimensiones y mecanizados según plano nativo actualizado.
448 | TT10_R6M_SOP_SENSOR_N_RETIRADO | 1 | Según plano | ASTM A36 | Escuadra6;taladroØ8.5 para sensorM8;frente de detección a1mm del blanco |  |  |  |  | 1.000 | ud | TT10_C05_PC_15 | Dimensiones y mecanizados según plano nativo actualizado.
449 | TT10_R6M_SOP_SENSOR_P_INSERTADO | 1 | Según plano | ASTM A36 | Escuadra6;taladroØ8.5 para sensorM8;frente de detección a1mm del blanco |  |  |  |  | 1.000 | ud | TT10_C05_PC_15 | Dimensiones y mecanizados según plano nativo actualizado.
450 | TT10_R6M_SOP_SENSOR_P_RETIRADO | 1 | Según plano | ASTM A36 | Escuadra6;taladroØ8.5 para sensorM8;frente de detección a1mm del blanco |  |  |  |  | 1.000 | ud | TT10_C05_PC_15 | Dimensiones y mecanizados según plano nativo actualizado.
453 | TT10_SEN_SOP_P | 2 | Según plano | ASTM A36 | Soporte soldado desmontable: carril6x40x229 y pie4x40x16.5; dos M6x16; dos D8.5 |  |  |  |  | 2.000 | ud | TT10_C05_PC_15 | Dimensiones y mecanizados según plano nativo actualizado.
458 | TT10_TIR_P1 | 1 | Según plano | ASTM A36 | Tirante M20 propuesto, L380; rosca simplificada |  |  |  |  | 1.000 | ud | TT10_C05_PC_02 | Dimensiones y mecanizados según plano nativo actualizado.
459 | TT10_TIR_P2 | 1 | Según plano | ASTM A36 | Tirante M20 propuesto, L380; rosca simplificada |  |  |  |  | 1.000 | ud | TT10_C05_PC_02 | Dimensiones y mecanizados según plano nativo actualizado.
460 | TT10_TIR_P3 | 1 | Según plano | ASTM A36 | Tirante M20 propuesto, L380; rosca simplificada |  |  |  |  | 1.000 | ud | TT10_C05_PC_02 | Dimensiones y mecanizados según plano nativo actualizado.
461 | TT10_TIR_P4 | 1 | Según plano | ASTM A36 | Tirante M20 propuesto, L380; rosca simplificada |  |  |  |  | 1.000 | ud | TT10_C05_PC_02 | Dimensiones y mecanizados según plano nativo actualizado.
468 | TT10_TM_CUBO | 1 | Según plano | AISI 4140 bonificado | Cubo D80/D30 H7 L45; chavetero8 JS9, profundidad3.3 sobre radio nominal |  |  |  |  | 1.000 | ud | TT10_C05_PC_17 | Dimensiones y mecanizados según plano nativo actualizado.
470 | TT10_TM_PUNO | 1 | Según plano | POM-C; ficha de proveedor requerida | Empuñadura giratoria POM D32/d10.4 L85 |  |  |  |  | 1.000 | ud | TT10_C05_PC_17 | Dimensiones y mecanizados según plano nativo actualizado.
478 | TT10_TM_VOLANTE | 1 | Según plano | ASTM A36 | Volante D500 t12, cuatro radios; D8.5 para empuñadura; soldado al cubo |  |  |  |  | 1.000 | ud | TT10_C05_PC_17 | Dimensiones y mecanizados según plano nativo actualizado.
487 | TT10_TOPE70_N_INFD | 1 | Según plano | ASTM A36 | Cartela horizontal20: transmite componente transversal del tope70 |  |  |  |  | 1.000 | ud | TT10_C05_PC_03 | Dimensiones y mecanizados según plano nativo actualizado.
488 | TT10_TOPE70_N_INFI | 1 | Según plano | ASTM A36 | Cartela horizontal20: transmite componente transversal del tope70 |  |  |  |  | 1.000 | ud | TT10_C05_PC_03 | Dimensiones y mecanizados según plano nativo actualizado.
489 | TT10_TOPE70_N_SUPD | 1 | Según plano | ASTM A36 | Cartela horizontal20: transmite componente transversal del tope70 |  |  |  |  | 1.000 | ud | TT10_C05_PC_03 | Dimensiones y mecanizados según plano nativo actualizado.
490 | TT10_TOPE70_N_SUPI | 1 | Según plano | ASTM A36 | Cartela horizontal20: transmite componente transversal del tope70 |  |  |  |  | 1.000 | ud | TT10_C05_PC_03 | Dimensiones y mecanizados según plano nativo actualizado.
491 | TT10_TOPE70_N_V1 | 1 | Según plano | ASTM A36 | Cartela vertical20 de tope70; apoyo al bloque y cara de columna |  |  |  |  | 1.000 | ud | TT10_C05_PC_03 | Dimensiones y mecanizados según plano nativo actualizado.
492 | TT10_TOPE70_N_V2 | 1 | Según plano | ASTM A36 | Cartela vertical20 de tope70; apoyo al bloque y cara de columna |  |  |  |  | 1.000 | ud | TT10_C05_PC_03 | Dimensiones y mecanizados según plano nativo actualizado.
493 | TT10_TOPE70_P_INFD | 1 | Según plano | ASTM A36 | Cartela horizontal20: transmite componente transversal del tope70 |  |  |  |  | 1.000 | ud | TT10_C05_PC_03 | Dimensiones y mecanizados según plano nativo actualizado.
494 | TT10_TOPE70_P_INFI | 1 | Según plano | ASTM A36 | Cartela horizontal20: transmite componente transversal del tope70 |  |  |  |  | 1.000 | ud | TT10_C05_PC_03 | Dimensiones y mecanizados según plano nativo actualizado.
495 | TT10_TOPE70_P_SUPD | 1 | Según plano | ASTM A36 | Cartela horizontal20: transmite componente transversal del tope70 |  |  |  |  | 1.000 | ud | TT10_C05_PC_03 | Dimensiones y mecanizados según plano nativo actualizado.
496 | TT10_TOPE70_P_SUPI | 1 | Según plano | ASTM A36 | Cartela horizontal20: transmite componente transversal del tope70 |  |  |  |  | 1.000 | ud | TT10_C05_PC_03 | Dimensiones y mecanizados según plano nativo actualizado.
497 | TT10_TOPE70_P_V1 | 1 | Según plano | ASTM A36 | Cartela vertical20 de tope70; apoyo al bloque y cara de columna |  |  |  |  | 1.000 | ud | TT10_C05_PC_03 | Dimensiones y mecanizados según plano nativo actualizado.
498 | TT10_TOPE70_P_V2 | 1 | Según plano | ASTM A36 | Cartela vertical20 de tope70; apoyo al bloque y cara de columna |  |  |  |  | 1.000 | ud | TT10_C05_PC_03 | Dimensiones y mecanizados según plano nativo actualizado.

Sheet: BOM CAD
SESUVECA - TOLVA TROMPO / BOM DEL MODELO ACTIVO
Estado | NO LIBERADA PARA FABRICACIÓN
Cód. | 492 | Instancias | 996 | Masa disponible (kg) | 17378.657 |  | Masas n/d | 83
Autor | JAVIER ACEVEDO |  | 25/10/2026; fuente: TT10_C05_CONJUNTO.SLDASM, modelo interno C06.
Masa disponible excluye masas n/d. Los cajones se cuentan completos aquí; sus chapas se detallan sin sumar dos veces.
Pos. | Código | Cantidad | Descripción de la geometría vigente | Material / especificación | Masa unitaria kg | Masa disponible kg | Suministro | Volumen nativo m³ | Archivo nativo | Base de masa
1 | TT10_22240_N | 1 | SKF22240CC/W33 200x360x98; envolvente sin rodillos | Conjunto comprado; acero/ fundición según OEM | 43.500 | 43.500 | Compra | 0.006892 | C05E_TT10_22240_N.SLDPRT | Catálogo/fuente conservada
2 | TT10_22240_P | 1 | SKF22240CC/W33 200x360x98; envolvente sin rodillos | Conjunto comprado; acero/ fundición según OEM | 43.500 | 43.500 | Compra | 0.006892 | C05E_TT10_22240_P.SLDPRT | Catálogo/fuente conservada
3 | TT10_BAP_P0 | 32 | Perno ISO4014 M30x140 clase8.8; rosca nominal | Clase 8.8 / ISO 898-1 | 1.046 | 33.467 | Compra | 0.000133 | C05E_TT10_BAP_P0.SLDPRT | CAD_volume_x_specified_density
4 | TT10_BUJE_PIN_N | 1 | Casquillo CuSn12 Ø69 s6 / Ø65.5 H9 final, L85, C0.5 interiores | CuSn12 / EN 1982 | 0.276 | 0.276 | Fabricación | 0.000031 | C05E_TT10_BUJE_PIN_N.SLDPRT | CAD_volume_x_specified_density
5 | TT10_BUJE_PIN_P | 1 | Casquillo CuSn12 Ø69 s6 / Ø65.5 H9 final, L85, C0.5 interiores | CuSn12 / EN 1982 | 0.276 | 0.276 | Fabricación | 0.000031 | C05E_TT10_BUJE_PIN_P.SLDPRT | CAD_volume_x_specified_density
6 | TT10_C03_ACCESO_PUERTO_N | 1 | Guia de herramienta desde exterior N; puerto nominal rear+15.5/Z+53.7; NO conexion remota al actuador | ASTM A36 | 0.154 | 0.154 | Fabricación | 0.000020 | C05E_TT10_C03_ACCESO_PUERTO_N.SLDPRT | CAD_volume_x_specified_density
7 | TT10_C03_ACCESO_PUERTO_P | 1 | Guia de herramienta desde exterior P; puerto nominal rear+15.5/Z+53.7; NO conexion remota al actuador | ASTM A36 | 0.154 | 0.154 | Fabricación | 0.000020 | C05E_TT10_C03_ACCESO_PUERTO_P.SLDPRT | CAD_volume_x_specified_density
8 | TT10_C03_CADENA_ESLABON | 122 | Renold16B1: referencia visual de eslabon; no fabricar. Rodillos compartidos representados dos veces | Equipo comprado Renold | 0.071 | 8.677 | Compra | 0.000010 | C05E_TT10_C03_CADENA_ESLABON.SLDPRT | Catálogo/fuente conservada
9 | TT10_C03_HK4020_E1 | 1 | SKF HK4020; 40x47x20; rodillos y jaula omitidos | Conjunto comprado; acero/ fundición según OEM |  |  | Compra | 0.000010 | C05E_TT10_C03_HK4020_E1.SLDPRT | OEM_mass_required
10 | TT10_C03_HK4020_E2 | 1 | SKF HK4020; 40x47x20; rodillos y jaula omitidos | Conjunto comprado; acero/ fundición según OEM |  |  | Compra | 0.000010 | C05E_TT10_C03_HK4020_E2.SLDPRT | OEM_mass_required
11 | TT10_C03_HK4020_M1 | 1 | SKF HK4020; 40x47x20; rodillos y jaula omitidos | Conjunto comprado; acero/ fundición según OEM |  |  | Compra | 0.000010 | C05E_TT10_C03_HK4020_M1.SLDPRT | OEM_mass_required
12 | TT10_C03_HK4020_M2 | 1 | SKF HK4020; 40x47x20; rodillos y jaula omitidos | Conjunto comprado; acero/ fundición según OEM |  |  | Compra | 0.000010 | C05E_TT10_C03_HK4020_M2.SLDPRT | OEM_mass_required
13 | TT10_C03_REGISTRO_PUERTO_N | 1 | Registro exterior desmontable3 con accesoD50; fijaciones/proteccion de puesto por completar | ASTM A36 | 0.849 | 0.849 | Fabricación | 0.000108 | C05E_TT10_C03_REGISTRO_PUERTO_N.SLDPRT | CAD_volume_x_specified_density
14 | TT10_C03_REGISTRO_PUERTO_P | 1 | Registro exterior desmontable3 con accesoD50; fijaciones/proteccion de puesto por completar | ASTM A36 | 0.849 | 0.849 | Fabricación | 0.000108 | C05E_TT10_C03_REGISTRO_PUERTO_P.SLDPRT | CAD_volume_x_specified_density
15 | TT10_C03_SELECTOR_6008_1 | 1 | SKF6008 40x68x15; contorno de interfaz | Conjunto comprado; acero/ fundición según OEM |  |  | Compra | 0.000036 | C05E_TT10_C03_SELECTOR_6008_1.SLDPRT | OEM_mass_required
16 | TT10_C03_SELECTOR_6008_2 | 1 | SKF6008 40x68x15; contorno de interfaz | Conjunto comprado; acero/ fundición según OEM |  |  | Compra | 0.000036 | C05E_TT10_C03_SELECTOR_6008_2.SLDPRT | OEM_mass_required
17 | TT10_C03_SELECTOR_COLLAR_1 | 1 | Collar de varilla para sujetar horquilla; fijacion radial y retencion por completar | C45E / EN 10083-2 | 0.010 | 0.010 | Fabricación | 0.000001 | C05E_TT10_C03_SELECTOR_COLLAR_1.SLDPRT | CAD_volume_x_specified_density
18 | TT10_C03_SELECTOR_COLLAR_2 | 1 | Collar de varilla para sujetar horquilla; fijacion radial y retencion por completar | C45E / EN 10083-2 | 0.010 | 0.010 | Fabricación | 0.000001 | C05E_TT10_C03_SELECTOR_COLLAR_2.SLDPRT | CAD_volume_x_specified_density
19 | TT10_C03_SELECTOR_CUBIERTA | 1 | Cubierta desmontable3; ranura50x36 para recorrido completo; cierreM6 por detallar | ASTM A36 | 0.483 | 0.483 | Fabricación | 0.000062 | C05E_TT10_C03_SELECTOR_CUBIERTA.SLDPRT | CAD_volume_x_specified_density
20 | TT10_C03_SELECTOR_ENCLAVAMIENTO | 1 | Pasador positivoD6; levantar16mm antes de seleccionar y reinsertar; retencion cautiva y mando remoto pendientes | C45E / EN 10083-2 | 0.009 | 0.009 | Fabricación | 0.000001 | C05E_TT10_C03_SELECTOR_ENCLAVAMIENTO.SLDPRT | CAD_volume_x_specified_density
21 | TT10_C03_SELECTOR_HORQUILLA | 1 | Horquilla10 en ranura12; 1 mm nominal por flanco; garras de seleccion con la maquina parada | ASTM A36 | 0.443 | 0.443 | Fabricación | 0.000056 | C05E_TT10_C03_SELECTOR_HORQUILLA.SLDPRT | CAD_volume_x_specified_density
22 | TT10_C03_SELECTOR_MANGUITO | 1 | Manguito estriado: neutro X923..979; E+18/M-18; 6 alojamientos D12.2 PCD72 por cara | AISI 4140 bonificado | 1.865 | 1.865 | Fabricación | 0.000238 | C05E_TT10_C03_SELECTOR_MANGUITO.SLDPRT | CAD_volume_x_specified_density
23 | TT10_C03_SELECTOR_PARED_E | 1 | Pared mecanizada8; roscasM6; tapa de retencion y asiento axial por cadena de cotas | ASTM A36 | 2.386 | 2.386 | Fabricación | 0.000304 | C05E_TT10_C03_SELECTOR_PARED_E.SLDPRT | CAD_volume_x_specified_density
24 | TT10_C03_SELECTOR_PARED_M | 1 | Pared mecanizada8; roscasM6; tapa de retencion y asiento axial por cadena de cotas | ASTM A36 | 2.386 | 2.386 | Fabricación | 0.000304 | C05E_TT10_C03_SELECTOR_PARED_M.SLDPRT | CAD_volume_x_specified_density
25 | TT10_C03_SELECTOR_VARILLA | 1 | Varilla selector D16; tres taladrosD6.5 con paso18; E-N-M por pasador positivo | C45E / EN 10083-2 | 0.272 | 0.272 | Fabricación | 0.000035 | C05E_TT10_C03_SELECTOR_VARILLA.SLDPRT | CAD_volume_x_specified_density
26 | TT10_C03_TAPA_RETENCION_E | 1 | Tapa estacionaria: labio axial para cuboD100, pasoD92 libre al manguitoD90; junta axial0.2 por ajustar | ASTM A36 | 0.153 | 0.153 | Fabricación | 0.000019 | C05E_TT10_C03_TAPA_RETENCION_E.SLDPRT | CAD_volume_x_specified_density
27 | TT10_C03_TAPA_RETENCION_M | 1 | Tapa estacionaria: labio axial para cuboD100, pasoD92 libre al manguitoD90; junta axial0.2 por ajustar | ASTM A36 | 0.153 | 0.153 | Fabricación | 0.000019 | C05E_TT10_C03_TAPA_RETENCION_M.SLDPRT | CAD_volume_x_specified_density
28 | TT10_C04_ACOPLE_0 | 1 | Brida110x8,PCD82/6M8; bore30H7; asiento25, desmontaje axial | C45E / EN 10083-2 | 0.834 | 0.834 | Fabricación | 0.000106 | C05E_TT10_C04_ACOPLE_0.SLDPRT | CAD_volume_x_specified_density
29 | TT10_C04_ACOPLE_1 | 1 | Brida110x8,PCD82/6M8; bore30H7; asiento30, desmontaje axial | C45E / EN 10083-2 | 0.870 | 0.870 | Fabricación | 0.000111 | C05E_TT10_C04_ACOPLE_1.SLDPRT | CAD_volume_x_specified_density
30 | TT10_C04_ACOPLE_B8_0 | 4 | M8x25,8.8; cabeza exterior; apriete por plano | Clase 10.9 / ISO 898-1 | 0.016 | 0.064 | Compra | 0.000002 | C05E_TT10_C04_ACOPLE_B8_0.SLDPRT | CAD_volume_x_specified_density
31 | TT10_C04_ACOPLE_B8_4 | 2 | M8x25,8.8; cabeza exterior; apriete por plano | Clase 10.9 / ISO 898-1 | 0.016 | 0.032 | Compra | 0.000002 | C05E_TT10_C04_ACOPLE_B8_4.SLDPRT | CAD_volume_x_specified_density
32 | TT10_C04_ACOPLE_N8_0 | 4 | TuercaM8 clase8, autoblocante nominal | Tuerca clase 10 / ISO 898-2 | 0.005 | 0.020 | Compra | 0.000001 | C05E_TT10_C04_ACOPLE_N8_0.SLDPRT | CAD_volume_x_specified_density
33 | TT10_C04_ACOPLE_N8_2 | 2 | TuercaM8 clase8, autoblocante nominal | Tuerca clase 10 / ISO 898-2 | 0.005 | 0.010 | Compra | 0.000001 | C05E_TT10_C04_ACOPLE_N8_2.SLDPRT | CAD_volume_x_specified_density
34 | TT10_C04_ASIENTO_CHUMACERAS | 1 | Bloque90x180x52.1; cara superior mecanizada y4M12 ciegas28 | Conjunto comprado; acero/ fundición según OEM |  |  | Compra | 0.000831 | C05E_TT10_C04_ASIENTO_CHUMACERAS.SLDPRT | OEM_mass_required
35 | TT10_C04_B6008_M6_1_0 | 2 | M6x20 ISO7380-1,10.9; contorno nominal | Clase 10.9 / ISO 898-1 | 0.007 | 0.013 | Compra | 0.000001 | C05E_TT10_C04_B6008_M6_1_0.SLDPRT | CAD_volume_x_specified_density
36 | TT10_C04_B6008_M6_1_2 | 1 | M6x20 ISO7380-1,10.9; contorno nominal | Clase 10.9 / ISO 898-1 | 0.007 | 0.007 | Compra | 0.000001 | C05E_TT10_C04_B6008_M6_1_2.SLDPRT | CAD_volume_x_specified_density
37 | TT10_C04_B6008_M6_1_3 | 1 | M6x20 ISO7380-1,10.9; contorno nominal | Clase 10.9 / ISO 898-1 | 0.007 | 0.007 | Compra | 0.000001 | C05E_TT10_C04_B6008_M6_1_3.SLDPRT | CAD_volume_x_specified_density
38 | TT10_C04_B6008_M6_2_0 | 2 | M6x20 ISO7380-1,10.9; contorno nominal | Clase 10.9 / ISO 898-1 | 0.007 | 0.013 | Compra | 0.000001 | C05E_TT10_C04_B6008_M6_2_0.SLDPRT | CAD_volume_x_specified_density
39 | TT10_C04_B6008_M6_2_1 | 2 | M6x20 ISO7380-1,10.9; contorno nominal | Clase 10.9 / ISO 898-1 | 0.007 | 0.013 | Compra | 0.000001 | C05E_TT10_C04_B6008_M6_2_1.SLDPRT | CAD_volume_x_specified_density
40 | TT10_C04_BANCADA | 1 | Bancada215x200x20, sobre poste corto; soldaduraa3 | ASTM A36 | 6.746 | 6.746 | Fabricación | 0.000859 | C05E_TT10_C04_BANCADA.SLDPRT | CAD_volume_x_specified_density
41 | TT10_C04_CARTELA_0 | 1 | Cartela12,165x55, a3 continuo a placa y poste | ASTM A36 | 0.427 | 0.427 | Fabricación | 0.000054 | C05E_TT10_C04_CARTELA_0.SLDPRT | CAD_volume_x_specified_density
42 | TT10_C04_CARTELA_1 | 1 | Cartela12,165x55, a3 continuo a placa y poste | ASTM A36 | 0.427 | 0.427 | Fabricación | 0.000054 | C05E_TT10_C04_CARTELA_1.SLDPRT | CAD_volume_x_specified_density
43 | TT10_C04_CHAVETA_ACOPLE_0 | 1 | Chaveta8x7x25 | AISI 4140 bonificado | 0.011 | 0.011 | Compra | 0.000001 | C05E_TT10_C04_CHAVETA_ACOPLE_0.SLDPRT | CAD_volume_x_specified_density
44 | TT10_C04_CHAVETA_ACOPLE_1 | 1 | Chaveta8x7x30 | AISI 4140 bonificado | 0.013 | 0.013 | Compra | 0.000002 | C05E_TT10_C04_CHAVETA_ACOPLE_1.SLDPRT | CAD_volume_x_specified_density
45 | TT10_C04_CHAVETA_CORONA | 1 | Chaveta8x7x40 de corona | AISI 4140 bonificado | 0.018 | 0.018 | Compra | 0.000002 | C05E_TT10_C04_CHAVETA_CORONA.SLDPRT | CAD_volume_x_specified_density
46 | TT10_C04_CHAVETA_MOTOR | 1 | Chaveta12x8x35, extremos planos; interfaz propia, no ejeOEM aprobado | Equipo comprado; materiales y masa según ficha OEM |  |  | Compra | 0.000003 | C05E_TT10_C04_CHAVETA_MOTOR.SLDPRT | OEM_mass_required
47 | TT10_C04_CORONA_20D | 1 | Corona10888120; bore30H7 y chavetero8JS9 abierto al bore en todo su ancho; dentado comprado simplificado | C45E |  |  | Compra | 0.000508 | C05E_TT10_C04_CORONA_20D.SLDPRT | OEM_mass_required
48 | TT10_C04_DIN471_40 | 1 | ComprarDIN471-40,1.75; contorno instalado simplificado, no fabricar | Acero resorte DIN471 | 0.009 | 0.009 | Compra | 0.000001 | C05E_TT10_C04_DIN471_40.SLDPRT | CAD_volume_x_specified_density
49 | TT10_C04_EJE_MANUAL | 1 | EjeD30h7,L184; chaveteros8x7, t1=4, extremos planos | AISI 4140 bonificado | 1.005 | 1.005 | Fabricación | 0.000128 | C05E_TT10_C04_EJE_MANUAL.SLDPRT | CAD_volume_x_specified_density
50 | TT10_C04_EJE_TIMON | 1 | Eje heredado con extremoX1026 y chavetero adicional8x7x30; Mayr conservado | AISI 4140 bonificado | 1.477 | 1.477 | Fabricación | 0.000188 | C05E_TT10_C04_EJE_TIMON.SLDPRT | CAD_volume_x_specified_density
51 | TT10_C04_ENTRADA_MOTOR | 1 | Interfaz nominal de entradaD40, separacion2mm del ejecomun; motor comercial aun nominal | Equipo comprado; materiales y masa según ficha OEM |  |  | Compra | 0.000109 | C05E_TT10_C04_ENTRADA_MOTOR.SLDPRT | OEM_mass_required
52 | TT10_C04_ESPACIADOR6008 | 1 | Separador7 entre tapa izquierda y anillo exterior6008 | Conjunto comprado; acero/ fundición según OEM |  |  | Compra | 0.000012 | C05E_TT10_C04_ESPACIADOR6008.SLDPRT | OEM_mass_required
53 | TT10_C04_GUARDA_ANCLA6_4470 | 1 | M6x16,8.8 a bancada; no anclaje a losa | Tornilleria8.8 |  |  | Compra | 0.000001 | C05E_TT10_C04_GUARDA_ANCLA6_4470.SLDPRT | OEM_mass_required
54 | TT10_C04_GUARDA_ANCLA6_4630 | 1 | M6x16,8.8 a bancada; no anclaje a losa | Tornilleria8.8 |  |  | Compra | 0.000001 | C05E_TT10_C04_GUARDA_ANCLA6_4630.SLDPRT | OEM_mass_required
55 | TT10_C04_GUARDA_B6_0 | 4 | M6x50,8.8 para tapa frontal | Clase 8.8 / ISO 898-1 | 0.014 | 0.055 | Compra | 0.000002 | C05E_TT10_C04_GUARDA_B6_0.SLDPRT | CAD_volume_x_specified_density
56 | TT10_C04_GUARDA_BANDA | 1 | Banda2, ancho36; tapa inferior; soldar a posterior, frontal desmontable | ASTM A36 | 1.897 | 1.897 | Fabricación | 0.000242 | C05E_TT10_C04_GUARDA_BANDA.SLDPRT | CAD_volume_x_specified_density
57 | TT10_C04_GUARDA_BASEW6_4470 | 1 | Arandela6,12x6.6x2 | Arandela endurecida 300 HV / ISO 7089 |  |  | Compra | 1.577707831e-07 | C05E_TT10_C04_GUARDA_BASEW6_4470.SLDPRT | OEM_mass_required
58 | TT10_C04_GUARDA_BASEW6_4630 | 1 | Arandela6,12x6.6x2 | Arandela endurecida 300 HV / ISO 7089 |  |  | Compra | 1.577707831e-07 | C05E_TT10_C04_GUARDA_BASEW6_4630.SLDPRT | OEM_mass_required
59 | TT10_C04_GUARDA_FRONTAL | 1 | Chapa2; contorno de cadena; inferiorZ1107; paso superior/FRONTAL | ASTM A36 | 4.501 | 4.501 | Fabricación | 0.000573 | C05E_TT10_C04_GUARDA_FRONTAL.SLDPRT | CAD_volume_x_specified_density
60 | TT10_C04_GUARDA_N6_0 | 3 | TuercaM6 autoblocante metalica; contorno nominal | Tornilleria8 |  |  | Compra | 3.49969239e-07 | C05E_TT10_C04_GUARDA_N6_0.SLDPRT | OEM_mass_required
61 | TT10_C04_GUARDA_N6_2 | 1 | TuercaM6 autoblocante metalica; contorno nominal | Tornilleria8 |  |  | Compra | 3.49969239e-07 | C05E_TT10_C04_GUARDA_N6_2.SLDPRT | OEM_mass_required
62 | TT10_C04_GUARDA_POSTERIOR | 1 | Chapa2; contorno de cadena; inferiorZ1107; paso superior/POSTERIOR | ASTM A36 | 4.465 | 4.465 | Fabricación | 0.000569 | C05E_TT10_C04_GUARDA_POSTERIOR.SLDPRT | CAD_volume_x_specified_density
63 | TT10_C04_GUARDA_W6_0 | 3 | ArandelaM6,12x6.6x1.6 | Arandela endurecida 300 HV / ISO 7089 |  |  | Compra | 1.262166265e-07 | C05E_TT10_C04_GUARDA_W6_0.SLDPRT | OEM_mass_required
64 | TT10_C04_GUARDA_W6_2 | 1 | ArandelaM6,12x6.6x1.6 | Arandela endurecida 300 HV / ISO 7089 |  |  | Compra | 1.262166265e-07 | C05E_TT10_C04_GUARDA_W6_2.SLDPRT | OEM_mass_required
65 | TT10_C04_PEDESTAL_SELECTOR | 1 | Pedestal con ventana46 para paso real de cadena/resguardo; soporte local por verificar | ASTM A36 | 121.438 | 121.438 | Fabricación | 0.015470 | C05E_TT10_C04_PEDESTAL_SELECTOR.SLDPRT | CAD_volume_x_specified_density
66 | TT10_C04_PLACA_TIMON | 1 | Placa de estacion existente con ventanaR57x25 para bridas110; apoyos yMayr conservados | ASTM A36 | 6.747 | 6.747 | Fabricación | 0.000859 | C05E_TT10_C04_PLACA_TIMON.SLDPRT | CAD_volume_x_specified_density
67 | TT10_C04_SELECTOR_APOYO_1 | 1 | Asiento6008 abierto; montaje axial y4M6PCD84; no cavidad inaccesible | Conjunto comprado; acero/ fundición según OEM |  |  | Compra | 0.000512 | C05E_TT10_C04_SELECTOR_APOYO_1.SLDPRT | OEM_mass_required
68 | TT10_C04_SELECTOR_APOYO_2 | 1 | Asiento6008 abierto; montaje axial y4M6PCD84; no cavidad inaccesible | Conjunto comprado; acero/ fundición según OEM |  |  | Compra | 0.000378 | C05E_TT10_C04_SELECTOR_APOYO_2.SLDPRT | OEM_mass_required
69 | TT10_C04_SELECTOR_BASE | 1 | Soporte con ventana46mm para cadena y guarda; caras restantes transmiten apoyo | ASTM A36 | 10.625 | 10.625 | Fabricación | 0.001354 | C05E_TT10_C04_SELECTOR_BASE.SLDPRT | CAD_volume_x_specified_density
70 | TT10_C04_SELECTOR_CUBO_E | 1 | CuboE con extension; pasoD41 hastaX1062, socketD40H7 y chavetero12x35 | AISI 4140 bonificado | 4.038 | 4.038 | Fabricación | 0.000514 | C05E_TT10_C04_SELECTOR_CUBO_E.SLDPRT | CAD_volume_x_specified_density
71 | TT10_C04_SELECTOR_EJE | 1 | Eje D40h6; extremoX1060; ranuraDIN471D37.5x1.85 enX855.1 | 42CrMo4+QT; pistas58-64HRC |  |  | Compra | 0.000413 | C05E_TT10_C04_SELECTOR_EJE.SLDPRT | OEM_mass_required
72 | TT10_C04_SELECTOR_ESPACIADOR | 1 | Soporte con ventana46mm para cadena y guarda; caras restantes transmiten apoyo | ASTM A36 | 6.500 | 6.500 | Fabricación | 0.000828 | C05E_TT10_C04_SELECTOR_ESPACIADOR.SLDPRT | CAD_volume_x_specified_density
73 | TT10_C04_SY30_B12_930_4491.25 | 2 | M12x45,8.8;25.5mm nominales de rosca util | Clase 8.8 / ISO 898-1 | 0.056 | 0.113 | Compra | 0.000007 | C05E_TT10_C04_SY30_B12_930_4491.25.SLDPRT | CAD_volume_x_specified_density
74 | TT10_C04_SY30_B12_972_4491.25 | 2 | M12x45,8.8;25.5mm nominales de rosca util | Clase 8.8 / ISO 898-1 | 0.056 | 0.113 | Compra | 0.000007 | C05E_TT10_C04_SY30_B12_972_4491.25.SLDPRT | CAD_volume_x_specified_density
75 | TT10_C04_SY30_W12_930_4491.25 | 2 | ArandelaM12,24x13x2.5 | Arandela endurecida 300 HV / ISO 7089 |  |  | Compra | 0.000001 | C05E_TT10_C04_SY30_W12_930_4491.25.SLDPRT | OEM_mass_required
76 | TT10_C04_SY30_W12_930_4608.75 | 2 | ArandelaM12,24x13x2.5 | Arandela endurecida 300 HV / ISO 7089 |  |  | Compra | 0.000001 | C05E_TT10_C04_SY30_W12_930_4608.75.SLDPRT | OEM_mass_required
77 | TT10_C04_TAPA6008_1 | 1 | Tapa104x4, cabezas en cajera; desmontaje exterior | ASTM A36 | 0.194 | 0.194 | Fabricación | 0.000025 | C05E_TT10_C04_TAPA6008_1.SLDPRT | CAD_volume_x_specified_density
78 | TT10_C04_TAPA6008_2 | 1 | Tapa104x4, cabezas en cajera; desmontaje exterior | ASTM A36 | 0.179 | 0.179 | Fabricación | 0.000023 | C05E_TT10_C04_TAPA6008_2.SLDPRT | CAD_volume_x_specified_density
79 | TT10_C04_TRAVESANO | 1 | RHS100x50x5,L230; une los dos postes del puesto manual, a3 | S275J0H / EN 10219-1 | 2.528 | 2.528 | Fabricación | 0.000322 | C05E_TT10_C04_TRAVESANO.SLDPRT | CAD_volume_x_specified_density
80 | TT10_C05_ARANDELA_TENSOR_0 | 1 | Arandela puente44x21x4, endurecida, cubre ranura22 | Arandela endurecida 300 HV / ISO 7089 | 0.037 | 0.037 | Compra | 0.000005 | C05E_TT10_C05_ARANDELA_TENSOR_0.SLDPRT | CAD_volume_x_specified_density
81 | TT10_C05_ARANDELA_TENSOR_1 | 1 | Arandela puente44x21x4, endurecida, cubre ranura22 | Arandela endurecida 300 HV / ISO 7089 | 0.037 | 0.037 | Compra | 0.000005 | C05E_TT10_C05_ARANDELA_TENSOR_1.SLDPRT | CAD_volume_x_specified_density
82 | TT10_C05_ARANDELA_TENSOR_2 | 1 | Arandela puente44x21x4, endurecida, cubre ranura22 | Arandela endurecida 300 HV / ISO 7089 | 0.037 | 0.037 | Compra | 0.000005 | C05E_TT10_C05_ARANDELA_TENSOR_2.SLDPRT | CAD_volume_x_specified_density
83 | TT10_C05_ARANDELA_TENSOR_3 | 1 | Arandela puente44x21x4, endurecida, cubre ranura22 | Arandela endurecida 300 HV / ISO 7089 | 0.037 | 0.037 | Compra | 0.000005 | C05E_TT10_C05_ARANDELA_TENSOR_3.SLDPRT | CAD_volume_x_specified_density
84 | TT10_C05_B20_TENSOR_0 | 1 | Tornillo M20x45,ISO4017 8.8; geometria nominal | Clase 8.8 / ISO 898-1 | 0.187 | 0.187 | Compra | 0.000024 | C05E_TT10_C05_B20_TENSOR_0.SLDPRT | CAD_volume_x_specified_density
85 | TT10_C05_B20_TENSOR_1 | 1 | Tornillo M20x45,ISO4017 8.8; geometria nominal | Clase 8.8 / ISO 898-1 | 0.187 | 0.187 | Compra | 0.000024 | C05E_TT10_C05_B20_TENSOR_1.SLDPRT | CAD_volume_x_specified_density
86 | TT10_C05_B20_TENSOR_2 | 1 | Tornillo M20x45,ISO4017 8.8; geometria nominal | Clase 8.8 / ISO 898-1 | 0.187 | 0.187 | Compra | 0.000024 | C05E_TT10_C05_B20_TENSOR_2.SLDPRT | CAD_volume_x_specified_density
87 | TT10_C05_B20_TENSOR_3 | 1 | Tornillo M20x45,ISO4017 8.8; geometria nominal | Clase 8.8 / ISO 898-1 | 0.187 | 0.187 | Compra | 0.000024 | C05E_TT10_C05_B20_TENSOR_3.SLDPRT | CAD_volume_x_specified_density
88 | TT10_C05_B4_RETEN_0_0 | 1 | M4x9,8.8; tornillo del puente cautivo; fijador desmontable | Clase 10.9 / ISO 898-1 | 0.002 | 0.002 | Compra | 2.670353756e-07 | C05E_TT10_C05_B4_RETEN_0_0.SLDPRT | CAD_volume_x_specified_density
89 | TT10_C05_B4_RETEN_0_1 | 1 | M4x9,8.8; tornillo del puente cautivo; fijador desmontable | Clase 10.9 / ISO 898-1 | 0.002 | 0.002 | Compra | 2.670353756e-07 | C05E_TT10_C05_B4_RETEN_0_1.SLDPRT | CAD_volume_x_specified_density
90 | TT10_C05_B4_RETEN_1_0 | 1 | M4x9,8.8; tornillo del puente cautivo; fijador desmontable | Clase 10.9 / ISO 898-1 | 0.002 | 0.002 | Compra | 2.670353756e-07 | C05E_TT10_C05_B4_RETEN_1_0.SLDPRT | CAD_volume_x_specified_density
91 | TT10_C05_B4_RETEN_1_1 | 1 | M4x9,8.8; tornillo del puente cautivo; fijador desmontable | Clase 10.9 / ISO 898-1 | 0.002 | 0.002 | Compra | 2.670353756e-07 | C05E_TT10_C05_B4_RETEN_1_1.SLDPRT | CAD_volume_x_specified_density
92 | TT10_C05_BASE_FIJA_TENSOR | 1 | Base fija630x420x20; cuatro M20 roscados20;apriete100Nm;no son anclajes a losa | ASTM A36 | 40.576 | 40.576 | Fabricación | 0.005169 | C05E_TT10_C05_BASE_FIJA_TENSOR.SLDPRT | CAD_volume_x_specified_density
93 | TT10_C05_BDNB_28_23 | 1 | Warner BDNB 28.23Nm, brida lado entrada, exterior reconstruido según MCC-P-1310 03/25 p69; cotas nominales medias | Equipo comprado | 0.907 | 0.907 | Compra | 0.000115 | TT10_C05_BDNB_28_23.SLDPRT | Masa catálogo: 2 lb
94 | TT10_C05_BDNB_APOYO_0_INFERIOR | 1 | Apoyo partido6006, asientoH7, tapa2M6x60, roscasM6 cuerpo; soldaduraa4 base | ASTM A36 | 1.238 | 1.238 | Fabricación | 0.000158 | TT10_C05_BDNB_APOYO_0_INFERIOR_B02.SLDPRT | Volumen CAD y densidad
95 | TT10_C05_BDNB_APOYO_0_TAPA | 1 | Apoyo partido6006, asientoH7, tapa2M6x60, roscasM6 cuerpo; soldaduraa4 base | ASTM A36 | 0.294 | 0.294 | Fabricación | 0.000037 | TT10_C05_BDNB_APOYO_0_TAPA_B02.SLDPRT | Volumen CAD y densidad
96 | TT10_C05_BDNB_APOYO_1_INFERIOR | 1 | Apoyo partido6006, asientoH7, tapa2M6x60, roscasM6 cuerpo; soldaduraa4 base | ASTM A36 | 1.238 | 1.238 | Fabricación | 0.000158 | TT10_C05_BDNB_APOYO_1_INFERIOR_B02.SLDPRT | Volumen CAD y densidad
97 | TT10_C05_BDNB_APOYO_1_TAPA | 1 | Apoyo partido6006, asientoH7, tapa2M6x60, roscasM6 cuerpo; soldaduraa4 base | ASTM A36 | 0.294 | 0.294 | Fabricación | 0.000037 | TT10_C05_BDNB_APOYO_1_TAPA_B02.SLDPRT | Volumen CAD y densidad
98 | TT10_C05_BDNB_APOYO_2_INFERIOR | 1 | Apoyo partido6906, asientoH7, tapa2M6x60, roscasM6 cuerpo; soldaduraa4 base | ASTM A36 | 0.974 | 0.974 | Fabricación | 0.000124 | TT10_C05_BDNB_APOYO_2_INFERIOR.SLDPRT | Volumen CAD y densidad
99 | TT10_C05_BDNB_APOYO_2_TAPA | 1 | Apoyo partido6906, asientoH7, tapa2M6x60, roscasM6 cuerpo; soldaduraa4 base | ASTM A36 | 0.249 | 0.249 | Fabricación | 0.000032 | TT10_C05_BDNB_APOYO_2_TAPA.SLDPRT | Volumen CAD y densidad
100 | TT10_C05_BDNB_APOYO_3_INFERIOR | 1 | Apoyo partido6906, asientoH7, tapa2M6x60, roscasM6 cuerpo; soldaduraa4 base | ASTM A36 | 0.974 | 0.974 | Fabricación | 0.000124 | TT10_C05_BDNB_APOYO_3_INFERIOR.SLDPRT | Volumen CAD y densidad
101 | TT10_C05_BDNB_APOYO_3_TAPA | 1 | Apoyo partido6906, asientoH7, tapa2M6x60, roscasM6 cuerpo; soldaduraa4 base | ASTM A36 | 0.249 | 0.249 | Fabricación | 0.000032 | TT10_C05_BDNB_APOYO_3_TAPA.SLDPRT | Volumen CAD y densidad
102 | TT10_C05_BDNB_BASE | 1 | Base16 con ventana cadena,4pasos11;4M10x35 en placa existente roscadaM10 | ASTM A36 | 2.728 | 2.728 | Fabricación | 0.000348 | TT10_C05_BDNB_BASE.SLDPRT | Volumen CAD y densidad
103 | TT10_C05_BDNB_CHAVETA_ENTRADA | 1 | ChavetaDIN6885A8x7, longitud según código | C45E | 0.010 | 0.010 | Compra | 0.000001 | TT10_C05_BDNB_CHAVETA_ENTRADA.SLDPRT | Volumen CAD y densidad
104 | TT10_C05_BDNB_CHAVETA_SALIDA | 1 | ChavetaDIN6885A8x7, longitud según código | C45E | 0.009 | 0.009 | Compra | 0.000001 | TT10_C05_BDNB_CHAVETA_SALIDA.SLDPRT | Volumen CAD y densidad
105 | TT10_C05_BDNB_CORONA_20D | 1 | Mädler10888120: interfaz modificada30H7/8JS9; dentado visual simplificado | Equipo comprado |  |  | Compra | 0.000320 | TT10_C05_BDNB_CORONA_20D.SLDPRT | Masa comercial sin acreditar
106 | TT10_C05_BDNB_CUBO_SELECTOR | 1 | Cubo manual con corona integral z48,m2.5,20 grados; asiento47 y garras conservadas | AISI 4140 bonificado | 2.752 | 2.752 | Fabricación | 0.000351 | TT10_C05_BDNB_CUBO_SELECTOR.SLDPRT | Volumen CAD y densidad
107 | TT10_C05_BDNB_EJE_ENTRADA | 1 | Eje30h6; socket12.73; chaveta8x7; taladro transversal4.825 | AISI 4140 bonificado | 0.459 | 0.459 | Compra | 0.000059 | TT10_C05_BDNB_EJE_ENTRADA_B02.SLDPRT | Volumen CAD y densidad
108 | TT10_C05_BDNB_EJE_SALIDA | 1 | Eje30h6, espiga12.70; dos6906; chaveta8x7; unión positiva3/16 | AISI 4140 bonificado | 0.324 | 0.324 | Compra | 0.000041 | TT10_C05_BDNB_EJE_SALIDA.SLDPRT | Volumen CAD y densidad
109 | TT10_C05_BDNB_ENGRANAJE | 1 | Engranaje48d,m2.5,20grados,b20;30H7,8JS9 | AISI 4140 bonificado | 1.645 | 1.645 | Fabricación | 0.000209 | TT10_C05_BDNB_ENGRANAJE.SLDPRT | Volumen CAD y densidad
110 | TT10_C05_BDNB_M10 | 4 | TornilloISO4017 M10x35-8.8; rosca nominal | Clase 8.8 / ISO 898-1 | 0.033 | 0.131 | Compra | 0.000004 | TT10_C05_BDNB_M10.SLDPRT | Volumen CAD y densidad
111 | TT10_C05_BDNB_M5 | 4 | ISO4017 M5x20-8.8, rosca nominal | Clase 8.8 / ISO 898-1 | 0.005 | 0.018 | Compra | 0.000001 | TT10_C05_BDNB_M5.SLDPRT | Volumen CAD y densidad
112 | TT10_C05_BDNB_M6 | 8 | TornilloISO4017 M6x60-8.8; rosca nominal | Clase 8.8 / ISO 898-1 | 0.016 | 0.128 | Compra | 0.000002 | TT10_C05_BDNB_M6.SLDPRT | Volumen CAD y densidad
113 | TT10_C05_BDNB_N3_ENTRADA | 1 | TuercaISO7042 M3 autoblocante metálica, rosca nominal | Tuerca clase 8 / ISO 898-2 | 0.001 | 0.001 | Compra | 8.515411977e-08 | TT10_C05_BDNB_N3_ENTRADA.SLDPRT | Volumen CAD y densidad
114 | TT10_C05_BDNB_N3_SALIDA | 1 | TuercaISO7042 M3 autoblocante metálica, rosca nominal | Tuerca clase 8 / ISO 898-2 | 0.001 | 0.001 | Compra | 8.515411977e-08 | TT10_C05_BDNB_N3_SALIDA.SLDPRT | Volumen CAD y densidad
115 | TT10_C05_BDNB_N5 | 4 | TuercaISO4032 M5-8; rosca nominal | Tuerca clase 8 / ISO 898-2 | 0.001 | 0.005 | Compra | 1.66284809e-07 | TT10_C05_BDNB_N5.SLDPRT | Volumen CAD y densidad
116 | TT10_C05_BDNB_PASADOR_ENTRADA | 1 | Pasador transversal3/16, cabeza7, puntaM3x5; C45E bonificado, Rp0.2 minimo650MPa | C45E / EN 10083-2 | 0.006 | 0.006 | Fabricación | 0.000001 | TT10_C05_BDNB_PASADOR_ENTRADA.SLDPRT | Volumen CAD y densidad
117 | TT10_C05_BDNB_PASADOR_SALIDA | 1 | Pasador transversal3/16, cabeza7, puntaM3x5; C45E bonificado, Rp0.2 minimo650MPa | C45E / EN 10083-2 | 0.004 | 0.004 | Fabricación | 0.000001 | TT10_C05_BDNB_PASADOR_SALIDA.SLDPRT | Volumen CAD y densidad
118 | TT10_C05_BDNB_PLACA_REACCION | 1 | Reacción BDNB8mm,4Ø5.5PCD53.85; soldaduraa4 ambos lados a base | ASTM A36 | 0.843 | 0.843 | Fabricación | 0.000107 | TT10_C05_BDNB_PLACA_REACCION.SLDPRT | Volumen CAD y densidad
119 | TT10_C05_BDNB_RODAMIENTO_0 | 1 | RodamientoSKF6006; envolvente de montaje; selección de vida separada | Equipo comprado |  |  | Compra | 0.000022 | TT10_C05_BDNB_RODAMIENTO_0_B02.SLDPRT | Masa comercial sin acreditar
120 | TT10_C05_BDNB_RODAMIENTO_1 | 1 | RodamientoSKF6006; envolvente de montaje; selección de vida separada | Equipo comprado |  |  | Compra | 0.000022 | TT10_C05_BDNB_RODAMIENTO_1_B02.SLDPRT | Masa comercial sin acreditar
121 | TT10_C05_BDNB_RODAMIENTO_2 | 1 | RodamientoSKF6906; envolvente de montaje; selección de vida separada | Equipo comprado |  |  | Compra | 0.000009 | TT10_C05_BDNB_RODAMIENTO_2.SLDPRT | Masa comercial sin acreditar
122 | TT10_C05_BDNB_RODAMIENTO_3 | 1 | RodamientoSKF6906; envolvente de montaje; selección de vida separada | Equipo comprado |  |  | Compra | 0.000009 | TT10_C05_BDNB_RODAMIENTO_3.SLDPRT | Masa comercial sin acreditar
123 | TT10_C05_BDNB_W10 | 4 | ArandelaISO7089 M10 | Arandela endurecida 300 HV / ISO 7089 | 0.004 | 0.014 | Compra | 4.551382357e-07 | TT10_C05_BDNB_W10.SLDPRT | Volumen CAD y densidad
124 | TT10_C05_BDNB_W5 | 4 | ArandelaDIN433 M5,9x5.3x1 | Arandela endurecida 300 HV / ISO 7089 | 0.0003262100221 | 0.001 | Compra | 4.155541683e-08 | TT10_C05_BDNB_W5.SLDPRT | Volumen CAD y densidad
125 | TT10_C05_BDNB_W6 | 8 | ArandelaISO7089 M6 | Arandela endurecida 300 HV / ISO 7089 | 0.001 | 0.008 | Compra | 1.294838828e-07 | TT10_C05_BDNB_W6.SLDPRT | Volumen CAD y densidad
126 | TT10_C05_BLOQUE_SELECTOR | 1 | BloqueC03 conservado con4M4laterales para retencion cautiva | ASTM A36 | 0.417 | 0.417 | Fabricación | 0.000053 | C05E_TT10_C05_BLOQUE_SELECTOR.SLDPRT | CAD_volume_x_specified_density
127 | TT10_C05_CORREDERA_TENSOR | 1 | Corredera comun590x320x20;4ranuras22x62; carrera Y+/-20mm; ambos postes solidarios | ASTM A36 | 28.852 | 28.852 | Fabricación | 0.003675 | C05E_TT10_C05_CORREDERA_TENSOR.SLDPRT | CAD_volume_x_specified_density
128 | TT10_C05_GUIA_TENSOR_0 | 1 | Guia lateral mecanizada;holgura transversal total0.3..0.5mm; soldar a base fija y mecanizar despues | ASTM A36 | 1.116 | 1.116 | Fabricación | 0.000142 | C05E_TT10_C05_GUIA_TENSOR_0.SLDPRT | CAD_volume_x_specified_density
129 | TT10_C05_GUIA_TENSOR_1 | 1 | Guia lateral mecanizada;holgura transversal total0.3..0.5mm; soldar a base fija y mecanizar despues | ASTM A36 | 1.116 | 1.116 | Fabricación | 0.000142 | C05E_TT10_C05_GUIA_TENSOR_1.SLDPRT | CAD_volume_x_specified_density
130 | TT10_C05_JACK_M16_0_0 | 1 | M16x80,8.8 de regulacion; rosca total; punta plana; bloquear con contratuerca | 8.8 |  |  | Compra | 0.000020 | C05E_TT10_C05_JACK_M16_0_0.SLDPRT | OEM_mass_required
131 | TT10_C05_JACK_M16_0_1 | 1 | M16x80,8.8 de regulacion; rosca total; punta plana; bloquear con contratuerca | 8.8 |  |  | Compra | 0.000020 | C05E_TT10_C05_JACK_M16_0_1.SLDPRT | OEM_mass_required
132 | TT10_C05_JACK_M16_1_0 | 1 | M16x80,8.8 de regulacion; rosca total; punta plana; bloquear con contratuerca | 8.8 |  |  | Compra | 0.000020 | C05E_TT10_C05_JACK_M16_1_0.SLDPRT | OEM_mass_required
133 | TT10_C05_JACK_M16_1_1 | 1 | M16x80,8.8 de regulacion; rosca total; punta plana; bloquear con contratuerca | 8.8 |  |  | Compra | 0.000020 | C05E_TT10_C05_JACK_M16_1_1.SLDPRT | OEM_mass_required
134 | TT10_C05_JAM_M16_0_0 | 1 | ContratuercaM16 clase8; mantener ajuste con cuatro M20 apretados | Tuerca clase 8 / ISO 898-2 | 0.014 | 0.014 | Compra | 0.000002 | C05E_TT10_C05_JAM_M16_0_0.SLDPRT | CAD_volume_x_specified_density
135 | TT10_C05_JAM_M16_0_1 | 1 | ContratuercaM16 clase8; mantener ajuste con cuatro M20 apretados | Tuerca clase 8 / ISO 898-2 | 0.014 | 0.014 | Compra | 0.000002 | C05E_TT10_C05_JAM_M16_0_1.SLDPRT | CAD_volume_x_specified_density
136 | TT10_C05_JAM_M16_1_0 | 1 | ContratuercaM16 clase8; mantener ajuste con cuatro M20 apretados | Tuerca clase 8 / ISO 898-2 | 0.014 | 0.014 | Compra | 0.000002 | C05E_TT10_C05_JAM_M16_1_0.SLDPRT | CAD_volume_x_specified_density
137 | TT10_C05_JAM_M16_1_1 | 1 | ContratuercaM16 clase8; mantener ajuste con cuatro M20 apretados | Tuerca clase 8 / ISO 898-2 | 0.014 | 0.014 | Compra | 0.000002 | C05E_TT10_C05_JAM_M16_1_1.SLDPRT | CAD_volume_x_specified_density
138 | TT10_C05_OREJA_TENSOR_0_0 | 1 | Oreja36x20x36;M16x2; soldaduraa6 a base fija | ASTM A36 | 0.172 | 0.172 | Fabricación | 0.000022 | C05E_TT10_C05_OREJA_TENSOR_0_0.SLDPRT | CAD_volume_x_specified_density
139 | TT10_C05_OREJA_TENSOR_0_1 | 1 | Oreja36x20x36;M16x2; soldaduraa6 a base fija | ASTM A36 | 0.172 | 0.172 | Fabricación | 0.000022 | C05E_TT10_C05_OREJA_TENSOR_0_1.SLDPRT | CAD_volume_x_specified_density
140 | TT10_C05_OREJA_TENSOR_1_0 | 1 | Oreja36x20x36;M16x2; soldaduraa6 a base fija | ASTM A36 | 0.172 | 0.172 | Fabricación | 0.000022 | C05E_TT10_C05_OREJA_TENSOR_1_0.SLDPRT | CAD_volume_x_specified_density
141 | TT10_C05_OREJA_TENSOR_1_1 | 1 | Oreja36x20x36;M16x2; soldaduraa6 a base fija | ASTM A36 | 0.172 | 0.172 | Fabricación | 0.000022 | C05E_TT10_C05_OREJA_TENSOR_1_1.SLDPRT | CAD_volume_x_specified_density
142 | TT10_C05_POSTE_CORTO_TENSOR | 1 | RHS50x50x5;L1037.5;recortado20para conservar altura del eje | S275J0H / EN 10219-1 | 7.330 | 7.330 | Fabricación | 0.000934 | C05E_TT10_C05_POSTE_CORTO_TENSOR.SLDPRT | CAD_volume_x_specified_density
143 | TT10_C05_POSTE_VOLANTE_TENSOR | 1 | Poste del volante recortado20mm; conservar mecanizado superior y centros | ASTM A36 | 23.316 | 23.316 | Fabricación | 0.002970 | C05E_TT10_C05_POSTE_VOLANTE_TENSOR.SLDPRT | CAD_volume_x_specified_density
144 | TT10_C05_RETEN_CAUTIVO_SELECTOR | 1 | Puente cautivo para pasadorD6;23mm hasta cabeza, permite levantar16mm;4M4 laterales al bloque | ASTM A36 | 0.112 | 0.112 | Fabricación | 0.000014 | C05E_TT10_C05_RETEN_CAUTIVO_SELECTOR.SLDPRT | CAD_volume_x_specified_density
145 | TT10_CART_N_INF | 1 | Cartela horizontal20 entre puente y placa de nodo | ASTM A36 | 2.708 | 2.708 | Fabricación | 0.000345 | C05E_TT10_CART_N_INF.SLDPRT | CAD_volume_x_specified_density
146 | TT10_CART_N_SUP | 1 | Cartela horizontal20 entre puente y placa de nodo | ASTM A36 | 2.708 | 2.708 | Fabricación | 0.000345 | C05E_TT10_CART_N_SUP.SLDPRT | CAD_volume_x_specified_density
147 | TT10_CART_P_INF | 1 | Cartela horizontal20 entre puente y placa de nodo | ASTM A36 | 2.708 | 2.708 | Fabricación | 0.000345 | C05E_TT10_CART_P_INF.SLDPRT | CAD_volume_x_specified_density
148 | TT10_CART_P_SUP | 1 | Cartela horizontal20 entre puente y placa de nodo | ASTM A36 | 2.708 | 2.708 | Fabricación | 0.000345 | C05E_TT10_CART_P_SUP.SLDPRT | CAD_volume_x_specified_density
149 | TT10_COLLAR_N | 1 | Casquillo D220/d200.2 L161: transmisión de apriete y pista de sello | C45E / EN 10083-2 | 8.259 | 8.259 | Fabricación | 0.001052 | C05E_TT10_COLLAR_N.SLDPRT | CAD_volume_x_specified_density
150 | TT10_COLLAR_P | 1 | Casquillo D220/d200.2 L161: transmisión de apriete y pista de sello | C45E / EN 10083-2 | 8.259 | 8.259 | Fabricación | 0.001052 | C05E_TT10_COLLAR_P.SLDPRT | CAD_volume_x_specified_density
151 | TT10_D_ACOPLE_SALIDA | 1 | Acoplamiento de salida entre cubo y reductor; dibujo nominal | Equipo comprado |  |  | Compra | 0.005781 | C05E_TT10_D_ACOPLE_SALIDA.SLDPRT | OEM_mass_required
152 | TT10_D_ARMARIO | 1 | Armario de variador y control; representación de presentación | Armario comercial; chapa y acabado según referencia de compra |  |  | Compra | 0.086800 | C05E_TT10_D_ARMARIO.SLDPRT | OEM_mass_required
153 | TT10_D_ARO_RESGUARDO_N | 1 | Resguardo tubular desmontable ARO_RESGUARDO_N | S275J0H / EN 10219-1 | 38.738 | 38.738 | Fabricación | 0.004935 | C05E_TT10_D_ARO_RESGUARDO_N.SLDPRT | CAD_volume_x_specified_density
154 | TT10_D_ARO_RESGUARDO_P | 1 | Resguardo tubular desmontable ARO_RESGUARDO_P | S275J0H / EN 10219-1 | 38.738 | 38.738 | Fabricación | 0.004935 | C05E_TT10_D_ARO_RESGUARDO_P.SLDPRT | CAD_volume_x_specified_density
155 | TT10_D_AUX_4_1 | 1 | Reducción auxiliar 4:1; representación de arquitectura | Equipo sustituido por PSN 142 i5; no comprar variante 4:1 |  |  | Compra | 0.028675 | C05E_TT10_D_AUX_4_1.SLDPRT | OEM_mass_required
156 | TT10_D_B16_0 | 32 | Perno nominal M16x50 | Clase 10.9 / ISO 898-1 | 0.118 | 3.778 | Compra | 0.000015 | C05E_TT10_D_B16_0.SLDPRT | CAD_volume_x_specified_density
157 | TT10_D_BASE_ARMARIO | 1 | Base del armario | ASTM A36 | 10.613 | 10.613 | Fabricación | 0.001352 | C05E_TT10_D_BASE_ARMARIO.SLDPRT | CAD_volume_x_specified_density
158 | TT10_D_BASE_BOTONERA | 1 | Base de botonera | ASTM A36 | 5.087 | 5.087 | Fabricación | 0.000648 | C05E_TT10_D_BASE_BOTONERA.SLDPRT | CAD_volume_x_specified_density
159 | TT10_D_BASE_FRENO_N | 1 | Base de pedestal de freno N | ASTM A36 | 14.978 | 14.978 | Fabricación | 0.001908 | C05E_TT10_D_BASE_FRENO_N.SLDPRT | CAD_volume_x_specified_density
160 | TT10_D_BASE_FRENO_P | 1 | Base de pedestal de freno P | ASTM A36 | 14.978 | 14.978 | Fabricación | 0.001908 | C05E_TT10_D_BASE_FRENO_P.SLDPRT | CAD_volume_x_specified_density
161 | TT10_D_BASE_MOTOR | 1 | Placa base del segundo apoyo de bancada | ASTM A36 | 42.390 | 42.390 | Fabricación | 0.005400 | C05E_TT10_D_BASE_MOTOR.SLDPRT | CAD_volume_x_specified_density
162 | TT10_D_BASE_PRESENTE | 1 | Base del mando de hombre presente | ASTM A36 | 2.449 | 2.449 | Fabricación | 0.000312 | C05E_TT10_D_BASE_PRESENTE.SLDPRT | CAD_volume_x_specified_density
163 | TT10_D_BASE_RECUP_N | 1 | Base de mando de recuperación | ASTM A36 | 3.980 | 3.980 | Fabricación | 0.000507 | C05E_TT10_D_BASE_RECUP_N.SLDPRT | CAD_volume_x_specified_density
164 | TT10_D_BASE_RECUP_P | 1 | Base de mando de recuperación | ASTM A36 | 3.980 | 3.980 | Fabricación | 0.000507 | C05E_TT10_D_BASE_RECUP_P.SLDPRT | CAD_volume_x_specified_density
165 | TT10_D_BLANCO_PIN | 2 | Bandera de detección del pasador retirado | ASTM A36 | 0.078 | 0.155 | Fabricación | 0.000010 | C05E_TT10_D_BLANCO_PIN.SLDPRT | CAD_volume_x_specified_density
166 | TT10_D_BOTONERA | 1 | Botonera: subir, bajar, retorno y paro de emergencia | Dispositivo de mando comercial; materiales según referencia OEM |  |  | Compra | 0.004560 | C05E_TT10_D_BOTONERA.SLDPRT | OEM_mass_required
167 | TT10_D_BOTON_0 | 1 | Pulsador 0 | Dispositivo de mando comercial; materiales según referencia OEM |  |  | Compra | 0.000038 | C05E_TT10_D_BOTON_0.SLDPRT | OEM_mass_required
168 | TT10_D_BOTON_1 | 1 | Pulsador 1 | Dispositivo de mando comercial; materiales según referencia OEM |  |  | Compra | 0.000038 | C05E_TT10_D_BOTON_1.SLDPRT | OEM_mass_required
169 | TT10_D_BOTON_2 | 1 | Pulsador 2 | Dispositivo de mando comercial; materiales según referencia OEM |  |  | Compra | 0.000038 | C05E_TT10_D_BOTON_2.SLDPRT | OEM_mass_required
170 | TT10_D_CABLE_PESTILLO_FIN_N | 1 | Eje de conexión geométrica CABLE_PESTILLO_FIN_N | Cable/conducción comercial; composición según ficha |  |  | Compra | 0.000027 | C05E_TT10_D_CABLE_PESTILLO_FIN_N.SLDPRT | OEM_mass_required
171 | TT10_D_CABLE_PESTILLO_FIN_P | 1 | Eje de conexión geométrica CABLE_PESTILLO_FIN_P | Cable/conducción comercial; composición según ficha |  |  | Compra | 0.000027 | C05E_TT10_D_CABLE_PESTILLO_FIN_P.SLDPRT | OEM_mass_required
172 | TT10_D_CABLE_PESTILLO_N | 1 | Eje de conexión geométrica CABLE_PESTILLO_N | Cable/conducción comercial; composición según ficha |  |  | Compra | 0.000055 | C05E_TT10_D_CABLE_PESTILLO_N.SLDPRT | OEM_mass_required
173 | TT10_D_CABLE_PESTILLO_P | 1 | Eje de conexión geométrica CABLE_PESTILLO_P | Cable/conducción comercial; composición según ficha |  |  | Compra | 0.000055 | C05E_TT10_D_CABLE_PESTILLO_P.SLDPRT | OEM_mass_required
174 | TT10_D_CABLE_PESTILLO_SUP_N | 1 | Eje de conexión geométrica CABLE_PESTILLO_SUP_N | Cable/conducción comercial; composición según ficha |  |  | Compra | 0.000036 | C05E_TT10_D_CABLE_PESTILLO_SUP_N.SLDPRT | OEM_mass_required
175 | TT10_D_CABLE_PESTILLO_SUP_P | 1 | Eje de conexión geométrica CABLE_PESTILLO_SUP_P | Cable/conducción comercial; composición según ficha |  |  | Compra | 0.000036 | C05E_TT10_D_CABLE_PESTILLO_SUP_P.SLDPRT | OEM_mass_required
176 | TT10_D_CABLE_PRESENTE | 1 | Eje de conexión geométrica CABLE_PRESENTE | Cable/conducción comercial; composición según ficha |  |  | Compra | 0.000018 | C05E_TT10_D_CABLE_PRESENTE.SLDPRT | OEM_mass_required
177 | TT10_D_CARTELA_MOTOR_0 | 1 | Apoyo lateral desmontable de bancada | ASTM A36 | 4.160 | 4.160 | Fabricación | 0.000530 | C05E_TT10_D_CARTELA_MOTOR_0.SLDPRT | CAD_volume_x_specified_density
178 | TT10_D_CARTELA_MOTOR_1 | 1 | Apoyo lateral desmontable de bancada | ASTM A36 | 4.160 | 4.160 | Fabricación | 0.000530 | C05E_TT10_D_CARTELA_MOTOR_1.SLDPRT | CAD_volume_x_specified_density
179 | TT10_D_COLUMNA_MOTOR | 1 | Columna adicional RHS200x200; asiento sobre placa base | S275J0H / EN 10219-1 | 110.968 | 110.968 | Fabricación | 0.014136 | C05E_TT10_D_COLUMNA_MOTOR.SLDPRT | CAD_volume_x_specified_density
180 | TT10_D_CUBO_N | 1 | Cubo de conexión por apriete y brida de disco N | AISI 4140 bonificado | 76.969 | 76.969 | Fabricación | 0.009805 | C05E_TT10_D_CUBO_N.SLDPRT | CAD_volume_x_specified_density
181 | TT10_D_CUBO_P | 1 | Cubo de conexión por apriete y brida de disco P | AISI 4140 bonificado | 76.969 | 76.969 | Fabricación | 0.009805 | C05E_TT10_D_CUBO_P.SLDPRT | CAD_volume_x_specified_density
182 | TT10_D_DISCO_N | 1 | Disco de freno de salida N; diámetro nominal de dibujo | Equipo comprado |  |  | Compra | 0.035872 | C05E_TT10_D_DISCO_N.SLDPRT | OEM_mass_required
183 | TT10_D_DISCO_P | 1 | Disco de freno de salida P; diámetro nominal de dibujo | Equipo comprado |  |  | Compra | 0.035872 | C05E_TT10_D_DISCO_P.SLDPRT | OEM_mass_required
184 | TT10_D_ENCODER | 1 | Encoder de velocidad en eje motor | Equipo comprado |  |  | Compra | 0.000414 | C05E_TT10_D_ENCODER.SLDPRT | OEM_mass_required
185 | TT10_D_ENTRADA_REDUCTOR | 1 | Eje de conexión geométrica ENTRADA_REDUCTOR | Equipo comprado; materiales y masa según ficha OEM |  |  | Compra | 0.000128 | C05E_TT10_D_ENTRADA_REDUCTOR.SLDPRT | OEM_mass_required
186 | TT10_D_LIBERACION_FRENO_N | 1 | Eje de conexión geométrica LIBERACION_FRENO_N | Mecanismo OEM Svendborg; incluido en pinza |  |  | Compra | 0.000013 | C05E_TT10_D_LIBERACION_FRENO_N.SLDPRT | OEM_mass_required
187 | TT10_D_LIBERACION_FRENO_P | 1 | Eje de conexión geométrica LIBERACION_FRENO_P | Mecanismo OEM Svendborg; incluido en pinza |  |  | Compra | 0.000013 | C05E_TT10_D_LIBERACION_FRENO_P.SLDPRT | OEM_mass_required
188 | TT10_D_MANDO_PRESENTE | 1 | Palanca de hombre presente para liberación manual nominal | ASTM A36 | 0.432 | 0.432 | Fabricación | 0.000055 | C05E_TT10_D_MANDO_PRESENTE.SLDPRT | CAD_volume_x_specified_density
189 | TT10_D_MOTOR | 1 | Motor eléctrico con encoder; geometría nominal, potencia no seleccionada | Equipo comprado; materiales y masa según ficha OEM |  |  | Compra | 0.057162 | C05E_TT10_D_MOTOR.SLDPRT | OEM_mass_required
190 | TT10_D_PALANCA_PESTILLO_N | 1 | Palanca accesible de recuperación del pestillo por cable | AISI 4140 bonificado | 0.471 | 0.471 | Fabricación | 0.000060 | C05E_TT10_D_PALANCA_PESTILLO_N.SLDPRT | CAD_volume_x_specified_density
191 | TT10_D_PALANCA_PESTILLO_P | 1 | Palanca accesible de recuperación del pestillo por cable | AISI 4140 bonificado | 0.471 | 0.471 | Fabricación | 0.000060 | C05E_TT10_D_PALANCA_PESTILLO_P.SLDPRT | CAD_volume_x_specified_density
192 | TT10_D_PALANCA_SELECTOR | 1 | Selector E-0-M a altura accesible; transmisión por varilla | ASTM A36 | 1.130 | 1.130 | Fabricación | 0.000144 | C05E_TT10_D_PALANCA_SELECTOR.SLDPRT | CAD_volume_x_specified_density
193 | TT10_D_PASTILLA_N0 | 1 | Pastilla de freno; contacto nominal intencional | Material de fricción OEM Svendborg; según suministro |  |  | Compra | 0.000029 | C05E_TT10_D_PASTILLA_N0.SLDPRT | OEM_mass_required
194 | TT10_D_PASTILLA_N1 | 1 | Pastilla de freno; contacto nominal intencional | Material de fricción OEM Svendborg; según suministro |  |  | Compra | 0.000029 | C05E_TT10_D_PASTILLA_N1.SLDPRT | OEM_mass_required
195 | TT10_D_PASTILLA_P0 | 1 | Pastilla de freno; contacto nominal intencional | Material de fricción OEM Svendborg; según suministro |  |  | Compra | 0.000029 | C05E_TT10_D_PASTILLA_P0.SLDPRT | OEM_mass_required
196 | TT10_D_PASTILLA_P1 | 1 | Pastilla de freno; contacto nominal intencional | Material de fricción OEM Svendborg; según suministro |  |  | Compra | 0.000029 | C05E_TT10_D_PASTILLA_P1.SLDPRT | OEM_mass_required
197 | TT10_D_PEDESTAL_AUX | 1 | Pedestal bajo reducción auxiliar | ASTM A36 | 95.150 | 95.150 | Fabricación | 0.012121 | C05E_TT10_D_PEDESTAL_AUX.SLDPRT | CAD_volume_x_specified_density
198 | TT10_D_PEDESTAL_MOTOR | 1 | Soporte común de pies del motor | ASTM A36 | 223.796 | 223.796 | Fabricación | 0.028509 | C05E_TT10_D_PEDESTAL_MOTOR.SLDPRT | CAD_volume_x_specified_density
199 | TT10_D_PINZA_N | 1 | Pinza de freno por resorte, liberación eléctrica N; envolvente nominal | Equipo comprado |  |  | Compra | 0.008551 | C05E_TT10_D_PINZA_N.SLDPRT | OEM_mass_required
200 | TT10_D_PINZA_P | 1 | Pinza de freno por resorte, liberación eléctrica P; envolvente nominal | Equipo comprado |  |  | Compra | 0.008551 | C05E_TT10_D_PINZA_P.SLDPRT | OEM_mass_required
201 | TT10_D_PLATAFORMA | 1 | Plataforma t40 con paso abierto de cadena ancho100, extremo R50; geometría nativa vigente | ASTM A36 | 406.204 | 406.204 | Fabricación | 0.051746 | C05E_TT10_D_PLATAFORMA.SLDPRT | BRep nativo SolidWorks; densidad7850 kg/m³; 25/10/2026
202 | TT10_D_POSTE_ARMARIO | 1 | Soporte de armario | ASTM A36 | 4.944 | 4.944 | Fabricación | 0.000630 | C05E_TT10_D_POSTE_ARMARIO.SLDPRT | CAD_volume_x_specified_density
203 | TT10_D_POSTE_BOTONERA | 1 | Poste de botonera fuera del plano de giro | ASTM A36 | 8.036 | 8.036 | Fabricación | 0.001024 | C05E_TT10_D_POSTE_BOTONERA.SLDPRT | CAD_volume_x_specified_density
204 | TT10_D_POSTE_FRENO_N | 1 | Pedestal del freno N | ASTM A36 | 64.840 | 64.840 | Fabricación | 0.008260 | C05E_TT10_D_POSTE_FRENO_N.SLDPRT | CAD_volume_x_specified_density
205 | TT10_D_POSTE_FRENO_P | 1 | Pedestal del freno P | ASTM A36 | 64.840 | 64.840 | Fabricación | 0.008260 | C05E_TT10_D_POSTE_FRENO_P.SLDPRT | CAD_volume_x_specified_density
206 | TT10_D_POSTE_MANDO | 1 | Soporte del mando manual fuera del plano del volante | ASTM A36 | 5.256 | 5.256 | Fabricación | 0.000670 | C05E_TT10_D_POSTE_MANDO.SLDPRT | CAD_volume_x_specified_density
207 | TT10_D_POSTE_RECUP_N | 1 | Soporte de manivela y desbloqueo manual N | ASTM A36 | 5.986 | 5.986 | Fabricación | 0.000763 | C05E_TT10_D_POSTE_RECUP_N.SLDPRT | CAD_volume_x_specified_density
208 | TT10_D_POSTE_RECUP_P | 1 | Soporte de manivela y desbloqueo manual P | ASTM A36 | 5.986 | 5.986 | Fabricación | 0.000763 | C05E_TT10_D_POSTE_RECUP_P.SLDPRT | CAD_volume_x_specified_density
209 | TT10_D_REDUCTOR | 1 | Reductor principal angular: carcasa y conexiones nominales | Equipo comprado; materiales y masa según ficha OEM |  |  | Compra | 0.224109 | C05E_TT10_D_REDUCTOR.SLDPRT | OEM_mass_required
210 | TT10_D_RESORTE_FRENO_N | 1 | Paquete de resortes de aplicación del freno N | Acero de resorte OEM Svendborg; según suministro |  |  | Compra | 0.001460 | C05E_TT10_D_RESORTE_FRENO_N.SLDPRT | OEM_mass_required
211 | TT10_D_RESORTE_FRENO_P | 1 | Paquete de resortes de aplicación del freno P | Acero de resorte OEM Svendborg; según suministro |  |  | Compra | 0.001460 | C05E_TT10_D_RESORTE_FRENO_P.SLDPRT | OEM_mass_required
212 | TT10_D_ROD_SELECTOR | 1 | Eje de conexión geométrica ROD_SELECTOR | ASTM A36 | 2.004 | 2.004 | Fabricación | 0.000255 | C05E_TT10_D_ROD_SELECTOR.SLDPRT | CAD_volume_x_specified_density
213 | TT10_D_SALIDA_REDUCTOR | 1 | Eje de conexión geométrica SALIDA_REDUCTOR | Equipo comprado; materiales y masa según ficha OEM |  |  | Compra | 0.003142 | C05E_TT10_D_SALIDA_REDUCTOR.SLDPRT | OEM_mass_required
214 | TT10_D_SENSOR_FRENO_N | 1 | Eje de conexión geométrica SENSOR_FRENO_N | Sensor comercial; materiales según referencia OEM |  |  | Compra | 0.000005 | C05E_TT10_D_SENSOR_FRENO_N.SLDPRT | OEM_mass_required
215 | TT10_D_SENSOR_FRENO_P | 1 | Eje de conexión geométrica SENSOR_FRENO_P | Sensor comercial; materiales según referencia OEM |  |  | Compra | 0.000005 | C05E_TT10_D_SENSOR_FRENO_P.SLDPRT | OEM_mass_required
216 | TT10_D_SOPORTE_FRENO_N | 1 | Placa de montaje de pinza N | ASTM A36 | 24.838 | 24.838 | Fabricación | 0.003164 | C05E_TT10_D_SOPORTE_FRENO_N.SLDPRT | CAD_volume_x_specified_density
217 | TT10_D_SOPORTE_FRENO_P | 1 | Placa de montaje de pinza P | ASTM A36 | 24.838 | 24.838 | Fabricación | 0.003164 | C05E_TT10_D_SOPORTE_FRENO_P.SLDPRT | CAD_volume_x_specified_density
218 | TT10_F416 | 1 | Placa base 600 x 500 x 50; 8 agujeros Ø40, centros X ±220, Y ±150 y ±50 | Strenx700E t50; Rp0.2min700MPa | 113.804 | 113.804 | Fabricación | 0.014497 | C05E_TT10_F416.SLDPRT | BRep nativo SolidWorks; densidad7850 kg/m³; 25/10/2026
219 | TT10_F426 | 1 | Tope inclinado: cara inferior mecanizada para asiento horizontal | ASTM A36 | 3.490 | 3.490 | Fabricación | 0.000445 | C05E_TT10_F426.SLDPRT | CAD_volume_x_specified_density
220 | TT10_F431 | 1 | Pieza TT10_F431 | ASTM A36 | 84.780 | 84.780 | Fabricación | 0.010800 | C05E_TT10_F431.SLDPRT | CAD_volume_x_specified_density
221 | TT10_F441 | 1 | Placa80 con cuatro roscas M30 ciegas60, paso540x140; pernos desde arriba | ASTM A36 | 229.772 | 229.772 | Fabricación | 0.029270 | C05E_TT10_F441.SLDPRT | CAD_volume_x_specified_density
222 | TT10_F446 | 1 | Placa80 con cuatro roscas M30 ciegas60, paso540x140; pernos desde arriba | ASTM A36 | 229.772 | 229.772 | Fabricación | 0.029270 | C05E_TT10_F446.SLDPRT | CAD_volume_x_specified_density
224 | TT10_F456 | 1 | SKF SNL3048: dimensiones de interfaz según catálogo; fundición simplificada | Conjunto comprado; acero/ fundición según OEM | 139.000 | 139.000 | Compra | 0.030359 | C05E_TT10_F456.SLDPRT | Catálogo/fuente conservada
225 | TT10_F471 | 1 | Perfil tubular 350 x 200 x 12; L 6300 | S275J0H / EN 10219-1 | 624.320 | 624.320 | Fabricación | 0.079531 | C05E_TT10_F471.SLDPRT | CAD_volume_x_specified_density
226 | TT10_F476 | 1 | Perfil tubular 350 x 200 x 12; L 6300 | S275J0H / EN 10219-1 | 624.320 | 624.320 | Fabricación | 0.079531 | C05E_TT10_F476.SLDPRT | CAD_volume_x_specified_density
227 | TT10_F481 | 1 | Pieza TT10_F481 | ASTM A36 | 19.782 | 19.782 | Fabricación | 0.002520 | C05E_TT10_F481.SLDPRT | CAD_volume_x_specified_density
228 | TT10_F486 | 1 | Oreja fija 400 x 250 x 40; agujero Ø65 H8; Strenx 700E | Strenx700E t40; Rp0.2min700MPa | 30.358 | 30.358 | Fabricación | 0.003867 | C05E_TT10_F486.SLDPRT | BRep nativo SolidWorks; densidad7850 kg/m³; 25/10/2026
230 | TT10_F501 | 1 | Oreja fija 400 x 250 x 40; agujero Ø65 H8; Strenx 700E | Strenx700E t40; Rp0.2min700MPa | 30.358 | 30.358 | Fabricación | 0.003867 | C05E_TT10_F501.SLDPRT | BRep nativo SolidWorks; densidad7850 kg/m³; 25/10/2026
231 | TT10_F506 | 1 | Poste independiente cajón 300 x 200 x 2395, t20; 2 diafragmas 260 x 160 x 20 | Strenx700E t20; Rp0.2min700MPa | 358.996 | 358.996 | Fabricación | 0.045732 | C05E_TT10_F506.SLDPRT | BRep nativo SolidWorks; densidad7850 kg/m³; 25/10/2026
232 | TT10_F511 | 1 | Pieza TT10_F511 | ASTM A36 | 69.691 | 69.691 | Fabricación | 0.008878 | C05E_TT10_F511.SLDPRT | CAD_volume_x_specified_density
233 | TT10_F516 | 1 | Pieza TT10_F516 | ASTM A36 | 69.691 | 69.691 | Fabricación | 0.008878 | C05E_TT10_F516.SLDPRT | CAD_volume_x_specified_density
234 | TT10_F521 | 1 | Columna accionamiento apoyada sobre placa base | ASTM A36 | 201.844 | 201.844 | Fabricación | 0.025713 | C05E_TT10_F521.SLDPRT | CAD_volume_x_specified_density
235 | TT10_F526 | 1 | Perfil tubular 350 x 300 x 12; L 4800 | S275J0H / EN 10219-1 | 566.104 | 566.104 | Fabricación | 0.072115 | C05E_TT10_F526.SLDPRT | CAD_volume_x_specified_density
236 | TT10_F531 | 1 | Perfil tubular 350 x 300 x 12; L 4800 | S275J0H / EN 10219-1 | 566.104 | 566.104 | Fabricación | 0.072115 | C05E_TT10_F531.SLDPRT | CAD_volume_x_specified_density
237 | TT10_F536 | 1 | Soporte tope terminado en cara interior de columna | ASTM A36 | 13.424 | 13.424 | Fabricación | 0.001710 | C05E_TT10_F536.SLDPRT | CAD_volume_x_specified_density
238 | TT10_F541 | 1 | Diagonal CHS168.3x10 con cortes de asiento; sin penetrar columnas ni placas | S275J0H / EN 10219-1 | 92.378 | 92.378 | Fabricación | 0.011768 | C05E_TT10_F541.SLDPRT | CAD_volume_x_specified_density
239 | TT10_F546 | 1 | Puente RHS200x150x10 L1005; fuera del plano de las diagonales | S275J0H / EN 10219-1 | 52.069 | 52.069 | Fabricación | 0.006633 | C05E_TT10_F546.SLDPRT | CAD_volume_x_specified_density
240 | TT10_F551 | 1 | SKF SNL3048: dimensiones de interfaz según catálogo; fundición simplificada | Conjunto comprado; acero/ fundición según OEM | 139.000 | 139.000 | Compra | 0.030359 | C05E_TT10_F551.SLDPRT | Catálogo/fuente conservada
241 | TT10_F556 | 1 | Soporte tope terminado en cara interior de columna | ASTM A36 | 13.424 | 13.424 | Fabricación | 0.001710 | C05E_TT10_F556.SLDPRT | CAD_volume_x_specified_density
242 | TT10_F561 | 1 | Pieza TT10_F561 | ASTM A36 | 19.782 | 19.782 | Fabricación | 0.002520 | C05E_TT10_F561.SLDPRT | CAD_volume_x_specified_density
243 | TT10_F566 | 1 | Pieza TT10_F566 | ASTM A36 | 69.691 | 69.691 | Fabricación | 0.008878 | C05E_TT10_F566.SLDPRT | CAD_volume_x_specified_density
244 | TT10_F571 | 1 | Pieza TT10_F571 | ASTM A36 | 69.691 | 69.691 | Fabricación | 0.008878 | C05E_TT10_F571.SLDPRT | CAD_volume_x_specified_density
245 | TT10_F576 | 1 | Oreja fija 400 x 250 x 40; agujero Ø65 H8; Strenx 700E | Strenx700E t40; Rp0.2min700MPa | 30.358 | 30.358 | Fabricación | 0.003867 | C05E_TT10_F576.SLDPRT | BRep nativo SolidWorks; densidad7850 kg/m³; 25/10/2026
246 | TT10_F581 | 1 | Diagonal CHS168.3x10 con cortes de asiento; sin penetrar columnas ni placas | S275J0H / EN 10219-1 | 92.378 | 92.378 | Fabricación | 0.011768 | C05E_TT10_F581.SLDPRT | CAD_volume_x_specified_density
247 | TT10_F586 | 1 | Oreja fija 400 x 250 x 40; agujero Ø65 H8; Strenx 700E | Strenx700E t40; Rp0.2min700MPa | 30.358 | 30.358 | Fabricación | 0.003867 | C05E_TT10_F586.SLDPRT | BRep nativo SolidWorks; densidad7850 kg/m³; 25/10/2026
248 | TT10_F591 | 1 | Placa base 600 x 500 x 50; 8 agujeros Ø40, centros X ±220, Y ±150 y ±50 | Strenx700E t50; Rp0.2min700MPa | 113.804 | 113.804 | Fabricación | 0.014497 | C05E_TT10_F591.SLDPRT | BRep nativo SolidWorks; densidad7850 kg/m³; 25/10/2026
249 | TT10_F596 | 1 | Tope inclinado: cara inferior mecanizada para asiento horizontal | ASTM A36 | 3.490 | 3.490 | Fabricación | 0.000445 | C05E_TT10_F596.SLDPRT | CAD_volume_x_specified_density
250 | TT10_F601 | 1 | Diagonal CHS168.3x10 con cortes de asiento; sin penetrar columnas ni placas | S275J0H / EN 10219-1 | 92.378 | 92.378 | Fabricación | 0.011768 | C05E_TT10_F601.SLDPRT | CAD_volume_x_specified_density
251 | TT10_F606 | 1 | Diagonal CHS168.3x10 con cortes de asiento; sin penetrar columnas ni placas | S275J0H / EN 10219-1 | 92.378 | 92.378 | Fabricación | 0.011768 | C05E_TT10_F606.SLDPRT | CAD_volume_x_specified_density
252 | TT10_F611 | 1 | Poste independiente cajón 300 x 200 x 2395, t20; 2 diafragmas 260 x 160 x 20 | Strenx700E t20; Rp0.2min700MPa | 358.996 | 358.996 | Fabricación | 0.045732 | C05E_TT10_F611.SLDPRT | BRep nativo SolidWorks; densidad7850 kg/m³; 25/10/2026
254 | TT10_F621 | 1 | Puente RHS200x150x10 L1005; fuera del plano de las diagonales | S275J0H / EN 10219-1 | 52.069 | 52.069 | Fabricación | 0.006633 | C05E_TT10_F621.SLDPRT | CAD_volume_x_specified_density
255 | TT10_F626 | 1 | Pieza TT10_F626 | ASTM A36 | 69.691 | 69.691 | Fabricación | 0.008878 | C05E_TT10_F626.SLDPRT | CAD_volume_x_specified_density
256 | TT10_F631 | 1 | Pieza TT10_F631 | ASTM A36 | 69.691 | 69.691 | Fabricación | 0.008878 | C05E_TT10_F631.SLDPRT | CAD_volume_x_specified_density
257 | TT10_F636 | 1 | Columna principal recortada para placa80 y altura de centro SKF220 | Conjunto comprado; acero/ fundición según OEM |  |  | Compra | 0.035698 | C05E_TT10_F636.SLDPRT | OEM_mass_required
258 | TT10_F641 | 1 | Columna principal recortada para placa80 y altura de centro SKF220 | Conjunto comprado; acero/ fundición según OEM |  |  | Compra | 0.035698 | C05E_TT10_F641.SLDPRT | OEM_mass_required
260 | TT10_FRB_1 | 1 | SKF FRB21/360; lado P localizador | Conjunto comprado; acero/ fundición según OEM |  |  | Compra | 0.000653 | C05E_TT10_FRB_1.SLDPRT | OEM_mass_required
261 | TT10_FRB_2 | 1 | SKF FRB21/360; lado P localizador | Conjunto comprado; acero/ fundición según OEM |  |  | Compra | 0.000653 | C05E_TT10_FRB_2.SLDPRT | OEM_mass_required
262 | TT10_GUIA_N | 1 | Guía con alojamiento Ø69 H7; casquillo69/65.5; fuera del camino resistente | ASTM A36 | 13.567 | 13.567 | Fabricación | 0.001728 | C05E_TT10_GUIA_N.SLDPRT | CAD_volume_x_specified_density
263 | TT10_GUIA_P | 1 | Guía con alojamiento Ø69 H7; casquillo69/65.5; fuera del camino resistente | ASTM A36 | 13.567 | 13.567 | Fabricación | 0.001728 | C05E_TT10_GUIA_P.SLDPRT | CAD_volume_x_specified_density
264 | TT10_KM40_N | 1 | SKF KM40, M200x3, D250 B29; cuatro ranuras18x8 | Conjunto comprado; acero/ fundición según OEM | 3.350 | 3.350 | Compra | 0.000496 | C05E_TT10_KM40_N.SLDPRT | Catálogo/fuente conservada
265 | TT10_KM40_P | 1 | SKF KM40, M200x3, D250 B29; cuatro ranuras18x8 | Conjunto comprado; acero/ fundición según OEM | 3.350 | 3.350 | Compra | 0.000496 | C05E_TT10_KM40_P.SLDPRT | Catálogo/fuente conservada
266 | TT10_LIN_0_0_B | 32 | Tornillo avellanado M16x80, cabeza90 D31, hexágono10; geometría nominal | Clase 10.9 / ISO 898-1 | 0.137 | 4.391 | Compra | 0.000017 | C05E_TT10_LIN_0_0_B.SLDPRT | CAD_volume_x_specified_density
267 | TT10_LIN_0_0_C | 32 | Casquillo30/18 L25 limita compresión de elastómero | Acero C45 | 0.089 | 2.841 | Fabricación | 0.000011 | C05E_TT10_LIN_0_0_C.SLDPRT | CAD_volume_x_specified_density
268 | TT10_LIN_0_0_N | 32 | Tuerca autoblocante metálica M16; rosca simplificada | Tuerca clase 8 / ISO 898-2 | 0.033 | 1.047 | Compra | 0.000004 | C05E_TT10_LIN_0_0_N.SLDPRT | CAD_volume_x_specified_density
269 | TT10_LIN_0_0_W | 32 | Arandela M16 200HV D30/d17/t3 | Arandela endurecida 200 HV / ISO 7089 | 0.011 | 0.362 | Compra | 0.000001 | C05E_TT10_LIN_0_0_W.SLDPRT | CAD_volume_x_specified_density
270 | TT10_LK_BC0 | 2 | TornilloM6x258.8; cabeza nominal, fijador de rosca y apriete por montaje | Clase 8.8 / ISO 898-1 | 0.009 | 0.018 | Compra | 0.000001 | C05E_TT10_LK_BC0.SLDPRT | CAD_volume_x_specified_density
271 | TT10_LK_BC1 | 2 | TornilloM6x258.8; cabeza nominal, fijador de rosca y apriete por montaje | Clase 8.8 / ISO 898-1 | 0.009 | 0.018 | Compra | 0.000001 | C05E_TT10_LK_BC1.SLDPRT | CAD_volume_x_specified_density
272 | TT10_LK_BC2 | 2 | TornilloM6x258.8; cabeza nominal, fijador de rosca y apriete por montaje | Clase 8.8 / ISO 898-1 | 0.009 | 0.018 | Compra | 0.000001 | C05E_TT10_LK_BC2.SLDPRT | CAD_volume_x_specified_density
273 | TT10_LK_BC3 | 2 | TornilloM6x258.8; cabeza nominal, fijador de rosca y apriete por montaje | Clase 8.8 / ISO 898-1 | 0.009 | 0.018 | Compra | 0.000001 | C05E_TT10_LK_BC3.SLDPRT | CAD_volume_x_specified_density
274 | TT10_LK_BL0 | 2 | TornilloM6x908.8; cabeza nominal, fijador de rosca y apriete por montaje | Clase 8.8 / ISO 898-1 | 0.024 | 0.047 | Compra | 0.000003 | C05E_TT10_LK_BL0.SLDPRT | CAD_volume_x_specified_density
275 | TT10_LK_BS0 | 2 | TornilloM10x258.8; cabeza nominal, fijador de rosca y apriete por montaje | Clase 8.8 / ISO 898-1 | 0.031 | 0.062 | Compra | 0.000004 | C05E_TT10_LK_BS0.SLDPRT | CAD_volume_x_specified_density
276 | TT10_LK_BS1 | 2 | TornilloM10x258.8; cabeza nominal, fijador de rosca y apriete por montaje | Clase 8.8 / ISO 898-1 | 0.031 | 0.062 | Compra | 0.000004 | C05E_TT10_LK_BS1.SLDPRT | CAD_volume_x_specified_density
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
