acevedocrisologopablo48-lgtm/sesuveca-tolva-p04/dist/documentos/PLANTA_SELECCION_CARBON_R01.step

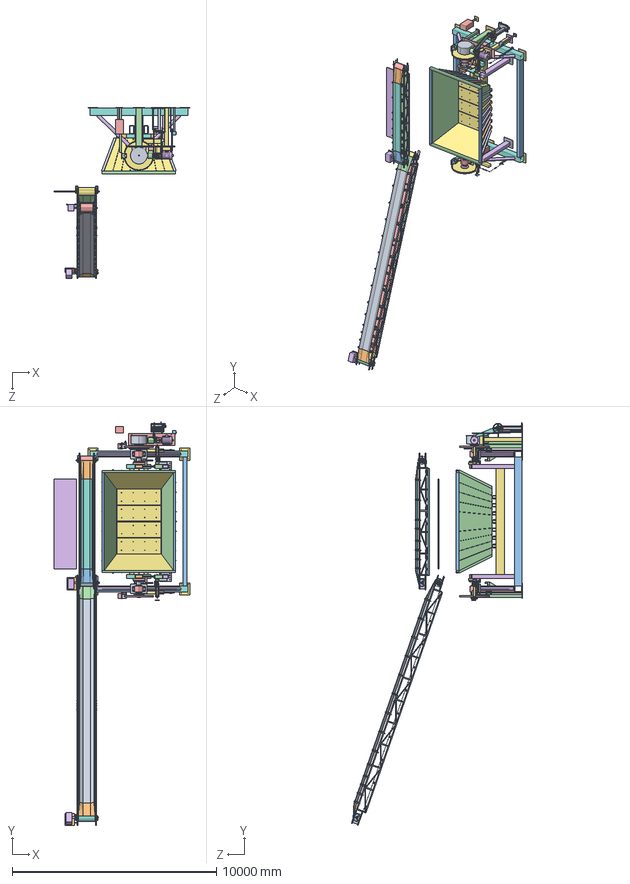
[picture p56: CAD file, 2026-10-28]
dist/documentos/PLANTA_SELECCION_CARBON_R01.step
6655.7 x 19744.0 x 8370.1 mm
C05E_TT10_F416
C05E_TT10_F431
C05E_TT10_F471
C05E_TT10_F476
C05E_TT10_F481
C05E_TT10_F486
C05E_TT10_F501
C05E_TT10_F506
C05E_TT10_F511
C05E_TT10_F516
C05E_TT10_F526
C05E_TT10_F531
C05E_TT10_F561
C05E_TT10_F566
C05E_TT10_F571
C05E_TT10_F576
C05E_TT10_F586
C05E_TT10_F591
C05E_TT10_F611
C05E_TT10_F626
C05E_TT10_F631
C05E_TT10_PUENTE_P
C05E_TT10_TIR_P1
C05E_TT10_N20_P1I x 16
C05E_TT10_W20_P1I x 16
C05E_TT10_TIR_P2
C05E_TT10_TIR_P3
C05E_TT10_TIR_P4
C05E_TT10_PUENTE_N
C05E_TT10_TIR_N1
C05E_TT10_TIR_N2
C05E_TT10_TIR_N3
C05E_TT10_TIR_N4
C05E_TT10_F636
C05E_TT10_F641
C05E_TT10_F541
C05E_TT10_F601
C05E_TT10_F581
C05E_TT10_F606
C05E_TT10_F546
C05E_TT10_NODO_P
C05E_TT10_CART_P_INF
C05E_TT10_CART_P_SUP
C05E_TT10_F536
C05E_TT10_F426
C05E_TT10_F621
C05E_TT10_NODO_N
C05E_TT10_CART_N_INF
C05E_TT10_CART_N_SUP
C05E_TT10_F556
C05E_TT10_F596
C05E_TT10_F521
C05E_TT10_F551
C05E_TT10_22240_P
C05E_TT10_FRB_1
C05E_TT10_FRB_2
C05E_TT10_TNF_P1
C05E_TT10_TNF_P2
C05E_TT10_F441
C05E_TT10_BAP_P0 x 32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
