acevedocrisologopablo48-lgtm/sesuveca-tolva-p04/dist/documentos/TT10_MANUAL_VISUAL_FABRICACION_Y_ARMADO.pdf

SESUVECA / JAVIER ACEVEDO

TOLVA TROMPO TT10

# Manual visual de fabricación y armado

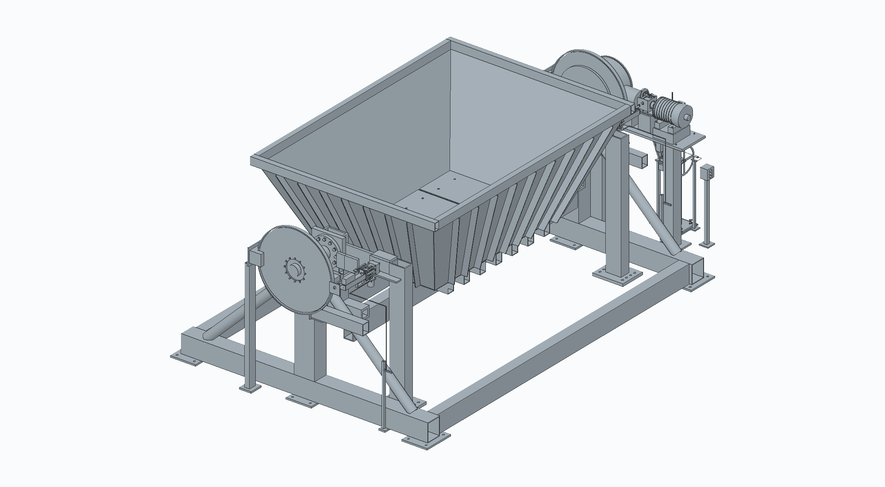
[picture p58: figure]

TT10 | C05 / modelo C06 | 25/10/2026 | Guía visual de fabricación y armado | 01

## 26 pasos · piezas reales · códigos y cantidades de montaje

### GUÍA DE ARMADO PARA REVISIÓN

Modelo C05 / geometría C06 · 492 códigos · 996 instancias. Mantener las cotas, ajustes y soldaduras de los planos asociados. Estado del conjunto: NO LIBERADO PARA FABRICACIÓN.

LECTURA DEL MANUAL

# Cómo seguir los pasos

TT10 | C05 / modelo C06 | 25/10/2026 | Guía visual de fabricación y armado | 02

## 1 Preparar el kit

### Reunir los códigos y cantidades del paso. Los números de llamada se repiten en las

tarjetas inferiores.

## 2 Presentar las piezas

### La vista muestra la geometría real del CAD. Las piezas nuevas aparecen en azul; el

gris sirve de referencia.

## 3 Fijar y comprobar

### Puntear, soldar o atornillar según el plano citado. Comprobar antes de continuar; no

medir sobre la ilustración.

## 4 Cerrar el subconjunto

### Las flechas y separaciones muestran una intención de armado; las distancias de

despiece no son cotas de montaje.

## ORIENTACIÓN Y REFERENCIAS

### P y N conservan la designación de los códigos del modelo. El lado del accionamiento y el lado opuesto deben comprobarse en PC01 antes de

presentar las piezas.

### Las cotas se leen en los planos A4; los perfiles de corte se toman del DXF 1:1. El anexo de este manual distribuye las 996 instancias por paso sin

sumarlas dos veces.

No se inventan aquí pares de apriete, tamaños de cordón ni puntos de izaje.

### Aplicar los definidos en el plano o en las instrucciones del componente identificado. Mantener la cuba soportada y la energía aislada durante el

montaje.

Planos: 02_PLANOS_2D / TT10_PLANOS_CONJUNTOS.pdf Lista: 06_MATERIALES / TT10_BOM_COMPRAS.xlsx

La guía ordena el trabajo sobre el diseño vigente; no modifica el estado técnico del conjunto ni documenta ensayos de carga.

# Ruta de fabricación y montaje

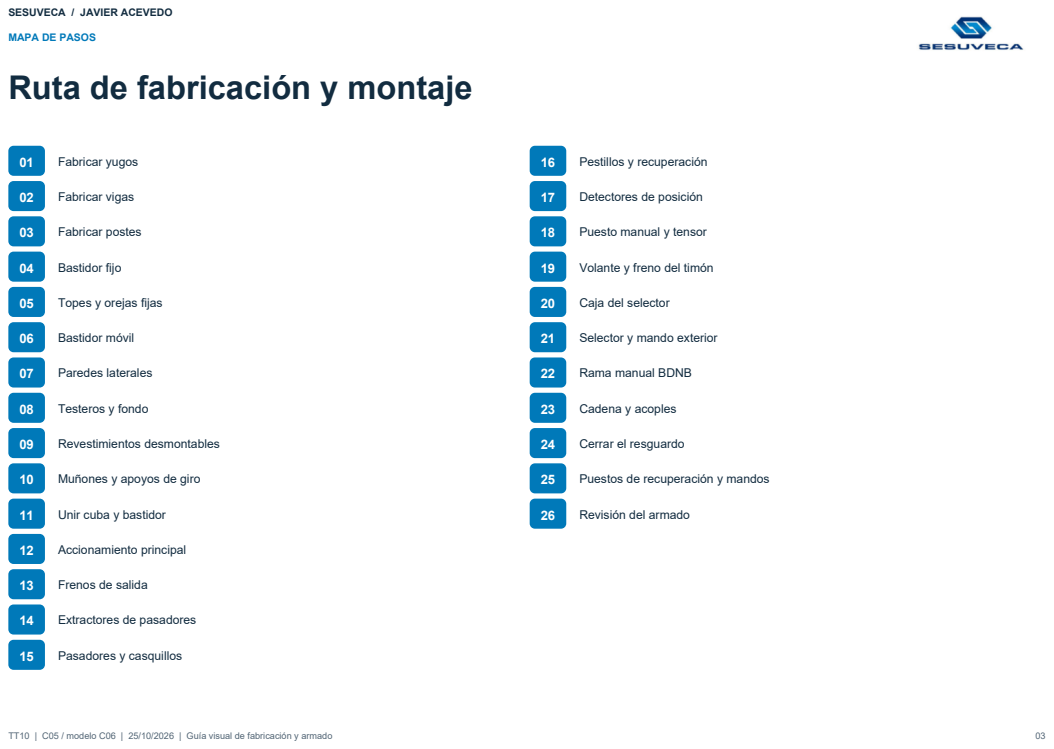
[picture p59: page 3]
TT10 | C05 / modelo C06 | 25/10/2026 | Guía visual de fabricación y armado; 01 Fabricar yugos; 02 Fabricar vigas; 03 Fabricar postes; 04 Bastidor fijo; 06 Bastidor móvil; 07 Paredes laterales; 08 Testeros y fondo; 09 Revestimientos desmontables; 12 Accionamiento principal; 15 Pasadores y casquillos; 16 Pestillos y recuperación; 23 Cadena y acoples

MAPA DE PASOS

17 Detectores de posición

18 Puesto manual y tensor

19 Volante y freno del timón

05 Topes y orejas fijas

20 Caja del selector

21 Selector y mando exterior

22 Rama manual BDNB

24 Cerrar el resguardo

10 Muñones y apoyos de giro

25 Puestos de recuperación y mandos

11 Unir cuba y bastidor

26 Revisión del armado

13 Frenos de salida

14 Extractores de pasadores

FABRICACIÓN / CHAPAS CORTADAS Y CAJÓN ARMADO

# 01 Fabricar los dos yugos

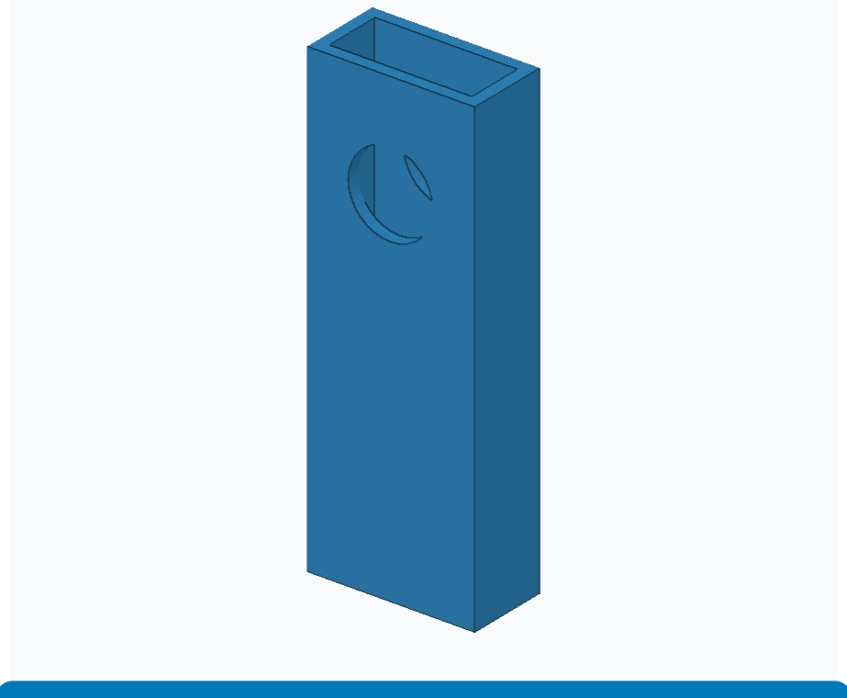
[picture p60: figure]
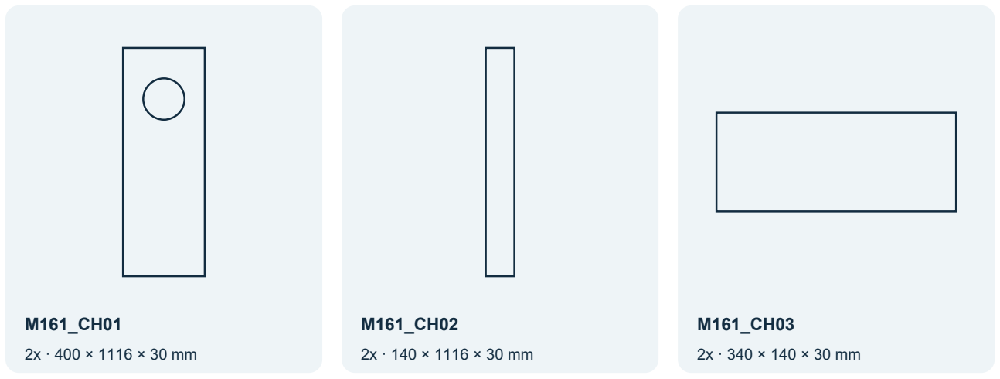
[picture p61: figure]

TT10 | C05 / modelo C06 | 25/10/2026 | Guía visual de fabricación y armado | 04

Preparar las tres parejas de chapas; después armar cada cajón por separado.

RESULTADO M161 / M311 SECUENCIA

1 Marcar los códigos CH01, CH02 y CH03. Cortar a escala 1:1 desde el DXF; retirar rebabas.

2 Presentar las dos caras y las dos almas. Insertar los dos diafragmas en las posiciones del detalle y puntear.

3 Verificar escuadra, dimensiones y paso libre. Completar los cordones según el plano; mecanizar después las superficies indicadas.

CÓDIGOS Y CANTIDADES

TT10_M161: 2x CH01 + 2x CH02 + 2x CH03. TT10_M311: 2x CH01 + 2x CH02 + 2x CH03.

Los seis padres ya están incluidos en la BOM del CAD. Estas 36 chapas son su despiece; no sumarlas como piezas adicionales.

Planos: M161 / M311 · Detalle TT10_C05_DET_ + código completo.

FABRICACIÓN / CHAPAS CORTADAS Y CAJÓN ARMADO

# 02 Fabricar las dos vigas

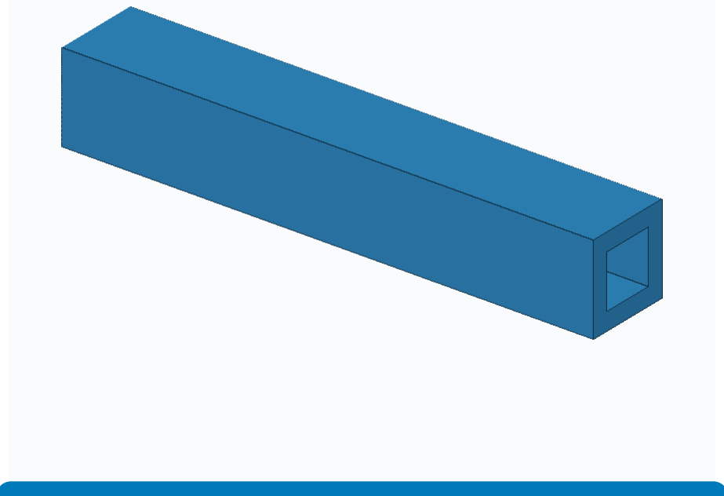
[picture p62: figure]
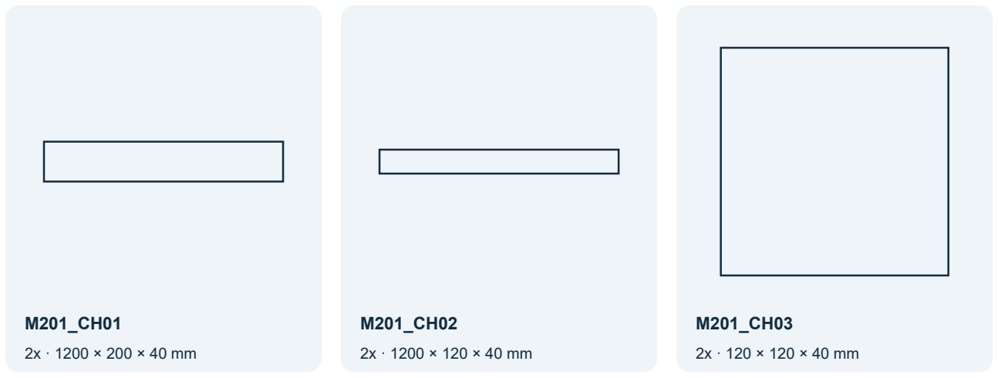
[picture p63: figure]

TT10 | C05 / modelo C06 | 25/10/2026 | Guía visual de fabricación y armado | 05

Preparar las tres parejas de chapas; después armar cada cajón por separado.

RESULTADO M201 / M131 SECUENCIA

1 Marcar los códigos CH01, CH02 y CH03. Cortar a escala 1:1 desde el DXF; retirar rebabas.

2 Presentar las dos caras y las dos almas. Insertar los dos diafragmas en las posiciones del detalle y puntear.

3 Verificar escuadra, dimensiones y paso libre. Completar los cordones según el plano; mecanizar después las superficies indicadas.

CÓDIGOS Y CANTIDADES

TT10_M201: 2x CH01 + 2x CH02 + 2x CH03. TT10_M131: 2x CH01 + 2x CH02 + 2x CH03.

Los seis padres ya están incluidos en la BOM del CAD. Estas 36 chapas son su despiece; no sumarlas como piezas adicionales.

Planos: M201 / M131 · Detalle TT10_C05_DET_ + código completo.

FABRICACIÓN / CHAPAS CORTADAS Y CAJÓN ARMADO

# 03 Fabricar los dos postes

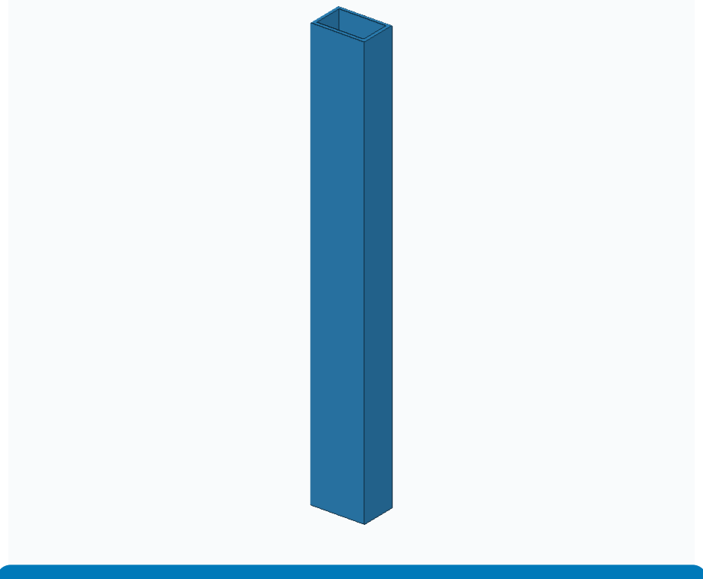
[picture p64: figure]
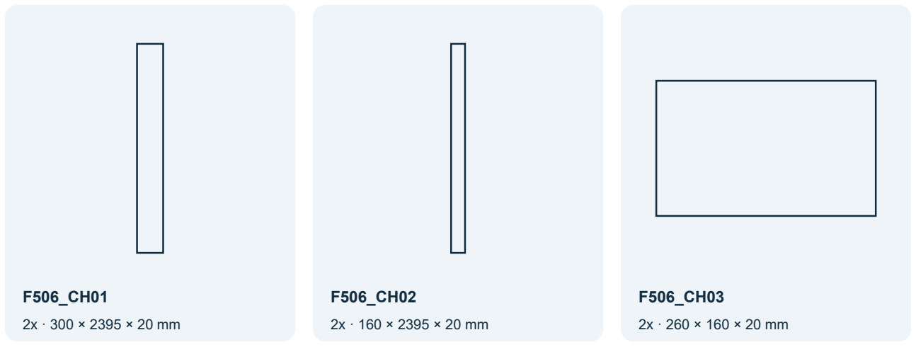
[picture p65: figure]

TT10 | C05 / modelo C06 | 25/10/2026 | Guía visual de fabricación y armado | 06

Preparar las tres parejas de chapas; después armar cada cajón por separado.

RESULTADO F506 / F611 SECUENCIA

1 Marcar los códigos CH01, CH02 y CH03. Cortar a escala 1:1 desde el DXF; retirar rebabas.

2 Presentar las dos caras y las dos almas. Insertar los dos diafragmas en las posiciones del detalle y puntear.

3 Verificar escuadra, dimensiones y paso libre. Completar los cordones según el plano; mecanizar después las superficies indicadas.

CÓDIGOS Y CANTIDADES

TT10_F506: 2x CH01 + 2x CH02 + 2x CH03. TT10_F611: 2x CH01 + 2x CH02 + 2x CH03.

Los seis padres ya están incluidos en la BOM del CAD. Estas 36 chapas son su despiece; no sumarlas como piezas adicionales.

Planos: F506 / F611 · Detalle TT10_C05_DET_ + código completo.

MONTAJE / PIEZAS REALES DEL CONJUNTO

# 04 Bastidor fijo

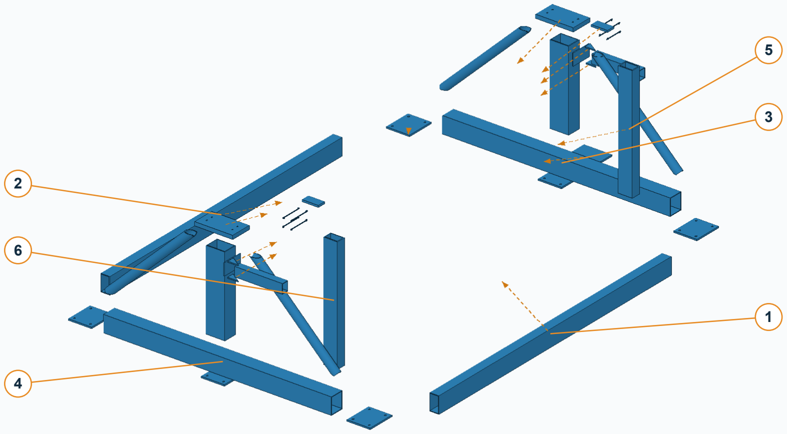
[picture p66: figure]
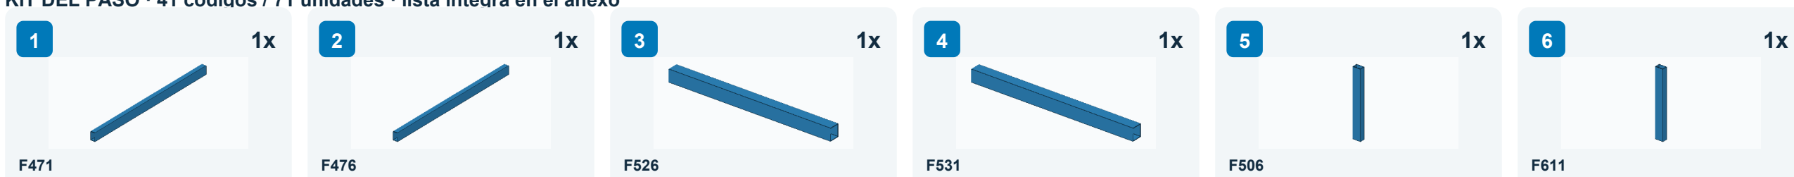
[picture p67: figure]

TT10 | C05 / modelo C06 | 25/10/2026 | Guía visual de fabricación y armado | 07

Azul: piezas de este paso · Gris: referencia ya armada

Separación visual sin escala. Colocar en la posición indicada en el plano.

### COLOCAR Y UNIR

### 1 Disponer largueros, travesaños y columnas sobre una

superficie nivelada.

2 Puntear los nudos con sus placas y cartelas; comprobar diagonales y cotas del conjunto.

### 3 Completar la soldadura siguiendo los planos y volver a

medir los asientos de apoyo.

COMPROBAR

No soldar alojamientos comerciales ni superficies mecanizadas de rodamiento. Conservar acceso a tornillos y a las caras de montaje de los apoyos.

Plano: TT10_C05_PC_02

KIT DEL PASO · 41 códigos / 71 unidades · lista íntegra en el anexo

MONTAJE / PIEZAS REALES DEL CONJUNTO

# 05 Topes y orejas fijas

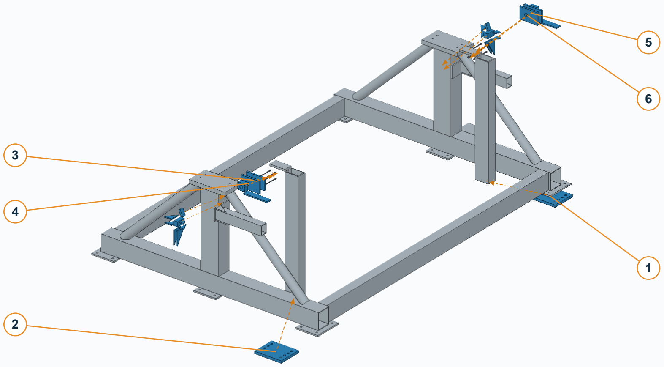
[picture p68: figure]
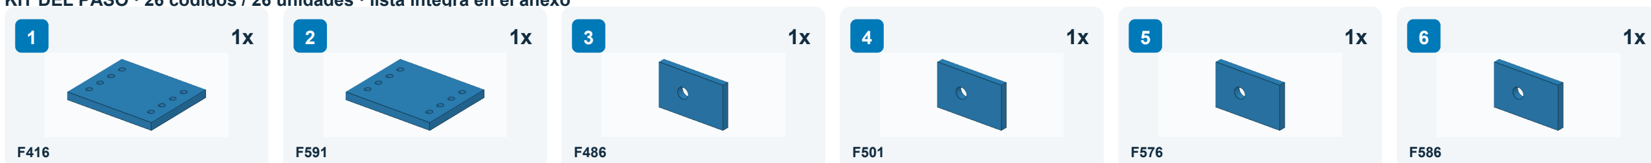
[picture p69: figure]

TT10 | C05 / modelo C06 | 25/10/2026 | Guía visual de fabricación y armado | 08

Azul: piezas de este paso · Gris: referencia ya armada

Separación visual sin escala. Colocar en la posición indicada en el plano.

### COLOCAR Y UNIR

### 1 Presentar placas base, soportes de tope, orejas y

guías sobre el bastidor.

### 2 Usar un mandril de alineación para los alojamientos del

bloqueo y puntear las orejas.

### 3 Completar las uniones conforme al detalle y retirar el

mandril.

COMPROBAR

Orejas fijas: espesor 40 mm y agujero Ø65 H8. Las caras de los topes y la orientación P/N deben coincidir con el conjunto.

Plano: TT10_C05_PC_03

KIT DEL PASO · 26 códigos / 26 unidades · lista íntegra en el anexo

MONTAJE / PIEZAS REALES DEL CONJUNTO

# 06 Bastidor móvil

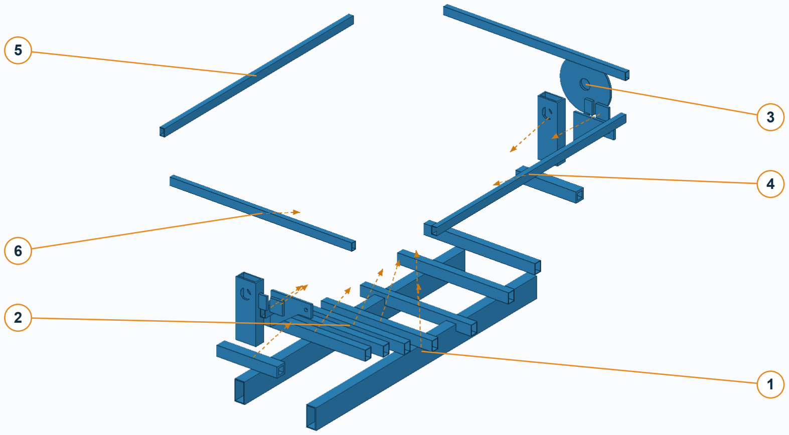
[picture p70: figure]
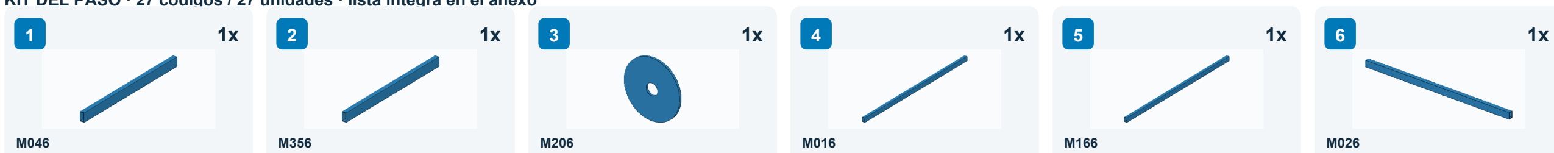
[picture p71: figure]

TT10 | C05 / modelo C06 | 25/10/2026 | Guía visual de fabricación y armado | 09

Azul: piezas de este paso · Gris: referencia ya armada

Separación visual sin escala. Colocar en la posición indicada en el plano.

### COLOCAR Y UNIR

### 1 Presentar los perfiles, cabezales y yugos ya fabricados

sobre plantilla.

### 2 Incorporar los brazos monolíticos y sus cartelas según

su orientación P/N.

3 Puntear, medir y soldar según los planos de los nudos.

COMPROBAR

Brazos TT10_M276 y TT10_M351: espesor 50 mm; no sustituir por dos chapas superpuestas. Mantener coaxiales las interfaces de giro antes y después de soldar.

Plano: TT10_C05_PC_05

KIT DEL PASO · 27 códigos / 27 unidades · lista íntegra en el anexo

MONTAJE / PIEZAS REALES DEL CONJUNTO

# 07 Paredes laterales

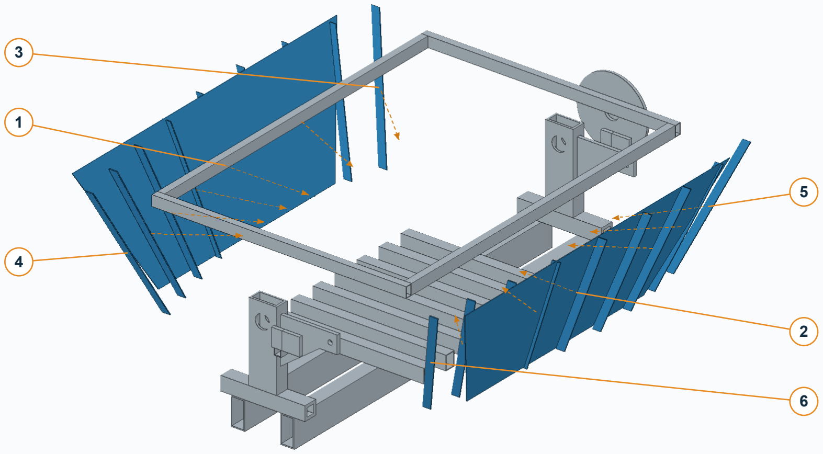
[picture p72: figure]
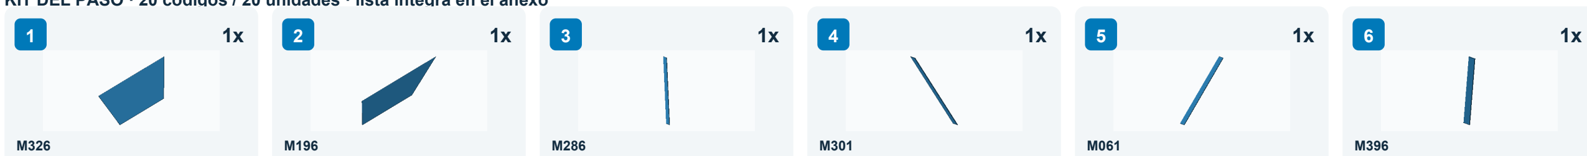
[picture p73: figure]

TT10 | C05 / modelo C06 | 25/10/2026 | Guía visual de fabricación y armado | 10

Azul: piezas de este paso · Gris: referencia ya armada

Separación visual sin escala. Colocar en la posición indicada en el plano.

### COLOCAR Y UNIR

### 1 Presentar paneles laterales y refuerzos en su posición

del modelo.

### 2 Puntear en secuencia alternada desde el centro hacia

los extremos.

### 3 Cerrar las uniones señaladas en el plano del

subconjunto.

COMPROBAR

Comprobar la correspondencia de lado y la posición de cada nervio. No usar el render para obtener espesores ni medidas de corte.

Plano: TT10_C05_PC_06

KIT DEL PASO · 20 códigos / 20 unidades · lista íntegra en el anexo

MONTAJE / PIEZAS REALES DEL CONJUNTO

# 08 Testeros y fondo

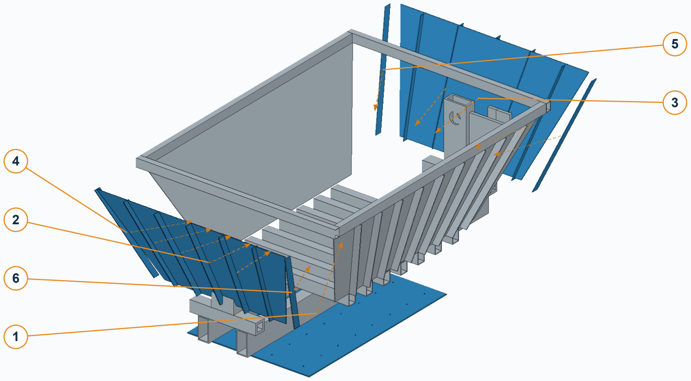
[picture p74: figure]
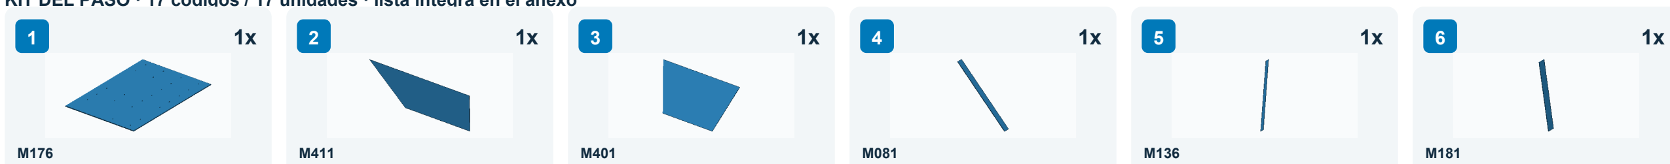
[picture p75: figure]

TT10 | C05 / modelo C06 | 25/10/2026 | Guía visual de fabricación y armado | 11

Azul: piezas de este paso · Gris: referencia ya armada

Separación visual sin escala. Colocar en la posición indicada en el plano.

### COLOCAR Y UNIR

1 Añadir testeros, fondo y sus refuerzos al bastidor móvil.

### 2 Puntear todo el perímetro antes de completar los

cordones del conjunto.

### 3 Limpiar los taladros de montaje y comprobar las

interfaces interiores.

COMPROBAR

Fondo TT10_M176: espesor 16 mm según la geometría actual. Cotejar la boca y la posición de taladros con el plano; evitar deformación por soldadura.

Plano: TT10_C05_PC_07

KIT DEL PASO · 17 códigos / 17 unidades · lista íntegra en el anexo

# 09 Revestimientos desmontables

### COLOCAR Y UNIR

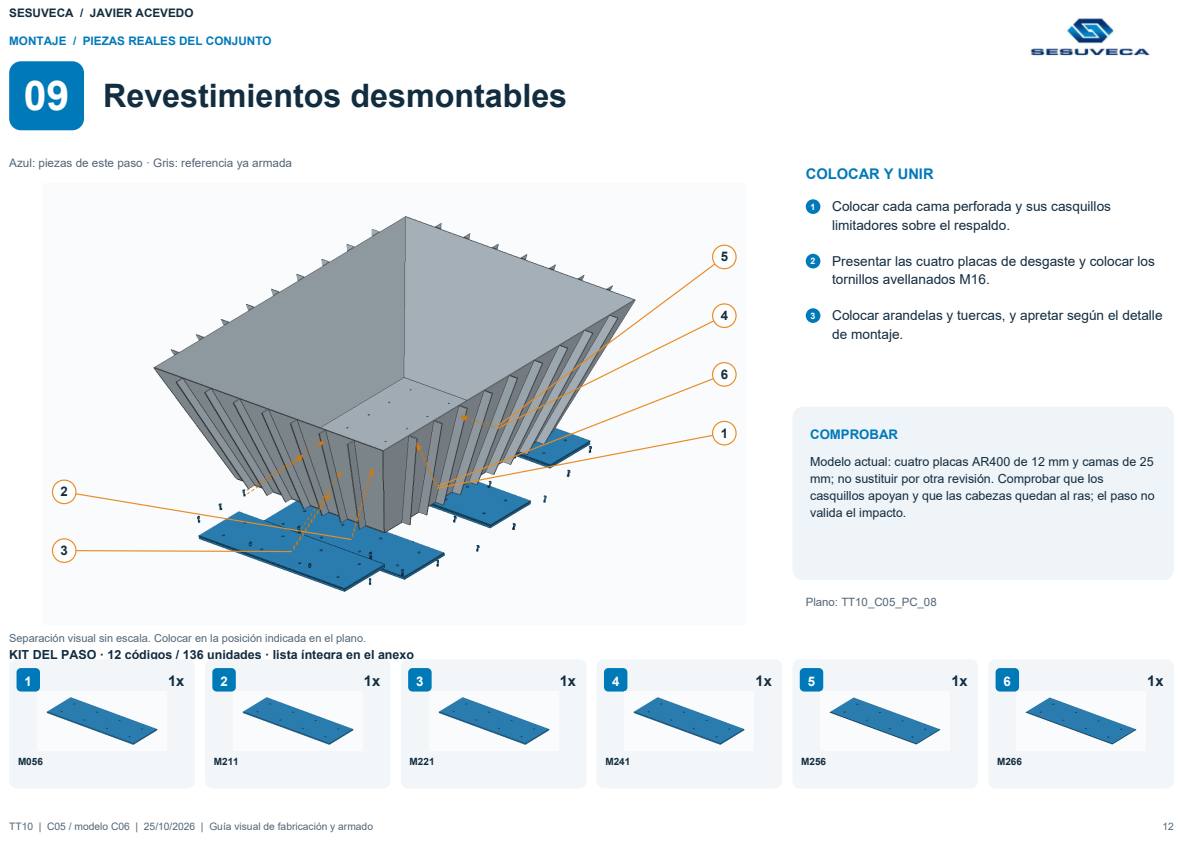
[picture p76: page 12]
TT10 | C05 / modelo C06 | 25/10/2026 | Guía visual de fabricación y armado; COMPROBAR; Plano: TT10_C05_PC_08

MONTAJE / PIEZAS REALES DEL CONJUNTO

Azul: piezas de este paso · Gris: referencia ya armada

1 Colocar cada cama perforada y sus casquillos
limitadores sobre el respaldo.

2 Presentar las cuatro placas de desgaste y colocar los
tornillos avellanados M16.

3 Colocar arandelas y tuercas, y apretar según el detalle
de montaje.

Modelo actual: cuatro placas AR400 de 12 mm y camas de 25
mm; no sustituir por otra revisión. Comprobar que los
casquillos apoyan y que las cabezas quedan al ras; el paso no
valida el impacto.

Separación visual sin escala. Colocar en la posición indicada en el plano.
KIT DEL PASO · 12 códigos / 136 unidades · lista íntegra en el anexo

MONTAJE / PIEZAS REALES DEL CONJUNTO

# 10 Muñones y apoyos de giro

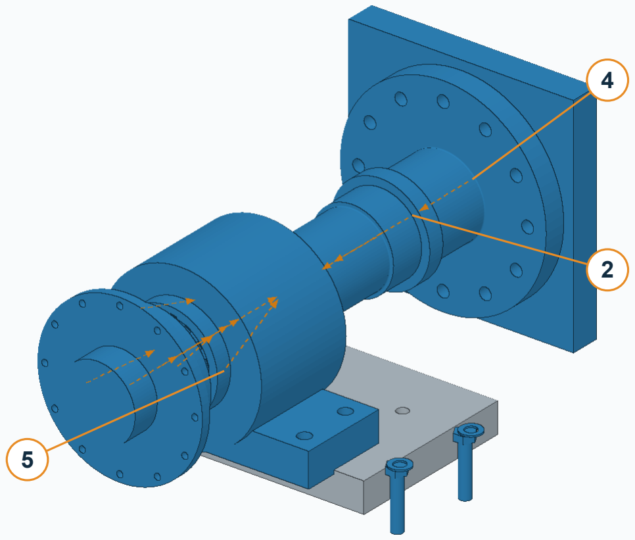
[picture p77: figure]
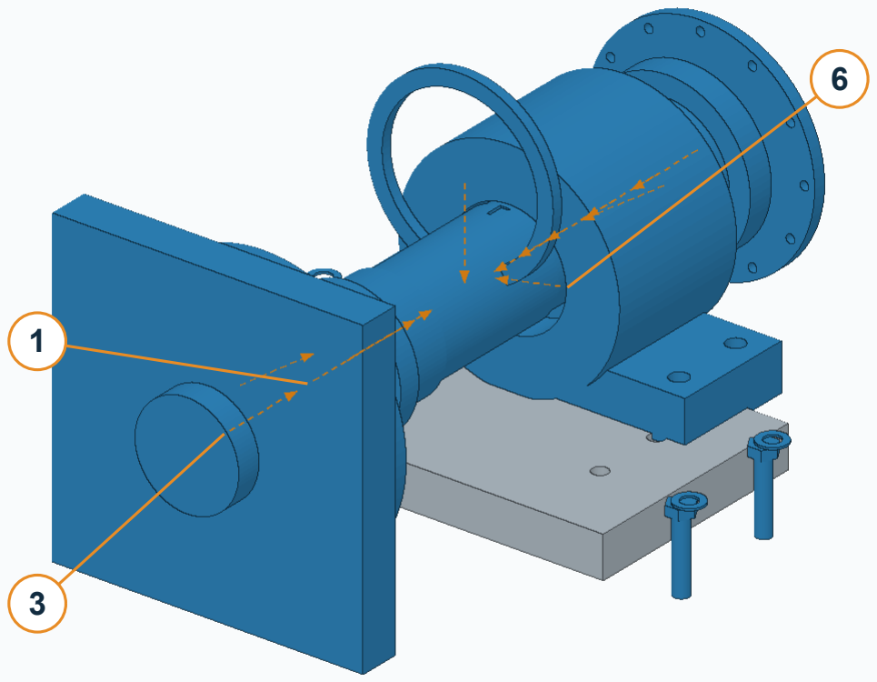
[picture p78: figure]
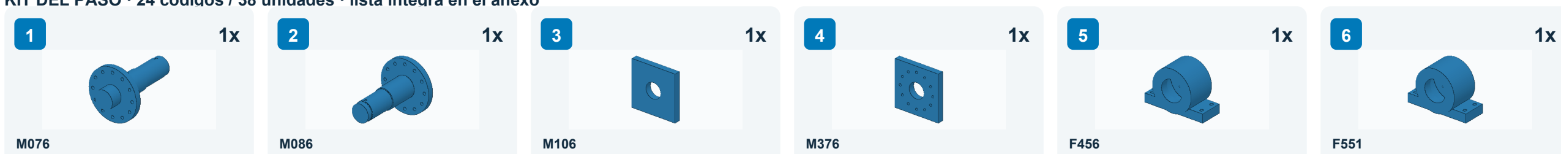
[picture p79: figure]

TT10 | C05 / modelo C06 | 25/10/2026 | Guía visual de fabricación y armado | 13

Azul: piezas de este paso · Gris: referencia ya armada

Dos lados separados para ver las piezas. Mantener los códigos P/N.

Separación visual sin escala. Colocar en la posición indicada en el plano.

### COLOCAR Y UNIR

### 1 Limpiar asientos y presentar muñones, bridas, cubos y

elementos de retención.

### 2 Montar rodamientos, separadores, sellos y retenedores

en el orden de la sección del apoyo.

### 3 Preparar las tapas y mantener protegido el interior

hasta unir la cuba al bastidor.

COMPROBAR

Rodamientos del modelo vigente: SKF 22240 CC/W33, 200 × 360 × 98 mm. Aplicar los ajustes y la secuencia del plano de mecanizados; no trasladar cargas de montaje a través de los rodillos.

Plano: TT10_C05_PC_09

KIT DEL PASO · 24 códigos / 38 unidades · lista íntegra en el anexo

MONTAJE / PIEZAS REALES DEL CONJUNTO

# 11 Unir cuba y bastidor

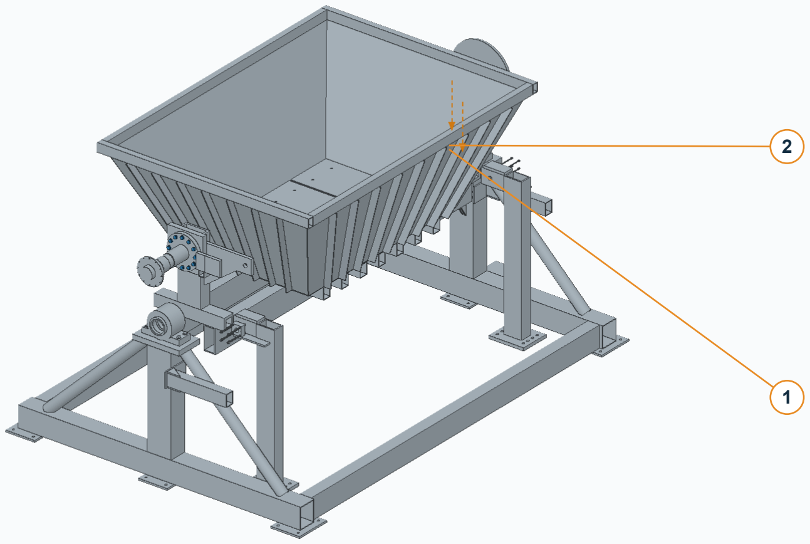
[picture p80: figure]
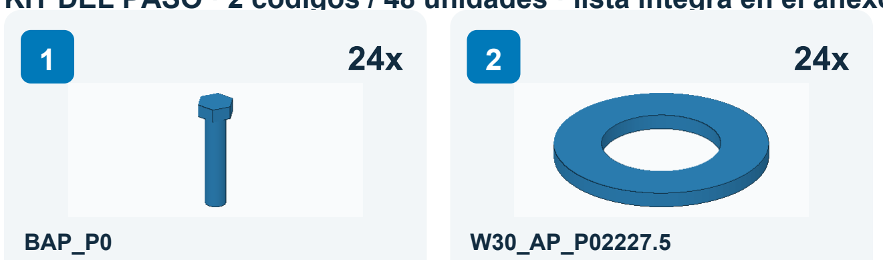
[picture p81: figure]
BAP_P0

TT10 | C05 / modelo C06 | 25/10/2026 | Guía visual de fabricación y armado | 14

Azul: piezas de este paso · Gris: referencia ya armada

Cuba ya preparada: desplazamiento gráfico para mostrar la unión al bastidor.

### COLOCAR Y UNIR

### 1 Mantener la cuba vacía inmovilizada y sostenida con

medios de izaje adecuados.

### 2 Alinear el eje con los apoyos del bastidor y cerrar las

tapas sin forzar el montaje.

### 3 Montar la tornillería de las bridas y las retenciones

axiales indicadas.

COMPROBAR

No usar el motor ni los actuadores para corregir una falta de alineación. Comprobar que las fijaciones y las retenciones pertenecen a la revisión actual.

Plano: TT10_C05_PC_01 / TT10_C05_PC_04

KIT DEL PASO · 2 códigos / 48 unidades · lista íntegra en el anexo

MONTAJE / PIEZAS REALES DEL CONJUNTO

# 12 Accionamiento principal

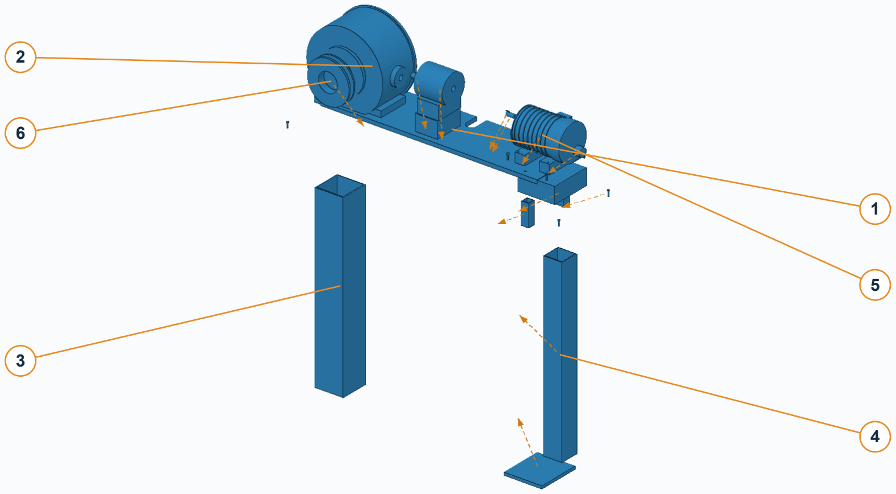
[picture p82: figure]
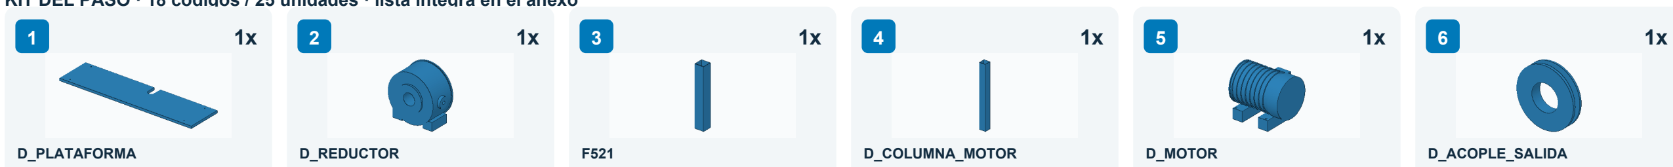
[picture p83: figure]
D_PLATAFORMA; D_REDUCTOR; D_COLUMNA_MOTOR; D_MOTOR; D_ACOPLE_SALIDA

TT10 | C05 / modelo C06 | 25/10/2026 | Guía visual de fabricación y armado | 15

Azul: piezas de este paso · Gris: referencia ya armada

Separación visual sin escala. Colocar en la posición indicada en el plano.

### COLOCAR Y UNIR

### 1 Montar bancada, pedestales y plataforma con su paso

de cadena.

### 2 Presentar reductor, reducción auxiliar, motor y acople

en sus interfaces reales.

### 3 Alinear y fijar siguiendo las cotas del conjunto y las

instrucciones comerciales.

COMPROBAR

La plataforma TT10_D_PLATAFORMA es de 40 mm y tiene un paso abierto de cadena de 100 mm. Las representaciones comerciales nominales no son planos de fabricación del equipo comprado.

Plano: TT10_C05_PC_10

KIT DEL PASO · 18 códigos / 25 unidades · lista íntegra en el anexo

MONTAJE / PIEZAS REALES DEL CONJUNTO

# 13 Frenos de salida

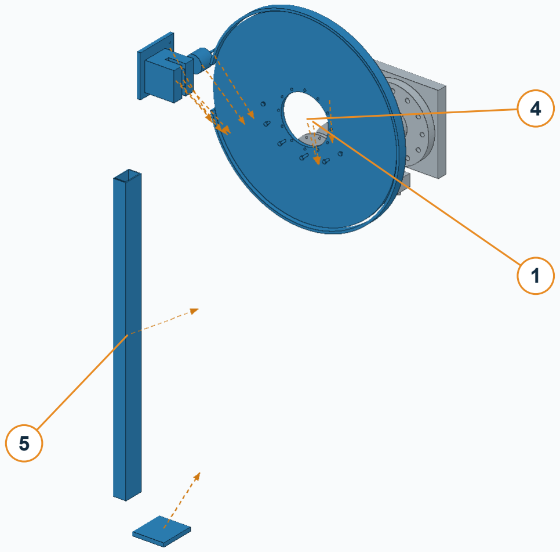
[picture p84: figure]
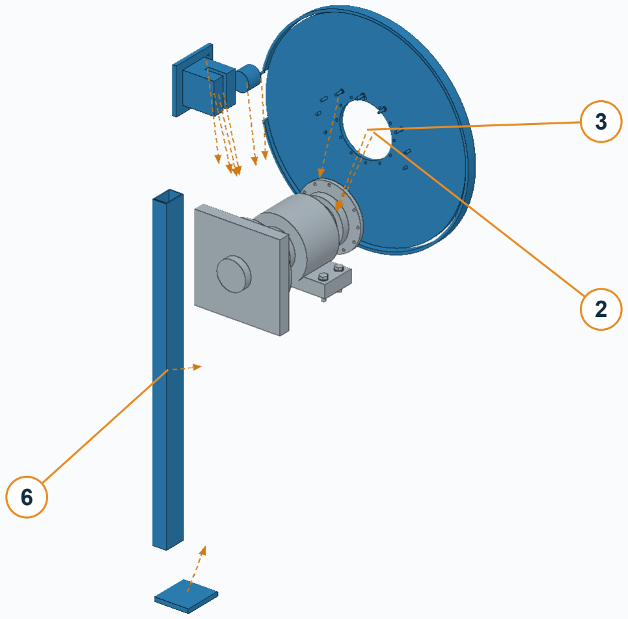
[picture p85: figure]
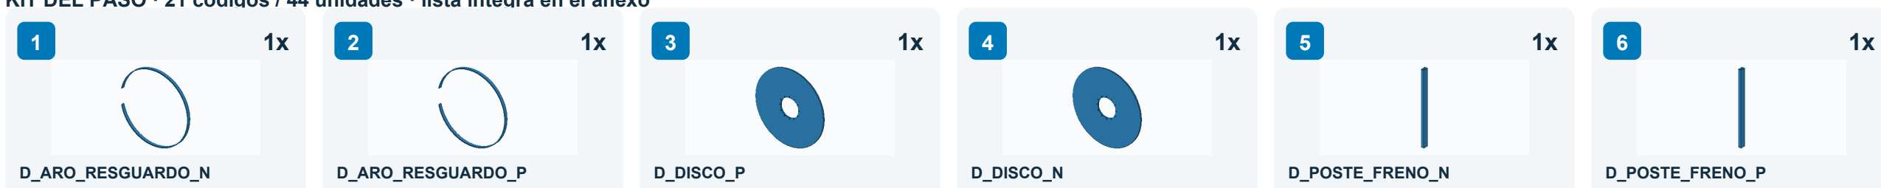
[picture p86: figure]
D_ARO_RESGUARDO_N; D_ARO_RESGUARDO_P; D_DISCO_P; D_DISCO_N; D_POSTE_FRENO_N; D_POSTE_FRENO_P

TT10 | C05 / modelo C06 | 25/10/2026 | Guía visual de fabricación y armado | 16

Azul: piezas de este paso · Gris: referencia ya armada

Dos lados separados para ver las piezas. Mantener los códigos P/N.

Separación visual sin escala. Colocar en la posición indicada en el plano.

### COLOCAR Y UNIR

1 Montar pedestales, placas y pinzas de los lados P y N.

### 2 Presentar discos, pastillas y elementos de liberación

sin contaminar las superficies de fricción.

### 3 Montar los resguardos dejando acceso para el ajuste

indicado en el plano.

COMPROBAR

Cotejar la posición de cada disco respecto de su pinza. El ajuste del freno sigue su documentación específica; no se asigna un par de apriete genérico.

Plano: TT10_C05_PC_11

KIT DEL PASO · 21 códigos / 44 unidades · lista íntegra en el anexo

MONTAJE / PIEZAS REALES DEL CONJUNTO

# 14 Extractores de pasadores

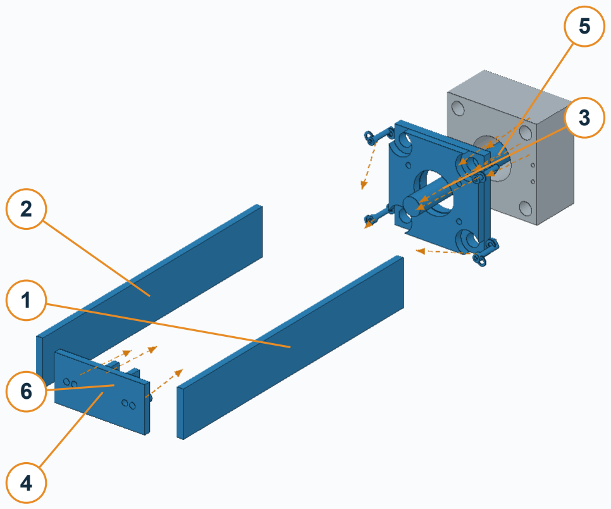
[picture p87: figure]
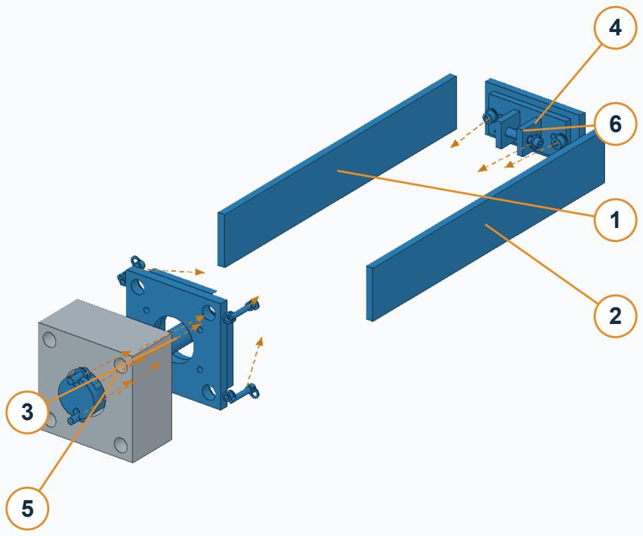
[picture p88: figure]
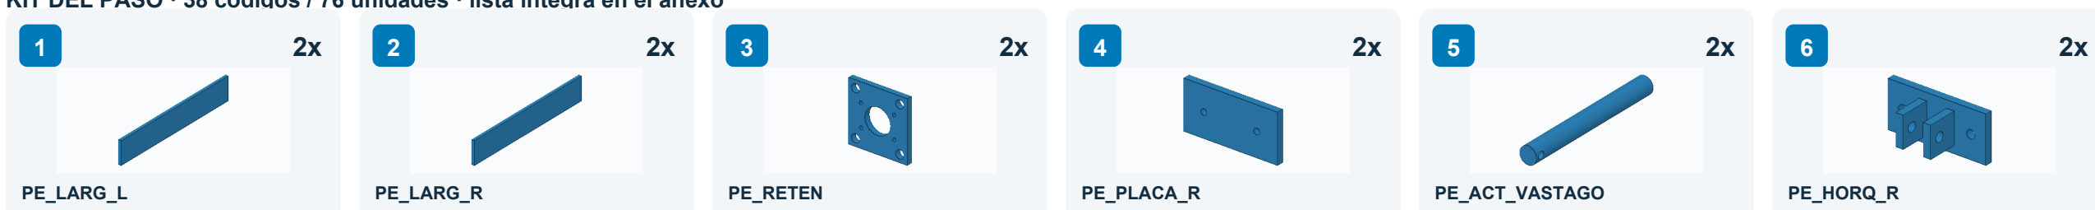
[picture p89: figure]
PE_LARG_L; PE_LARG_R; PE_RETEN; PE_PLACA_R; PE_ACT_VASTAGO; PE_HORQ_R

TT10 | C05 / modelo C06 | 25/10/2026 | Guía visual de fabricación y armado | 17

Azul: piezas de este paso · Gris: referencia ya armada

Dos lados separados para ver las piezas. Mantener los códigos P/N.

Separación visual sin escala. Colocar en la posición indicada en el plano.

### COLOCAR Y UNIR

### 1 Armar los dos bastidores con largueros, placas y

horquillas.

### 2 Presentar los cuerpos de los actuadores y montar los

bulones con sus retenciones.

### 3 Unir el extremo móvil y verificar manualmente el

alineamiento de las articulaciones.

COMPROBAR

Comprobar montaje simétrico P/N y acceso a los retenedores. No tomar los actuadores nominales como capacidad de izaje ni como bloqueo resistente.

Plano: TT10_C05_PC_12

KIT DEL PASO · 38 códigos / 76 unidades · lista íntegra en el anexo

# 15 Pasadores y casquillos

### COLOCAR Y UNIR

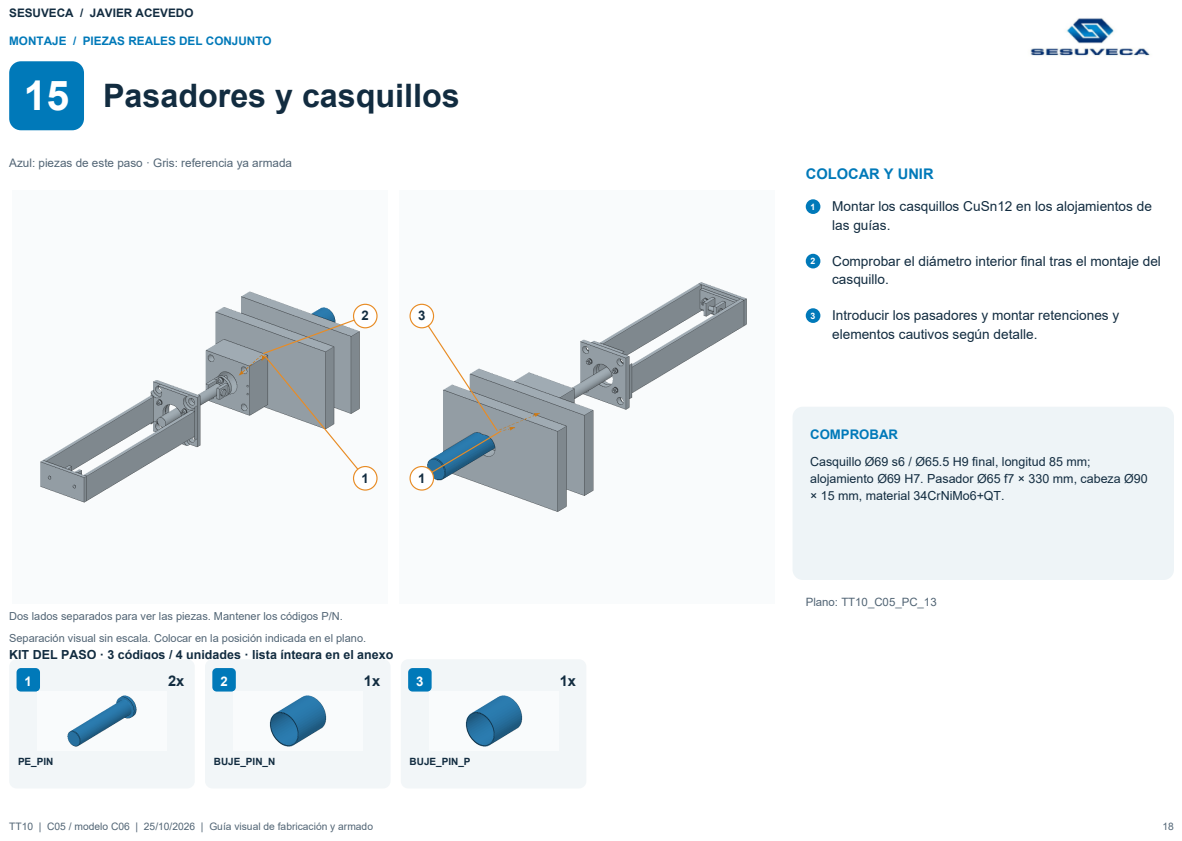
[picture p90: page 18]
TT10 | C05 / modelo C06 | 25/10/2026 | Guía visual de fabricación y armado; COMPROBAR; Plano: TT10_C05_PC_13; PE_PIN; BUJE_PIN_N; BUJE_PIN_P

MONTAJE / PIEZAS REALES DEL CONJUNTO

Azul: piezas de este paso · Gris: referencia ya armada

1 Montar los casquillos CuSn12 en los alojamientos de
las guías.

2 Comprobar el diámetro interior final tras el montaje del
casquillo.

3 Introducir los pasadores y montar retenciones y
elementos cautivos según detalle.

Casquillo Ø69 s6 / Ø65.5 H9 final, longitud 85 mm;
alojamiento Ø69 H7. Pasador Ø65 f7 × 330 mm, cabeza Ø90
× 15 mm, material 34CrNiMo6+QT.

Dos lados separados para ver las piezas. Mantener los códigos P/N.

Separación visual sin escala. Colocar en la posición indicada en el plano.
KIT DEL PASO · 3 códigos / 4 unidades · lista íntegra en el anexo

MONTAJE / PIEZAS REALES DEL CONJUNTO

# 16 Pestillos y recuperación

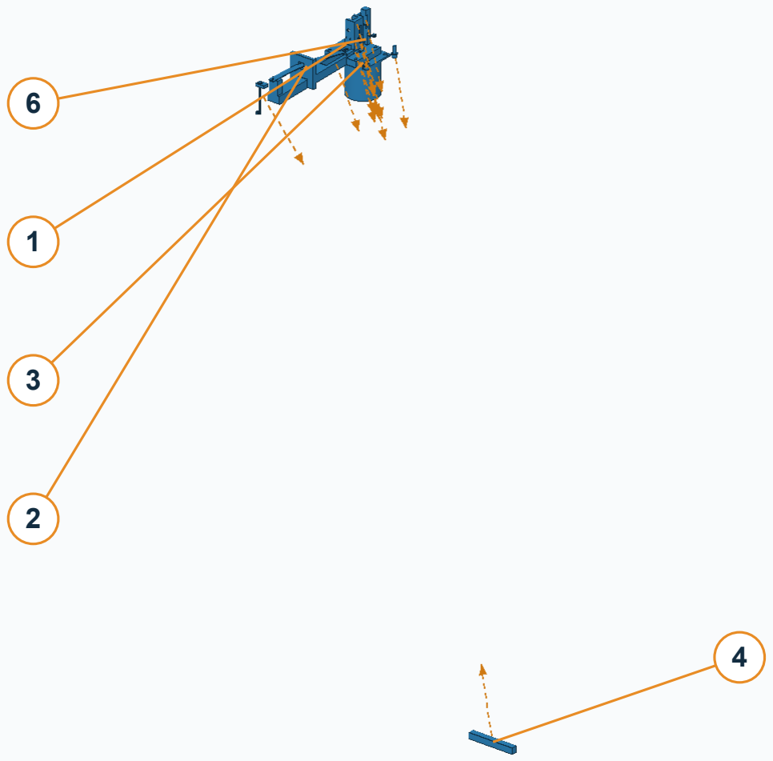
[picture p91: figure]
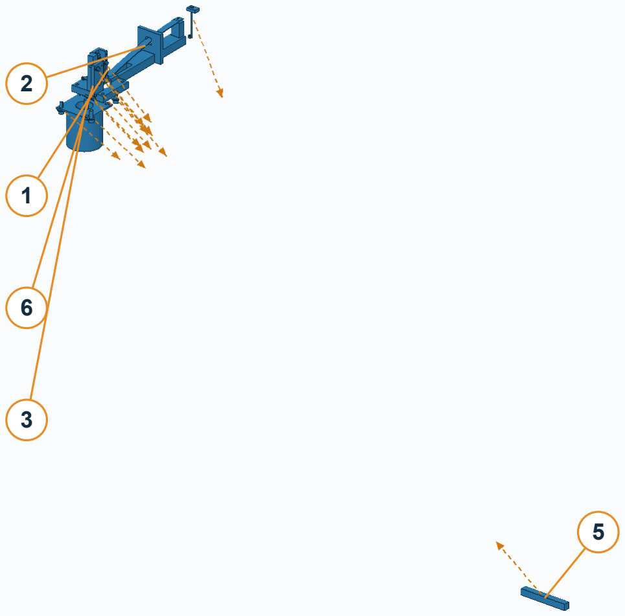
[picture p92: figure]
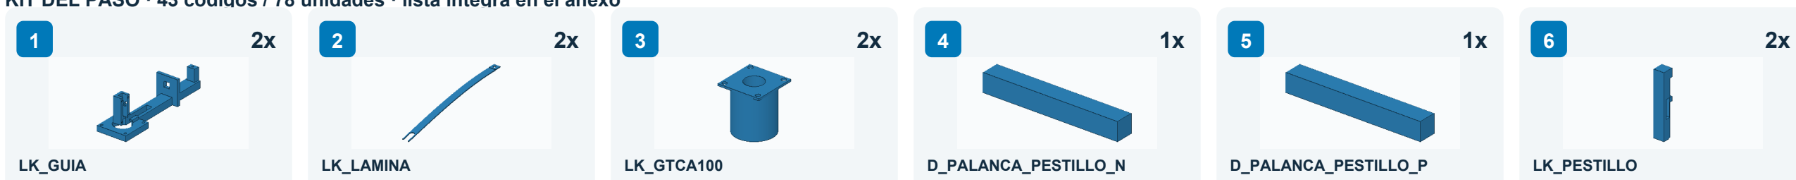
[picture p93: figure]
LK_GUIA; LK_LAMINA; LK_GTCA100; D_PALANCA_PESTILLO_N; D_PALANCA_PESTILLO_P; LK_PESTILLO

TT10 | C05 / modelo C06 | 25/10/2026 | Guía visual de fabricación y armado | 19

Azul: piezas de este paso · Gris: referencia ya armada

Dos lados separados para ver las piezas. Mantener los códigos P/N.

Detalle del mecanismo. Cables y varillas largos: consultar recorrido en el plano.

### COLOCAR Y UNIR

1 Armar los dos conjuntos de pestillo en sus soportes.

### 2 Instalar palancas, cables y terminales según el

recorrido de la vista de conjunto.

### 3 Comprobar el enganche y la recuperación manual con

la cuba inmovilizada.

COMPROBAR

Los cables no deben rozar bordes ni quedar tensos por el movimiento previsto. Verificar la colocación de tornillos cautivos y retenedores.

Plano: TT10_C05_PC_14

KIT DEL PASO · 43 códigos / 78 unidades · lista íntegra en el anexo

MONTAJE / PIEZAS REALES DEL CONJUNTO

# 17 Detectores de posición

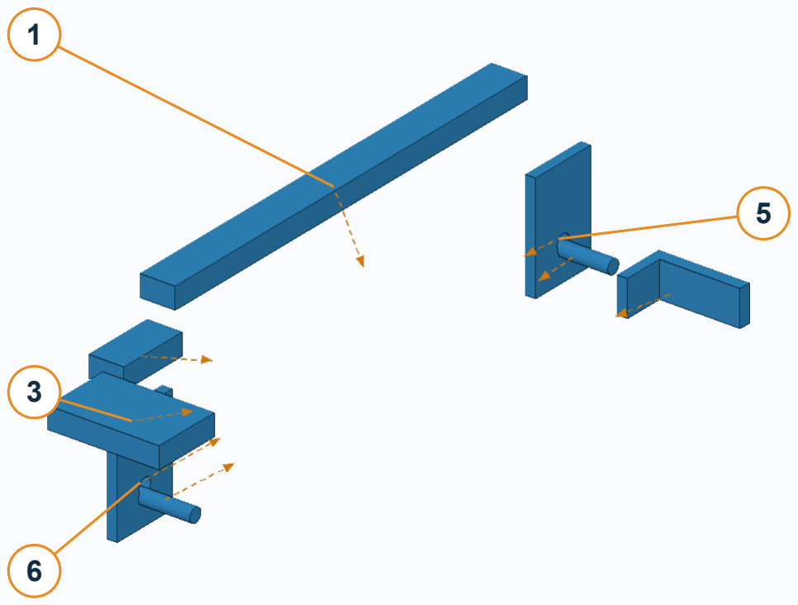
[picture p94: figure]
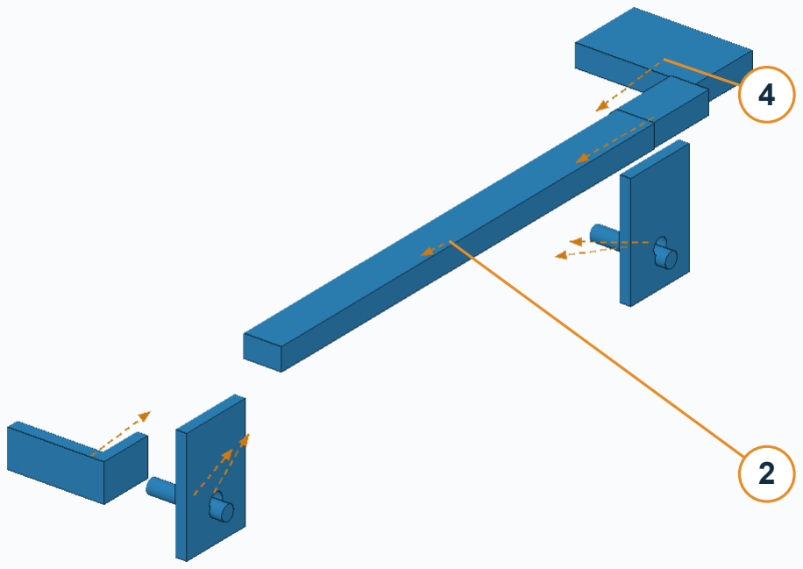
[picture p95: figure]
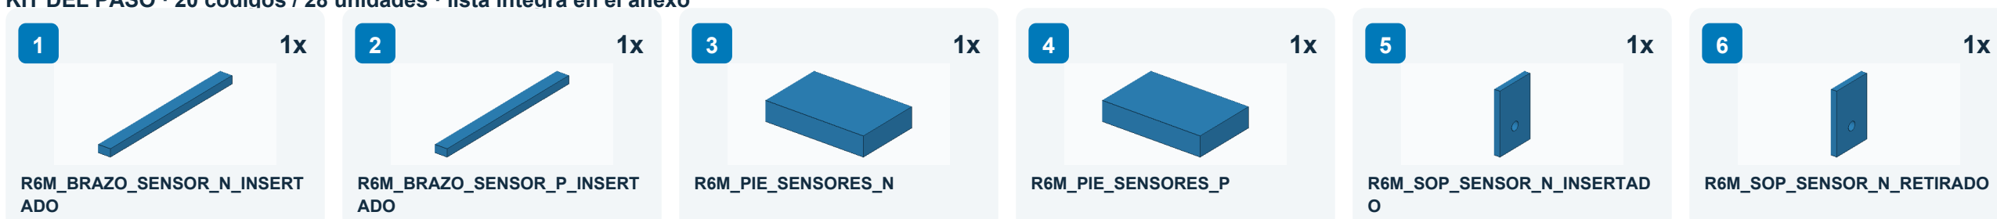
[picture p96: figure]
R6M_BRAZO_SENSOR_N_INSERT ADO; R6M_BRAZO_SENSOR_P_INSERT ADO; R6M_PIE_SENSORES_N; R6M_PIE_SENSORES_P; R6M_SOP_SENSOR_N_INSERTAD O; R6M_SOP_SENSOR_N_RETIRADO

TT10 | C05 / modelo C06 | 25/10/2026 | Guía visual de fabricación y armado | 20

Azul: piezas de este paso · Gris: referencia ya armada

Dos lados separados para ver las piezas. Mantener los códigos P/N.

Detalle del mecanismo. Cables y varillas largos: consultar recorrido en el plano.

### COLOCAR Y UNIR

### 1 Fijar brazos y soportes de los detectores en su

orientación P/N.

2 Montar blancos y sensores de insertado, retirado, pestillo y freno según el conjunto.

### 3 Proteger el cableado para no invadir el recorrido de los

mecanismos.

COMPROBAR

Identificar cada detector por su función, sin intercambiar insertado y retirado. Los sensores ordinarios representados no se declaran una función de seguridad certificada.

Plano: TT10_C05_PC_15

KIT DEL PASO · 20 códigos / 28 unidades · lista íntegra en el anexo

MONTAJE / PIEZAS REALES DEL CONJUNTO

# 18 Puesto manual y tensor

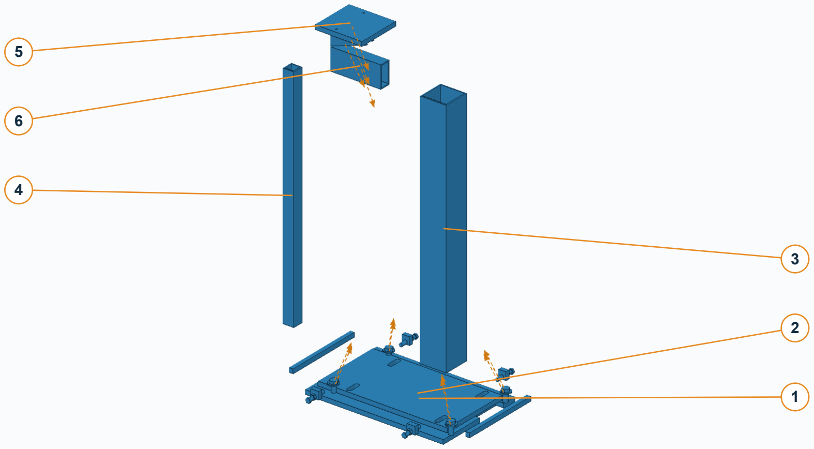
[picture p97: figure]
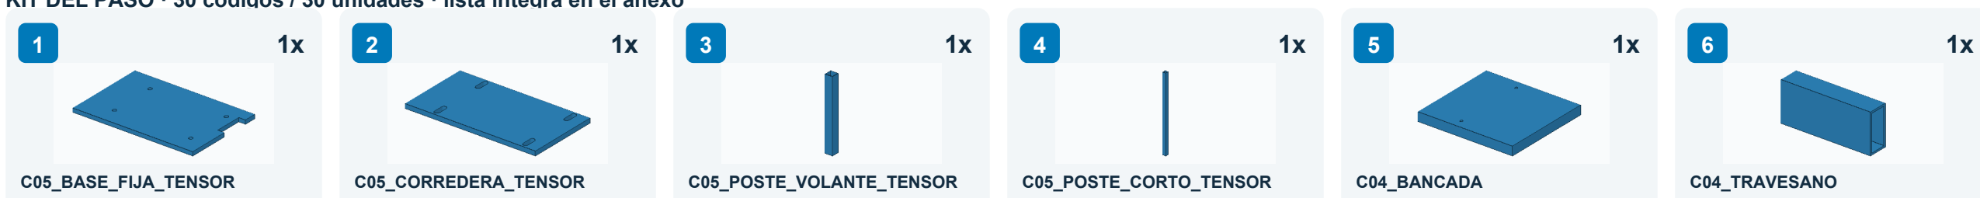
[picture p98: figure]
C05_BASE_FIJA_TENSOR; C05_CORREDERA_TENSOR; C05_POSTE_VOLANTE_TENSOR; C05_POSTE_CORTO_TENSOR; C04_BANCADA; C04_TRAVESANO

TT10 | C05 / modelo C06 | 25/10/2026 | Guía visual de fabricación y armado | 21

Azul: piezas de este paso · Gris: referencia ya armada

Separación visual sin escala. Colocar en la posición indicada en el plano.

### COLOCAR Y UNIR

### 1 Montar los postes, travesaño y bancada del puesto

manual.

2 Instalar el tensor con sus tornillos y arandelas puente.

### 3 Dejar el tensor disponible para el montaje posterior de

la cadena.

COMPROBAR

Las arandelas puente deben cubrir las ranuras del tensor. Soldaduras y posición de la bancada se obtienen del plano PC16.

Plano: TT10_C05_PC_16

KIT DEL PASO · 30 códigos / 30 unidades · lista íntegra en el anexo

MONTAJE / PIEZAS REALES DEL CONJUNTO

# 19 Volante y freno del timón

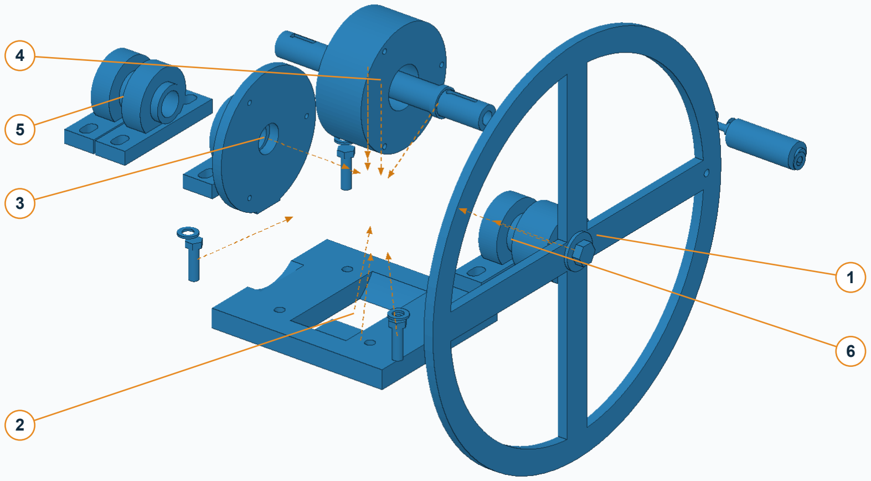
[picture p99: figure]
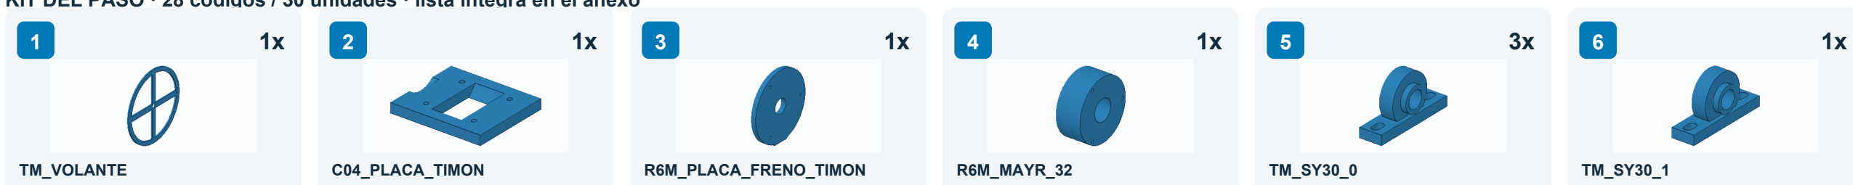
[picture p100: figure]
TM_VOLANTE; C04_PLACA_TIMON; R6M_PLACA_FRENO_TIMON; R6M_MAYR_32

TT10 | C05 / modelo C06 | 25/10/2026 | Guía visual de fabricación y armado | 22

Azul: piezas de este paso · Gris: referencia ya armada

Separación visual sin escala. Colocar en la posición indicada en el plano.

### COLOCAR Y UNIR

### 1 Montar el eje del timón con sus apoyos, chavetas y

retenciones.

### 2 Instalar el cubo y el freno del timón en su placa de

montaje.

### 3 Presentar el volante y comprobar el acceso al

mecanismo de liberación.

COMPROBAR

No usar el freno del timón como sustituto de los frenos de salida. Cotejar asientos, orientación y retenciones con el detalle del subconjunto.

Plano: TT10_C05_PC_17

KIT DEL PASO · 28 códigos / 30 unidades · lista íntegra en el anexo

MONTAJE / PIEZAS REALES DEL CONJUNTO

# 20 Caja del selector

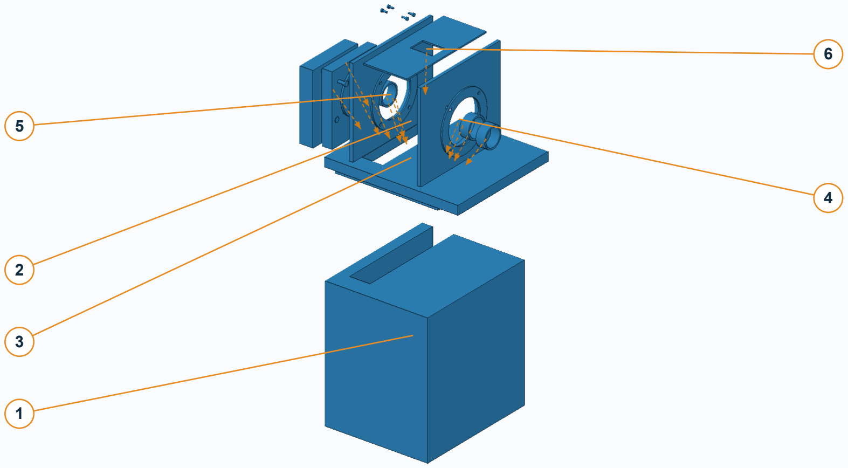
[picture p101: figure]
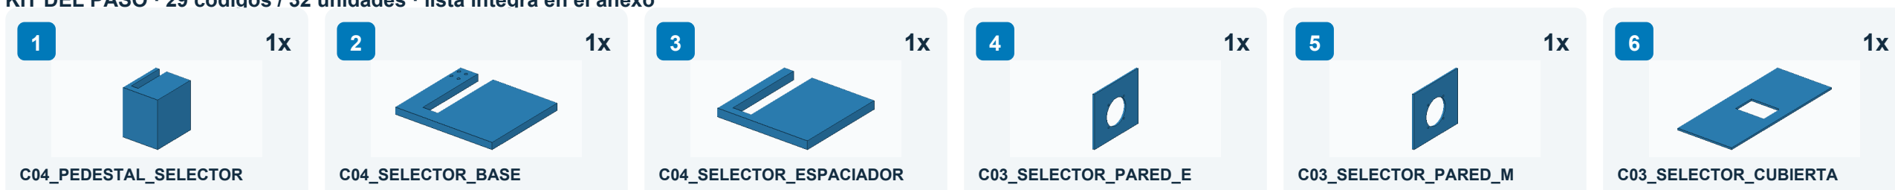
[picture p102: figure]
C04_PEDESTAL_SELECTOR; C04_SELECTOR_BASE; C04_SELECTOR_ESPACIADOR; C03_SELECTOR_PARED_E; C03_SELECTOR_PARED_M; C03_SELECTOR_CUBIERTA

TT10 | C05 / modelo C06 | 25/10/2026 | Guía visual de fabricación y armado | 23

Azul: piezas de este paso · Gris: referencia ya armada

Separación visual sin escala. Colocar en la posición indicada en el plano.

### COLOCAR Y UNIR

1 Armar las paredes y bases mecanizadas de la caja.

### 2 Montar los apoyos, rodamientos y tapas de retención

en el orden de la sección.

### 3 Presentar la cubierta desmontable sin cerrar el acceso

al selector interior.

COMPROBAR

Evitar que una tapa estacionaria roce los elementos giratorios. Mantener visibles y limpios los asientos de rodamiento durante el montaje.

Plano: TT10_C05_PC_20

KIT DEL PASO · 29 códigos / 32 unidades · lista íntegra en el anexo

MONTAJE / PIEZAS REALES DEL CONJUNTO

# 21 Selector y mando exterior

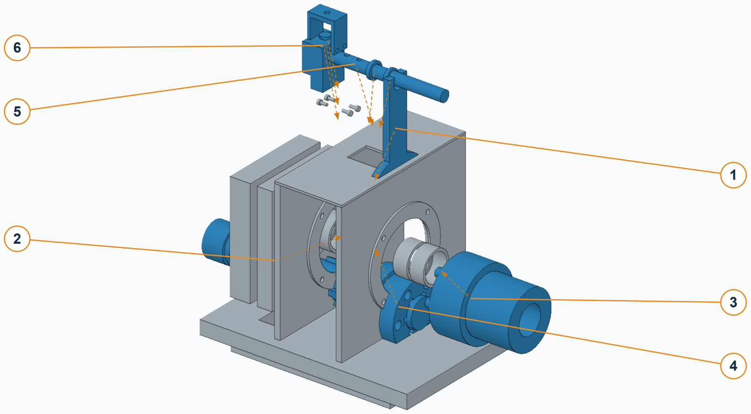
[picture p103: figure]
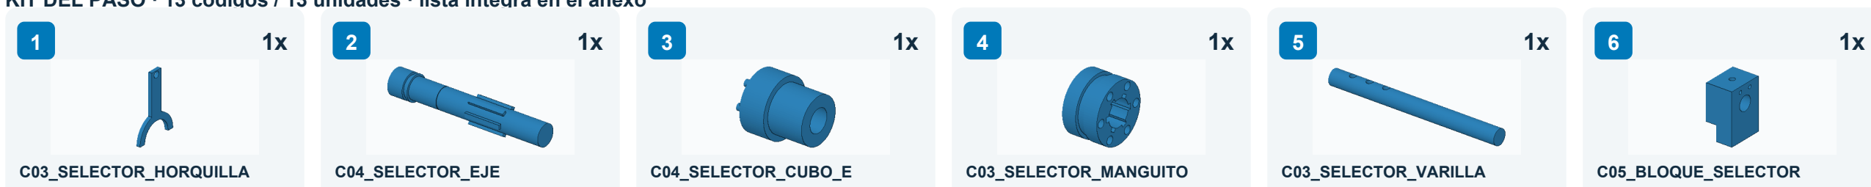
[picture p104: figure]
C03_SELECTOR_HORQUILLA; C04_SELECTOR_EJE; C04_SELECTOR_CUBO_E; C03_SELECTOR_MANGUITO; C03_SELECTOR_VARILLA; C05_BLOQUE_SELECTOR

TT10 | C05 / modelo C06 | 25/10/2026 | Guía visual de fabricación y armado | 24

Azul: piezas de este paso · Gris: referencia ya armada

Detalle del mecanismo. Cables y varillas largos: consultar recorrido en el plano.

### COLOCAR Y UNIR

### 1 Montar eje, manguito, horquilla, varilla y collarines del

selector.

### 2 Instalar el pasador cautivo y conectar la varilla al

mando exterior.

### 3 Con la transmisión inmovilizada, comprobar las

posiciones E, N y M y colocar la cubierta.

COMPROBAR

Extraer el enclavamiento antes de desplazar el selector; reinsertarlo en la posición elegida. Las garras se seleccionan con la máquina parada.

Plano: TT10_C05_PC_21 / TT10_C05_PC_26

KIT DEL PASO · 13 códigos / 13 unidades · lista íntegra en el anexo

MONTAJE / PIEZAS REALES DEL CONJUNTO

# 22 Rama manual BDNB

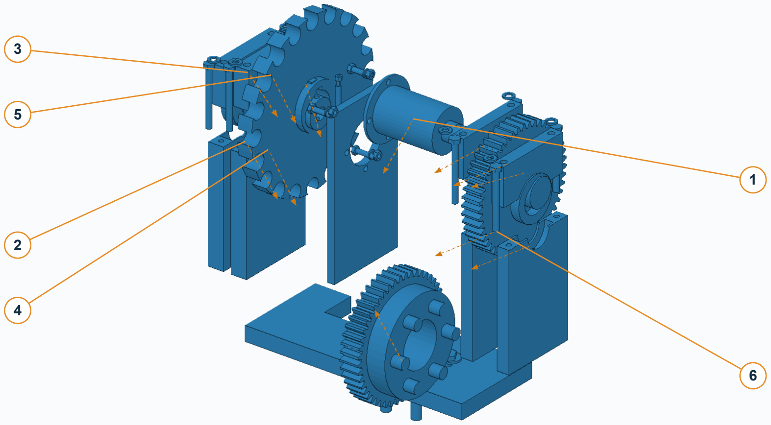
[picture p105: figure]
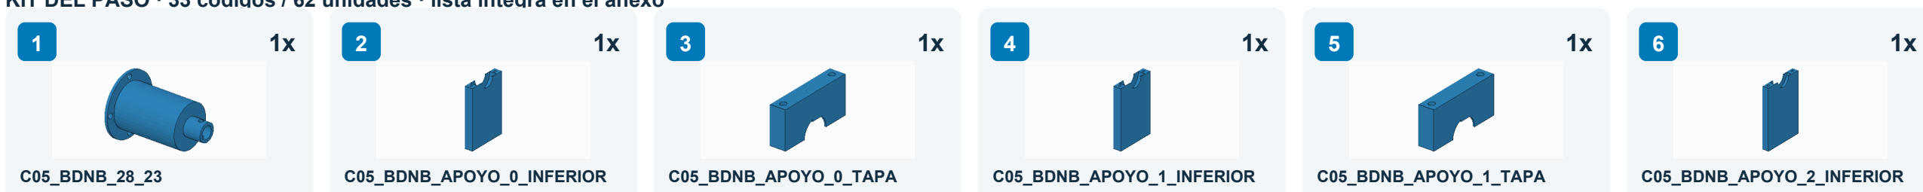
[picture p106: figure]
C05_BDNB_28_23; C05_BDNB_APOYO_0_INFERIOR; C05_BDNB_APOYO_0_TAPA; C05_BDNB_APOYO_1_INFERIOR; C05_BDNB_APOYO_1_TAPA; C05_BDNB_APOYO_2_INFERIOR

TT10 | C05 / modelo C06 | 25/10/2026 | Guía visual de fabricación y armado | 25

Azul: piezas de este paso · Gris: referencia ya armada

Separación visual sin escala. Colocar en la posición indicada en el plano.

### COLOCAR Y UNIR

### 1 Fijar la base y los apoyos partidos; presentar los ejes

externos fabricados.

### 2 Colocar rodamientos y la transmisión externa de

engranajes, chavetas y pasadores según PC22/PC23.

### 3 Montar el freno Warner BDNB 28.23 cerrado, sin

abrirlo; unir sus interfaces y cerrar los apoyos.

COMPROBAR

PC22 y PC23 representan el mismo conjunto: contarlo una sola vez. El freno TT10_C05_BDNB_28_23 es comprado; base, apoyos, ejes y transmisión externos se fabrican según plano. No fabricar ni desarmar los internos del freno comercial.

Plano: TT10_C05_PC_22 / TT10_C05_PC_23

KIT DEL PASO · 33 códigos / 62 unidades · lista íntegra en el anexo

MONTAJE / PIEZAS REALES DEL CONJUNTO

# 23 Cadena y acoples

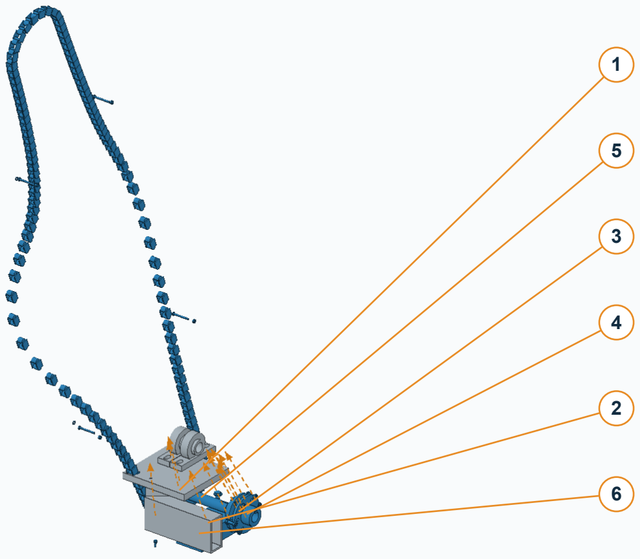
[picture p107: figure]
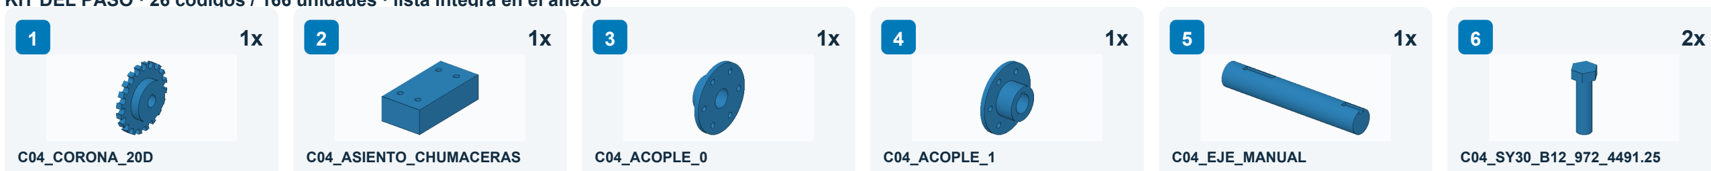
[picture p108: figure]
C04_CORONA_20D; C04_ASIENTO_CHUMACERAS; C04_ACOPLE_0; C04_ACOPLE_1; C04_EJE_MANUAL

TT10 | C05 / modelo C06 | 25/10/2026 | Guía visual de fabricación y armado | 26

Azul: piezas de este paso · Gris: referencia ya armada

Separación visual sin escala. Colocar en la posición indicada en el plano.

### COLOCAR Y UNIR

### 1 Montar coronas y acoples con sus chavetas y

retenciones.

### 2 Instalar la cadena comprada y ajustar el tensor según

el montaje.

### 3 Comprobar alineación y giro manual controlado antes

de instalar el resguardo.

COMPROBAR

Los 122 eslabones visibles son representación CAD; los rodillos compartidos aparecen duplicados. No fabricar una cadena a partir de los sólidos simplificados.

Plano: TT10_C05_PC_18

KIT DEL PASO · 26 códigos / 166 unidades · lista íntegra en el anexo

MONTAJE / PIEZAS REALES DEL CONJUNTO

# 24 Cerrar el resguardo

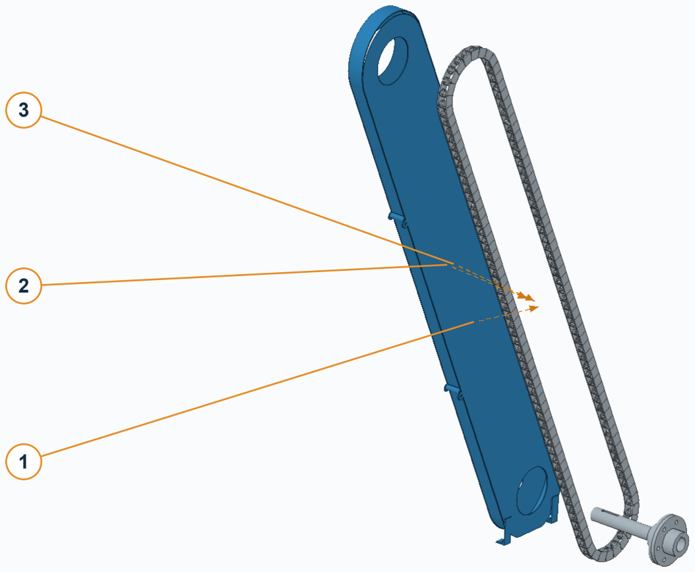
[picture p109: figure]
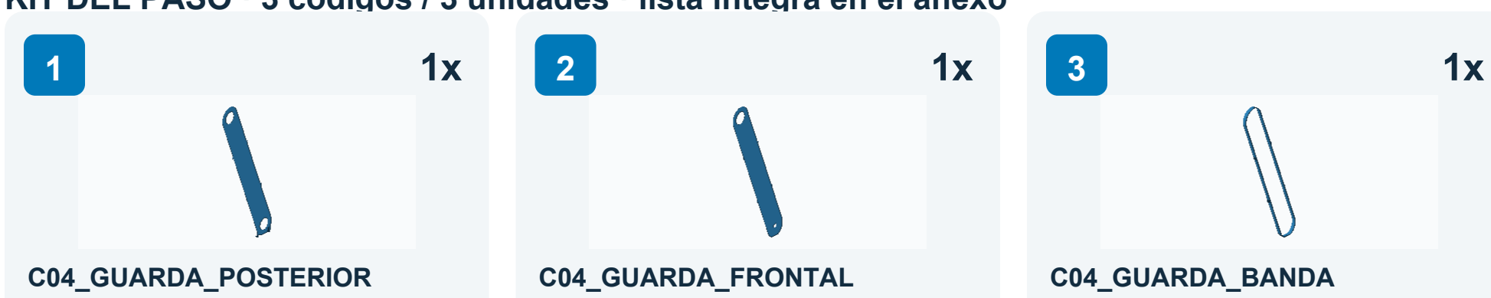
[picture p110: figure]
C04_GUARDA_POSTERIOR; C04_GUARDA_FRONTAL; C04_GUARDA_BANDA

TT10 | C05 / modelo C06 | 25/10/2026 | Guía visual de fabricación y armado | 27

Azul: piezas de este paso · Gris: referencia ya armada

Separación visual sin escala. Colocar en la posición indicada en el plano.

### COLOCAR Y UNIR

### 1 Montar el respaldo y la banda del resguardo de

cadena.

2 Instalar la cubierta frontal desmontable y sus fijaciones.

### 3 Comprobar que el acceso de mantenimiento no obliga

a desmontar la transmisión.

COMPROBAR

No dejar tornillos ni bordes invadiendo el recorrido de cadena y acoples. Las holguras se contrastan con el conjunto y no se deducen de la imagen.

Plano: TT10_C05_PC_19

KIT DEL PASO · 3 códigos / 3 unidades · lista íntegra en el anexo

MONTAJE / PIEZAS REALES DEL CONJUNTO

# 25 Puestos de recuperación y mandos

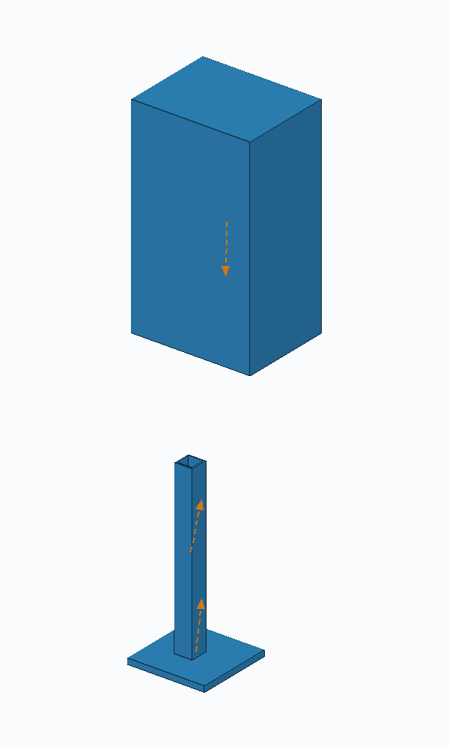
[picture p111: figure]
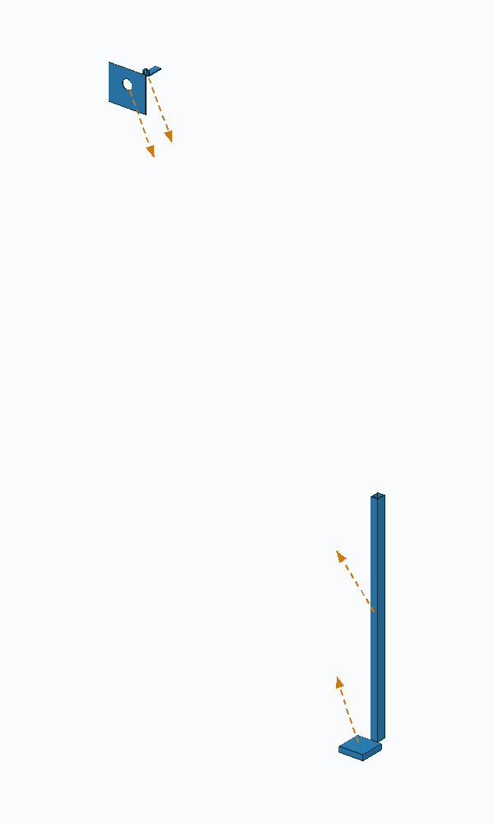
[picture p112: figure]
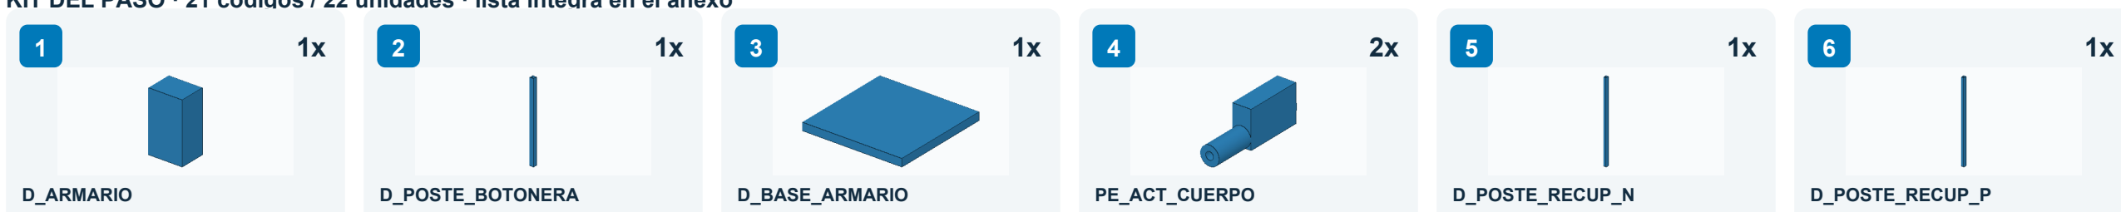
[picture p113: figure]
D_ARMARIO; D_POSTE_BOTONERA; D_BASE_ARMARIO; PE_ACT_CUERPO; D_POSTE_RECUP_N; D_POSTE_RECUP_P

TT10 | C05 / modelo C06 | 25/10/2026 | Guía visual de fabricación y armado | 28

Azul: piezas de este paso · Gris: referencia ya armada

ARMARIO | BOTONERA | RECUPERACIÓN N

Detalles de colocación. Conservar los dos puestos de recuperación P/N.

### COLOCAR Y UNIR

### 1 Montar bases, postes y registros de recuperación de

los lados P y N.

### 2 Fijar soportes del armario, botonera y mando

mantenido.

### 3 Identificar puertos, sensores y cables; mantenerlos

fuera de las zonas móviles.

COMPROBAR

Los puertos de recuperación son accesos de herramienta, no conexiones remotas al actuador. El armario representado es una envolvente; el cableado corresponde al esquema eléctrico.

Plano: TT10_C05_PC_24 / TT10_C05_PC_25

KIT DEL PASO · 21 códigos / 22 unidades · lista íntegra en el anexo

CIERRE DEL ARMADO

# 26 Revisión visual del conjunto armado

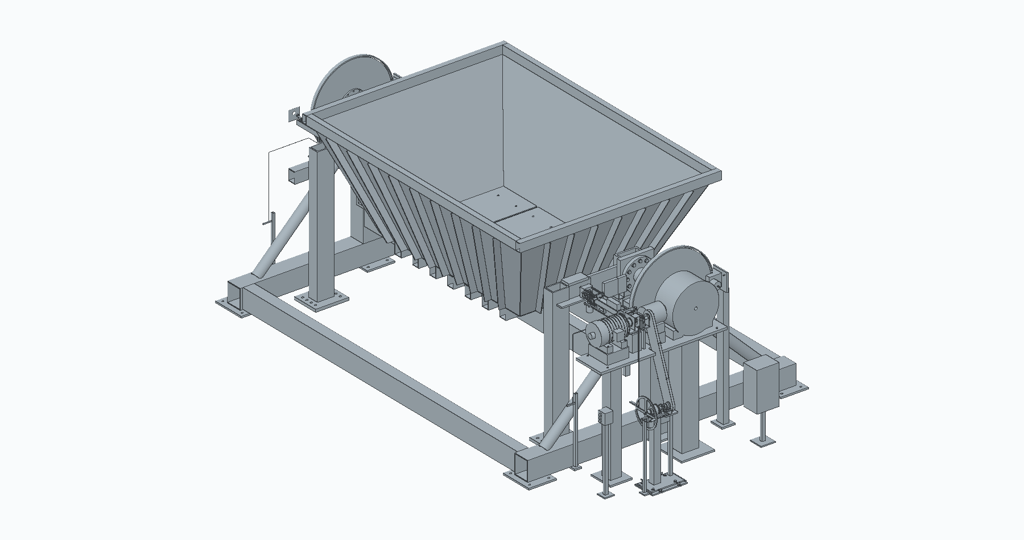
[picture p114: figure]

TT10 | C05 / modelo C06 | 25/10/2026 | Guía visual de fabricación y armado | 29

### CONTROL DEL ARMADO

1 Códigos P/N, separadores y retenciones corresponden con el plano.

2 No quedan piezas sueltas; el montaje mantiene acceso a engrase, pasadores y resguardos.

3 La cuba permanece soportada. La comprobación de movimiento se realiza con el procedimiento autorizado, sin carga.

ANEXO / KITS DE MONTAJE

# Lista completa de piezas por paso

TT10 | C05 / modelo C06 | 25/10/2026 | Guía visual de fabricación y armado | 30
PASO | POS. | CÓDIGO | CANT. | DESCRIPCIÓN / PLANO
04 | 145 | TT10_CART_N_INF | 1 | Cartela horizontal20 entre puente y placa de nodo [TT10_C05_PC_02]
04 | 146 | TT10_CART_N_SUP | 1 | Cartela horizontal20 entre puente y placa de nodo [TT10_C05_PC_02]
04 | 147 | TT10_CART_P_INF | 1 | Cartela horizontal20 entre puente y placa de nodo [TT10_C05_PC_02]
04 | 148 | TT10_CART_P_SUP | 1 | Cartela horizontal20 entre puente y placa de nodo [TT10_C05_PC_02]
04 | 220 | TT10_F431 | 1 | Pieza TT10_F431 [TT10_C05_PC_02]
04 | 221 | TT10_F441 | 1 | Placa80 con cuatro roscas M30 ciegas60, paso540x140; pernos desde arriba [TT10_C05_PC_02]
04 | 222 | TT10_F446 | 1 | Placa80 con cuatro roscas M30 ciegas60, paso540x140; pernos desde arriba [TT10_C05_PC_02]
04 | 225 | TT10_F471 | 1 | Perfil tubular 350 x 200 x 12; L 6300 [TT10_C05_PC_02]
04 | 226 | TT10_F476 | 1 | Perfil tubular 350 x 200 x 12; L 6300 [TT10_C05_PC_02]
04 | 227 | TT10_F481 | 1 | Pieza TT10_F481 [TT10_C05_PC_02]
04 | 231 | TT10_F506 | 1 | Poste independiente cajón 300 x 200 x 2395, t20; 2 diafragmas 260 x 160 x 20 [TT10_C05_PC_02]
04 | 232 | TT10_F511 | 1 | Pieza TT10_F511 [TT10_C05_PC_02]
04 | 233 | TT10_F516 | 1 | Pieza TT10_F516 [TT10_C05_PC_02]
04 | 235 | TT10_F526 | 1 | Perfil tubular 350 x 300 x 12; L 4800 [TT10_C05_PC_02]
04 | 236 | TT10_F531 | 1 | Perfil tubular 350 x 300 x 12; L 4800 [TT10_C05_PC_02]
04 | 238 | TT10_F541 | 1 | Diagonal CHS168.3x10 con cortes de asiento; sin penetrar columnas ni placas [TT10_C05_PC_02]
04 | 239 | TT10_F546 | 1 | Puente RHS200x150x10 L1005; fuera del plano de las diagonales [TT10_C05_PC_02]
04 | 242 | TT10_F561 | 1 | Pieza TT10_F561 [TT10_C05_PC_02]

# Lista completa de piezas por paso

TT10 | C05 / modelo C06 | 25/10/2026 | Guía visual de fabricación y armado | 31
PASO | POS. | CÓDIGO | CANT. | DESCRIPCIÓN / PLANO
04 | 243 | TT10_F566 | 1 | Pieza TT10_F566 [TT10_C05_PC_02]
04 | 244 | TT10_F571 | 1 | Pieza TT10_F571 [TT10_C05_PC_02]
04 | 246 | TT10_F581 | 1 | Diagonal CHS168.3x10 con cortes de asiento; sin penetrar columnas ni placas [TT10_C05_PC_02]
04 | 250 | TT10_F601 | 1 | Diagonal CHS168.3x10 con cortes de asiento; sin penetrar columnas ni placas [TT10_C05_PC_02]
04 | 251 | TT10_F606 | 1 | Diagonal CHS168.3x10 con cortes de asiento; sin penetrar columnas ni placas [TT10_C05_PC_02]
04 | 252 | TT10_F611 | 1 | Poste independiente cajón 300 x 200 x 2395, t20; 2 diafragmas 260 x 160 x 20 [TT10_C05_PC_02]
04 | 254 | TT10_F621 | 1 | Puente RHS200x150x10 L1005; fuera del plano de las diagonales [TT10_C05_PC_02]
04 | 255 | TT10_F626 | 1 | Pieza TT10_F626 [TT10_C05_PC_02]
04 | 256 | TT10_F631 | 1 | Pieza TT10_F631 [TT10_C05_PC_02]
04 | 257 | TT10_F636 | 1 | Columna principal recortada para placa80 y altura de centro SKF220 [TT10_C05_PC_02]
04 | 258 | TT10_F641 | 1 | Columna principal recortada para placa80 y altura de centro SKF220 [TT10_C05_PC_02]
04 | 387 | TT10_N20_P1I | 16 | Tuerca M20 clase8; rosca simplificada [TT10_C05_PC_01]
04 | 388 | TT10_NODO_N | 1 | Placa de nodo20: unión entre puente desplazado y columna principal [TT10_C05_PC_02]
04 | 389 | TT10_NODO_P | 1 | Placa de nodo20: unión entre puente desplazado y columna principal [TT10_C05_PC_02]
04 | 454 | TT10_TIR_N1 | 1 | Tirante M20 propuesto, L380; rosca simplificada [TT10_C05_PC_01]
04 | 455 | TT10_TIR_N2 | 1 | Tirante M20 propuesto, L380; rosca simplificada [TT10_C05_PC_01]
04 | 456 | TT10_TIR_N3 | 1 | Tirante M20 propuesto, L380; rosca simplificada [TT10_C05_PC_01]
04 | 457 | TT10_TIR_N4 | 1 | Tirante M20 propuesto, L380; rosca simplificada [TT10_C05_PC_01]

# Lista completa de piezas por paso

TT10 | C05 / modelo C06 | 25/10/2026 | Guía visual de fabricación y armado | 32
PASO | POS. | CÓDIGO | CANT. | DESCRIPCIÓN / PLANO
04 | 458 | TT10_TIR_P1 | 1 | Tirante M20 propuesto, L380; rosca simplificada [TT10_C05_PC_02]
04 | 459 | TT10_TIR_P2 | 1 | Tirante M20 propuesto, L380; rosca simplificada [TT10_C05_PC_02]
04 | 460 | TT10_TIR_P3 | 1 | Tirante M20 propuesto, L380; rosca simplificada [TT10_C05_PC_02]
04 | 461 | TT10_TIR_P4 | 1 | Tirante M20 propuesto, L380; rosca simplificada [TT10_C05_PC_02]
04 | 499 | TT10_W20_P1I | 16 | Arandela D37 D21 t3 [TT10_C05_PC_01]
05 | 218 | TT10_F416 | 1 | Placa base 600 x 500 x 50; 8 agujeros Ø40, centros X ±220, Y ±150 y ±50 [TT10_C05_PC_03]
05 | 219 | TT10_F426 | 1 | Tope inclinado: cara inferior mecanizada para asiento horizontal [TT10_C05_PC_03]
05 | 228 | TT10_F486 | 1 | Oreja fija 400 x 250 x 40; agujero Ø65 H8; Strenx 700E [TT10_C05_PC_03]
05 | 230 | TT10_F501 | 1 | Oreja fija 400 x 250 x 40; agujero Ø65 H8; Strenx 700E [TT10_C05_PC_03]
05 | 237 | TT10_F536 | 1 | Soporte tope terminado en cara interior de columna [TT10_C05_PC_03]
05 | 241 | TT10_F556 | 1 | Soporte tope terminado en cara interior de columna [TT10_C05_PC_03]
05 | 245 | TT10_F576 | 1 | Oreja fija 400 x 250 x 40; agujero Ø65 H8; Strenx 700E [TT10_C05_PC_03]
05 | 247 | TT10_F586 | 1 | Oreja fija 400 x 250 x 40; agujero Ø65 H8; Strenx 700E [TT10_C05_PC_03]
05 | 248 | TT10_F591 | 1 | Placa base 600 x 500 x 50; 8 agujeros Ø40, centros X ±220, Y ±150 y ±50 [TT10_C05_PC_03]
05 | 249 | TT10_F596 | 1 | Tope inclinado: cara inferior mecanizada para asiento horizontal [TT10_C05_PC_03]
05 | 262 | TT10_GUIA_N | 1 | Guía con alojamiento Ø69 H7; casquillo69/65.5; fuera del camino resistente [TT10_C05_PC_03]
05 | 263 | TT10_GUIA_P | 1 | Guía con alojamiento Ø69 H7; casquillo69/65.5; fuera del camino resistente [TT10_C05_PC_03]
05 | 430 | TT10_PUENTE_N | 1 | Puente guía A36 525 x 125 x 25; recorte 225 x 10 junto al poste [TT10_C05_PC_03]

# Lista completa de piezas por paso

TT10 | C05 / modelo C06 | 25/10/2026 | Guía visual de fabricación y armado | 33
PASO | POS. | CÓDIGO | CANT. | DESCRIPCIÓN / PLANO
05 | 431 | TT10_PUENTE_P | 1 | Puente guía A36 525 x 125 x 25; recorte 225 x 10 junto al poste [TT10_C05_PC_03]
05 | 487 | TT10_TOPE70_N_INFD | 1 | Cartela horizontal20: transmite componente transversal del tope70 [TT10_C05_PC_03]
05 | 488 | TT10_TOPE70_N_INFI | 1 | Cartela horizontal20: transmite componente transversal del tope70 [TT10_C05_PC_03]
05 | 489 | TT10_TOPE70_N_SUPD | 1 | Cartela horizontal20: transmite componente transversal del tope70 [TT10_C05_PC_03]
05 | 490 | TT10_TOPE70_N_SUPI | 1 | Cartela horizontal20: transmite componente transversal del tope70 [TT10_C05_PC_03]
05 | 491 | TT10_TOPE70_N_V1 | 1 | Cartela vertical20 de tope70; apoyo al bloque y cara de columna [TT10_C05_PC_03]
05 | 492 | TT10_TOPE70_N_V2 | 1 | Cartela vertical20 de tope70; apoyo al bloque y cara de columna [TT10_C05_PC_03]
05 | 493 | TT10_TOPE70_P_INFD | 1 | Cartela horizontal20: transmite componente transversal del tope70 [TT10_C05_PC_03]
05 | 494 | TT10_TOPE70_P_INFI | 1 | Cartela horizontal20: transmite componente transversal del tope70 [TT10_C05_PC_03]
05 | 495 | TT10_TOPE70_P_SUPD | 1 | Cartela horizontal20: transmite componente transversal del tope70 [TT10_C05_PC_03]
05 | 496 | TT10_TOPE70_P_SUPI | 1 | Cartela horizontal20: transmite componente transversal del tope70 [TT10_C05_PC_03]
05 | 497 | TT10_TOPE70_P_V1 | 1 | Cartela vertical20 de tope70; apoyo al bloque y cara de columna [TT10_C05_PC_03]
05 | 498 | TT10_TOPE70_P_V2 | 1 | Cartela vertical20 de tope70; apoyo al bloque y cara de columna [TT10_C05_PC_03]
06 | 305 | TT10_M006 | 1 | Perfil tubular 200 x 150 x 10; L 2200 [TT10_C05_PC_05]
06 | 306 | TT10_M011 | 1 | Perfil tubular 200 x 150 x 10; L 2200 [TT10_C05_PC_05]
06 | 307 | TT10_M016 | 1 | Perfil tubular 150 x 100 x 8; L 4800 [TT10_C05_PC_05]
06 | 308 | TT10_M021 | 1 | Perfil tubular 200 x 150 x 10; L 2200 [TT10_C05_PC_05]
06 | 309 | TT10_M026 | 1 | Perfil tubular 150 x 100 x 8; L 3600 [TT10_C05_PC_05]

# Lista completa de piezas por paso

TT10 | C05 / modelo C06 | 25/10/2026 | Guía visual de fabricación y armado | 34
PASO | POS. | CÓDIGO | CANT. | DESCRIPCIÓN / PLANO
06 | 312 | TT10_M041 | 1 | Perfil tubular 200 x 150 x 10; L 2200 [TT10_C05_PC_05]
06 | 313 | TT10_M046 | 1 | Perfil tubular 400 x 200 x 16; L 5600 [TT10_C05_PC_05]
06 | 324 | TT10_M101 | 1 | Perfil tubular 200 x 100 x 10; L 250 [TT10_C05_PC_05]
06 | 328 | TT10_M121 | 1 | Pieza TT10_M121 [TT10_C05_PC_05]
06 | 329 | TT10_M131 | 1 | Cabezal cajón 200 x 200 x 1200, t40; 2 diafragmas 120 x 120 x 40 [TT10_C05_PC_05]
06 | 333 | TT10_M151 | 1 | Pieza TT10_M151 [TT10_C05_PC_05]
06 | 335 | TT10_M161 | 1 | Yugo cajón 400 x 200 x 1116, t30; 2 diafragmas 340 x 140 x 30; agujero Ø202 [TT10_C05_PC_05]
06 | 336 | TT10_M166 | 1 | Perfil tubular 150 x 100 x 8; L 4800 [TT10_C05_PC_05]
06 | 340 | TT10_M186 | 1 | Perfil tubular 200 x 150 x 10; L 2200 [TT10_C05_PC_05]
06 | 341 | TT10_M191 | 1 | Pieza TT10_M191 [TT10_C05_PC_05]
06 | 343 | TT10_M201 | 1 | Cabezal cajón 200 x 200 x 1200, t40; 2 diafragmas 120 x 120 x 40 [TT10_C05_PC_05]
06 | 344 | TT10_M206 | 1 | Pieza TT10_M206 [TT10_C05_PC_05]
06 | 348 | TT10_M226 | 1 | Perfil tubular 200 x 150 x 10; L 2200 [TT10_C05_PC_05]
06 | 350 | TT10_M236 | 1 | Perfil tubular 150 x 100 x 8; L 3600 [TT10_C05_PC_05]
06 | 355 | TT10_M261 | 1 | Pieza TT10_M261 [TT10_C05_PC_05]
06 | 358 | TT10_M276 | 1 | Brazo monolítico Strenx 700E t50; perfil 800 x 650; R50; agujero Ø65,5 [TT10_C05_PC_05]
06 | 365 | TT10_M311 | 1 | Yugo cajón 400 x 200 x 1116, t30; 2 diafragmas 340 x 140 x 30; agujero Ø202 [TT10_C05_PC_05]
06 | 369 | TT10_M336 | 1 | Perfil tubular 200 x 100 x 10; L 250 [TT10_C05_PC_05]

# Lista completa de piezas por paso

TT10 | C05 / modelo C06 | 25/10/2026 | Guía visual de fabricación y armado | 35
PASO | POS. | CÓDIGO | CANT. | DESCRIPCIÓN / PLANO
06 | 372 | TT10_M351 | 1 | Brazo monolítico Strenx 700E t50; perfil 800 x 650; R50; agujero Ø65,5 [TT10_C05_PC_05]
06 | 373 | TT10_M356 | 1 | Perfil tubular 400 x 200 x 16; L 5600 [TT10_C05_PC_05]
06 | 376 | TT10_M371 | 1 | Pieza TT10_M371 [TT10_C05_PC_05]
06 | 378 | TT10_M381 | 1 | Perfil tubular 200 x 150 x 10; L 2200 [TT10_C05_PC_05]
07 | 311 | TT10_M036 | 1 | Pieza TT10_M036 [TT10_C05_PC_06]
07 | 316 | TT10_M061 | 1 | Pieza TT10_M061 [TT10_C05_PC_06]
07 | 317 | TT10_M066 | 1 | Pieza TT10_M066 [TT10_C05_PC_06]
07 | 322 | TT10_M091 | 1 | Pieza TT10_M091 [TT10_C05_PC_06]
07 | 326 | TT10_M111 | 1 | Pieza TT10_M111 [TT10_C05_PC_06]
07 | 327 | TT10_M116 | 1 | Pieza TT10_M116 [TT10_C05_PC_06]
07 | 331 | TT10_M141 | 1 | Pieza TT10_M141 [TT10_C05_PC_06]
07 | 332 | TT10_M146 | 1 | Pieza TT10_M146 [TT10_C05_PC_06]
07 | 342 | TT10_M196 | 1 | Pieza TT10_M196 [TT10_C05_PC_06]
07 | 349 | TT10_M231 | 1 | Pieza TT10_M231 [TT10_C05_PC_06]
07 | 359 | TT10_M281 | 1 | Pieza TT10_M281 [TT10_C05_PC_06]
07 | 360 | TT10_M286 | 1 | Pieza TT10_M286 [TT10_C05_PC_06]
07 | 362 | TT10_M296 | 1 | Pieza TT10_M296 [TT10_C05_PC_06]
07 | 363 | TT10_M301 | 1 | Pieza TT10_M301 [TT10_C05_PC_06]

# Lista completa de piezas por paso

TT10 | C05 / modelo C06 | 25/10/2026 | Guía visual de fabricación y armado | 36
PASO | POS. | CÓDIGO | CANT. | DESCRIPCIÓN / PLANO
07 | 366 | TT10_M316 | 1 | Pieza TT10_M316 [TT10_C05_PC_06]
07 | 367 | TT10_M326 | 1 | Pieza TT10_M326 [TT10_C05_PC_06]
07 | 368 | TT10_M331 | 1 | Pieza TT10_M331 [TT10_C05_PC_06]
07 | 370 | TT10_M341 | 1 | Pieza TT10_M341 [TT10_C05_PC_06]
07 | 371 | TT10_M346 | 1 | Pieza TT10_M346 [TT10_C05_PC_06]
07 | 381 | TT10_M396 | 1 | Pieza TT10_M396 [TT10_C05_PC_06]
08 | 310 | TT10_M031 | 1 | Pieza TT10_M031 [TT10_C05_PC_07]
08 | 314 | TT10_M051 | 1 | Pieza TT10_M051 [TT10_C05_PC_07]
08 | 318 | TT10_M071 | 1 | Pieza TT10_M071 [TT10_C05_PC_07]
08 | 320 | TT10_M081 | 1 | Pieza TT10_M081 [TT10_C05_PC_07]
08 | 323 | TT10_M096 | 1 | Pieza TT10_M096 [TT10_C05_PC_07]
08 | 330 | TT10_M136 | 1 | Pieza TT10_M136 [TT10_C05_PC_07]
08 | 337 | TT10_M171 | 1 | Pieza TT10_M171 [TT10_C05_PC_07]
08 | 338 | TT10_M176 | 1 | Fondo16 con taladros de revestimientos desmontables [TT10_C05_PC_07]
08 | 339 | TT10_M181 | 1 | Pieza TT10_M181 [TT10_C05_PC_07]
08 | 346 | TT10_M216 | 1 | Pieza TT10_M216 [TT10_C05_PC_07]
08 | 352 | TT10_M246 | 1 | Pieza TT10_M246 [TT10_C05_PC_07]
08 | 353 | TT10_M251 | 1 | Pieza TT10_M251 [TT10_C05_PC_07]

# Lista completa de piezas por paso

TT10 | C05 / modelo C06 | 25/10/2026 | Guía visual de fabricación y armado | 37
PASO | POS. | CÓDIGO | CANT. | DESCRIPCIÓN / PLANO
08 | 361 | TT10_M291 | 1 | Pieza TT10_M291 [TT10_C05_PC_07]
08 | 374 | TT10_M361 | 1 | Pieza TT10_M361 [TT10_C05_PC_07]
08 | 382 | TT10_M401 | 1 | Pieza TT10_M401 [TT10_C05_PC_07]
08 | 383 | TT10_M406 | 1 | Pieza TT10_M406 [TT10_C05_PC_07]
08 | 384 | TT10_M411 | 1 | Pieza TT10_M411 [TT10_C05_PC_07]
09 | 266 | TT10_LIN_0_0_B | 32 | Tornillo avellanado M16x80, cabeza90 D31, hexágono10; geometría nominal [TT10_C05_PC_08]
09 | 267 | TT10_LIN_0_0_C | 32 | Casquillo30/18 L25 limita compresión de elastómero [TT10_C05_PC_08]
09 | 268 | TT10_LIN_0_0_N | 32 | Tuerca autoblocante metálica M16; rosca simplificada [TT10_C05_PC_08]
09 | 269 | TT10_LIN_0_0_W | 32 | Arandela M16 200HV D30/d17/t3 [TT10_C05_PC_08]
09 | 315 | TT10_M056 | 1 | Cama elastomérica25 perforada para casquillos limitadores [TT10_C05_PC_08]
09 | 345 | TT10_M211 | 1 | Cama elastomérica25 perforada para casquillos limitadores [TT10_C05_PC_08]
09 | 347 | TT10_M221 | 1 | Cama elastomérica25 perforada para casquillos limitadores [TT10_C05_PC_08]
09 | 351 | TT10_M241 | 1 | Cama elastomérica25 perforada para casquillos limitadores [TT10_C05_PC_08]
09 | 354 | TT10_M256 | 1 | Revestimiento AR400 t12 con ocho M16 avellanados desmontables [TT10_C05_PC_08]
09 | 356 | TT10_M266 | 1 | Revestimiento AR400 t12 con ocho M16 avellanados desmontables [TT10_C05_PC_08]
09 | 379 | TT10_M386 | 1 | Revestimiento AR400 t12 con ocho M16 avellanados desmontables [TT10_C05_PC_08]
09 | 380 | TT10_M391 | 1 | Revestimiento AR400 t12 con ocho M16 avellanados desmontables [TT10_C05_PC_08]
10 | 1 | TT10_22240_N | 1 | SKF22240CC/W33 200x360x98; envolvente sin rodillos [TT10_C05_PC_09]

# Lista completa de piezas por paso

TT10 | C05 / modelo C06 | 25/10/2026 | Guía visual de fabricación y armado | 38
PASO | POS. | CÓDIGO | CANT. | DESCRIPCIÓN / PLANO
10 | 2 | TT10_22240_P | 1 | SKF22240CC/W33 200x360x98; envolvente sin rodillos [TT10_C05_PC_09]
10 | 3 | TT10_BAP_P0 | 8 | Perno ISO4014 M30x140 clase8.8; rosca nominal [TT10_C05_PC_01]
10 | 149 | TT10_COLLAR_N | 1 | Casquillo D220/d200.2 L161: transmisión de apriete y pista de sello [TT10_C05_PC_09]
10 | 150 | TT10_COLLAR_P | 1 | Casquillo D220/d200.2 L161: transmisión de apriete y pista de sello [TT10_C05_PC_09]
10 | 180 | TT10_D_CUBO_N | 1 | Cubo de conexión por apriete y brida de disco N [TT10_C05_PC_09]
10 | 181 | TT10_D_CUBO_P | 1 | Cubo de conexión por apriete y brida de disco P [TT10_C05_PC_09]
10 | 224 | TT10_F456 | 1 | SKF SNL3048: dimensiones de interfaz según catálogo; fundición simplificada [TT10_C05_PC_02]
10 | 240 | TT10_F551 | 1 | SKF SNL3048: dimensiones de interfaz según catálogo; fundición simplificada [TT10_C05_PC_02]
10 | 260 | TT10_FRB_1 | 1 | SKF FRB21/360; lado P localizador [TT10_C05_PC_01]
10 | 261 | TT10_FRB_2 | 1 | SKF FRB21/360; lado P localizador [TT10_C05_PC_01]
10 | 264 | TT10_KM40_N | 1 | SKF KM40, M200x3, D250 B29; cuatro ranuras18x8 [TT10_C05_PC_09]
10 | 265 | TT10_KM40_P | 1 | SKF KM40, M200x3, D250 B29; cuatro ranuras18x8 [TT10_C05_PC_09]
10 | 319 | TT10_M076 | 1 | Muñón forjado integral con brida550, hombro220, asiento200, R3 y retención exterior [TT10_C05_PC_09]
10 | 321 | TT10_M086 | 1 | Muñón forjado integral con brida550, hombro220, asiento200, R3 y retención exterior [TT10_C05_PC_09]
10 | 325 | TT10_M106 | 1 | Contraplaca80 con doce M30 ciegas78 PCD450, apriete desde exterior [TT10_C05_PC_09]
10 | 377 | TT10_M376 | 1 | Contraplaca80 con doce M30 ciegas78 PCD450, apriete desde exterior [TT10_C05_PC_09]
10 | 385 | TT10_MB40_N | 1 | MB40 comprada: una pestana plegada nominal en KM40; restantes18 planas [TT10_C05_PC_09]
10 | 386 | TT10_MB40_P | 1 | MB40 comprada: una pestana plegada nominal en KM40; restantes18 planas [TT10_C05_PC_09]

# Lista completa de piezas por paso

TT10 | C05 / modelo C06 | 25/10/2026 | Guía visual de fabricación y armado | 39
PASO | POS. | CÓDIGO | CANT. | DESCRIPCIÓN / PLANO
10 | 483 | TT10_TNF_N1 | 1 | SKF TNF48; reserva dimensional axial A2=380 [TT10_C05_PC_01]
10 | 484 | TT10_TNF_N2 | 1 | SKF TNF48; reserva dimensional axial A2=380 [TT10_C05_PC_01]
10 | 485 | TT10_TNF_P1 | 1 | SKF TNF48; reserva dimensional axial A2=380 [TT10_C05_PC_01]
10 | 486 | TT10_TNF_P2 | 1 | SKF TNF48; reserva dimensional axial A2=380 [TT10_C05_PC_01]
10 | 500 | TT10_W30_AP_P02227.5 | 8 | Arandela ISO7089 M30 300HV, D56 d31 t4 [TT10_C05_PC_01]
11 | 3 | TT10_BAP_P0 | 24 | Perno ISO4014 M30x140 clase8.8; rosca nominal [TT10_C05_PC_01]
11 | 500 | TT10_W30_AP_P02227.5 | 24 | Arandela ISO7089 M30 300HV, D56 d31 t4 [TT10_C05_PC_01]
12 | 46 | TT10_C04_CHAVETA_MOTOR | 1 | Chaveta12x8x35, extremos planos; interfaz propia, no ejeOEM aprobado [TT10_C05_PC_01]
12 | 51 | TT10_C04_ENTRADA_MOTOR | 1 | Interfaz nominal de entradaD40, separacion2mm del ejecomun; motor comercial aun nominal [TT10_C05_PC_01]
12 | 151 | TT10_D_ACOPLE_SALIDA | 1 | Acoplamiento de salida entre cubo y reductor; dibujo nominal [TT10_C05_PC_01]
12 | 155 | TT10_D_AUX_4_1 | 1 | Reducción auxiliar 4:1; representación de arquitectura [TT10_C05_PC_01]
12 | 156 | TT10_D_B16_0 | 8 | Perno nominal M16x50 [TT10_C05_PC_01]
12 | 161 | TT10_D_BASE_MOTOR | 1 | Placa base del segundo apoyo de bancada [TT10_C05_PC_10]
12 | 177 | TT10_D_CARTELA_MOTOR_0 | 1 | Apoyo lateral desmontable de bancada [TT10_C05_PC_10]
12 | 178 | TT10_D_CARTELA_MOTOR_1 | 1 | Apoyo lateral desmontable de bancada [TT10_C05_PC_10]
12 | 179 | TT10_D_COLUMNA_MOTOR | 1 | Columna adicional RHS200x200; asiento sobre placa base [TT10_C05_PC_10]
12 | 184 | TT10_D_ENCODER | 1 | Encoder de velocidad en eje motor [TT10_C05_PC_01]
12 | 185 | TT10_D_ENTRADA_REDUCTOR | 1 | Eje de conexión geométrica ENTRADA_REDUCTOR [TT10_C05_PC_01]

# Lista completa de piezas por paso

TT10 | C05 / modelo C06 | 25/10/2026 | Guía visual de fabricación y armado | 40
PASO | POS. | CÓDIGO | CANT. | DESCRIPCIÓN / PLANO
12 | 189 | TT10_D_MOTOR | 1 | Motor eléctrico con encoder; geometría nominal, potencia no seleccionada [TT10_C05_PC_10]
12 | 197 | TT10_D_PEDESTAL_AUX | 1 | Pedestal bajo reducción auxiliar [TT10_C05_PC_10]
12 | 198 | TT10_D_PEDESTAL_MOTOR | 1 | Soporte común de pies del motor [TT10_C05_PC_10]
12 | 201 | TT10_D_PLATAFORMA | 1 | Plataforma t40 con paso abierto de cadena ancho100, extremo R50; geometría nativa vigente [TT10_C05_PC_10]
12 | 209 | TT10_D_REDUCTOR | 1 | Reductor principal angular: carcasa y conexiones nominales [TT10_C05_PC_10]
12 | 213 | TT10_D_SALIDA_REDUCTOR | 1 | Eje de conexión geométrica SALIDA_REDUCTOR [TT10_C05_PC_01]
12 | 234 | TT10_F521 | 1 | Columna accionamiento apoyada sobre placa base [TT10_C05_PC_10]
13 | 153 | TT10_D_ARO_RESGUARDO_N | 1 | Resguardo tubular desmontable ARO_RESGUARDO_N [TT10_C05_PC_11]
13 | 154 | TT10_D_ARO_RESGUARDO_P | 1 | Resguardo tubular desmontable ARO_RESGUARDO_P [TT10_C05_PC_11]
13 | 156 | TT10_D_B16_0 | 24 | Perno nominal M16x50 [TT10_C05_PC_01]
13 | 159 | TT10_D_BASE_FRENO_N | 1 | Base de pedestal de freno N [TT10_C05_PC_11]
13 | 160 | TT10_D_BASE_FRENO_P | 1 | Base de pedestal de freno P [TT10_C05_PC_11]
13 | 182 | TT10_D_DISCO_N | 1 | Disco de freno de salida N; diámetro nominal de dibujo [TT10_C05_PC_09]
13 | 183 | TT10_D_DISCO_P | 1 | Disco de freno de salida P; diámetro nominal de dibujo [TT10_C05_PC_09]
13 | 186 | TT10_D_LIBERACION_FRENO_N | 1 | Eje de conexión geométrica LIBERACION_FRENO_N [TT10_C05_PC_01]
13 | 187 | TT10_D_LIBERACION_FRENO_P | 1 | Eje de conexión geométrica LIBERACION_FRENO_P [TT10_C05_PC_01]
13 | 193 | TT10_D_PASTILLA_N0 | 1 | Pastilla de freno; contacto nominal intencional [TT10_C05_PC_01]
13 | 194 | TT10_D_PASTILLA_N1 | 1 | Pastilla de freno; contacto nominal intencional [TT10_C05_PC_01]

# Lista completa de piezas por paso

TT10 | C05 / modelo C06 | 25/10/2026 | Guía visual de fabricación y armado | 41
PASO | POS. | CÓDIGO | CANT. | DESCRIPCIÓN / PLANO
13 | 195 | TT10_D_PASTILLA_P0 | 1 | Pastilla de freno; contacto nominal intencional [TT10_C05_PC_01]
13 | 196 | TT10_D_PASTILLA_P1 | 1 | Pastilla de freno; contacto nominal intencional [TT10_C05_PC_01]
13 | 199 | TT10_D_PINZA_N | 1 | Pinza de freno por resorte, liberación eléctrica N; envolvente nominal [TT10_C05_PC_11]
13 | 200 | TT10_D_PINZA_P | 1 | Pinza de freno por resorte, liberación eléctrica P; envolvente nominal [TT10_C05_PC_11]
13 | 204 | TT10_D_POSTE_FRENO_N | 1 | Pedestal del freno N [TT10_C05_PC_11]
13 | 205 | TT10_D_POSTE_FRENO_P | 1 | Pedestal del freno P [TT10_C05_PC_11]
13 | 210 | TT10_D_RESORTE_FRENO_N | 1 | Paquete de resortes de aplicación del freno N [TT10_C05_PC_01]
13 | 211 | TT10_D_RESORTE_FRENO_P | 1 | Paquete de resortes de aplicación del freno P [TT10_C05_PC_01]
13 | 216 | TT10_D_SOPORTE_FRENO_N | 1 | Placa de montaje de pinza N [TT10_C05_PC_11]
13 | 217 | TT10_D_SOPORTE_FRENO_P | 1 | Placa de montaje de pinza P [TT10_C05_PC_11]
14 | 391 | TT10_PE_ACT_VASTAGO | 2 | Extremo y vástago comercial nominal D30.2; taladro12.2; parte móvil de candidato Thomson [TT10_C05_PC_12]
14 | 392 | TT10_PE_BA0 | 2 | Tornillo M8x40 clase8.8, rosca nominal; fijador de rosca según montaje [TT10_C05_PC_01]
14 | 393 | TT10_PE_BA1 | 2 | Tornillo M8x40 clase8.8, rosca nominal; fijador de rosca según montaje [TT10_C05_PC_01]
14 | 394 | TT10_PE_BA2 | 2 | Tornillo M8x40 clase8.8, rosca nominal; fijador de rosca según montaje [TT10_C05_PC_01]
14 | 395 | TT10_PE_BA3 | 2 | Tornillo M8x40 clase8.8, rosca nominal; fijador de rosca según montaje [TT10_C05_PC_01]
14 | 396 | TT10_PE_BEF | 2 | ISO7380-1 M6x10 8.8; cabeza baja D10.5 H3.3 envolvente; hexágono4; fijador de rosca requerido [TT10_C05_PC_12]
14 | 397 | TT10_PE_BER | 2 | Tornillo M8x12 clase8.8, rosca nominal; fijador de rosca según montaje [TT10_C05_PC_01]
14 | 398 | TT10_PE_BF0 | 2 | Tornillo M10x25 clase8.8, rosca nominal; fijador de rosca según montaje [TT10_C05_PC_12]

# Lista completa de piezas por paso

TT10 | C05 / modelo C06 | 25/10/2026 | Guía visual de fabricación y armado | 42
PASO | POS. | CÓDIGO | CANT. | DESCRIPCIÓN / PLANO
14 | 399 | TT10_PE_BF1 | 2 | Tornillo M10x25 clase8.8, rosca nominal; fijador de rosca según montaje [TT10_C05_PC_12]
14 | 400 | TT10_PE_BR0 | 2 | Tornillo M10x25 clase8.8, rosca nominal; fijador de rosca según montaje [TT10_C05_PC_01]
14 | 401 | TT10_PE_BR1 | 2 | Tornillo M10x25 clase8.8, rosca nominal; fijador de rosca según montaje [TT10_C05_PC_01]
14 | 402 | TT10_PE_EJE_F | 2 | Bulón articulación D12 h8, cabeza20x4, M6-6H axial profundidad12; arandela y tornillo de retención [TT10_C05_PC_12]
14 | 403 | TT10_PE_EJE_R | 2 | Bulón articulación D12 h8, cabeza20x4, M8-6H axial profundidad12; arandela y tornillo de retención [TT10_C05_PC_01]
14 | 404 | TT10_PE_HORQ_F | 2 | Horquilla frontal integral S355: base60x10, separación31.2, dos orejas10, D12.2H8; 2M10 de fijación [TT10_C05_PC_12]
14 | 405 | TT10_PE_HORQ_R | 2 | Horquilla trasera mecanizada: base130x60x10; separación26.4; eje12; 2M10 [TT10_C05_PC_12]
14 | 406 | TT10_PE_LARG_L | 2 | Larguero S355 plano12x80; corte a longitud503.0 [TT10_C05_PC_12]
14 | 407 | TT10_PE_LARG_R | 2 | Larguero S355 plano12x80; corte a longitud503.0 [TT10_C05_PC_12]
14 | 408 | TT10_PE_NA0 | 2 | Tuerca M8 clase8; rosca nominal, retención por fijador especificado [TT10_C05_PC_01]
14 | 409 | TT10_PE_NA1 | 2 | Tuerca M8 clase8; rosca nominal, retención por fijador especificado [TT10_C05_PC_01]
14 | 410 | TT10_PE_NA2 | 2 | Tuerca M8 clase8; rosca nominal, retención por fijador especificado [TT10_C05_PC_01]
14 | 411 | TT10_PE_NA3 | 2 | Tuerca M8 clase8; rosca nominal, retención por fijador especificado [TT10_C05_PC_01]
14 | 413 | TT10_PE_PLACA_F | 2 | Placa de bastidor160x160x12; D70;4D9 y4aliviosD42 abiertos en esquinas para tuercas existentes [TT10_C05_PC_12]
14 | 414 | TT10_PE_PLACA_R | 2 | Travesaño160x80x12; 2M10-6H pasantes en X±45; frentes soldados a largueros [TT10_C05_PC_12]
14 | 415 | TT10_PE_RETEN | 2 | Placa cautiva160x160x15: amplía paso aD68,4D22 original; añade4D9 en X±45 Z±30 [TT10_C05_PC_12]
14 | 416 | TT10_PE_WA0 | 2 | Arandela D16/d8.4/t1.6 [TT10_C05_PC_01]
14 | 417 | TT10_PE_WA1 | 2 | Arandela D16/d8.4/t1.6 [TT10_C05_PC_01]

# Lista completa de piezas por paso

TT10 | C05 / modelo C06 | 25/10/2026 | Guía visual de fabricación y armado | 43
PASO | POS. | CÓDIGO | CANT. | DESCRIPCIÓN / PLANO
14 | 418 | TT10_PE_WA2 | 2 | Arandela D16/d8.4/t1.6 [TT10_C05_PC_01]
14 | 419 | TT10_PE_WA3 | 2 | Arandela D16/d8.4/t1.6 [TT10_C05_PC_01]
14 | 420 | TT10_PE_WEF | 2 | Arandela D12/d6.4/t1.6 [TT10_C05_PC_12]
14 | 421 | TT10_PE_WER | 2 | Arandela D20/d8.4/t2 [TT10_C05_PC_01]
14 | 422 | TT10_PE_WF0 | 2 | Arandela D20/d10.5/t2 [TT10_C05_PC_12]
14 | 423 | TT10_PE_WF1 | 2 | Arandela D20/d10.5/t2 [TT10_C05_PC_12]
14 | 424 | TT10_PE_WN0 | 2 | Arandela D16/d8.4/t1.6 [TT10_C05_PC_01]
14 | 425 | TT10_PE_WN1 | 2 | Arandela D16/d8.4/t1.6 [TT10_C05_PC_01]
14 | 426 | TT10_PE_WN2 | 2 | Arandela D16/d8.4/t1.6 [TT10_C05_PC_01]
14 | 427 | TT10_PE_WN3 | 2 | Arandela D16/d8.4/t1.6 [TT10_C05_PC_01]
14 | 428 | TT10_PE_WR0 | 2 | Arandela D20/d10.5/t2 [TT10_C05_PC_01]
14 | 429 | TT10_PE_WR1 | 2 | Arandela D20/d10.5/t2 [TT10_C05_PC_01]
15 | 4 | TT10_BUJE_PIN_N | 1 | Casquillo CuSn12 Ø69 s6 / Ø65.5 H9 final, L85, C0.5 interiores [TT10_C05_PC_13]
15 | 5 | TT10_BUJE_PIN_P | 1 | Casquillo CuSn12 Ø69 s6 / Ø65.5 H9 final, L85, C0.5 interiores [TT10_C05_PC_13]
15 | 412 | TT10_PE_PIN | 2 | Pasador Ø65 f7 x 330; cabeza Ø90 x 15; R3; 34CrNiMo6+QT Rp0,2 mín.800 MPa [TT10_C05_PC_13]
16 | 170 | TT10_D_CABLE_PESTILLO_FIN_N | 1 | Eje de conexión geométrica CABLE_PESTILLO_FIN_N [TT10_C05_PC_01]
16 | 171 | TT10_D_CABLE_PESTILLO_FIN_P | 1 | Eje de conexión geométrica CABLE_PESTILLO_FIN_P [TT10_C05_PC_01]
16 | 172 | TT10_D_CABLE_PESTILLO_N | 1 | Eje de conexión geométrica CABLE_PESTILLO_N [TT10_C05_PC_01]

# Lista completa de piezas por paso

TT10 | C05 / modelo C06 | 25/10/2026 | Guía visual de fabricación y armado | 44
PASO | POS. | CÓDIGO | CANT. | DESCRIPCIÓN / PLANO
16 | 173 | TT10_D_CABLE_PESTILLO_P | 1 | Eje de conexión geométrica CABLE_PESTILLO_P [TT10_C05_PC_01]
16 | 174 | TT10_D_CABLE_PESTILLO_SUP_N | 1 | Eje de conexión geométrica CABLE_PESTILLO_SUP_N [TT10_C05_PC_01]
16 | 175 | TT10_D_CABLE_PESTILLO_SUP_P | 1 | Eje de conexión geométrica CABLE_PESTILLO_SUP_P [TT10_C05_PC_01]
16 | 190 | TT10_D_PALANCA_PESTILLO_N | 1 | Palanca accesible de recuperación del pestillo por cable [TT10_C05_PC_14]
16 | 191 | TT10_D_PALANCA_PESTILLO_P | 1 | Palanca accesible de recuperación del pestillo por cable [TT10_C05_PC_14]
16 | 270 | TT10_LK_BC0 | 2 | TornilloM6x258.8; cabeza nominal, fijador de rosca y apriete por montaje [TT10_C05_PC_14]
16 | 271 | TT10_LK_BC1 | 2 | TornilloM6x258.8; cabeza nominal, fijador de rosca y apriete por montaje [TT10_C05_PC_14]
16 | 272 | TT10_LK_BC2 | 2 | TornilloM6x258.8; cabeza nominal, fijador de rosca y apriete por montaje [TT10_C05_PC_14]
16 | 273 | TT10_LK_BC3 | 2 | TornilloM6x258.8; cabeza nominal, fijador de rosca y apriete por montaje [TT10_C05_PC_14]
16 | 274 | TT10_LK_BL0 | 2 | TornilloM6x908.8; cabeza nominal, fijador de rosca y apriete por montaje [TT10_C05_PC_14]
16 | 275 | TT10_LK_BS0 | 2 | TornilloM10x258.8; cabeza nominal, fijador de rosca y apriete por montaje [TT10_C05_PC_14]
16 | 276 | TT10_LK_BS1 | 2 | TornilloM10x258.8; cabeza nominal, fijador de rosca y apriete por montaje [TT10_C05_PC_14]
16 | 277 | TT10_LK_BS2 | 2 | TornilloM10x258.8; cabeza nominal, fijador de rosca y apriete por montaje [TT10_C05_PC_14]
16 | 278 | TT10_LK_BS3 | 2 | TornilloM10x258.8; cabeza nominal, fijador de rosca y apriete por montaje [TT10_C05_PC_14]
16 | 279 | TT10_LK_BSE0 | 2 | TornilloISO4762 M6x20 8.8;5.4mm de rosca en guia, fijador y apriete4Nm [TT10_C05_PC_14]
16 | 280 | TT10_LK_BSE1 | 2 | TornilloISO4762 M6x20 8.8;5.4mm de rosca en guia, fijador y apriete4Nm [TT10_C05_PC_14]
16 | 281 | TT10_LK_GTCA100 | 2 | Magnet-Schultz GTCA100X43A02,24V,S1: envolvente e interfaces publicadas; no CAD oficial [TT10_C05_PC_14]
16 | 282 | TT10_LK_GUIA | 2 | Pestillo: guia abierta20.4x20.4, brazo25x42, pie80x12; asiento solenoide110/88 [TT10_C05_PC_14]

# Lista completa de piezas por paso

TT10 | C05 / modelo C06 | 25/10/2026 | Guía visual de fabricación y armado | 45
PASO | POS. | CÓDIGO | CANT. | DESCRIPCIÓN / PLANO
16 | 283 | TT10_LK_LAMINA | 2 | Resorte de lamina20x1.8, longitud activa330, precarga equivalente50mm; forma instalada; horquillaU R6.5, sin esquina interna recta [TT10_C05_PC_14]
16 | 284 | TT10_LK_MORDAZA_LAMINA | 2 | Mordaza30x20x9.1 para resorte; no soldar ni taladrar zona activa de la lamina [TT10_C05_PC_14]
16 | 285 | TT10_LK_NL0 | 2 | TuercaM6clase8, retencion positiva segun montaje [TT10_C05_PC_14]
16 | 286 | TT10_LK_NT | 2 | TuercaM6clase8, retencion positiva segun montaje [TT10_C05_PC_14]
16 | 287 | TT10_LK_PESTILLO | 2 | Pestillo42CrMo4+QT, punta20x20, enganche radial nominal9mm, retirada25mm; M12 liberacion [TT10_C05_PC_14]
16 | 288 | TT10_LK_SENSOR | 2 | ifmIE5338: sensor ordinarioPNP de enganche; M8x1, cara Y22, entrehierro nominal1mm [TT10_C05_PC_14]
16 | 289 | TT10_LK_SOP_SENSOR | 2 | Soporte desmontable: sensor a cara real del pestillo; dosM6x20, sin soldar a la guia [TT10_C05_PC_14]
16 | 290 | TT10_LK_TAPA | 2 | Tapa de guia desmontable; tornillo de recorrido y fijaciones de tapa pendientes de comprobacion [TT10_C05_PC_14]
16 | 291 | TT10_LK_TIRANTE | 2 | TiranteM12 nominal entre pestillo y solenoide; longitud ajustable, conexion OEM por verificar [TT10_C05_PC_14]
16 | 292 | TT10_LK_TOPE | 2 | Tornillo de hombroD8, paso de recorrido; conexion roscada nominal pendiente de detalle [TT10_C05_PC_14]
16 | 293 | TT10_LK_WC0 | 2 | ArandelaD12/d6.4/t1.6 [TT10_C05_PC_14]
16 | 294 | TT10_LK_WC1 | 2 | ArandelaD12/d6.4/t1.6 [TT10_C05_PC_14]
16 | 295 | TT10_LK_WC2 | 2 | ArandelaD12/d6.4/t1.6 [TT10_C05_PC_14]
16 | 296 | TT10_LK_WC3 | 2 | ArandelaD12/d6.4/t1.6 [TT10_C05_PC_14]
16 | 297 | TT10_LK_WL0 | 2 | ArandelaD12/d6.4/t1.6 [TT10_C05_PC_14]
16 | 298 | TT10_LK_WS0 | 2 | ArandelaD20/d10.5/t2 [TT10_C05_PC_14]
16 | 299 | TT10_LK_WS1 | 2 | ArandelaD20/d10.5/t2 [TT10_C05_PC_14]
16 | 300 | TT10_LK_WS2 | 2 | ArandelaD20/d10.5/t2 [TT10_C05_PC_14]

# Lista completa de piezas por paso

TT10 | C05 / modelo C06 | 25/10/2026 | Guía visual de fabricación y armado | 46
PASO | POS. | CÓDIGO | CANT. | DESCRIPCIÓN / PLANO
16 | 301 | TT10_LK_WS3 | 2 | ArandelaD20/d10.5/t2 [TT10_C05_PC_14]
16 | 302 | TT10_LK_WSE0 | 2 | ArandelaISO7089 M6 200HV [TT10_C05_PC_14]
16 | 303 | TT10_LK_WSE1 | 2 | ArandelaISO7089 M6 200HV [TT10_C05_PC_14]
16 | 304 | TT10_LK_WT | 2 | ArandelaD12/d6.4/t1.6 [TT10_C05_PC_14]
17 | 165 | TT10_D_BLANCO_PIN | 2 | Bandera de detección del pasador retirado [TT10_C05_PC_15]
17 | 214 | TT10_D_SENSOR_FRENO_N | 1 | Eje de conexión geométrica SENSOR_FRENO_N [TT10_C05_PC_15]
17 | 215 | TT10_D_SENSOR_FRENO_P | 1 | Eje de conexión geométrica SENSOR_FRENO_P [TT10_C05_PC_15]
17 | 432 | TT10_R6M_BRAZO_SENSOR_N_INSERTADO | 1 | Brazo fijo de detector; unión soldada a pie sobre larguero [TT10_C05_PC_15]
17 | 433 | TT10_R6M_BRAZO_SENSOR_N_RETIRADO | 1 | Brazo fijo de detector; unión soldada a pie sobre larguero [TT10_C05_PC_15]
17 | 434 | TT10_R6M_BRAZO_SENSOR_P_INSERTADO | 1 | Brazo fijo de detector; unión soldada a pie sobre larguero [TT10_C05_PC_15]
17 | 435 | TT10_R6M_BRAZO_SENSOR_P_RETIRADO | 1 | Brazo fijo de detector; unión soldada a pie sobre larguero [TT10_C05_PC_15]
17 | 438 | TT10_R6M_IE5338_N_INSERTADO | 1 | ifmIE5338,M8x1L40,SN3mm;N INSERTADO [TT10_C05_PC_15]
17 | 439 | TT10_R6M_IE5338_N_RETIRADO | 1 | ifmIE5338,M8x1L40,SN3mm;N RETIRADO [TT10_C05_PC_15]
17 | 440 | TT10_R6M_IE5338_P_INSERTADO | 1 | ifmIE5338,M8x1L40,SN3mm;P INSERTADO [TT10_C05_PC_15]
17 | 441 | TT10_R6M_IE5338_P_RETIRADO | 1 | ifmIE5338,M8x1L40,SN3mm;P RETIRADO [TT10_C05_PC_15]
17 | 444 | TT10_R6M_PIE_SENSORES_N | 1 | Pie12 sobre cara superior del larguero; soldadura a3,20mm por ambas caras [TT10_C05_PC_15]
17 | 445 | TT10_R6M_PIE_SENSORES_P | 1 | Pie12 sobre cara superior del larguero; soldadura a3,20mm por ambas caras [TT10_C05_PC_15]
17 | 447 | TT10_R6M_SOP_SENSOR_N_INSERTADO | 1 | Escuadra6;taladroØ8.5 para sensorM8;frente de detección a1mm del blanco [TT10_C05_PC_15]

# Lista completa de piezas por paso

TT10 | C05 / modelo C06 | 25/10/2026 | Guía visual de fabricación y armado | 47
PASO | POS. | CÓDIGO | CANT. | DESCRIPCIÓN / PLANO
17 | 448 | TT10_R6M_SOP_SENSOR_N_RETIRADO | 1 | Escuadra6;taladroØ8.5 para sensorM8;frente de detección a1mm del blanco [TT10_C05_PC_15]
17 | 449 | TT10_R6M_SOP_SENSOR_P_INSERTADO | 1 | Escuadra6;taladroØ8.5 para sensorM8;frente de detección a1mm del blanco [TT10_C05_PC_15]
17 | 450 | TT10_R6M_SOP_SENSOR_P_RETIRADO | 1 | Escuadra6;taladroØ8.5 para sensorM8;frente de detección a1mm del blanco [TT10_C05_PC_15]
17 | 451 | TT10_SEN_B6_P0 | 4 | Tornillo ISO4762 M6x16 8.8, cabeza D10 H6, hexágono5; rosca nominal [TT10_C05_PC_15]
17 | 452 | TT10_SEN_P_IN | 4 | IFM IE5338 M8x1 L40, Sn3, NO PNP/NPN, 10-30VDC; incluye dos contratuercas [TT10_C05_PC_15]
17 | 453 | TT10_SEN_SOP_P | 2 | Soporte soldado desmontable: carril6x40x229 y pie4x40x16.5; dos M6x16; dos D8.5 [TT10_C05_PC_15]
18 | 40 | TT10_C04_BANCADA | 1 | Bancada215x200x20, sobre poste corto; soldaduraa3 [TT10_C05_PC_16]
18 | 41 | TT10_C04_CARTELA_0 | 1 | Cartela12,165x55, a3 continuo a placa y poste [TT10_C05_PC_16]
18 | 42 | TT10_C04_CARTELA_1 | 1 | Cartela12,165x55, a3 continuo a placa y poste [TT10_C05_PC_16]
18 | 79 | TT10_C04_TRAVESANO | 1 | RHS100x50x5,L230; une los dos postes del puesto manual, a3 [TT10_C05_PC_16]
18 | 80 | TT10_C05_ARANDELA_TENSOR_0 | 1 | Arandela puente44x21x4, endurecida, cubre ranura22 [TT10_C05_PC_16]
18 | 81 | TT10_C05_ARANDELA_TENSOR_1 | 1 | Arandela puente44x21x4, endurecida, cubre ranura22 [TT10_C05_PC_16]
18 | 82 | TT10_C05_ARANDELA_TENSOR_2 | 1 | Arandela puente44x21x4, endurecida, cubre ranura22 [TT10_C05_PC_16]
18 | 83 | TT10_C05_ARANDELA_TENSOR_3 | 1 | Arandela puente44x21x4, endurecida, cubre ranura22 [TT10_C05_PC_16]
18 | 84 | TT10_C05_B20_TENSOR_0 | 1 | Tornillo M20x45,ISO4017 8.8; geometria nominal [TT10_C05_PC_16]
18 | 85 | TT10_C05_B20_TENSOR_1 | 1 | Tornillo M20x45,ISO4017 8.8; geometria nominal [TT10_C05_PC_16]
18 | 86 | TT10_C05_B20_TENSOR_2 | 1 | Tornillo M20x45,ISO4017 8.8; geometria nominal [TT10_C05_PC_16]
18 | 87 | TT10_C05_B20_TENSOR_3 | 1 | Tornillo M20x45,ISO4017 8.8; geometria nominal [TT10_C05_PC_16]

# Lista completa de piezas por paso

TT10 | C05 / modelo C06 | 25/10/2026 | Guía visual de fabricación y armado | 48
PASO | POS. | CÓDIGO | CANT. | DESCRIPCIÓN / PLANO
18 | 92 | TT10_C05_BASE_FIJA_TENSOR | 1 | Base fija630x420x20; cuatro M20 roscados20;apriete100Nm;no son anclajes a losa [TT10_C05_PC_16]
18 | 127 | TT10_C05_CORREDERA_TENSOR | 1 | Corredera comun590x320x20;4ranuras22x62; carrera Y+/-20mm; ambos postes solidarios [TT10_C05_PC_16]
18 | 128 | TT10_C05_GUIA_TENSOR_0 | 1 | Guia lateral mecanizada;holgura transversal total0.3..0.5mm; soldar a base fija y mecanizar despues [TT10_C05_PC_16]
18 | 129 | TT10_C05_GUIA_TENSOR_1 | 1 | Guia lateral mecanizada;holgura transversal total0.3..0.5mm; soldar a base fija y mecanizar despues [TT10_C05_PC_16]
18 | 130 | TT10_C05_JACK_M16_0_0 | 1 | M16x80,8.8 de regulacion; rosca total; punta plana; bloquear con contratuerca [TT10_C05_PC_16]
18 | 131 | TT10_C05_JACK_M16_0_1 | 1 | M16x80,8.8 de regulacion; rosca total; punta plana; bloquear con contratuerca [TT10_C05_PC_16]
18 | 132 | TT10_C05_JACK_M16_1_0 | 1 | M16x80,8.8 de regulacion; rosca total; punta plana; bloquear con contratuerca [TT10_C05_PC_16]
18 | 133 | TT10_C05_JACK_M16_1_1 | 1 | M16x80,8.8 de regulacion; rosca total; punta plana; bloquear con contratuerca [TT10_C05_PC_16]
18 | 134 | TT10_C05_JAM_M16_0_0 | 1 | ContratuercaM16 clase8; mantener ajuste con cuatro M20 apretados [TT10_C05_PC_16]
18 | 135 | TT10_C05_JAM_M16_0_1 | 1 | ContratuercaM16 clase8; mantener ajuste con cuatro M20 apretados [TT10_C05_PC_16]
18 | 136 | TT10_C05_JAM_M16_1_0 | 1 | ContratuercaM16 clase8; mantener ajuste con cuatro M20 apretados [TT10_C05_PC_16]
18 | 137 | TT10_C05_JAM_M16_1_1 | 1 | ContratuercaM16 clase8; mantener ajuste con cuatro M20 apretados [TT10_C05_PC_16]
18 | 138 | TT10_C05_OREJA_TENSOR_0_0 | 1 | Oreja36x20x36;M16x2; soldaduraa6 a base fija [TT10_C05_PC_16]
18 | 139 | TT10_C05_OREJA_TENSOR_0_1 | 1 | Oreja36x20x36;M16x2; soldaduraa6 a base fija [TT10_C05_PC_16]
18 | 140 | TT10_C05_OREJA_TENSOR_1_0 | 1 | Oreja36x20x36;M16x2; soldaduraa6 a base fija [TT10_C05_PC_16]
18 | 141 | TT10_C05_OREJA_TENSOR_1_1 | 1 | Oreja36x20x36;M16x2; soldaduraa6 a base fija [TT10_C05_PC_16]
18 | 142 | TT10_C05_POSTE_CORTO_TENSOR | 1 | RHS50x50x5;L1037.5;recortado20para conservar altura del eje [TT10_C05_PC_16]
18 | 143 | TT10_C05_POSTE_VOLANTE_TENSOR | 1 | Poste del volante recortado20mm; conservar mecanizado superior y centros [TT10_C05_PC_16]

# Lista completa de piezas por paso

TT10 | C05 / modelo C06 | 25/10/2026 | Guía visual de fabricación y armado | 49
PASO | POS. | CÓDIGO | CANT. | DESCRIPCIÓN / PLANO
19 | 50 | TT10_C04_EJE_TIMON | 1 | Eje heredado con extremoX1026 y chavetero adicional8x7x30; Mayr conservado [TT10_C05_PC_17]
19 | 66 | TT10_C04_PLACA_TIMON | 1 | Placa de estacion existente con ventanaR57x25 para bridas110; apoyos yMayr conservados [TT10_C05_PC_17]
19 | 436 | TT10_R6M_CHAVETA_FRENO_TIMON | 1 | ChavetaDIN6885/1 8x7x25 C45E [TT10_C05_PC_17]
19 | 437 | TT10_R6M_CUBO_FRENO_TIMON | 1 | Cubo comercial simplificado: Ø30H7,8JS9;L25; verificar suministro con referencia mayr [TT10_C05_PC_17]
19 | 442 | TT10_R6M_MAYR_32 | 1 | mayr32/891.101.0/24/30/6885/1 JS9;64Nm; rotor metálico; liberación manual [TT10_C05_PC_17]
19 | 443 | TT10_R6M_PEDESTAL_FRENO | 1 | Travesaño108x40x10 entre caras interiores del poste existente; soldadura a3,40mm por extremo [TT10_C05_PC_17]
19 | 446 | TT10_R6M_PLACA_FRENO_TIMON | 1 | Placa12, caraX1127; centrado y3M6PCD132; sujeción a pedestal por cartelas [TT10_C05_PC_17]
19 | 462 | TT10_TM_ARANDELA16 | 1 | Arandela de retención D44/d17/t4 [TT10_C05_PC_17]
19 | 463 | TT10_TM_B12_0 | 1 | Tornillo M12x40 8.8, s18, rosca nominal; enganche20.5mm en placa [TT10_C05_PC_17]
19 | 464 | TT10_TM_B12_1 | 1 | Tornillo M12x40 8.8, s18, rosca nominal; enganche20.5mm en placa [TT10_C05_PC_17]
19 | 465 | TT10_TM_B12_2 | 1 | Tornillo M12x40 8.8, s18, rosca nominal; enganche20.5mm en placa [TT10_C05_PC_17]
19 | 466 | TT10_TM_B12_3 | 1 | Tornillo M12x40 8.8, s18, rosca nominal; enganche20.5mm en placa [TT10_C05_PC_17]
19 | 467 | TT10_TM_CHAVETA | 1 | Chaveta paralela8x7x40, extremos R4, formaA; acero C45E [TT10_C05_PC_17]
19 | 468 | TT10_TM_CUBO | 1 | Cubo D80/D30 H7 L45; chavetero8 JS9, profundidad3.3 sobre radio nominal [TT10_C05_PC_17]
19 | 469 | TT10_TM_EJE_PUNO | 1 | Perno escalonado: M8, hombro14, pistaD10 h9 L87.3 y cabeza16; pistaRa≤0.8 [TT10_C05_PC_17]
19 | 470 | TT10_TM_PUNO | 1 | Empuñadura giratoria POM D32/d10.4 L85 [TT10_C05_PC_17]
19 | 471 | TT10_TM_PUNO_N8 | 1 | Tuerca autoblocante metálica M8 h8 s13; geometría nominal [TT10_C05_PC_17]
19 | 472 | TT10_TM_PUNO_W0 | 1 | Arandela lisa D20/d10.5/t1 para empuñadura [TT10_C05_PC_17]

# Lista completa de piezas por paso

TT10 | C05 / modelo C06 | 25/10/2026 | Guía visual de fabricación y armado | 50
PASO | POS. | CÓDIGO | CANT. | DESCRIPCIÓN / PLANO
19 | 473 | TT10_TM_PUNO_W1 | 1 | Arandela lisa D20/d10.5/t1 para empuñadura [TT10_C05_PC_17]
19 | 474 | TT10_TM_PUNO_W8 | 1 | Arandela M8 D16/d8.4/t1.6 [TT10_C05_PC_17]
19 | 475 | TT10_TM_SY30_0 | 3 | SKF SY30TF, d30, H42.9, base152x40, pasos117.5; interfaces nominales [TT10_C05_PC_17]
19 | 476 | TT10_TM_SY30_1 | 1 | SKF SY30TF, d30, H42.9, base152x40, pasos117.5; interfaces nominales [TT10_C05_PC_17]
19 | 477 | TT10_TM_TORNILLO16 | 1 | Tornillo M16x35 clase8.8, s24; retiene axialmente rueda y cubo [TT10_C05_PC_17]
19 | 478 | TT10_TM_VOLANTE | 1 | Volante D500 t12, cuatro radios; D8.5 para empuñadura; soldado al cubo [TT10_C05_PC_17]
19 | 479 | TT10_TM_W12_0 | 1 | Arandela M12 D24/d13/t2.5 [TT10_C05_PC_17]
19 | 480 | TT10_TM_W12_1 | 1 | Arandela M12 D24/d13/t2.5 [TT10_C05_PC_17]
19 | 481 | TT10_TM_W12_2 | 1 | Arandela M12 D24/d13/t2.5 [TT10_C05_PC_17]
19 | 482 | TT10_TM_W12_3 | 1 | Arandela M12 D24/d13/t2.5 [TT10_C05_PC_17]
20 | 9 | TT10_C03_HK4020_E1 | 1 | SKF HK4020; 40x47x20; rodillos y jaula omitidos [TT10_C05_PC_20]
20 | 10 | TT10_C03_HK4020_E2 | 1 | SKF HK4020; 40x47x20; rodillos y jaula omitidos [TT10_C05_PC_20]
20 | 11 | TT10_C03_HK4020_M1 | 1 | SKF HK4020; 40x47x20; rodillos y jaula omitidos [TT10_C05_PC_20]
20 | 12 | TT10_C03_HK4020_M2 | 1 | SKF HK4020; 40x47x20; rodillos y jaula omitidos [TT10_C05_PC_20]
20 | 15 | TT10_C03_SELECTOR_6008_1 | 1 | SKF6008 40x68x15; contorno de interfaz [TT10_C05_PC_20]
20 | 16 | TT10_C03_SELECTOR_6008_2 | 1 | SKF6008 40x68x15; contorno de interfaz [TT10_C05_PC_20]
20 | 19 | TT10_C03_SELECTOR_CUBIERTA | 1 | Cubierta desmontable3; ranura50x36 para recorrido completo; cierreM6 por detallar [TT10_C05_PC_20]
20 | 23 | TT10_C03_SELECTOR_PARED_E | 1 | Pared mecanizada8; roscasM6; tapa de retencion y asiento axial por cadena de cotas [TT10_C05_PC_20]

# Lista completa de piezas por paso

TT10 | C05 / modelo C06 | 25/10/2026 | Guía visual de fabricación y armado | 51
PASO | POS. | CÓDIGO | CANT. | DESCRIPCIÓN / PLANO
20 | 24 | TT10_C03_SELECTOR_PARED_M | 1 | Pared mecanizada8; roscasM6; tapa de retencion y asiento axial por cadena de cotas [TT10_C05_PC_20]
20 | 26 | TT10_C03_TAPA_RETENCION_E | 1 | Tapa estacionaria: labio axial para cuboD100, pasoD92 libre al manguitoD90; junta axial0.2 por ajustar [TT10_C05_PC_20]
20 | 27 | TT10_C03_TAPA_RETENCION_M | 1 | Tapa estacionaria: labio axial para cuboD100, pasoD92 libre al manguitoD90; junta axial0.2 por ajustar [TT10_C05_PC_20]
20 | 35 | TT10_C04_B6008_M6_1_0 | 2 | M6x20 ISO7380-1,10.9; contorno nominal [TT10_C05_PC_20]
20 | 36 | TT10_C04_B6008_M6_1_2 | 1 | M6x20 ISO7380-1,10.9; contorno nominal [TT10_C05_PC_20]
20 | 37 | TT10_C04_B6008_M6_1_3 | 1 | M6x20 ISO7380-1,10.9; contorno nominal [TT10_C05_PC_20]
20 | 38 | TT10_C04_B6008_M6_2_0 | 2 | M6x20 ISO7380-1,10.9; contorno nominal [TT10_C05_PC_20]
20 | 39 | TT10_C04_B6008_M6_2_1 | 2 | M6x20 ISO7380-1,10.9; contorno nominal [TT10_C05_PC_20]
20 | 48 | TT10_C04_DIN471_40 | 1 | ComprarDIN471-40,1.75; contorno instalado simplificado, no fabricar [TT10_C05_PC_20]
20 | 52 | TT10_C04_ESPACIADOR6008 | 1 | Separador7 entre tapa izquierda y anillo exterior6008 [TT10_C05_PC_20]
20 | 65 | TT10_C04_PEDESTAL_SELECTOR | 1 | Pedestal con ventana46 para paso real de cadena/resguardo; soporte local por verificar [TT10_C05_PC_20]
20 | 67 | TT10_C04_SELECTOR_APOYO_1 | 1 | Asiento6008 abierto; montaje axial y4M6PCD84; no cavidad inaccesible [TT10_C05_PC_20]
20 | 68 | TT10_C04_SELECTOR_APOYO_2 | 1 | Asiento6008 abierto; montaje axial y4M6PCD84; no cavidad inaccesible [TT10_C05_PC_20]
20 | 69 | TT10_C04_SELECTOR_BASE | 1 | Soporte con ventana46mm para cadena y guarda; caras restantes transmiten apoyo [TT10_C05_PC_20]
20 | 72 | TT10_C04_SELECTOR_ESPACIADOR | 1 | Soporte con ventana46mm para cadena y guarda; caras restantes transmiten apoyo [TT10_C05_PC_20]
20 | 77 | TT10_C04_TAPA6008_1 | 1 | Tapa104x4, cabezas en cajera; desmontaje exterior [TT10_C05_PC_20]
20 | 78 | TT10_C04_TAPA6008_2 | 1 | Tapa104x4, cabezas en cajera; desmontaje exterior [TT10_C05_PC_20]
20 | 88 | TT10_C05_B4_RETEN_0_0 | 1 | M4x9,8.8; tornillo del puente cautivo; fijador desmontable [TT10_C05_PC_20]

# Lista completa de piezas por paso

TT10 | C05 / modelo C06 | 25/10/2026 | Guía visual de fabricación y armado | 52
PASO | POS. | CÓDIGO | CANT. | DESCRIPCIÓN / PLANO
20 | 89 | TT10_C05_B4_RETEN_0_1 | 1 | M4x9,8.8; tornillo del puente cautivo; fijador desmontable [TT10_C05_PC_20]
20 | 90 | TT10_C05_B4_RETEN_1_0 | 1 | M4x9,8.8; tornillo del puente cautivo; fijador desmontable [TT10_C05_PC_20]
20 | 91 | TT10_C05_B4_RETEN_1_1 | 1 | M4x9,8.8; tornillo del puente cautivo; fijador desmontable [TT10_C05_PC_20]
21 | 17 | TT10_C03_SELECTOR_COLLAR_1 | 1 | Collar de varilla para sujetar horquilla; fijacion radial y retencion por completar [TT10_C05_PC_21]
21 | 18 | TT10_C03_SELECTOR_COLLAR_2 | 1 | Collar de varilla para sujetar horquilla; fijacion radial y retencion por completar [TT10_C05_PC_21]
21 | 20 | TT10_C03_SELECTOR_ENCLAVAMIENTO | 1 | Pasador positivoD6; levantar16mm antes de seleccionar y reinsertar; retencion cautiva y mando remoto pendientes [TT10_C05_PC_21]
21 | 21 | TT10_C03_SELECTOR_HORQUILLA | 1 | Horquilla10 en ranura12; 1 mm nominal por flanco; garras de seleccion con la maquina parada [TT10_C05_PC_21]
21 | 22 | TT10_C03_SELECTOR_MANGUITO | 1 | Manguito estriado: neutro X923..979; E+18/M-18; 6 alojamientos D12.2 PCD72 por cara [TT10_C05_PC_21]
21 | 25 | TT10_C03_SELECTOR_VARILLA | 1 | Varilla selector D16; tres taladrosD6.5 con paso18; E-N-M por pasador positivo [TT10_C05_PC_21]
21 | 70 | TT10_C04_SELECTOR_CUBO_E | 1 | CuboE con extension; pasoD41 hastaX1062, socketD40H7 y chavetero12x35 [TT10_C05_PC_21]
21 | 71 | TT10_C04_SELECTOR_EJE | 1 | Eje D40h6; extremoX1060; ranuraDIN471D37.5x1.85 enX855.1 [TT10_C05_PC_21]
21 | 126 | TT10_C05_BLOQUE_SELECTOR | 1 | BloqueC03 conservado con4M4laterales para retencion cautiva [TT10_C05_PC_21]
21 | 144 | TT10_C05_RETEN_CAUTIVO_SELECTOR | 1 | Puente cautivo para pasadorD6;23mm hasta cabeza, permite levantar16mm;4M4 laterales al bloque [TT10_C05_PC_21]
21 | 192 | TT10_D_PALANCA_SELECTOR | 1 | Selector E-0-M a altura accesible; transmisión por varilla [TT10_C05_PC_26]
21 | 206 | TT10_D_POSTE_MANDO | 1 | Soporte del mando manual fuera del plano del volante [TT10_C05_PC_26]
21 | 212 | TT10_D_ROD_SELECTOR | 1 | Eje de conexión geométrica ROD_SELECTOR [TT10_C05_PC_26]
22 | 93 | TT10_C05_BDNB_28_23 | 1 | Warner BDNB 28.23Nm, brida lado entrada, exterior reconstruido según MCC-P-1310 03/25 p69; cotas nominales medias [TT10_C05_PC_22]
22 | 94 | TT10_C05_BDNB_APOYO_0_INFERIOR | 1 | Apoyo partido6006, asientoH7, tapa2M6x60, roscasM6 cuerpo; soldaduraa4 base [TT10_C05_PC_22]

# Lista completa de piezas por paso

TT10 | C05 / modelo C06 | 25/10/2026 | Guía visual de fabricación y armado | 53
PASO | POS. | CÓDIGO | CANT. | DESCRIPCIÓN / PLANO
22 | 95 | TT10_C05_BDNB_APOYO_0_TAPA | 1 | Apoyo partido6006, asientoH7, tapa2M6x60, roscasM6 cuerpo; soldaduraa4 base [TT10_C05_PC_22]
22 | 96 | TT10_C05_BDNB_APOYO_1_INFERIOR | 1 | Apoyo partido6006, asientoH7, tapa2M6x60, roscasM6 cuerpo; soldaduraa4 base [TT10_C05_PC_22]
22 | 97 | TT10_C05_BDNB_APOYO_1_TAPA | 1 | Apoyo partido6006, asientoH7, tapa2M6x60, roscasM6 cuerpo; soldaduraa4 base [TT10_C05_PC_22]
22 | 98 | TT10_C05_BDNB_APOYO_2_INFERIOR | 1 | Apoyo partido6906, asientoH7, tapa2M6x60, roscasM6 cuerpo; soldaduraa4 base [TT10_C05_PC_22]
22 | 99 | TT10_C05_BDNB_APOYO_2_TAPA | 1 | Apoyo partido6906, asientoH7, tapa2M6x60, roscasM6 cuerpo; soldaduraa4 base [TT10_C05_PC_22]
22 | 100 | TT10_C05_BDNB_APOYO_3_INFERIOR | 1 | Apoyo partido6906, asientoH7, tapa2M6x60, roscasM6 cuerpo; soldaduraa4 base [TT10_C05_PC_22]
22 | 101 | TT10_C05_BDNB_APOYO_3_TAPA | 1 | Apoyo partido6906, asientoH7, tapa2M6x60, roscasM6 cuerpo; soldaduraa4 base [TT10_C05_PC_22]
22 | 102 | TT10_C05_BDNB_BASE | 1 | Base16 con ventana cadena,4pasos11;4M10x35 en placa existente roscadaM10 [TT10_C05_PC_22]
22 | 103 | TT10_C05_BDNB_CHAVETA_ENTRADA | 1 | ChavetaDIN6885A8x7, longitud según código [TT10_C05_PC_22]
22 | 104 | TT10_C05_BDNB_CHAVETA_SALIDA | 1 | ChavetaDIN6885A8x7, longitud según código [TT10_C05_PC_22]
22 | 105 | TT10_C05_BDNB_CORONA_20D | 1 | Mädler10888120: interfaz modificada30H7/8JS9; dentado visual simplificado [TT10_C05_PC_22]
22 | 106 | TT10_C05_BDNB_CUBO_SELECTOR | 1 | Cubo manual con corona integral z48,m2.5,20 grados; asiento47 y garras conservadas [TT10_C05_PC_23]
22 | 107 | TT10_C05_BDNB_EJE_ENTRADA | 1 | Eje30h6; socket12.73; chaveta8x7; taladro transversal4.825 [TT10_C05_PC_23]
22 | 108 | TT10_C05_BDNB_EJE_SALIDA | 1 | Eje30h6, espiga12.70; dos6906; chaveta8x7; unión positiva3/16 [TT10_C05_PC_23]
22 | 109 | TT10_C05_BDNB_ENGRANAJE | 1 | Engranaje48d,m2.5,20grados,b20;30H7,8JS9 [TT10_C05_PC_23]
22 | 110 | TT10_C05_BDNB_M10 | 4 | TornilloISO4017 M10x35-8.8; rosca nominal [TT10_C05_PC_22]
22 | 111 | TT10_C05_BDNB_M5 | 4 | ISO4017 M5x20-8.8, rosca nominal [TT10_C05_PC_22]
22 | 112 | TT10_C05_BDNB_M6 | 8 | TornilloISO4017 M6x60-8.8; rosca nominal [TT10_C05_PC_22]

# Lista completa de piezas por paso

TT10 | C05 / modelo C06 | 25/10/2026 | Guía visual de fabricación y armado | 54
PASO | POS. | CÓDIGO | CANT. | DESCRIPCIÓN / PLANO
22 | 113 | TT10_C05_BDNB_N3_ENTRADA | 1 | TuercaISO7042 M3 autoblocante metálica, rosca nominal [TT10_C05_PC_22]
22 | 114 | TT10_C05_BDNB_N3_SALIDA | 1 | TuercaISO7042 M3 autoblocante metálica, rosca nominal [TT10_C05_PC_22]
22 | 115 | TT10_C05_BDNB_N5 | 4 | TuercaISO4032 M5-8; rosca nominal [TT10_C05_PC_22]
22 | 116 | TT10_C05_BDNB_PASADOR_ENTRADA | 1 | Pasador transversal3/16, cabeza7, puntaM3x5; C45E bonificado, Rp0.2 minimo650MPa [TT10_C05_PC_23]
22 | 117 | TT10_C05_BDNB_PASADOR_SALIDA | 1 | Pasador transversal3/16, cabeza7, puntaM3x5; C45E bonificado, Rp0.2 minimo650MPa [TT10_C05_PC_23]
22 | 118 | TT10_C05_BDNB_PLACA_REACCION | 1 | Reacción BDNB8mm,4Ø5.5PCD53.85; soldaduraa4 ambos lados a base [TT10_C05_PC_22]
22 | 119 | TT10_C05_BDNB_RODAMIENTO_0 | 1 | RodamientoSKF6006; envolvente de montaje; selección de vida separada [TT10_C05_PC_22]
22 | 120 | TT10_C05_BDNB_RODAMIENTO_1 | 1 | RodamientoSKF6006; envolvente de montaje; selección de vida separada [TT10_C05_PC_22]
22 | 121 | TT10_C05_BDNB_RODAMIENTO_2 | 1 | RodamientoSKF6906; envolvente de montaje; selección de vida separada [TT10_C05_PC_22]
22 | 122 | TT10_C05_BDNB_RODAMIENTO_3 | 1 | RodamientoSKF6906; envolvente de montaje; selección de vida separada [TT10_C05_PC_22]
22 | 123 | TT10_C05_BDNB_W10 | 4 | ArandelaISO7089 M10 [TT10_C05_PC_22]
22 | 124 | TT10_C05_BDNB_W5 | 4 | ArandelaDIN433 M5,9x5.3x1 [TT10_C05_PC_22]
22 | 125 | TT10_C05_BDNB_W6 | 8 | ArandelaISO7089 M6 [TT10_C05_PC_22]
23 | 8 | TT10_C03_CADENA_ESLABON | 122 | Renold16B1: referencia visual de eslabon; no fabricar. Rodillos compartidos representados dos veces [TT10_C05_PC_18]
23 | 28 | TT10_C04_ACOPLE_0 | 1 | Brida110x8,PCD82/6M8; bore30H7; asiento25, desmontaje axial [TT10_C05_PC_18]
23 | 29 | TT10_C04_ACOPLE_1 | 1 | Brida110x8,PCD82/6M8; bore30H7; asiento30, desmontaje axial [TT10_C05_PC_18]
23 | 30 | TT10_C04_ACOPLE_B8_0 | 4 | M8x25,8.8; cabeza exterior; apriete por plano [TT10_C05_PC_18]
23 | 31 | TT10_C04_ACOPLE_B8_4 | 2 | M8x25,8.8; cabeza exterior; apriete por plano [TT10_C05_PC_18]

# Lista completa de piezas por paso

TT10 | C05 / modelo C06 | 25/10/2026 | Guía visual de fabricación y armado | 55
PASO | POS. | CÓDIGO | CANT. | DESCRIPCIÓN / PLANO
23 | 32 | TT10_C04_ACOPLE_N8_0 | 4 | TuercaM8 clase8, autoblocante nominal [TT10_C05_PC_18]
23 | 33 | TT10_C04_ACOPLE_N8_2 | 2 | TuercaM8 clase8, autoblocante nominal [TT10_C05_PC_18]
23 | 34 | TT10_C04_ASIENTO_CHUMACERAS | 1 | Bloque90x180x52.1; cara superior mecanizada y4M12 ciegas28 [TT10_C05_PC_18]
23 | 43 | TT10_C04_CHAVETA_ACOPLE_0 | 1 | Chaveta8x7x25 [TT10_C05_PC_18]
23 | 44 | TT10_C04_CHAVETA_ACOPLE_1 | 1 | Chaveta8x7x30 [TT10_C05_PC_18]
23 | 45 | TT10_C04_CHAVETA_CORONA | 1 | Chaveta8x7x40 de corona [TT10_C05_PC_18]
23 | 47 | TT10_C04_CORONA_20D | 1 | Corona10888120; bore30H7 y chavetero8JS9 abierto al bore en todo su ancho; dentado comprado simplificado [TT10_C05_PC_18]
23 | 49 | TT10_C04_EJE_MANUAL | 1 | EjeD30h7,L184; chaveteros8x7, t1=4, extremos planos [TT10_C05_PC_18]
23 | 53 | TT10_C04_GUARDA_ANCLA6_4470 | 1 | M6x16,8.8 a bancada; no anclaje a losa [TT10_C05_PC_18]
23 | 54 | TT10_C04_GUARDA_ANCLA6_4630 | 1 | M6x16,8.8 a bancada; no anclaje a losa [TT10_C05_PC_18]
23 | 55 | TT10_C04_GUARDA_B6_0 | 4 | M6x50,8.8 para tapa frontal [TT10_C05_PC_18]
23 | 57 | TT10_C04_GUARDA_BASEW6_4470 | 1 | Arandela6,12x6.6x2 [TT10_C05_PC_18]
23 | 58 | TT10_C04_GUARDA_BASEW6_4630 | 1 | Arandela6,12x6.6x2 [TT10_C05_PC_18]
23 | 60 | TT10_C04_GUARDA_N6_0 | 3 | TuercaM6 autoblocante metalica; contorno nominal [TT10_C05_PC_18]
23 | 61 | TT10_C04_GUARDA_N6_2 | 1 | TuercaM6 autoblocante metalica; contorno nominal [TT10_C05_PC_18]
23 | 63 | TT10_C04_GUARDA_W6_0 | 3 | ArandelaM6,12x6.6x1.6 [TT10_C05_PC_18]
23 | 64 | TT10_C04_GUARDA_W6_2 | 1 | ArandelaM6,12x6.6x1.6 [TT10_C05_PC_18]
23 | 73 | TT10_C04_SY30_B12_930_4491.25 | 2 | M12x45,8.8;25.5mm nominales de rosca util [TT10_C05_PC_18]

# Lista completa de piezas por paso

TT10 | C05 / modelo C06 | 25/10/2026 | Guía visual de fabricación y armado | 56
PASO | POS. | CÓDIGO | CANT. | DESCRIPCIÓN / PLANO
23 | 74 | TT10_C04_SY30_B12_972_4491.25 | 2 | M12x45,8.8;25.5mm nominales de rosca util [TT10_C05_PC_18]
23 | 75 | TT10_C04_SY30_W12_930_4491.25 | 2 | ArandelaM12,24x13x2.5 [TT10_C05_PC_18]
23 | 76 | TT10_C04_SY30_W12_930_4608.75 | 2 | ArandelaM12,24x13x2.5 [TT10_C05_PC_18]
24 | 56 | TT10_C04_GUARDA_BANDA | 1 | Banda2, ancho36; tapa inferior; soldar a posterior, frontal desmontable [TT10_C05_PC_19]
24 | 59 | TT10_C04_GUARDA_FRONTAL | 1 | Chapa2; contorno de cadena; inferiorZ1107; paso superior/FRONTAL [TT10_C05_PC_19]
24 | 62 | TT10_C04_GUARDA_POSTERIOR | 1 | Chapa2; contorno de cadena; inferiorZ1107; paso superior/POSTERIOR [TT10_C05_PC_19]
25 | 6 | TT10_C03_ACCESO_PUERTO_N | 1 | Guia de herramienta desde exterior N; puerto nominal rear+15.5/Z+53.7; NO conexion remota al actuador [TT10_C05_PC_24]
25 | 7 | TT10_C03_ACCESO_PUERTO_P | 1 | Guia de herramienta desde exterior P; puerto nominal rear+15.5/Z+53.7; NO conexion remota al actuador [TT10_C05_PC_24]
25 | 13 | TT10_C03_REGISTRO_PUERTO_N | 1 | Registro exterior desmontable3 con accesoD50; fijaciones/proteccion de puesto por completar [TT10_C05_PC_24]
25 | 14 | TT10_C03_REGISTRO_PUERTO_P | 1 | Registro exterior desmontable3 con accesoD50; fijaciones/proteccion de puesto por completar [TT10_C05_PC_24]
25 | 152 | TT10_D_ARMARIO | 1 | Armario de variador y control; representación de presentación [TT10_C05_PC_25]
25 | 157 | TT10_D_BASE_ARMARIO | 1 | Base del armario [TT10_C05_PC_25]
25 | 158 | TT10_D_BASE_BOTONERA | 1 | Base de botonera [TT10_C05_PC_25]
25 | 162 | TT10_D_BASE_PRESENTE | 1 | Base del mando de hombre presente [TT10_C05_PC_25]
25 | 163 | TT10_D_BASE_RECUP_N | 1 | Base de mando de recuperación [TT10_C05_PC_24]
25 | 164 | TT10_D_BASE_RECUP_P | 1 | Base de mando de recuperación [TT10_C05_PC_24]
25 | 166 | TT10_D_BOTONERA | 1 | Botonera: subir, bajar, retorno y paro de emergencia [TT10_C05_PC_25]
25 | 167 | TT10_D_BOTON_0 | 1 | Pulsador 0 [TT10_C05_PC_01]

# Lista completa de piezas por paso

TT10 | C05 / modelo C06 | 25/10/2026 | Guía visual de fabricación y armado | 57
PASO | POS. | CÓDIGO | CANT. | DESCRIPCIÓN / PLANO
25 | 168 | TT10_D_BOTON_1 | 1 | Pulsador 1 [TT10_C05_PC_01]
25 | 169 | TT10_D_BOTON_2 | 1 | Pulsador 2 [TT10_C05_PC_01]
25 | 176 | TT10_D_CABLE_PRESENTE | 1 | Eje de conexión geométrica CABLE_PRESENTE [TT10_C05_PC_25]
25 | 188 | TT10_D_MANDO_PRESENTE | 1 | Palanca de hombre presente para liberación manual nominal [TT10_C05_PC_25]
25 | 202 | TT10_D_POSTE_ARMARIO | 1 | Soporte de armario [TT10_C05_PC_25]
25 | 203 | TT10_D_POSTE_BOTONERA | 1 | Poste de botonera fuera del plano de giro [TT10_C05_PC_25]
25 | 207 | TT10_D_POSTE_RECUP_N | 1 | Soporte de manivela y desbloqueo manual N [TT10_C05_PC_24]
25 | 208 | TT10_D_POSTE_RECUP_P | 1 | Soporte de manivela y desbloqueo manual P [TT10_C05_PC_24]
25 | 390 | TT10_PE_ACT_CUERPO | 2 | Thomson HD24B026-0250LPS2MMSD: interfaces nominales y envolvente conservadora, NO CAD oficial [TT10_C05_PC_24]
