acevedocrisologopablo48-lgtm/sesuveca-tolva-p04/dist/documentos/VERIFICACION_WEB_R03.html

← Volver al visor R03

# Verificación geométrica y de movimiento · R03

29/10/2026 · 2.174 componentes · 473 geometrías

Resultado: canaleta con interferencias confirmadas. La actualización web está sincronizada con el CAD guardado, pero el conjunto no queda declarado libre de interferencias ni liberado para fabricación.

## Qué se comprobó

- Coincidencia de las tres posiciones nativas: error máximo de vértices 5.08e-13 mm, inferior a 0,001 mm.
- Giro de tolva de 0° a 70° cada 0,5° y fases de la secuencia cada 0,125 s: 231 muestras y 24,294 pruebas de superficies tras descarte por cajas envolventes.
- No aparecen cruces de superficies entre la tolva giratoria y las fajas, plataforma o accionamiento en las muestras. Los contactos registrados de la tolva son con sus apoyos y bloqueos fijos.
- La comprobación volumétrica previa del accionamiento examinó 69 componentes: cero solapes mayores de 1 mm³. Su alcance es distinto de esta revisión de la canaleta.
- La cota mínima continua de la tolva sobre el piso es 127,57 mm según el cálculo R03. No se interpreta la caja rectangular envolvente como superficie del equipo.

## Incidencias confirmadas en sólidos

Intersección volumétrica OCP de operaciones de extrusión originales, colocadas con las transformaciones extraídas de SolidWorks. Umbral: 1 mm³. GIRO_35_R03 corresponde a la canaleta abatida 120°; comparte esa disposición con GIRO_70_R03. Los 7 resultados positivos de esta tabla son ejemplos comprobados, no el total exhaustivo de penetraciones.

Configuración | Pieza A | Pieza B | Volumen común mm³ | Resultado
PLANTA_COMPLETA_R03 | canaleta/R02_CANALETA_FONDO_e4_MOD1103p75-1 | canaleta/R02_BISAGRA_OREJA_100x130_e10_D25-3 | 4315.83 | Penetración confirmada
PLANTA_COMPLETA_R03 | canaleta/R02_BISAGRA_OREJA_100x130_e10_D25-1 | canaleta/R02_RHS_40x40x3_L205-1 | 6600.00 | Penetración confirmada
PLANTA_COMPLETA_R03 | canaleta/R02_BANDERA_SENSOR_30x20x3-1 | canaleta/R02_SENSOR_POSICION_40x25x15_REPR-1 | 0.00 | Sin volumen común en esta posición
PLANTA_COMPLETA_R03 | canaleta/R02_CIERRE_POSITIVO_OREJA_e10_D18-1 | canaleta/R02_CIERRE_POSITIVO_OREJA_e10_D18-3 | 0.00 | Sin volumen común en esta posición
PLANTA_COMPLETA_R03 | canaleta/R02_CANALETA_FONDO_e4_MOD1103p75-1 | canaleta/R02_RHS_40x40x3_L205-1 | 1932.86 | Penetración confirmada
GIRO_35_R03 | canaleta/R02_CANALETA_FONDO_e4_MOD1103p75-1 | canaleta/R02_BISAGRA_OREJA_100x130_e10_D25-3 | 25.34 | Penetración confirmada
GIRO_35_R03 | canaleta/R02_BISAGRA_OREJA_100x130_e10_D25-1 | canaleta/R02_RHS_40x40x3_L205-1 | 957.51 | Penetración confirmada
GIRO_35_R03 | canaleta/R02_BANDERA_SENSOR_30x20x3-1 | canaleta/R02_SENSOR_POSICION_40x25x15_REPR-1 | 600.00 | Penetración confirmada
GIRO_35_R03 | canaleta/R02_CIERRE_POSITIVO_OREJA_e10_D18-1 | canaleta/R02_CIERRE_POSITIVO_OREJA_e10_D18-3 | 3696.19 | Penetración confirmada
GIRO_35_R03 | canaleta/R02_CANALETA_FONDO_e4_MOD1103p75-1 | canaleta/R02_RHS_40x40x3_L205-1 | 0.00 | Sin volumen común en esta posición

## Conexiones y secuencia

Se conservaron todas las transformaciones del CAD. La cuba y la canaleta giran como conjuntos rígidos alrededor de sus respectivos ejes Y; los pasadores siguen sus ejes de traslación. El ciclo visual primero libera los bloqueos, retira la canaleta, muestra el giro y el retorno y repone los bloqueos.

La extracción intermedia de 60 mm de los pasadores cautivos de canaleta es una hipótesis visual. Los actuadores y su retención aún no están definidos. Las carcasas y las representaciones comerciales permanecen estáticas; los dientes, las pistas y los elementos internos no se simulan. Por tanto, esta revisión no demuestra la ausencia de todas las desconexiones mecánicas.

## Alcance y pendientes concretos

- Corregir en el CAD las zonas de bisagras, apoyos, fondo, cierre y sensor de canaleta identificadas en la tabla; revisar también sus contactos con la faja horizontal.
- Repetir el barrido tras esas correcciones y completar la comprobación de uniones mecánicas reales.
- Conservar las condiciones de aceptación del freno y detalles de fabricación indicados en la memoria R03.
- La prueba de superficies por muestras no excluye contención ni contactos entre muestras. No representa deformaciones, dinámica de 10 t ni flujo de carbón.
- La lógica del visor se prueba sin GPU; no se realizó inspección visual en navegador porque su control está deshabilitado.

Ver los 127 pares con contacto de superficies

Incluye contactos nominales. Un par de esta lista no equivale por sí solo a penetración volumétrica.

Pieza A | Pieza B | Primera muestra detectada
tolva_movil/C05E_TT10_COLLAR_P-1 | tolva_fija/C05E_TT10_22240_P-1 | giro 0°
tolva_movil/C05E_TT10_COLLAR_P-1 | tolva_fija/C05E_TT10_TNF_P2-1 | giro 0°
tolva_movil/C05E_TT10_COLLAR_N-1 | tolva_fija/C05E_TT10_22240_N-1 | giro 0°
tolva_movil/C05E_TT10_COLLAR_N-1 | tolva_fija/C05E_TT10_TNF_N1-1 | giro 0°
tolva_movil/C05E_TT10_M086-1 | tolva_fija/C05E_TT10_22240_N-1 | giro 0°
tolva_movil/C05E_TT10_M086-1 | tolva_fija/C05E_TT10_TNF_N2-1 | giro 0°
tolva_movil/R03_MUNON_P_D200_EXTENDIDO-1 | tolva_fija/C05E_TT10_22240_P-1 | giro 0°
tolva_movil/R03_MUNON_P_D200_EXTENDIDO-1 | tolva_fija/C05E_TT10_TNF_P1-1 | giro 0°
canaleta/R02_BISAGRA_OREJA_100x130_e10_D25-1 | canaleta/R02_RHS_40x40x3_L205-1 | giro 0°
canaleta/R02_CANALETA_FONDO_e4_MOD1103p75-1 | canaleta/R02_BISAGRA_OREJA_100x130_e10_D25-3 | giro 0°
canaleta/R02_CANALETA_FONDO_e4_MOD1103p75-1 | canaleta/R02_BISAGRA_OREJA_100x130_e10_D25-2 | giro 0°
canaleta/R02_CANALETA_FONDO_e4_MOD1103p75-1 | canaleta/R02_BISAGRA_OREJA_100x130_e10_D25-6 | giro 0°
canaleta/R02_CANALETA_FONDO_e4_MOD1103p75-1 | canaleta/R02_BISAGRA_OREJA_100x130_e10_D25-5 | giro 0°
canaleta/R02_PASADOR_CAUTIVO_M16_L70-1 | canaleta/R02_CIERRE_POSITIVO_OREJA_e10_D18-3 | giro 0°
canaleta/R02_PASADOR_CAUTIVO_M16_L70-1 | canaleta/R02_SENSOR_POSICION_40x25x15_REPR-1 | giro 0°
canaleta/R02_BANDERA_SENSOR_30x20x3-1 | canaleta/R02_CIERRE_POSITIVO_OREJA_e10_D18-3 | giro 0°
canaleta/R02_BANDERA_SENSOR_30x20x3-1 | canaleta/R02_SENSOR_POSICION_40x25x15_REPR-1 | giro 0°
canaleta/R02_CIERRE_POSITIVO_OREJA_e10_D18-1 | canaleta/R02_CIERRE_POSITIVO_OREJA_e10_D18-3 | giro 0°
canaleta/R02_BISAGRA_OREJA_100x130_e10_D25-4 | canaleta/R02_RHS_40x40x3_L205-2 | giro 0°
canaleta/R02_BISAGRA_OREJA_100x130_e10_D25-10 | canaleta/R02_RHS_40x40x3_L205-4 | giro 0°
canaleta/R02_CANALETA_FONDO_e4_MOD1103p75-2 | canaleta/R02_BISAGRA_OREJA_100x130_e10_D25-12 | giro 0°
canaleta/R02_CANALETA_FONDO_e4_MOD1103p75-2 | canaleta/R02_BISAGRA_OREJA_100x130_e10_D25-9 | giro 0°
canaleta/R02_CANALETA_FONDO_e4_MOD1103p75-2 | canaleta/R02_BISAGRA_OREJA_100x130_e10_D25-8 | giro 0°
canaleta/R02_CANALETA_FONDO_e4_MOD1103p75-2 | canaleta/R02_BISAGRA_OREJA_100x130_e10_D25-11 | giro 0°
canaleta/R02_BISAGRA_OREJA_100x130_e10_D25-7 | canaleta/R02_RHS_40x40x3_L205-3 | giro 0°
canaleta/R02_CIERRE_POSITIVO_OREJA_e10_D18-4 | canaleta/R02_CIERRE_POSITIVO_OREJA_e10_D18-6 | giro 0°
canaleta/R02_PASADOR_CAUTIVO_M16_L70-2 | canaleta/R02_CIERRE_POSITIVO_OREJA_e10_D18-6 | giro 0°
canaleta/R02_PASADOR_CAUTIVO_M16_L70-2 | canaleta/R02_SENSOR_POSICION_40x25x15_REPR-2 | giro 0°
canaleta/R02_BANDERA_SENSOR_30x20x3-2 | canaleta/R02_CIERRE_POSITIVO_OREJA_e10_D18-6 | giro 0°
canaleta/R02_BANDERA_SENSOR_30x20x3-2 | canaleta/R02_SENSOR_POSICION_40x25x15_REPR-2 | giro 0°
canaleta/R02_CANALETA_FONDO_e4_MOD1103p75-3 | canaleta/R02_BISAGRA_OREJA_100x130_e10_D25-14 | giro 0°
canaleta/R02_CANALETA_FONDO_e4_MOD1103p75-3 | canaleta/R02_BISAGRA_OREJA_100x130_e10_D25-15 | giro 0°
canaleta/R02_CANALETA_FONDO_e4_MOD1103p75-3 | canaleta/R02_BISAGRA_OREJA_100x130_e10_D25-18 | giro 0°
canaleta/R02_CANALETA_FONDO_e4_MOD1103p75-3 | canaleta/R02_BISAGRA_OREJA_100x130_e10_D25-17 | giro 0°
canaleta/R02_BISAGRA_OREJA_100x130_e10_D25-13 | canaleta/R02_RHS_40x40x3_L205-5 | giro 0°
canaleta/R02_BISAGRA_OREJA_100x130_e10_D25-16 | canaleta/R02_RHS_40x40x3_L205-6 | giro 0°
canaleta/R02_CIERRE_POSITIVO_OREJA_e10_D18-7 | canaleta/R02_CIERRE_POSITIVO_OREJA_e10_D18-9 | giro 0°
canaleta/R02_CIERRE_POSITIVO_OREJA_e10_D18-7 | canaleta/R02_TOPE_0_120_60x60x10-6 | giro 0°
canaleta/R02_PASADOR_CAUTIVO_M16_L70-3 | canaleta/R02_CIERRE_POSITIVO_OREJA_e10_D18-9 | giro 0°
canaleta/R02_PASADOR_CAUTIVO_M16_L70-3 | canaleta/R02_SENSOR_POSICION_40x25x15_REPR-3 | giro 0°
canaleta/R02_BANDERA_SENSOR_30x20x3-3 | canaleta/R02_CIERRE_POSITIVO_OREJA_e10_D18-9 | giro 0°
canaleta/R02_BANDERA_SENSOR_30x20x3-3 | canaleta/R02_SENSOR_POSICION_40x25x15_REPR-3 | giro 0°
canaleta/R02_BISAGRA_OREJA_100x130_e10_D25-19 | canaleta/R02_RHS_40x40x3_L205-7 | giro 0°
canaleta/R02_CANALETA_FONDO_e4_MOD1103p75-4 | canaleta/R02_BISAGRA_OREJA_100x130_e10_D25-21 | giro 0°
canaleta/R02_CANALETA_FONDO_e4_MOD1103p75-4 | canaleta/R02_BISAGRA_OREJA_100x130_e10_D25-20 | giro 0°
canaleta/R02_CANALETA_FONDO_e4_MOD1103p75-4 | canaleta/R02_BISAGRA_OREJA_100x130_e10_D25-24 | giro 0°
canaleta/R02_CANALETA_FONDO_e4_MOD1103p75-4 | canaleta/R02_BISAGRA_OREJA_100x130_e10_D25-23 | giro 0°
canaleta/R02_BISAGRA_OREJA_100x130_e10_D25-22 | canaleta/R02_RHS_40x40x3_L205-8 | giro 0°
canaleta/R02_CIERRE_POSITIVO_OREJA_e10_D18-10 | canaleta/R02_CIERRE_POSITIVO_OREJA_e10_D18-12 | giro 0°
canaleta/R02_CIERRE_POSITIVO_OREJA_e10_D18-10 | canaleta/R02_TOPE_0_120_60x60x10-8 | giro 0°
canaleta/R02_PASADOR_CAUTIVO_M16_L70-4 | canaleta/R02_CIERRE_POSITIVO_OREJA_e10_D18-12 | giro 0°
canaleta/R02_PASADOR_CAUTIVO_M16_L70-4 | canaleta/R02_SENSOR_POSICION_40x25x15_REPR-4 | giro 0°
canaleta/R02_BANDERA_SENSOR_30x20x3-4 | canaleta/R02_CIERRE_POSITIVO_OREJA_e10_D18-12 | giro 0°
canaleta/R02_BANDERA_SENSOR_30x20x3-4 | canaleta/R02_SENSOR_POSICION_40x25x15_REPR-4 | giro 0°
tolva_movil/C05E_TT10_M151-1 | tolva_fija/C05E_TT10_F596-1 | giro 70°
tolva_movil/C05E_TT10_M121-1 | tolva_fija/C05E_TT10_F426-1 | giro 70°
tolva_movil/C05E_TT10_M276-1 | tolva_fija/C05E_TT10_PE_PIN-1 | secuencia 0s
tolva_movil/C05E_TT10_M351-1 | tolva_fija/C05E_TT10_PE_PIN-2 | secuencia 0s
canaleta/R02_BISAGRA_OREJA_100x130_e10_D25-1 | horizontal/SUPERIOR_D76p2_F200p00_G12p50_PL17p8_REV_K_LOCAL_S-9 | secuencia 0s
canaleta/R02_BISAGRA_OREJA_100x130_e10_D25-1 | horizontal/SOPORTE_ARTESA_EMPERNADO_W750p00_F200p00_REV_K_LOCAL_S-7 | secuencia 0s
canaleta/R02_CANALETA_LATERAL_e4_H80-1 | horizontal/SUPERIOR_D76p2_F200p00_G12p50_PL17p8_REV_K_LOCAL_S-9 | secuencia 0s
canaleta/R02_CANALETA_FONDO_e4_MOD1103p75-1 | canaleta/R02_TOPE_0_120_60x60x10-2 | secuencia 0s
canaleta/R02_CANALETA_FONDO_e4_MOD1103p75-1 | canaleta/R02_SENSOR_POSICION_40x25x15_REPR-1 | secuencia 0s
canaleta/R02_CANALETA_FONDO_e4_MOD1103p75-1 | canaleta/R02_RHS_40x40x3_L205-1 | secuencia 0s
canaleta/R02_CANALETA_FONDO_e4_MOD1103p75-1 | canaleta/R02_RHS_40x40x3_L205-2 | secuencia 0s
canaleta/R02_CANALETA_FONDO_e4_MOD1103p75-1 | horizontal/SUPERIOR_D76p2_F200p00_G12p50_PL17p8_REV_K_LOCAL_S-9 | secuencia 0s
canaleta/R02_CANALETA_FONDO_e4_MOD1103p75-1 | horizontal/SOPORTE_ARTESA_EMPERNADO_W750p00_F200p00_REV_K_LOCAL_S-6 | secuencia 0s
canaleta/R02_CANALETA_FONDO_e4_MOD1103p75-1 | horizontal/SOPORTE_ARTESA_EMPERNADO_W750p00_F200p00_REV_K_LOCAL_S-7 | secuencia 0s
canaleta/R02_CANALETA_FONDO_e4_MOD1103p75-1 | horizontal/SOPORTE_ARTESA_EMPERNADO_W750p00_F200p00_REV_K_LOCAL_S-8 | secuencia 0s
canaleta/R02_CANALETA_FONDO_e4_MOD1103p75-1 | horizontal/SUPERIOR_D76p2_F200p00_G12p50_PL17p8_REV_K_LOCAL_S-19 | secuencia 0s
canaleta/R02_CANALETA_FONDO_e4_MOD1103p75-1 | horizontal/SUPERIOR_D76p2_F200p00_G12p50_PL17p8_REV_K_LOCAL_S-23 | secuencia 0s
canaleta/R02_PASADOR_CAUTIVO_M16_L70-1 | canaleta/R02_CIERRE_POSITIVO_OREJA_e10_D18-2 | secuencia 0s
canaleta/R02_CIERRE_POSITIVO_OREJA_e10_D18-1 | canaleta/R02_TOPE_0_120_60x60x10-1 | secuencia 0s
canaleta/R02_CIERRE_POSITIVO_OREJA_e10_D18-1 | canaleta/R02_CIERRE_POSITIVO_OREJA_e10_D18-2 | secuencia 0s
canaleta/R02_CANALETA_FONDO_e4_MOD1103p75-2 | canaleta/R02_RHS_40x40x3_L205-3 | secuencia 0s
canaleta/R02_CANALETA_FONDO_e4_MOD1103p75-2 | canaleta/R02_SENSOR_POSICION_40x25x15_REPR-2 | secuencia 0s
canaleta/R02_CANALETA_FONDO_e4_MOD1103p75-2 | canaleta/R02_TOPE_0_120_60x60x10-4 | secuencia 0s
canaleta/R02_CANALETA_FONDO_e4_MOD1103p75-2 | canaleta/R02_RHS_40x40x3_L205-4 | secuencia 0s
canaleta/R02_CANALETA_FONDO_e4_MOD1103p75-2 | horizontal/SOPORTE_ARTESA_EMPERNADO_W750p00_F200p00_REV_K_LOCAL_S-3 | secuencia 0s
canaleta/R02_CANALETA_FONDO_e4_MOD1103p75-2 | horizontal/SUPERIOR_D76p2_F200p00_G12p50_PL17p8_REV_K_LOCAL_S-17 | secuencia 0s
canaleta/R02_CANALETA_FONDO_e4_MOD1103p75-2 | horizontal/SOPORTE_ARTESA_EMPERNADO_W750p00_F200p00_REV_K_LOCAL_S-5 | secuencia 0s
canaleta/R02_CANALETA_FONDO_e4_MOD1103p75-2 | horizontal/SUPERIOR_D76p2_F200p00_G12p50_PL17p8_REV_K_LOCAL_S-8 | secuencia 0s
canaleta/R02_CIERRE_POSITIVO_OREJA_e10_D18-4 | canaleta/R02_CIERRE_POSITIVO_OREJA_e10_D18-5 | secuencia 0s
canaleta/R02_CIERRE_POSITIVO_OREJA_e10_D18-4 | canaleta/R02_TOPE_0_120_60x60x10-3 | secuencia 0s
canaleta/R02_PASADOR_CAUTIVO_M16_L70-2 | canaleta/R02_CIERRE_POSITIVO_OREJA_e10_D18-5 | secuencia 0s
canaleta/R02_CANALETA_FONDO_e4_MOD1103p75-3 | canaleta/R02_SENSOR_POSICION_40x25x15_REPR-3 | secuencia 0s
canaleta/R02_CANALETA_FONDO_e4_MOD1103p75-3 | canaleta/R02_TOPE_0_120_60x60x10-6 | secuencia 0s
canaleta/R02_CANALETA_FONDO_e4_MOD1103p75-3 | canaleta/R02_RHS_40x40x3_L205-6 | secuencia 0s
canaleta/R02_CANALETA_FONDO_e4_MOD1103p75-3 | canaleta/R02_RHS_40x40x3_L205-5 | secuencia 0s
canaleta/R02_CANALETA_FONDO_e4_MOD1103p75-3 | horizontal/SUPERIOR_D76p2_F200p00_G12p50_PL17p8_REV_K_LOCAL_S-15 | secuencia 0s
canaleta/R02_CANALETA_FONDO_e4_MOD1103p75-3 | horizontal/SOPORTE_ARTESA_EMPERNADO_W750p00_F200p00_REV_K_LOCAL_S-4 | secuencia 0s
canaleta/R02_CIERRE_POSITIVO_OREJA_e10_D18-7 | canaleta/R02_CIERRE_POSITIVO_OREJA_e10_D18-8 | secuencia 0s
canaleta/R02_CIERRE_POSITIVO_OREJA_e10_D18-7 | canaleta/R02_TOPE_0_120_60x60x10-5 | secuencia 0s
canaleta/R02_PASADOR_CAUTIVO_M16_L70-3 | canaleta/R02_CIERRE_POSITIVO_OREJA_e10_D18-8 | secuencia 0s
canaleta/R02_CANALETA_LATERAL_e4_H80-8 | horizontal/SUPERIOR_D76p2_F200p00_G12p50_PL17p8_REV_K_LOCAL_S-5 | secuencia 0s
canaleta/R02_BISAGRA_OREJA_100x130_e10_D25-19 | horizontal/SOPORTE_ARTESA_EMPERNADO_W750p00_F200p00_REV_K_LOCAL_S-2 | secuencia 0s
canaleta/R02_BISAGRA_OREJA_100x130_e10_D25-19 | horizontal/SUPERIOR_D76p2_F200p00_G12p50_PL17p8_REV_K_LOCAL_S-14 | secuencia 0s
canaleta/R02_CANALETA_FONDO_e4_MOD1103p75-4 | canaleta/R02_SENSOR_POSICION_40x25x15_REPR-4 | secuencia 0s
canaleta/R02_CANALETA_FONDO_e4_MOD1103p75-4 | canaleta/R02_RHS_40x40x3_L205-8 | secuencia 0s
canaleta/R02_CANALETA_FONDO_e4_MOD1103p75-4 | canaleta/R02_TOPE_0_120_60x60x10-8 | secuencia 0s
canaleta/R02_CANALETA_FONDO_e4_MOD1103p75-4 | canaleta/R02_RHS_40x40x3_L205-7 | secuencia 0s
canaleta/R02_CANALETA_FONDO_e4_MOD1103p75-4 | horizontal/SOPORTE_ARTESA_EMPERNADO_W750p00_F200p00_REV_K_LOCAL_S-1 | secuencia 0s
canaleta/R02_CANALETA_FONDO_e4_MOD1103p75-4 | horizontal/SOPORTE_ARTESA_EMPERNADO_W750p00_F200p00_REV_K_LOCAL_S-2 | secuencia 0s
canaleta/R02_CANALETA_FONDO_e4_MOD1103p75-4 | horizontal/SUPERIOR_D76p2_F200p00_G12p50_PL17p8_REV_K_LOCAL_S-5 | secuencia 0s
canaleta/R02_CANALETA_FONDO_e4_MOD1103p75-4 | horizontal/SUPERIOR_D76p2_F200p00_G12p50_PL17p8_REV_K_LOCAL_S-14 | secuencia 0s
canaleta/R02_BISAGRA_OREJA_100x130_e10_D25-22 | horizontal/SUPERIOR_D76p2_F200p00_G12p50_PL17p8_REV_K_LOCAL_S-5 | secuencia 0s
canaleta/R02_CIERRE_POSITIVO_OREJA_e10_D18-10 | canaleta/R02_CIERRE_POSITIVO_OREJA_e10_D18-11 | secuencia 0s
canaleta/R02_CIERRE_POSITIVO_OREJA_e10_D18-10 | canaleta/R02_TOPE_0_120_60x60x10-7 | secuencia 0s
canaleta/R02_PASADOR_CAUTIVO_M16_L70-4 | canaleta/R02_CIERRE_POSITIVO_OREJA_e10_D18-11 | secuencia 0s
canaleta/R02_BANDERA_SENSOR_30x20x3-1 | canaleta/R02_TOPE_0_120_60x60x10-1 | secuencia 1.25s
canaleta/R02_BANDERA_SENSOR_30x20x3-2 | canaleta/R02_TOPE_0_120_60x60x10-3 | secuencia 1.25s
canaleta/R02_BANDERA_SENSOR_30x20x3-3 | canaleta/R02_TOPE_0_120_60x60x10-5 | secuencia 1.25s
canaleta/R02_BANDERA_SENSOR_30x20x3-4 | canaleta/R02_TOPE_0_120_60x60x10-7 | secuencia 1.25s
canaleta/R02_CANALETA_LATERAL_e4_H80-1 | horizontal/BANDA_ARTESA_REV_K_B600p00_L4415p00_LOCAL_S-1 | secuencia 2.125s
canaleta/R02_CANALETA_LATERAL_e4_H80-1 | horizontal/TRANSICION_CABEZA_REV_K_B600p00_LOCAL_S-1 | secuencia 2.125s
canaleta/R02_CANALETA_LATERAL_e4_H80-2 | horizontal/BANDA_ARTESA_REV_K_B600p00_L4415p00_LOCAL_S-1 | secuencia 2.125s
canaleta/R02_CANALETA_LATERAL_e4_H80-4 | horizontal/BANDA_ARTESA_REV_K_B600p00_L4415p00_LOCAL_S-1 | secuencia 2.125s
canaleta/R02_CANALETA_LATERAL_e4_H80-3 | horizontal/BANDA_ARTESA_REV_K_B600p00_L4415p00_LOCAL_S-1 | secuencia 2.125s
canaleta/R02_CANALETA_LATERAL_e4_H80-6 | horizontal/BANDA_ARTESA_REV_K_B600p00_L4415p00_LOCAL_S-1 | secuencia 2.125s
canaleta/R02_CANALETA_LATERAL_e4_H80-5 | horizontal/BANDA_ARTESA_REV_K_B600p00_L4415p00_LOCAL_S-1 | secuencia 2.125s
canaleta/R02_CANALETA_LATERAL_e4_H80-7 | horizontal/BANDA_ARTESA_REV_K_B600p00_L4415p00_LOCAL_S-1 | secuencia 2.125s
canaleta/R02_CANALETA_LATERAL_e4_H80-8 | horizontal/BANDA_ARTESA_REV_K_B600p00_L4415p00_LOCAL_S-1 | secuencia 2.125s
canaleta/R02_CANALETA_LATERAL_e4_H80-8 | horizontal/TRANSICION_COLA_REV_K_B600p00_LOCAL_S-1 | secuencia 2.125s
canaleta/R02_PASADOR_CAUTIVO_M16_L70-1 | horizontal/SOPORTE_ARTESA_EMPERNADO_W750p00_F200p00_REV_K_LOCAL_S-8 | secuencia 2.75s
canaleta/R02_PASADOR_CAUTIVO_M16_L70-1 | horizontal/SUPERIOR_D76p2_F200p00_G12p50_PL17p8_REV_K_LOCAL_S-19 | secuencia 3s
canaleta/R02_CIERRE_POSITIVO_OREJA_e10_D18-4 | canaleta/R02_TOPE_0_120_60x60x10-4 | secuencia 3.5s
canaleta/R02_CIERRE_POSITIVO_OREJA_e10_D18-1 | canaleta/R02_TOPE_0_120_60x60x10-2 | secuencia 3.625s

## Trazabilidad

Ensamble: PLANTA_SELECCION_CARBON_R03_CIERRE.SLDASM
SHA-256: f0a83bbcb9d426ae4944c91f6ca714c85e3ef1b02e04094cb5df9f34915f2850

La web no modificó los archivos CAD. SolidWorks cerró normalmente; se conservaron 489 archivos originales y tres copias de recuperación de documentos marcados como modificados durante la exportación.

Descargar evidencia JSON · Memoria R03 PDF
