acevedocrisologopablo48-lgtm/sesuveca-tolva-p04/dist/documentos/TT10_C05_PLANOS_CONJUNTOS.pdf

# TT10 / TOLVA TROMPO 10 t

# TT10_C05_PC_01 | Conjunto general y montaje

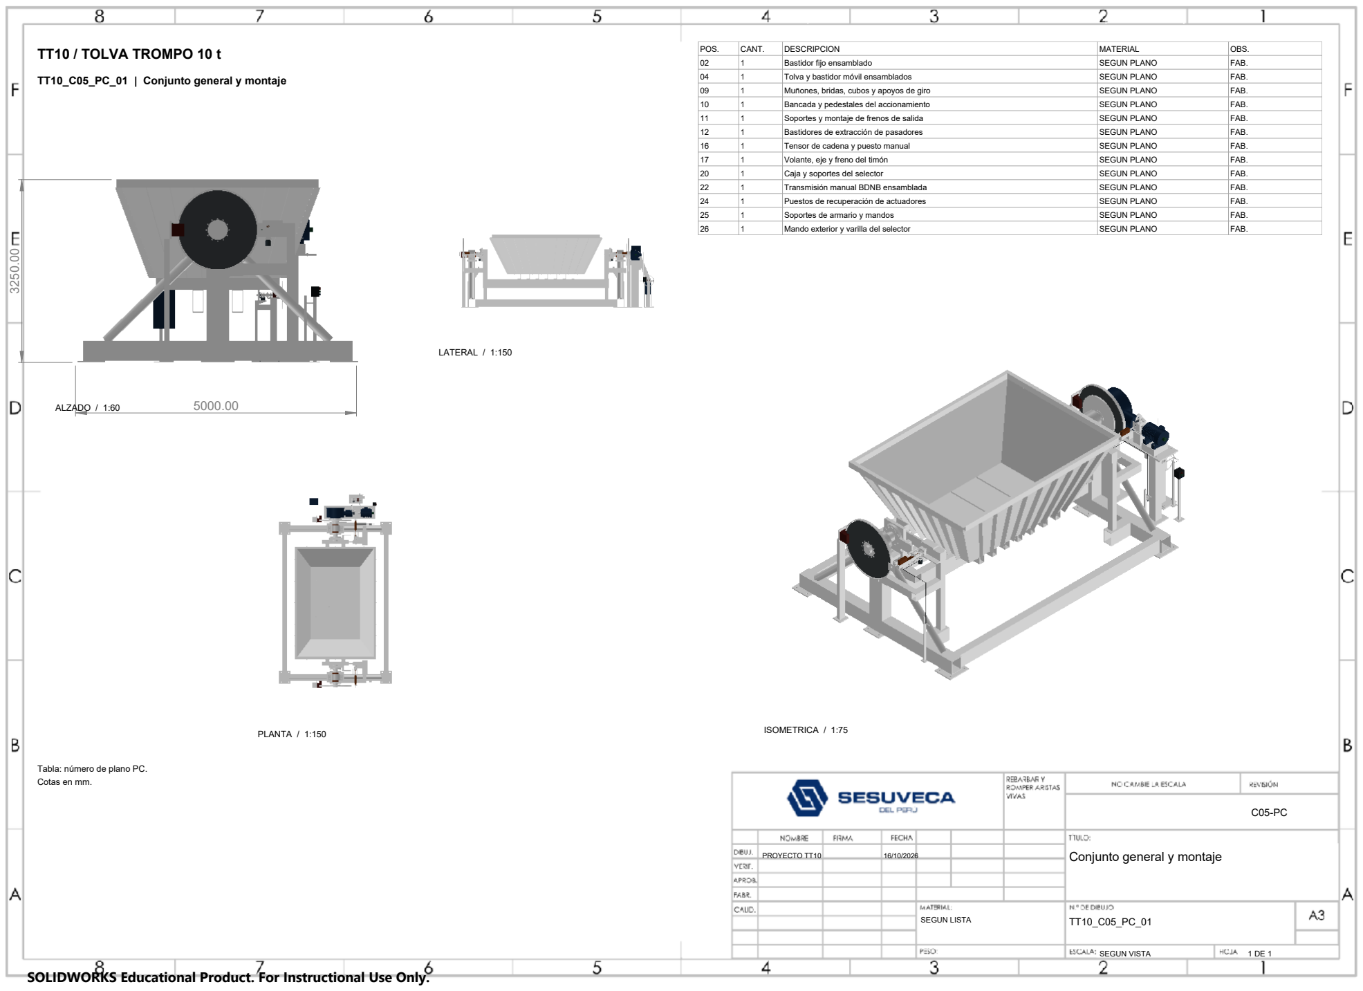
[picture p115: page 1]

5000.00

3250.00

PROYECTO TT10 | 16/10/2026

## C05-PC

# Conjunto general y montaje

## TT10_C05_PC_01 SEGUN LISTA

SEGUN VISTA | 1 DE 1

## ALZADO / 1:60

## LATERAL / 1:150

PLANTA / 1:150 | ISOMETRICA / 1:75

Cotas en mm.

Tabla: número de plano PC.

SOLIDWORKS Educational Product. For Instructional Use Only.

POS. | CANT. | DESCRIPCION | MATERIAL | OBS.
02 | 1 | Bastidor fijo ensamblado | SEGUN PLANO | FAB.
04 | 1 | Tolva y bastidor móvil ensamblados | SEGUN PLANO | FAB.
09 | 1 | Muñones, bridas, cubos y apoyos de giro | SEGUN PLANO | FAB.
10 | 1 | Bancada y pedestales del accionamiento | SEGUN PLANO | FAB.
11 | 1 | Soportes y montaje de frenos de salida | SEGUN PLANO | FAB.
12 | 1 | Bastidores de extracción de pasadores | SEGUN PLANO | FAB.
16 | 1 | Tensor de cadena y puesto manual | SEGUN PLANO | FAB.
17 | 1 | Volante, eje y freno del timón | SEGUN PLANO | FAB.
20 | 1 | Caja y soportes del selector | SEGUN PLANO | FAB.
22 | 1 | Transmisión manual BDNB ensamblada | SEGUN PLANO | FAB.
24 | 1 | Puestos de recuperación de actuadores | SEGUN PLANO | FAB.
25 | 1 | Soportes de armario y mandos | SEGUN PLANO | FAB.
26 | 1 | Mando exterior y varilla del selector | SEGUN PLANO | FAB.

1800.00

# TT10_C05_PC_02 | Bastidor fijo ensamblado

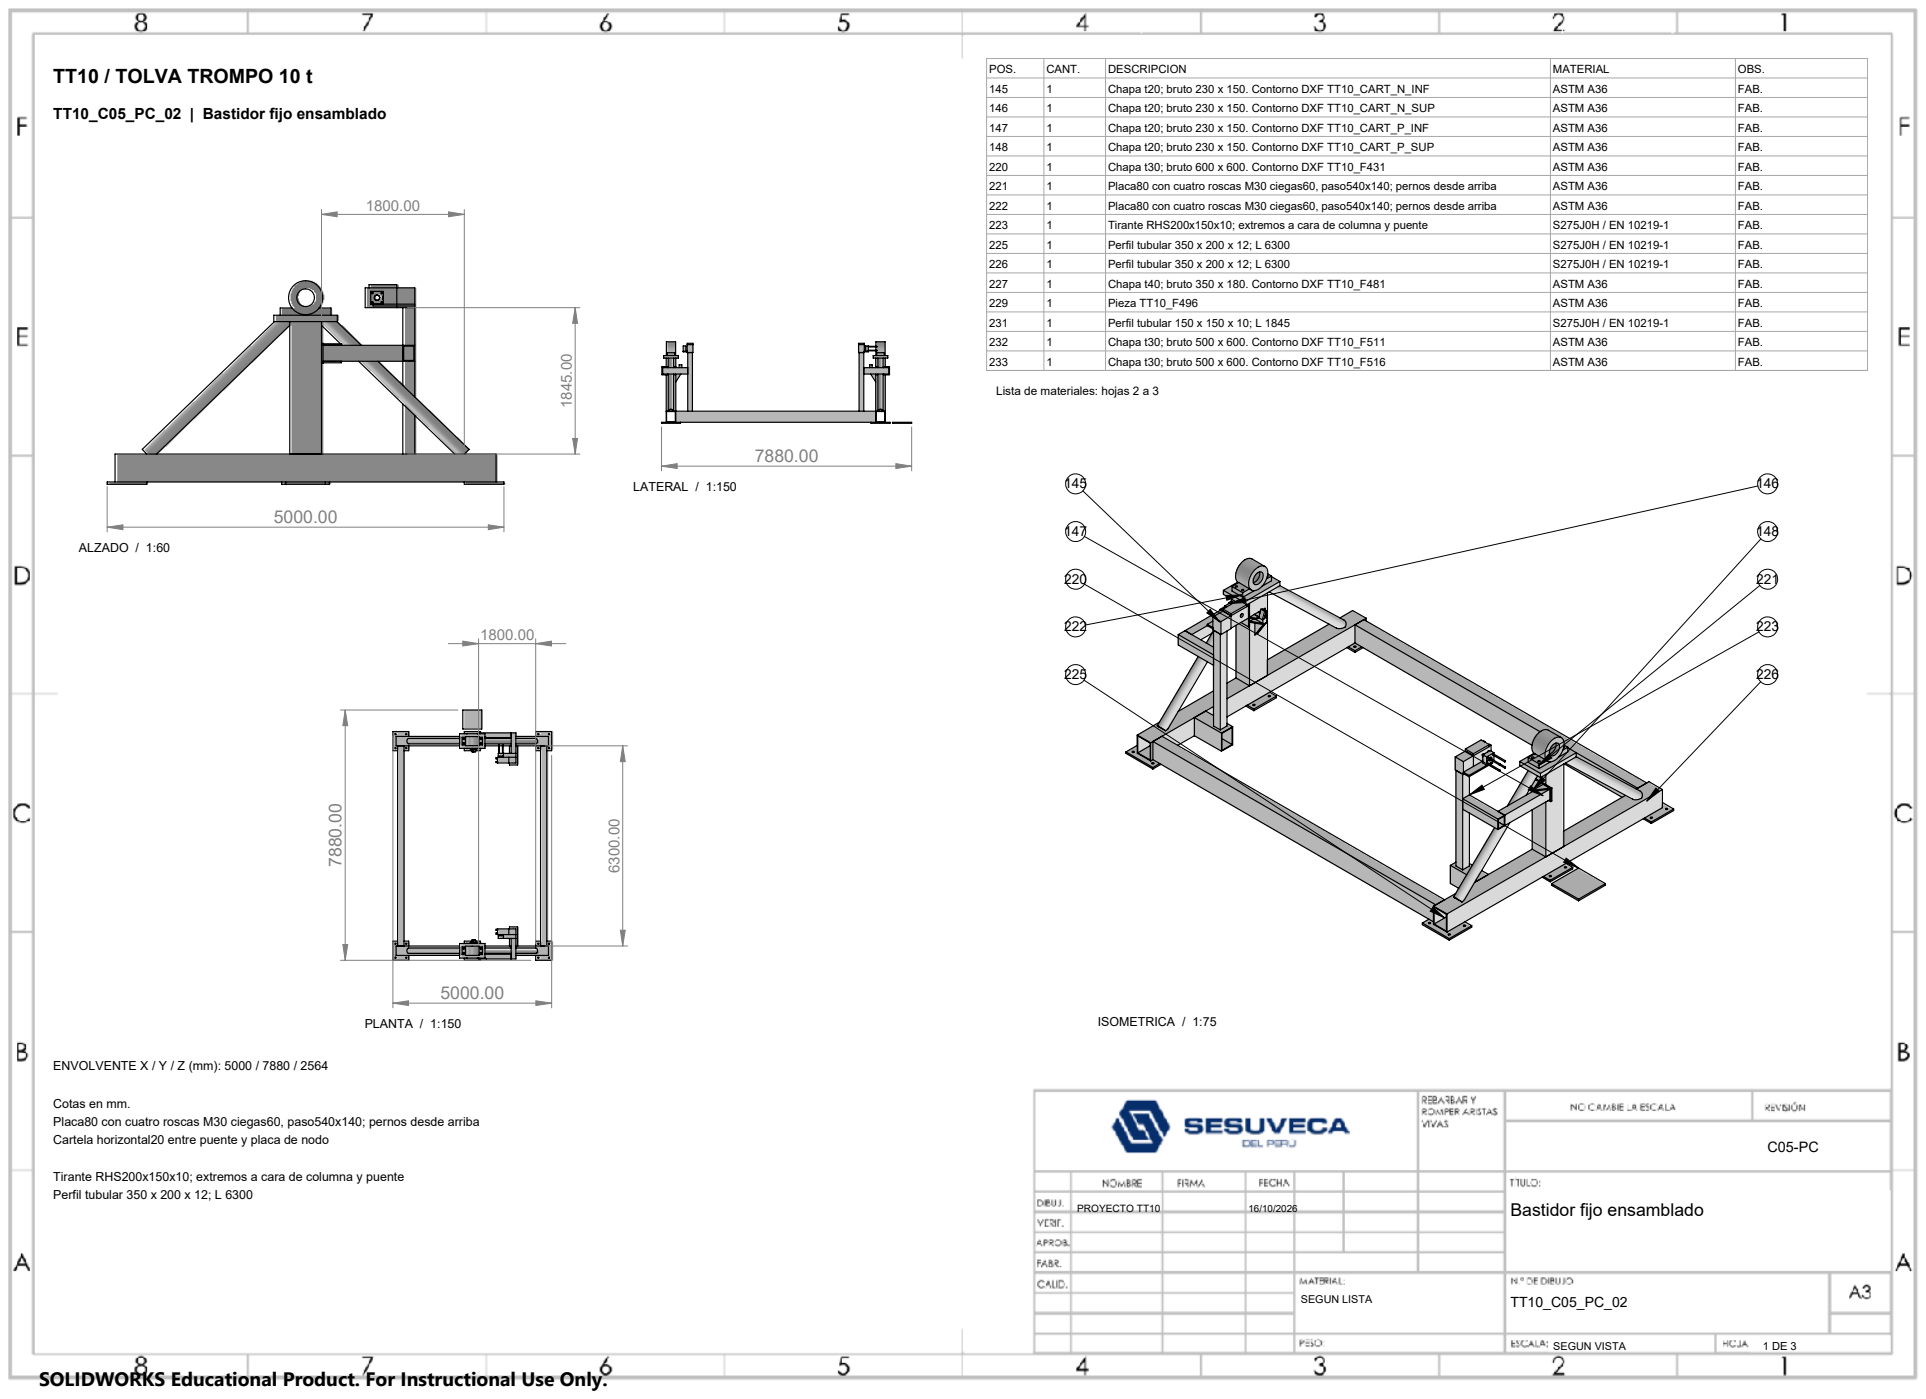
[picture p116: page 2]
PROYECTO TT10; TT10_C05_PC_02 SEGUN LISTA; ENVOLVENTE X / Y / Z (mm): 5000 / 7880 / 2564; ALZADO / 1:60; LATERAL / 1:150; PLANTA / 1:150; ISOMETRICA / 1:75

145 | 1 | Chapa t20; bruto 230 x 150. Contorno DXF TT10_CART_N_INF | ASTM A36 | FAB.
146 | 1 | Chapa t20; bruto 230 x 150. Contorno DXF TT10_CART_N_SUP | ASTM A36 | FAB.
147 | 1 | Chapa t20; bruto 230 x 150. Contorno DXF TT10_CART_P_INF | ASTM A36 | FAB.
148 | 1 | Chapa t20; bruto 230 x 150. Contorno DXF TT10_CART_P_SUP | ASTM A36 | FAB.
220 | 1 | Chapa t30; bruto 600 x 600. Contorno DXF TT10_F431 | ASTM A36 | FAB.
221 | 1 | Placa80 con cuatro roscas M30 ciegas60, paso540x140; pernos desde arriba | ASTM A36 | FAB.
222 | 1 | Placa80 con cuatro roscas M30 ciegas60, paso540x140; pernos desde arriba | ASTM A36 | FAB.
223 | 1 | Tirante RHS200x150x10; extremos a cara de columna y puente | S275J0H / EN 10219-1 | FAB.
225 | 1 | Perfil tubular 350 x 200 x 12; L 6300 | S275J0H / EN 10219-1 | FAB.
226 | 1 | Perfil tubular 350 x 200 x 12; L 6300 | S275J0H / EN 10219-1 | FAB.
227 | 1 | Chapa t40; bruto 350 x 180. Contorno DXF TT10_F481 | ASTM A36 | FAB.
229 | 1 | Pieza TT10_F496 | ASTM A36 | FAB.
231 | 1 | Perfil tubular 150 x 150 x 10; L 1845 | S275J0H / EN 10219-1 | FAB.
232 | 1 | Chapa t30; bruto 500 x 600. Contorno DXF TT10_F511 | ASTM A36 | FAB.
233 | 1 | Chapa t30; bruto 500 x 600. Contorno DXF TT10_F516 | ASTM A36 | FAB.

Lista de materiales: hojas 2 a 3

Cotas en mm.
Placa80 con cuatro roscas M30 ciegas60, paso540x140; pernos desde arriba
Cartela horizontal20 entre puente y placa de nodo

Tirante RHS200x150x10; extremos a cara de columna y puente
Perfil tubular 350 x 200 x 12; L 6300

Bastidor fijo ensamblado

# TT10_C05_PC_02 | Bastidor fijo ensamblado - Lista de materiales

PROYECTO TT10 | 16/10/2026

## C05-PC

# Bastidor fijo ensamblado

## TT10_C05_PC_02 SEGUN LISTA

POS. | CANT. | CODIGO | DESCRIPCION / CORTE | MATERIAL | TIPO
145 | 1 | TT10_CART_N_INF | Chapa t20; bruto 230 x 150. Contorno DXF TT10_CART_N_INF | ASTM A36 | FAB.
146 | 1 | TT10_CART_N_SUP | Chapa t20; bruto 230 x 150. Contorno DXF TT10_CART_N_SUP | ASTM A36 | FAB.
147 | 1 | TT10_CART_P_INF | Chapa t20; bruto 230 x 150. Contorno DXF TT10_CART_P_INF | ASTM A36 | FAB.
148 | 1 | TT10_CART_P_SUP | Chapa t20; bruto 230 x 150. Contorno DXF TT10_CART_P_SUP | ASTM A36 | FAB.
220 | 1 | TT10_F431 | Chapa t30; bruto 600 x 600. Contorno DXF TT10_F431 | ASTM A36 | FAB.
221 | 1 | TT10_F441 | Placa80 con cuatro roscas M30 ciegas60, paso540x140; pernos desde arriba | ASTM A36 | FAB.
222 | 1 | TT10_F446 | Placa80 con cuatro roscas M30 ciegas60, paso540x140; pernos desde arriba | ASTM A36 | FAB.
223 | 1 | TT10_F451 | Tirante RHS200x150x10; extremos a cara de columna y puente | S275J0H / EN 10219-1 | FAB.
225 | 1 | TT10_F471 | Perfil tubular 350 x 200 x 12; L 6300 | S275J0H / EN 10219-1 | FAB.
226 | 1 | TT10_F476 | Perfil tubular 350 x 200 x 12; L 6300 | S275J0H / EN 10219-1 | FAB.
227 | 1 | TT10_F481 | Chapa t40; bruto 350 x 180. Contorno DXF TT10_F481 | ASTM A36 | FAB.
229 | 1 | TT10_F496 | Pieza TT10_F496 | ASTM A36 | FAB.
231 | 1 | TT10_F506 | Perfil tubular 150 x 150 x 10; L 1845 | S275J0H / EN 10219-1 | FAB.
232 | 1 | TT10_F511 | Chapa t30; bruto 500 x 600. Contorno DXF TT10_F511 | ASTM A36 | FAB.
233 | 1 | TT10_F516 | Chapa t30; bruto 500 x 600. Contorno DXF TT10_F516 | ASTM A36 | FAB.
235 | 1 | TT10_F526 | Perfil tubular 350 x 300 x 12; L 4800 | S275J0H / EN 10219-1 | FAB.
236 | 1 | TT10_F531 | Perfil tubular 350 x 300 x 12; L 4800 | S275J0H / EN 10219-1 | FAB.
238 | 1 | TT10_F541 | Diagonal CHS168.3x10 con cortes de asiento; sin penetrar columnas ni placas | S275J0H / EN 10219-1 | FAB.
239 | 1 | TT10_F546 | Puente RHS200x150x10 L1005; fuera del plano de las diagonales | S275J0H / EN 10219-1 | FAB.
242 | 1 | TT10_F561 | Chapa t40; bruto 350 x 180. Contorno DXF TT10_F561 | ASTM A36 | FAB.
243 | 1 | TT10_F566 | Chapa t30; bruto 500 x 600. Contorno DXF TT10_F566 | ASTM A36 | FAB.
244 | 1 | TT10_F571 | Chapa t30; bruto 500 x 600. Contorno DXF TT10_F571 | ASTM A36 | FAB.
246 | 1 | TT10_F581 | Diagonal CHS168.3x10 con cortes de asiento; sin penetrar columnas ni placas | S275J0H / EN 10219-1 | FAB.
250 | 1 | TT10_F601 | Diagonal CHS168.3x10 con cortes de asiento; sin penetrar columnas ni placas | S275J0H / EN 10219-1 | FAB.
251 | 1 | TT10_F606 | Diagonal CHS168.3x10 con cortes de asiento; sin penetrar columnas ni placas | S275J0H / EN 10219-1 | FAB.
252 | 1 | TT10_F611 | Perfil tubular 150 x 150 x 10; L 1845 | S275J0H / EN 10219-1 | FAB.
253 | 1 | TT10_F616 | Tirante RHS200x150x10; extremos a cara de columna y puente | S275J0H / EN 10219-1 | FAB.
254 | 1 | TT10_F621 | Puente RHS200x150x10 L1005; fuera del plano de las diagonales | S275J0H / EN 10219-1 | FAB.
255 | 1 | TT10_F626 | Chapa t30; bruto 500 x 600. Contorno DXF TT10_F626 | ASTM A36 | FAB.
256 | 1 | TT10_F631 | Chapa t30; bruto 500 x 600. Contorno DXF TT10_F631 | ASTM A36 | FAB.
257 | 1 | TT10_F636 | Columna principal recortada para placa80 y altura de centro SKF220 | S355J2; certificado 3.1 requerido | FAB.
258 | 1 | TT10_F641 | Columna principal recortada para placa80 y altura de centro SKF220 | S355J2; certificado 3.1 requerido | FAB.
259 | 1 | TT10_F646 | Pieza TT10_F646 | ASTM A36 | FAB.
388 | 1 | TT10_NODO_N | Chapa t20; bruto 435 x 250. Contorno DXF TT10_NODO_N | ASTM A36 | FAB.
389 | 1 | TT10_NODO_P | Chapa t20; bruto 435 x 250. Contorno DXF TT10_NODO_P | ASTM A36 | FAB.
458 | 1 | TT10_TIR_P1 | Tirante M20 propuesto, L380; rosca simplificada | ASTM A36 | FAB.

# TT10_C05_PC_02 | Bastidor fijo ensamblado - Lista de materiales

PROYECTO TT10 | 16/10/2026

## C05-PC

# Bastidor fijo ensamblado

## TT10_C05_PC_02 SEGUN LISTA

POS. | CANT. | CODIGO | DESCRIPCION / CORTE | MATERIAL | TIPO
459 | 1 | TT10_TIR_P2 | Tirante M20 propuesto, L380; rosca simplificada | ASTM A36 | FAB.
460 | 1 | TT10_TIR_P3 | Tirante M20 propuesto, L380; rosca simplificada | ASTM A36 | FAB.
461 | 1 | TT10_TIR_P4 | Tirante M20 propuesto, L380; rosca simplificada | ASTM A36 | FAB.
218 | 1 | TT10_F416 | Perfil tubular 350 x 250 x 12; L 600 | S275J0H / EN 10219-1 | FAB.
219 | 1 | TT10_F426 | Tope inclinado: cara inferior mecanizada para asiento horizontal | ASTM A36 | FAB.
228 | 1 | TT10_F486 | Chapa t40; bruto 250 x 400. Contorno DXF TT10_F486 | ASTM A36 | FAB.
230 | 1 | TT10_F501 | Chapa t40; bruto 250 x 400. Contorno DXF TT10_F501 | ASTM A36 | FAB.
237 | 1 | TT10_F536 | Soporte tope terminado en cara interior de columna | ASTM A36 | FAB.
241 | 1 | TT10_F556 | Soporte tope terminado en cara interior de columna | ASTM A36 | FAB.
245 | 1 | TT10_F576 | Chapa t40; bruto 250 x 400. Contorno DXF TT10_F576 | ASTM A36 | FAB.
247 | 1 | TT10_F586 | Chapa t40; bruto 250 x 400. Contorno DXF TT10_F586 | ASTM A36 | FAB.
248 | 1 | TT10_F591 | Perfil tubular 350 x 250 x 12; L 600 | S275J0H / EN 10219-1 | FAB.
249 | 1 | TT10_F596 | Tope inclinado: cara inferior mecanizada para asiento horizontal | ASTM A36 | FAB.
262 | 1 | TT10_GUIA_N | Guía con alojamiento Ø69 H7; casquillo69/65.5; fuera del camino resistente | ASTM A36 | FAB.
263 | 1 | TT10_GUIA_P | Guía con alojamiento Ø69 H7; casquillo69/65.5; fuera del camino resistente | ASTM A36 | FAB.
430 | 1 | TT10_PUENTE_N | Chapa t25; bruto 525 x 125. Contorno DXF TT10_PUENTE_N | ASTM A36 | FAB.
431 | 1 | TT10_PUENTE_P | Chapa t25; bruto 525 x 125. Contorno DXF TT10_PUENTE_P | ASTM A36 | FAB.
487 | 1 | TT10_TOPE70_N_INFD | Chapa t20; bruto 100 x 190. Contorno DXF TT10_TOPE70_N_INFD | ASTM A36 | FAB.
488 | 1 | TT10_TOPE70_N_INFI | Chapa t20; bruto 150 x 190. Contorno DXF TT10_TOPE70_N_INFI | ASTM A36 | FAB.
489 | 1 | TT10_TOPE70_N_SUPD | Chapa t20; bruto 100 x 95. Contorno DXF TT10_TOPE70_N_SUPD | ASTM A36 | FAB.
490 | 1 | TT10_TOPE70_N_SUPI | Chapa t20; bruto 150 x 190. Contorno DXF TT10_TOPE70_N_SUPI | ASTM A36 | FAB.
491 | 1 | TT10_TOPE70_N_V1 | Chapa t20; bruto 190 x 300. Contorno DXF TT10_TOPE70_N_V1 | ASTM A36 | FAB.
492 | 1 | TT10_TOPE70_N_V2 | Chapa t20; bruto 190 x 300. Contorno DXF TT10_TOPE70_N_V2 | ASTM A36 | FAB.
493 | 1 | TT10_TOPE70_P_INFD | Chapa t20; bruto 100 x 190. Contorno DXF TT10_TOPE70_P_INFD | ASTM A36 | FAB.
494 | 1 | TT10_TOPE70_P_INFI | Chapa t20; bruto 150 x 190. Contorno DXF TT10_TOPE70_P_INFI | ASTM A36 | FAB.
495 | 1 | TT10_TOPE70_P_SUPD | Chapa t20; bruto 100 x 95. Contorno DXF TT10_TOPE70_P_SUPD | ASTM A36 | FAB.
496 | 1 | TT10_TOPE70_P_SUPI | Chapa t20; bruto 150 x 190. Contorno DXF TT10_TOPE70_P_SUPI | ASTM A36 | FAB.
497 | 1 | TT10_TOPE70_P_V1 | Chapa t20; bruto 190 x 300. Contorno DXF TT10_TOPE70_P_V1 | ASTM A36 | FAB.
498 | 1 | TT10_TOPE70_P_V2 | Chapa t20; bruto 190 x 300. Contorno DXF TT10_TOPE70_P_V2 | ASTM A36 | FAB.
224 | 1 | TT10_F456 | SKF SNL3048: dimensiones de interfaz según catálogo; fundición simplificada | Conjunto comprado; acero/ fundición según OEM | COMPRA
240 | 1 | TT10_F551 | SKF SNL3048: dimensiones de interfaz según catálogo; fundición simplificada | Conjunto comprado; acero/ fundición según OEM | COMPRA

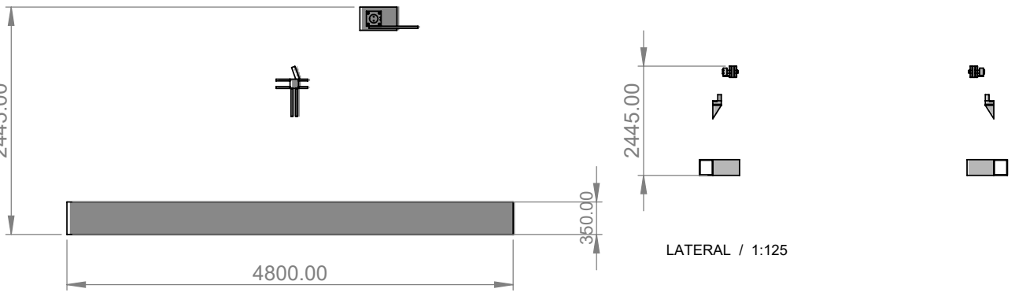
[picture p117: figure]
LATERAL / 1:125

2445.00

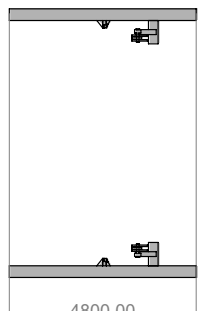
[picture p118: figure]

4800.00

218 | 219
228 | 230
237 | 241
245 | 247
248 | 249

# TT10_C05_PC_03 | Topes de giro, orejas y guías del bastidor

PROYECTO TT10 | 16/10/2026

## C05-PC

# Topes de giro, orejas y guías del bastidor

## TT10_C05_PC_03 SEGUN LISTA

Lista de materiales: hoja 2.

## ENVOLVENTE X / Y / Z (mm): 4800 / 6900 / 2445

## ALZADO / 1:60

## PLANTA / 1:125 ISOMETRICA / 1:60

Cotas en mm.

## Oreja fija espesor40, Ø65 H8, mandrinar coaxialmente después de soldar Guía con alojamiento Ø69 H7; casquillo69/65.5; fuera del camino resistente Perfil tubular 350 x 250 x 12; L 600 Tope inclinado: cara inferior mecanizada para asiento horizontal Soporte tope terminado en cara interior de columna

218 | 1 | Perfil tubular 350 x 250 x 12; L 600 | S275J0H / EN 10219-1 | FAB.
219 | 1 | Tope inclinado: cara inferior mecanizada para asiento horizontal | ASTM A36 | FAB.
228 | 1 | Chapa t40; bruto 250 x 400. Contorno DXF TT10_F486 | ASTM A36 | FAB.
230 | 1 | Chapa t40; bruto 250 x 400. Contorno DXF TT10_F501 | ASTM A36 | FAB.
237 | 1 | Soporte tope terminado en cara interior de columna | ASTM A36 | FAB.
241 | 1 | Soporte tope terminado en cara interior de columna | ASTM A36 | FAB.
245 | 1 | Chapa t40; bruto 250 x 400. Contorno DXF TT10_F576 | ASTM A36 | FAB.
247 | 1 | Chapa t40; bruto 250 x 400. Contorno DXF TT10_F586 | ASTM A36 | FAB.
248 | 1 | Perfil tubular 350 x 250 x 12; L 600 | S275J0H / EN 10219-1 | FAB.
249 | 1 | Tope inclinado: cara inferior mecanizada para asiento horizontal | ASTM A36 | FAB.
262 | 1 | Guía con alojamiento Ø69 H7; casquillo69/65.5; fuera del camino resistente | ASTM A36 | FAB.
263 | 1 | Guía con alojamiento Ø69 H7; casquillo69/65.5; fuera del camino resistente | ASTM A36 | FAB.
430 | 1 | Chapa t25; bruto 525 x 125. Contorno DXF TT10_PUENTE_N | ASTM A36 | FAB.
431 | 1 | Chapa t25; bruto 525 x 125. Contorno DXF TT10_PUENTE_P | ASTM A36 | FAB.
487 | 1 | Chapa t20; bruto 100 x 190. Contorno DXF TT10_TOPE70_N_INFD | ASTM A36 | FAB.

# TT10_C05_PC_03 | Topes de giro, orejas y guías del bastidor - Lista de materiales

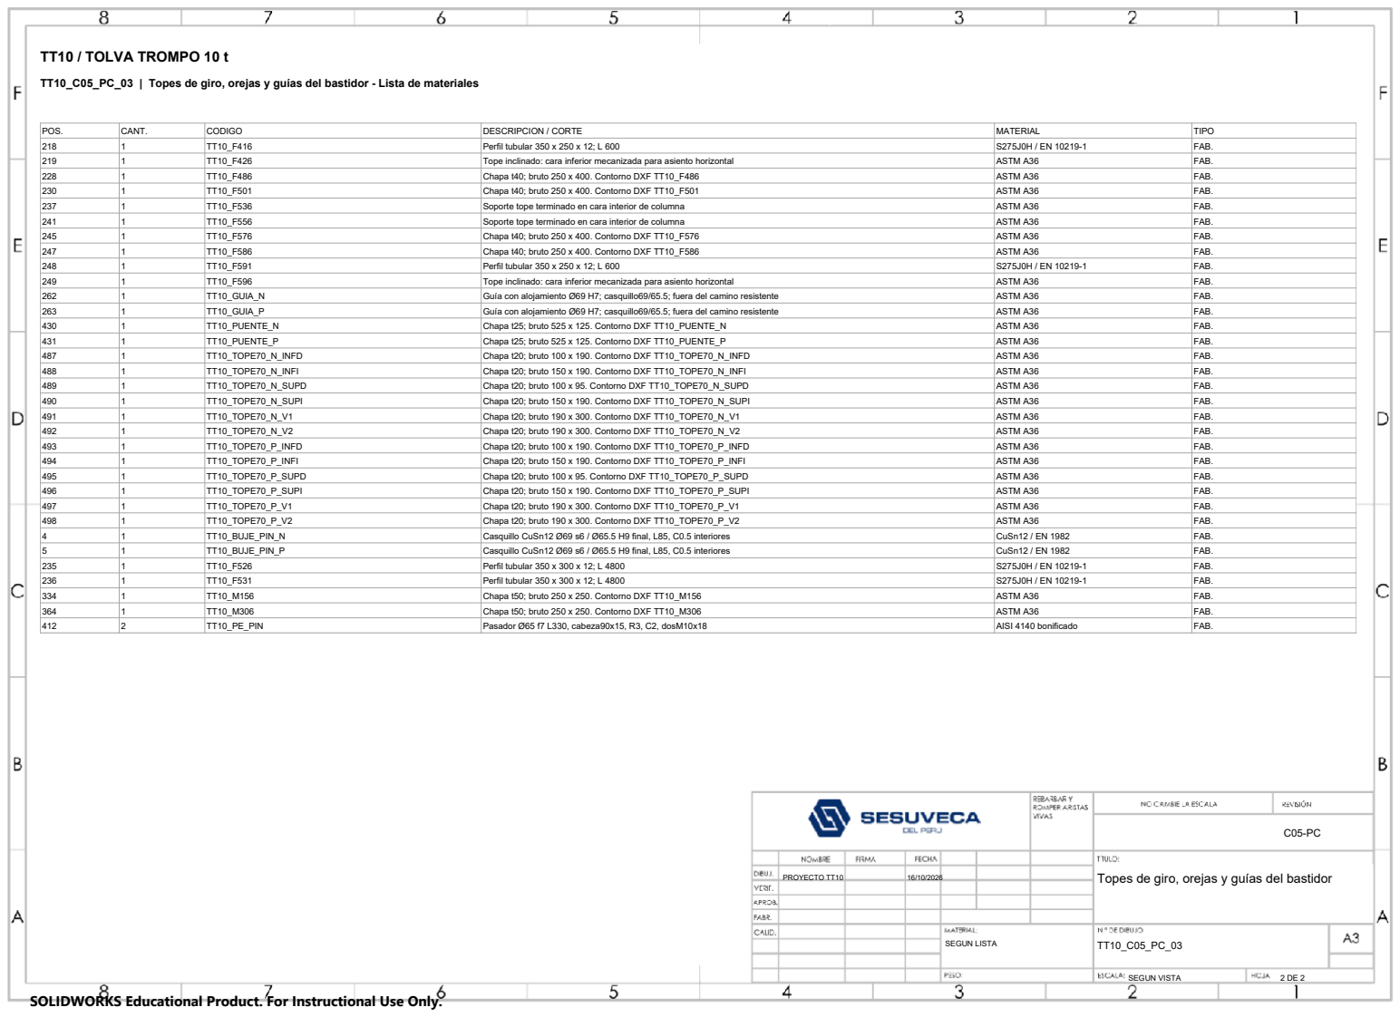
[picture p119: page 6]

PROYECTO TT10 | 16/10/2026

## C05-PC

# Topes de giro, orejas y guías del bastidor

## TT10_C05_PC_03 SEGUN LISTA

POS. | CANT. | CODIGO | DESCRIPCION / CORTE | MATERIAL | TIPO
218 | 1 | TT10_F416 | Perfil tubular 350 x 250 x 12; L 600 | S275J0H / EN 10219-1 | FAB.
219 | 1 | TT10_F426 | Tope inclinado: cara inferior mecanizada para asiento horizontal | ASTM A36 | FAB.
228 | 1 | TT10_F486 | Chapa t40; bruto 250 x 400. Contorno DXF TT10_F486 | ASTM A36 | FAB.
230 | 1 | TT10_F501 | Chapa t40; bruto 250 x 400. Contorno DXF TT10_F501 | ASTM A36 | FAB.
237 | 1 | TT10_F536 | Soporte tope terminado en cara interior de columna | ASTM A36 | FAB.
241 | 1 | TT10_F556 | Soporte tope terminado en cara interior de columna | ASTM A36 | FAB.
245 | 1 | TT10_F576 | Chapa t40; bruto 250 x 400. Contorno DXF TT10_F576 | ASTM A36 | FAB.
247 | 1 | TT10_F586 | Chapa t40; bruto 250 x 400. Contorno DXF TT10_F586 | ASTM A36 | FAB.
248 | 1 | TT10_F591 | Perfil tubular 350 x 250 x 12; L 600 | S275J0H / EN 10219-1 | FAB.
249 | 1 | TT10_F596 | Tope inclinado: cara inferior mecanizada para asiento horizontal | ASTM A36 | FAB.
262 | 1 | TT10_GUIA_N | Guía con alojamiento Ø69 H7; casquillo69/65.5; fuera del camino resistente | ASTM A36 | FAB.
263 | 1 | TT10_GUIA_P | Guía con alojamiento Ø69 H7; casquillo69/65.5; fuera del camino resistente | ASTM A36 | FAB.
430 | 1 | TT10_PUENTE_N | Chapa t25; bruto 525 x 125. Contorno DXF TT10_PUENTE_N | ASTM A36 | FAB.
431 | 1 | TT10_PUENTE_P | Chapa t25; bruto 525 x 125. Contorno DXF TT10_PUENTE_P | ASTM A36 | FAB.
487 | 1 | TT10_TOPE70_N_INFD | Chapa t20; bruto 100 x 190. Contorno DXF TT10_TOPE70_N_INFD | ASTM A36 | FAB.
488 | 1 | TT10_TOPE70_N_INFI | Chapa t20; bruto 150 x 190. Contorno DXF TT10_TOPE70_N_INFI | ASTM A36 | FAB.
489 | 1 | TT10_TOPE70_N_SUPD | Chapa t20; bruto 100 x 95. Contorno DXF TT10_TOPE70_N_SUPD | ASTM A36 | FAB.
490 | 1 | TT10_TOPE70_N_SUPI | Chapa t20; bruto 150 x 190. Contorno DXF TT10_TOPE70_N_SUPI | ASTM A36 | FAB.
491 | 1 | TT10_TOPE70_N_V1 | Chapa t20; bruto 190 x 300. Contorno DXF TT10_TOPE70_N_V1 | ASTM A36 | FAB.
492 | 1 | TT10_TOPE70_N_V2 | Chapa t20; bruto 190 x 300. Contorno DXF TT10_TOPE70_N_V2 | ASTM A36 | FAB.
493 | 1 | TT10_TOPE70_P_INFD | Chapa t20; bruto 100 x 190. Contorno DXF TT10_TOPE70_P_INFD | ASTM A36 | FAB.
494 | 1 | TT10_TOPE70_P_INFI | Chapa t20; bruto 150 x 190. Contorno DXF TT10_TOPE70_P_INFI | ASTM A36 | FAB.
495 | 1 | TT10_TOPE70_P_SUPD | Chapa t20; bruto 100 x 95. Contorno DXF TT10_TOPE70_P_SUPD | ASTM A36 | FAB.
496 | 1 | TT10_TOPE70_P_SUPI | Chapa t20; bruto 150 x 190. Contorno DXF TT10_TOPE70_P_SUPI | ASTM A36 | FAB.
497 | 1 | TT10_TOPE70_P_V1 | Chapa t20; bruto 190 x 300. Contorno DXF TT10_TOPE70_P_V1 | ASTM A36 | FAB.
498 | 1 | TT10_TOPE70_P_V2 | Chapa t20; bruto 190 x 300. Contorno DXF TT10_TOPE70_P_V2 | ASTM A36 | FAB.
4 | 1 | TT10_BUJE_PIN_N | Casquillo CuSn12 Ø69 s6 / Ø65.5 H9 final, L85, C0.5 interiores | CuSn12 / EN 1982 | FAB.
5 | 1 | TT10_BUJE_PIN_P | Casquillo CuSn12 Ø69 s6 / Ø65.5 H9 final, L85, C0.5 interiores | CuSn12 / EN 1982 | FAB.
235 | 1 | TT10_F526 | Perfil tubular 350 x 300 x 12; L 4800 | S275J0H / EN 10219-1 | FAB.
236 | 1 | TT10_F531 | Perfil tubular 350 x 300 x 12; L 4800 | S275J0H / EN 10219-1 | FAB.
334 | 1 | TT10_M156 | Chapa t50; bruto 250 x 250. Contorno DXF TT10_M156 | ASTM A36 | FAB.
364 | 1 | TT10_M306 | Chapa t50; bruto 250 x 250. Contorno DXF TT10_M306 | ASTM A36 | FAB.
412 | 2 | TT10_PE_PIN | Pasador Ø65 f7 L330, cabeza90x15, R3, C2, dosM10x18 | AISI 4140 bonificado | FAB.

# TT10_C05_PC_04 | Tolva y bastidor móvil ensamblados

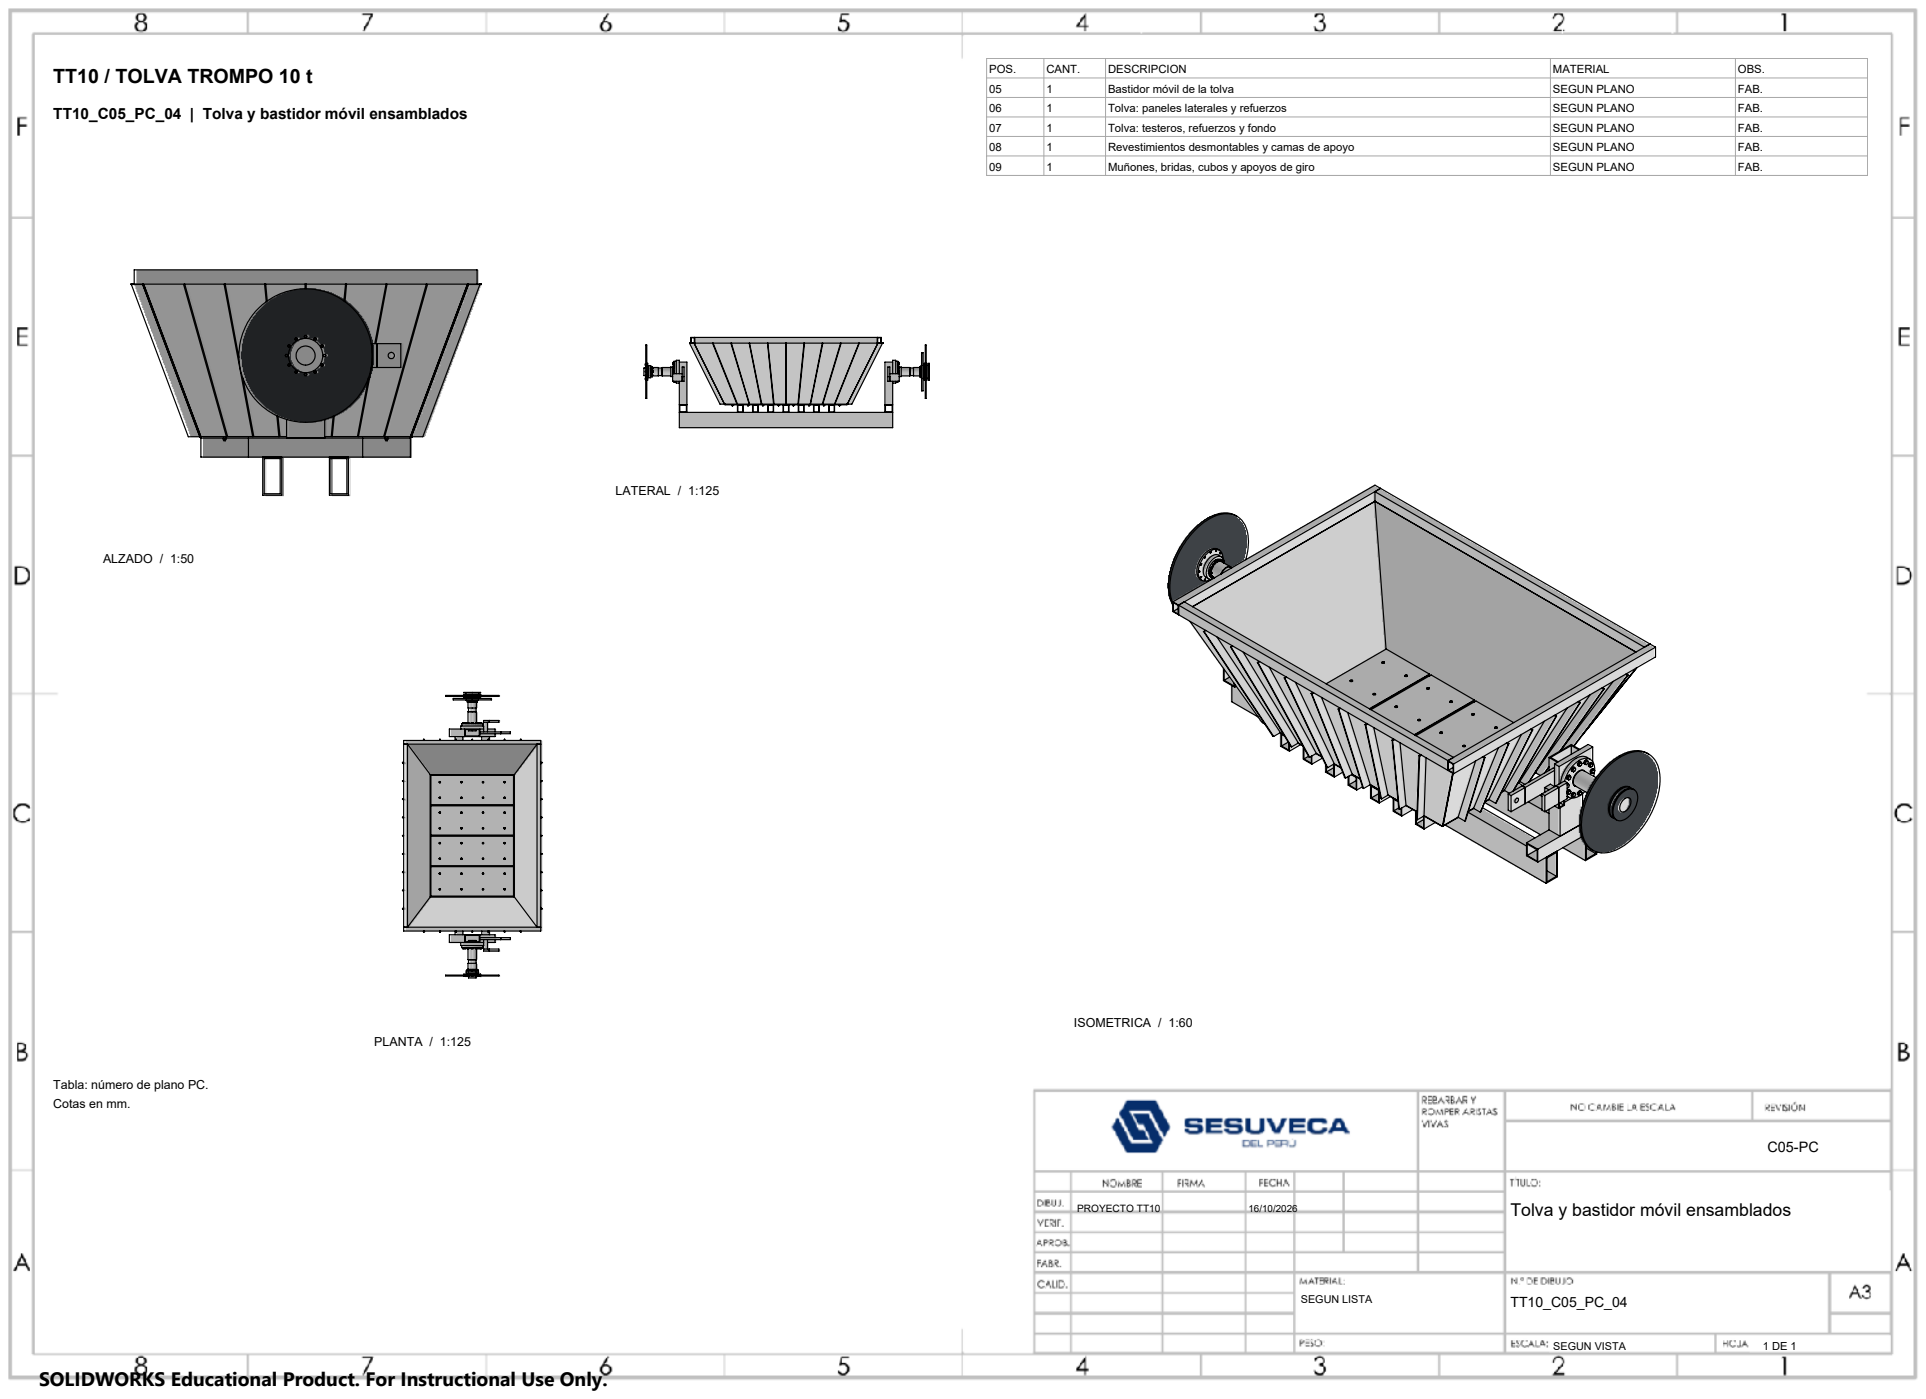
[picture p120: page 7]
PROYECTO TT10; TT10_C05_PC_04 SEGUN LISTA; ALZADO / 1:50; LATERAL / 1:125; PLANTA / 1:125; ISOMETRICA / 1:60

05 | 1 | Bastidor móvil de la tolva | SEGUN PLANO | FAB.
06 | 1 | Tolva: paneles laterales y refuerzos | SEGUN PLANO | FAB.
07 | 1 | Tolva: testeros, refuerzos y fondo | SEGUN PLANO | FAB.
08 | 1 | Revestimientos desmontables y camas de apoyo | SEGUN PLANO | FAB.
09 | 1 | Muñones, bridas, cubos y apoyos de giro | SEGUN PLANO | FAB.

Tabla: número de plano PC.
Cotas en mm.

Tolva y bastidor móvil ensamblados

2200.00

# TT10_C05_PC_05 | Bastidor móvil de la tolva

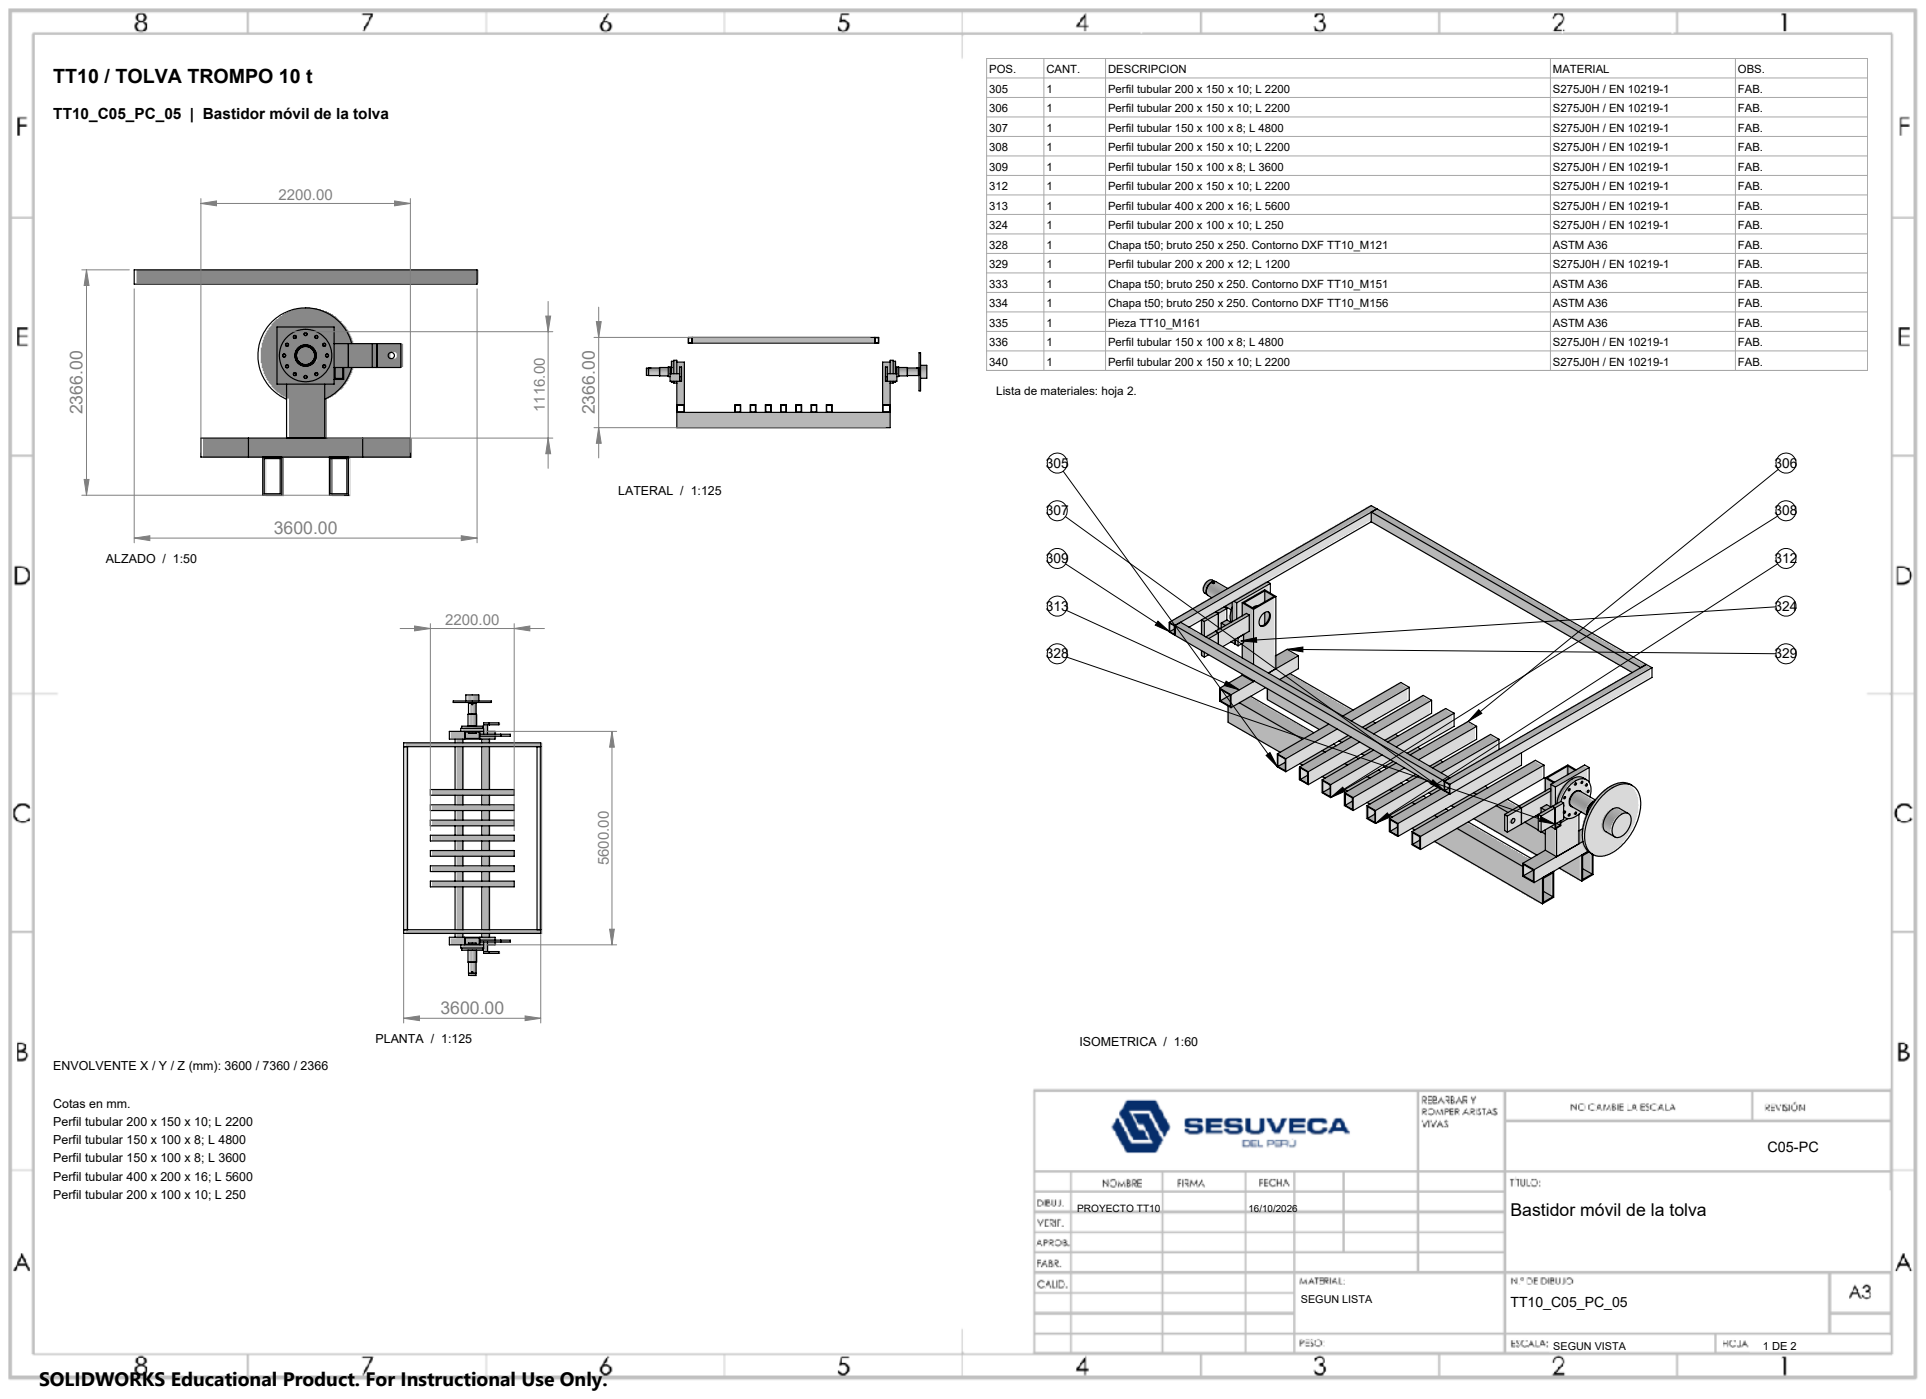
[picture p121: page 8]
PROYECTO TT10; TT10_C05_PC_05 SEGUN LISTA; ENVOLVENTE X / Y / Z (mm): 3600 / 7360 / 2366; ALZADO / 1:50; LATERAL / 1:125; PLANTA / 1:125; ISOMETRICA / 1:60

305 | 1 | Perfil tubular 200 x 150 x 10; L 2200 | S275J0H / EN 10219-1 | FAB.
306 | 1 | Perfil tubular 200 x 150 x 10; L 2200 | S275J0H / EN 10219-1 | FAB.
307 | 1 | Perfil tubular 150 x 100 x 8; L 4800 | S275J0H / EN 10219-1 | FAB.
308 | 1 | Perfil tubular 200 x 150 x 10; L 2200 | S275J0H / EN 10219-1 | FAB.
309 | 1 | Perfil tubular 150 x 100 x 8; L 3600 | S275J0H / EN 10219-1 | FAB.
312 | 1 | Perfil tubular 200 x 150 x 10; L 2200 | S275J0H / EN 10219-1 | FAB.
313 | 1 | Perfil tubular 400 x 200 x 16; L 5600 | S275J0H / EN 10219-1 | FAB.
324 | 1 | Perfil tubular 200 x 100 x 10; L 250 | S275J0H / EN 10219-1 | FAB.
328 | 1 | Chapa t50; bruto 250 x 250. Contorno DXF TT10_M121 | ASTM A36 | FAB.
329 | 1 | Perfil tubular 200 x 200 x 12; L 1200 | S275J0H / EN 10219-1 | FAB.
333 | 1 | Chapa t50; bruto 250 x 250. Contorno DXF TT10_M151 | ASTM A36 | FAB.
334 | 1 | Chapa t50; bruto 250 x 250. Contorno DXF TT10_M156 | ASTM A36 | FAB.
335 | 1 | Pieza TT10_M161 | ASTM A36 | FAB.
336 | 1 | Perfil tubular 150 x 100 x 8; L 4800 | S275J0H / EN 10219-1 | FAB.
340 | 1 | Perfil tubular 200 x 150 x 10; L 2200 | S275J0H / EN 10219-1 | FAB.

Lista de materiales: hoja 2.

Cotas en mm.
Perfil tubular 200 x 150 x 10; L 2200
Perfil tubular 150 x 100 x 8; L 4800
Perfil tubular 150 x 100 x 8; L 3600
Perfil tubular 400 x 200 x 16; L 5600
Perfil tubular 200 x 100 x 10; L 250

Bastidor móvil de la tolva

# TT10_C05_PC_05 | Bastidor móvil de la tolva - Lista de materiales

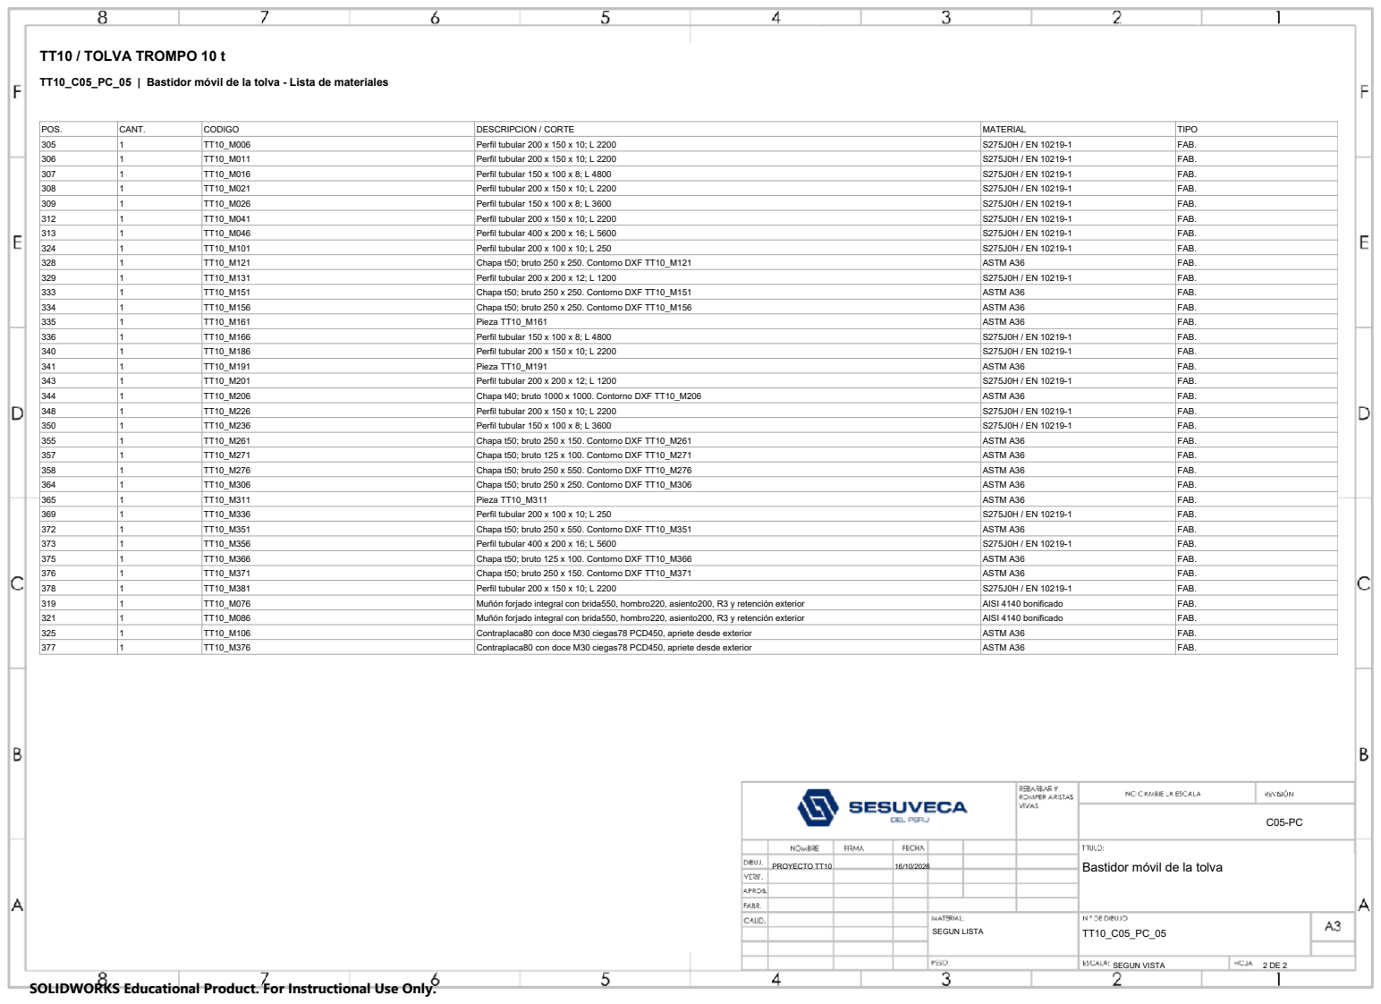
[picture p122: page 9]

PROYECTO TT10 | 16/10/2026

## C05-PC

# Bastidor móvil de la tolva

## TT10_C05_PC_05 SEGUN LISTA

POS. | CANT. | CODIGO | DESCRIPCION / CORTE | MATERIAL | TIPO
305 | 1 | TT10_M006 | Perfil tubular 200 x 150 x 10; L 2200 | S275J0H / EN 10219-1 | FAB.
306 | 1 | TT10_M011 | Perfil tubular 200 x 150 x 10; L 2200 | S275J0H / EN 10219-1 | FAB.
307 | 1 | TT10_M016 | Perfil tubular 150 x 100 x 8; L 4800 | S275J0H / EN 10219-1 | FAB.
308 | 1 | TT10_M021 | Perfil tubular 200 x 150 x 10; L 2200 | S275J0H / EN 10219-1 | FAB.
309 | 1 | TT10_M026 | Perfil tubular 150 x 100 x 8; L 3600 | S275J0H / EN 10219-1 | FAB.
312 | 1 | TT10_M041 | Perfil tubular 200 x 150 x 10; L 2200 | S275J0H / EN 10219-1 | FAB.
313 | 1 | TT10_M046 | Perfil tubular 400 x 200 x 16; L 5600 | S275J0H / EN 10219-1 | FAB.
324 | 1 | TT10_M101 | Perfil tubular 200 x 100 x 10; L 250 | S275J0H / EN 10219-1 | FAB.
328 | 1 | TT10_M121 | Chapa t50; bruto 250 x 250. Contorno DXF TT10_M121 | ASTM A36 | FAB.
329 | 1 | TT10_M131 | Perfil tubular 200 x 200 x 12; L 1200 | S275J0H / EN 10219-1 | FAB.
333 | 1 | TT10_M151 | Chapa t50; bruto 250 x 250. Contorno DXF TT10_M151 | ASTM A36 | FAB.
334 | 1 | TT10_M156 | Chapa t50; bruto 250 x 250. Contorno DXF TT10_M156 | ASTM A36 | FAB.
335 | 1 | TT10_M161 | Pieza TT10_M161 | ASTM A36 | FAB.
336 | 1 | TT10_M166 | Perfil tubular 150 x 100 x 8; L 4800 | S275J0H / EN 10219-1 | FAB.
340 | 1 | TT10_M186 | Perfil tubular 200 x 150 x 10; L 2200 | S275J0H / EN 10219-1 | FAB.
341 | 1 | TT10_M191 | Pieza TT10_M191 | ASTM A36 | FAB.
343 | 1 | TT10_M201 | Perfil tubular 200 x 200 x 12; L 1200 | S275J0H / EN 10219-1 | FAB.
344 | 1 | TT10_M206 | Chapa t40; bruto 1000 x 1000. Contorno DXF TT10_M206 | ASTM A36 | FAB.
348 | 1 | TT10_M226 | Perfil tubular 200 x 150 x 10; L 2200 | S275J0H / EN 10219-1 | FAB.
350 | 1 | TT10_M236 | Perfil tubular 150 x 100 x 8; L 3600 | S275J0H / EN 10219-1 | FAB.
355 | 1 | TT10_M261 | Chapa t50; bruto 250 x 150. Contorno DXF TT10_M261 | ASTM A36 | FAB.
357 | 1 | TT10_M271 | Chapa t50; bruto 125 x 100. Contorno DXF TT10_M271 | ASTM A36 | FAB.
358 | 1 | TT10_M276 | Chapa t50; bruto 250 x 550. Contorno DXF TT10_M276 | ASTM A36 | FAB.
364 | 1 | TT10_M306 | Chapa t50; bruto 250 x 250. Contorno DXF TT10_M306 | ASTM A36 | FAB.
365 | 1 | TT10_M311 | Pieza TT10_M311 | ASTM A36 | FAB.
369 | 1 | TT10_M336 | Perfil tubular 200 x 100 x 10; L 250 | S275J0H / EN 10219-1 | FAB.
372 | 1 | TT10_M351 | Chapa t50; bruto 250 x 550. Contorno DXF TT10_M351 | ASTM A36 | FAB.
373 | 1 | TT10_M356 | Perfil tubular 400 x 200 x 16; L 5600 | S275J0H / EN 10219-1 | FAB.
375 | 1 | TT10_M366 | Chapa t50; bruto 125 x 100. Contorno DXF TT10_M366 | ASTM A36 | FAB.
376 | 1 | TT10_M371 | Chapa t50; bruto 250 x 150. Contorno DXF TT10_M371 | ASTM A36 | FAB.
378 | 1 | TT10_M381 | Perfil tubular 200 x 150 x 10; L 2200 | S275J0H / EN 10219-1 | FAB.
319 | 1 | TT10_M076 | Muñón forjado integral con brida550, hombro220, asiento200, R3 y retención exterior | AISI 4140 bonificado | FAB.
321 | 1 | TT10_M086 | Muñón forjado integral con brida550, hombro220, asiento200, R3 y retención exterior | AISI 4140 bonificado | FAB.
325 | 1 | TT10_M106 | Contraplaca80 con doce M30 ciegas78 PCD450, apriete desde exterior | ASTM A36 | FAB.
377 | 1 | TT10_M376 | Contraplaca80 con doce M30 ciegas78 PCD450, apriete desde exterior | ASTM A36 | FAB.

720.00

# TT10_C05_PC_06 | Tolva: paneles laterales y refuerzos

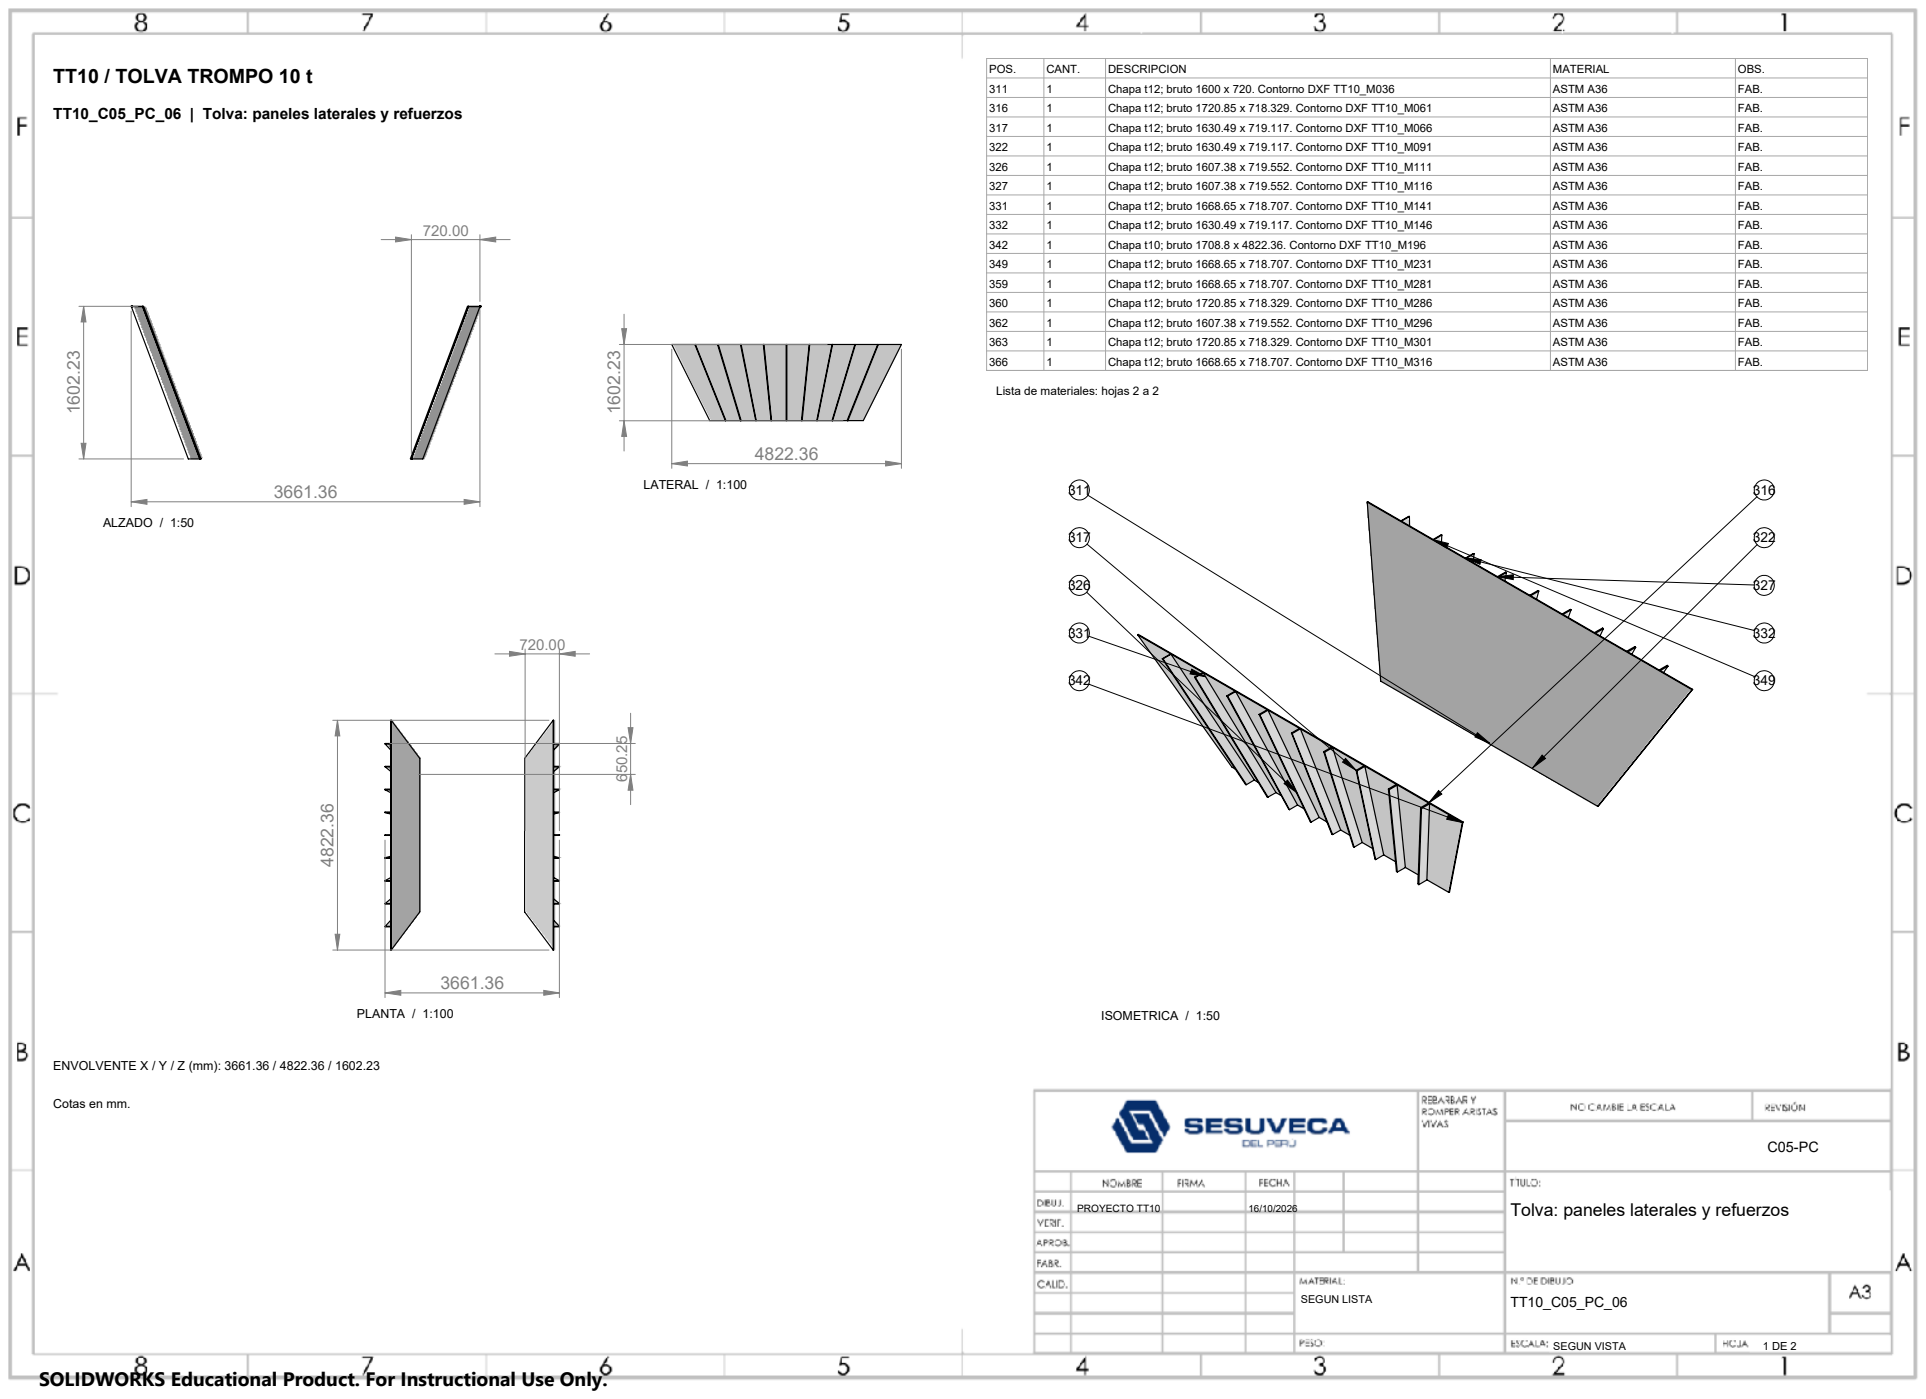
[picture p123: page 10]
PROYECTO TT10; TT10_C05_PC_06 SEGUN LISTA; ENVOLVENTE X / Y / Z (mm): 3661.36 / 4822.36 / 1602.23; ALZADO / 1:50; LATERAL / 1:100; PLANTA / 1:100; ISOMETRICA / 1:50

311 | 1 | Chapa t12; bruto 1600 x 720. Contorno DXF TT10_M036 | ASTM A36 | FAB.
316 | 1 | Chapa t12; bruto 1720.85 x 718.329. Contorno DXF TT10_M061 | ASTM A36 | FAB.
317 | 1 | Chapa t12; bruto 1630.49 x 719.117. Contorno DXF TT10_M066 | ASTM A36 | FAB.
322 | 1 | Chapa t12; bruto 1630.49 x 719.117. Contorno DXF TT10_M091 | ASTM A36 | FAB.
326 | 1 | Chapa t12; bruto 1607.38 x 719.552. Contorno DXF TT10_M111 | ASTM A36 | FAB.
327 | 1 | Chapa t12; bruto 1607.38 x 719.552. Contorno DXF TT10_M116 | ASTM A36 | FAB.
331 | 1 | Chapa t12; bruto 1668.65 x 718.707. Contorno DXF TT10_M141 | ASTM A36 | FAB.
332 | 1 | Chapa t12; bruto 1630.49 x 719.117. Contorno DXF TT10_M146 | ASTM A36 | FAB.
342 | 1 | Chapa t10; bruto 1708.8 x 4822.36. Contorno DXF TT10_M196 | ASTM A36 | FAB.
349 | 1 | Chapa t12; bruto 1668.65 x 718.707. Contorno DXF TT10_M231 | ASTM A36 | FAB.
359 | 1 | Chapa t12; bruto 1668.65 x 718.707. Contorno DXF TT10_M281 | ASTM A36 | FAB.
360 | 1 | Chapa t12; bruto 1720.85 x 718.329. Contorno DXF TT10_M286 | ASTM A36 | FAB.
362 | 1 | Chapa t12; bruto 1607.38 x 719.552. Contorno DXF TT10_M296 | ASTM A36 | FAB.
363 | 1 | Chapa t12; bruto 1720.85 x 718.329. Contorno DXF TT10_M301 | ASTM A36 | FAB.
366 | 1 | Chapa t12; bruto 1668.65 x 718.707. Contorno DXF TT10_M316 | ASTM A36 | FAB.

Lista de materiales: hojas 2 a 2

Cotas en mm.

Tolva: paneles laterales y refuerzos

# TT10_C05_PC_06 | Tolva: paneles laterales y refuerzos - Lista de materiales

PROYECTO TT10 | 16/10/2026

## C05-PC

# Tolva: paneles laterales y refuerzos

## TT10_C05_PC_06 SEGUN LISTA

POS. | CANT. | CODIGO | DESCRIPCION / CORTE | MATERIAL | TIPO
311 | 1 | TT10_M036 | Chapa t12; bruto 1600 x 720. Contorno DXF TT10_M036 | ASTM A36 | FAB.
316 | 1 | TT10_M061 | Chapa t12; bruto 1720.85 x 718.329. Contorno DXF TT10_M061 | ASTM A36 | FAB.
317 | 1 | TT10_M066 | Chapa t12; bruto 1630.49 x 719.117. Contorno DXF TT10_M066 | ASTM A36 | FAB.
322 | 1 | TT10_M091 | Chapa t12; bruto 1630.49 x 719.117. Contorno DXF TT10_M091 | ASTM A36 | FAB.
326 | 1 | TT10_M111 | Chapa t12; bruto 1607.38 x 719.552. Contorno DXF TT10_M111 | ASTM A36 | FAB.
327 | 1 | TT10_M116 | Chapa t12; bruto 1607.38 x 719.552. Contorno DXF TT10_M116 | ASTM A36 | FAB.
331 | 1 | TT10_M141 | Chapa t12; bruto 1668.65 x 718.707. Contorno DXF TT10_M141 | ASTM A36 | FAB.
332 | 1 | TT10_M146 | Chapa t12; bruto 1630.49 x 719.117. Contorno DXF TT10_M146 | ASTM A36 | FAB.
342 | 1 | TT10_M196 | Chapa t10; bruto 1708.8 x 4822.36. Contorno DXF TT10_M196 | ASTM A36 | FAB.
349 | 1 | TT10_M231 | Chapa t12; bruto 1668.65 x 718.707. Contorno DXF TT10_M231 | ASTM A36 | FAB.
359 | 1 | TT10_M281 | Chapa t12; bruto 1668.65 x 718.707. Contorno DXF TT10_M281 | ASTM A36 | FAB.
360 | 1 | TT10_M286 | Chapa t12; bruto 1720.85 x 718.329. Contorno DXF TT10_M286 | ASTM A36 | FAB.
362 | 1 | TT10_M296 | Chapa t12; bruto 1607.38 x 719.552. Contorno DXF TT10_M296 | ASTM A36 | FAB.
363 | 1 | TT10_M301 | Chapa t12; bruto 1720.85 x 718.329. Contorno DXF TT10_M301 | ASTM A36 | FAB.
366 | 1 | TT10_M316 | Chapa t12; bruto 1668.65 x 718.707. Contorno DXF TT10_M316 | ASTM A36 | FAB.
367 | 1 | TT10_M326 | Chapa t10; bruto 1708.8 x 4822.36. Contorno DXF TT10_M326 | ASTM A36 | FAB.
368 | 1 | TT10_M331 | Chapa t12; bruto 1600 x 720. Contorno DXF TT10_M331 | ASTM A36 | FAB.
370 | 1 | TT10_M341 | Chapa t12; bruto 1607.38 x 719.552. Contorno DXF TT10_M341 | ASTM A36 | FAB.
371 | 1 | TT10_M346 | Chapa t12; bruto 1630.49 x 719.117. Contorno DXF TT10_M346 | ASTM A36 | FAB.
381 | 1 | TT10_M396 | Chapa t12; bruto 1720.85 x 718.329. Contorno DXF TT10_M396 | ASTM A36 | FAB.

2200.00

# TT10_C05_PC_07 | Tolva: testeros, refuerzos y fondo

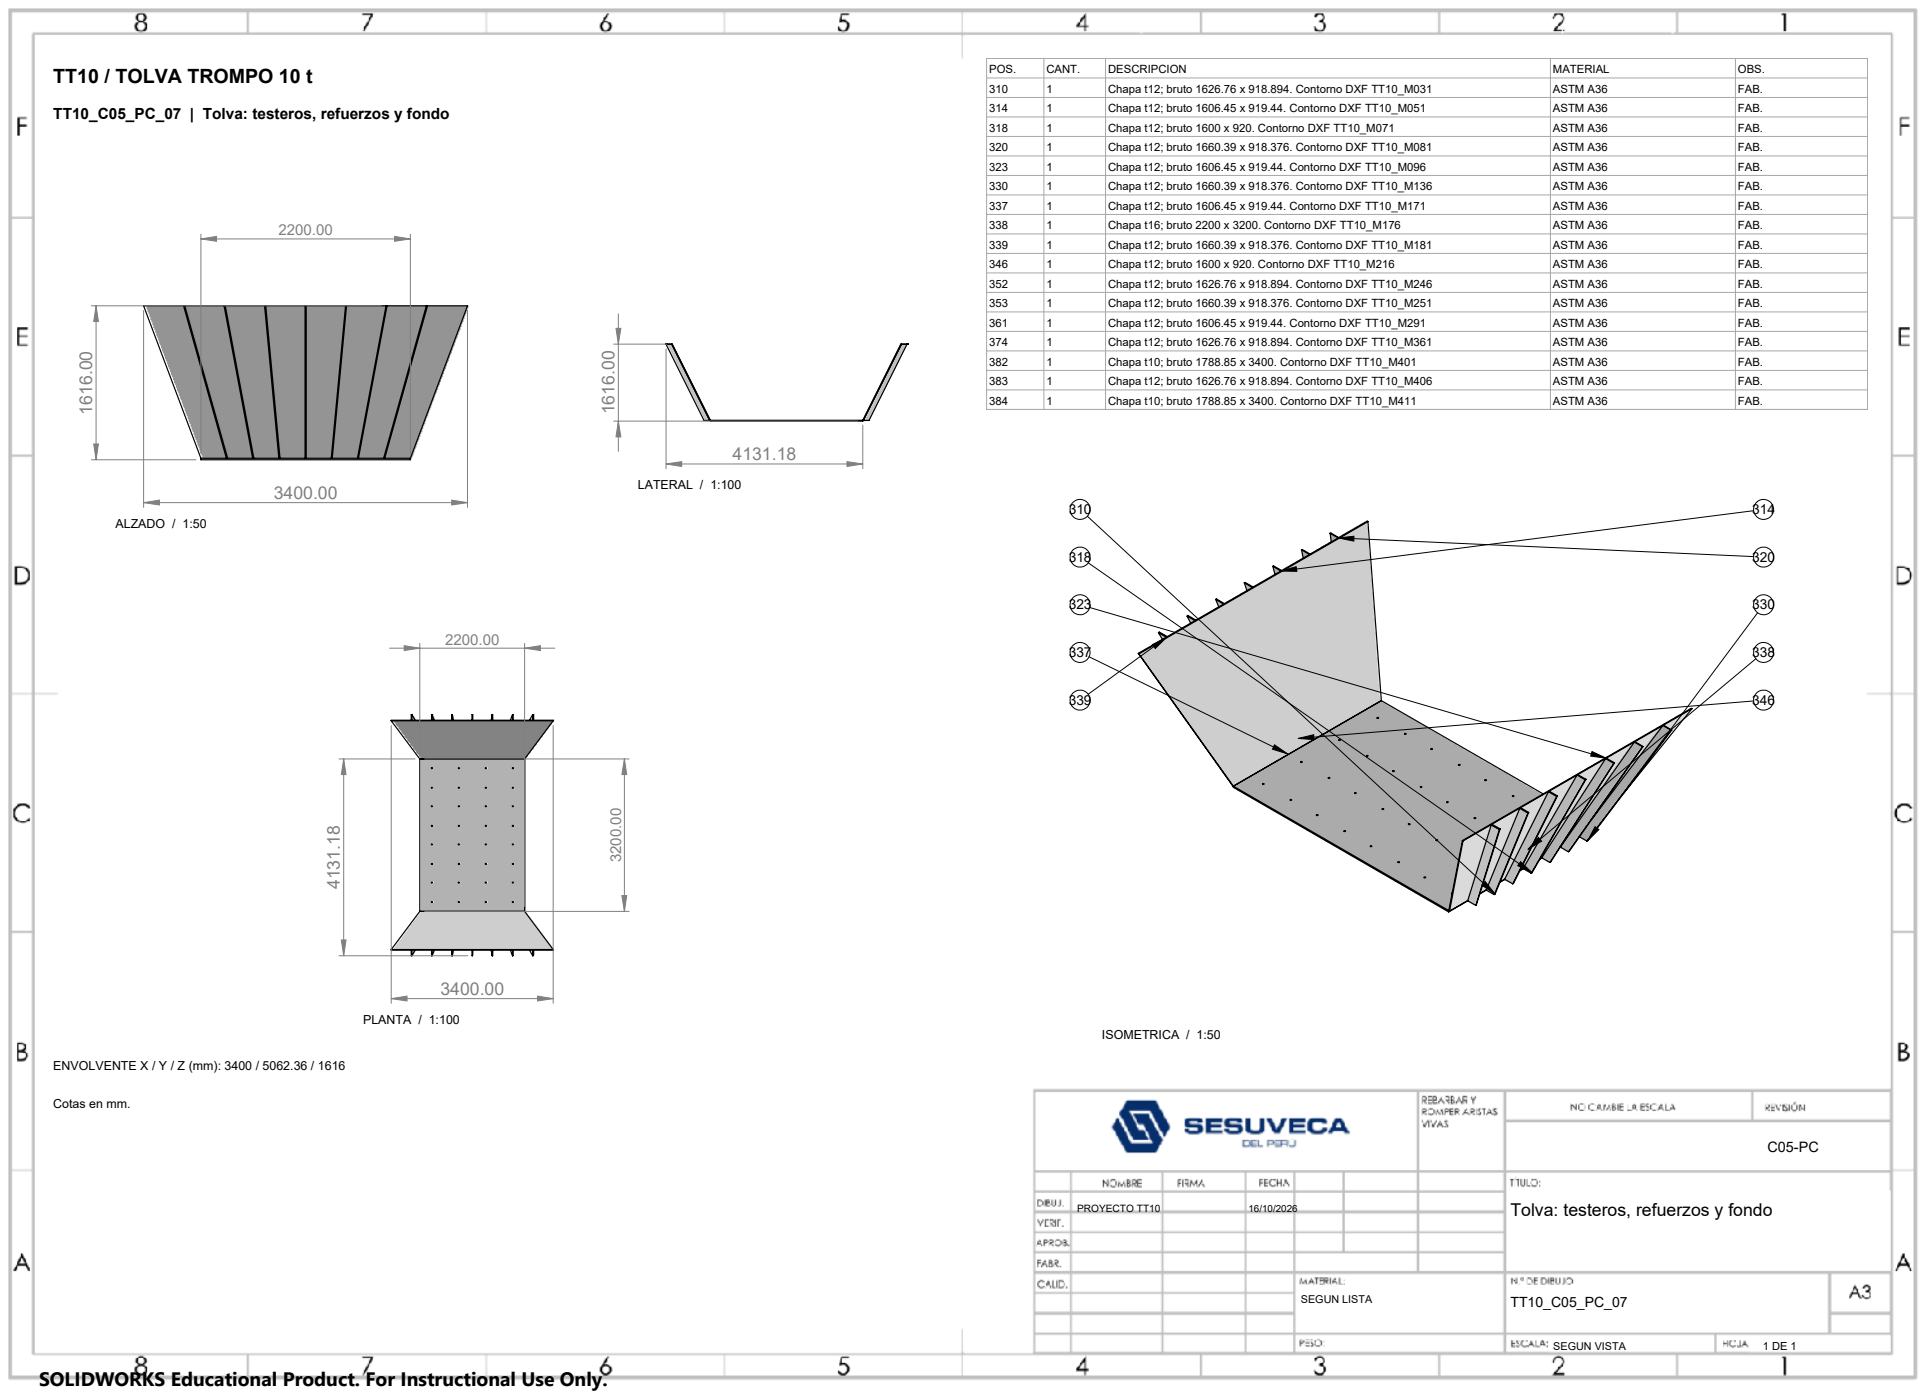
[picture p124: page 12]
PROYECTO TT10; TT10_C05_PC_07 SEGUN LISTA; ENVOLVENTE X / Y / Z (mm): 3400 / 5062.36 / 1616; ALZADO / 1:50; LATERAL / 1:100; PLANTA / 1:100; ISOMETRICA / 1:50

310 | 1 | Chapa t12; bruto 1626.76 x 918.894. Contorno DXF TT10_M031 | ASTM A36 | FAB.
314 | 1 | Chapa t12; bruto 1606.45 x 919.44. Contorno DXF TT10_M051 | ASTM A36 | FAB.
318 | 1 | Chapa t12; bruto 1600 x 920. Contorno DXF TT10_M071 | ASTM A36 | FAB.
320 | 1 | Chapa t12; bruto 1660.39 x 918.376. Contorno DXF TT10_M081 | ASTM A36 | FAB.
323 | 1 | Chapa t12; bruto 1606.45 x 919.44. Contorno DXF TT10_M096 | ASTM A36 | FAB.
330 | 1 | Chapa t12; bruto 1660.39 x 918.376. Contorno DXF TT10_M136 | ASTM A36 | FAB.
337 | 1 | Chapa t12; bruto 1606.45 x 919.44. Contorno DXF TT10_M171 | ASTM A36 | FAB.
338 | 1 | Chapa t16; bruto 2200 x 3200. Contorno DXF TT10_M176 | ASTM A36 | FAB.
339 | 1 | Chapa t12; bruto 1660.39 x 918.376. Contorno DXF TT10_M181 | ASTM A36 | FAB.
346 | 1 | Chapa t12; bruto 1600 x 920. Contorno DXF TT10_M216 | ASTM A36 | FAB.
352 | 1 | Chapa t12; bruto 1626.76 x 918.894. Contorno DXF TT10_M246 | ASTM A36 | FAB.
353 | 1 | Chapa t12; bruto 1660.39 x 918.376. Contorno DXF TT10_M251 | ASTM A36 | FAB.
361 | 1 | Chapa t12; bruto 1606.45 x 919.44. Contorno DXF TT10_M291 | ASTM A36 | FAB.
374 | 1 | Chapa t12; bruto 1626.76 x 918.894. Contorno DXF TT10_M361 | ASTM A36 | FAB.
382 | 1 | Chapa t10; bruto 1788.85 x 3400. Contorno DXF TT10_M401 | ASTM A36 | FAB.
383 | 1 | Chapa t12; bruto 1626.76 x 918.894. Contorno DXF TT10_M406 | ASTM A36 | FAB.
384 | 1 | Chapa t10; bruto 1788.85 x 3400. Contorno DXF TT10_M411 | ASTM A36 | FAB.

Cotas en mm.

Tolva: testeros, refuerzos y fondo

# TT10_C05_PC_08 | Revestimientos desmontables y camas de apoyo

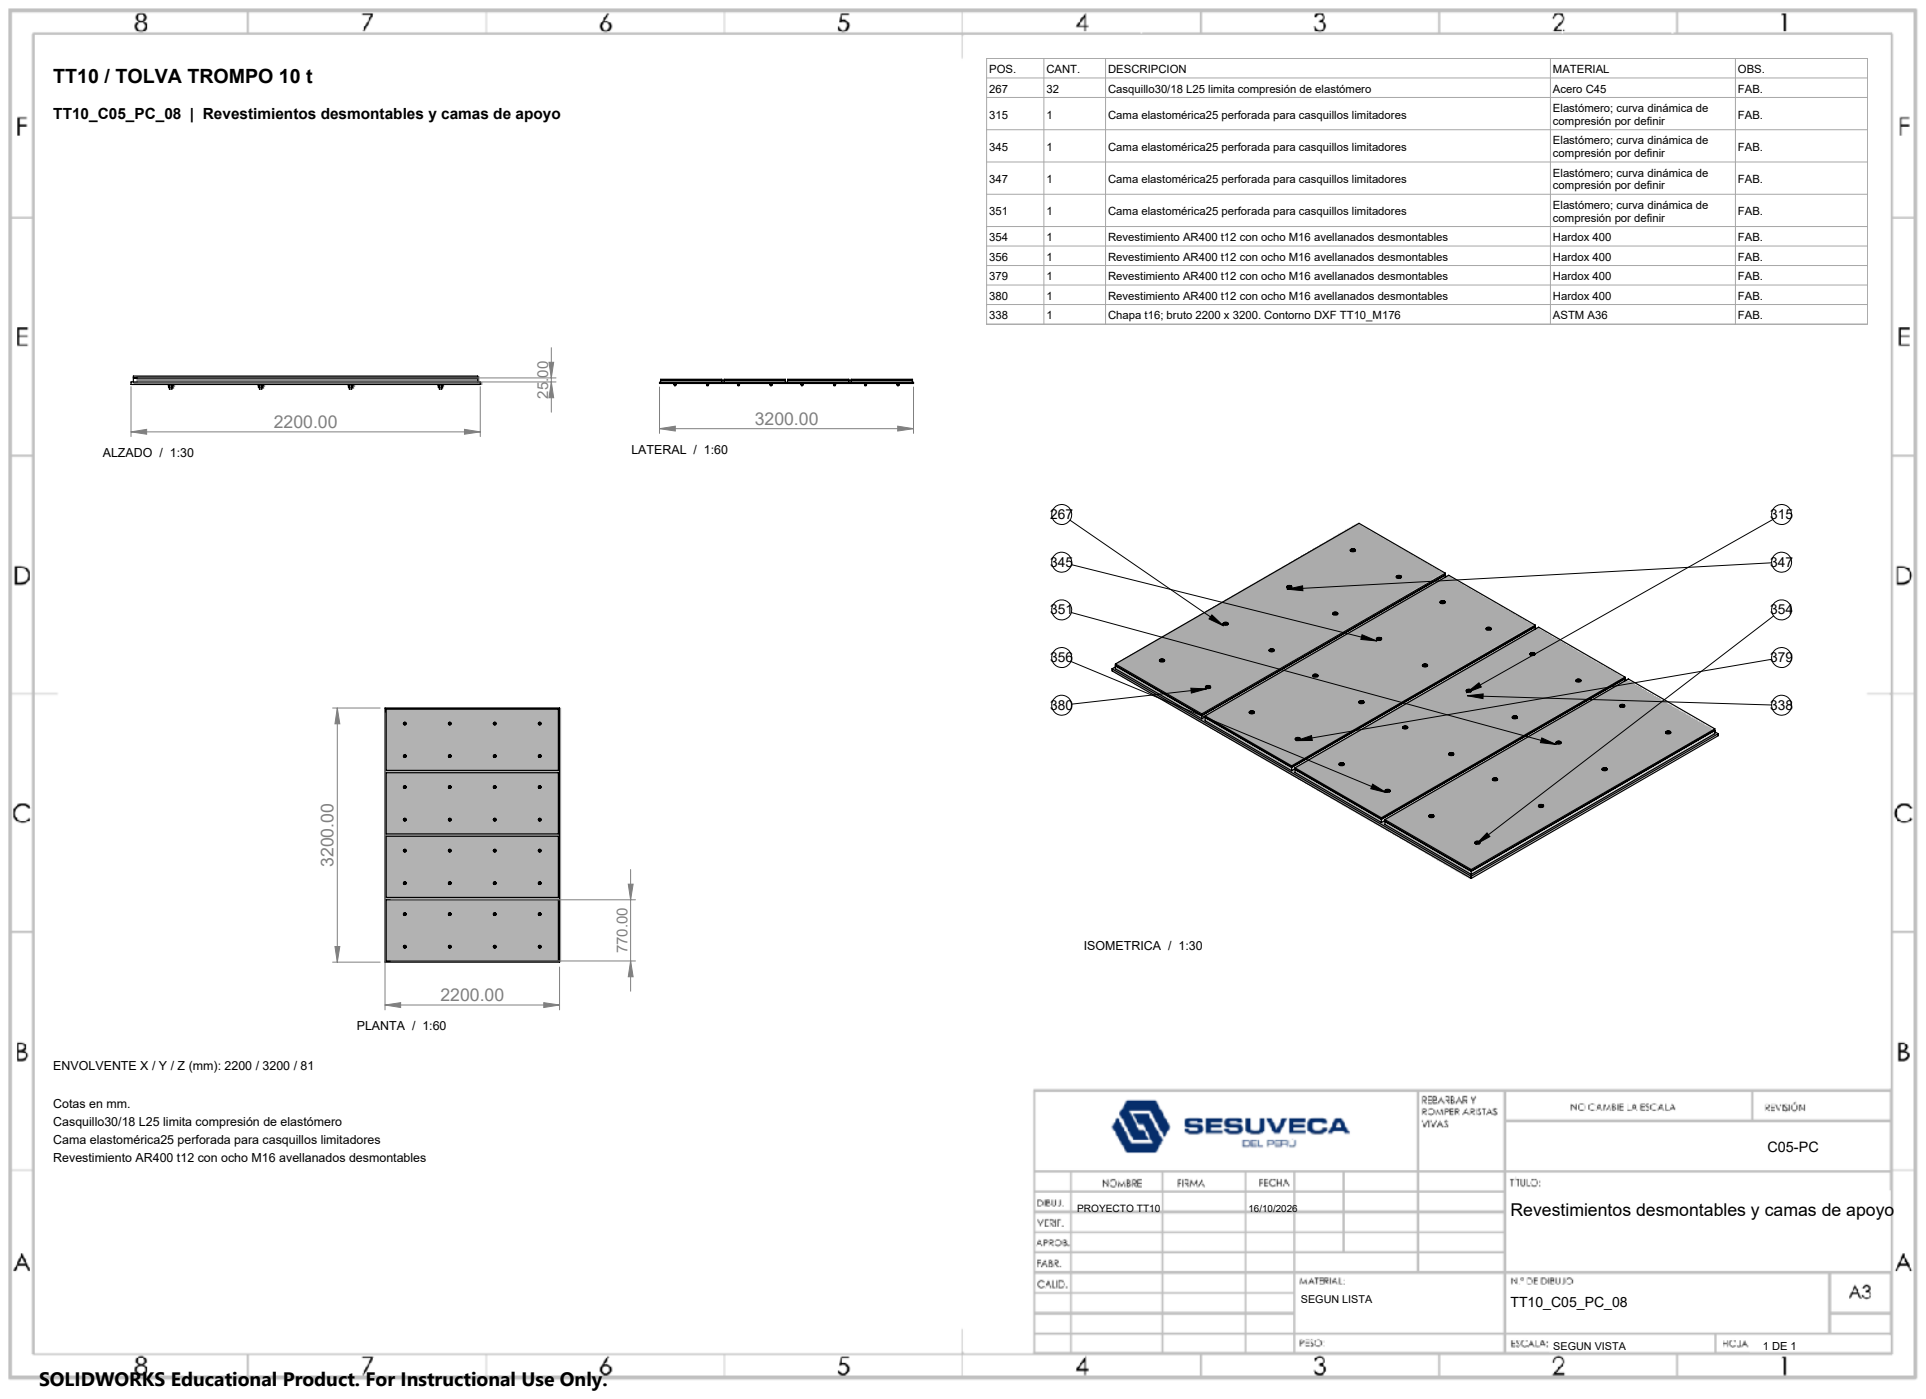
[picture p125: page 13]
PROYECTO TT10; TT10_C05_PC_08 SEGUN LISTA; ENVOLVENTE X / Y / Z (mm): 2200 / 3200 / 81; ALZADO / 1:30; LATERAL / 1:60; PLANTA / 1:60; ISOMETRICA / 1:30

267 | 32 | Casquillo30/18 L25 limita compresión de elastómero | Acero C45 | FAB.
315 | 1 | Cama elastomérica25 perforada para casquillos limitadores | Elastómero; curva dinámica de compresión por definir | FAB.

345 | 1 | Cama elastomérica25 perforada para casquillos limitadores | Elastómero; curva dinámica de compresión por definir | FAB.

347 | 1 | Cama elastomérica25 perforada para casquillos limitadores | Elastómero; curva dinámica de compresión por definir | FAB.

351 | 1 | Cama elastomérica25 perforada para casquillos limitadores | Elastómero; curva dinámica de compresión por definir | FAB.

354 | 1 | Revestimiento AR400 t12 con ocho M16 avellanados desmontables | Hardox 400 | FAB.
356 | 1 | Revestimiento AR400 t12 con ocho M16 avellanados desmontables | Hardox 400 | FAB.
379 | 1 | Revestimiento AR400 t12 con ocho M16 avellanados desmontables | Hardox 400 | FAB.
380 | 1 | Revestimiento AR400 t12 con ocho M16 avellanados desmontables | Hardox 400 | FAB.
338 | 1 | Chapa t16; bruto 2200 x 3200. Contorno DXF TT10_M176 | ASTM A36 | FAB.

Cotas en mm.
Casquillo30/18 L25 limita compresión de elastómero
Cama elastomérica25 perforada para casquillos limitadores
Revestimiento AR400 t12 con ocho M16 avellanados desmontables

Revestimientos desmontables y camas de apoyo

640.00

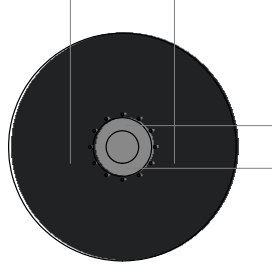
[picture p126: figure]

262.59

640.00

149 | 150
180 | 181
319 | 321
325 | 377
221 | 222

# TT10_C05_PC_09 | Muñones, bridas, cubos y apoyos de giro

PROYECTO TT10 | 16/10/2026

## C05-PC

# Muñones, bridas, cubos y apoyos de giro

## TT10_C05_PC_09 SEGUN LISTA

## Lista de materiales: hojas 2 a 2

## ENVOLVENTE X / Y / Z (mm): 1400 / 7462.5 / 1400

## ALZADO / 1:30
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
