acevedocrisologopablo48-lgtm/sesuveca-tolva-p04/dist/documentos/TT10_C05_DESPIECE_COMPLETO.pdf

F | F
E | E

ISOMÉTRICA / SIN ESCALA

Unidades: mm. Rebarbar.
Radios y ajustes: cotas particulares.
Geometría aprobada por el cliente.
Liberación técnica no emitida.

INDICACIONES PARTICULARES
Base de pedestal de freno N

Acero estructural; grado sin definir

No sustituir materiales ni aplicar tolerancias generales sobre un ajuste indicado.

F | F
E | E

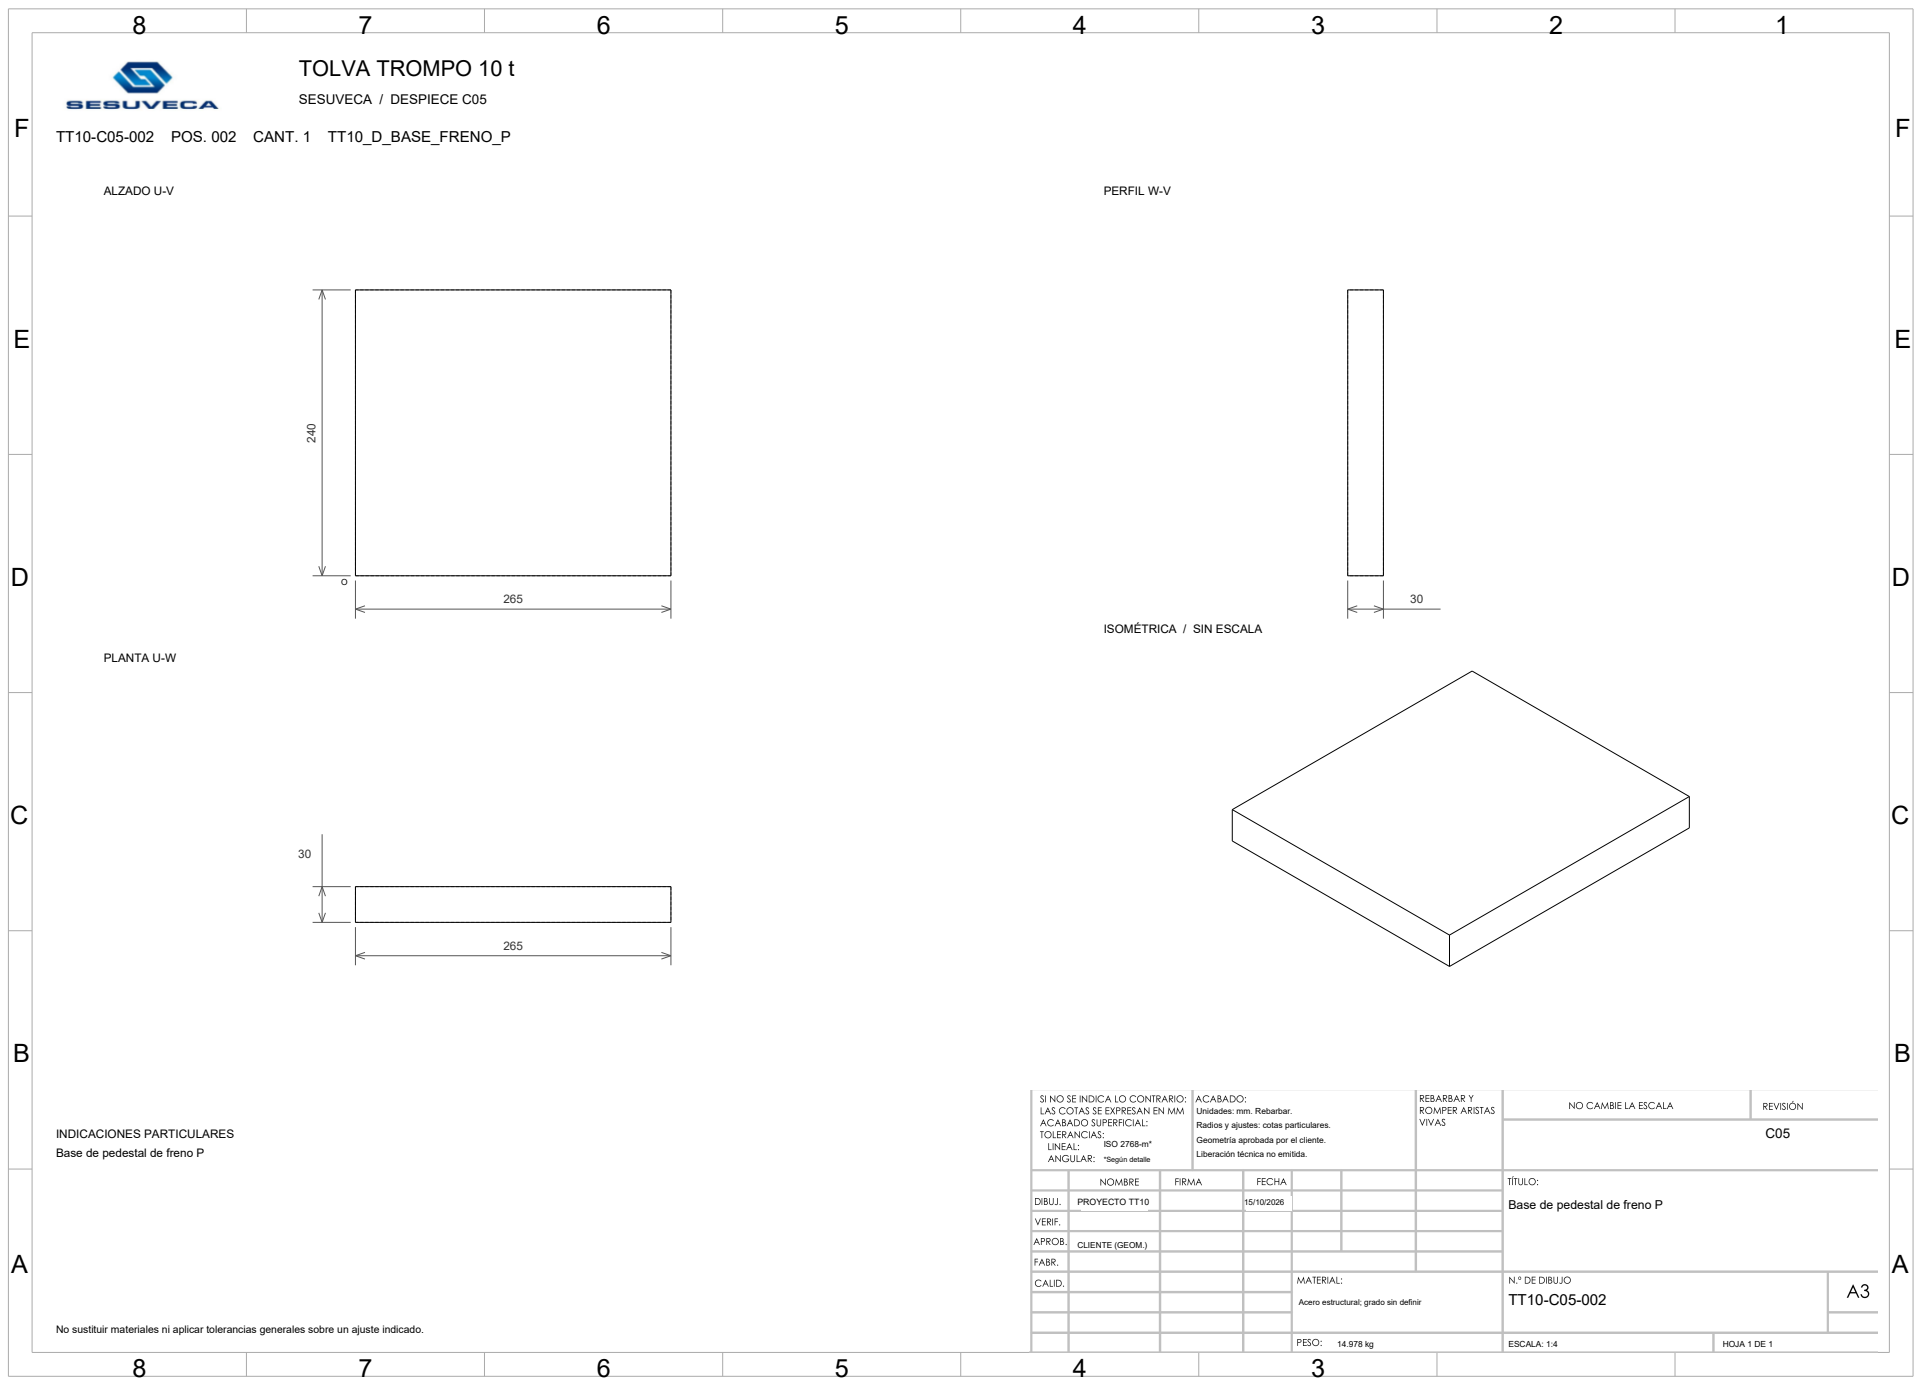
[picture p127: page 2]
TT10-C05-002 POS. 002 CANT. 1 TT10_D_BASE_FRENO_P; PROYECTO TT10; CLIENTE (GEOM.); ISO 2768-m*; *Según detalle; ESCALA: 1:4; HOJA 1 DE 1; ALZADO U-V; PLANTA U-W; PERFIL W-V

ISOMÉTRICA / SIN ESCALA

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

INDICACIONES PARTICULARES
Base de pedestal de freno P

Acero estructural; grado sin definir

F | F
E | E

ISOMÉTRICA / SIN ESCALA

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

INDICACIONES PARTICULARES
Placa base del segundo apoyo de bancada

Acero estructural; grado sin definir

F | F
E | E

ISOMÉTRICA / SIN ESCALA

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

INDICACIONES PARTICULARES
Apoyo lateral desmontable de bancada

Acero estructural; grado sin definir

F | F
E | E

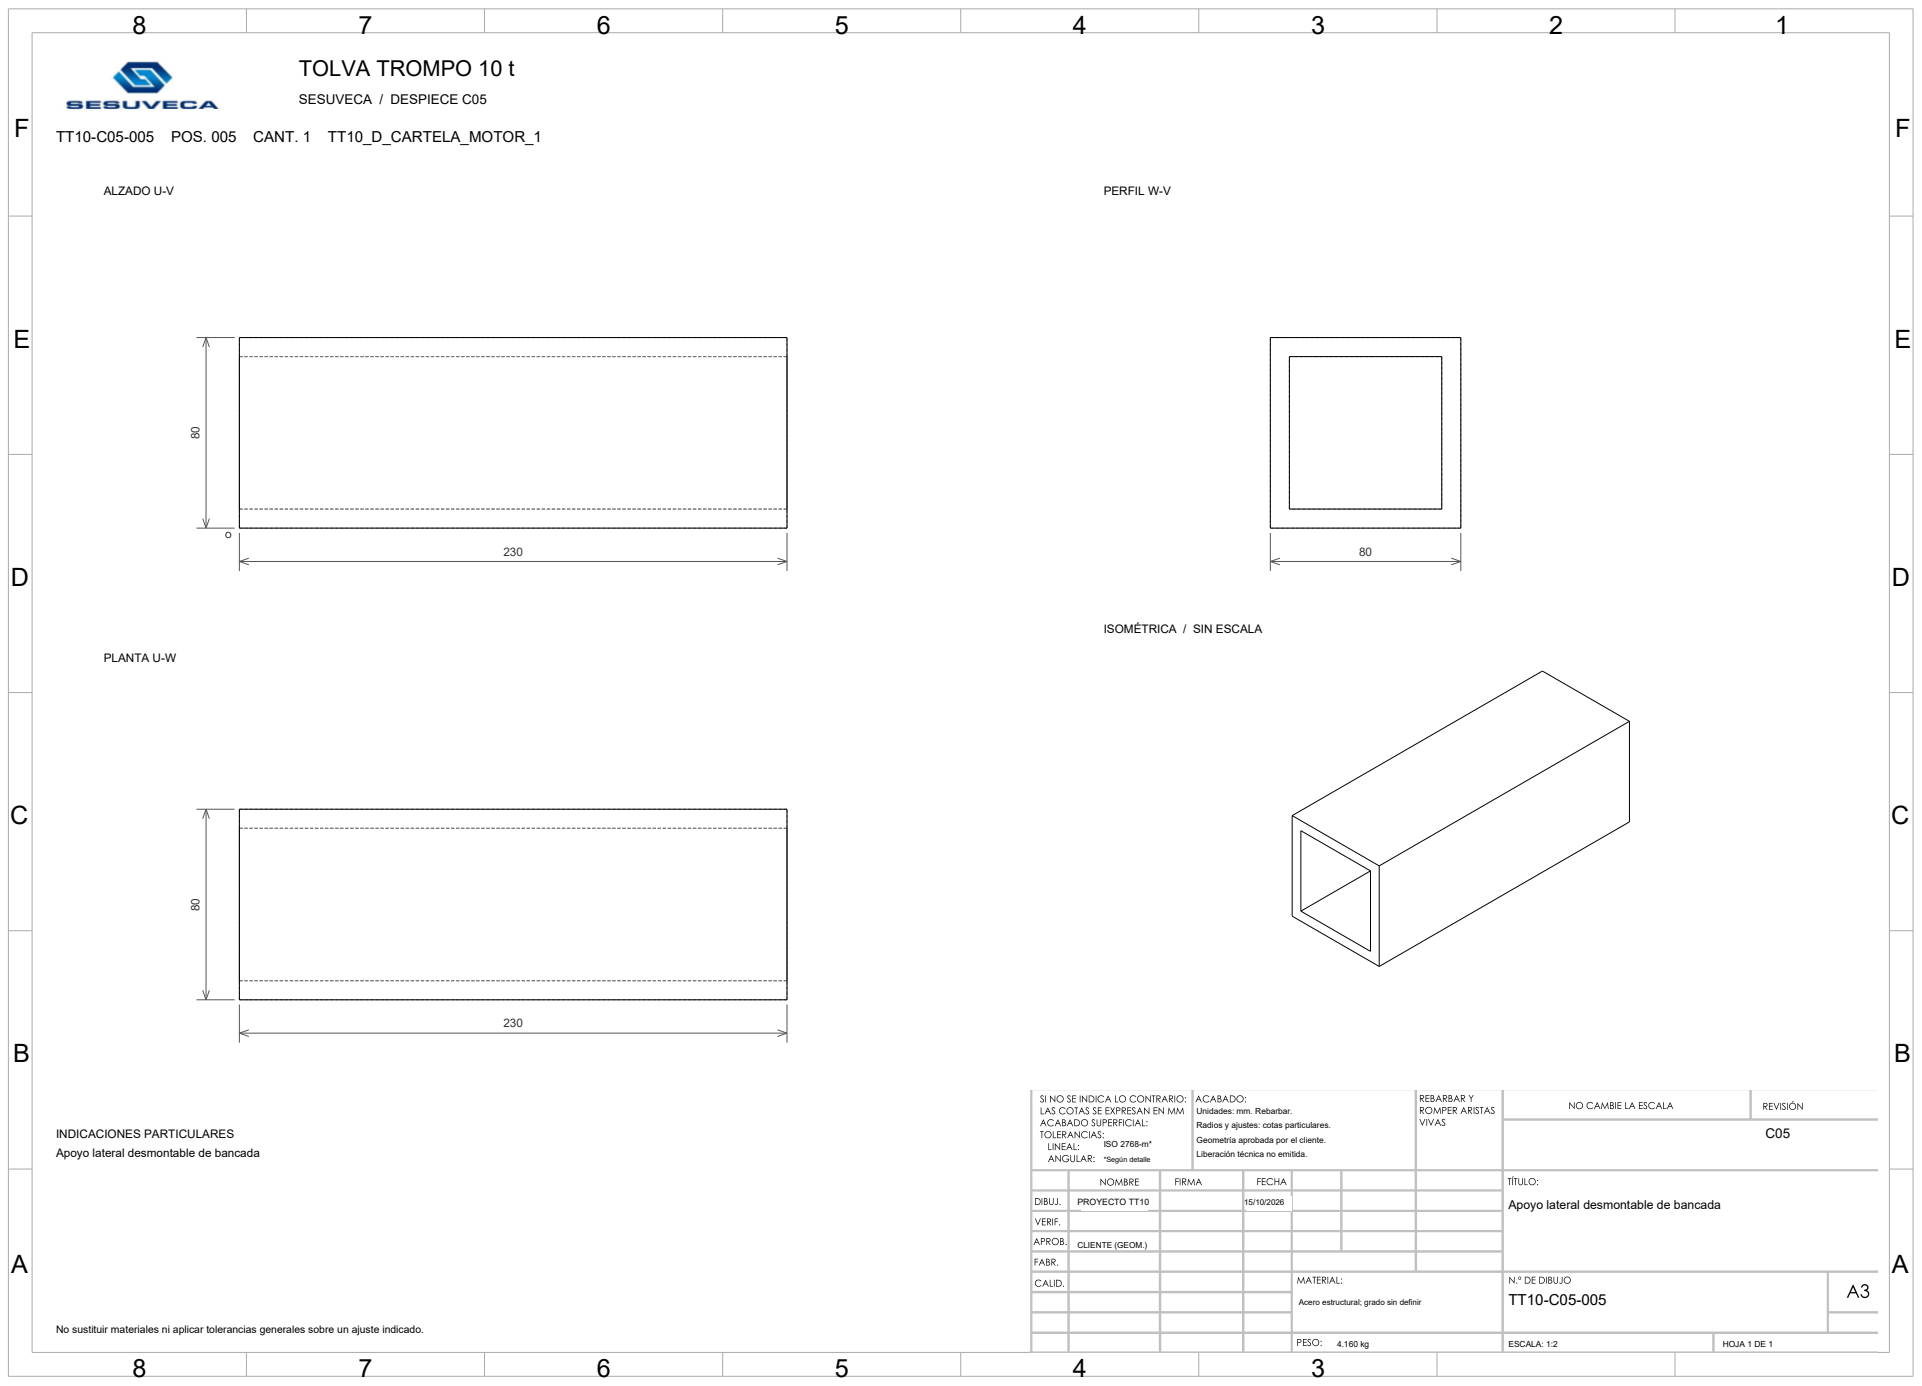
[picture p128: page 5]
TT10-C05-005 POS. 005 CANT. 1 TT10_D_CARTELA_MOTOR_1; PROYECTO TT10; CLIENTE (GEOM.); ISO 2768-m*; *Según detalle; ESCALA: 1:2; HOJA 1 DE 1; ALZADO U-V; PLANTA U-W; PERFIL W-V

ISOMÉTRICA / SIN ESCALA

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

INDICACIONES PARTICULARES
Apoyo lateral desmontable de bancada

Acero estructural; grado sin definir

F | F
E | E

ISOMÉTRICA / SIN ESCALA

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

INDICACIONES PARTICULARES
Columna adicional RHS200x200; asiento sobre placa base

Acero estructural; grado sin definir

F | F
E | E

ISOMÉTRICA / SIN ESCALA

Centros: eje U (V,W); eje V (U,W); eje W (U,V). O = mínimos U,V,W.
SUPERFICIES CILÍNDRICAS (U,V,W)

01 Ø50.000 eje U centro (25.00; 25.00) tramo 0.00 a 65.00

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

INDICACIONES PARTICULARES
COMPRA. NO FABRICAR EL CONTORNO REPRESENTADO.
Referencia: Equipo nominal, sin referencia de pedido aceptada.

Eje de conexión geométrica ENTRADA_REDUCTOR

F | F
E | E

ISOMÉTRICA / SIN ESCALA

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

01 Ø16.000 eje U centro (8.00; 8.00) tramo 0.00 a 65.00

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

INDICACIONES PARTICULARES
Eje de conexión geométrica LIBERACION_FRENO_N

Acero estructural; grado sin definir

F | F
E | E

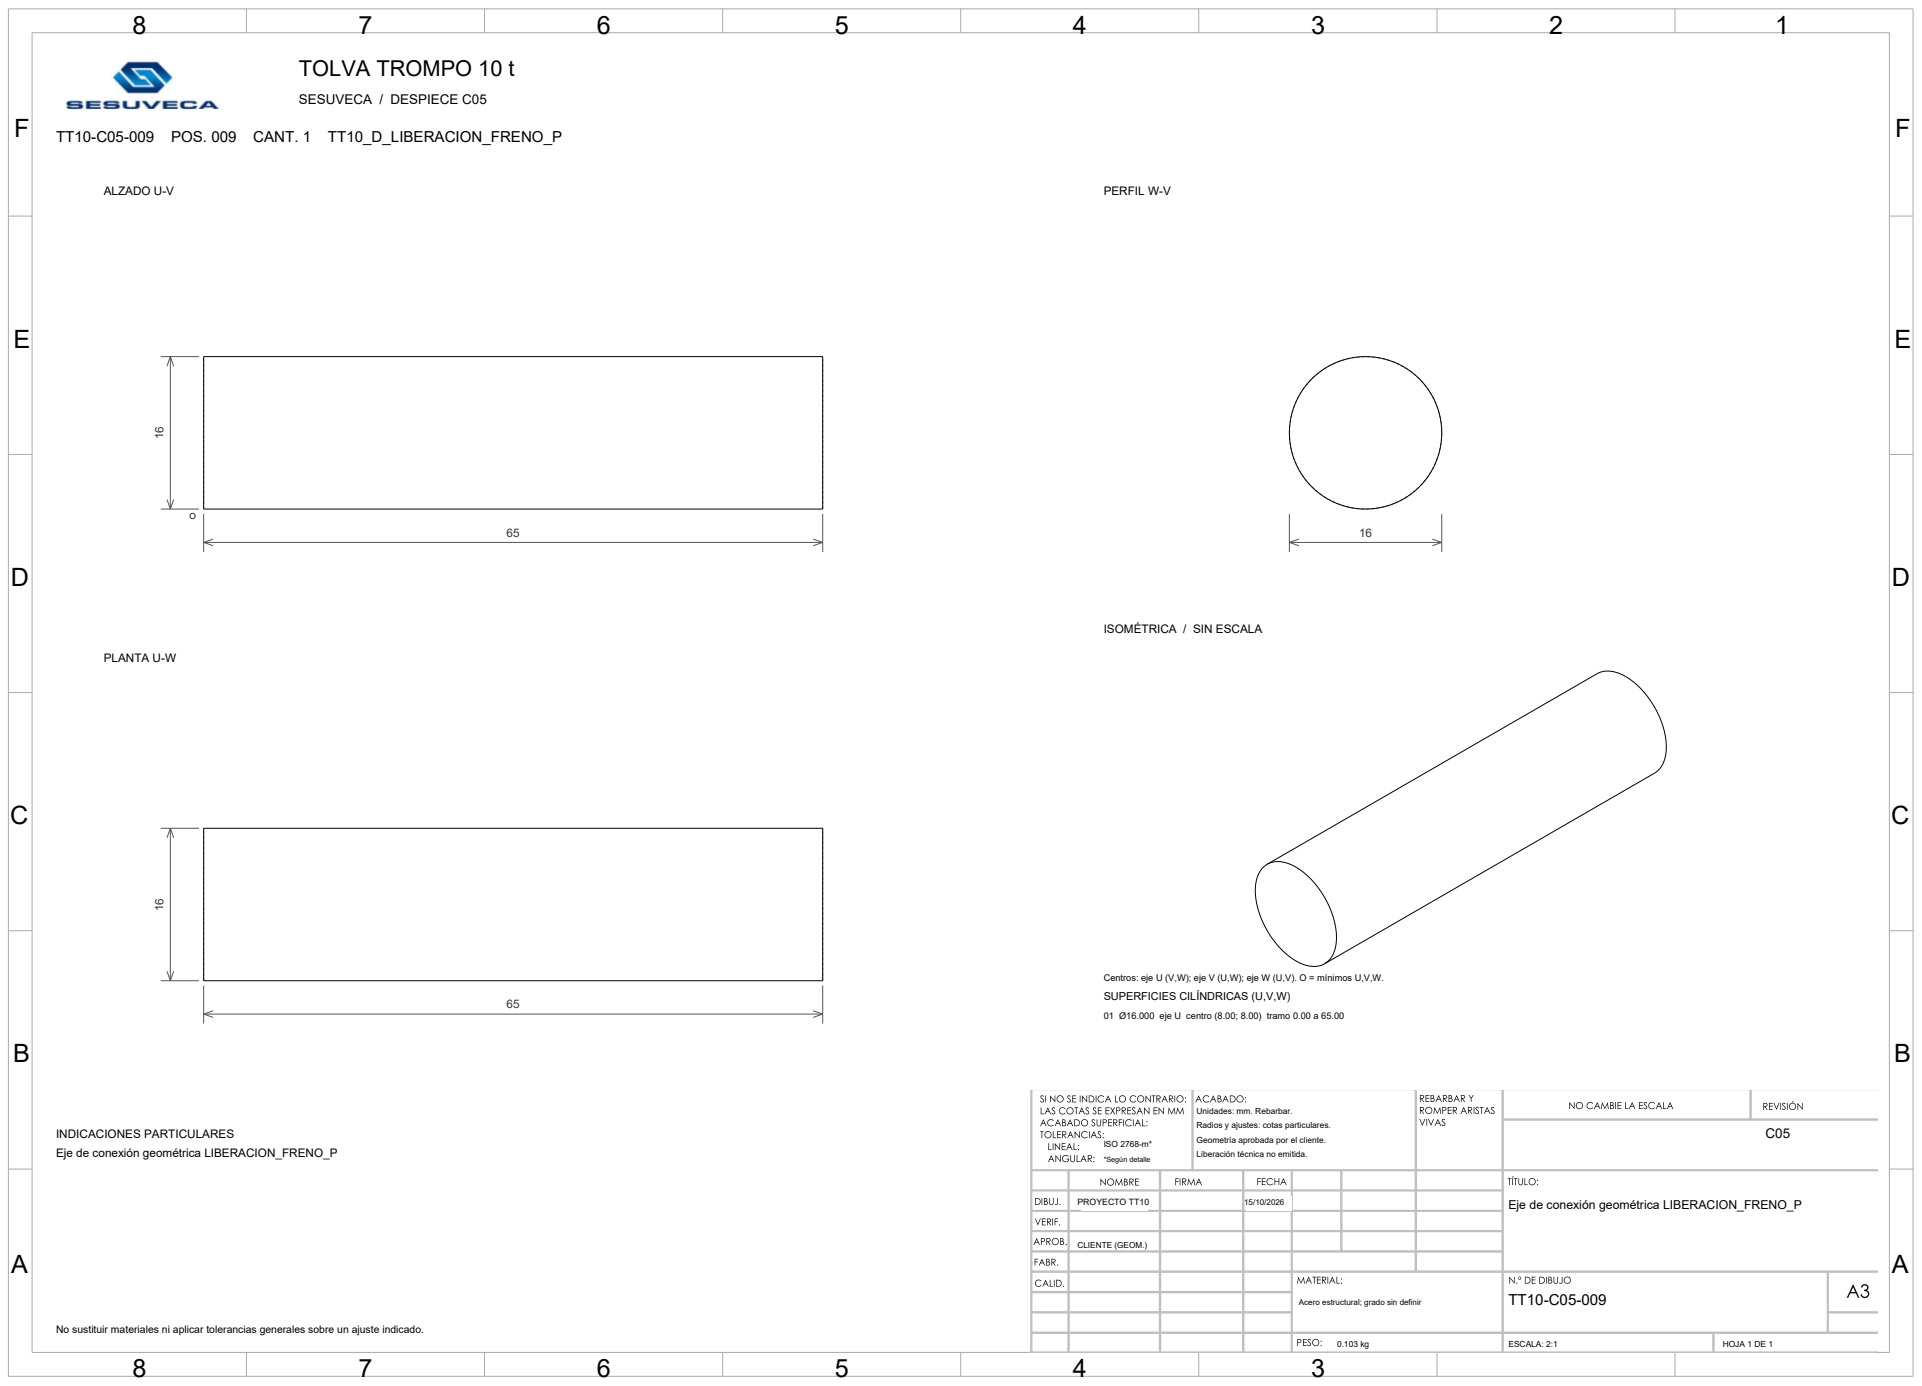
[picture p129: page 9]
TT10-C05-009 POS. 009 CANT. 1 TT10_D_LIBERACION_FRENO_P; PROYECTO TT10; CLIENTE (GEOM.); ISO 2768-m*; *Según detalle; ESCALA: 2:1; HOJA 1 DE 1; ALZADO U-V; PLANTA U-W; PERFIL W-V

ISOMÉTRICA / SIN ESCALA

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

01 Ø16.000 eje U centro (8.00; 8.00) tramo 0.00 a 65.00

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

INDICACIONES PARTICULARES
Eje de conexión geométrica LIBERACION_FRENO_P

Acero estructural; grado sin definir

F | F
E | E

ISOMÉTRICA / SIN ESCALA

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

01 Ø16.000 eje V centro (370.00; 385.00) tramo 50.00 a 100.00
02 Ø16.000 eje V centro (20.00; 385.00) tramo 50.00 a 100.00
03 Ø16.000 eje V centro (370.00; 75.00) tramo 50.00 a 100.00
04 Ø16.000 eje V centro (20.00; 75.00) tramo 50.00 a 100.00
05 Ø40.200 eje W centro (195.00; 250.00) tramo 10.10 a 16.00
06 Ø121.000 eje W centro (195.00; 250.00) tramo 0.00 a 10.10

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

INDICACIONES PARTICULARES
COMPRA. NO FABRICAR EL CONTORNO REPRESENTADO.
Referencia: Equipo nominal, sin referencia de pedido aceptada.

Motor eléctrico con encoder; geometría nominal, potencia no
seleccionada

F | F
E | E
D | D
C | C
B | B
A | A

# TT10-C05-010 POS. 010 CANT. 1 TT10_D_MOTOR

## Motor eléctrico con encoder; geometría nominal, potencia no seleccionada - continuación

C05

PROYECTO TT10 | 15/10/2026

CLIENTE (GEOM.)

ISO 2768-m*

*Según detalle

Equipo comprado

n/d | ESCALA: - | HOJA 2 DE 2

Unidades: mm. Rebarbar.

Radios y ajustes: cotas particulares.

Geometría aprobada por el cliente.

Liberación técnica no emitida.

# MECANIZADOS CILÍNDRICOS DEL MODELO

Centro referido a los ejes locales U,V,W de la primera hoja. Valores nominales en mm.

N.º | Tipo | Eje | Diámetro | Centro 1 | Centro 2 | Desde | Hasta
7 | Exterior | W | 340.0000 | 195.0000 | 250.0000 | 351.0000 | 400.0000
8 | Exterior | W | 370.0000 | 195.0000 | 250.0000 | 400.0000 | 505.0000
9 | Exterior | W | 360.0000 | 195.0000 | 250.0000 | 345.0000 | 351.0000
10 | Exterior | W | 360.0000 | 195.0000 | 250.0000 | 300.0000 | 306.0000
11 | Exterior | W | 360.0000 | 195.0000 | 250.0000 | 255.0000 | 261.0000
12 | Exterior | W | 360.0000 | 195.0000 | 250.0000 | 210.0000 | 216.0000
13 | Exterior | W | 360.0000 | 195.0000 | 250.0000 | 165.0000 | 171.0000
14 | Exterior | W | 360.0000 | 195.0000 | 250.0000 | 120.0000 | 126.0000
15 | Exterior | W | 360.0000 | 195.0000 | 250.0000 | 75.0000 | 81.0000
16 | Exterior | W | 340.0000 | 195.0000 | 250.0000 | 10.0000 | 30.0000
17 | Exterior | W | 360.0000 | 195.0000 | 250.0000 | 0.0000 | 10.0000
18 | Exterior | W | 360.0000 | 195.0000 | 250.0000 | 30.0000 | 36.0000
19 | Exterior | W | 340.0000 | 195.0000 | 250.0000 | 36.0000 | 75.0000
20 | Exterior | W | 340.0000 | 195.0000 | 250.0000 | 81.0000 | 120.0000
21 | Exterior | W | 340.0000 | 195.0000 | 250.0000 | 126.0000 | 165.0000
22 | Exterior | W | 340.0000 | 195.0000 | 250.0000 | 171.0000 | 210.0000
23 | Exterior | W | 340.0000 | 195.0000 | 250.0000 | 216.0000 | 255.0000
24 | Exterior | W | 340.0000 | 195.0000 | 250.0000 | 261.0000 | 300.0000
25 | Exterior | W | 340.0000 | 195.0000 | 250.0000 | 306.0000 | 345.0000

F | F
E | E

ISOMÉTRICA / SIN ESCALA

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

INDICACIONES PARTICULARES
Soporte común de pies del motor

Acero estructural; grado sin definir

F | F
E | E

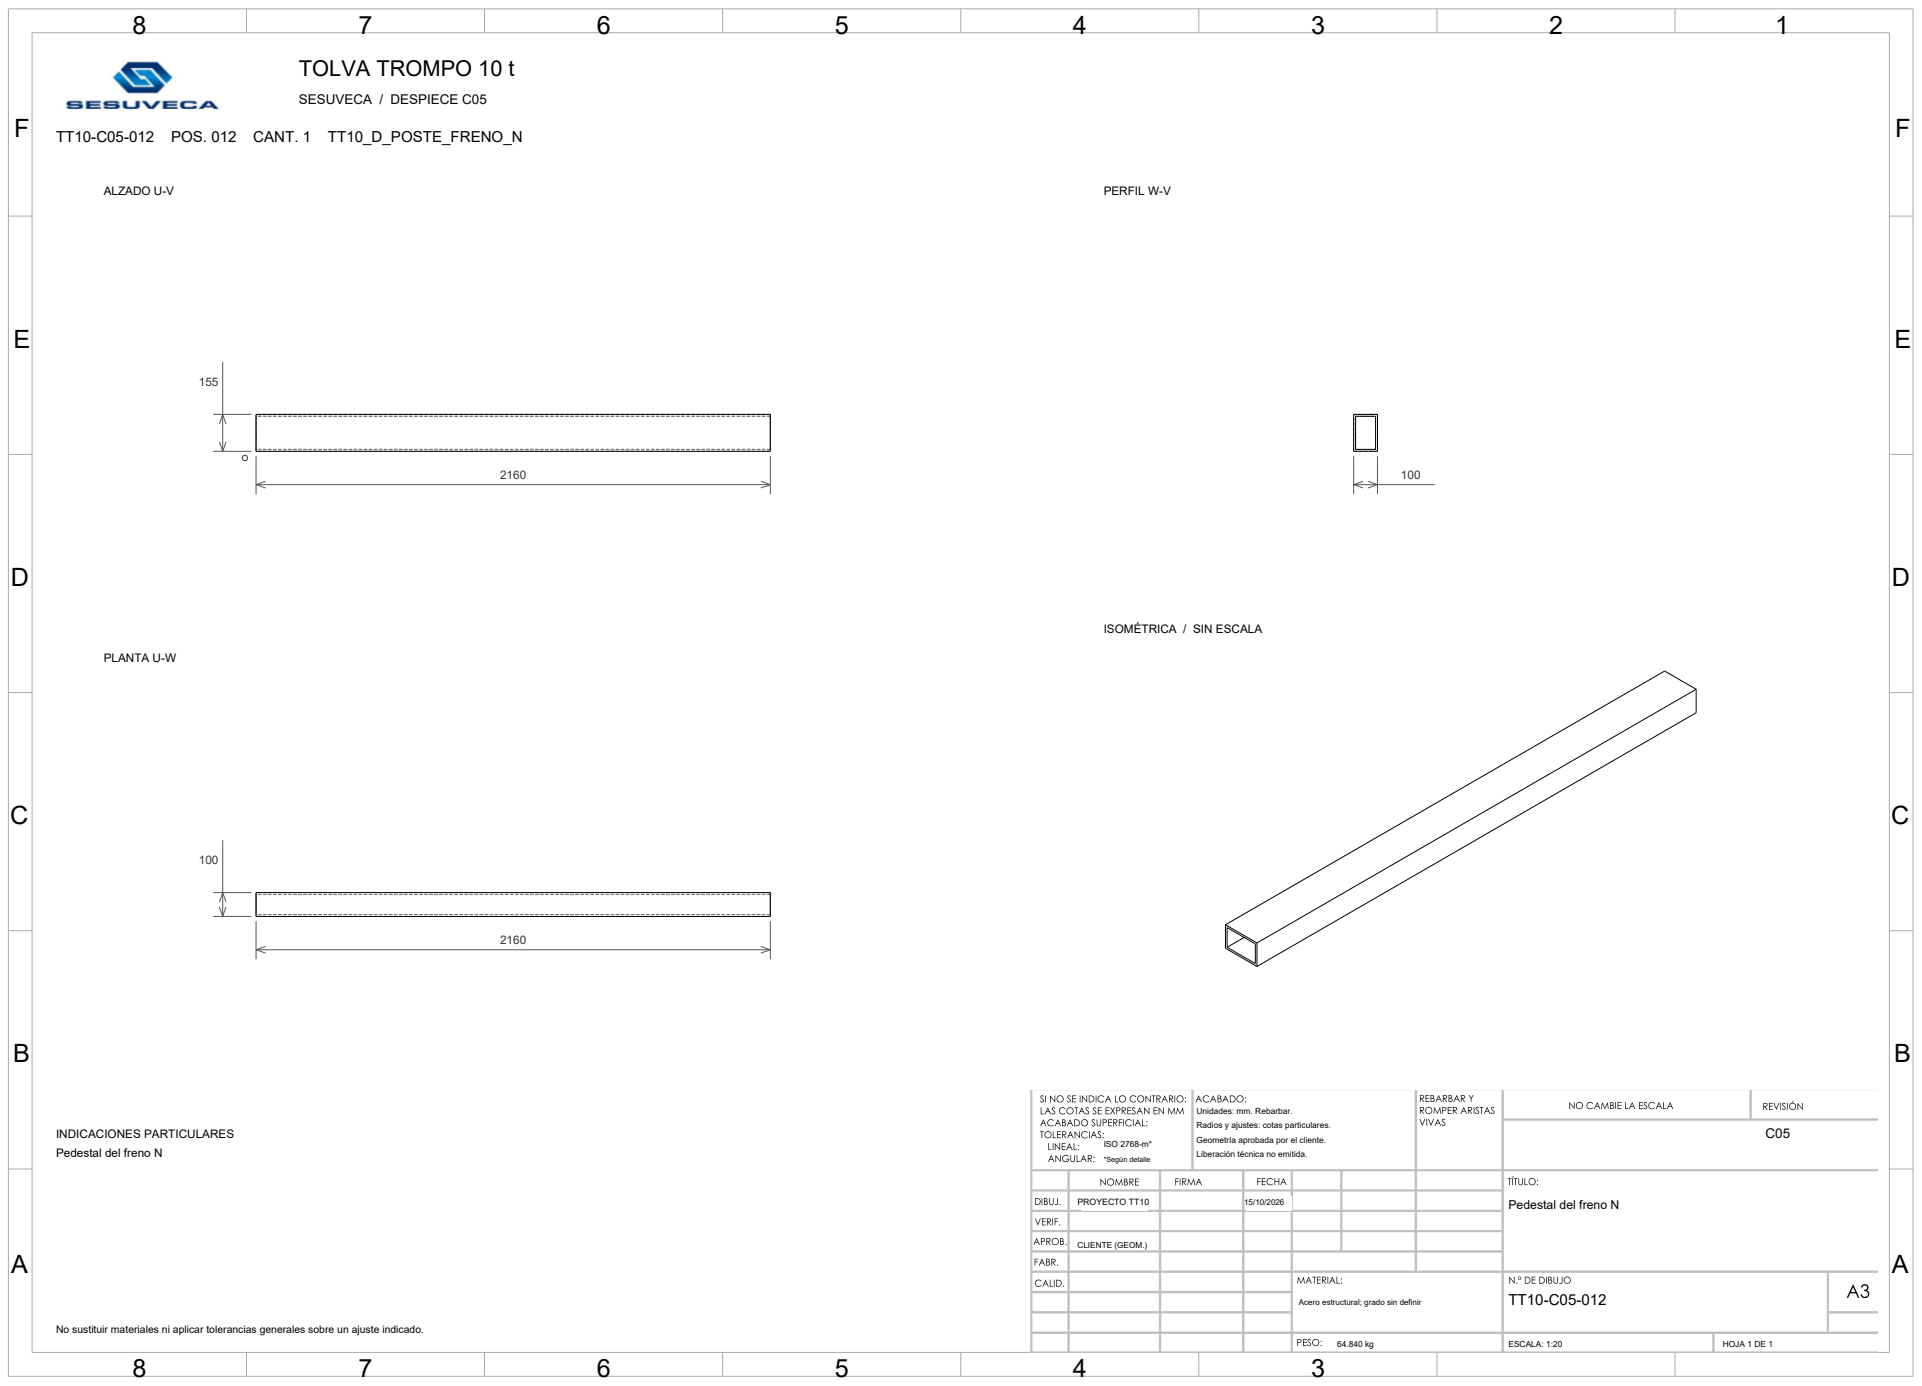
[picture p130: page 13]
TT10-C05-012 POS. 012 CANT. 1 TT10_D_POSTE_FRENO_N; PROYECTO TT10; CLIENTE (GEOM.); ISO 2768-m*; *Según detalle; ESCALA: 1:20; HOJA 1 DE 1; ALZADO U-V; PLANTA U-W; PERFIL W-V

ISOMÉTRICA / SIN ESCALA

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

INDICACIONES PARTICULARES
Pedestal del freno N

Acero estructural; grado sin definir

F | F
E | E

ISOMÉTRICA / SIN ESCALA

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

INDICACIONES PARTICULARES
Pedestal del freno P

Acero estructural; grado sin definir

F | F
E | E

ISOMÉTRICA / SIN ESCALA

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

01 Ø50.200 eje V centro (218.75; 420.00) tramo 0.00 a 76.00
02 Ø180.000 eje V centro (218.75; 420.00) tramo 0.00 a 52.76
03 Ø50.000 eje U centro (442.50; 420.00) tramo 440.00 a 465.00
04 Ø830.000 eje U centro (442.50; 420.00) tramo 440.00 a 465.00
05 Ø440.000 eje U centro (442.50; 420.00) tramo 0.00 a 30.00
06 Ø200.000 eje U centro (442.50; 420.00) tramo 0.00 a 440.00

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

INDICACIONES PARTICULARES
COMPRA. NO FABRICAR EL CONTORNO REPRESENTADO.
Referencia: Equipo nominal, sin referencia de pedido aceptada.

Reductor principal angular: carcasa y conexiones nominales

F | F
E | E
D | D
C | C
B | B
A | A

# TT10-C05-014 POS. 014 CANT. 1 TT10_D_REDUCTOR

## Reductor principal angular: carcasa y conexiones nominales -continuación

C05

PROYECTO TT10 | 15/10/2026

CLIENTE (GEOM.)

ISO 2768-m*

*Según detalle

Equipo comprado

n/d | ESCALA: - | HOJA 2 DE 2

Unidades: mm. Rebarbar.

Radios y ajustes: cotas particulares.

Geometría aprobada por el cliente.

Liberación técnica no emitida.

# MECANIZADOS CILÍNDRICOS DEL MODELO

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

N.º | Tipo | Eje | Diámetro | Centro 1 | Centro 2 | Desde | Hasta
7 | Exterior | U | 800.0000 | 442.5000 | 420.0000 | 30.0000 | 440.0000

F | F
E | E

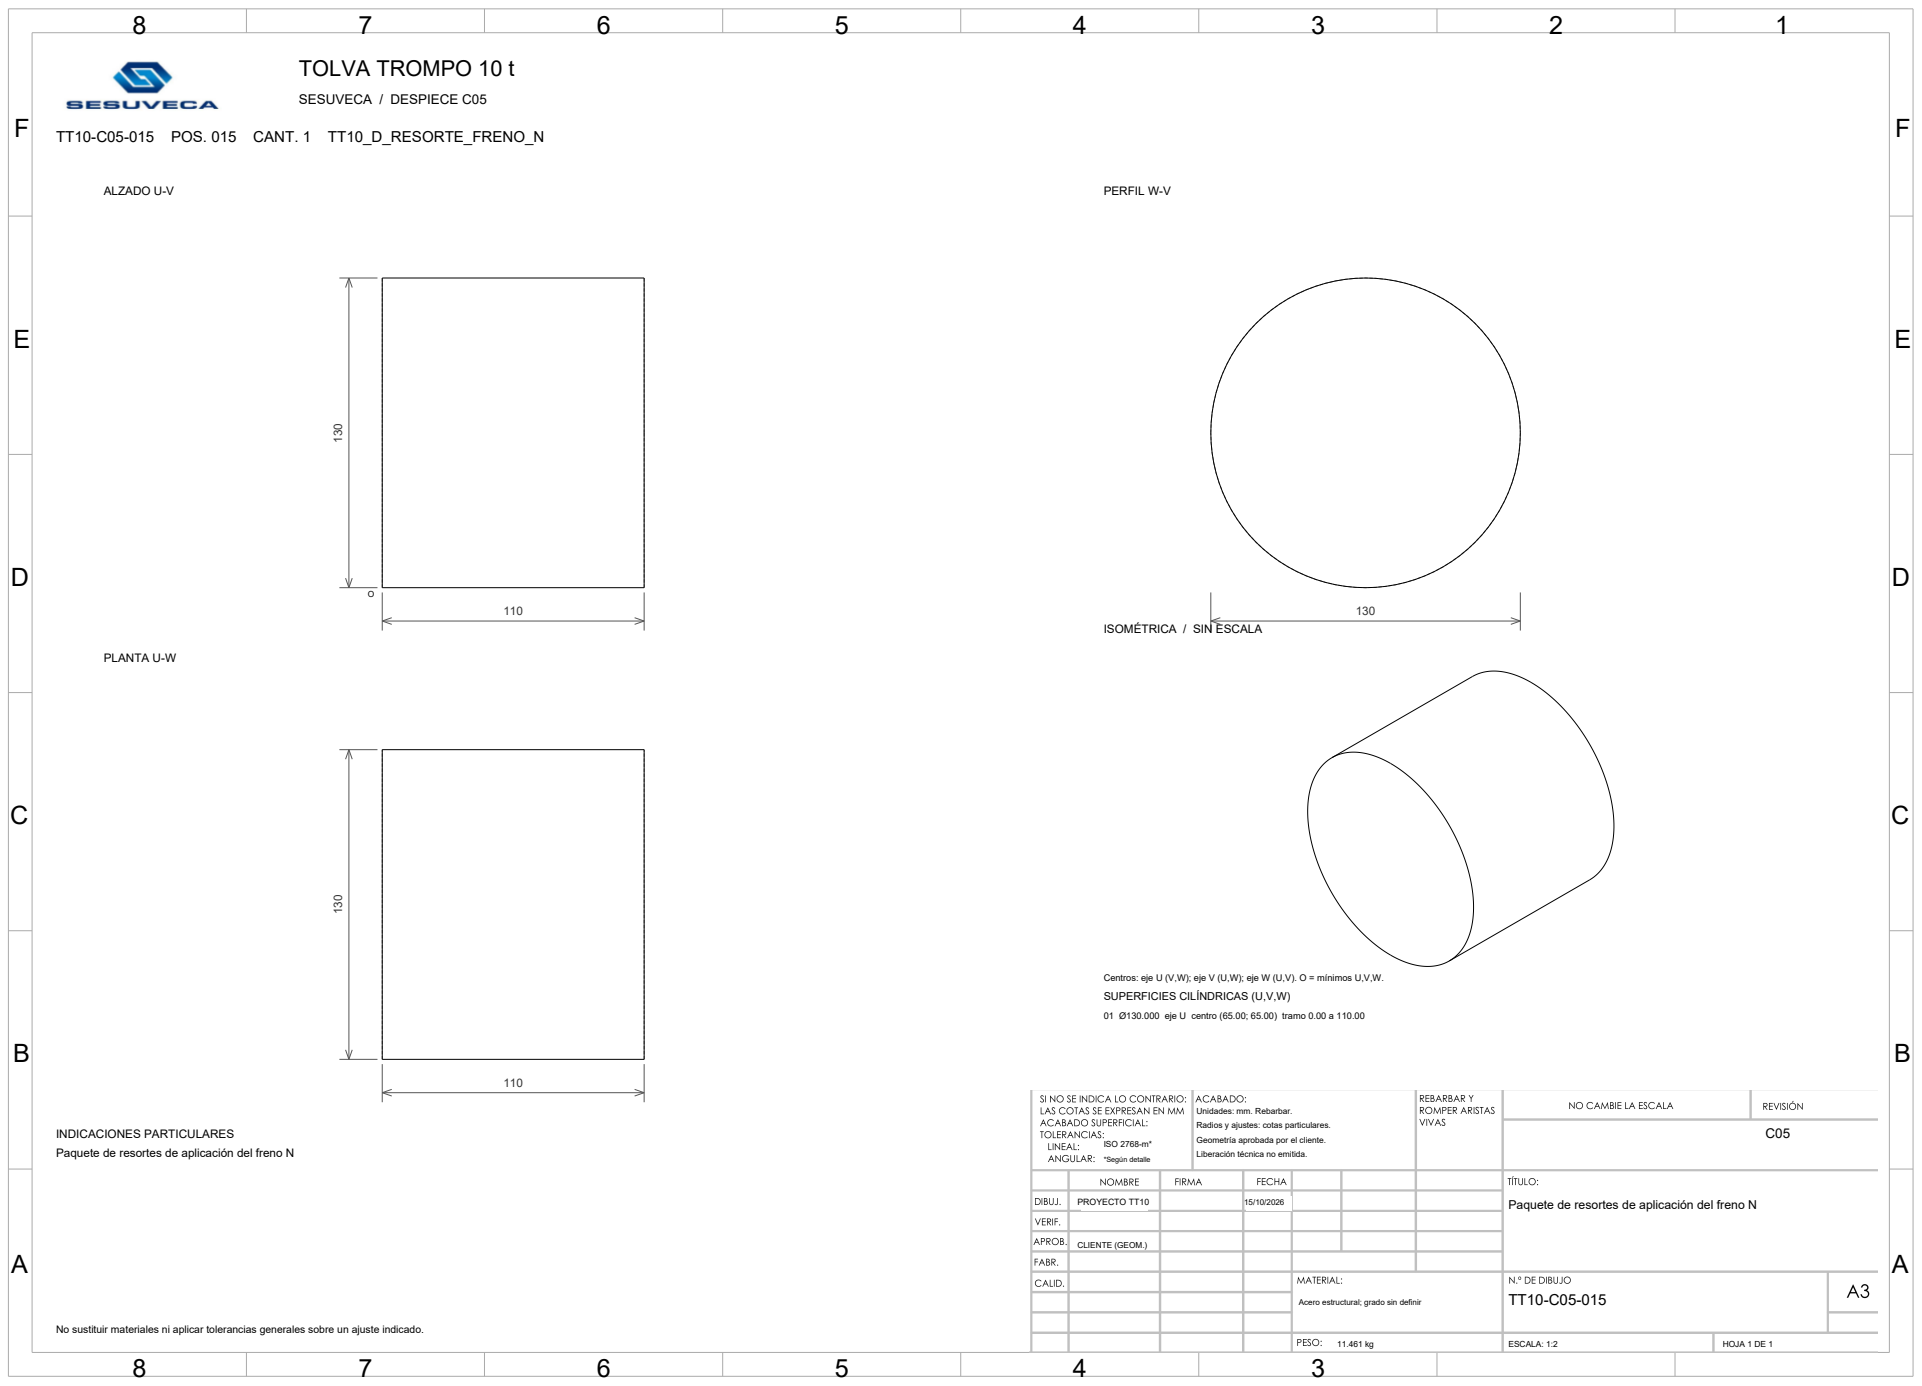
[picture p131: page 17]
TT10-C05-015 POS. 015 CANT. 1 TT10_D_RESORTE_FRENO_N; PROYECTO TT10; CLIENTE (GEOM.); ISO 2768-m*; *Según detalle; ESCALA: 1:2; HOJA 1 DE 1; ALZADO U-V; PLANTA U-W; PERFIL W-V

ISOMÉTRICA / SIN ESCALA

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

01 Ø130.000 eje U centro (65.00; 65.00) tramo 0.00 a 110.00

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

INDICACIONES PARTICULARES
Paquete de resortes de aplicación del freno N

Acero estructural; grado sin definir

F | F
E | E

ISOMÉTRICA / SIN ESCALA

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

01 Ø130.000 eje U centro (65.00; 65.00) tramo 0.00 a 110.00

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

INDICACIONES PARTICULARES
Paquete de resortes de aplicación del freno P

Acero estructural; grado sin definir

F | F
E | E

ISOMÉTRICA / SIN ESCALA

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

01 Ø200.000 eje U centro (100.00; 100.00) tramo 0.00 a 100.00

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

INDICACIONES PARTICULARES
COMPRA. NO FABRICAR EL CONTORNO REPRESENTADO.
Referencia: Equipo nominal, sin referencia de pedido aceptada.

Eje de conexión geométrica SALIDA_REDUCTOR

F | F
E | E

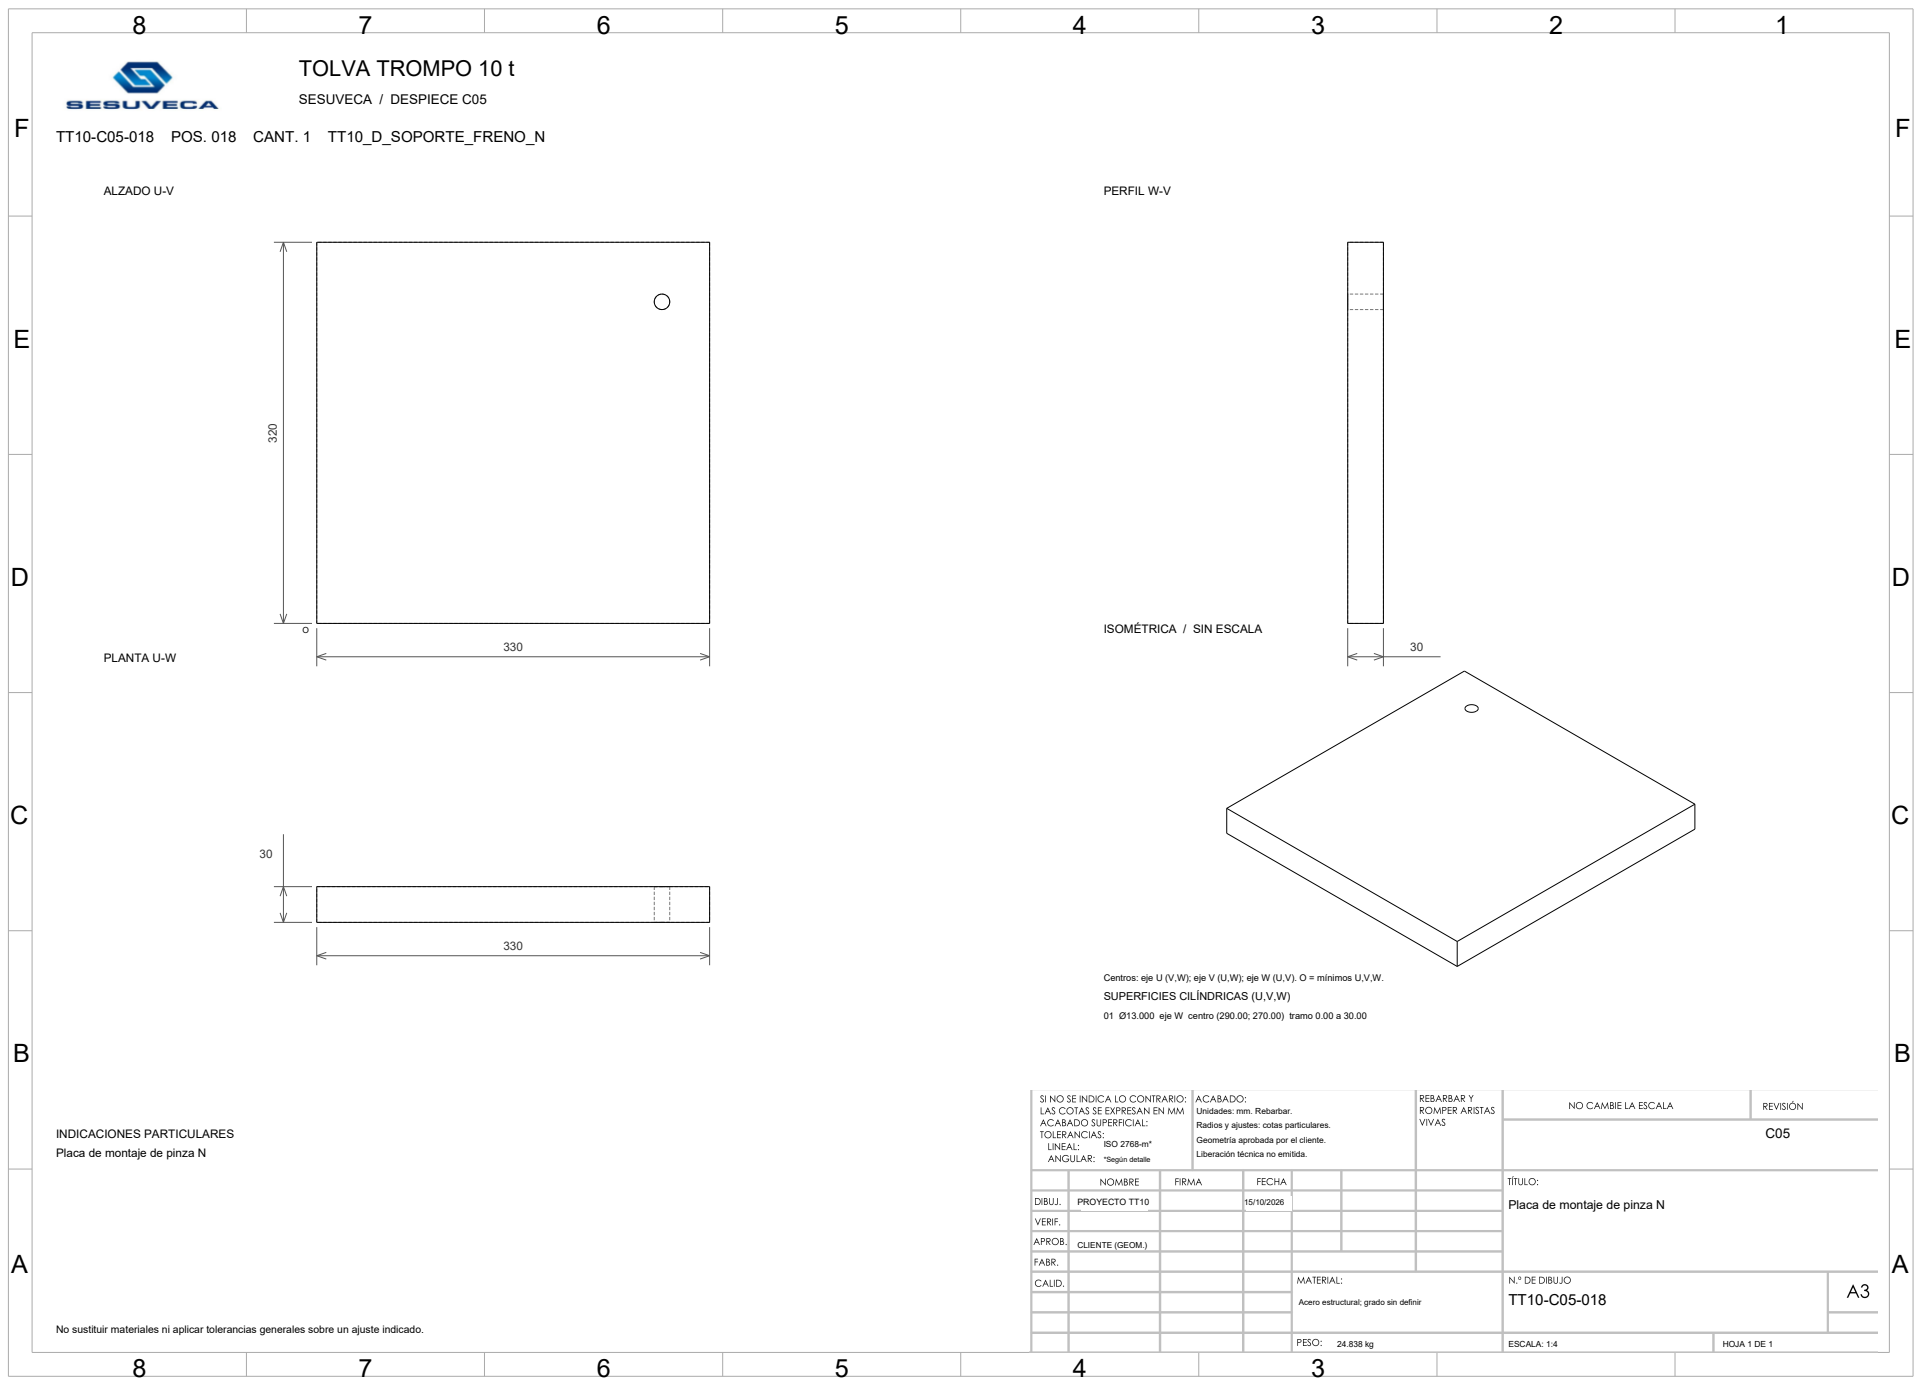
[picture p132: page 20]
TT10-C05-018 POS. 018 CANT. 1 TT10_D_SOPORTE_FRENO_N; PROYECTO TT10; CLIENTE (GEOM.); ISO 2768-m*; *Según detalle; ESCALA: 1:4; HOJA 1 DE 1; ALZADO U-V; PLANTA U-W; PERFIL W-V

ISOMÉTRICA / SIN ESCALA

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

01 Ø13.000 eje W centro (290.00; 270.00) tramo 0.00 a 30.00

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

INDICACIONES PARTICULARES
Placa de montaje de pinza N

Acero estructural; grado sin definir

F | F
E | E

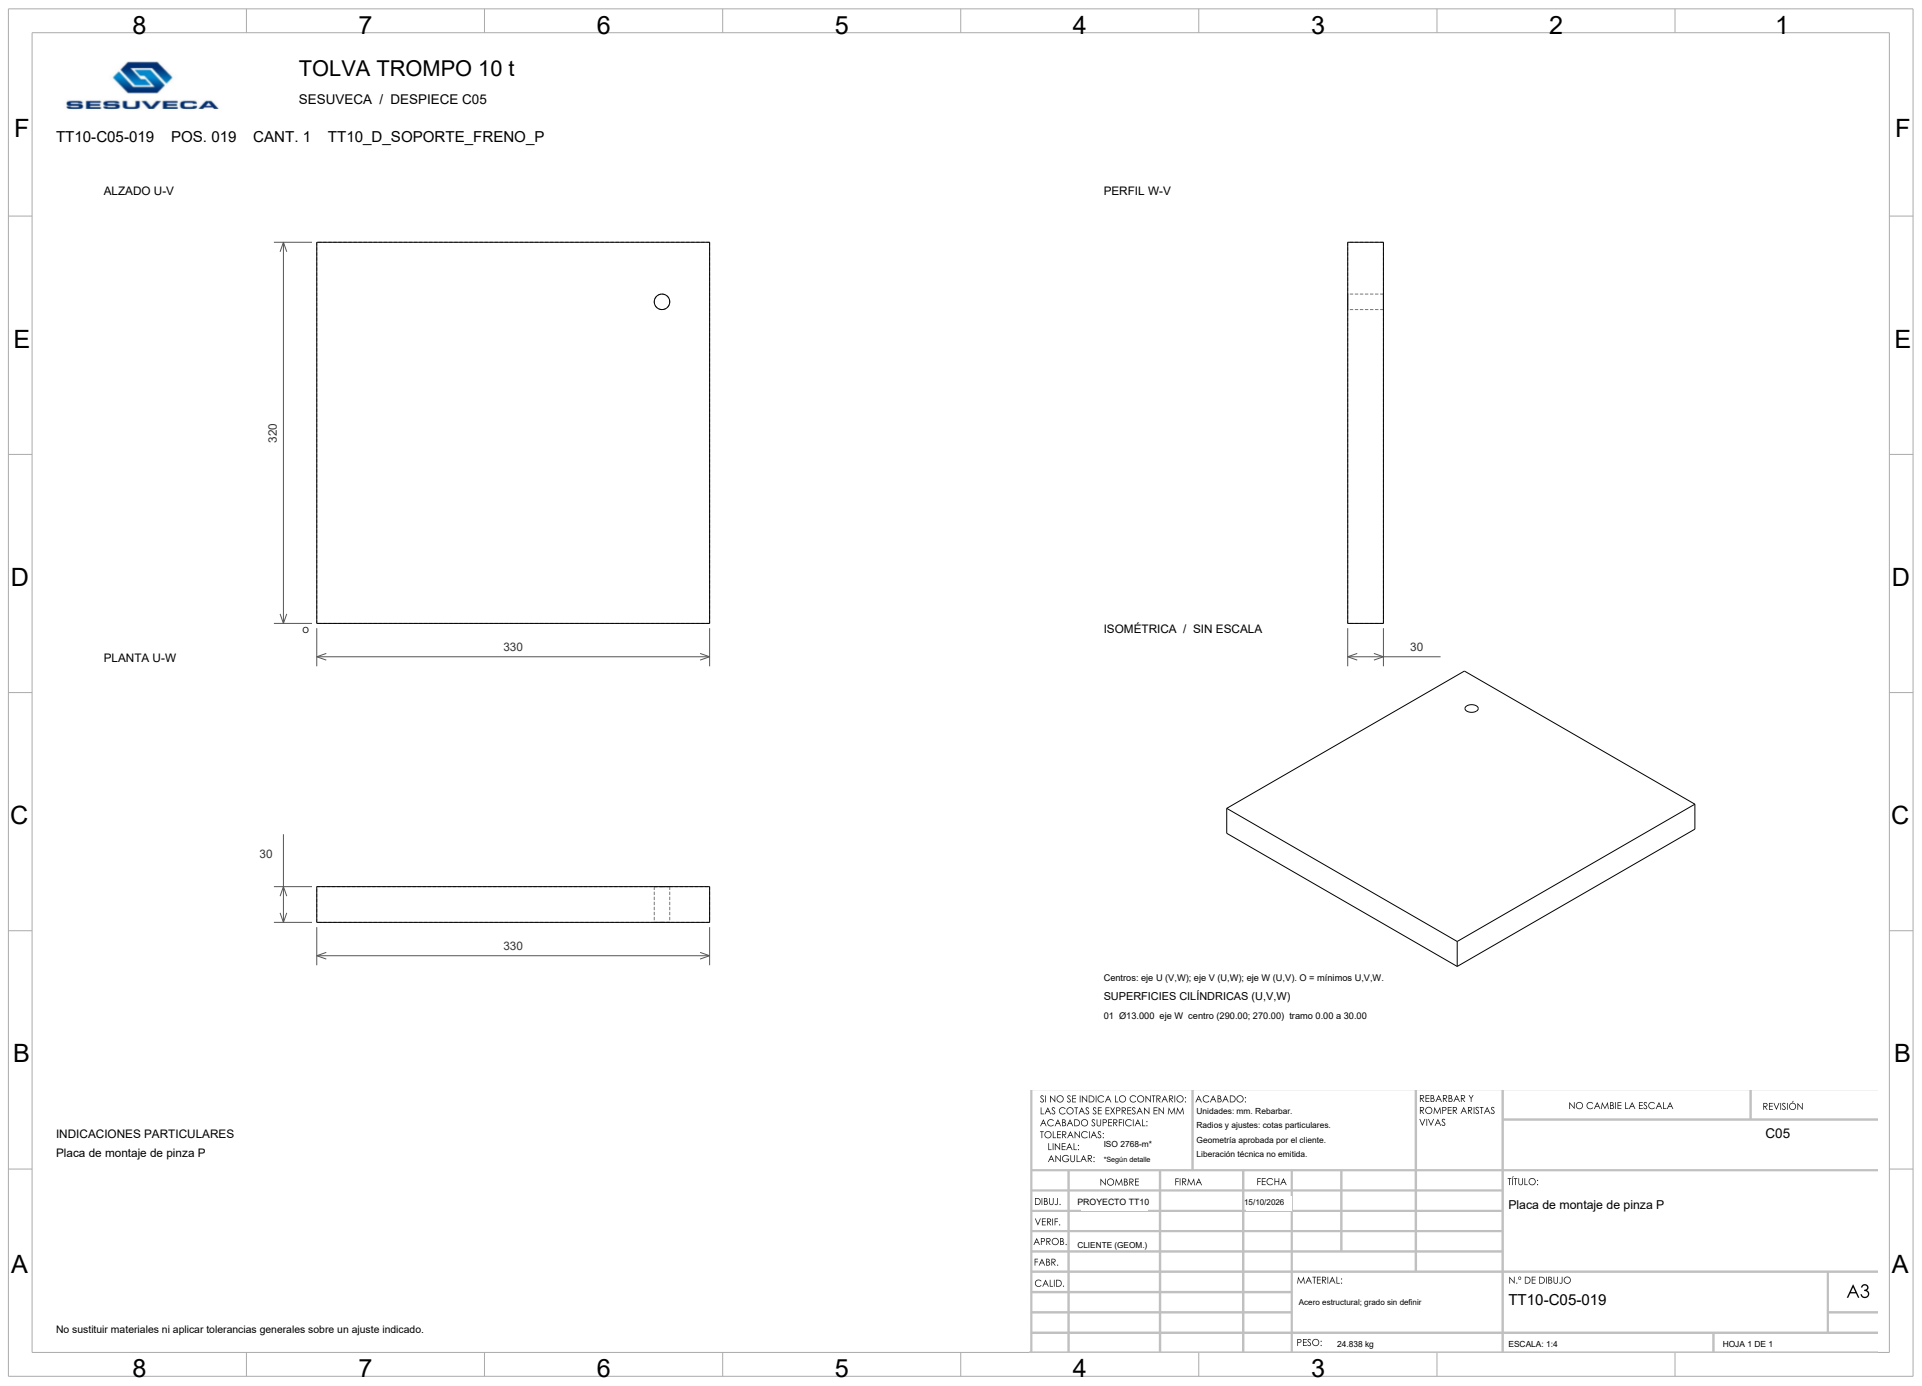
[picture p133: page 21]
TT10-C05-019 POS. 019 CANT. 1 TT10_D_SOPORTE_FRENO_P; PROYECTO TT10; CLIENTE (GEOM.); ISO 2768-m*; *Según detalle; ESCALA: 1:4; HOJA 1 DE 1; ALZADO U-V; PLANTA U-W; PERFIL W-V

ISOMÉTRICA / SIN ESCALA

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

01 Ø13.000 eje W centro (290.00; 270.00) tramo 0.00 a 30.00

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

INDICACIONES PARTICULARES
Placa de montaje de pinza P

Acero estructural; grado sin definir

F | F
E | E

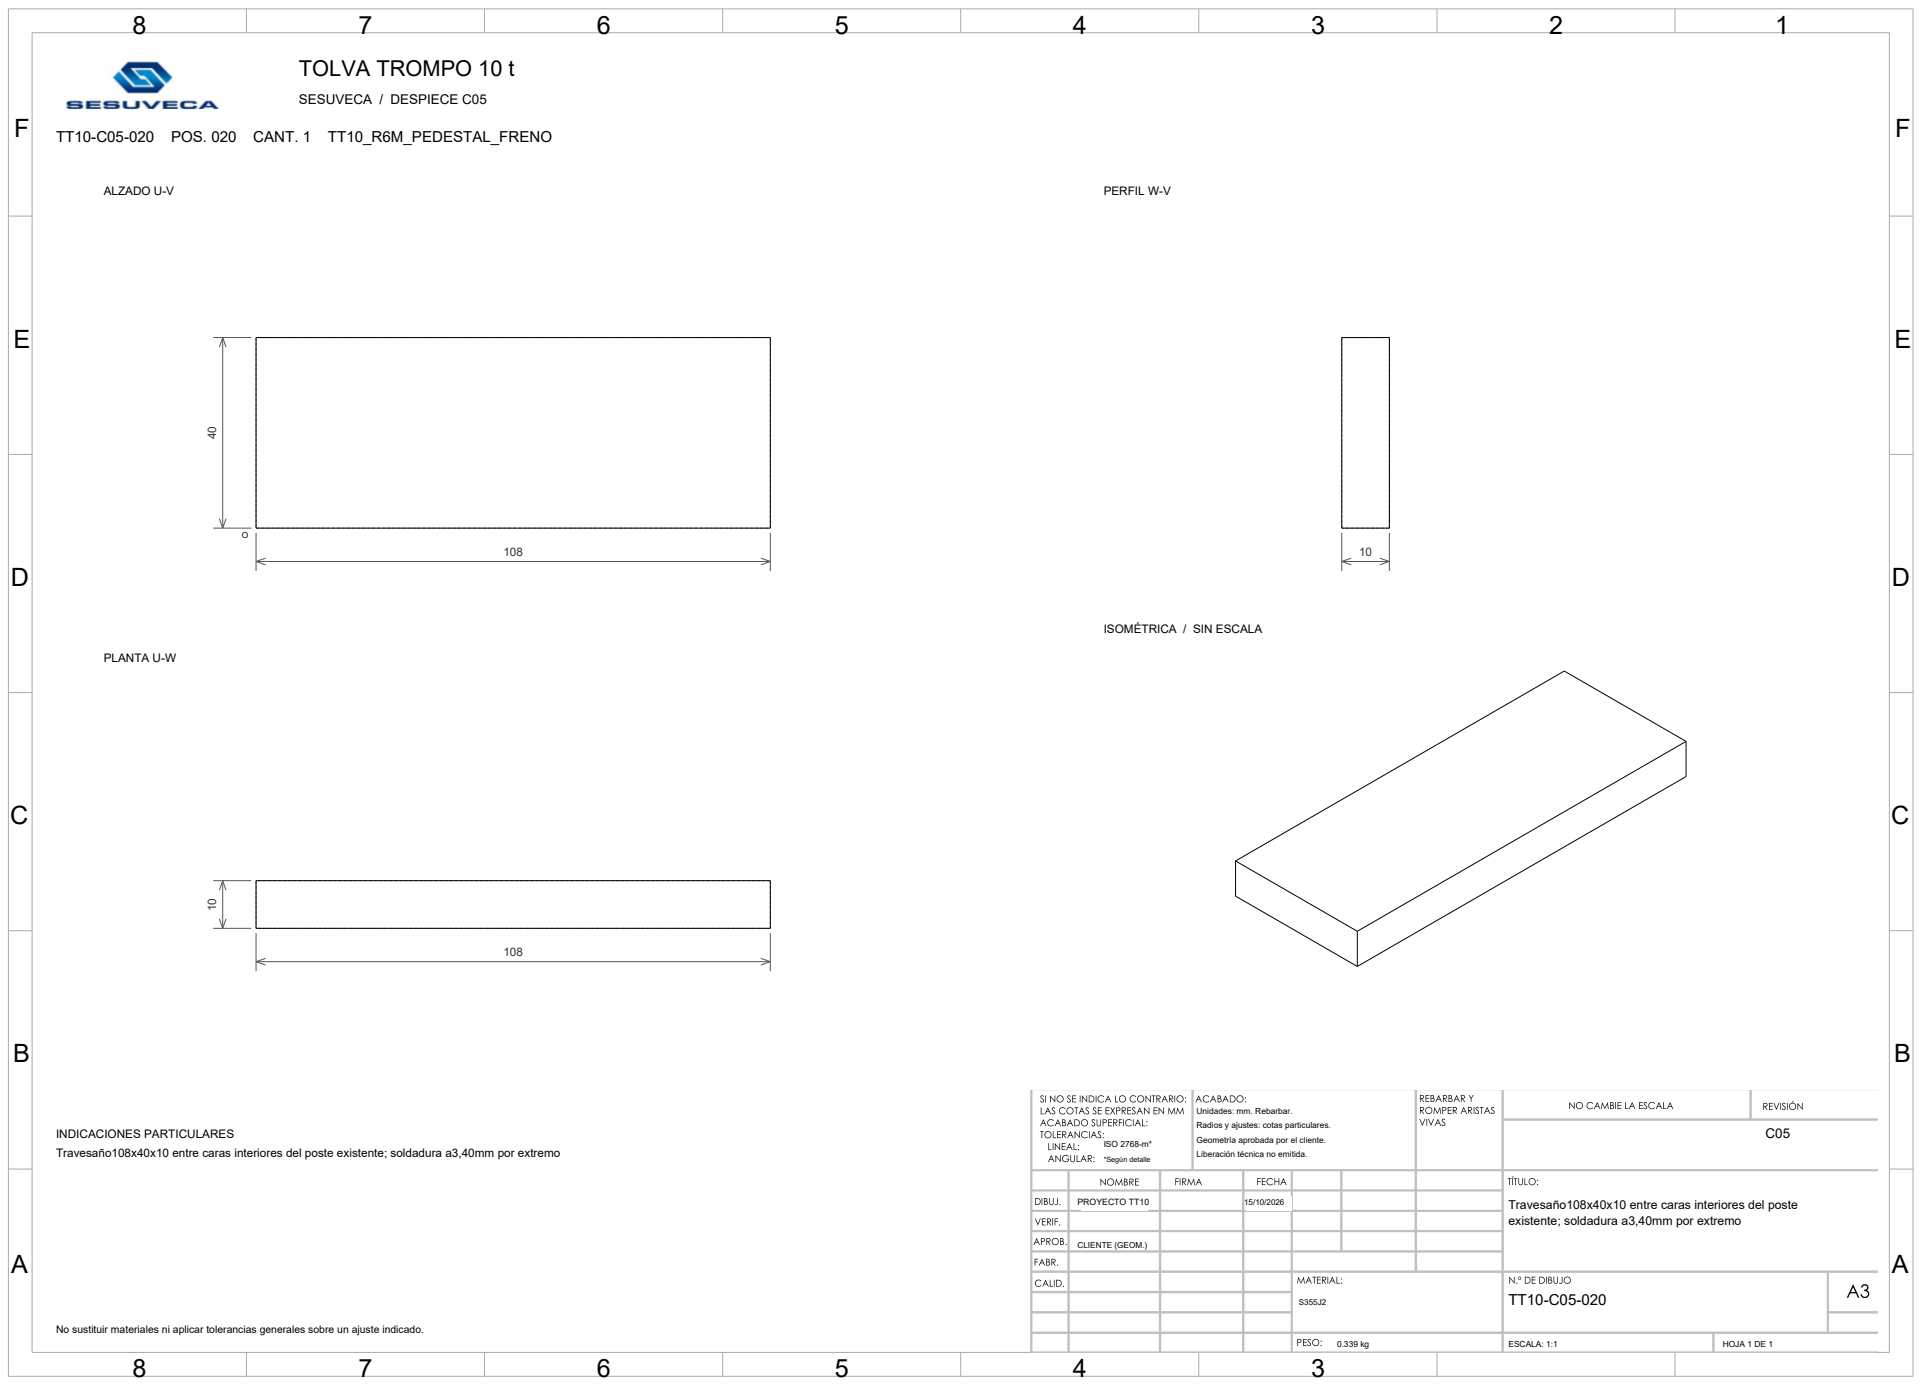
[picture p134: page 22]
TT10-C05-020 POS. 020 CANT. 1 TT10_R6M_PEDESTAL_FRENO; PROYECTO TT10; CLIENTE (GEOM.); ISO 2768-m*; *Según detalle; ESCALA: 1:1; HOJA 1 DE 1; ALZADO U-V; PLANTA U-W; PERFIL W-V

ISOMÉTRICA / SIN ESCALA

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

INDICACIONES PARTICULARES
Travesaño108x40x10 entre caras interiores del poste existente; soldadura a3,40mm por extremo

Travesaño108x40x10 entre caras interiores del poste
existente; soldadura a3,40mm por extremo

F | F
E | E

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

01 Ø200.000 eje U centro (180.00; 180.00) tramo 4.00 a 94.00
02 Ø360.000 eje U centro (180.00; 180.00) tramo 0.00 a 98.00

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

INDICACIONES PARTICULARES
COMPRA. NO FABRICAR EL CONTORNO REPRESENTADO.
Referencia: 22240 CC/W33

SKF22240CC/W33 200x360x98; envolvente sin rodillos

Acero de rodamiento SKF

F | F
E | E

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

INDICACIONES PARTICULARES
COMPRA. NO FABRICAR EL CONTORNO REPRESENTADO.
Referencia: 22240 CC/W33

SKF22240CC/W33 200x360x98; envolvente sin rodillos

Acero de rodamiento SKF

F | F
E | E

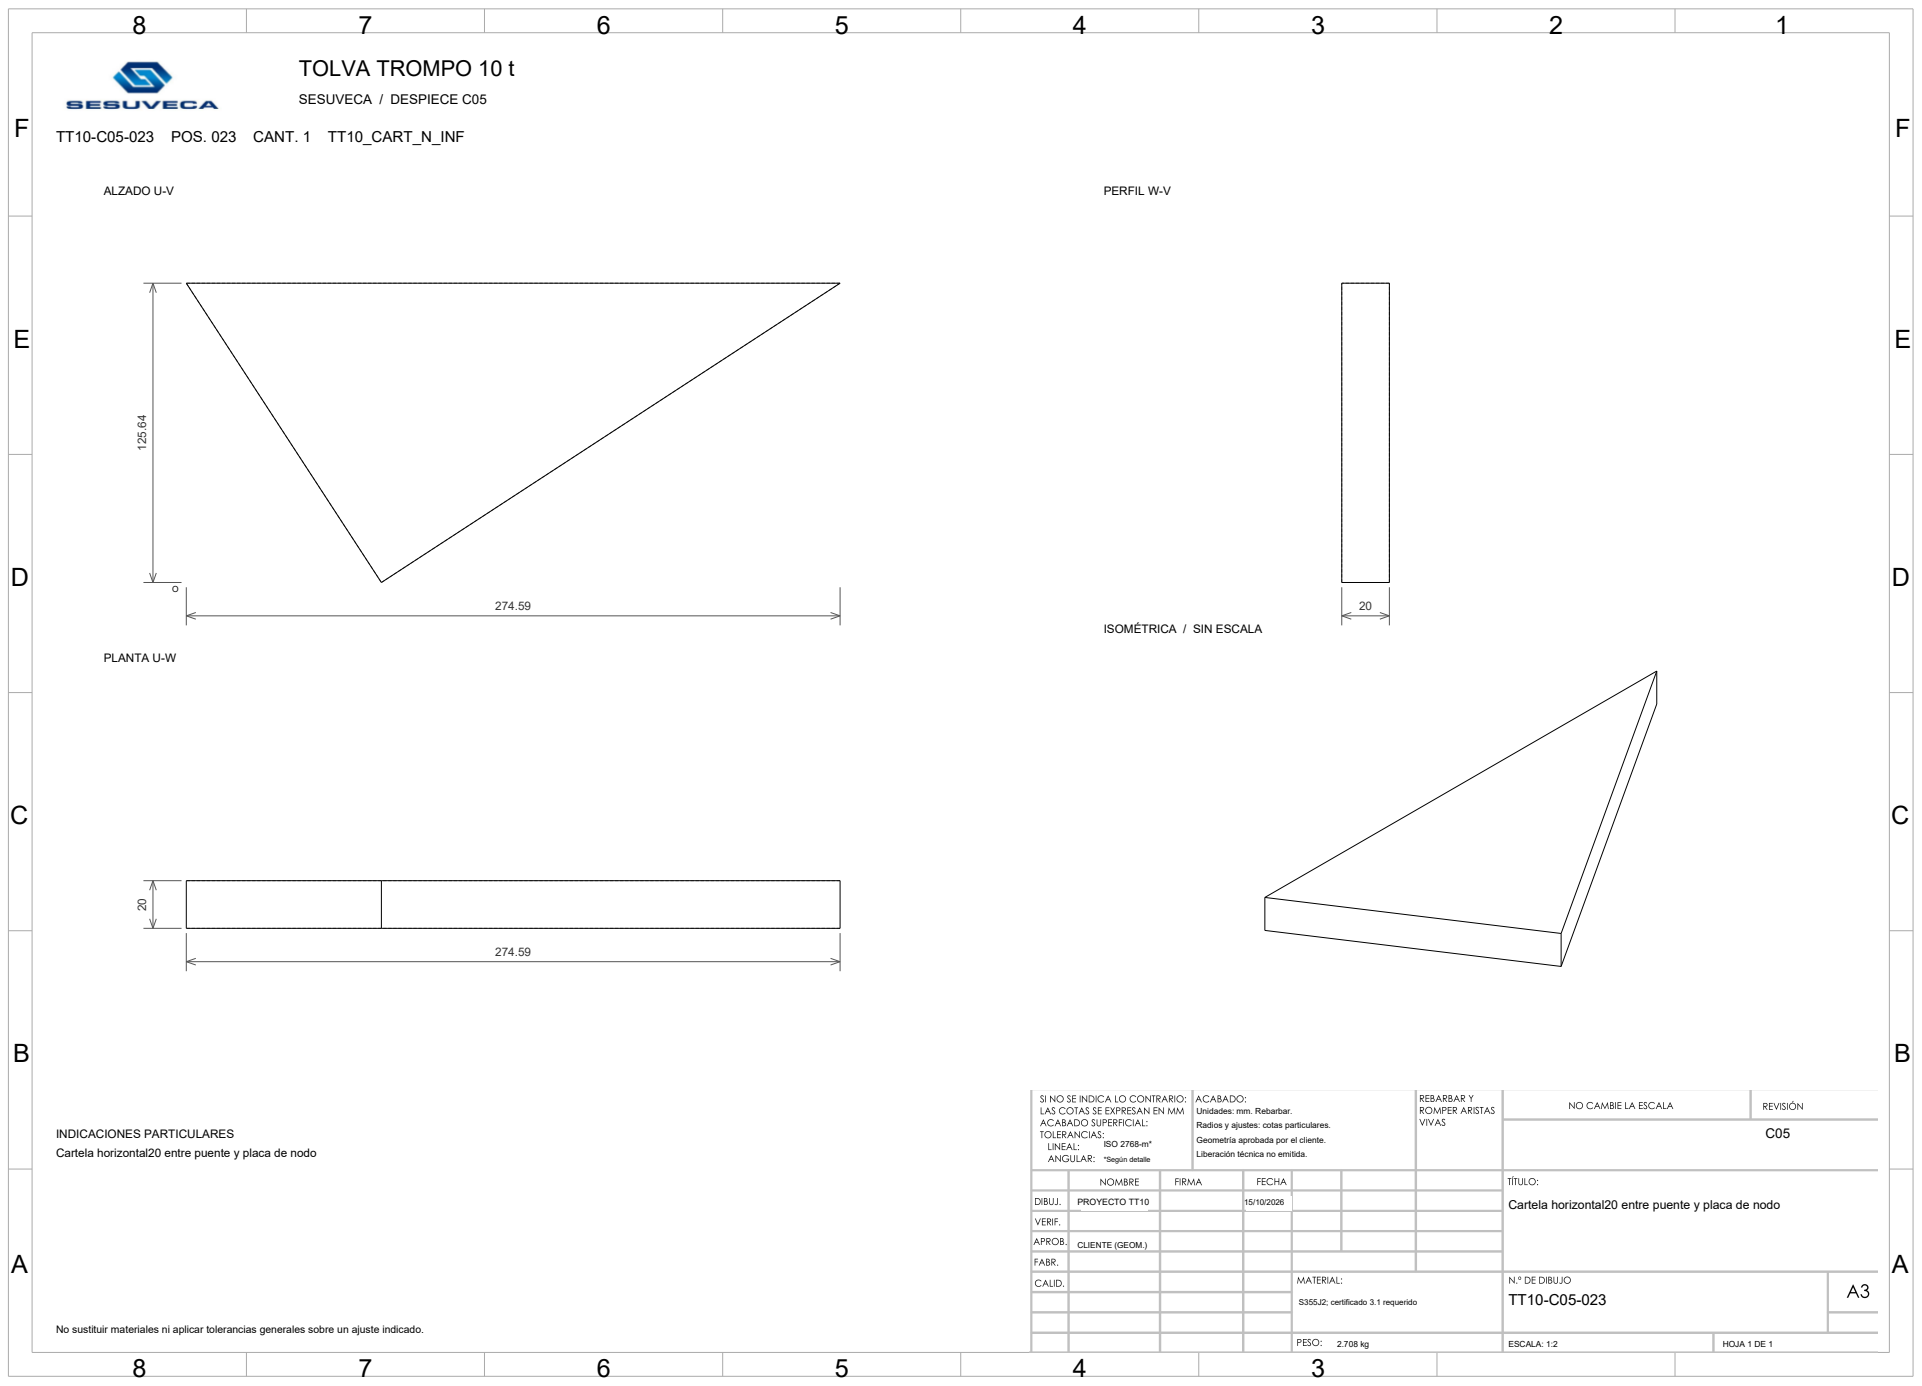
[picture p135: page 25]
TT10-C05-023 POS. 023 CANT. 1 TT10_CART_N_INF; PROYECTO TT10; CLIENTE (GEOM.); ISO 2768-m*; *Según detalle; S355J2; certificado 3.1 requerido; ESCALA: 1:2; HOJA 1 DE 1; ALZADO U-V; PLANTA U-W; PERFIL W-V

ISOMÉTRICA / SIN ESCALA

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

INDICACIONES PARTICULARES
Cartela horizontal20 entre puente y placa de nodo

F | F
E | E

ISOMÉTRICA / SIN ESCALA

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

INDICACIONES PARTICULARES
Cartela horizontal20 entre puente y placa de nodo

F | F
E | E

ISOMÉTRICA / SIN ESCALA

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

INDICACIONES PARTICULARES
Cartela horizontal20 entre puente y placa de nodo

F | F
E | E

ISOMÉTRICA / SIN ESCALA

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

INDICACIONES PARTICULARES
Cartela horizontal20 entre puente y placa de nodo

F | F
E | E

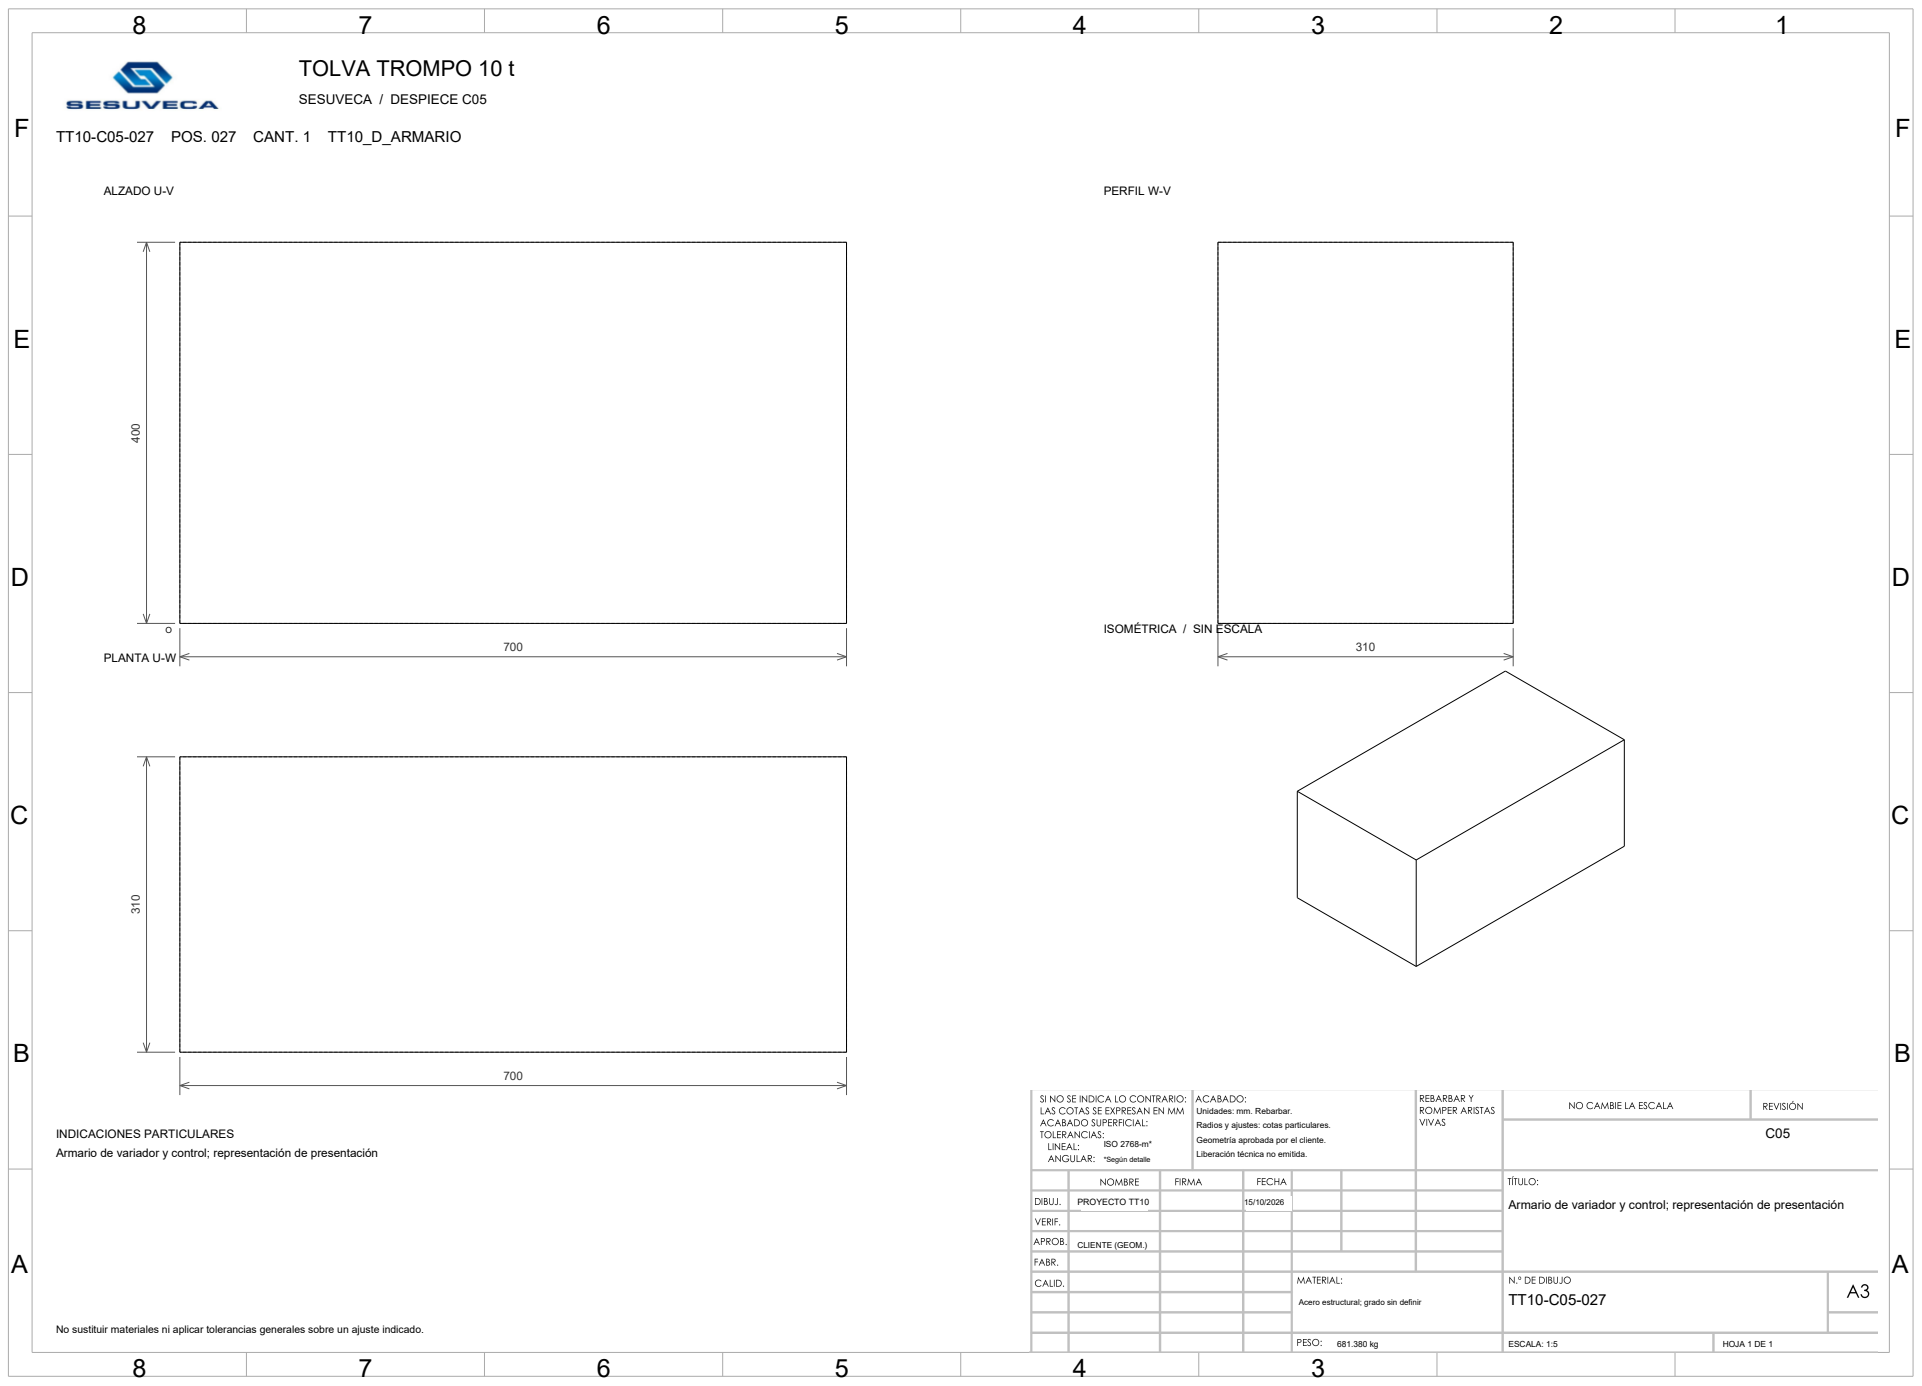
[picture p136: page 29]
TT10-C05-027 POS. 027 CANT. 1 TT10_D_ARMARIO; PROYECTO TT10; CLIENTE (GEOM.); ISO 2768-m*; *Según detalle; ESCALA: 1:5; HOJA 1 DE 1; ALZADO U-V; PLANTA U-W; PERFIL W-V

ISOMÉTRICA / SIN ESCALA

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

INDICACIONES PARTICULARES
Armario de variador y control; representación de presentación

Acero estructural; grado sin definir

F | F
E | E

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

01 Ø1424.000 eje U centro (730.00; 730.00) tramo 0.00 a 65.00
02 Ø1460.000 eje U centro (730.00; 730.00) tramo 0.00 a 65.00

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

INDICACIONES PARTICULARES
Resguardo tubular desmontable ARO_RESGUARDO_N

Acero estructural; grado sin definir

F | F
E | E

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

INDICACIONES PARTICULARES
Resguardo tubular desmontable ARO_RESGUARDO_P

Acero estructural; grado sin definir

F | F
E | E

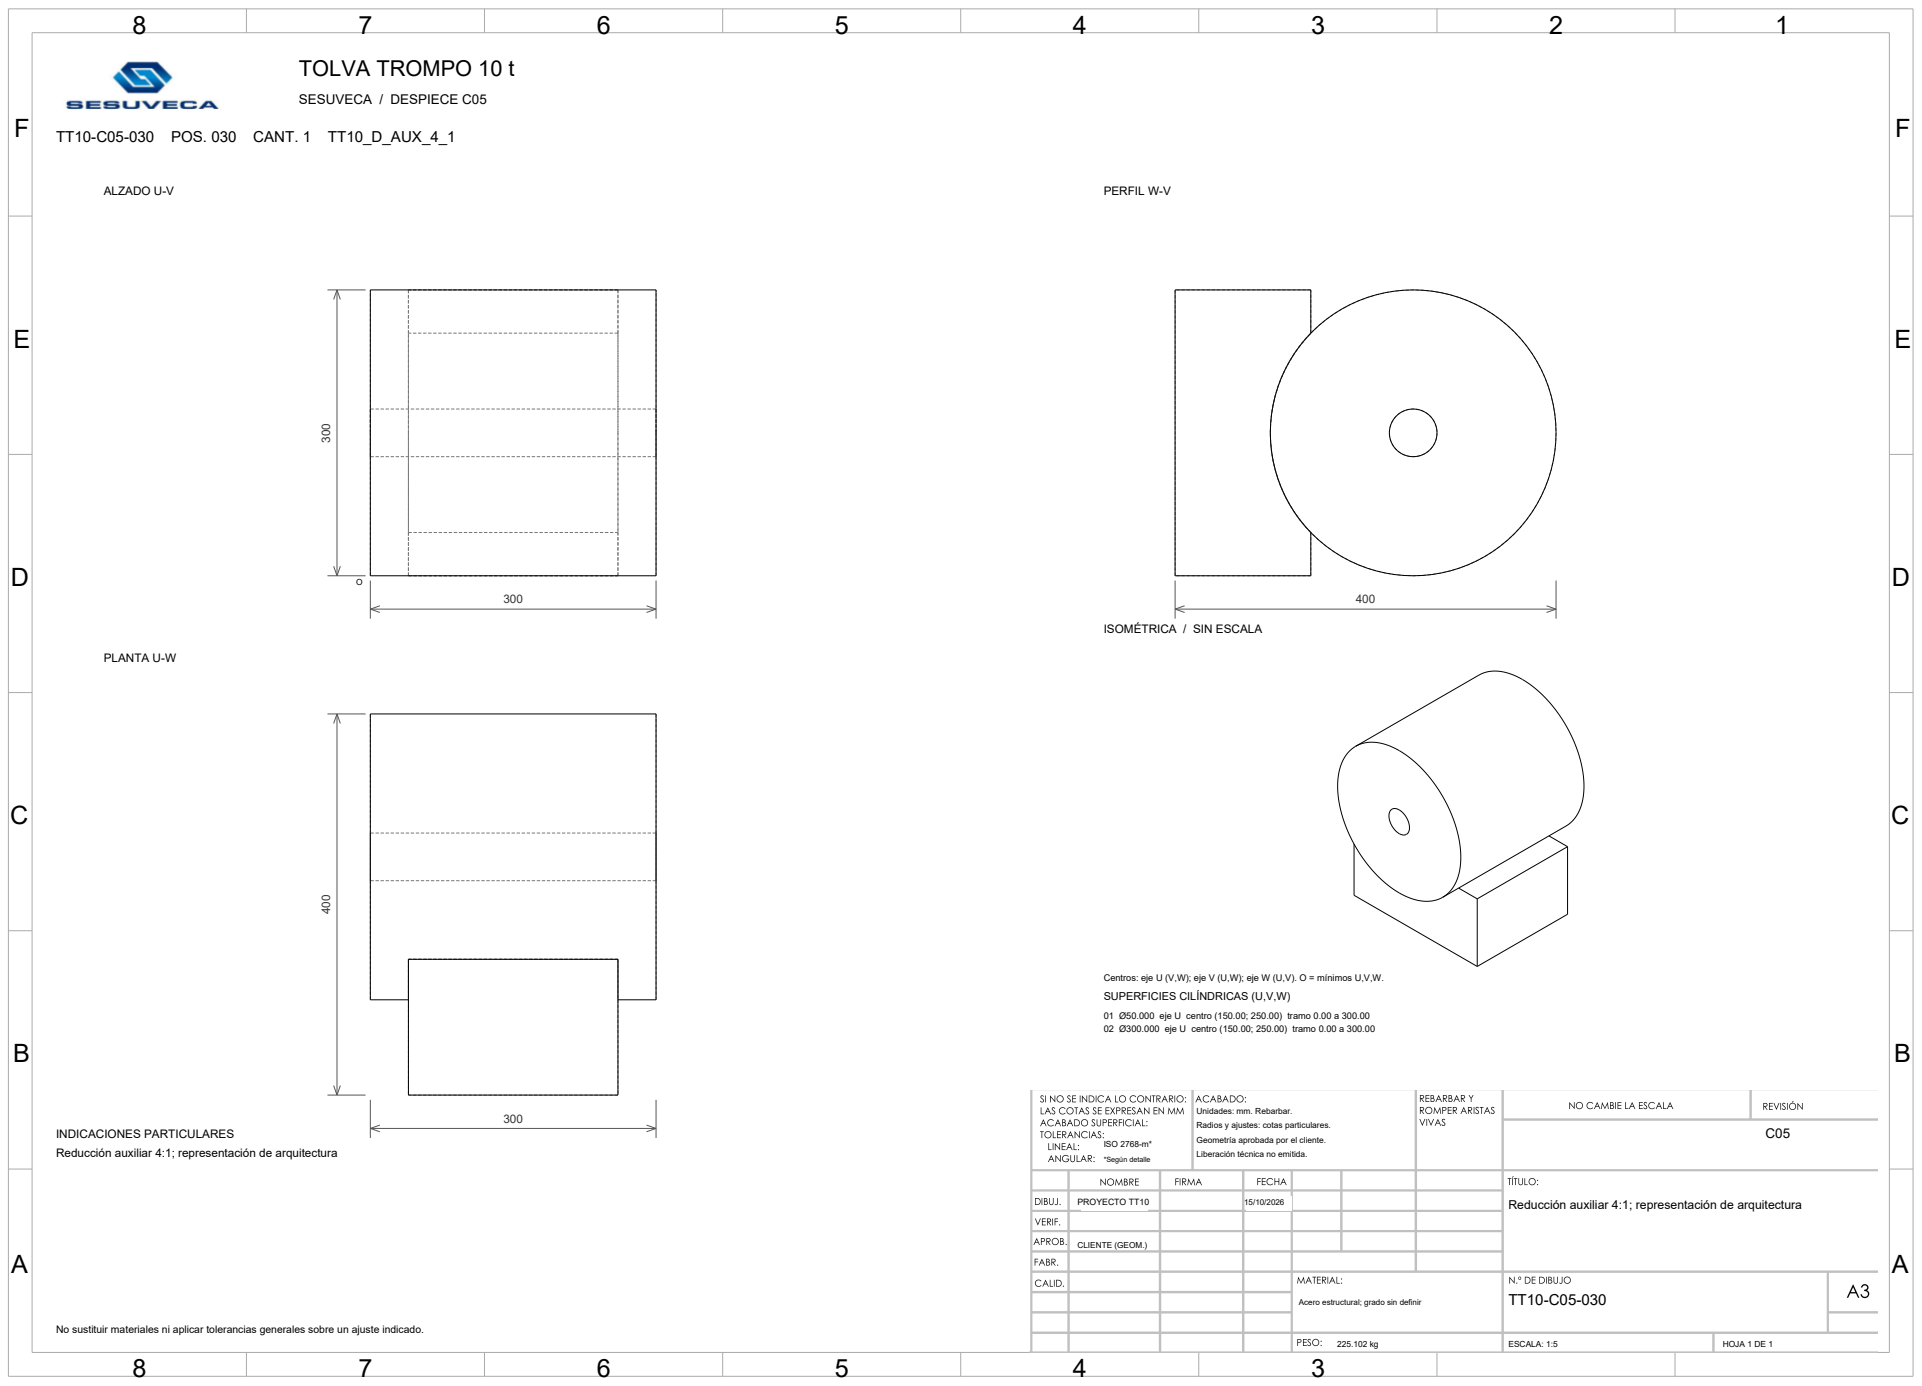
[picture p137: page 32]
TT10-C05-030 POS. 030 CANT. 1 TT10_D_AUX_4_1; PROYECTO TT10; CLIENTE (GEOM.); ISO 2768-m*; *Según detalle; ESCALA: 1:5; HOJA 1 DE 1; ALZADO U-V; PLANTA U-W; PERFIL W-V

ISOMÉTRICA / SIN ESCALA

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

01 Ø50.000 eje U centro (150.00; 250.00) tramo 0.00 a 300.00
02 Ø300.000 eje U centro (150.00; 250.00) tramo 0.00 a 300.00

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

INDICACIONES PARTICULARES
Reducción auxiliar 4:1; representación de arquitectura

Acero estructural; grado sin definir

F | F
E | E

ISOMÉTRICA / SIN ESCALA

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

INDICACIONES PARTICULARES
Base del armario

Acero estructural; grado sin definir

F | F
E | E

ISOMÉTRICA / SIN ESCALA

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

INDICACIONES PARTICULARES
Base de botonera

Acero estructural; grado sin definir

F | F
E | E

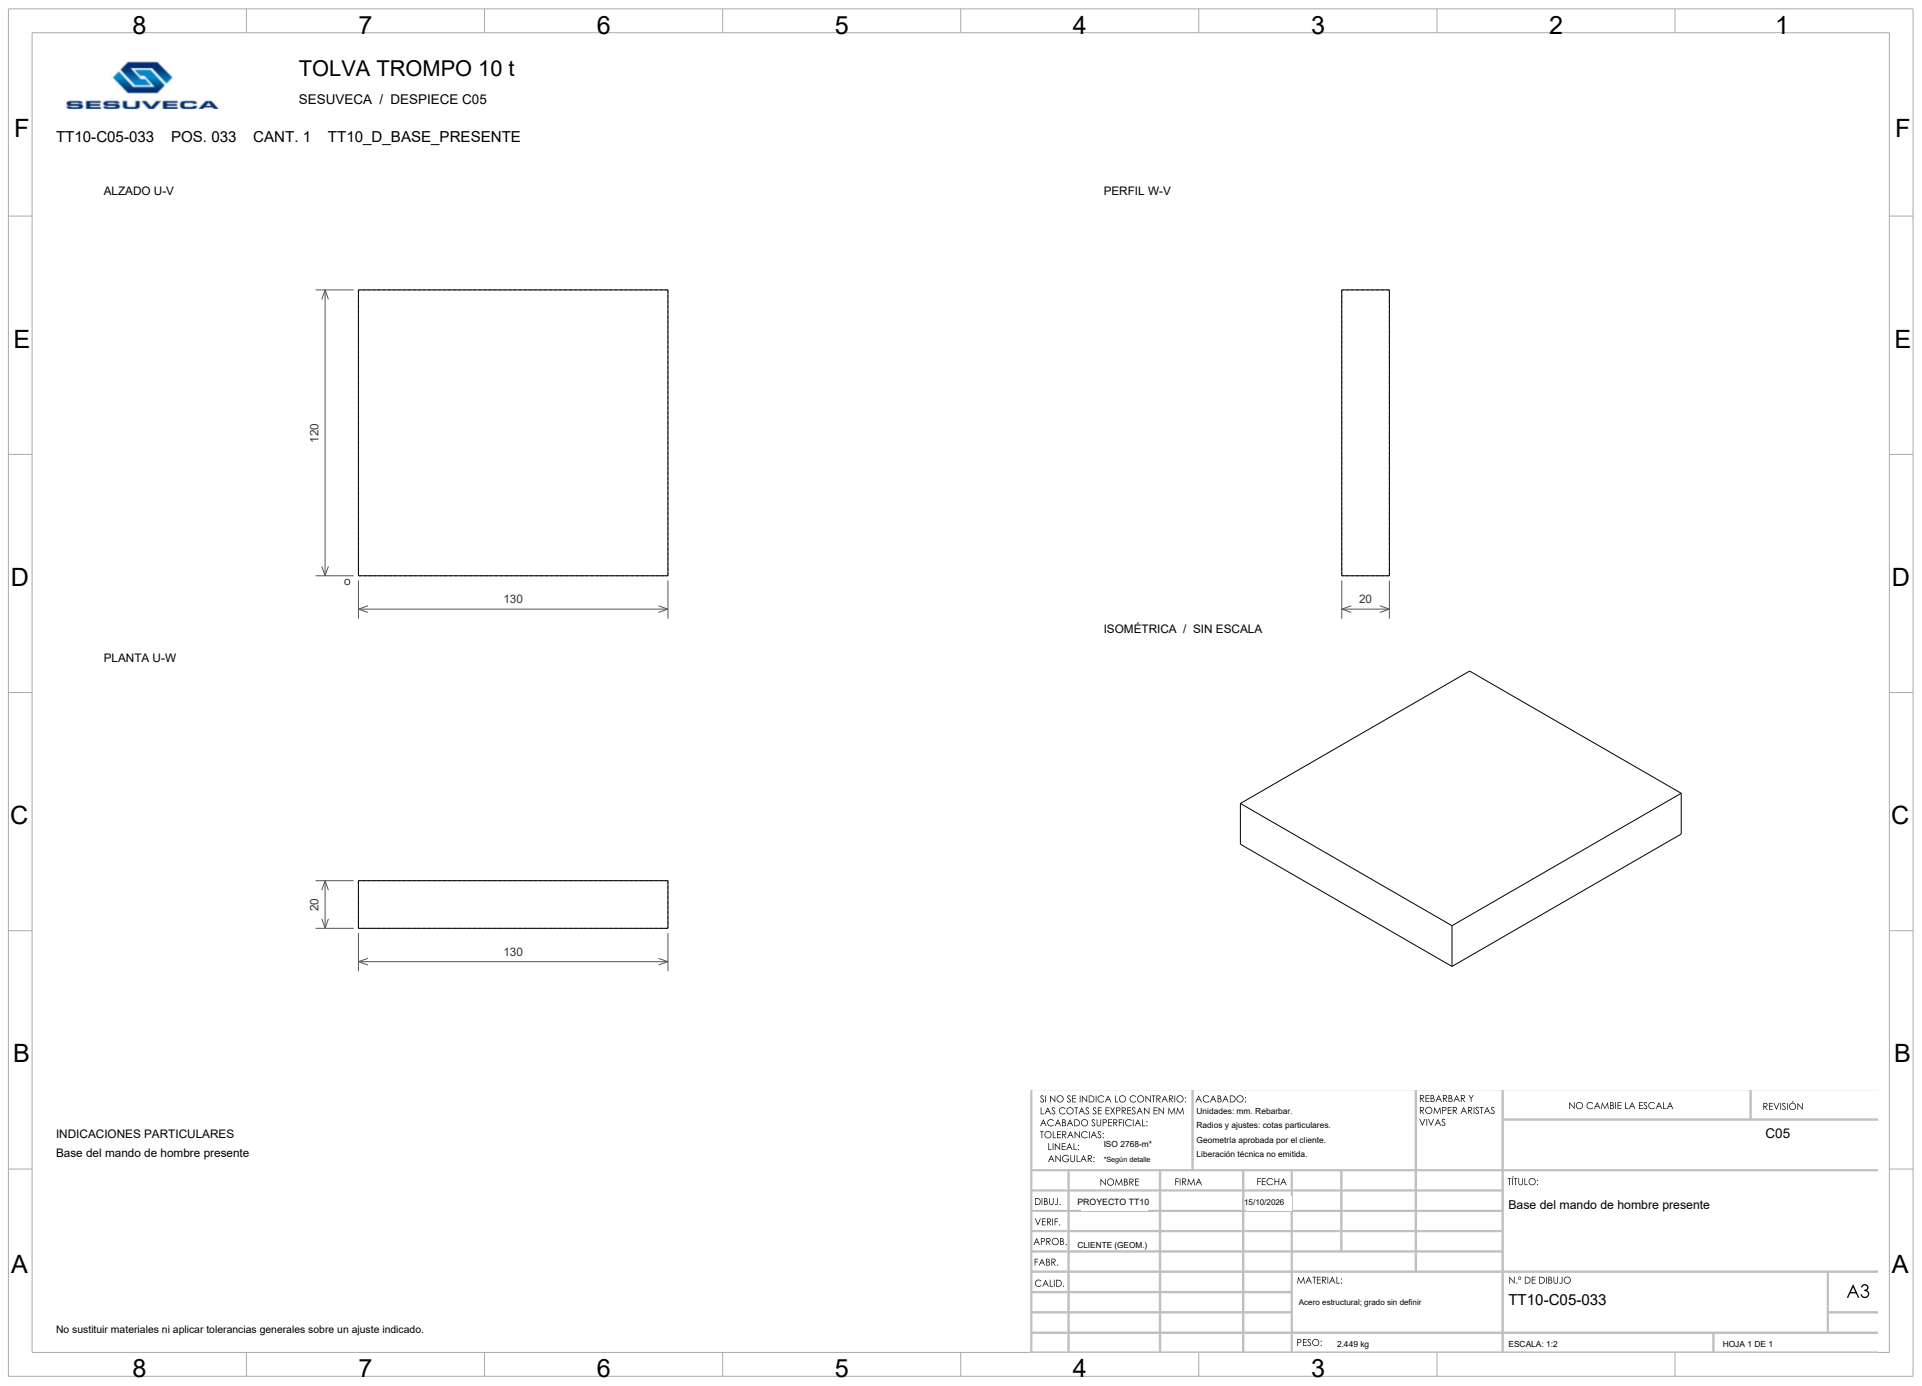
[picture p138: page 35]
TT10-C05-033 POS. 033 CANT. 1 TT10_D_BASE_PRESENTE; PROYECTO TT10; CLIENTE (GEOM.); ISO 2768-m*; *Según detalle; ESCALA: 1:2; HOJA 1 DE 1; ALZADO U-V; PLANTA U-W; PERFIL W-V

ISOMÉTRICA / SIN ESCALA

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

INDICACIONES PARTICULARES
Base del mando de hombre presente

Acero estructural; grado sin definir

F | F
E | E

ISOMÉTRICA / SIN ESCALA

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

INDICACIONES PARTICULARES
Base de mando de recuperación

Acero estructural; grado sin definir

F | F
E | E

ISOMÉTRICA / SIN ESCALA

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

INDICACIONES PARTICULARES
Base de mando de recuperación

Acero estructural; grado sin definir

F | F
E | E

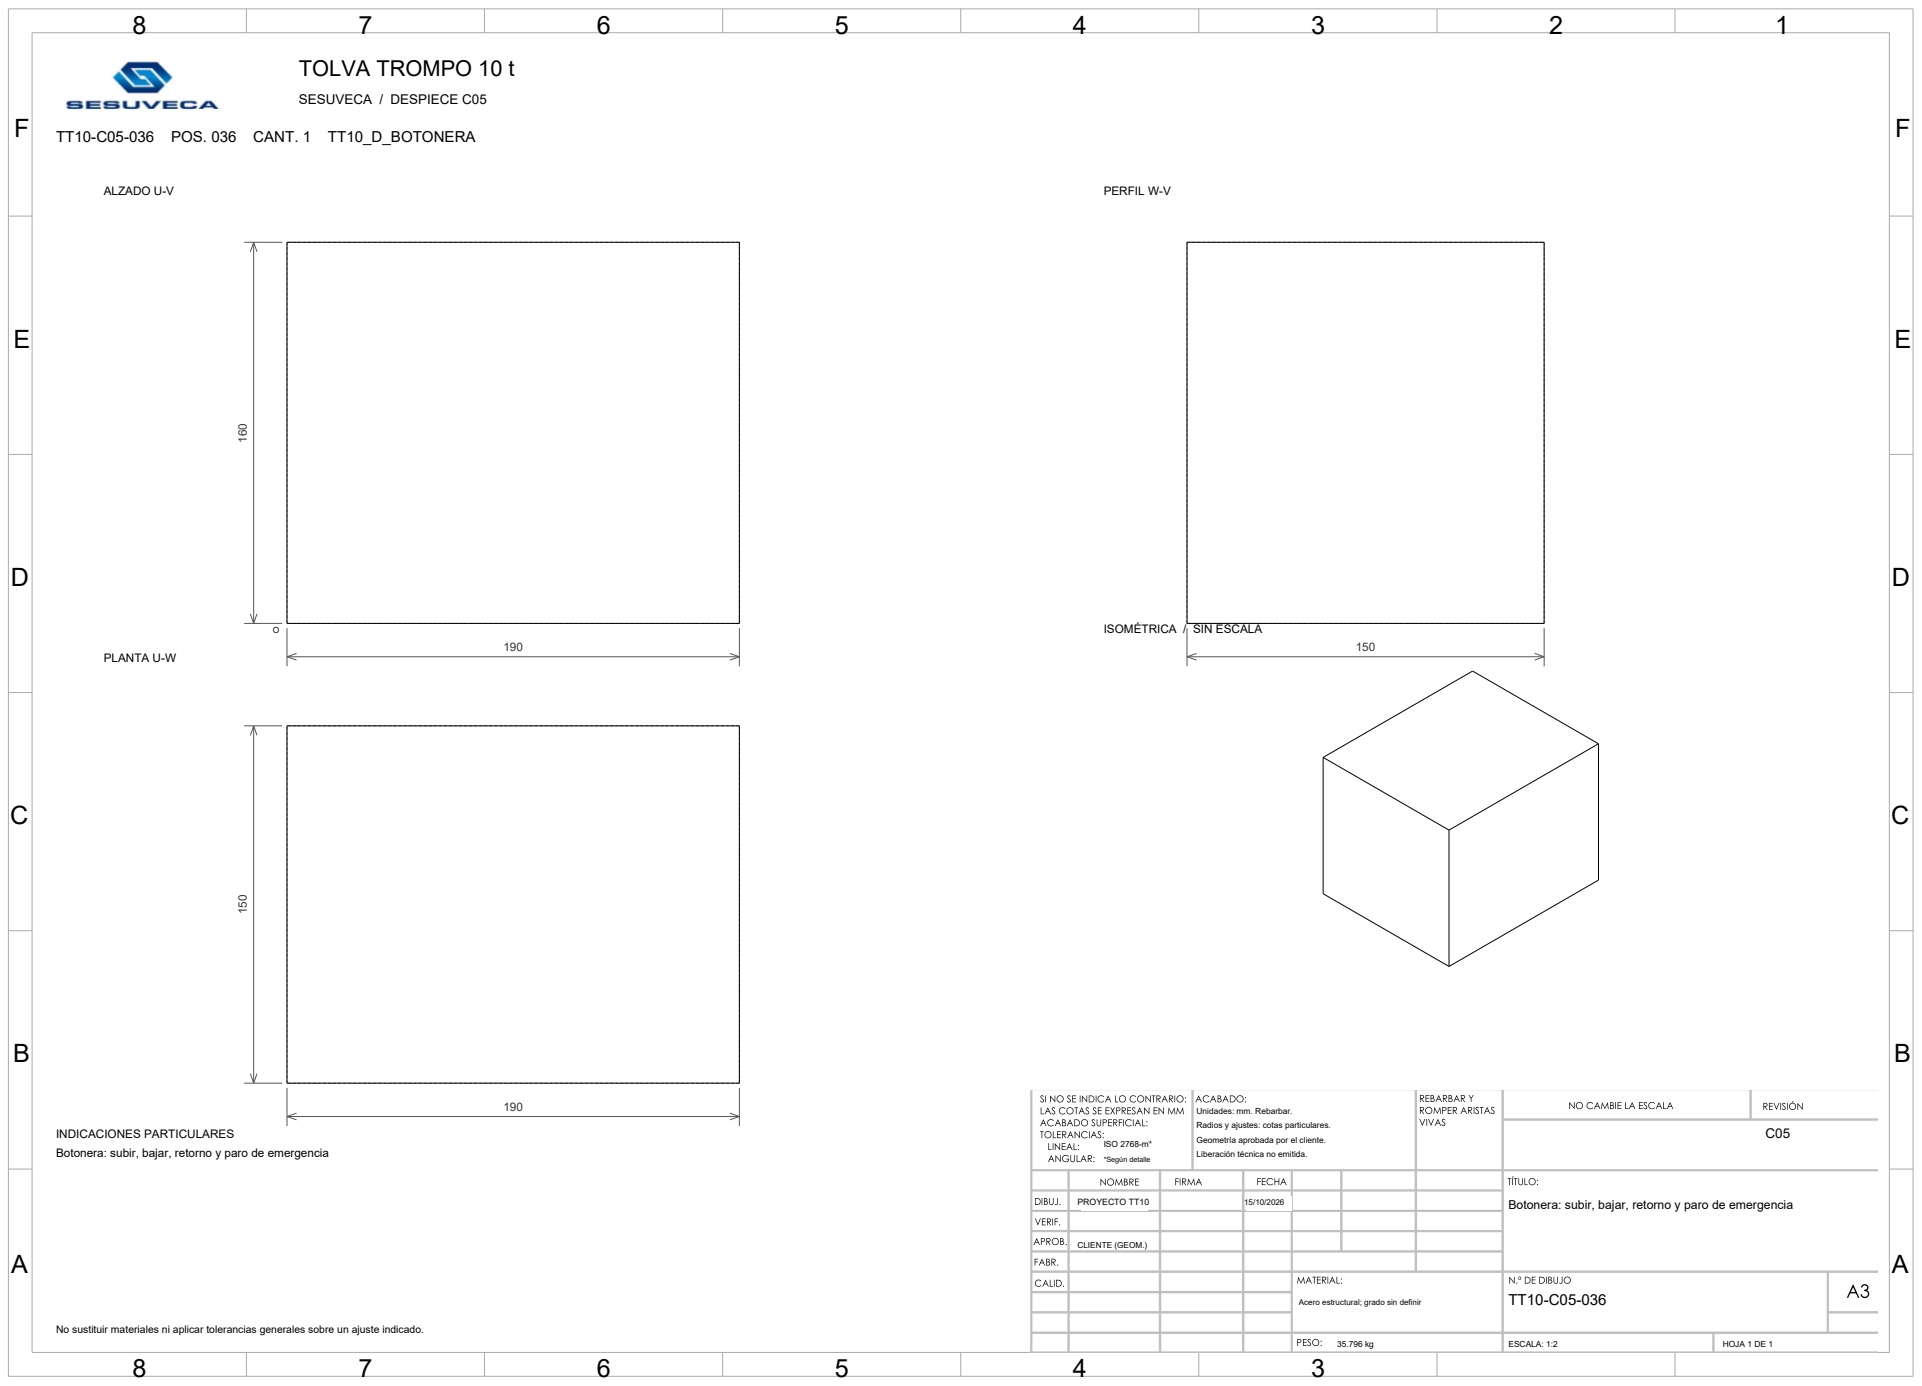
[picture p139: page 38]
TT10-C05-036 POS. 036 CANT. 1 TT10_D_BOTONERA; PROYECTO TT10; CLIENTE (GEOM.); ISO 2768-m*; *Según detalle; ESCALA: 1:2; HOJA 1 DE 1; ALZADO U-V; PLANTA U-W; PERFIL W-V; ISOMÉTRICA /; SIN ESCALA

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

INDICACIONES PARTICULARES
Botonera: subir, bajar, retorno y paro de emergencia

Acero estructural; grado sin definir

F | F
E | E

ISOMÉTRICA / SIN ESCALA

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

01 Ø44.000 eje U centro (22.00; 22.00) tramo 0.00 a 25.00

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

Acero estructural; grado sin definir

F | F
E | E

ISOMÉTRICA / SIN ESCALA

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

01 Ø44.000 eje U centro (22.00; 22.00) tramo 0.00 a 25.00

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

Acero estructural; grado sin definir

F | F
E | E

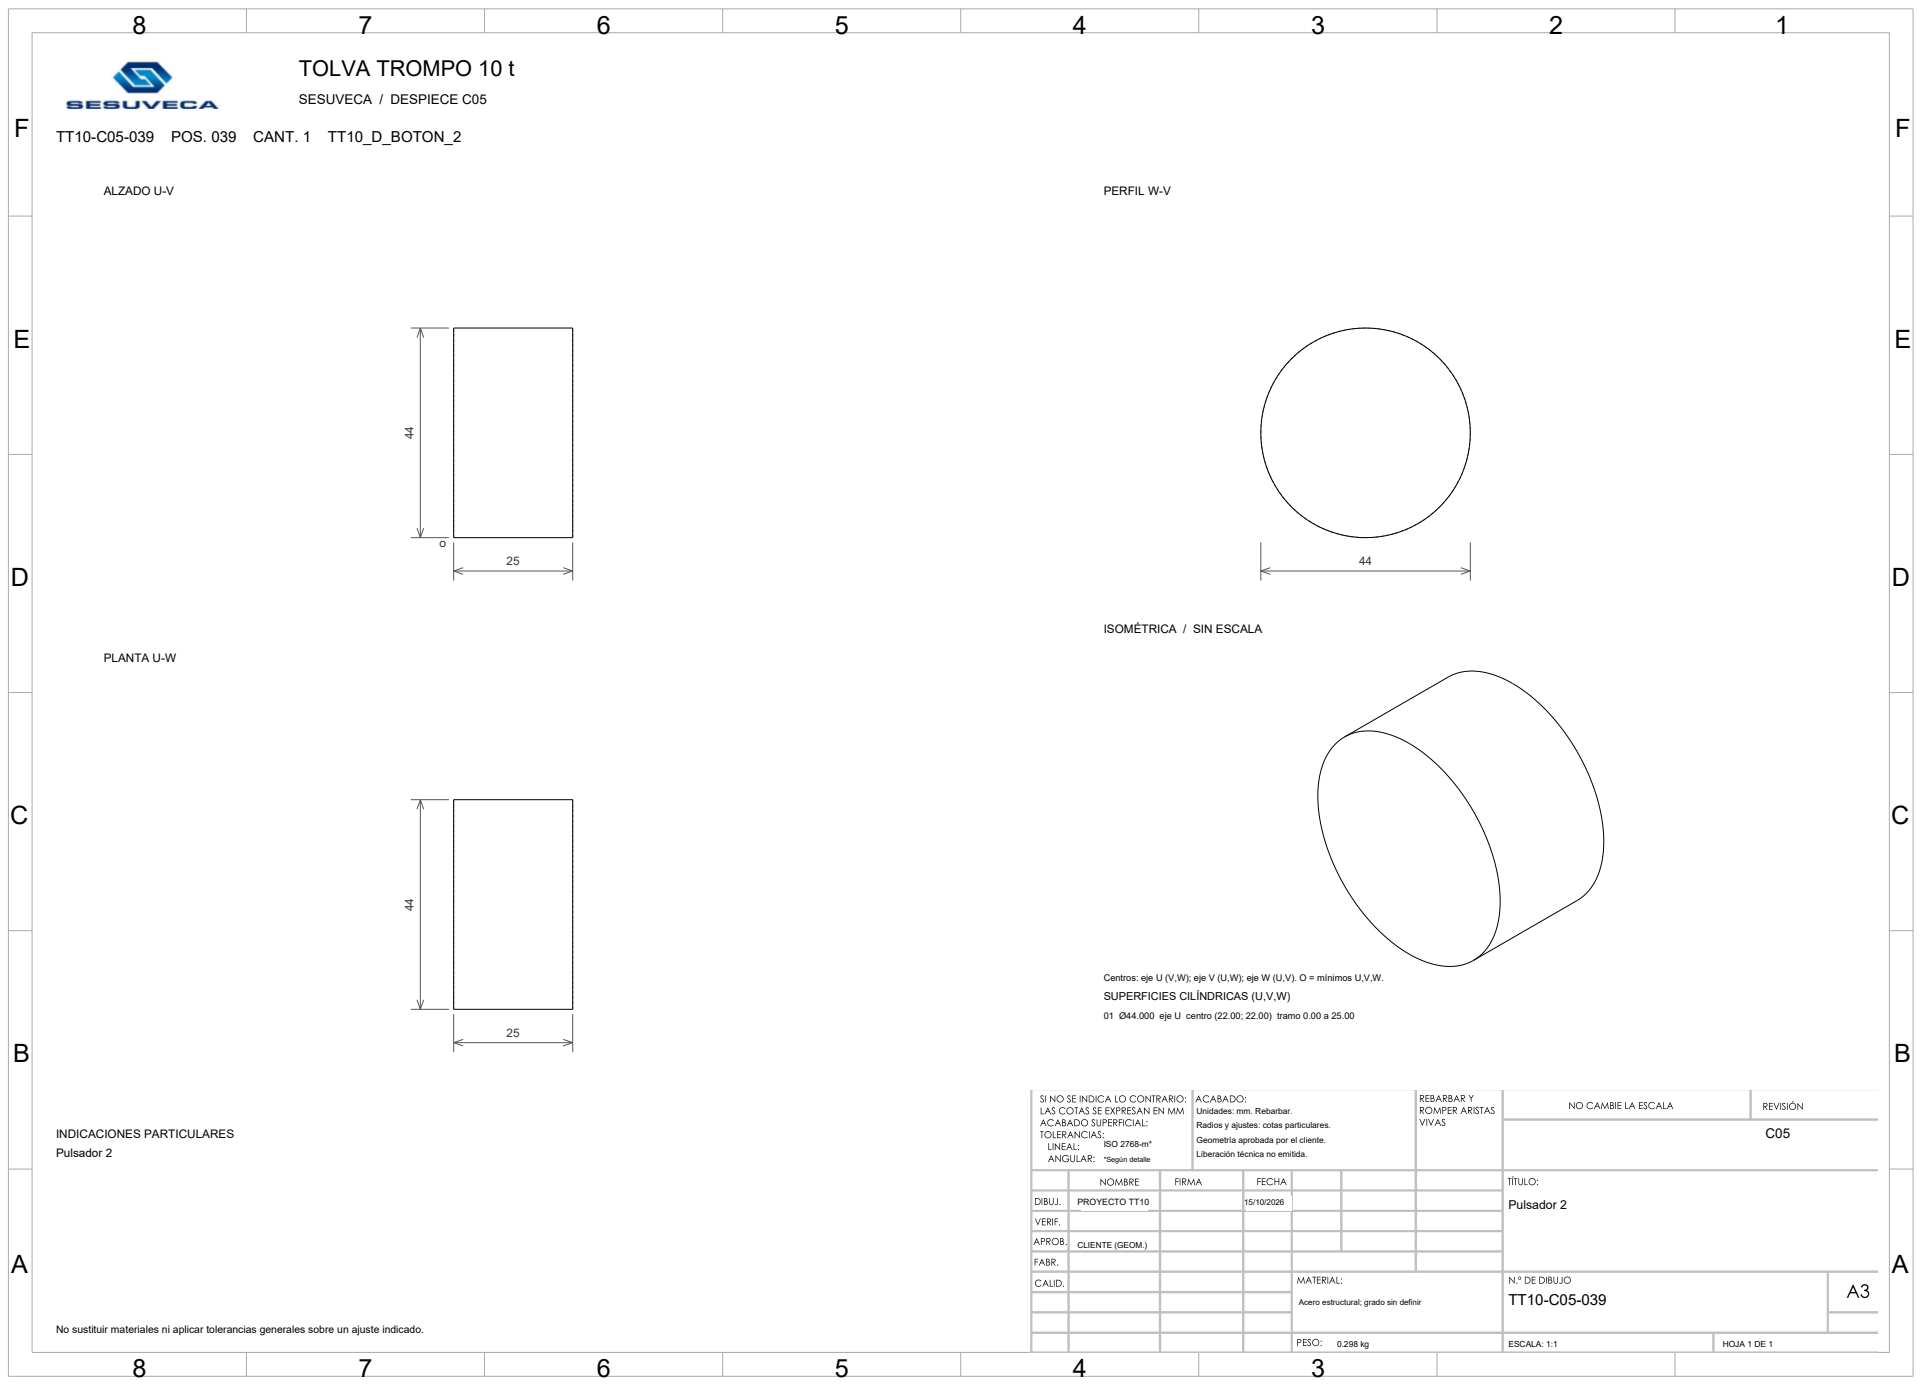
[picture p140: page 41]
TT10-C05-039 POS. 039 CANT. 1 TT10_D_BOTON_2; Pulsador 2; PROYECTO TT10; CLIENTE (GEOM.); ISO 2768-m*; *Según detalle; ESCALA: 1:1; HOJA 1 DE 1; ALZADO U-V; PLANTA U-W; PERFIL W-V; INDICACIONES PARTICULARES

ISOMÉTRICA / SIN ESCALA

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

01 Ø44.000 eje U centro (22.00; 22.00) tramo 0.00 a 25.00

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

Acero estructural; grado sin definir

F | F
E | E

ISOMÉTRICA / SIN ESCALA

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

01 Ø6.000 eje V centro (403.00; 3.00) tramo 0.00 a 125.00
02 Ø6.000 eje V centro (3.00; 3.00) tramo 0.00 a 125.00
03 Ø6.000 eje U centro (125.00; 3.00) tramo 3.00 a 403.00

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

INDICACIONES PARTICULARES
Eje de conexión geométrica CABLE_PRESENTE

Acero estructural; grado sin definir

F | F
E | E

ISOMÉTRICA / SIN ESCALA

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

01 Ø90.000 eje U centro (45.00; 45.00) tramo 0.00 a 65.00

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

INDICACIONES PARTICULARES
COMPRA. NO FABRICAR EL CONTORNO REPRESENTADO.
Referencia: Equipo nominal, sin referencia de pedido aceptada.

Encoder de velocidad en eje motor

F | F
E | E

ISOMÉTRICA / SIN ESCALA

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

INDICACIONES PARTICULARES
Palanca de hombre presente para liberación manual nominal

Acero estructural; grado sin definir

F | F
E | E

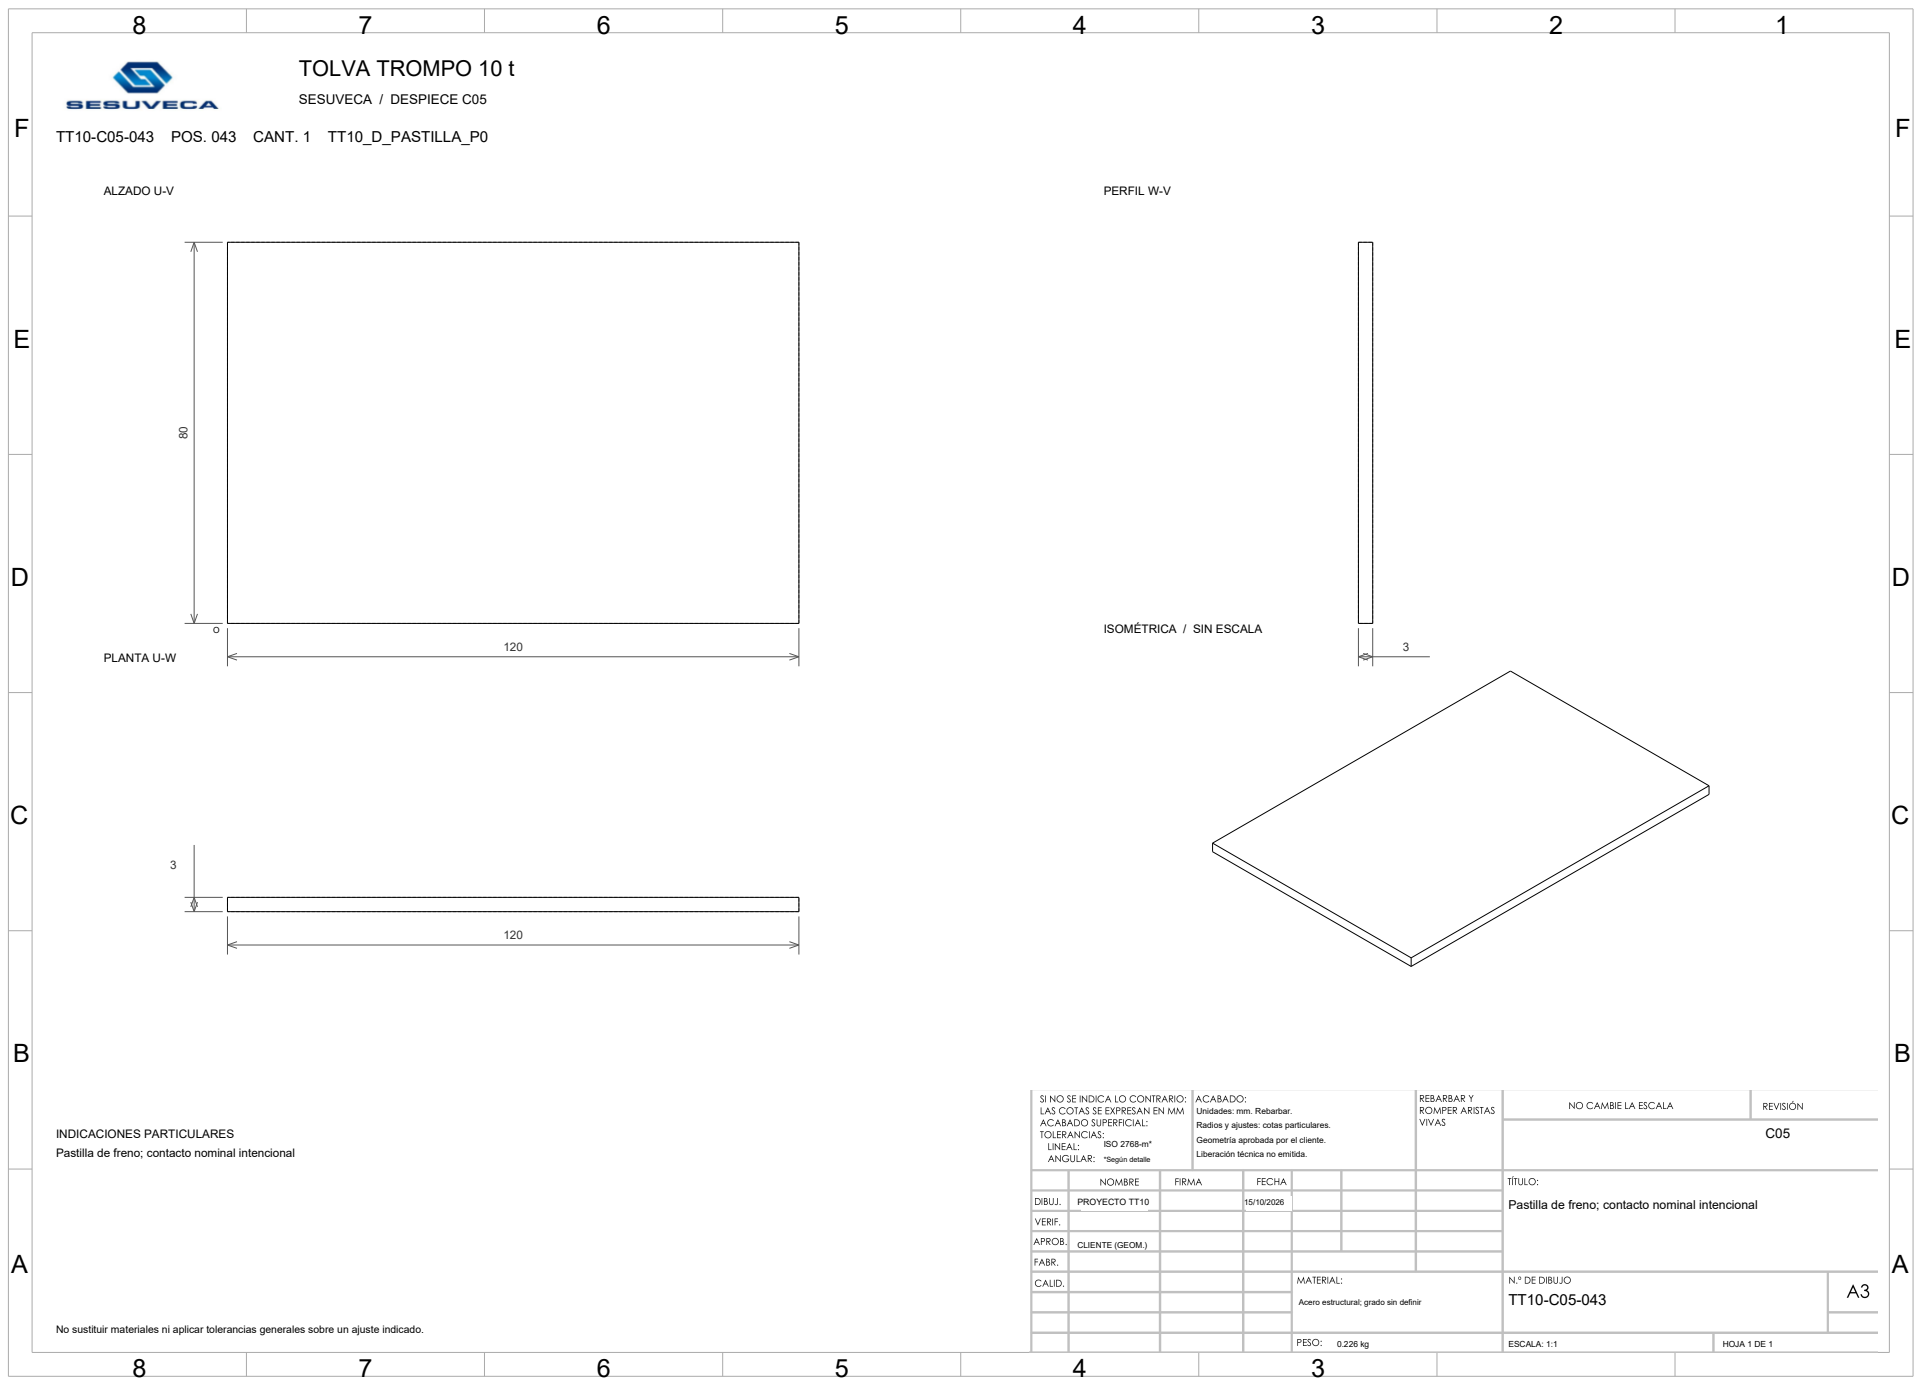
[picture p141: page 45]
TT10-C05-043 POS. 043 CANT. 1 TT10_D_PASTILLA_P0; PROYECTO TT10; CLIENTE (GEOM.); ISO 2768-m*; *Según detalle; ESCALA: 1:1; HOJA 1 DE 1; ALZADO U-V; PLANTA U-W; PERFIL W-V

ISOMÉTRICA / SIN ESCALA

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

INDICACIONES PARTICULARES
Pastilla de freno; contacto nominal intencional

Acero estructural; grado sin definir

F | F
E | E

ISOMÉTRICA / SIN ESCALA

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

INDICACIONES PARTICULARES
Pastilla de freno; contacto nominal intencional

Acero estructural; grado sin definir

F | F
E | E

ISOMÉTRICA / SIN ESCALA

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

INDICACIONES PARTICULARES
Pedestal bajo reducción auxiliar

Acero estructural; grado sin definir

F | F
E | E

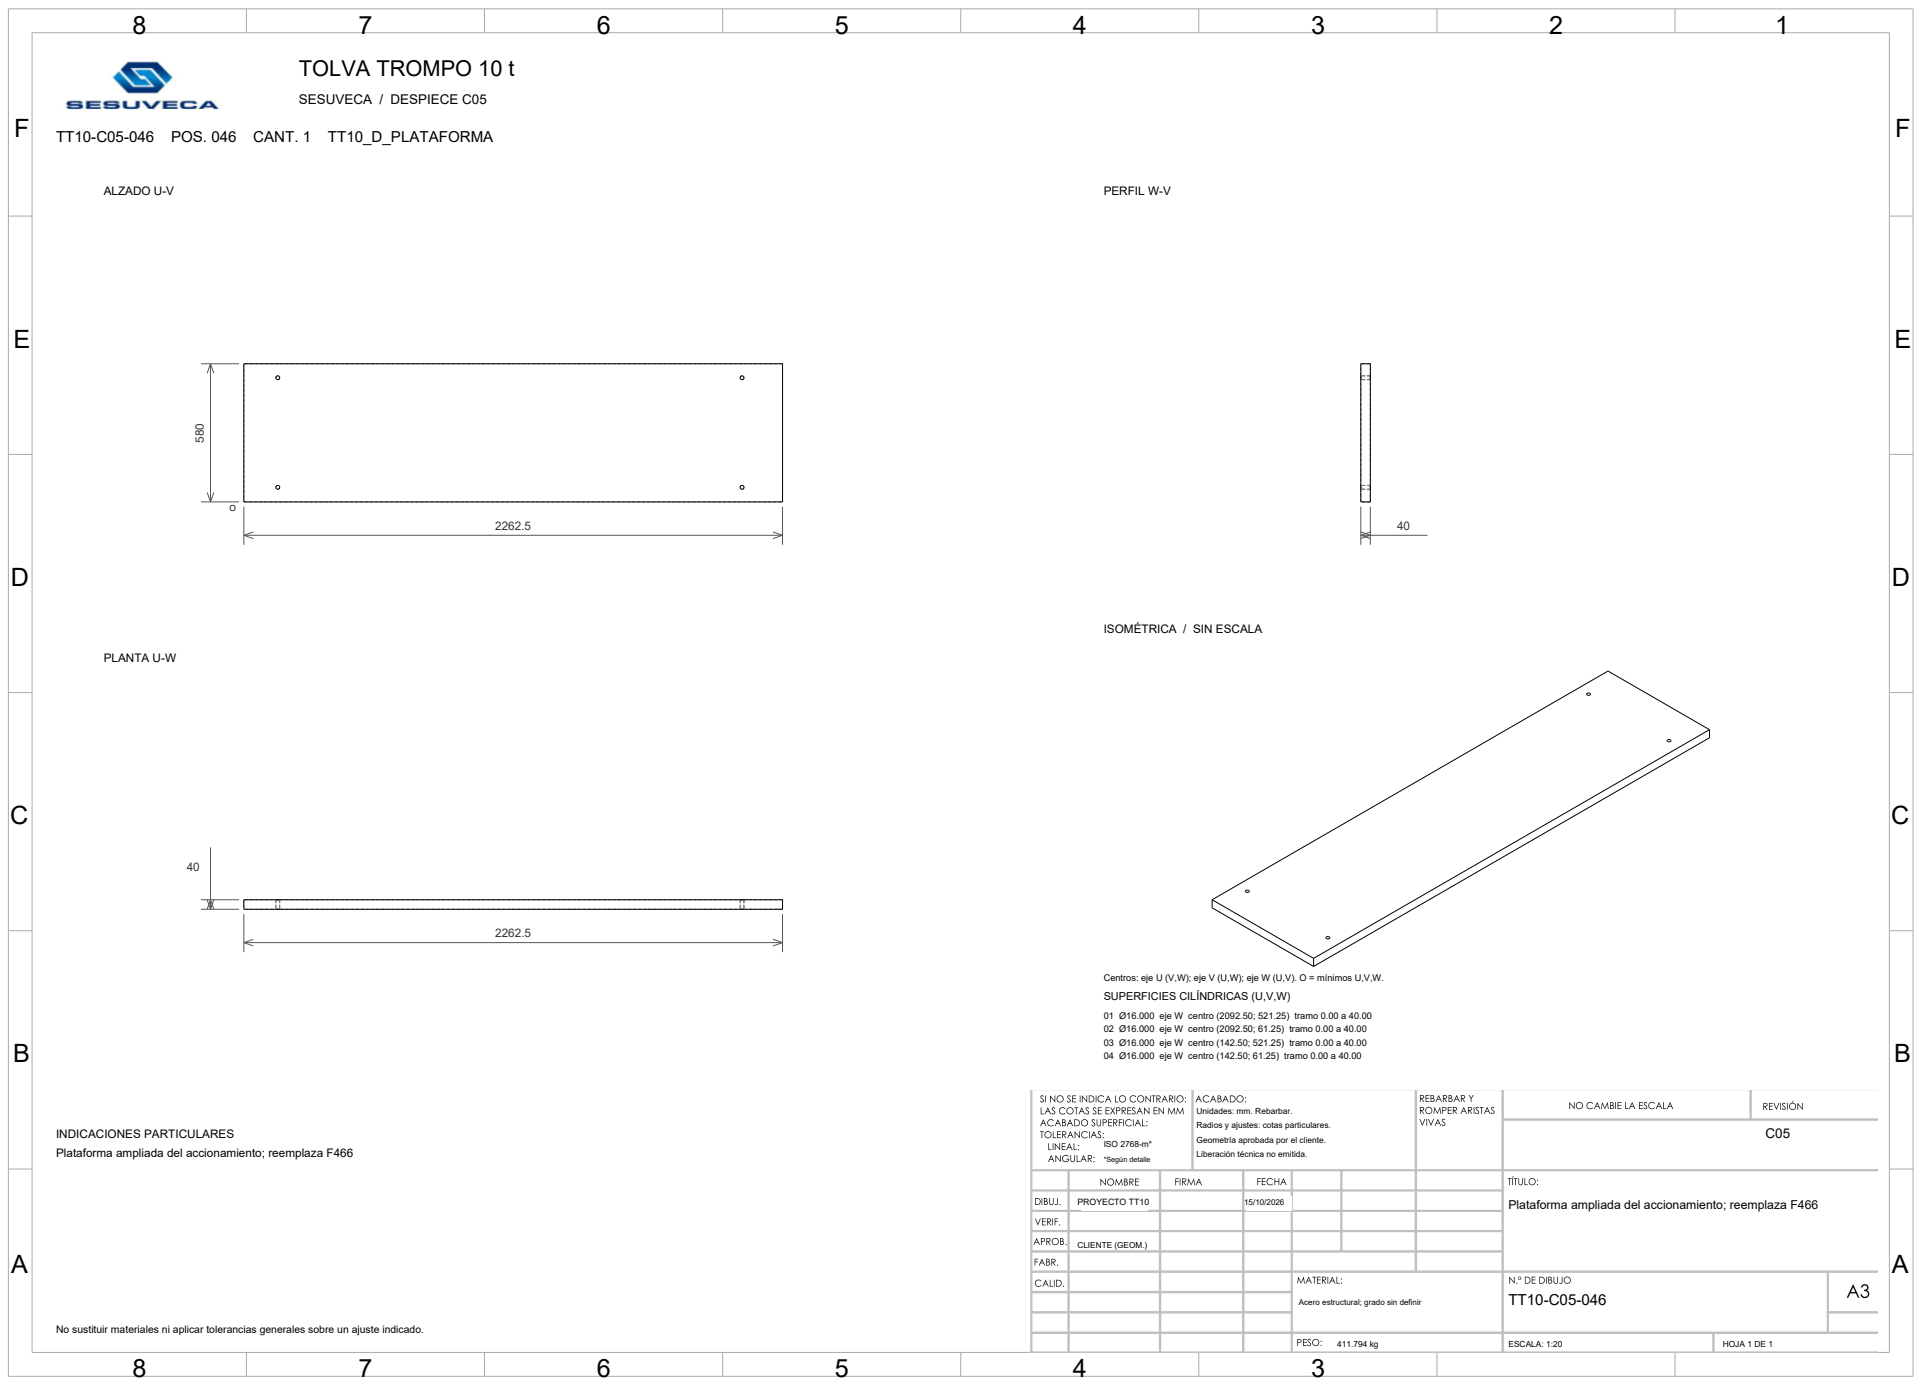
[picture p142: page 48]
TT10-C05-046 POS. 046 CANT. 1 TT10_D_PLATAFORMA; PROYECTO TT10; CLIENTE (GEOM.); ISO 2768-m*; *Según detalle; ESCALA: 1:20; HOJA 1 DE 1; ALZADO U-V; PLANTA U-W; PERFIL W-V

ISOMÉTRICA / SIN ESCALA

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

01 Ø16.000 eje W centro (2092.50; 521.25) tramo 0.00 a 40.00
02 Ø16.000 eje W centro (2092.50; 61.25) tramo 0.00 a 40.00
03 Ø16.000 eje W centro (142.50; 521.25) tramo 0.00 a 40.00
04 Ø16.000 eje W centro (142.50; 61.25) tramo 0.00 a 40.00

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

INDICACIONES PARTICULARES
Plataforma ampliada del accionamiento; reemplaza F466

Acero estructural; grado sin definir

F | F
E | E

ISOMÉTRICA / SIN ESCALA

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

INDICACIONES PARTICULARES
Soporte de armario

Acero estructural; grado sin definir

F | F
E | E

ISOMÉTRICA / SIN ESCALA

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

INDICACIONES PARTICULARES
Poste de botonera fuera del plano de giro

Acero estructural; grado sin definir

F | F
E | E

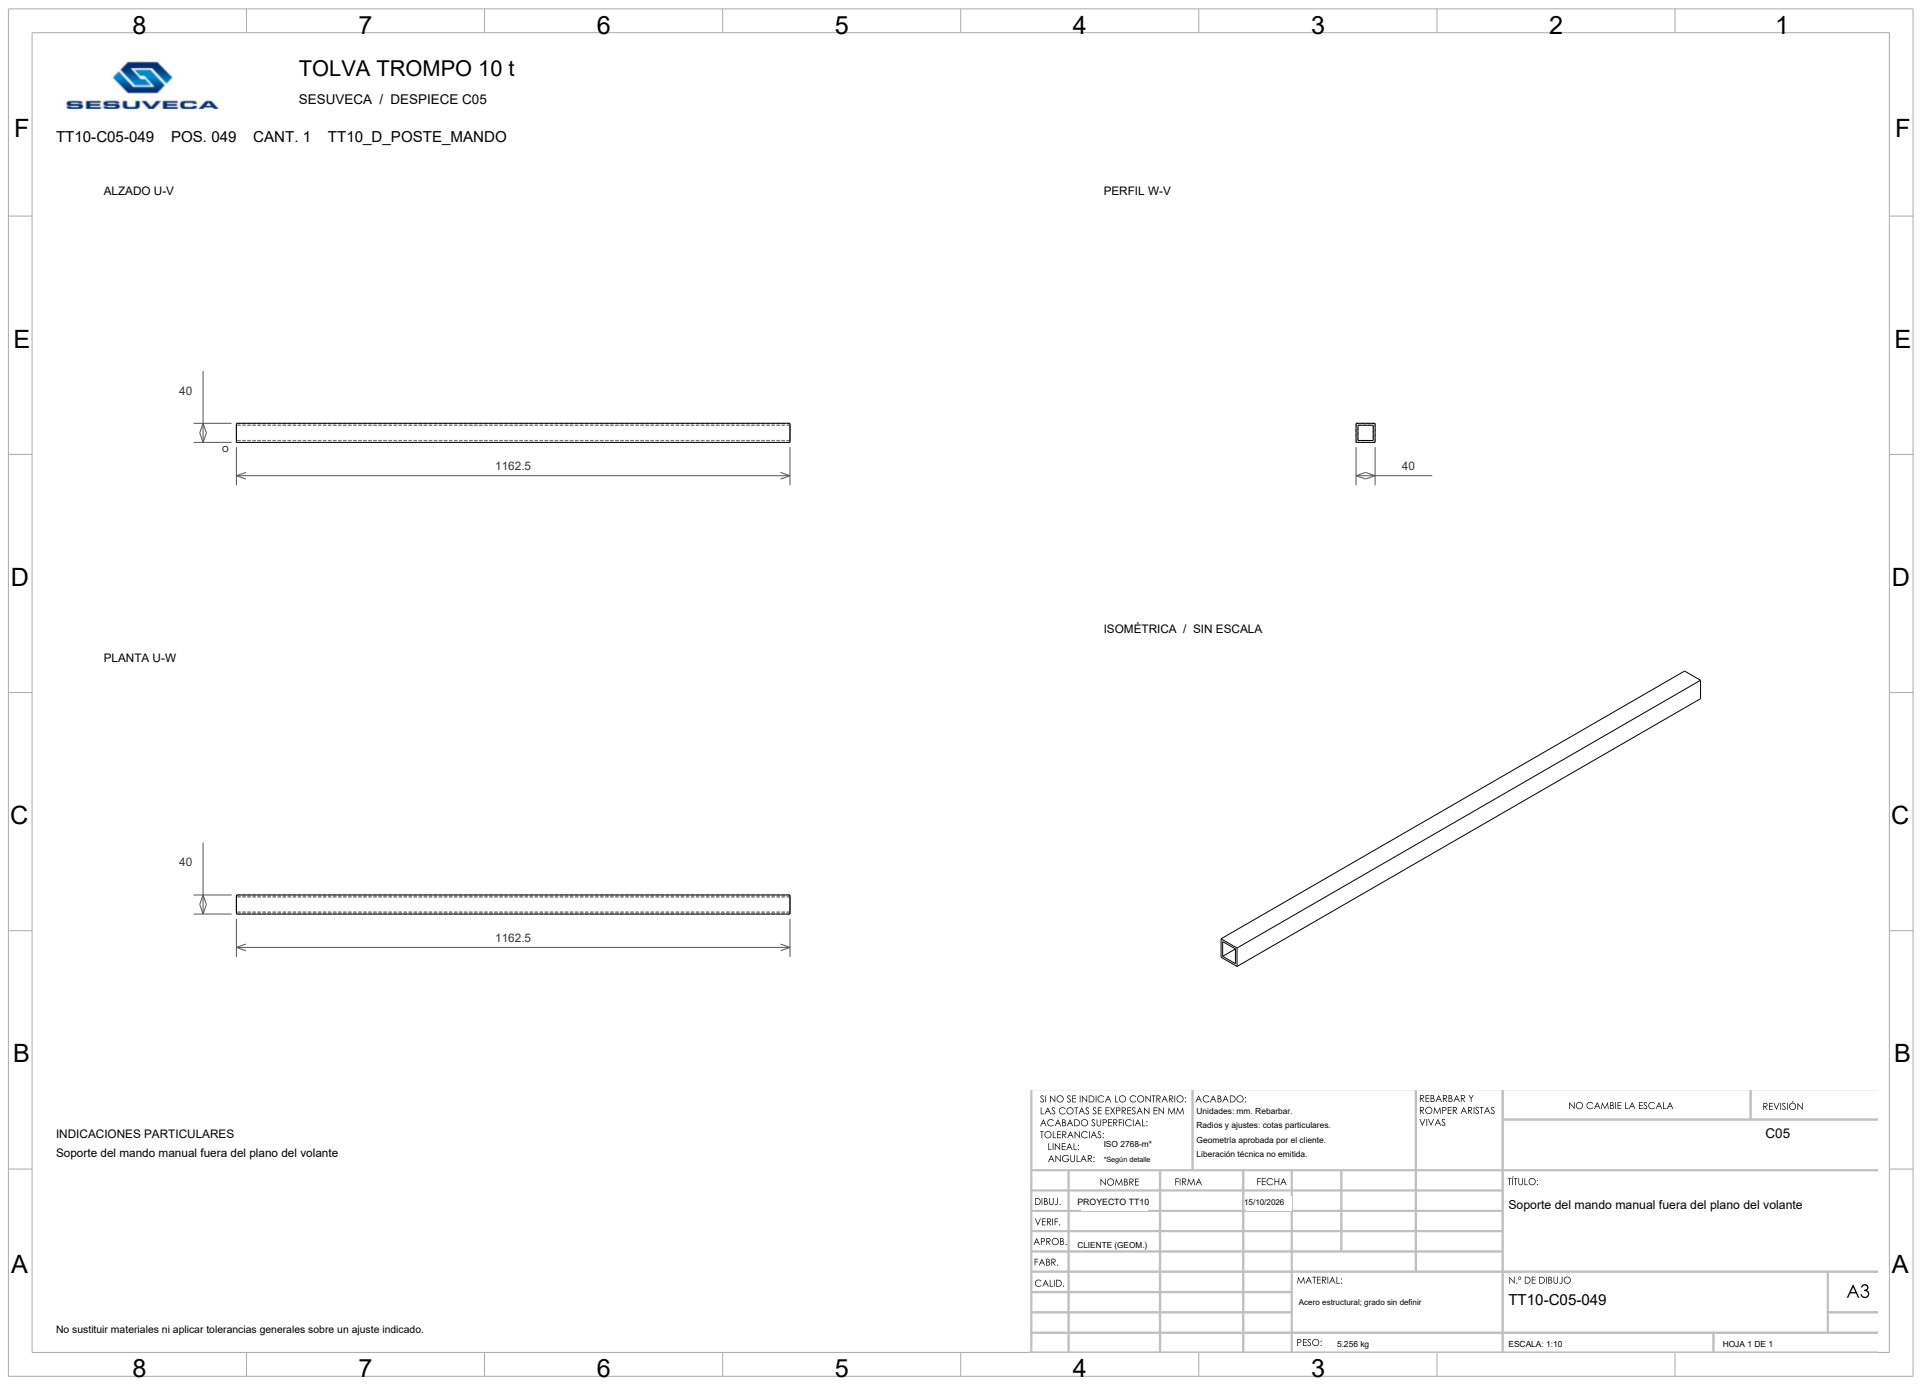
[picture p143: page 51]
TT10-C05-049 POS. 049 CANT. 1 TT10_D_POSTE_MANDO; PROYECTO TT10; CLIENTE (GEOM.); ISO 2768-m*; *Según detalle; ESCALA: 1:10; HOJA 1 DE 1; ALZADO U-V; PLANTA U-W; PERFIL W-V

ISOMÉTRICA / SIN ESCALA

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

INDICACIONES PARTICULARES
Soporte del mando manual fuera del plano del volante

Acero estructural; grado sin definir

F | F
E | E

ISOMÉTRICA / SIN ESCALA

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

INDICACIONES PARTICULARES
Soporte de manivela y desbloqueo manual N

Acero estructural; grado sin definir

F | F
E | E

ISOMÉTRICA / SIN ESCALA

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

INDICACIONES PARTICULARES
Soporte de manivela y desbloqueo manual P

Acero estructural; grado sin definir

F | F
E | E

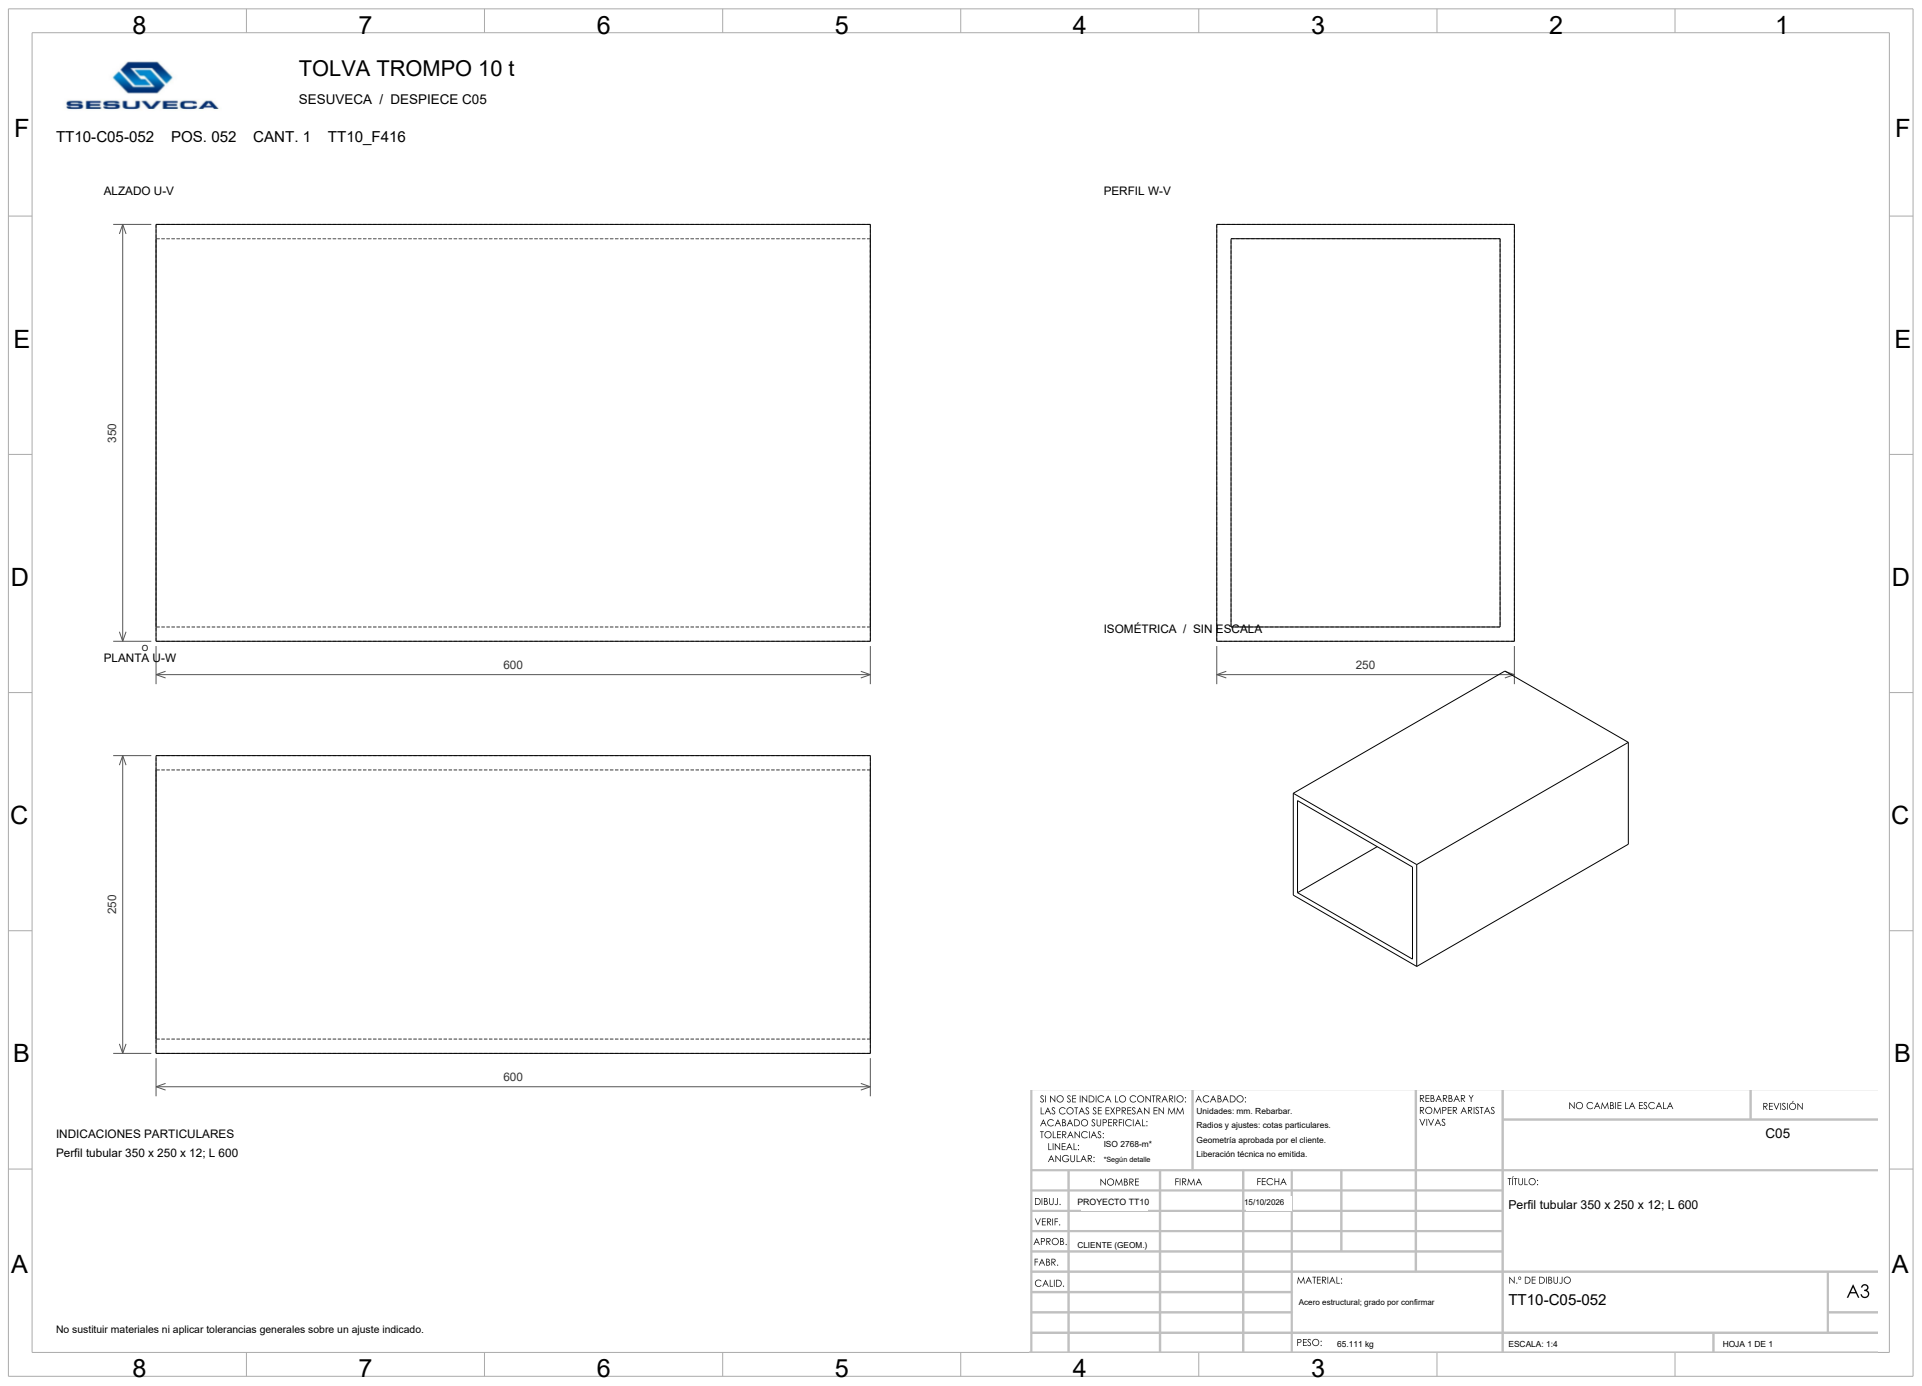
[picture p144: page 54]
TT10-C05-052 POS. 052 CANT. 1 TT10_F416; Perfil tubular 350 x 250 x 12; L 600; PROYECTO TT10; CLIENTE (GEOM.); ISO 2768-m*; *Según detalle; ESCALA: 1:4; HOJA 1 DE 1; ALZADO U-V; PLANTA U-W; PERFIL W-V; INDICACIONES PARTICULARES

ISOMÉTRICA / SIN ESCALA

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

Acero estructural; grado por confirmar

F | F
E | E

ISOMÉTRICA / SIN ESCALA

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

INDICACIONES PARTICULARES
Tope inclinado: cara inferior mecanizada para asiento horizontal

Tope inclinado: cara inferior mecanizada para asiento
horizontal

F | F
E | E

ISOMÉTRICA / SIN ESCALA

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

Acero estructural; grado por confirmar

F | F
E | E

ISOMÉTRICA / SIN ESCALA

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

01 Ø30.000 eje W centro (130.00; 300.00) tramo 20.00 a 80.00
02 Ø30.000 eje W centro (670.00; 160.00) tramo 20.00 a 80.00
03 Ø30.000 eje W centro (670.00; 300.00) tramo 20.00 a 80.00
04 Ø30.000 eje W centro (130.00; 160.00) tramo 20.00 a 80.00

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

INDICACIONES PARTICULARES
Placa80 con cuatro roscas M30 ciegas60, paso540x140; pernos desde arriba

Placa80 con cuatro roscas M30 ciegas60, paso540x140;
pernos desde arriba

F | F
E | E

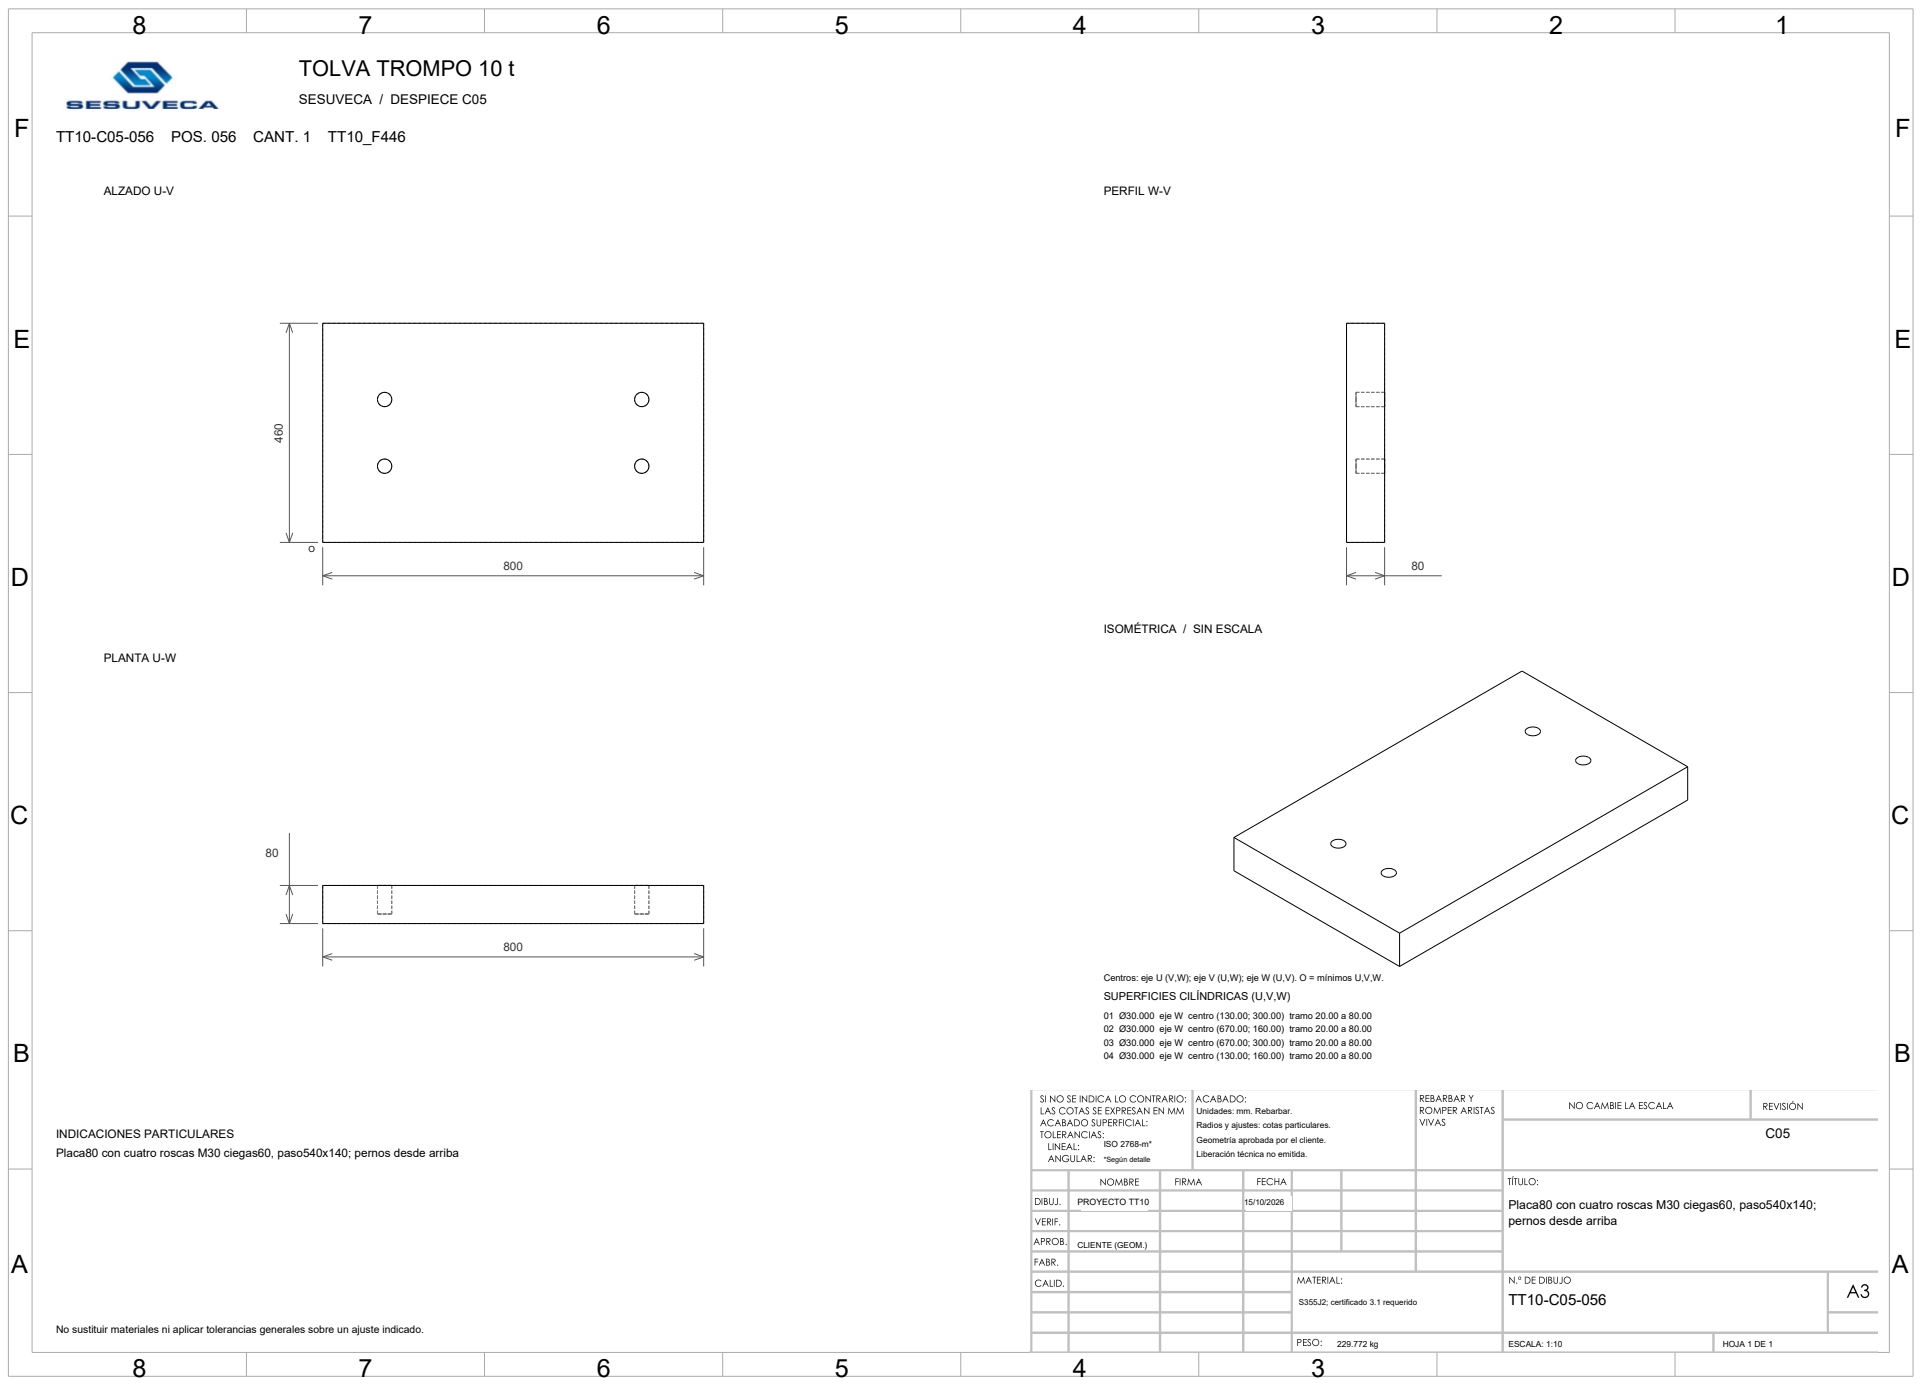
[picture p145: page 58]
TT10-C05-056 POS. 056 CANT. 1 TT10_F446; PROYECTO TT10; CLIENTE (GEOM.); ISO 2768-m*; *Según detalle; S355J2; certificado 3.1 requerido; ESCALA: 1:10; HOJA 1 DE 1; ALZADO U-V; PLANTA U-W; PERFIL W-V

ISOMÉTRICA / SIN ESCALA

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

INDICACIONES PARTICULARES
Placa80 con cuatro roscas M30 ciegas60, paso540x140; pernos desde arriba

Placa80 con cuatro roscas M30 ciegas60, paso540x140;
pernos desde arriba

F | F
E | E

ISOMÉTRICA / SIN ESCALA

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

INDICACIONES PARTICULARES
Tirante RHS200x150x10; extremos a cara de columna y puente

Tirante RHS200x150x10; extremos a cara de columna y
puente

F | F
E | E

ISOMÉTRICA / SIN ESCALA

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

01 Ø35.000 eje W centro (215.00; 590.00) tramo 0.00 a 90.00
02 Ø35.000 eje W centro (75.00; 50.00) tramo 0.00 a 90.00
03 Ø35.000 eje W centro (215.00; 50.00) tramo 0.00 a 90.00
04 Ø35.000 eje W centro (75.00; 590.00) tramo 0.00 a 90.00
05 Ø360.000 eje U centro (320.00; 220.00) tramo 75.00 a 215.00
06 Ø222.000 eje U centro (320.00; 220.00) tramo 215.00 a 290.00

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

INDICACIONES PARTICULARES
COMPRA. NO FABRICAR EL CONTORNO REPRESENTADO.
Referencia: SNL 3048

SKF SNL3048: dimensiones de interfaz según catálogo;
fundición simplificada

Fundición gris SKF; compra de conjunto

F | F
E | E
D | D
C | C
B | B
A | A

# TT10-C05-058 POS. 058 CANT. 1 TT10_F456

SKF SNL3048: dimensiones de interfaz según catálogo;

## fundición simplificada - continuación

C05

PROYECTO TT10 | 15/10/2026

CLIENTE (GEOM.)

ISO 2768-m*

*Según detalle

Fundición gris SKF; compra de conjunto

139.000 kg | ESCALA: - | HOJA 2 DE 2

Unidades: mm. Rebarbar.

Radios y ajustes: cotas particulares.

Geometría aprobada por el cliente.

Liberación técnica no emitida.
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
