acevedocrisologopablo48-lgtm/sesuveca-tolva-p04/(commit log)

2026-10-14 Crear visor interactivo SESUVECA de la tolva P04
2026-10-15 Mejorar materiales, aristas e iluminación del visor P04
2026-10-15 Actualizar caché del visor para cargar los nuevos materiales
2026-10-16 Publicar geometría y documentación C05 de la tolva
2026-10-16 Incluir descarga de perfiles DXF
2026-10-16 Corregir cajetines y simplificar presentación de Tolva Trompo
2026-10-16 Separar listas de materiales y actualizar BOM de compras
2026-10-24 Sincronizar TT10 con CAD C05 y corregir evidencia de calculo
2026-10-25 Sincronizar modelo C06, planos A4 y materiales TT10
2026-10-25 Conservar bytes exactos de STEP y despiece al publicar
2026-10-29 Actualizar planta R03 y publicar verificacion de movimiento e incidencias
